ericherman/megaprocessor/README

http://www.megaprocessor.com/
(C) 2014-2016 James Newman.
