ericherman/megaprocessor/4x16mux/README

16x4MUX

This is the most tedious to solder.
