ericherman/megaprocessor/7seg_4digit/README

3x2, 4DIGITS

Same board, there's two ways of fitting the display.
