ericherman/megaprocessor/8bit_add_sub/README

8BIT ADD/SUB

This is my favourite board
