ericherman/megaprocessor/8x2and_or/README

8x2AND OR

Somehow when doing this board I messed up the power plane so it didn't
extend over the whole board. So there's a few wires underneath to sort
things out.
