ericherman/megaprocessor/module_artwork_rnx_ctrl/README

Rnx Control

This generates the signals that control what the Rn Registers and Rx Mux
modules do each cycle. This depends on the current state and instruction
and uses signals generated by the decoder modules.
