ericherman/megaprocessor/shift_left_right/README

Shifter

The shifting is just by wiring from one connector to the other with an
offset. Depending on which side you call the input and which the output
its a left or right shifter. It also generates some status data (is zero
etc).
