ericherman/megaprocessor/16reg/16reg_2a_ancillary/readme.txt

Readme File for Printed Circuit Board 16REG_2a

Board Specification
Size           266.7 x 76.2 mm
Material       FR4
No of Layers   4
Thickness      1.6
Finish         HASL (NOT Lead Free)
Copper Weight  1.0oz

Special Requirements : None.

The design does not contain Blind Vias	
The design does not contain Buried Vias
The design does not contain holes smaller than 0.25mm (0.010inches) 

The design conforms to the following design rules	
Minimum track thickness 8 mil (0.13mm)
Minimum track clearance 8 mil (0.13mm)

Layer Description:

Top Silk Screen Overlay       16REG_2a.GTO
Top Solder Mask               16REG_2a.GTS
Top Copper                    16REG_2a.GTL
Inner Copper 1                16REG_2a.G1
Inner Copper 2                16REG_2a.G2
Bottom Copper                 16REG_2a.GBL
Bottom Solder Mask            16REG_2a.GBS
Bottom Silk Screen            No
NC Drill File                 16REG_2a.drd
Outline			      16REG_2a.GM1

Contact Information

sales@tecbridgecircuits.co.uk
+44 (0) 207 993 6503
http://www.tecbridgecircuits.co.uk
