ericherman/megaprocessor/2_to_4_decoder/decoder4_2_ancillary/readme.txt

Readme File for Printed Circuit Board Decoder4_2

Board Specification
Size           52.07 x 44.45 mm
Material       FR4
No of Layers   4
Thickness      1.6
Finish         HASL (NOT Lead Free)
Copper Weight  1.0oz

Special Requirements : None.

The design does not contain Blind Vias	
The design does not contain Buried Vias
The design does not contain holes smaller than 0.25mm (0.010inches) 
The design conforms to the following design rules	
Minimum track thickness 8 mil (0.13mm)
Minimum track clearance 8 mil (0.13mm)

Layer Description:

Top Silk Screen Overlay       Decoder4_2.GTO
Top Solder Mask               Decoder4_2.GTS
Top Copper                    Decoder4_2.GTL
Inner Copper 1                Decoder4_2.G1
Inner Copper 2                Decoder4_2.G2
Bottom Copper                 Decoder4_2.GBL
Bottom Solder Mask            Decoder4_2.GBS
Bottom Silk Screen            No
NC Drill File                 Decoder4_2.drd
Outline			      Decoder4_2.GM1

Contact Information

sales@tecbridgecircuits.co.uk
+44 (0) 207 993 6503
http://www.tecbridgecircuits.co.uk
