ericherman/megaprocessor/2or/2or_2_ancillary/readme.txt

Readme File for Printed Circuit Board 2OR_2

Board Specification
Size           35.54mm x 24.13mm (1.4 x .95 inches)
Material       FR4
No of Layers   2
Thickness      1.6
Finish         HASL (NOT Lead Free)
Copper Weight  1.0oz

Layer Description:
Top Silk Screen Overlay       2OR_2.GTO
Top Solder Mask               2OR_2.GTS
Top Copper                    2OR_2.GTL
Bottom Copper                 2OR_2.GBL
Bottom Solder Mask            2OR_2.GBS
Bottom Silk Screen            No
NC Drill File                 2OR_2.drd
Outline			      2OR_2.GM1

Contact Information

sales@tecbridgecircuits.co.uk
+44 (0) 207 993 6503
http://www.tecbridgecircuits.co.uk
