ericherman/megaprocessor/2x2and_or/2x2and_or_1_ancillary/readme.txt

Readme File for Printed Circuit Board 2x2AND_OR_1

Board Specification
Size           53.98 x 44.77 mm
Material       FR4
No of Layers   2
Thickness      1.6
Finish         HASL (NOT Lead Free)
Copper Weight  1.0oz

Special Requirements : None.

The design does not contain holes smaller than 0.25mm (0.010inches) 
The design conforms to the following design rules	
Minimum track thickness 8 mil
Minimum track clearance 8 mil

Layer Description:
Top Silk Screen Overlay       2x2AND_OR_1.GTO
Top Solder Mask               2x2AND_OR_1.GTS
Top Copper                    2x2AND_OR_1.GTL
Bottom Copper                 2x2AND_OR_1.GBL
Bottom Solder Mask            2x2AND_OR_1.GBS
Bottom Silk Screen            No
NC Drill File                 2x2AND_OR_1.drl
NC Drill File (non-plated)    2x2AND_OR_1npth.drl
Outline			      2x2AND_OR_1.GM1

Contact Information

sales@tecbridgecircuits.co.uk
+44 (0) 207 993 6503
http://www.tecbridgecircuits.co.uk
