ericherman/megaprocessor/3and/3and_2_ancillary/readme.txt

Readme File for Printed Circuit Board 3AND_2

Board Specification
Size           35.54mm x 30.48mm (1.4 x 1.2 inches)
Material       FR4
No of Layers   2
Thickness      1.6
Finish         HASL (NOT Lead Free)
Copper Weight  1.0oz

Layer Description

Top Silk Screen Overlay       3AND_2.GTO
Top Solder Mask               3AND_2.GTS
Top Copper                    3AND_2.GTL
Bottom Copper                 3AND_2.GBL
Bottom Solder Mask            3AND_2.GBS
Bottom Silk Screen            No
NC Drill File                 3AND_2.drd
Outline			      3AND_2.GM1

Contact Information

sales@tecbridgecircuits.co.uk
+44 (0) 207 993 6503
http://www.tecbridgecircuits.co.uk
