ericherman/megaprocessor/3or/3or_1_ancillary/readme.txt

Readme File for Printed Circuit Board 3OR_1

Board Specification
Size           35.54mm x 27.94mm (1.4 x 1.1 inches)
Material       FR4
No of Layers   2
Thickness      1.6
Finish         HASL (NOT Lead Free)
Copper Weight  1.0oz

Layer Description

Top Silk Screen Overlay       3OR_1.GTO
Top Solder Mask               3OR_1.GTS
Top Copper                    3OR_1.GTL
Bottom Copper                 3OR_1.GBL
Bottom Solder Mask            3OR_1.GBS
Bottom Silk Screen            No
NC Drill File                 3OR_1.drd
Outline			      3OR_1.GM1

Contact Information
