ericherman/megaprocessor/4x16mux/4x16mux_3_ancillary/readme.txt

Readme File for Printed Circuit Board 4x16MUX_3

Board Specification
Size           218.42mm x 107mm (8.6 x 4.2 inches)
Material       FR4
No of Layers   4
Thickness      1.6
Finish         HASL (NOT Lead Free)
Copper Weight  1.0oz

Special Requirements : None.

The design does not contain Blind Vias	
The design does not contain Buried Vias
The design does not contain holes smaller than 0.25mm (0.010inches) 

The design conforms to the following design rules	
Minimum track thickness 5 mil (0.13mm)
Minimum track clearance 5 mil (0.13mm)

Layer Description:
(Note: Inner layers are counted from the top downwards)

Top Silk Screen Overlay       4x16MUX_3.GTO
Top Solder Mask               4x16MUX_3.GTS
Top Copper                    4x16MUX_3.GTL
Inner Copper 1                4x16MUX_3.G1
Inner Copper 2                4x16MUX_3.G2
Bottom Copper                 4x16MUX_3.GBL
Bottom Solder Mask            4x16MUX_3.GBS
Bottom Silk Screen            No
NC Drill File                 4x16MUX_3.drd
Outline			      4x16MUX_3.GM1

Contact Information

sales@tecbridgecircuits.co.uk
+44 (0) 207 993 6503
http://www.tecbridgecircuits.co.uk
