ericherman/megaprocessor/5or/5or_1_ancillary/readme.txt

Readme File for Printed Circuit Board 5OR_1

Board Specification
Size           35.54mm x 38.74mm (1.4 x 1.525 inches)
Material       FR4
No of Layers   2
Thickness      1.6
Finish         HASL (NOT Lead Free)
Copper Weight  1.0oz

Layer Description

Top Silk Screen Overlay       5OR_1.GTO
Top Solder Mask               5OR_1.GTS
Top Copper                    5OR_1.GTL
Bottom Copper                 5OR_1.GBL
Bottom Solder Mask            5OR_1.GBS
Bottom Silk Screen            No
NC Drill File                 5OR_1.drd
Outline			      5OR_1.GM1

Contact Information

sales@tecbridgecircuits.co.uk
+44 (0) 207 993 6503
http://www.tecbridgecircuits.co.uk
