ericherman/megaprocessor/7seg_4digit/7seg_4digit_1_ancillary/readme.txt

Readme File for Printed Circuit Board 7SEG_4DIGIT_1

Board Specification
Size           132mm x 67.31mm (5.2 x 2.65 inches)
Material       FR4
No of Layers   2
Thickness      1.6
Finish         HASL (NOT Lead Free)
Copper Weight  1.0oz

Special Requirements : None.

The design does not contain holes smaller than 0.25mm (0.010inches) 
The design conforms to the following design rules	
Minimum track thickness 8 mil (0.13mm)
Minimum track clearance 8 mil (0.13mm)

Layer Description:

Top Silk Screen Overlay       7SEC_4DIGIT_1.GTO
Top Solder Mask               7SEC_4DIGIT_1.GTS
Top Copper                    7SEC_4DIGIT_1.GTL
Bottom Copper                 7SEC_4DIGIT_1.GBL
Bottom Solder Mask            7SEC_4DIGIT_1.GBS
Bottom Silk Screen            7SEC_4DIGIT_1.GBO
NC Drill File                 7SEC_4DIGIT_1.drd
Outline			      7SEC_4DIGIT_1.GM1

Contact Information

sales@tecbridgecircuits.co.uk
+44 (0) 207 993 6503
http://www.tecbridgecircuits.co.uk
