ericherman/megaprocessor/8b_ram/8b_ram_3_ancillary/readme.txt

Readme File for Printed Circuit Board 8B_RAM_3

Board Specification
Size           202.57mm x 202.57mm (8 x 8 inches)
Material       FR4
No of Layers   4
Thickness      1.6
Finish         HASL (NOT Lead Free)
Copper Weight  1.0oz

Special Requirements : None.

The design does not contain Blind Vias	
The design does not contain Buried Vias
The design does not contain holes smaller than 0.25mm (0.010inches) 
The design conforms to the following design rules	
Minimum track thickness 5 mil (0.13mm)
Minimum track clearance 5 mil (0.13mm)

Layer Description
(Note: Inner layers are counted from the top downwards)

Top Silk Screen Overlay       MEM_MUX_2.GTO
Top Solder Mask               MEM_MUX_2.GTS
Top Copper                    MEM_MUX_2.GTL
Inner Copper 1                MEM_MUX_2.G1
Inner Copper 2                MEM_MUX_2.G2
Bottom Copper                 MEM_MUX_2.GBL
Bottom Solder Mask            MEM_MUX_2.GBS
Bottom Silk Screen            MEM_MUX_2.GBO
NC Drill File                 MEM_MUX_2.drd
Outline			      MEM_MUX_2.GM1

Contact Information

sales@tecbridgecircuits.co.uk
+44 (0) 207 993 6503
http://www.tecbridgecircuits.co.uk
