ericherman/megaprocessor/8bit_add_sub/8bit_add_sub_ancillary/readme.txt

Readme File for Printed Circuit Board 8BIT_ADD_SUB_1

Board Specification
Size           176.53 x 351.79 mm
Material       FR4
No of Layers   4
Thickness      1.6
Finish         HASL (NOT Lead Free)
Copper Weight  1.0oz

Special Requirements : None.

The design does not contain holes smaller than 0.25mm (0.010inches) 
The design conforms to the following design rules	
Minimum track thickness 8 mil (0.13mm)
Minimum track clearance 8 mil (0.13mm)

Layer Description:

Top Silk Screen Overlay       8BIT_ADD_SUB.GTO
Top Solder Mask               8BIT_ADD_SUB.GTS
Top Copper                    8BIT_ADD_SUB.GTL
Inner Copper 1                8BIT_ADD_SUB.G1
Inner Copper 2                8BIT_ADD_SUB.G2
Bottom Copper                 8BIT_ADD_SUB.GBL
Bottom Solder Mask            8BIT_ADD_SUB.GBS
Bottom Silk Screen            No
NC Drill File                 8BIT_ADD_SUB.drd
Outline			      8BIT_ADD_SUB.GM1

Contact Information

sales@tecbridgecircuits.co.uk
+44 (0) 207 993 6503
http://www.tecbridgecircuits.co.uk
