ericherman/megaprocessor/8or/8or_1_ancillary/readme.txt

Readme File for Printed Circuit Board 8OR_1

Board Specification
Size           38.08 x 52.07 mm
Material       FR4
No of Layers   4
Thickness      1.6
Finish         HASL (NOT Lead Free)
Copper Weight  1.0oz

Special Requirements : None.

The design does not contain holes smaller than 0.25mm (0.010inches) 
The design conforms to the following design rules	
Minimum track thickness 8 mil (0.13mm)
Minimum track clearance 8 mil (0.13mm)

Layer Description:

Top Silk Screen Overlay       8OR_1.GTO
Top Solder Mask               8OR_1.GTS
Top Copper                    8OR_1.GTL
Inner Copper 1                8OR_1.G1
Inner Copper 2                8OR_1.G2
Bottom Copper                 8OR_1.GBL
Bottom Solder Mask            8OR_1.GBS
Bottom Silk Screen            No
NC Drill File                 8OR_1.drd
Outline			      8OR_1.GM1

Contact Information

sales@tecbridgecircuits.co.uk
+44 (0) 207 993 6503
http://www.tecbridgecircuits.co.uk
