ericherman/megaprocessor/addr_addr/addr_addr_1_ancillary/readme.txt

Readme File for Printed Circuit Board ADDR_ADDR_1

Board Specification
Size           71.12 x 30.48mm (2.8 x 1.2 inches)
Material       FR4
No of Layers   2
Thickness      1.6
Finish         HASL (NOT Lead Free)
Copper Weight  1.0oz

Special Requirements : None.

The design does not contain holes smaller than 0.25mm (0.010inches) 
The design conforms to the following design rules	
Minimum track thickness 5 mil (0.13mm)
Minimum track clearance 5 mil (0.13mm)

Layer Description:

Top Silk Screen Overlay       ADDR_ADDR_1.GTO
Top Solder Mask               ADDR_ADDR_1.GTS
Top Copper                    ADDR_ADDR_1.GTL
Bottom Copper                 ADDR_ADDR_1.GBL
Bottom Solder Mask            ADDR_ADDR_1.GBS
Bottom Silk Screen            No
NC Drill File                 ADDR_ADDR_1.drd
Outline			      ADDR_ADDR_1.GM1

Contact Information

sales@tecbridgecircuits.co.uk
+44 (0) 207 993 6503
http://www.tecbridgecircuits.co.uk
