ericherman/megaprocessor/buf_bus_tee/buf_bus_tee_1_ancillary/readme.txt

Readme File for Printed Circuit Board 'BUF_BUS_TEE_1'

Board Specification
Size           114.3 x 55.88mm
Material       FR4
No of Layers   2
Thickness      1.6
Finish         HASL (NOT Lead free) (NOT RoHS)
Copper Weight  1.0oz

Special Requirements
None

The design does not contain holes smaller than 0.25mm (0.010inches)
The design conforms to the following design rules
Minimum track thickness 5 mil (0.13mm)
Minimum track clearance 5 mil (0.13mm)

Layer Description

Top Silk Screen Overlay       BUF_BUS_TEE_1.GTO
Top Solder Mask               BUF_BUS_TEE_1.GTS
Top Copper                    BUF_BUS_TEE_1.GTL
Bottom Copper                 BUF_BUS_TEE_1.GBL
Bottom Solder Mask            BUF_BUS_TEE_1.GBS
Bottom Silk Screen            No
NC Drill File                 BUF_BUS_TEE_1.GDD
Outline			      BUF_BUS_TEE_1.GM1

Contact Information

sales@tecbridgecircuits.co.uk
+44 (0) 207 993 6503
http://www.tecbridgecircuits.co.uk
