ericherman/megaprocessor/bus_4tee/bus_4tee_1_ancillary/readme.txt

Readme File for Printed Circuit Board BUS_4TEE_1

Board Specification
Size           58.42mm x 71.12mm
Material       FR4
No of Layers   2
Thickness      1.6
Finish         HASL (NOT Lead Free)
Copper Weight  1.0oz

Special Requirements : None.

The design does not contain holes smaller than 0.25mm (0.010inches) 
The design conforms to the following design rules	
Minimum track thickness 8 mil
Minimum track clearance 8 mil

Layer Description:
Top Silk Screen Overlay       BUS_4TEE_1.GTO
Top Solder Mask               BUS_4TEE_1.GTS
Top Copper                    BUS_4TEE_1.GTL
Bottom Copper                 BUS_4TEE_1.GBL
Bottom Solder Mask            BUS_4TEE_1.GBS
Bottom Silk Screen            No
NC Drill File                 BUS_4TEE_1.drd
Outline			      BUS_4TEE_1.GM1

Contact Information

sales@tecbridgecircuits.co.uk
+44 (0) 207 993 6503
http://www.tecbridgecircuits.co.uk
