ericherman/megaprocessor/bus_split_display/bus_split_display_1_ancillary/readme.txt

Readme File for Printed Circuit Board 'BUS_SPLIT_DISPLAY_1'

Board Specification
Size           71.12 x 31.75mm
Material       FR4
No of Layers   2
Thickness      1.6
Finish         HASL (NOT Lead free) (NOT RoHS)
Copper Weight  1.0oz

Special Requirements
None

The design does not contain holes smaller than 0.25mm (0.010inches)
The design conforms to the following design rules
Minimum track thickness 5 mil (0.13mm)
Minimum track clearance 5 mil (0.13mm)

Layer Description

Top Silk Screen Overlay       XOR_1.GTO
Top Solder Mask               XOR_1.GTS
Top Copper                    XOR_1.GTL
Bottom Copper                 XOR_1.GBL
Bottom Solder Mask            XOR_1.GBS
Bottom Silk Screen            No
NC Drill File                 XOR_1.GDD
Outline			      XOR_1.GM1

Contact Information

sales@tecbridgecircuits.co.uk
+44 (0) 207 993 6503
http://www.tecbridgecircuits.co.uk
