ericherman/megaprocessor/igor/igor_1_ancillary/readme.txt

Readme File for Printed Circuit Board IGOR_1

Board Specification
Size           160.02 x 132.72mm (6.3 x 5.2 inches)
Material       FR4
No of Layers   4
Thickness      1.6
Finish         HASL (NOT Lead Free)
Copper Weight  1.0oz

Special Requirements : None.

The design does not contain Blind Vias	
The design does not contain Buried Vias
The design does not contain holes smaller than 0.25mm (0.010inches) 
The design conforms to the following design rules	
Minimum track thickness 8 mil (0.13mm)
Minimum track clearance 8 mil (0.13mm)

Layer Description:
(Note: Inner layers are counted from the top downwards)

Top Silk Screen Overlay       IGOR_1.GTO
Top Solder Mask               IGOR_1.GTS
Top Copper                    IGOR_1.GTL
Inner Copper 1                IGOR_1.G1
Inner Copper 2                IGOR_1.G2
Bottom Copper                 IGOR_1.GBL
Bottom Solder Mask            IGOR_1.GBS
Bottom Silk Screen            No
NC Drill File                 IGOR_1.drd
Outline			      IGOR_1.GM1

Contact Information

sales@tecbridgecircuits.co.uk
+44 (0) 207 993 6503
http://www.tecbridgecircuits.co.uk
