ericherman/megaprocessor/mem_mux_2w/mem_mux_2w_1_ancillary/readme.txt

Readme File for Printed Circuit Board MEM_MUX_2W_1

Board Specification
Size           228.6mm x 76.2mm (9.0 x 3.0 inches)
Material       FR4
No of Layers   4
Thickness      1.6
Finish         HASL (NOT Lead Free)
Copper Weight  1.0oz

Special Requirements : None.

The design does not contain Blind Vias	
The design does not contain Buried Vias
The design does not contain holes smaller than 0.25mm (0.010inches) 

The design conforms to the following design rules	
Minimum track thickness 8 mil
Minimum track clearance 8 mil

Layer Description:
(Note: Inner layers are counted from the top downwards)

Top Silk Screen Overlay       MEM_MUX_2W_1.GTO
Top Solder Mask               MEM_MUX_2W_1.GTS
Top Copper                    MEM_MUX_2W_1.GTL
Inner Copper 1                MEM_MUX_2W_1.G1
Inner Copper 2                MEM_MUX_2W_1.G2
Bottom Copper                 MEM_MUX_2W_1.GBL
Bottom Solder Mask            MEM_MUX_2W_1.GBS
Bottom Silk Screen            No
NC Drill File                 MEM_MUX_2W_1.drd
Outline			      MEM_MUX_2W_1.GM1

Contact Information

sales@tecbridgecircuits.co.uk
+44 (0) 207 993 6503
http://www.tecbridgecircuits.co.uk
