ericherman/megaprocessor/mem_p2p/mem_p2p_1_ancillary/readme.txt

Readme File for Printed Circuit Board MEM_P2P_1

Board Specification
Size           97.16 x 106.05 (3.8 x 4.2 inches)
Material       FR4
No of Layers   2
Thickness      1.6
Finish         HASL (NOT Lead Free)
Copper Weight  1.0oz

Special Requirements : None.

The design does not contain holes smaller than 0.25mm (0.010inches) 
The design conforms to the following design rules	
Minimum track thickness 8 mil (0.13mm)
Minimum track clearance 8 mil (0.13mm)

Layer Description:
Top Silk Screen Overlay       MEM_P2P_1.GTO
Top Solder Mask               MEM_P2P_1.GTS
Top Copper                    MEM_P2P_1.GTL
Bottom Copper                 MEM_P2P_1.GBL
Bottom Solder Mask            MEM_P2P_1.GBS
Bottom Silk Screen            MEM_P2P_1.GBO
NC Drill File                 MEM_P2P_1.drd
Outline			      MEM_P2P_1.GM1

Contact Information

sales@tecbridgecircuits.co.uk
+44 (0) 207 993 6503
http://www.tecbridgecircuits.co.uk
