ericherman/megaprocessor/p2p/p2p_1_ancillary/readme.txt

Readme File for Printed Circuit Board P2P_1

Board Specification
Size           100.33mm x 125.73mm
Material       FR4
No of Layers   2
Thickness      1.6
Finish         HASL (NOT Lead Free)
Copper Weight  1.0oz

Special Requirements : None.

The design does not contain holes smaller than 0.25mm (0.010inches) 
The design conforms to the following design rules    
Minimum track thickness 8 mil
Minimum track clearance 8 mil

Layer Description:
Top Silk Screen Overlay       P2P_1.GTO
Top Solder Mask               P2P_1.GTS
Top Copper                    P2P_1.GTL
Bottom Copper                 P2P_1.GBL
Bottom Solder Mask            P2P_1.GBS
Bottom Silk Screen            P2P_1.GBO
NC Drill File                 P2P_1.drd
Outline                       P2P_1.GM1

Contact Information

sales@tecbridgecircuits.co.uk
+44 (0) 207 993 6503
http://www.tecbridgecircuits.co.uk
