ericherman/megaprocessor/services/services_1_ancillary/readme.txt

Readme File for Printed Circuit Board SERVICES_1

Board Specification
Size           166.35mm x 97.46mm
Material       FR4
No of Layers   2
Thickness      1.6
Finish         HASL (NOT Lead Free)
Copper Weight  1.0oz

Special Requirements : None.

The design does not contain holes smaller than 0.25mm (0.010inches) 
The design conforms to the following design rules	
Minimum track thickness 8 mil
Minimum track clearance 8 mil

Layer Description:
Top Silk Screen Overlay       SERVICES_1.GTO
Top Solder Mask               SERVICES_1.GTS
Top Copper                    SERVICES_1.GTL
Bottom Copper                 SERVICES_1.GBL
Bottom Solder Mask            SERVICES_1.GBS
Bottom Silk Screen            SERVICES_1.GTO
NC Drill File                 SERVICES_1.drd
Outline			      SERVICES_1.GM1

Contact Information

sales@tecbridgecircuits.co.uk
+44 (0) 207 993 6503
http://www.tecbridgecircuits.co.uk
