ericherman/megaprocessor/shift_left_right/shift_left_right_1_ancillary/readme.txt

Readme File for Printed Circuit Board SHIFT_LEFT_RIGHT_1

Board Specification
Size           105.41mm x 90.81mm (4.2 * 3.6 inches)
Material       FR4
No of Layers   2
Thickness      1.6
Finish         HASL (NOT Lead Free)
Copper Weight  1.0oz

Special Requirements : None.

The design does not contain holes smaller than 0.25mm (0.010inches) 
The design conforms to the following design rules	
Minimum track thickness 8 mil
Minimum track clearance 8 mil

Layer Description:
Top Silk Screen Overlay       SHIFT_LEFT_RIGHT_1.GTO
Top Solder Mask               SHIFT_LEFT_RIGHT_1.GTS
Top Copper                    SHIFT_LEFT_RIGHT_1.GTL
Bottom Copper                 SHIFT_LEFT_RIGHT_1.GBL
Bottom Solder Mask            SHIFT_LEFT_RIGHT_1.GBS
Bottom Silk Screen            No
NC Drill File                 SHIFT_LEFT_RIGHT_1.drd
Outline			      SHIFT_LEFT_RIGHT_1.GM1

Contact Information

sales@tecbridgecircuits.co.uk
+44 (0) 207 993 6503
http://www.tecbridgecircuits.co.uk
