ericherman/megaprocessor/word_byte/word_byte_1_ancillary/readme.txt

Readme File for Printed Circuit Board WORD_BYTE_1

Board Specification
Size           113.03mm x 41.91mm
Material       FR4
No of Layers   2
Thickness      1.6
Finish         HASL (NOT Lead Free)
Copper Weight  1.0oz

Special Requirements : None.

The design does not contain holes smaller than 0.25mm (0.010inches) 
The design conforms to the following design rules    
Minimum track thickness 8 mil
Minimum track clearance 8 mil

Layer Description:
Top Silk Screen Overlay       WORD_BYTE_1.GTO
Top Solder Mask               WORD_BYTE_1.GTS
Top Copper                    WORD_BYTE_1.GTL
Bottom Copper                 WORD_BYTE_1.GBL
Bottom Solder Mask            WORD_BYTE_1.GBS
Bottom Silk Screen            No
NC Drill File                 WORD_BYTE_1.drd
Outline                       WORD_BYTE_1.GM1

Contact Information

sales@tecbridgecircuits.co.uk
+44 (0) 207 993 6503
http://www.tecbridgecircuits.co.uk
