ericherman/megaprocessor/if_test/if_test_1_ancillary/readme.txt

Readme File for Printed Circuit Board IF_TEST_1

Board Specification
Size           246.38 x 91.44mm (9.7 x 3.6 inches)
Material       FR4
No of Layers   4
Thickness      1.6
Finish         HASL (NOT Lead Free)
Copper Weight  1.0oz

Special Requirements : None.

The design does not contain Blind Vias	
The design does not contain Buried Vias
The design does not contain holes smaller than 0.25mm (0.010inches) 

The design conforms to the following design rules	
Minimum track thickness 8 mil (0.13mm)
Minimum track clearance 8 mil (0.13mm)

Layer Description:

Top Silk Screen Overlay       IF_TEST_1.GTO
Top Solder Mask               IF_TEST_1.GTS
Top Copper                    IF_TEST_1.GTL
Inner Copper 1                IF_TEST_1.G1
Inner Copper 2                IF_TEST_1.G2
Bottom Copper                 IF_TEST_1.GBL
Bottom Solder Mask            IF_TEST_1.GBS
Bottom Silk Screen            No
NC Drill File                 IF_TEST_1.drd
Outline			      IF_TEST_1.GM1

Contact Information

sales@tecbridgecircuits.co.uk
+44 (0) 207 993 6503
http://www.tecbridgecircuits.co.uk
