ericherman/megaprocessor/module_artwork_special_reg/module_special_reg.pdf

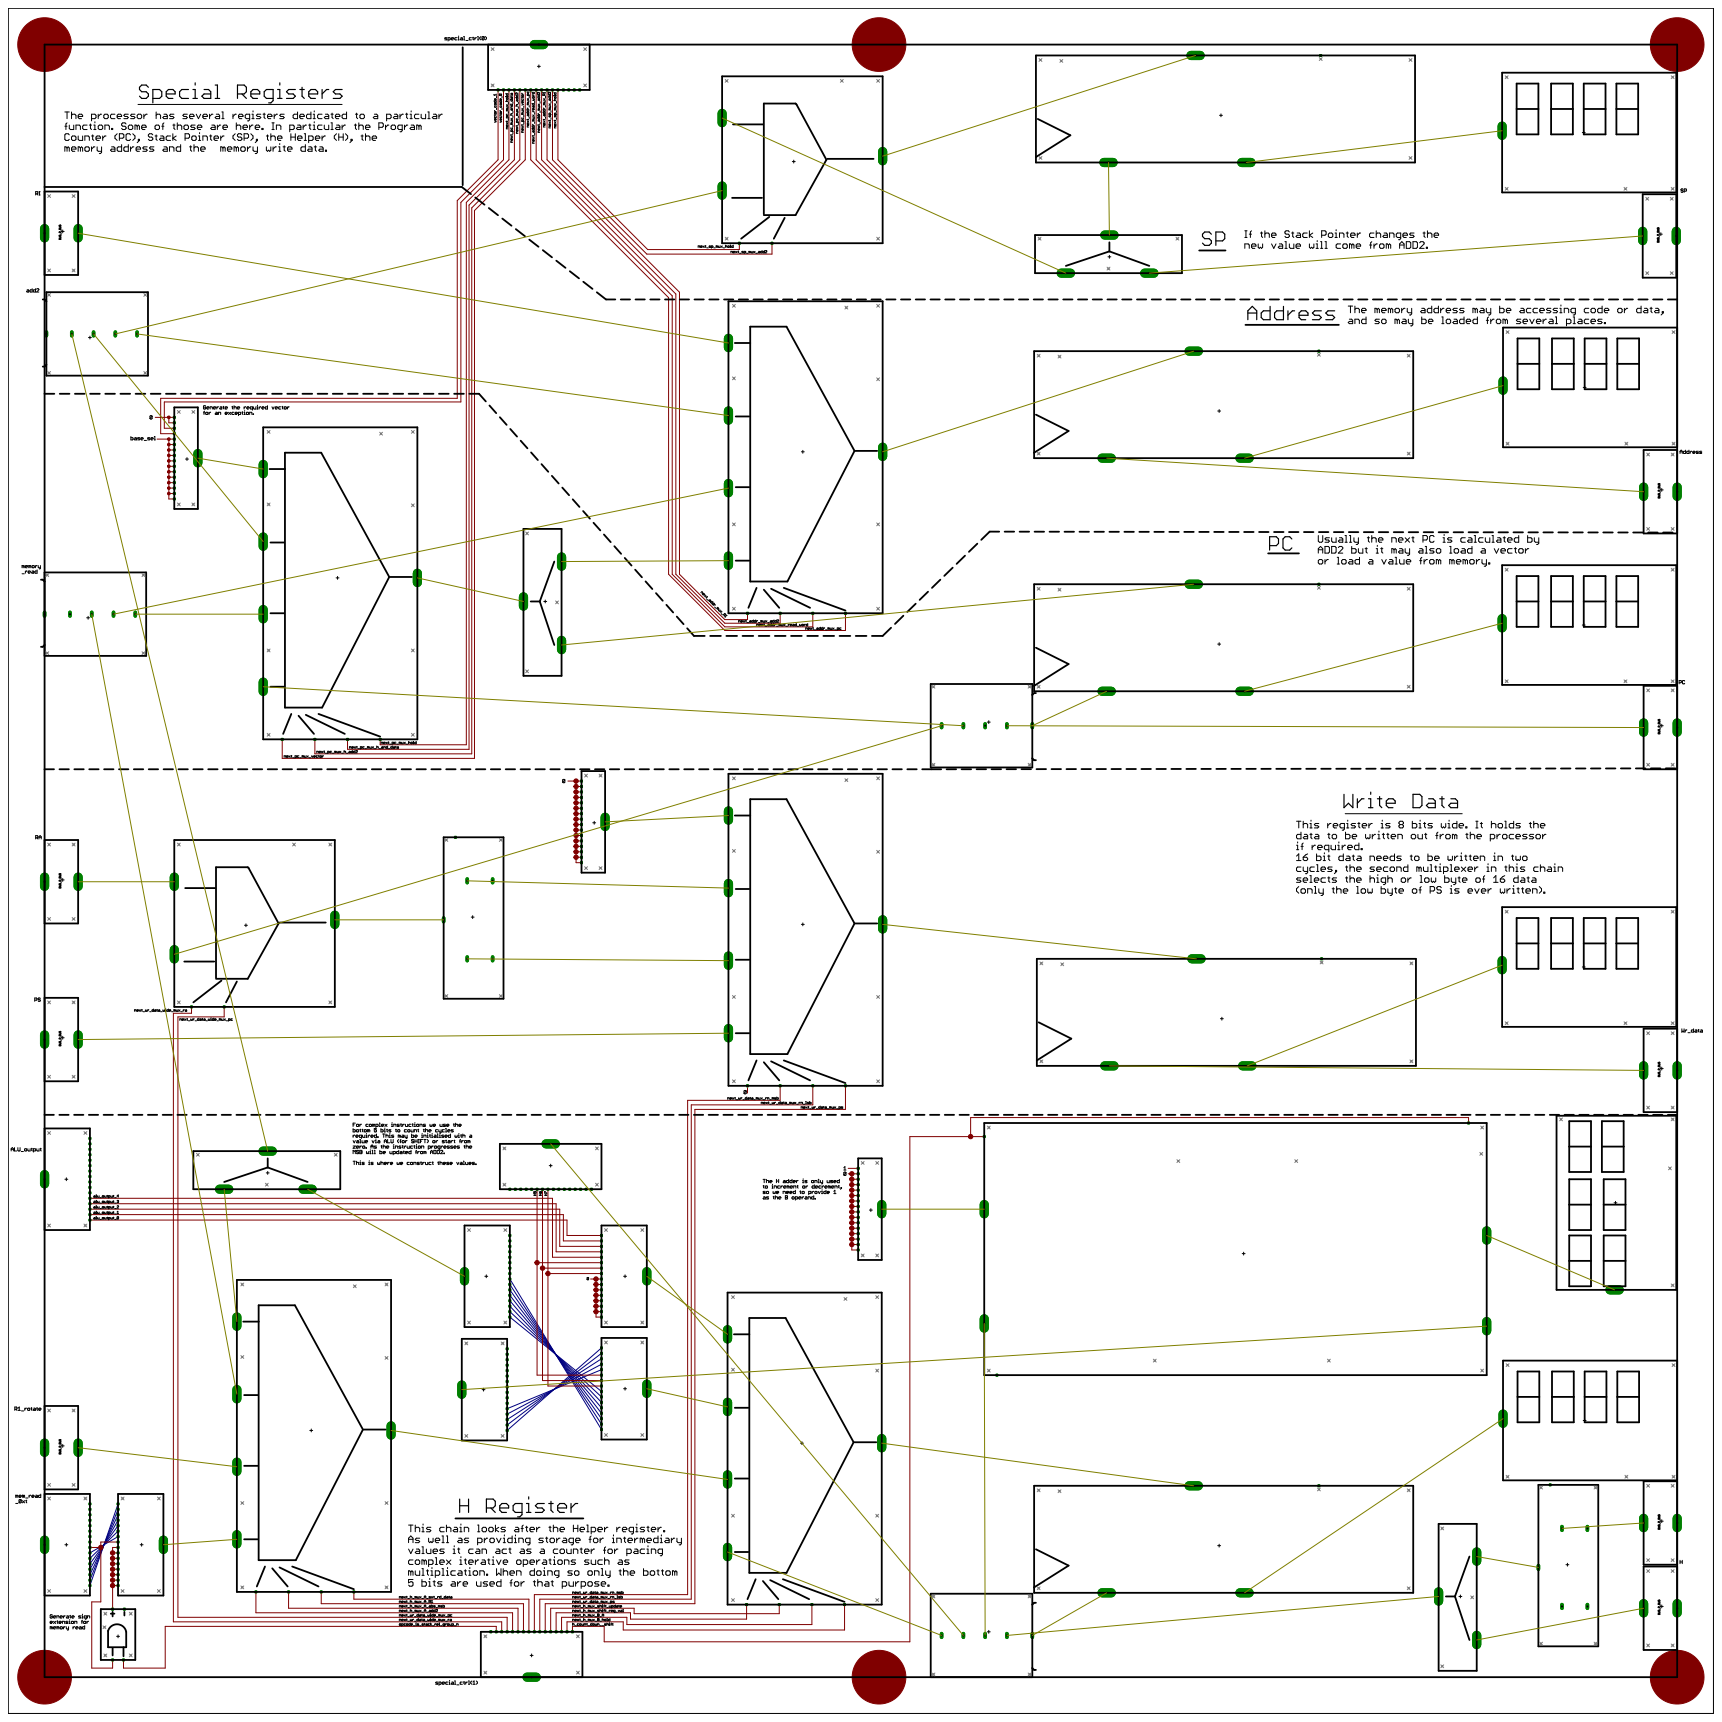
[picture p1: page 1]
