ericherman/megaprocessor/module_artwork_special_reg_ctrl/module_special_reg_ctrl.pdf

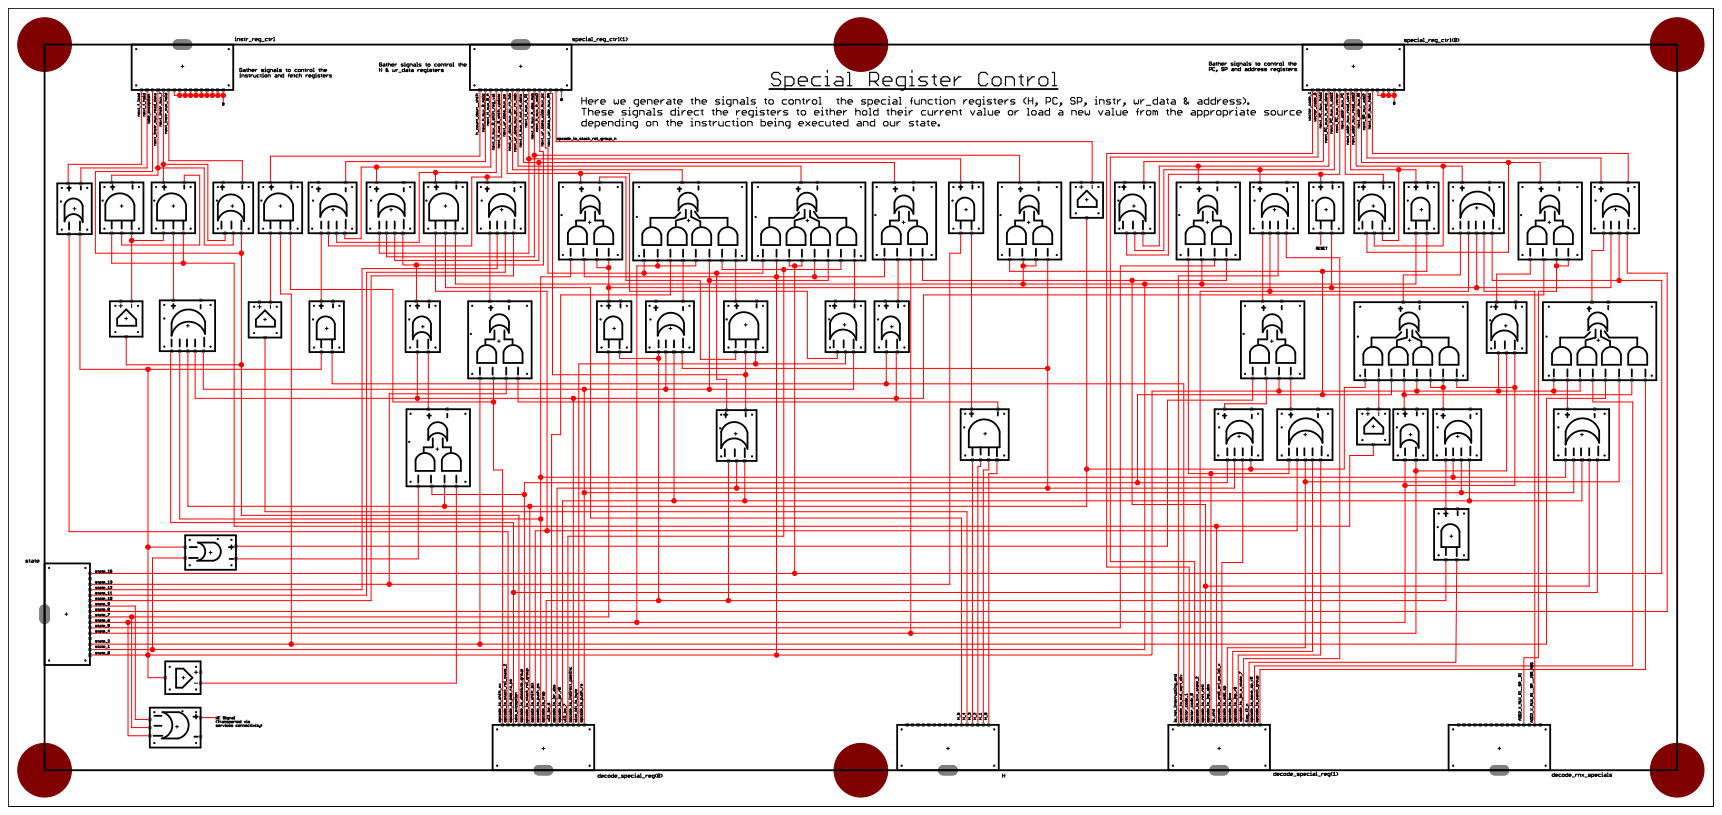
[picture p2: page 1]
