ericherman/megaprocessor/module_artwork_alu/module_alu.pdf

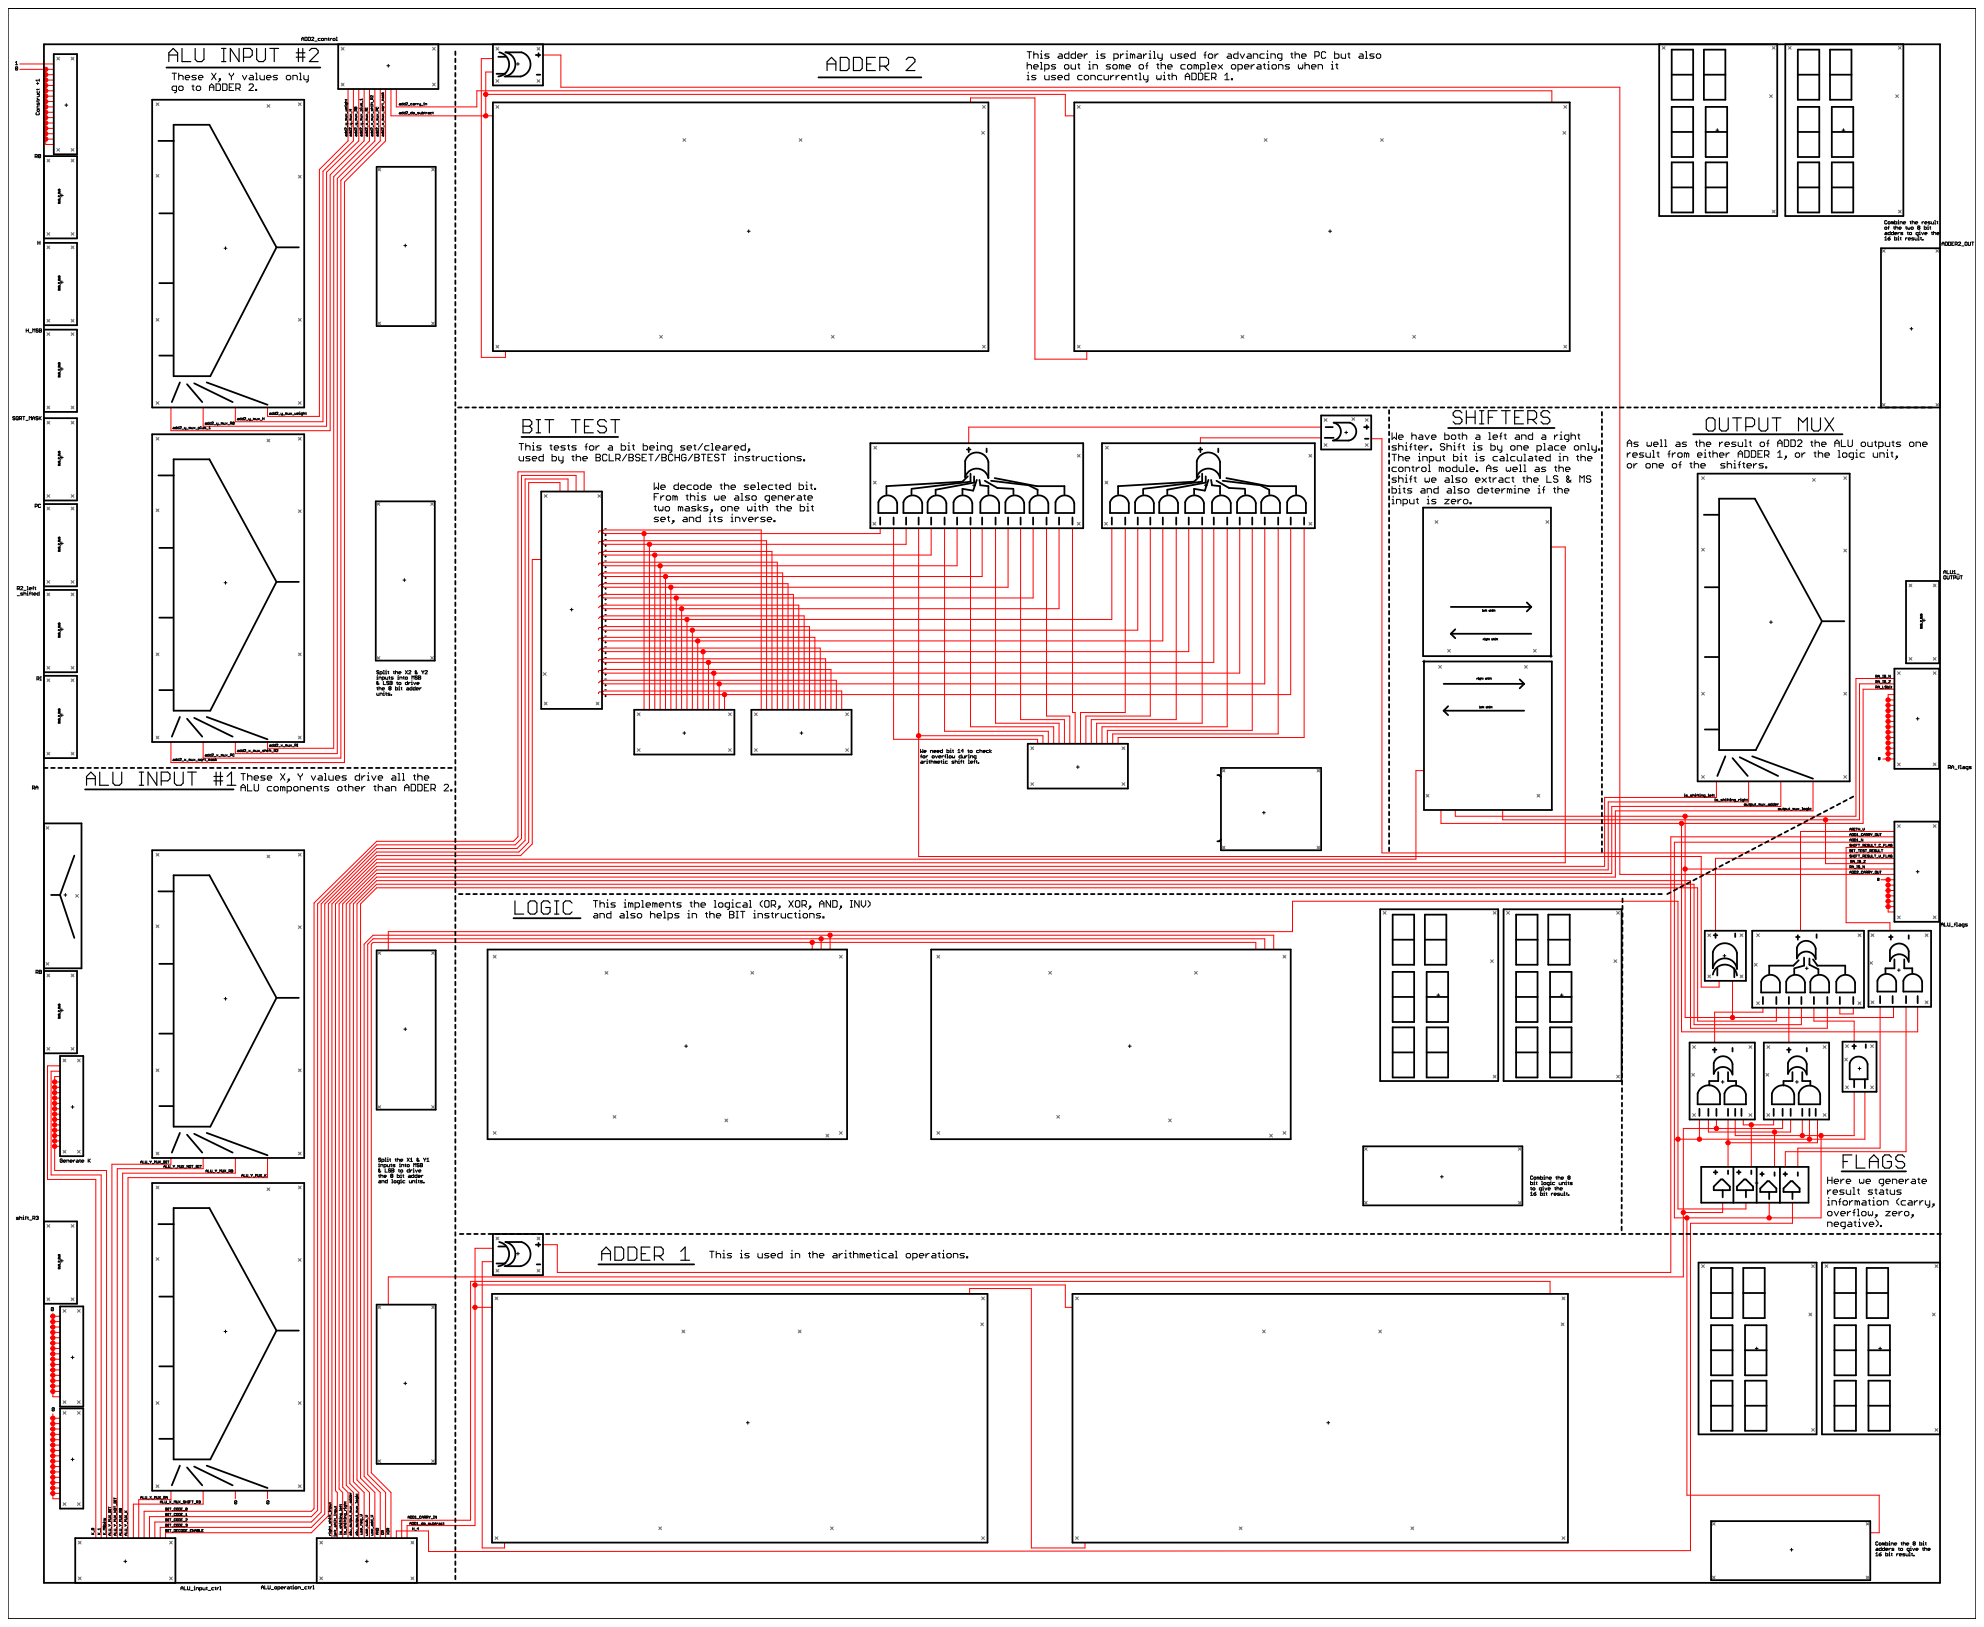
[picture p3: page 1]
