ericherman/megaprocessor/module_artwork_alu_ctrl/module_alu1_ctrl.pdf

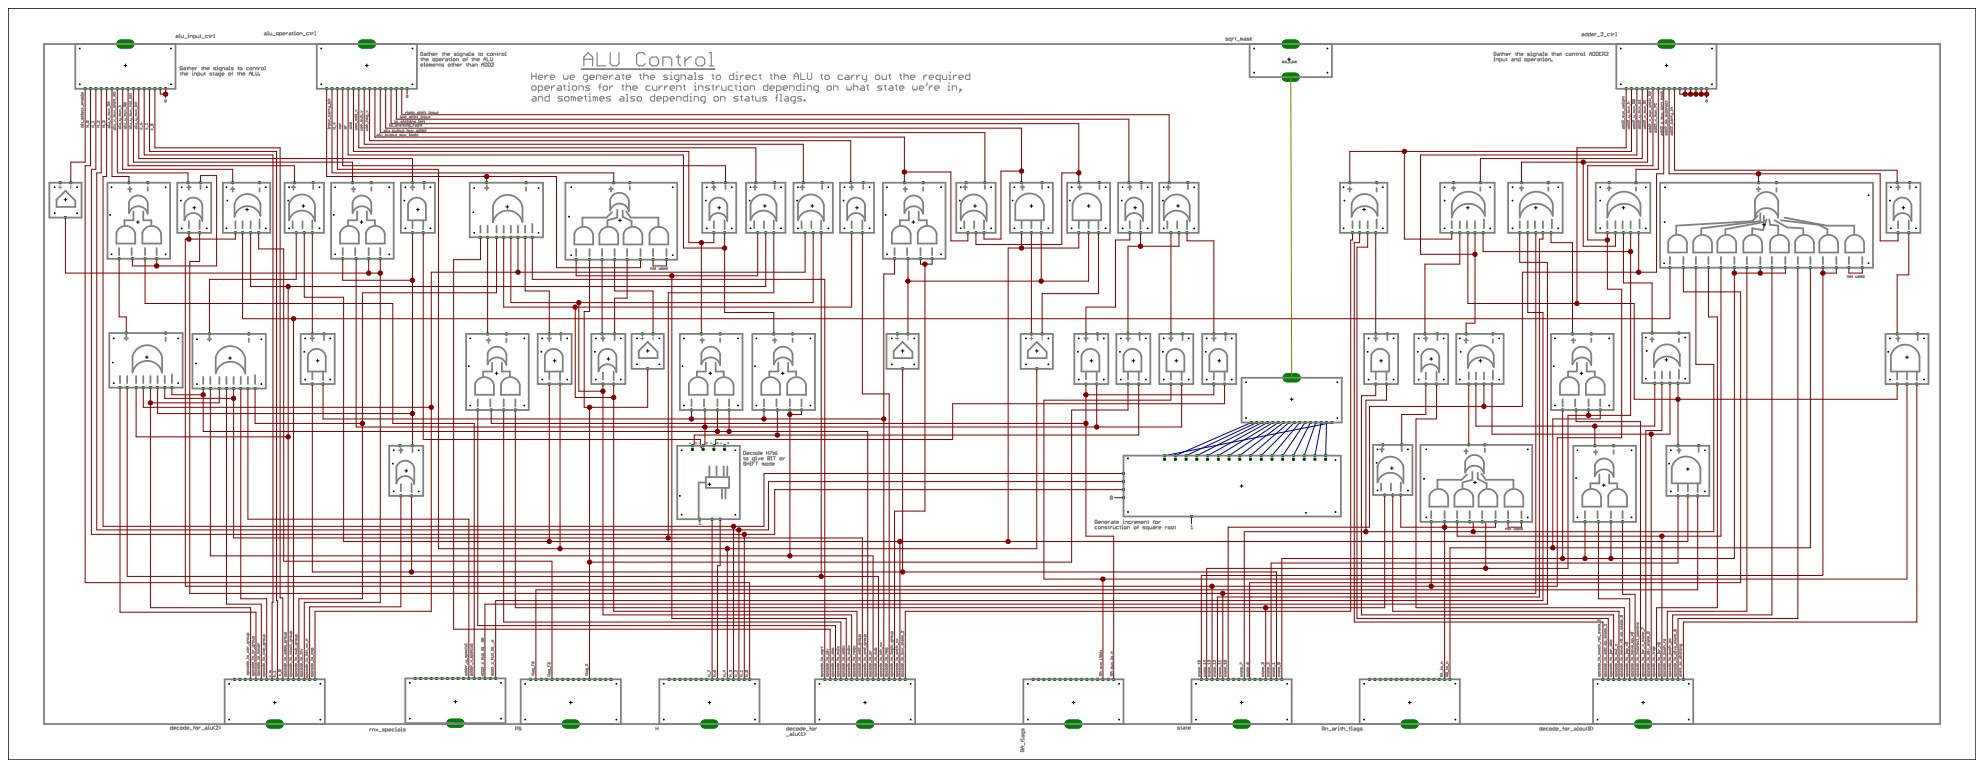
[picture p4: page 1]
