ericherman/megaprocessor/module_artwork_decode_opcodes/module_decode_opcodes.pdf

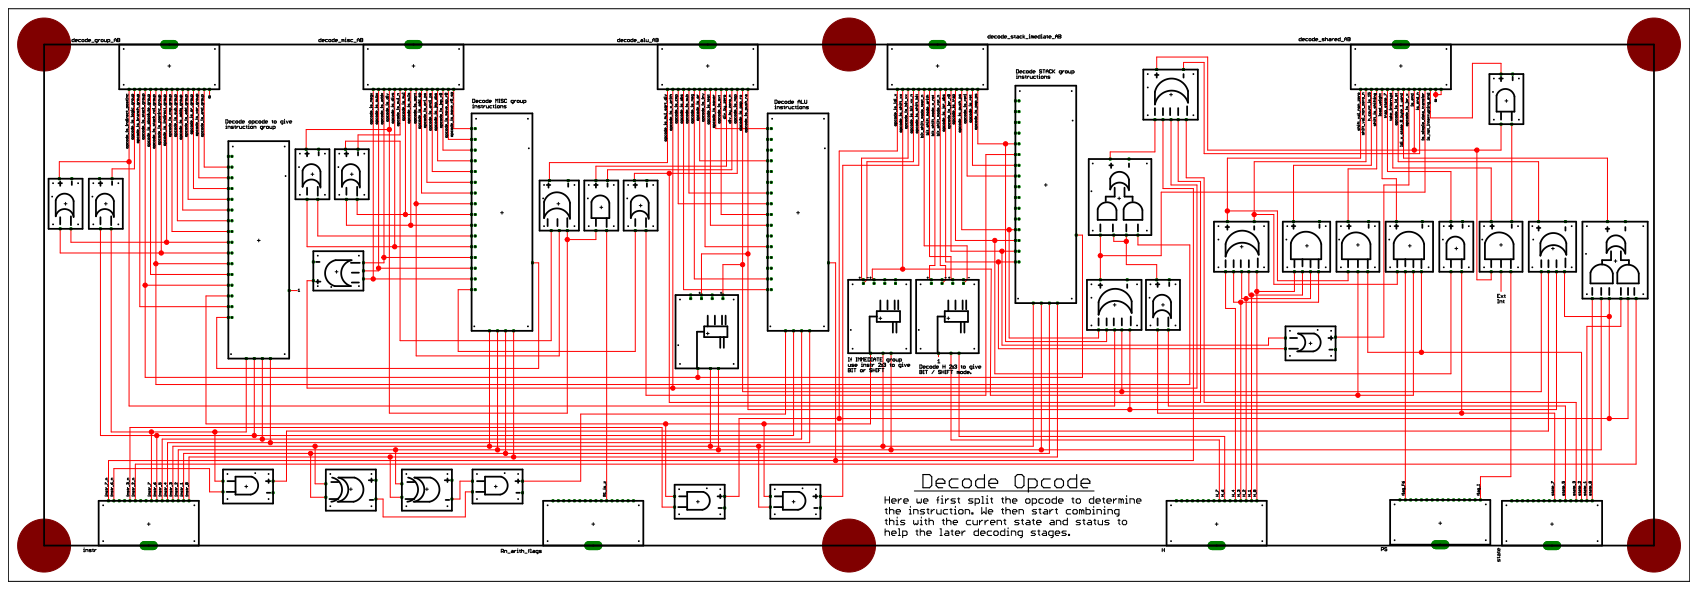
[picture p5: page 1]
