ericherman/megaprocessor/module_artwork_decoding_a/module_decoding_a.pdf

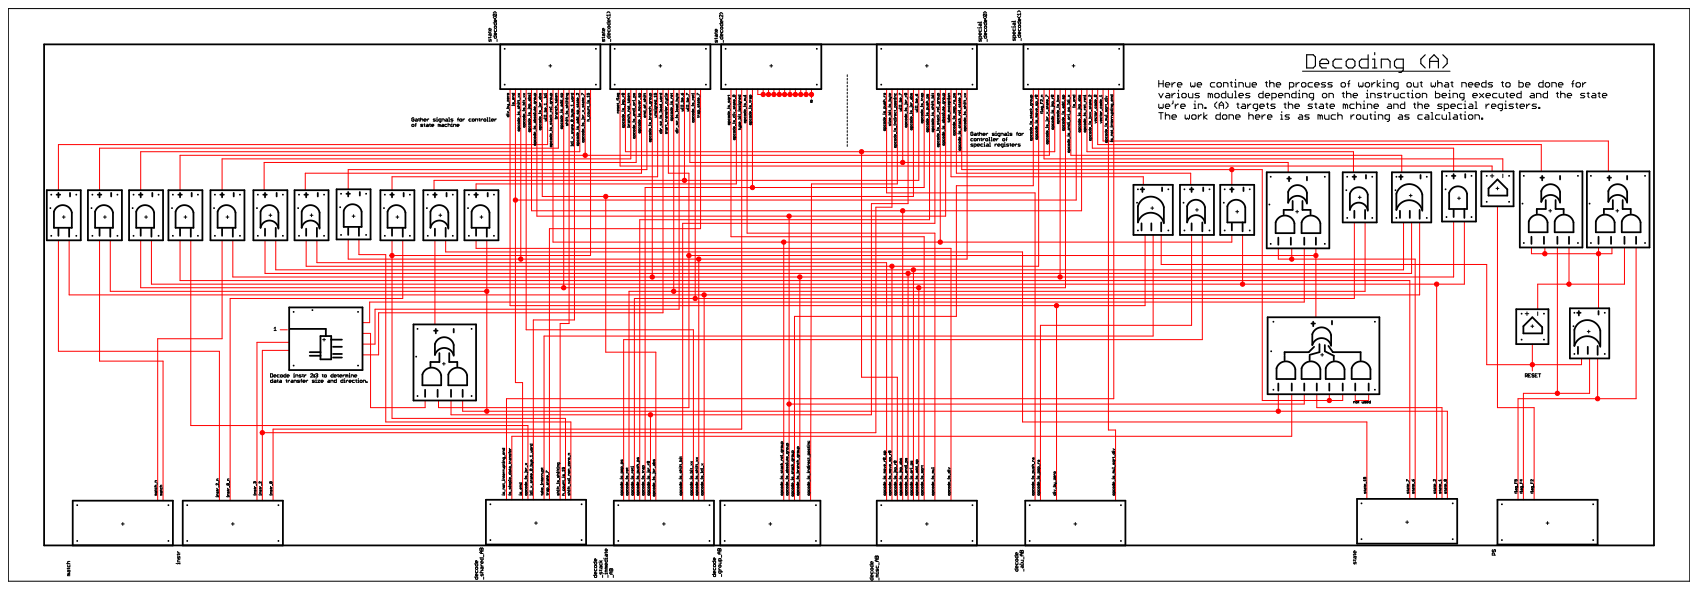
[picture p6: page 1]
