ericherman/megaprocessor/module_artwork_decoding_b/module_decoding_b.pdf

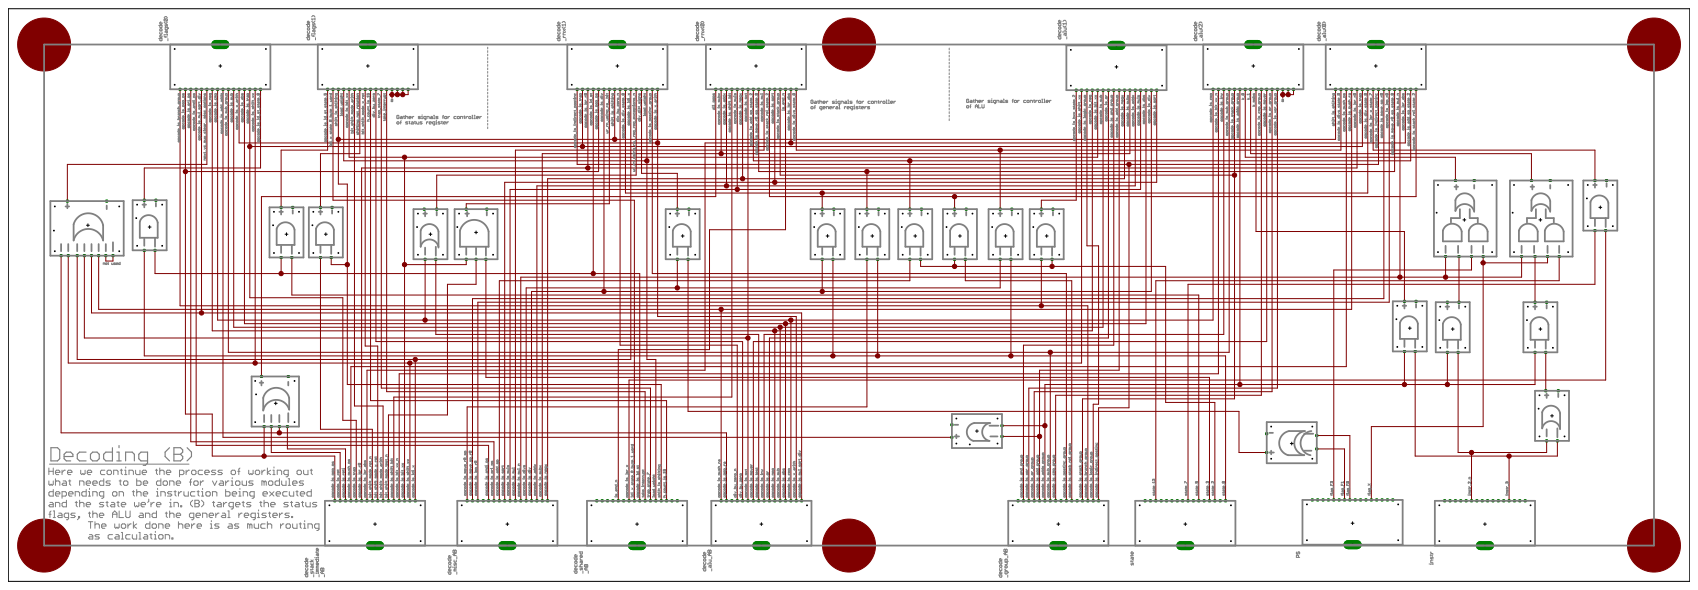
[picture p7: page 1]
