ericherman/megaprocessor/module_artwork_flags_calc/module_flags_calc.pdf

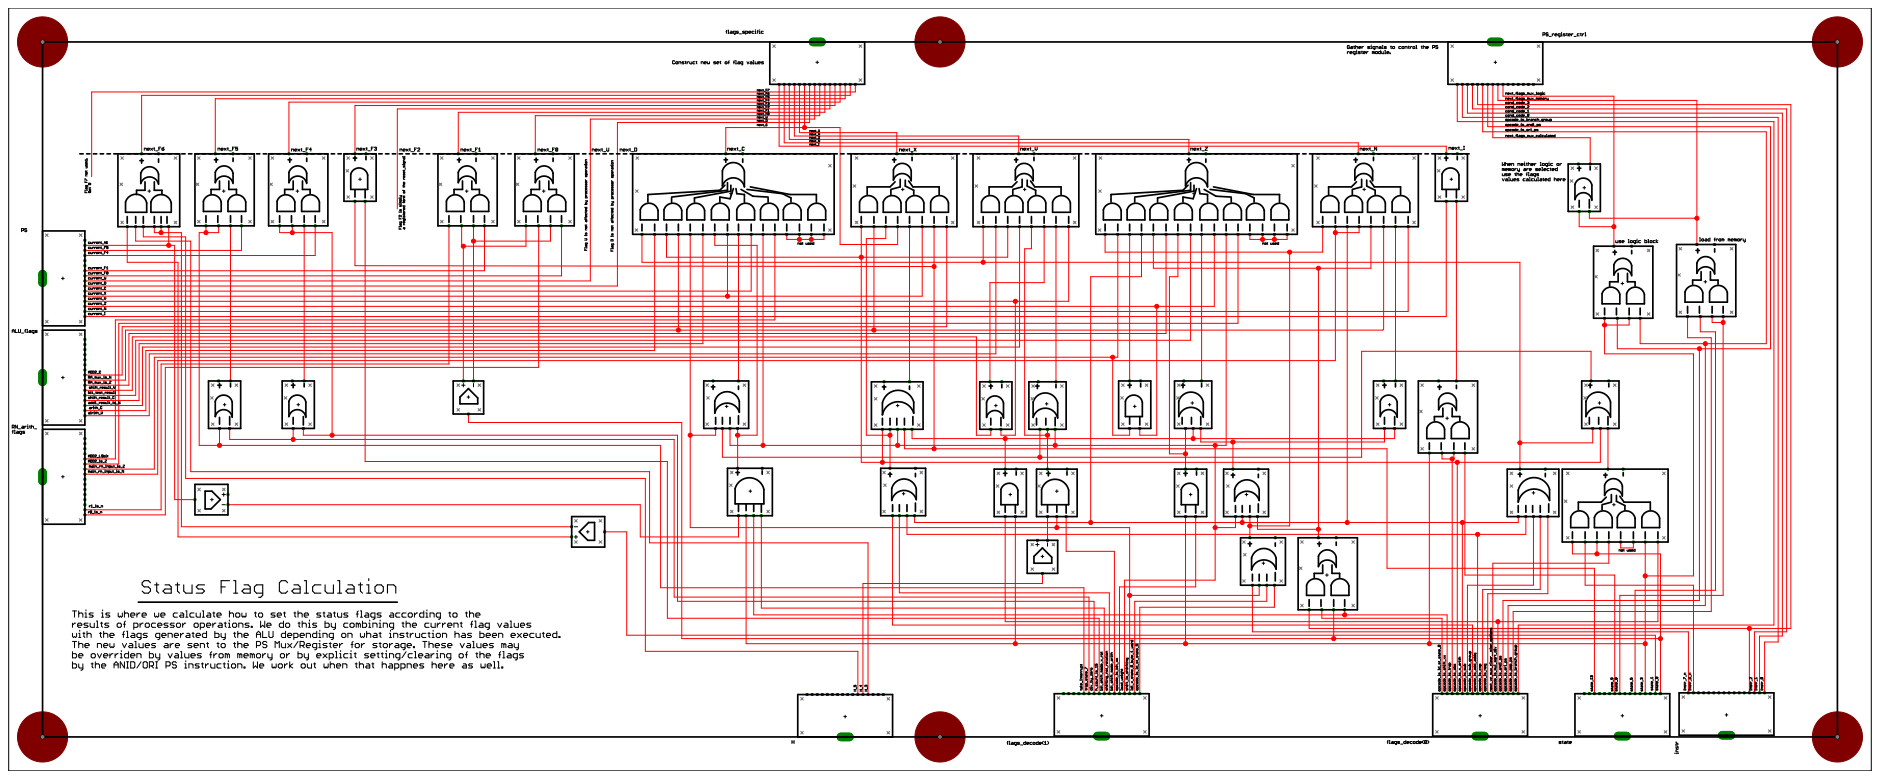
[picture p8: page 1]
