ericherman/megaprocessor/module_artwork_flags_reg/module_flags_reg.pdf

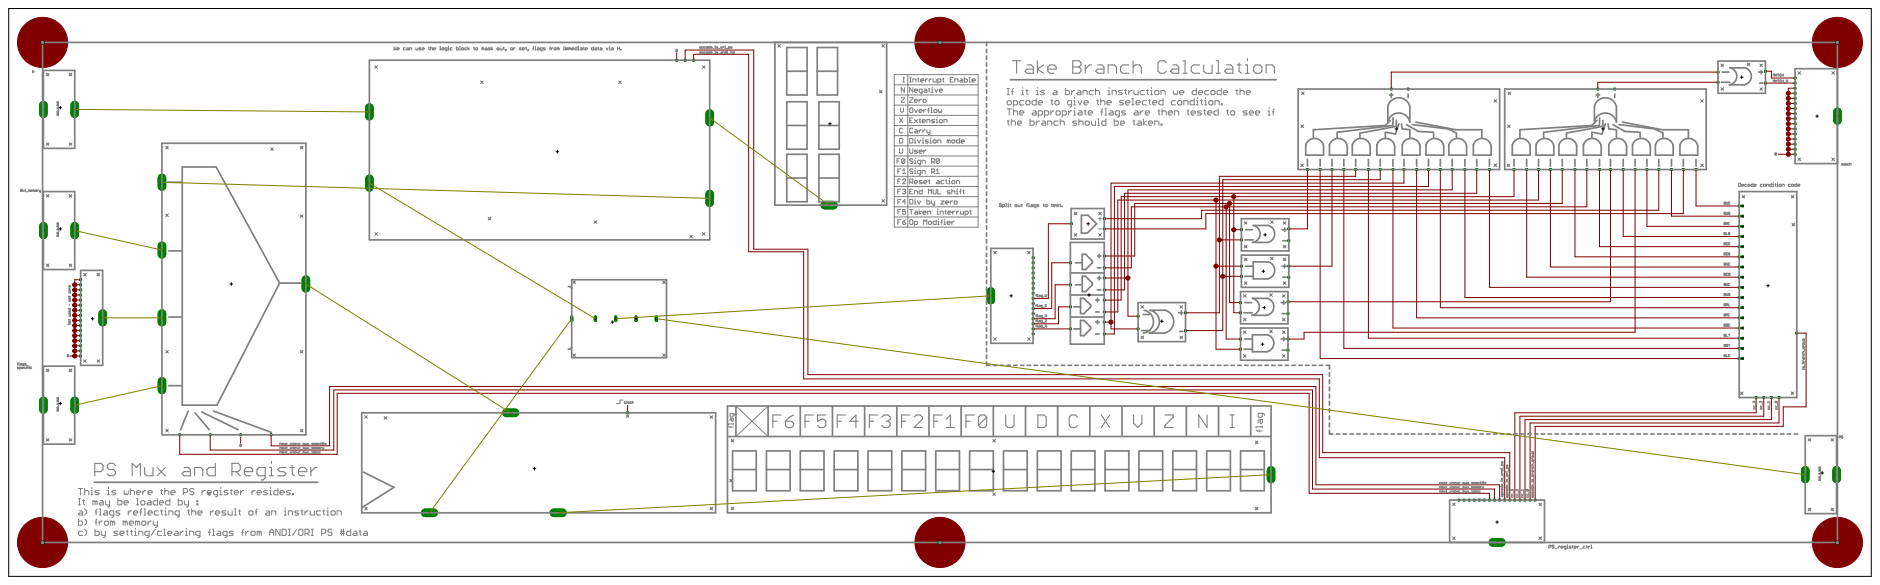
[picture p9: page 1]
