ericherman/megaprocessor/module_artwork_instr_reg/module_instr_reg.pdf

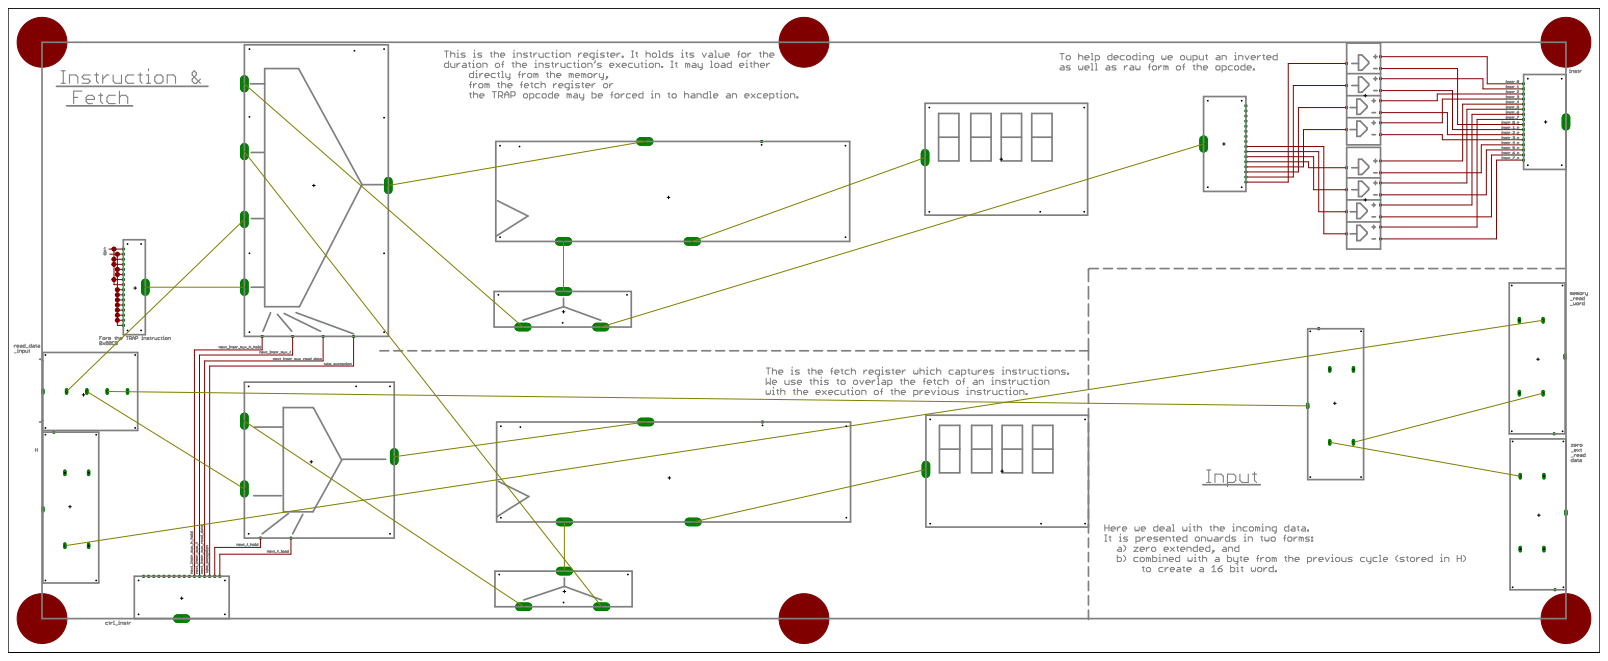
[picture p10: page 1]
