ericherman/megaprocessor/module_artwork_rn_reg/module_Rn_reg.pdf

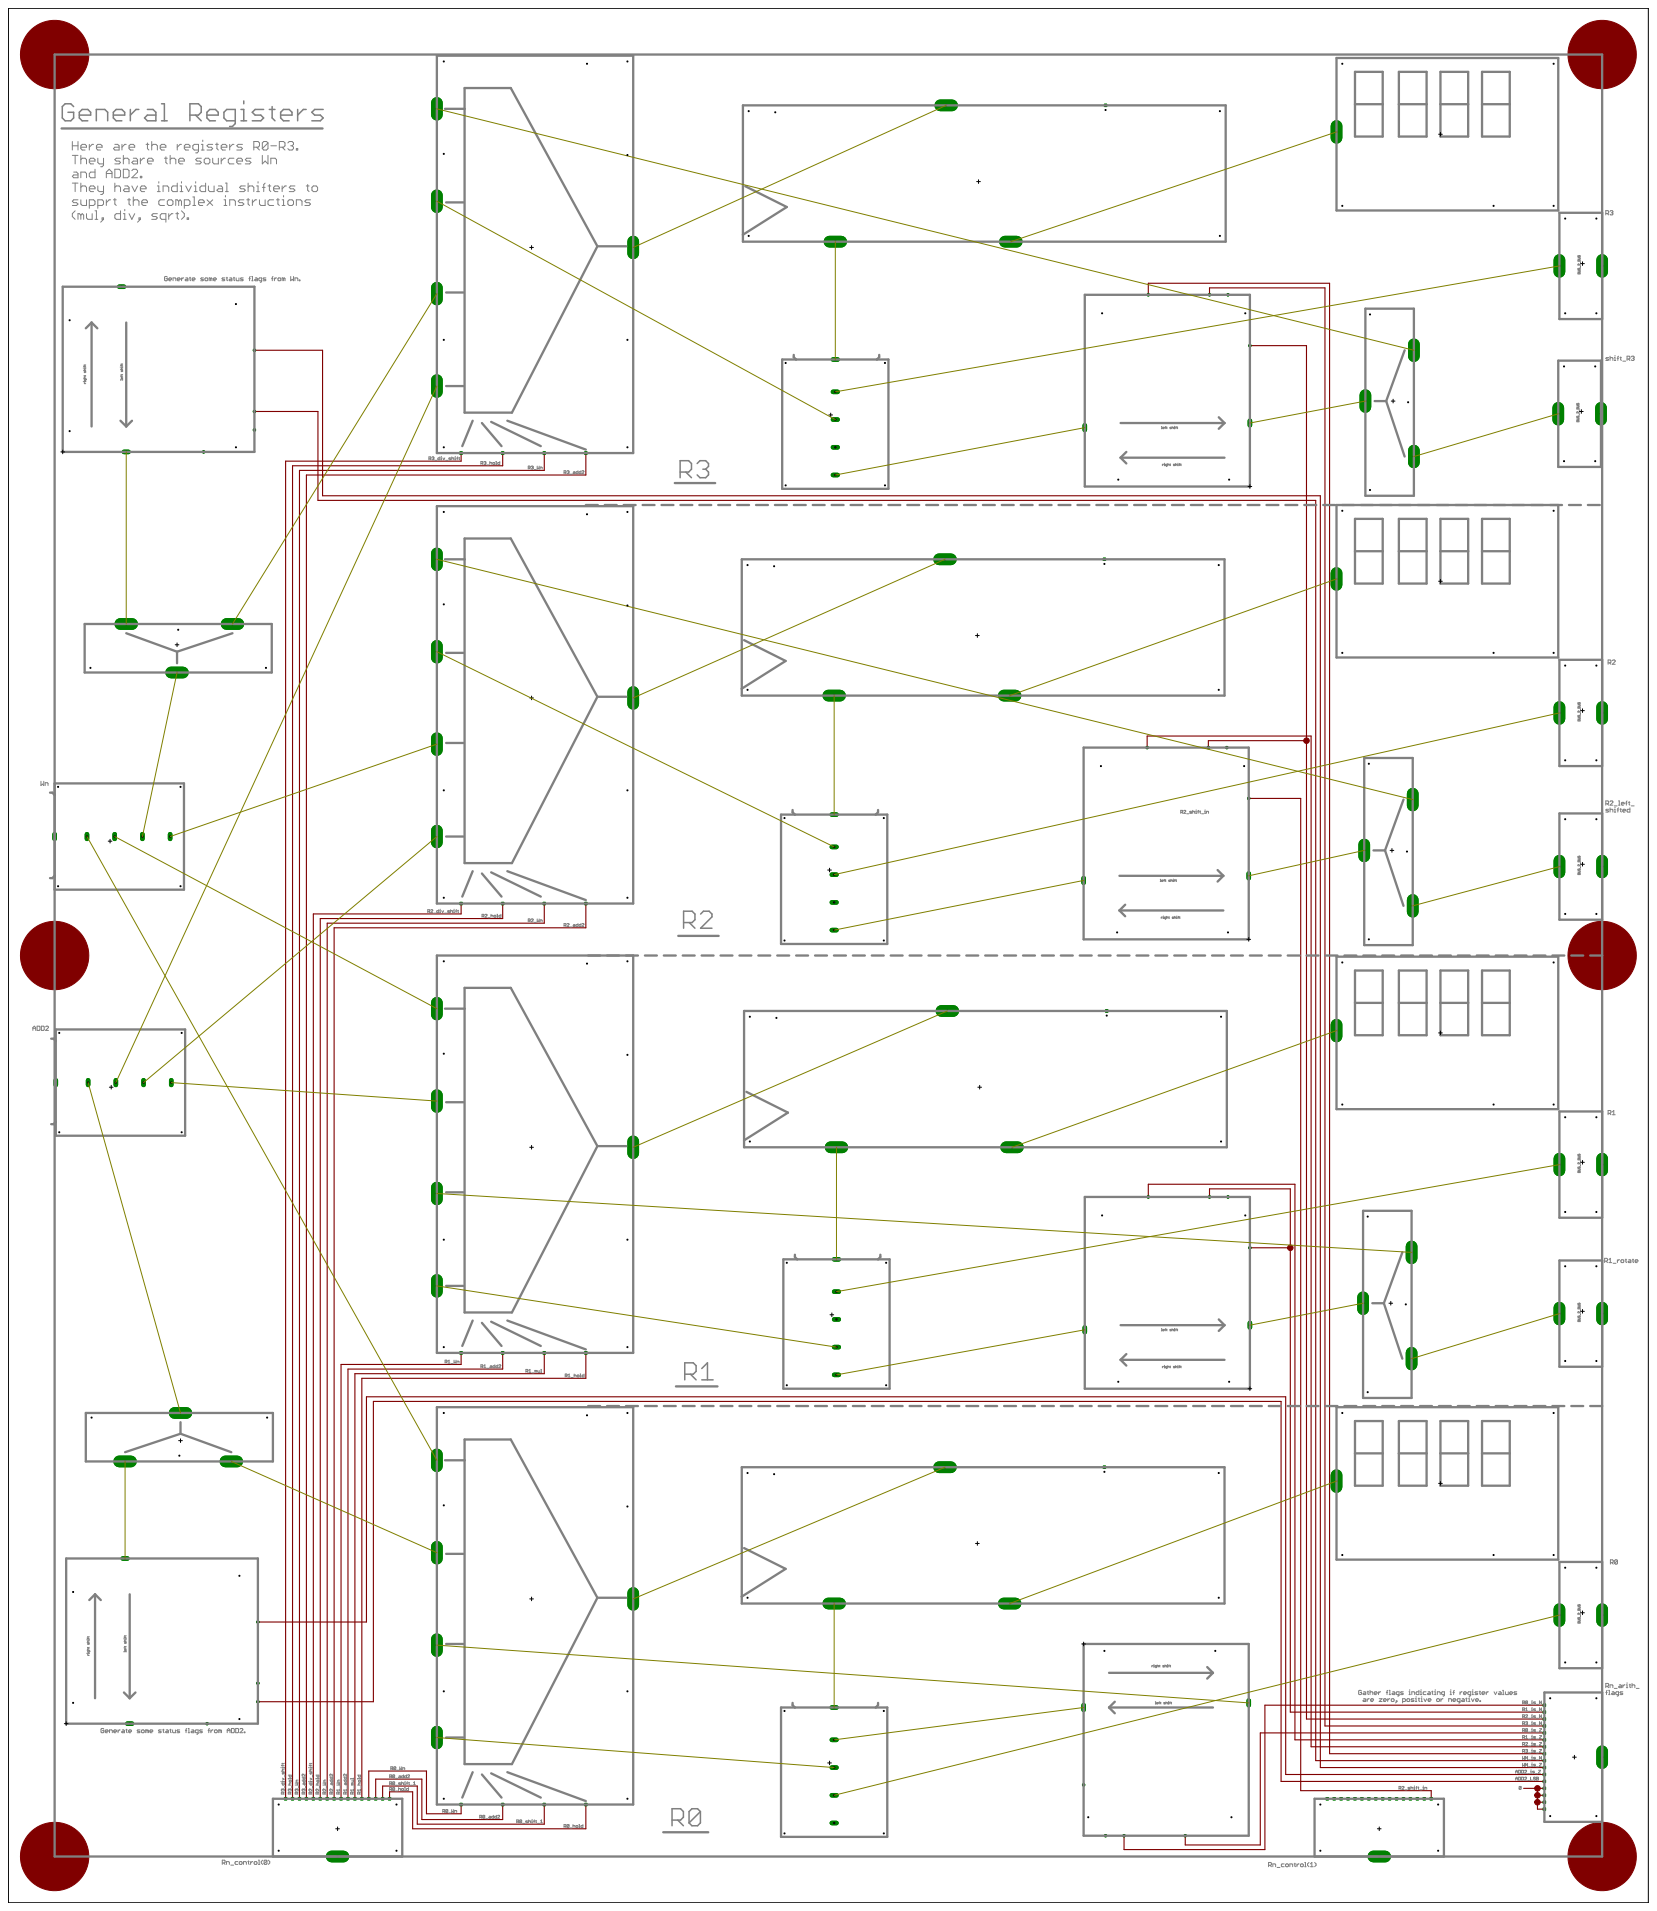
[picture p11: page 1]
