ericherman/megaprocessor/module_artwork_rnx_ctrl/module_Rnx_ctrl.pdf

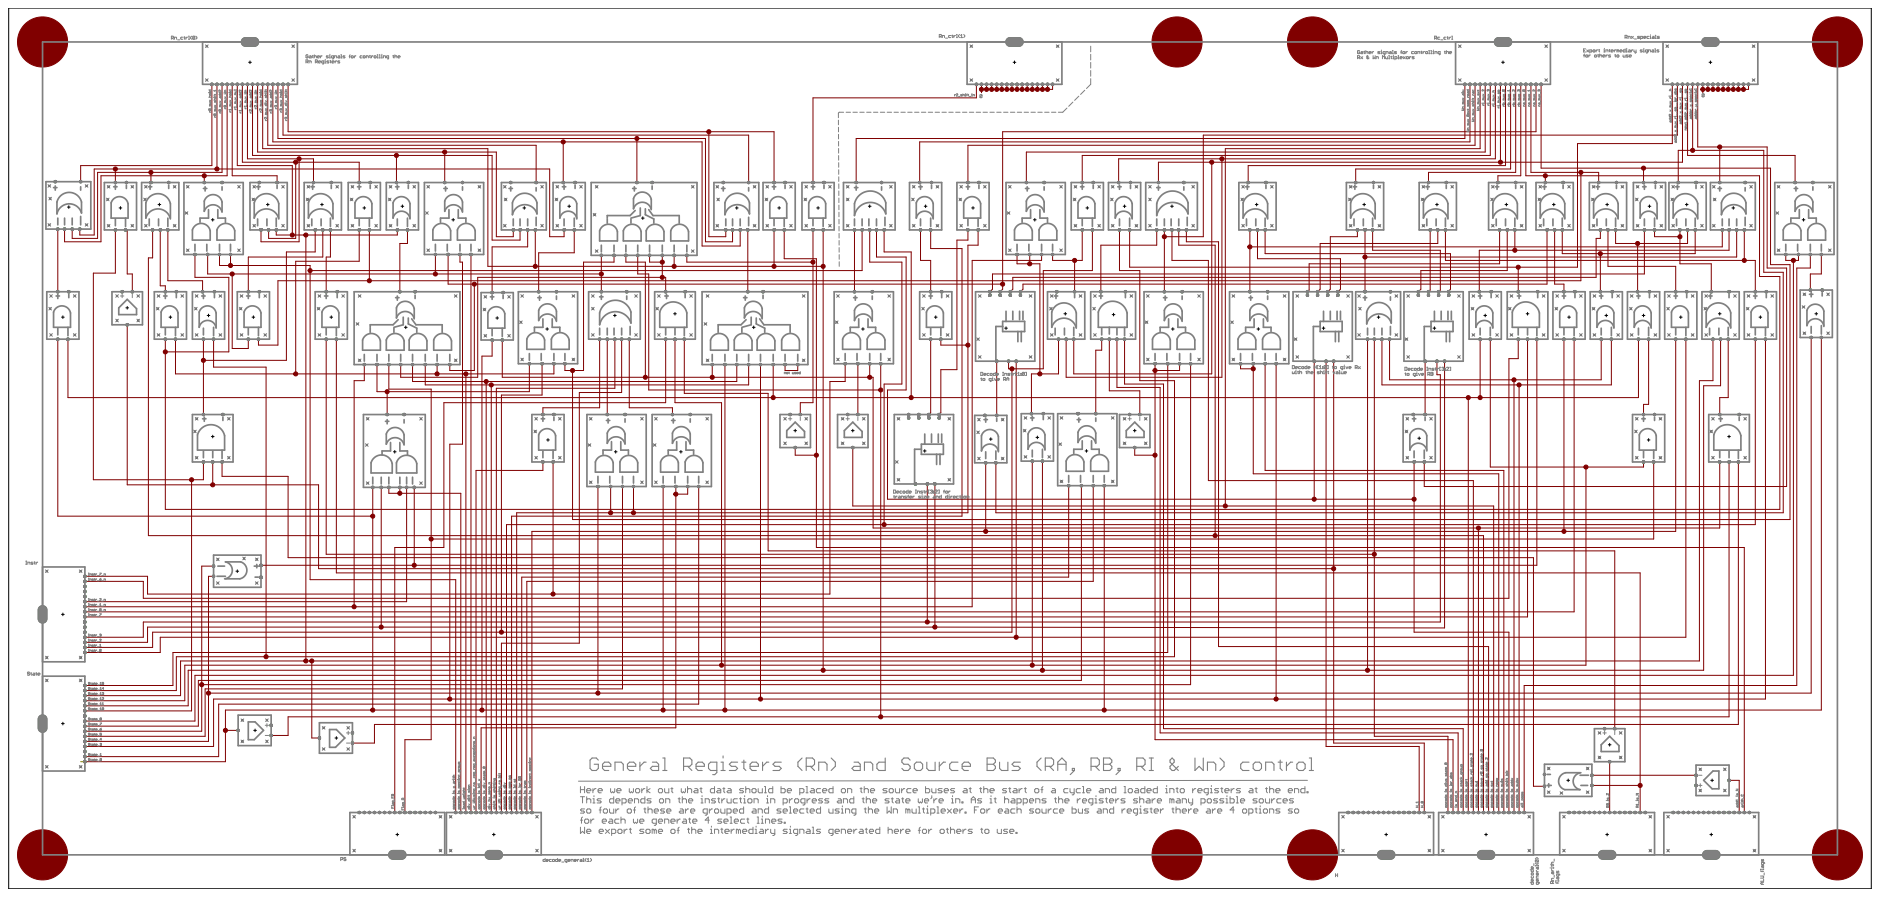
[picture p12: page 1]
