ericherman/megaprocessor/module_artwork_rx_mux/module_Rx_mux.pdf

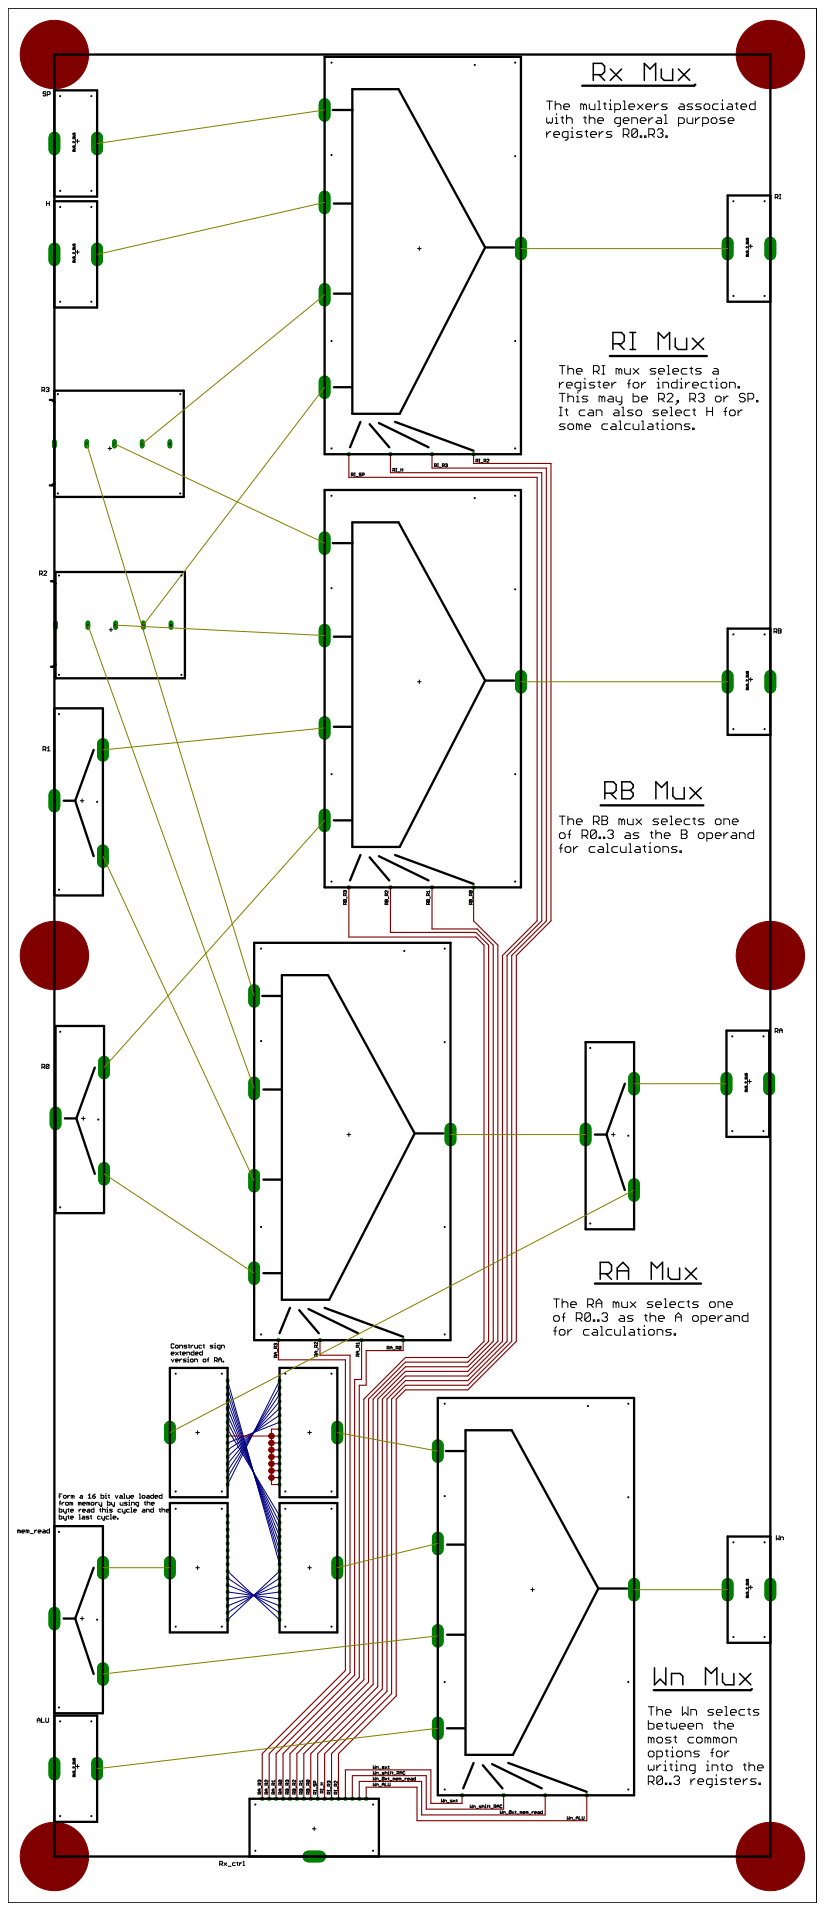
[picture p13: page 1]
