ericherman/megaprocessor/module_artwork_state/module_state.pdf

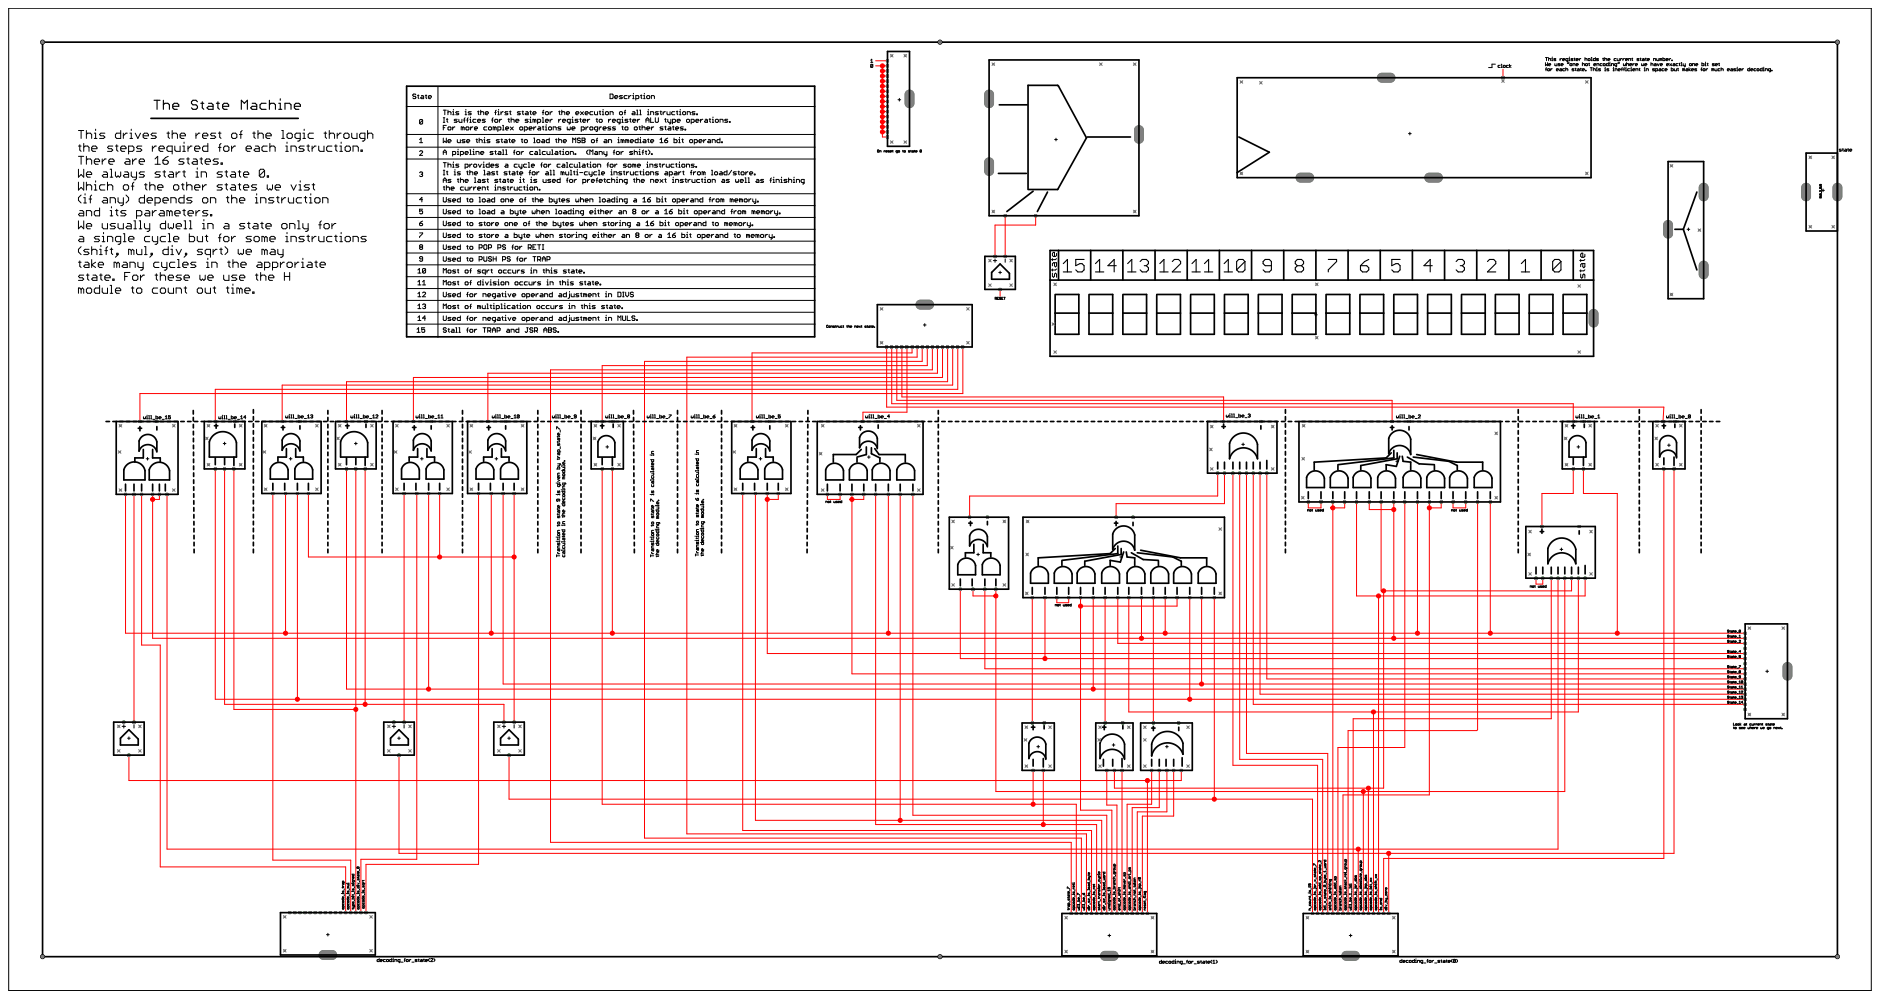
[picture p14: page 1]
