ericherman/megaprocessor/igor/IGOR_1.brd

## EAGLE design igor/IGOR_1.brd (2017-05-20)

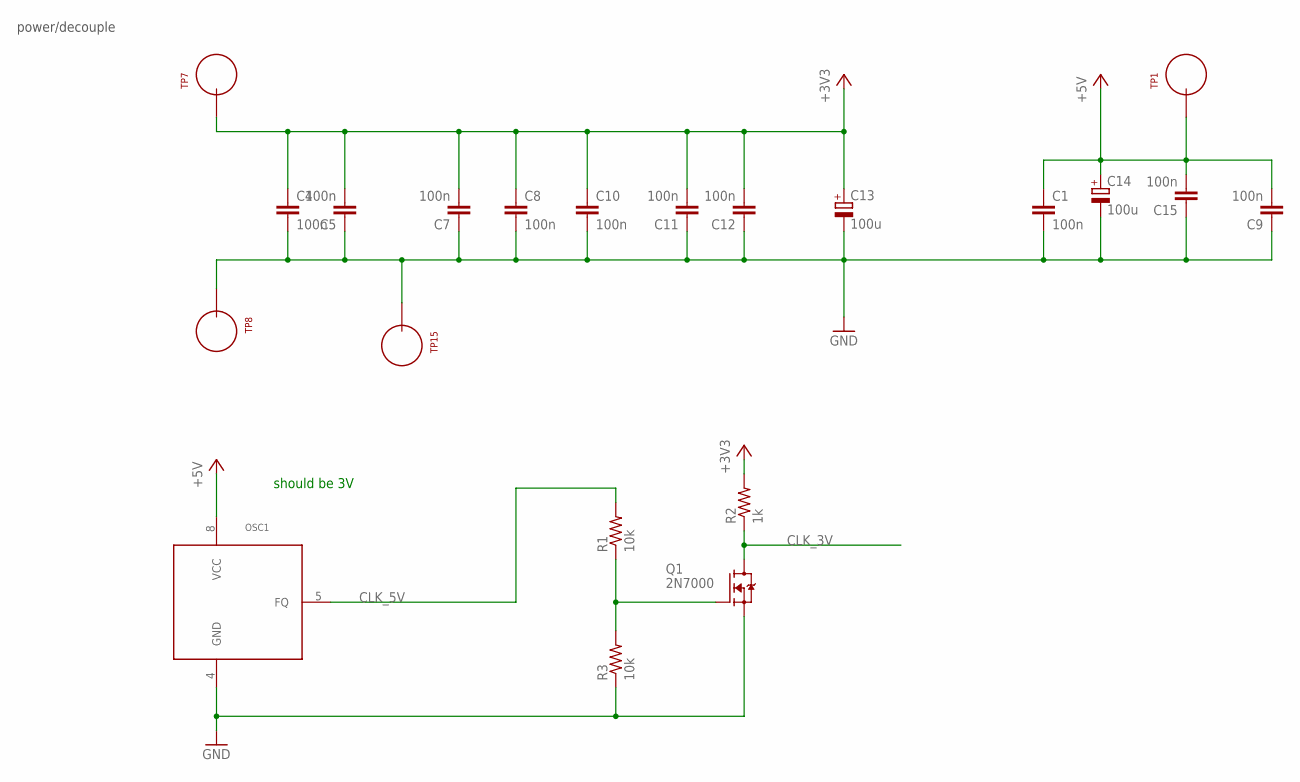
[picture p15: schematic IGOR_1.sch, sheet 1]

Parts:
C1, C4, C5, C7, C8, C9, C10, C11, C12, C15: 100n; CAP_P2INCH
C13, C14: 100u; POLARISED_CAP_2P5_6P3MM
OSC1: OSC_12P9_MM
Q1: 2N7000; TO92-DGS
R1, R3: 10k; R_P2INCH
R2: 1k; R_P2INCH
TP1, TP7, TP8, TP15: TEST_LOOP

Connections:
+3V3: C4.1, C5.2, C7.2, C8.1, C10.1, C11.2, C12.2, C13.A, R2.2, TP7.P$1; also elsewhere on the board
+5V: C1.1, C9.2, C14.A, C15.2, OSC1.8 (VCC), TP1.P$1; also elsewhere on the board
CLK_3V: Q1.D, R2.1; also elsewhere on the board
CLK_5V: Q1.G, R1.1, R3.2
GND: C1.2, C4.2, C5.1, C7.1, C8.2, C9.1, C10.2, C11.1, C12.1, C13.K, C14.K, C15.1, OSC1.4 (GND), Q1.S, R3.1, TP8.P$1, TP15.P$1; also elsewhere on the board
unnamed: OSC1.5 (FQ), R1.2

Notes on the sheet:
power/decouple
should be 3V

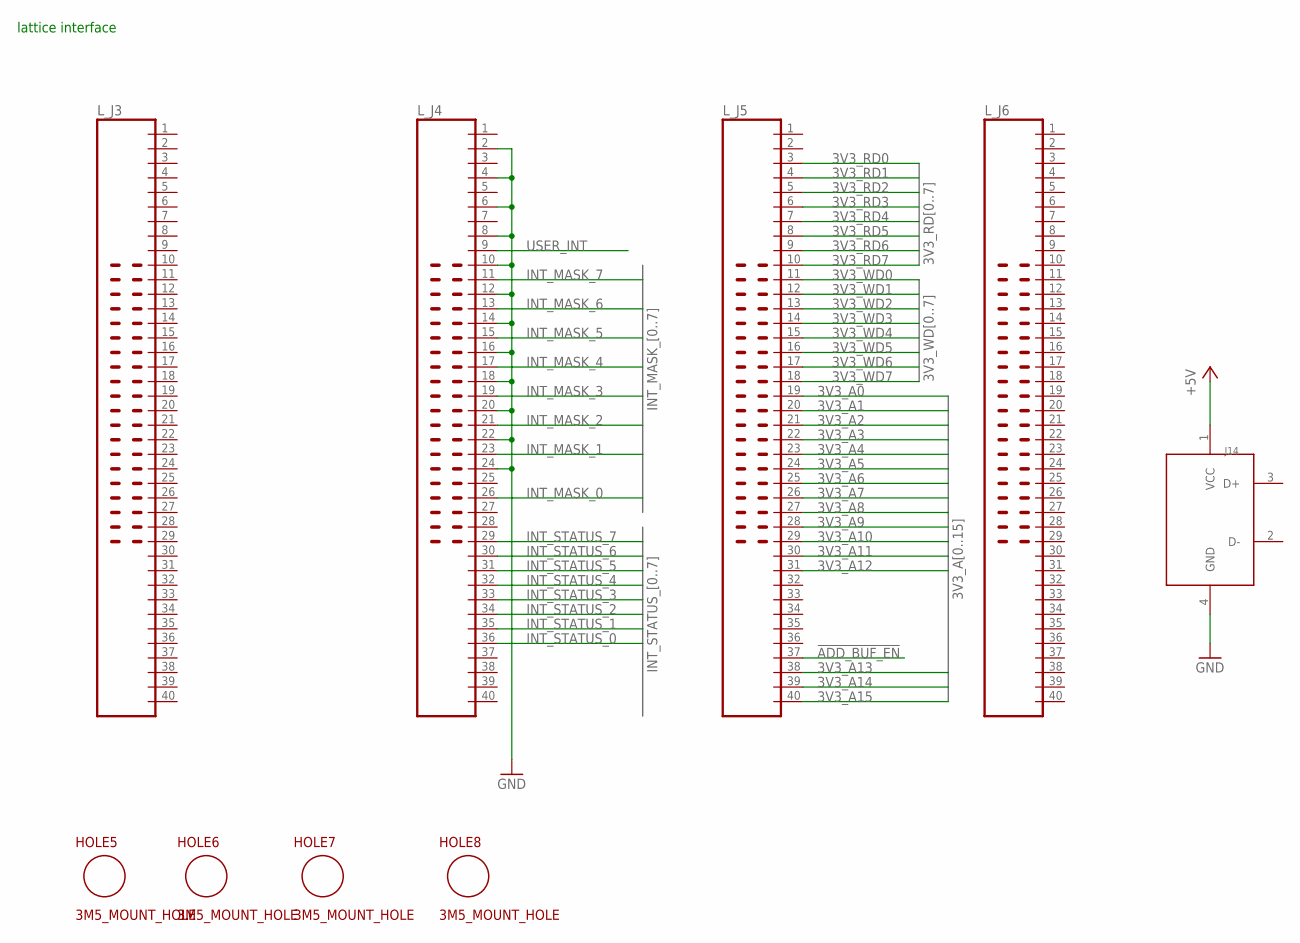
[picture p16: schematic IGOR_1.sch, sheet 2]

Parts:
HOLE5, HOLE6, HOLE7, HOLE8: 3M5_MOUNT_HOLE; 3P5M_HOLE
J14: USB_TYPE_A
L_J3, L_J4, L_J5, L_J6: JUMP_20X2

Connections:
3V3_A0: L_J5.19; also elsewhere on the board
3V3_A1: L_J5.20; also elsewhere on the board
3V3_A2: L_J5.21; also elsewhere on the board
3V3_A3: L_J5.22; also elsewhere on the board
3V3_A4: L_J5.23; also elsewhere on the board
3V3_A5: L_J5.24; also elsewhere on the board
3V3_A6: L_J5.25; also elsewhere on the board
3V3_A7: L_J5.26; also elsewhere on the board
3V3_A8: L_J5.27; also elsewhere on the board
3V3_A9: L_J5.28; also elsewhere on the board
3V3_A10: L_J5.29; also elsewhere on the board
3V3_A11: L_J5.30; also elsewhere on the board
3V3_A12: L_J5.31; also elsewhere on the board
3V3_A13: L_J5.38; also elsewhere on the board
3V3_A14: L_J5.39; also elsewhere on the board
3V3_A15: L_J5.40; also elsewhere on the board
3V3_RD0: L_J5.3; also elsewhere on the board
3V3_RD1: L_J5.4; also elsewhere on the board
3V3_RD2: L_J5.5; also elsewhere on the board
3V3_RD3: L_J5.6; also elsewhere on the board
3V3_RD4: L_J5.7; also elsewhere on the board
3V3_RD5: L_J5.8; also elsewhere on the board
3V3_RD6: L_J5.9; also elsewhere on the board
3V3_RD7: L_J5.10; also elsewhere on the board
3V3_WD0: L_J5.11; also elsewhere on the board
3V3_WD1: L_J5.12; also elsewhere on the board
3V3_WD2: L_J5.13; also elsewhere on the board
3V3_WD3: L_J5.14; also elsewhere on the board
3V3_WD4: L_J5.15; also elsewhere on the board
3V3_WD5: L_J5.16; also elsewhere on the board
3V3_WD6: L_J5.17; also elsewhere on the board
3V3_WD7: L_J5.18; also elsewhere on the board
!ADD_BUF_EN: L_J5.37; also elsewhere on the board
+5V: J14.1 (VCC); also elsewhere on the board
GND: J14.4 (GND), L_J4.2, L_J4.4, L_J4.6, L_J4.8, L_J4.10, L_J4.12, L_J4.14, L_J4.16, L_J4.18, L_J4.20, L_J4.22, L_J4.24; also elsewhere on the board
INT_MASK_0: L_J4.26; also elsewhere on the board
INT_MASK_1: L_J4.23; also elsewhere on the board
INT_MASK_2: L_J4.21; also elsewhere on the board
INT_MASK_3: L_J4.19; also elsewhere on the board
INT_MASK_4: L_J4.17; also elsewhere on the board
INT_MASK_5: L_J4.15; also elsewhere on the board
INT_MASK_6: L_J4.13; also elsewhere on the board
INT_MASK_7: L_J4.11; also elsewhere on the board
INT_STATUS_0: L_J4.36; also elsewhere on the board
INT_STATUS_1: L_J4.35; also elsewhere on the board
INT_STATUS_2: L_J4.34; also elsewhere on the board
INT_STATUS_3: L_J4.33; also elsewhere on the board
INT_STATUS_4: L_J4.32; also elsewhere on the board
INT_STATUS_5: L_J4.31; also elsewhere on the board
INT_STATUS_6: L_J4.30; also elsewhere on the board
INT_STATUS_7: L_J4.29; also elsewhere on the board
USER_INT: L_J4.9; also elsewhere on the board

Notes on the sheet:
lattice interface

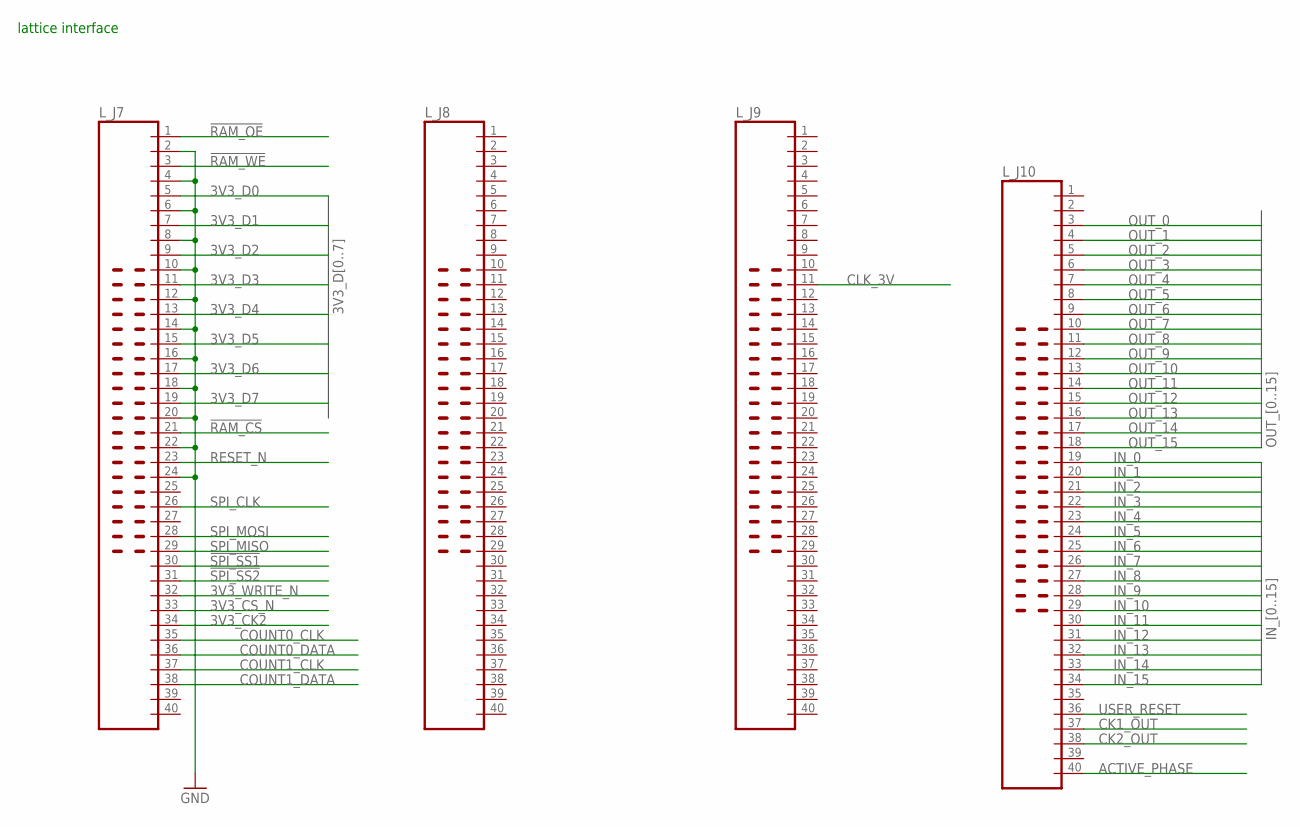
[picture p17: schematic IGOR_1.sch, sheet 3]

Parts:
L_J7, L_J8, L_J9, L_J10: JUMP_20X2

Connections:
3V3_CK2: L_J7.34; also elsewhere on the board
3V3_CS_N: L_J7.33; also elsewhere on the board
3V3_D0: L_J7.5; also elsewhere on the board
3V3_D1: L_J7.7; also elsewhere on the board
3V3_D2: L_J7.9; also elsewhere on the board
3V3_D3: L_J7.11; also elsewhere on the board
3V3_D4: L_J7.13; also elsewhere on the board
3V3_D5: L_J7.15; also elsewhere on the board
3V3_D6: L_J7.17; also elsewhere on the board
3V3_D7: L_J7.19; also elsewhere on the board
3V3_WRITE_N: L_J7.32; also elsewhere on the board
!RAM_CS: L_J7.21; also elsewhere on the board
!RAM_OE: L_J7.1; also elsewhere on the board
!RAM_WE: L_J7.3; also elsewhere on the board
!SPI_SS1: L_J7.30; also elsewhere on the board
!SPI_SS2: L_J7.31; also elsewhere on the board
ACTIVE_PHASE: L_J10.40; also elsewhere on the board
CK1_OUT: L_J10.37; also elsewhere on the board
CK2_OUT: L_J10.38; also elsewhere on the board
CLK_3V: L_J9.11; also elsewhere on the board
COUNT0_CLK: L_J7.35; also elsewhere on the board
COUNT0_DATA: L_J7.36; also elsewhere on the board
COUNT1_CLK: L_J7.37; also elsewhere on the board
COUNT1_DATA: L_J7.38; also elsewhere on the board
GND: L_J7.2, L_J7.4, L_J7.6, L_J7.8, L_J7.10, L_J7.12, L_J7.14, L_J7.16, L_J7.18, L_J7.20, L_J7.22, L_J7.24; also elsewhere on the board
IN_0: L_J10.19; also elsewhere on the board
IN_1: L_J10.20; also elsewhere on the board
IN_2: L_J10.21; also elsewhere on the board
IN_3: L_J10.22; also elsewhere on the board
IN_4: L_J10.23; also elsewhere on the board
IN_5: L_J10.24; also elsewhere on the board
IN_6: L_J10.25; also elsewhere on the board
IN_7: L_J10.26; also elsewhere on the board
IN_8: L_J10.27; also elsewhere on the board
IN_9: L_J10.28; also elsewhere on the board
IN_10: L_J10.29; also elsewhere on the board
IN_11: L_J10.30; also elsewhere on the board
IN_12: L_J10.31; also elsewhere on the board
IN_13: L_J10.32; also elsewhere on the board
IN_14: L_J10.33; also elsewhere on the board
IN_15: L_J10.34; also elsewhere on the board
OUT_0: L_J10.3; also elsewhere on the board
OUT_1: L_J10.4; also elsewhere on the board
OUT_2: L_J10.5; also elsewhere on the board
OUT_3: L_J10.6; also elsewhere on the board
OUT_4: L_J10.7; also elsewhere on the board
OUT_5: L_J10.8; also elsewhere on the board
OUT_6: L_J10.9; also elsewhere on the board
OUT_7: L_J10.10; also elsewhere on the board
OUT_8: L_J10.11; also elsewhere on the board
OUT_9: L_J10.12; also elsewhere on the board
OUT_10: L_J10.13; also elsewhere on the board
OUT_11: L_J10.14; also elsewhere on the board
OUT_12: L_J10.15; also elsewhere on the board
OUT_13: L_J10.16; also elsewhere on the board
OUT_14: L_J10.17; also elsewhere on the board
OUT_15: L_J10.18; also elsewhere on the board
RESET_N: L_J7.23; also elsewhere on the board
SPI_CLK: L_J7.26; also elsewhere on the board
SPI_MISO: L_J7.29; also elsewhere on the board
SPI_MOSI: L_J7.28; also elsewhere on the board
USER_RESET: L_J10.36; also elsewhere on the board

Notes on the sheet:
lattice interface

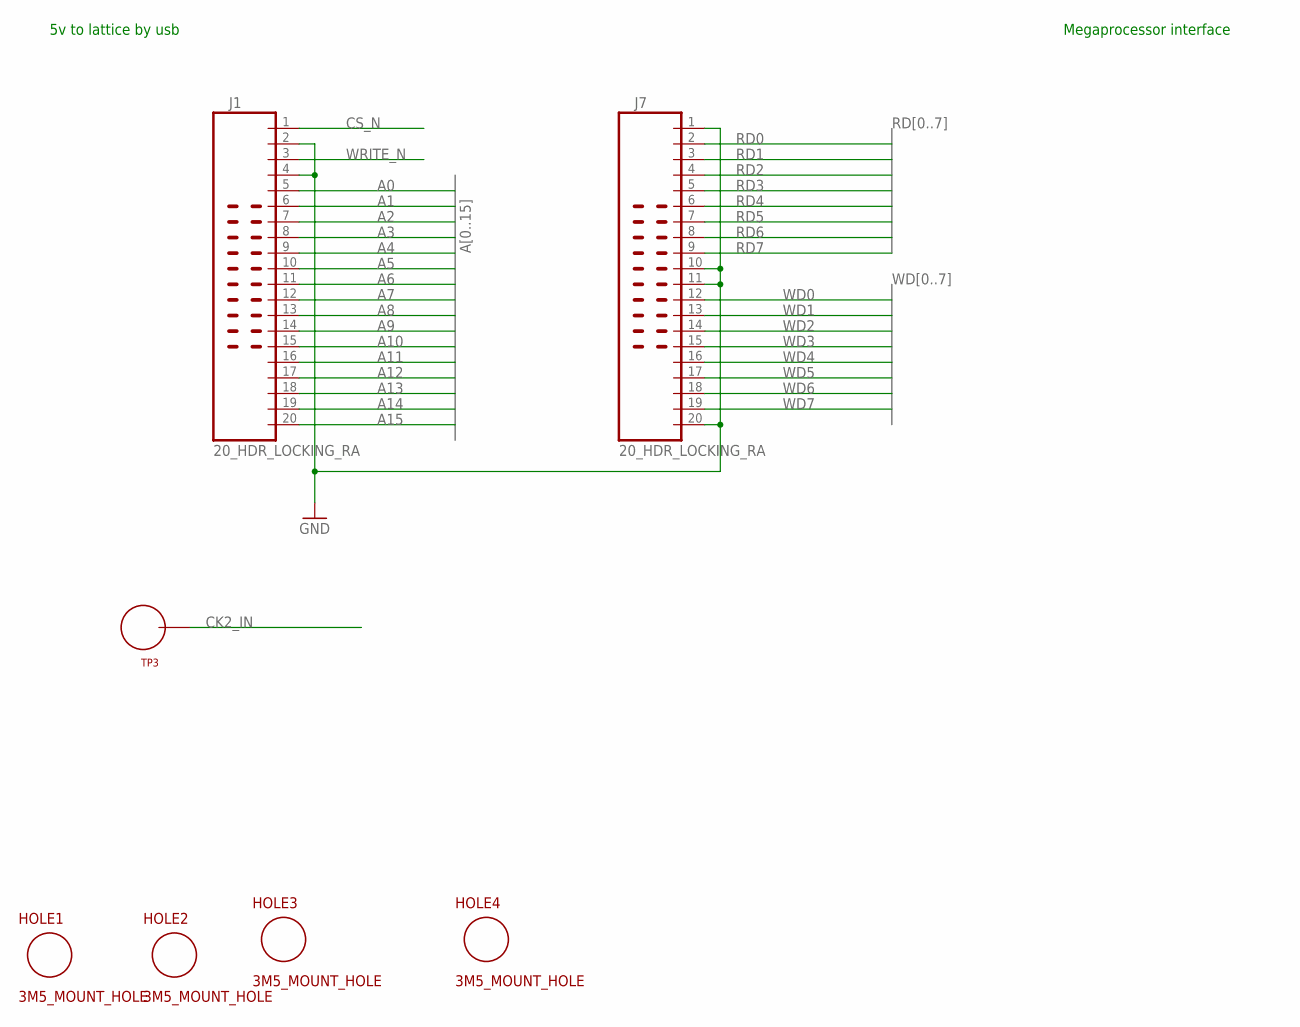
[picture p18: schematic IGOR_1.sch, sheet 4]

Parts:
HOLE1, HOLE2, HOLE3, HOLE4: 3M5_MOUNT_HOLE; 3P5M_HOLE
J1, J7: 20_HDR_LOCKING_RA
TP3: TEST_LOOP

Connections:
A0: J1.5; also elsewhere on the board
A1: J1.6; also elsewhere on the board
A2: J1.7; also elsewhere on the board
A3: J1.8; also elsewhere on the board
A4: J1.9; also elsewhere on the board
A5: J1.10; also elsewhere on the board
A6: J1.11; also elsewhere on the board
A7: J1.12; also elsewhere on the board
A8: J1.13; also elsewhere on the board
A9: J1.14; also elsewhere on the board
A10: J1.15; also elsewhere on the board
A11: J1.16; also elsewhere on the board
A12: J1.17; also elsewhere on the board
A13: J1.18; also elsewhere on the board
A14: J1.19; also elsewhere on the board
A15: J1.20; also elsewhere on the board
CK2_IN: TP3.P$1; also elsewhere on the board
CS_N: J1.1; also elsewhere on the board
GND: J1.2, J1.4, J7.1, J7.10, J7.11, J7.20; also elsewhere on the board
RD0: J7.2; also elsewhere on the board
RD1: J7.3; also elsewhere on the board
RD2: J7.4; also elsewhere on the board
RD3: J7.5; also elsewhere on the board
RD4: J7.6; also elsewhere on the board
RD5: J7.7; also elsewhere on the board
RD6: J7.8; also elsewhere on the board
RD7: J7.9; also elsewhere on the board
WD0: J7.12; also elsewhere on the board
WD1: J7.13; also elsewhere on the board
WD2: J7.14; also elsewhere on the board
WD3: J7.15; also elsewhere on the board
WD4: J7.16; also elsewhere on the board
WD5: J7.17; also elsewhere on the board
WD6: J7.18; also elsewhere on the board
WD7: J7.19; also elsewhere on the board
WRITE_N: J1.3; also elsewhere on the board

Notes on the sheet:
5v to lattice by usb
Megaprocessor interface

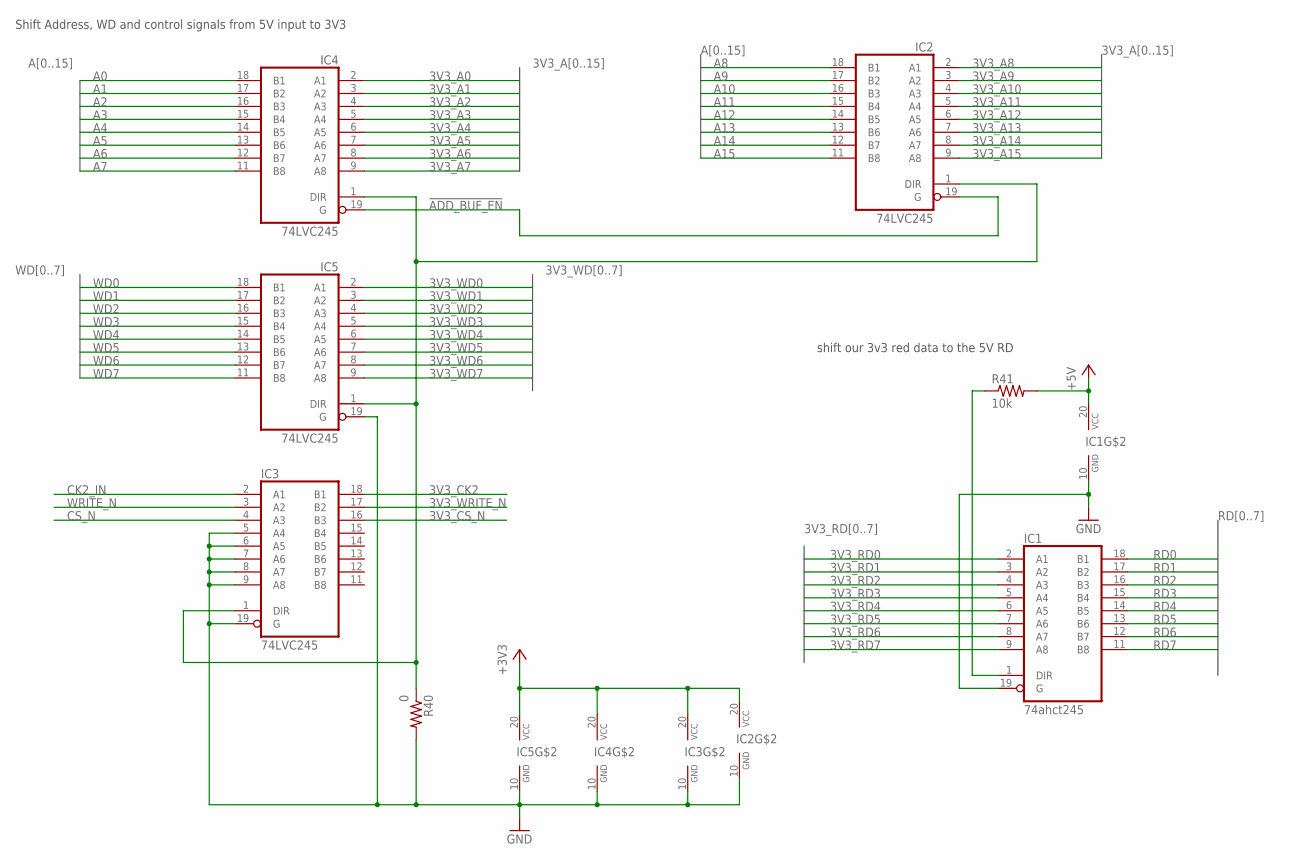
[picture p19: schematic IGOR_1.sch, sheet 5]

Parts:
IC1: 74ahct245; DIP20
IC2, IC3, IC4, IC5: 74LVC245; DIP20
R40: 0; R_P2INCH
R41: 10k; R_P2INCH

Connections:
3V3_A0: IC4.2 (A1); also elsewhere on the board
3V3_A1: IC4.3 (A2); also elsewhere on the board
3V3_A2: IC4.4 (A3); also elsewhere on the board
3V3_A3: IC4.5 (A4); also elsewhere on the board
3V3_A4: IC4.6 (A5); also elsewhere on the board
3V3_A5: IC4.7 (A6); also elsewhere on the board
3V3_A6: IC4.8 (A7); also elsewhere on the board
3V3_A7: IC4.9 (A8); also elsewhere on the board
3V3_A8: IC2.2 (A1); also elsewhere on the board
3V3_A9: IC2.3 (A2); also elsewhere on the board
3V3_A10: IC2.4 (A3); also elsewhere on the board
3V3_A11: IC2.5 (A4); also elsewhere on the board
3V3_A12: IC2.6 (A5); also elsewhere on the board
3V3_A13: IC2.7 (A6); also elsewhere on the board
3V3_A14: IC2.8 (A7); also elsewhere on the board
3V3_A15: IC2.9 (A8); also elsewhere on the board
3V3_CK2: IC3.18 (B1); also elsewhere on the board
3V3_CS_N: IC3.16 (B3); also elsewhere on the board
3V3_RD0: IC1.2 (A1); also elsewhere on the board
3V3_RD1: IC1.3 (A2); also elsewhere on the board
3V3_RD2: IC1.4 (A3); also elsewhere on the board
3V3_RD3: IC1.5 (A4); also elsewhere on the board
3V3_RD4: IC1.6 (A5); also elsewhere on the board
3V3_RD5: IC1.7 (A6); also elsewhere on the board
3V3_RD6: IC1.8 (A7); also elsewhere on the board
3V3_RD7: IC1.9 (A8); also elsewhere on the board
3V3_WD0: IC5.2 (A1); also elsewhere on the board
3V3_WD1: IC5.3 (A2); also elsewhere on the board
3V3_WD2: IC5.4 (A3); also elsewhere on the board
3V3_WD3: IC5.5 (A4); also elsewhere on the board
3V3_WD4: IC5.6 (A5); also elsewhere on the board
3V3_WD5: IC5.7 (A6); also elsewhere on the board
3V3_WD6: IC5.8 (A7); also elsewhere on the board
3V3_WD7: IC5.9 (A8); also elsewhere on the board
3V3_WRITE_N: IC3.17 (B2); also elsewhere on the board
!ADD_BUF_EN: IC2.19 (G), IC4.19 (G); also elsewhere on the board
+3V3: IC2.20 (VCC), IC3.20 (VCC), IC4.20 (VCC), IC5.20 (VCC); also elsewhere on the board
+5V: IC1.20 (VCC), R41.2; also elsewhere on the board
A0: IC4.18 (B1); also elsewhere on the board
A1: IC4.17 (B2); also elsewhere on the board
A2: IC4.16 (B3); also elsewhere on the board
A3: IC4.15 (B4); also elsewhere on the board
A4: IC4.14 (B5); also elsewhere on the board
A5: IC4.13 (B6); also elsewhere on the board
A6: IC4.12 (B7); also elsewhere on the board
A7: IC4.11 (B8); also elsewhere on the board
A8: IC2.18 (B1); also elsewhere on the board
A9: IC2.17 (B2); also elsewhere on the board
A10: IC2.16 (B3); also elsewhere on the board
A11: IC2.15 (B4); also elsewhere on the board
A12: IC2.14 (B5); also elsewhere on the board
A13: IC2.13 (B6); also elsewhere on the board
A14: IC2.12 (B7); also elsewhere on the board
A15: IC2.11 (B8); also elsewhere on the board
CK2_IN: IC3.2 (A1); also elsewhere on the board
CS_N: IC3.4 (A3); also elsewhere on the board
GND: IC1.10 (GND), IC1.19 (G), IC2.10 (GND), IC3.5 (A4), IC3.6 (A5), IC3.7 (A6), IC3.8 (A7), IC3.9 (A8), IC3.10 (GND), IC3.19 (G), IC4.10 (GND), IC5.10 (GND), IC5.19 (G), R40.2; also elsewhere on the board
unnamed: IC2.1 (DIR), IC3.1 (DIR), IC4.1 (DIR), IC5.1 (DIR), R40.1
unnamed: IC1.1 (DIR), R41.1
RD0: IC1.18 (B1); also elsewhere on the board
RD1: IC1.17 (B2); also elsewhere on the board
RD2: IC1.16 (B3); also elsewhere on the board
RD3: IC1.15 (B4); also elsewhere on the board
RD4: IC1.14 (B5); also elsewhere on the board
RD5: IC1.13 (B6); also elsewhere on the board
RD6: IC1.12 (B7); also elsewhere on the board
RD7: IC1.11 (B8); also elsewhere on the board
WD0: IC5.18 (B1); also elsewhere on the board
WD1: IC5.17 (B2); also elsewhere on the board
WD2: IC5.16 (B3); also elsewhere on the board
WD3: IC5.15 (B4); also elsewhere on the board
WD4: IC5.14 (B5); also elsewhere on the board
WD5: IC5.13 (B6); also elsewhere on the board
WD6: IC5.12 (B7); also elsewhere on the board
WD7: IC5.11 (B8); also elsewhere on the board
WRITE_N: IC3.3 (A2); also elsewhere on the board

Notes on the sheet:
Shift Address, WD and control signals from 5V input to 3V3
shift our 3v3 red data to the 5V RD

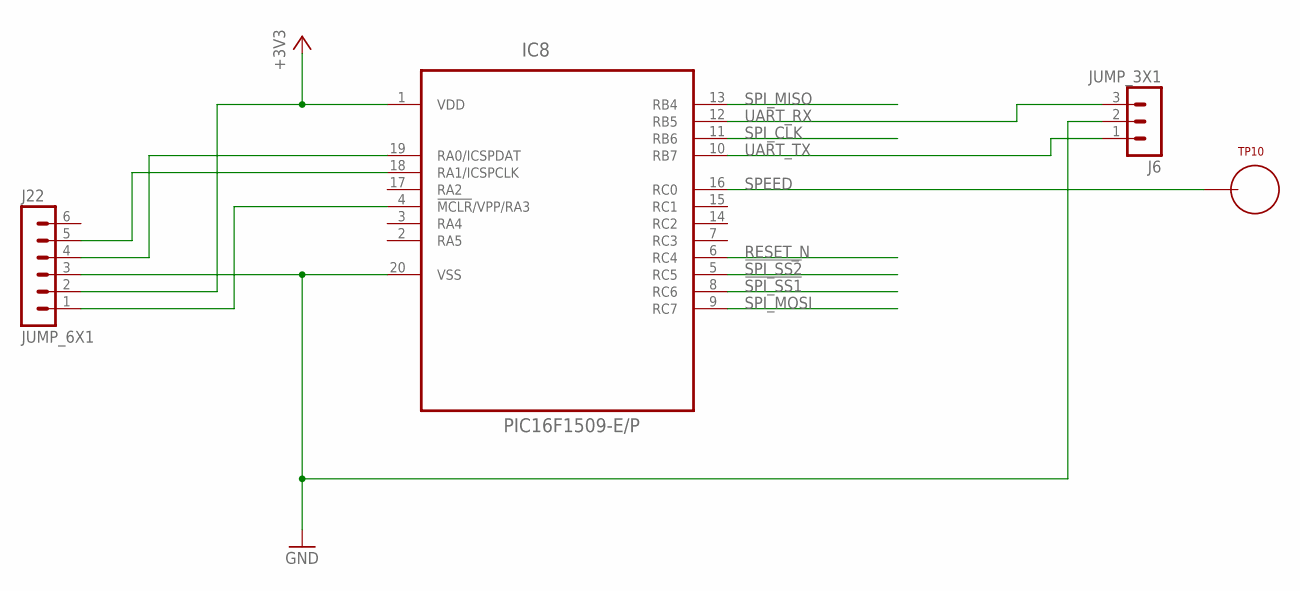
[picture p20: schematic IGOR_1.sch, sheet 6]

Parts:
IC8: PIC16F1509-E/P; DIP20
J6: JUMP_3X1
J22: JUMP_6X1
TP10: TEST_LOOP

Connections:
!SPI_SS1: IC8.8 (RC6); also elsewhere on the board
!SPI_SS2: IC8.5 (RC5); also elsewhere on the board
+3V3: IC8.1 (VDD), J22.2; also elsewhere on the board
GND: IC8.20 (VSS), J6.2, J22.3; also elsewhere on the board
unnamed: IC8.19 (RA0/ICSPDAT), J22.4
unnamed: IC8.18 (RA1/ICSPCLK), J22.5
unnamed: IC8.4 (!MCLR!/VPP/RA3), J22.1
RESET_N: IC8.6 (RC4); also elsewhere on the board
SPEED: IC8.16 (RC0), TP10.P$1
SPI_CLK: IC8.11 (RB6); also elsewhere on the board
SPI_MISO: IC8.13 (RB4); also elsewhere on the board
SPI_MOSI: IC8.9 (RC7); also elsewhere on the board
UART_RX: IC8.12 (RB5), J6.3
UART_TX: IC8.10 (RB7), J6.1

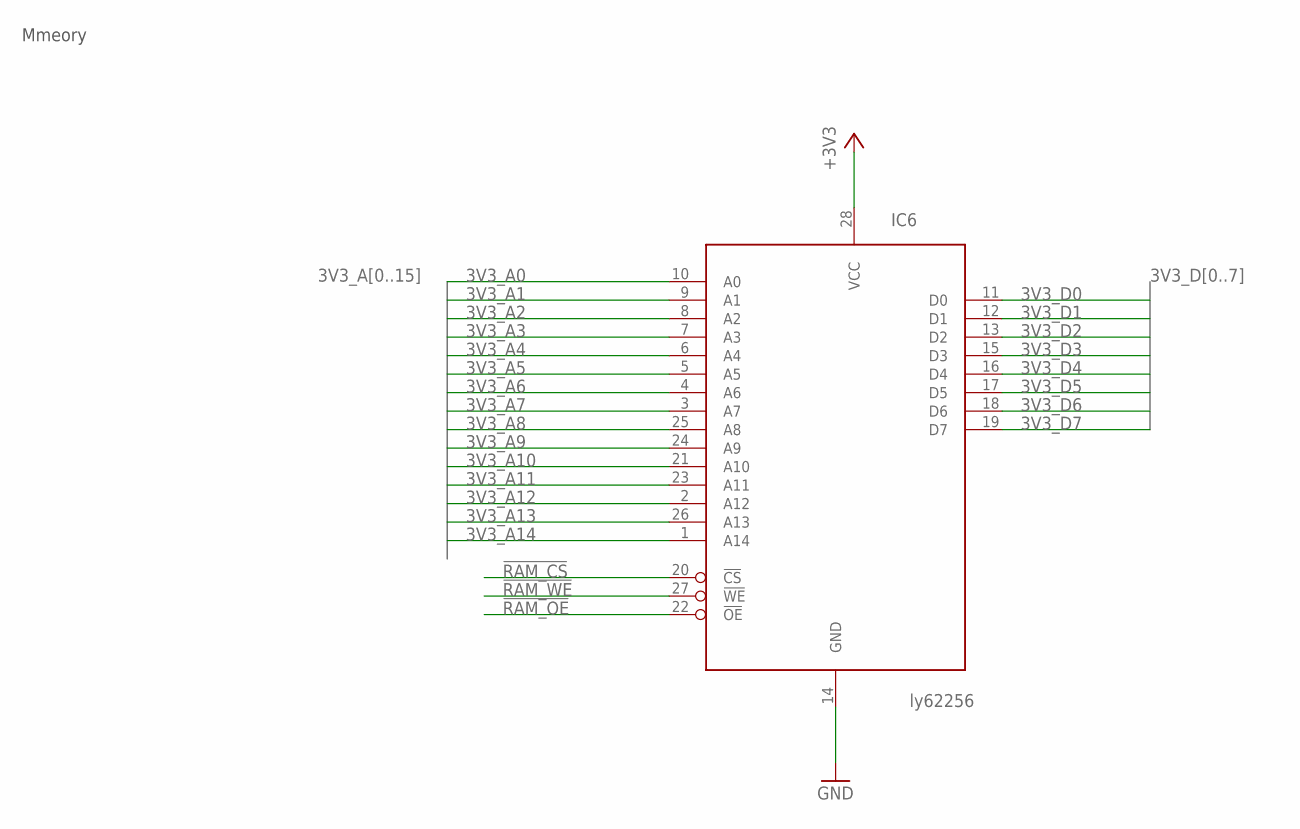
[picture p21: schematic IGOR_1.sch, sheet 7]

Parts:
IC6: ly62256; DIP28

Connections:
3V3_A0: IC6.10 (A0); also elsewhere on the board
3V3_A1: IC6.9 (A1); also elsewhere on the board
3V3_A2: IC6.8 (A2); also elsewhere on the board
3V3_A3: IC6.7 (A3); also elsewhere on the board
3V3_A4: IC6.6 (A4); also elsewhere on the board
3V3_A5: IC6.5 (A5); also elsewhere on the board
3V3_A6: IC6.4 (A6); also elsewhere on the board
3V3_A7: IC6.3 (A7); also elsewhere on the board
3V3_A8: IC6.25 (A8); also elsewhere on the board
3V3_A9: IC6.24 (A9); also elsewhere on the board
3V3_A10: IC6.21 (A10); also elsewhere on the board
3V3_A11: IC6.23 (A11); also elsewhere on the board
3V3_A12: IC6.2 (A12); also elsewhere on the board
3V3_A13: IC6.26 (A13); also elsewhere on the board
3V3_A14: IC6.1 (A14); also elsewhere on the board
3V3_D0: IC6.11 (D0); also elsewhere on the board
3V3_D1: IC6.12 (D1); also elsewhere on the board
3V3_D2: IC6.13 (D2); also elsewhere on the board
3V3_D3: IC6.15 (D3); also elsewhere on the board
3V3_D4: IC6.16 (D4); also elsewhere on the board
3V3_D5: IC6.17 (D5); also elsewhere on the board
3V3_D6: IC6.18 (D6); also elsewhere on the board
3V3_D7: IC6.19 (D7); also elsewhere on the board
!RAM_CS: IC6.20 (!CS); also elsewhere on the board
!RAM_OE: IC6.22 (!OE); also elsewhere on the board
!RAM_WE: IC6.27 (!WE); also elsewhere on the board
+3V3: IC6.28 (VCC); also elsewhere on the board
GND: IC6.14 (GND); also elsewhere on the board

Notes on the sheet:
Mmeory

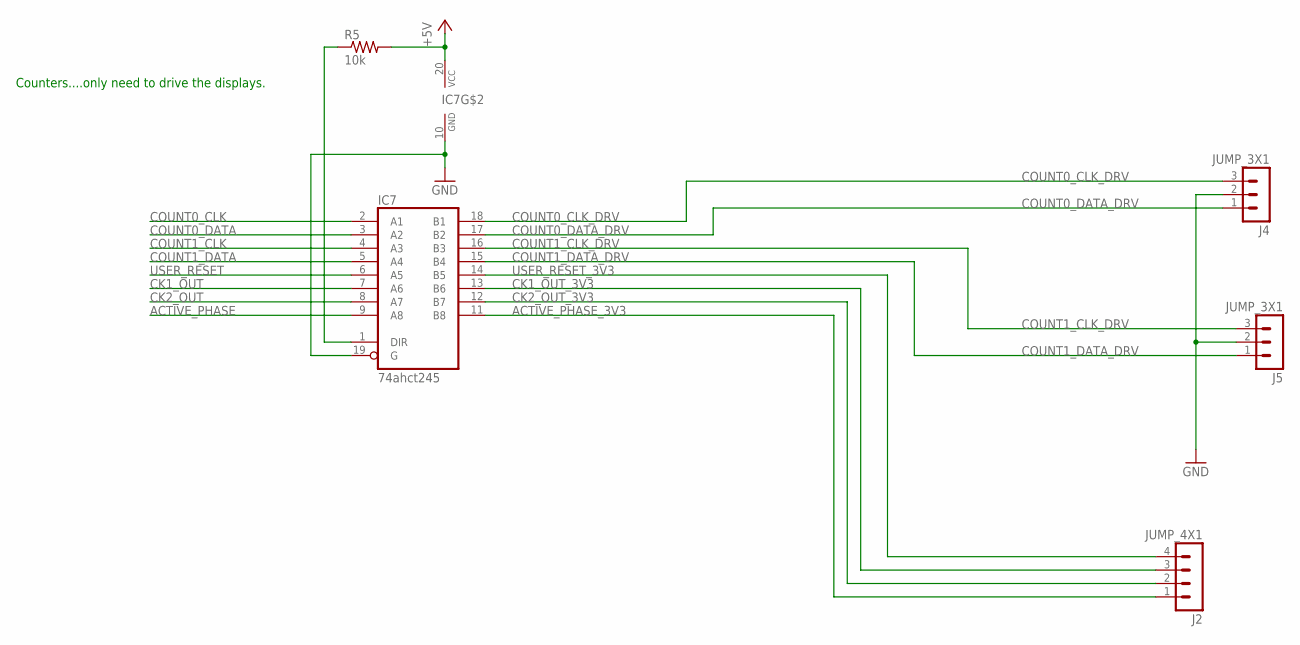
[picture p22: schematic IGOR_1.sch, sheet 8]

Parts:
IC7: 74ahct245; DIP20
J2: JUMP_4X1
J4, J5: JUMP_3X1
R5: 10k; R_P2INCH

Connections:
+5V: IC7.20 (VCC), R5.2; also elsewhere on the board
ACTIVE_PHASE: IC7.9 (A8); also elsewhere on the board
ACTIVE_PHASE_3V3: IC7.11 (B8), J2.1
CK1_OUT: IC7.7 (A6); also elsewhere on the board
CK1_OUT_3V3: IC7.13 (B6), J2.3
CK2_OUT: IC7.8 (A7); also elsewhere on the board
CK2_OUT_3V3: IC7.12 (B7), J2.2
COUNT0_CLK: IC7.2 (A1); also elsewhere on the board
COUNT0_CLK_DRV: IC7.18 (B1), J4.3
COUNT0_DATA: IC7.3 (A2); also elsewhere on the board
COUNT0_DATA_DRV: IC7.17 (B2), J4.1
COUNT1_CLK: IC7.4 (A3); also elsewhere on the board
COUNT1_CLK_DRV: IC7.16 (B3), J5.3
COUNT1_DATA: IC7.5 (A4); also elsewhere on the board
COUNT1_DATA_DRV: IC7.15 (B4), J5.1
GND: IC7.10 (GND), IC7.19 (G), J4.2, J5.2; also elsewhere on the board
unnamed: IC7.1 (DIR), R5.1
USER_RESET: IC7.6 (A5); also elsewhere on the board
USER_RESET_3V3: IC7.14 (B5), J2.4

Notes on the sheet:
Counters....only need to drive the displays.

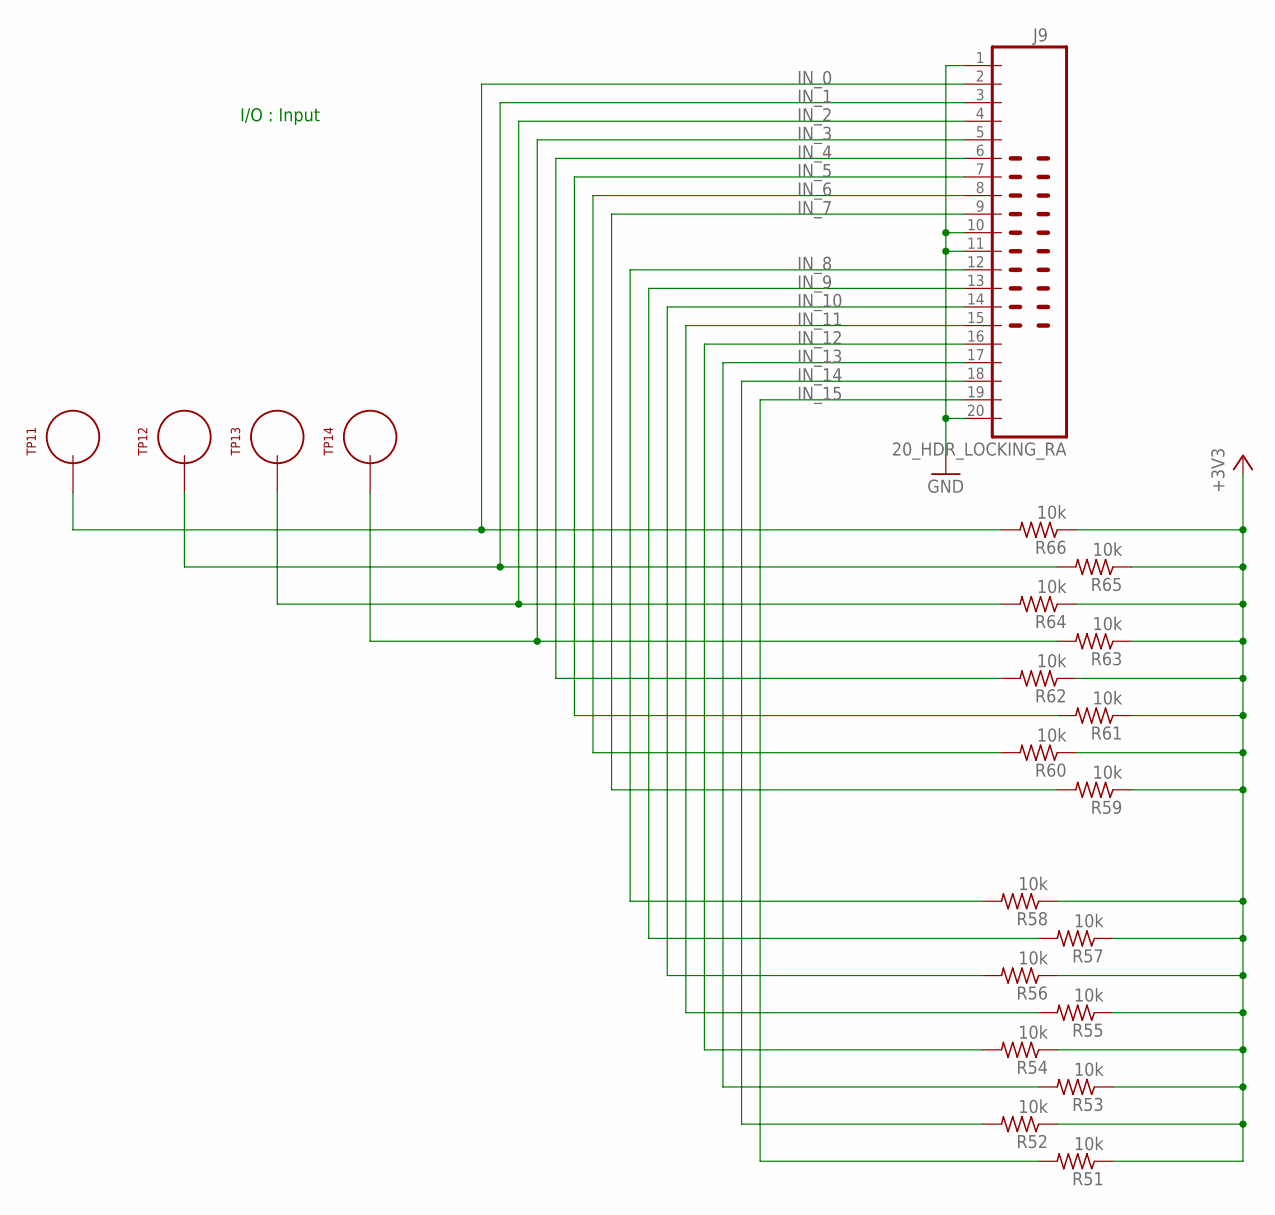
[picture p23: schematic IGOR_1.sch, sheet 9]

Parts:
J9: 20_HDR_LOCKING_RA
R51, R52, R53, R54, R55, R56, R57, R58, R59, R60, R61, R62, R63, R64, R65, R66: 10k; R_P2INCH
TP11, TP12, TP13, TP14: TEST_LOOP

Connections:
+3V3: R51.1, R52.1, R53.1, R54.1, R55.1, R56.1, R57.1, R58.1, R59.1, R60.1, R61.1, R62.1, R63.1, R64.1, R65.1, R66.1; also elsewhere on the board
GND: J9.1, J9.10, J9.11, J9.20; also elsewhere on the board
IN_0: J9.2, R66.2, TP11.P$1; also elsewhere on the board
IN_1: J9.3, R65.2, TP12.P$1; also elsewhere on the board
IN_2: J9.4, R64.2, TP13.P$1; also elsewhere on the board
IN_3: J9.5, R63.2, TP14.P$1; also elsewhere on the board
IN_4: J9.6, R62.2; also elsewhere on the board
IN_5: J9.7, R61.2; also elsewhere on the board
IN_6: J9.8, R60.2; also elsewhere on the board
IN_7: J9.9, R59.2; also elsewhere on the board
IN_8: J9.12, R58.2; also elsewhere on the board
IN_9: J9.13, R57.2; also elsewhere on the board
IN_10: J9.14, R56.2; also elsewhere on the board
IN_11: J9.15, R55.2; also elsewhere on the board
IN_12: J9.16, R54.2; also elsewhere on the board
IN_13: J9.17, R53.2; also elsewhere on the board
IN_14: J9.18, R52.2; also elsewhere on the board
IN_15: J9.19, R51.2; also elsewhere on the board

Notes on the sheet:
I/O : Input

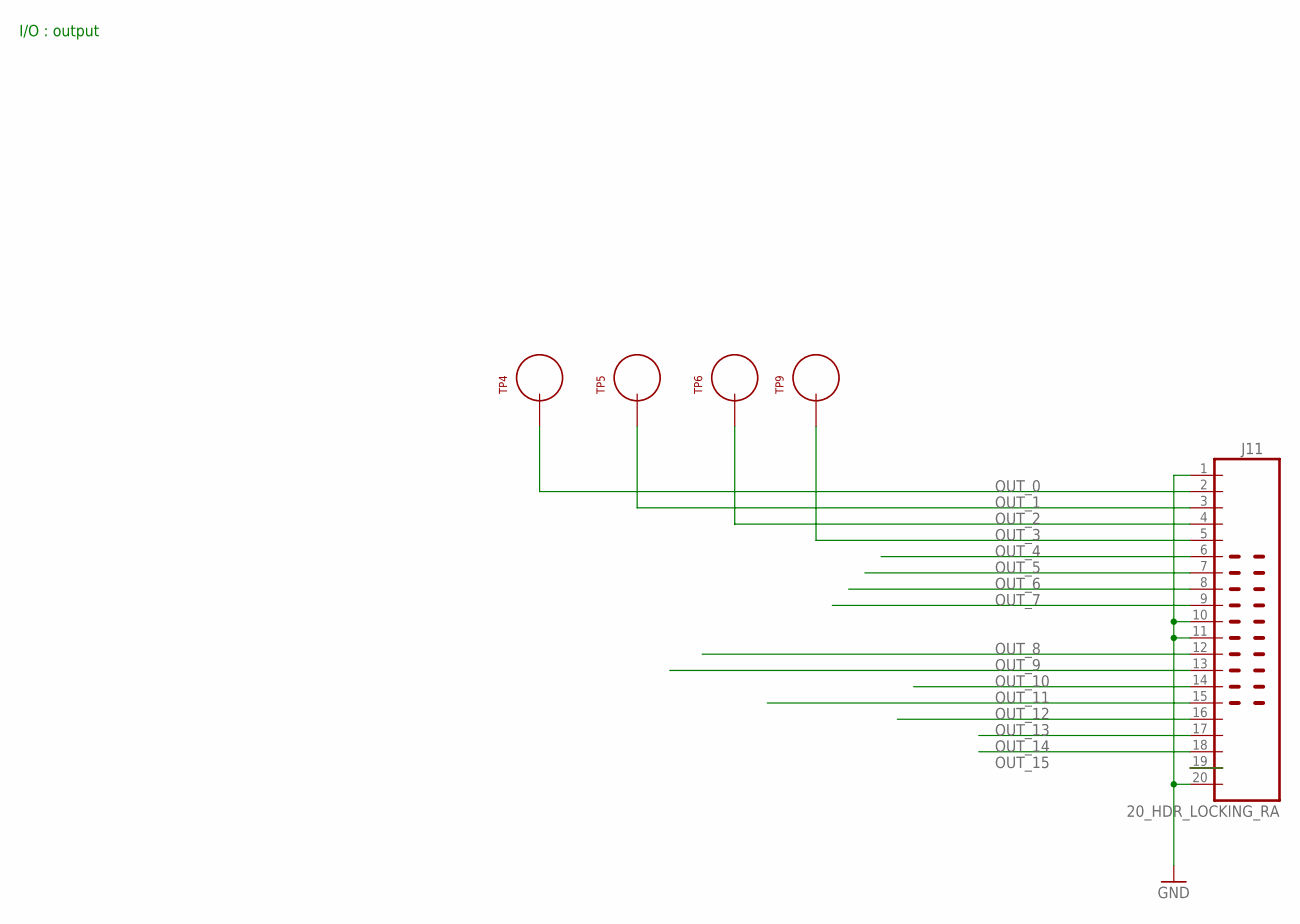
[picture p24: schematic IGOR_1.sch, sheet 10]

Parts:
J11: 20_HDR_LOCKING_RA
TP4, TP5, TP6, TP9: TEST_LOOP

Connections:
GND: J11.1, J11.10, J11.11, J11.20; also elsewhere on the board
OUT_0: J11.2, TP4.P$1; also elsewhere on the board
OUT_1: J11.3, TP5.P$1; also elsewhere on the board
OUT_2: J11.4, TP6.P$1; also elsewhere on the board
OUT_3: J11.5, TP9.P$1; also elsewhere on the board
OUT_4: J11.6; also elsewhere on the board
OUT_5: J11.7; also elsewhere on the board
OUT_6: J11.8; also elsewhere on the board
OUT_7: J11.9; also elsewhere on the board
OUT_8: J11.12; also elsewhere on the board
OUT_9: J11.13; also elsewhere on the board
OUT_10: J11.14; also elsewhere on the board
OUT_11: J11.15; also elsewhere on the board
OUT_12: J11.16; also elsewhere on the board
OUT_13: J11.17; also elsewhere on the board
OUT_14: J11.18; also elsewhere on the board
OUT_15: J11.19; also elsewhere on the board

Notes on the sheet:
I/O : output
