ericherman/megaprocessor/igor/IGOR_1.brd

## EAGLE design igor/IGOR_1.brd (continued)

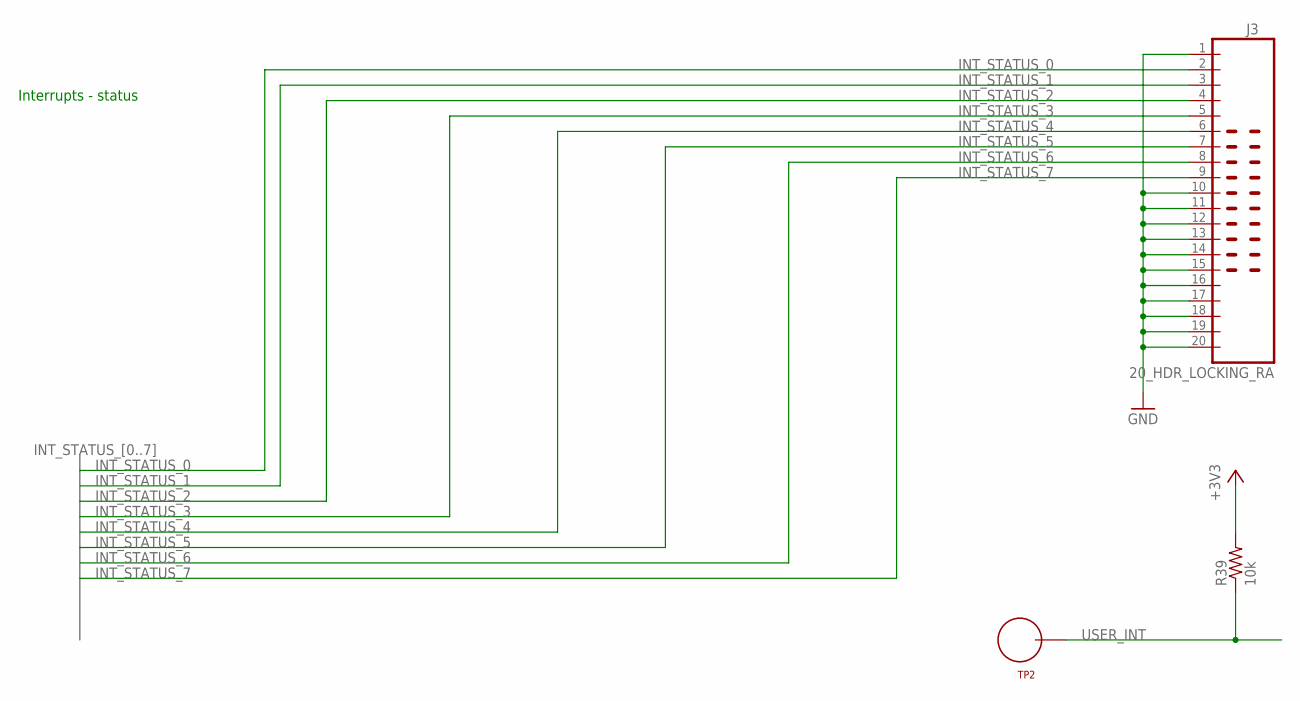
[picture p25: schematic IGOR_1.sch, sheet 11]

Parts:
J3: 20_HDR_LOCKING_RA
R39: 10k; R_P2INCH
TP2: TEST_LOOP

Connections:
+3V3: R39.2; also elsewhere on the board
GND: J3.1, J3.10, J3.11, J3.12, J3.13, J3.14, J3.15, J3.16, J3.17, J3.18, J3.19, J3.20; also elsewhere on the board
INT_STATUS_0: J3.2; also elsewhere on the board
INT_STATUS_1: J3.3; also elsewhere on the board
INT_STATUS_2: J3.4; also elsewhere on the board
INT_STATUS_3: J3.5; also elsewhere on the board
INT_STATUS_4: J3.6; also elsewhere on the board
INT_STATUS_5: J3.7; also elsewhere on the board
INT_STATUS_6: J3.8; also elsewhere on the board
INT_STATUS_7: J3.9; also elsewhere on the board
USER_INT: R39.1, TP2.P$1; also elsewhere on the board

Notes on the sheet:
Interrupts - status

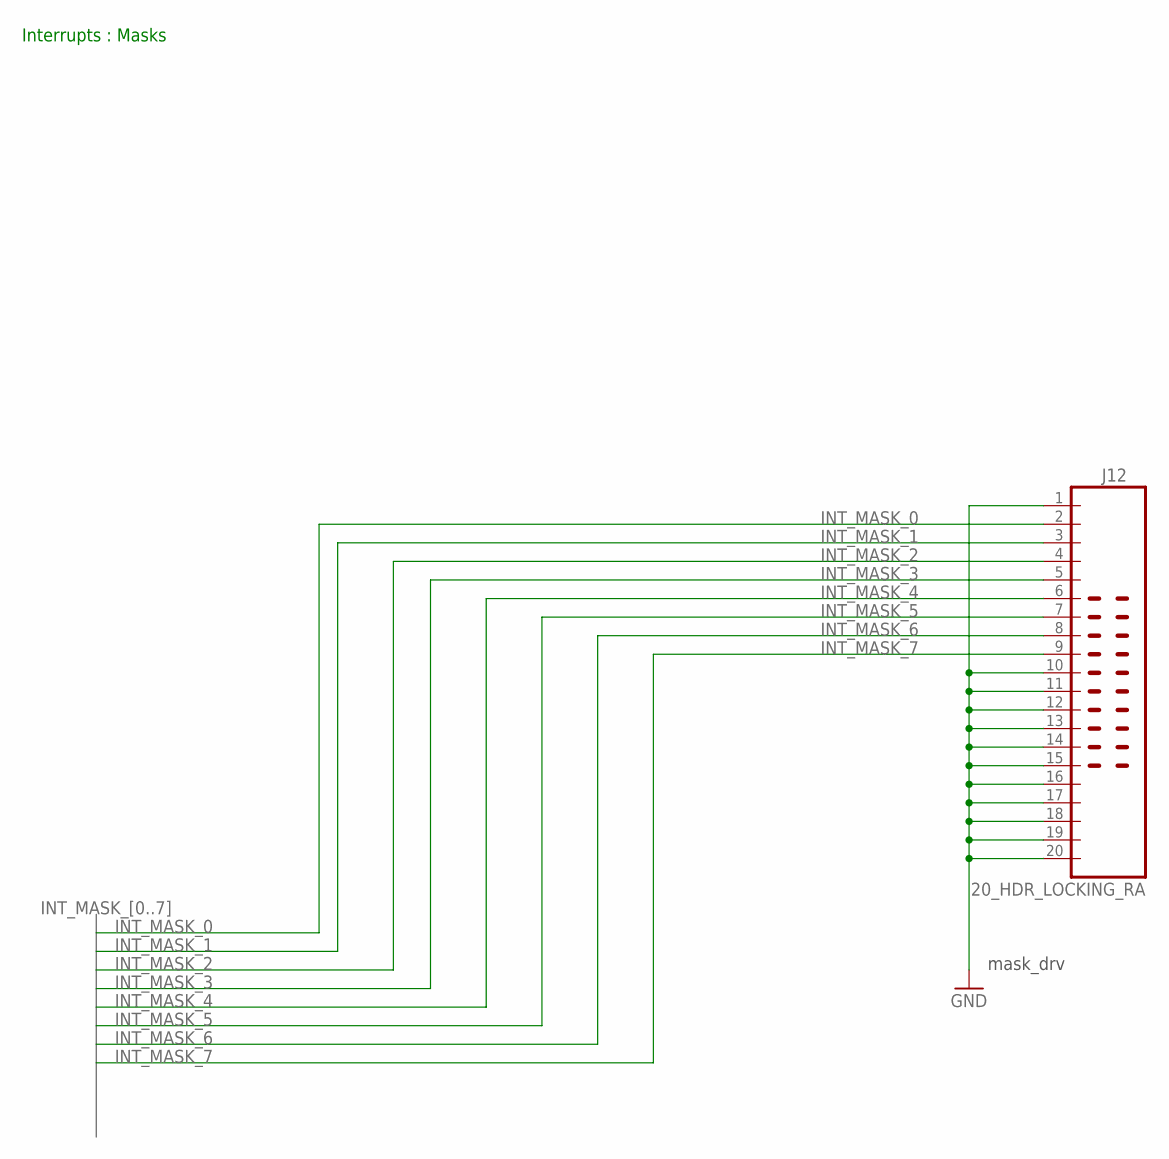
[picture p26: schematic IGOR_1.sch, sheet 12]

Parts:
J12: 20_HDR_LOCKING_RA

Connections:
GND: J12.1, J12.10, J12.11, J12.12, J12.13, J12.14, J12.15, J12.16, J12.17, J12.18, J12.19, J12.20; also elsewhere on the board
INT_MASK_0: J12.2; also elsewhere on the board
INT_MASK_1: J12.3; also elsewhere on the board
INT_MASK_2: J12.4; also elsewhere on the board
INT_MASK_3: J12.5; also elsewhere on the board
INT_MASK_4: J12.6; also elsewhere on the board
INT_MASK_5: J12.7; also elsewhere on the board
INT_MASK_6: J12.8; also elsewhere on the board
INT_MASK_7: J12.9; also elsewhere on the board

Notes on the sheet:
Interrupts : Masks
mask_drv

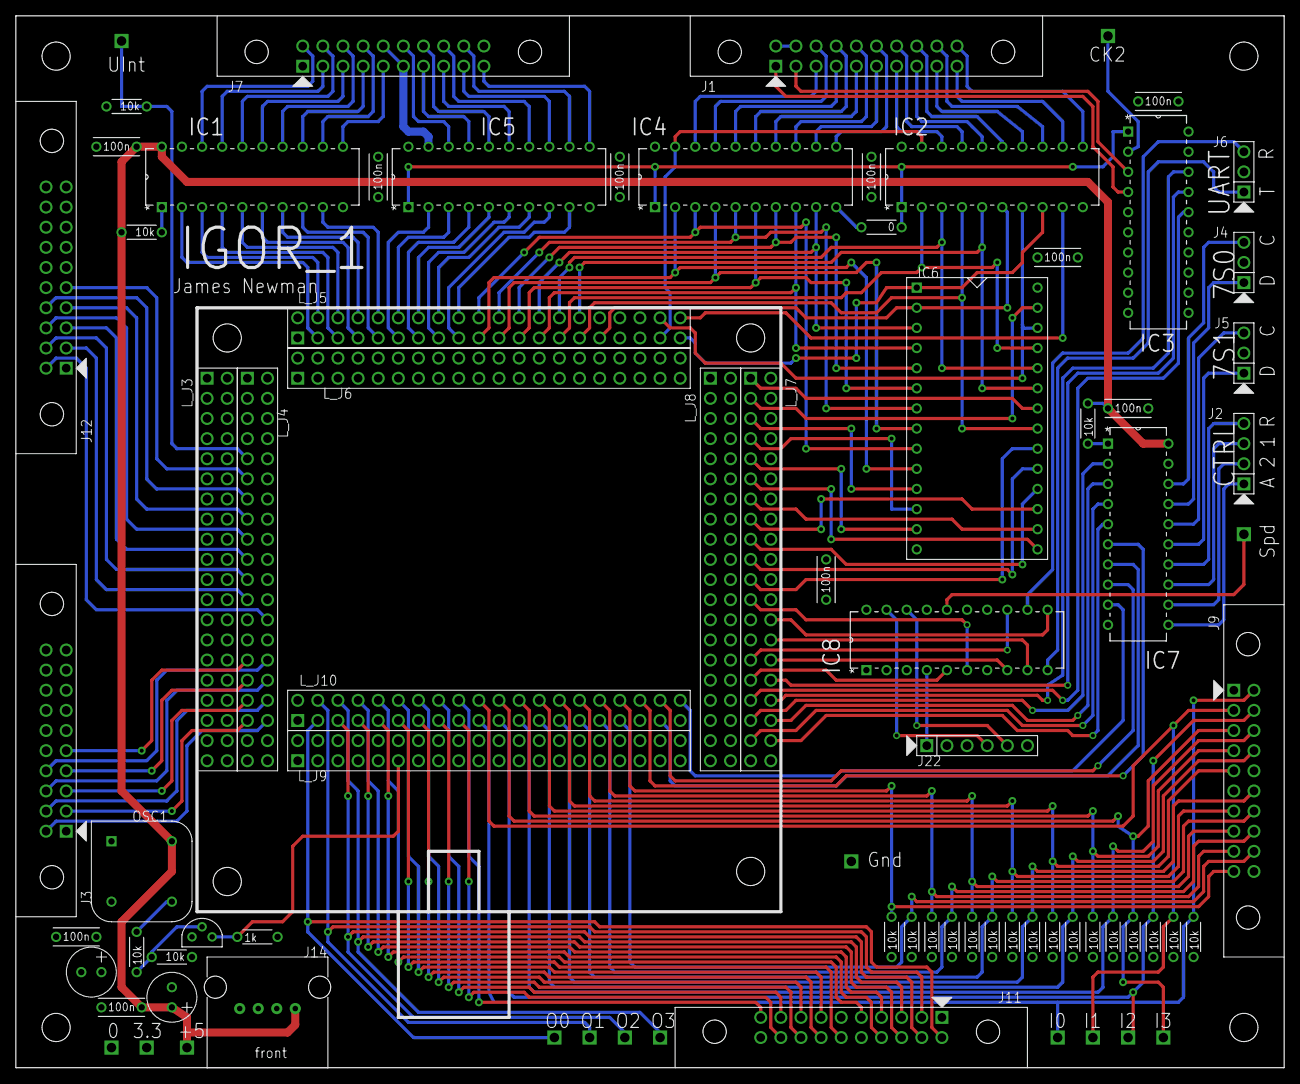
[picture p27: board IGOR_1.brd from above]

Board: 4 copper layers, 160.0 x 132.7 mm, 88 parts (0 on the bottom side), 168 nets.
