ericherman/megaprocessor/bus_tee/BUS_TEE_1.brd

## EAGLE design bus_tee/BUS_TEE_1.brd (2017-05-20)

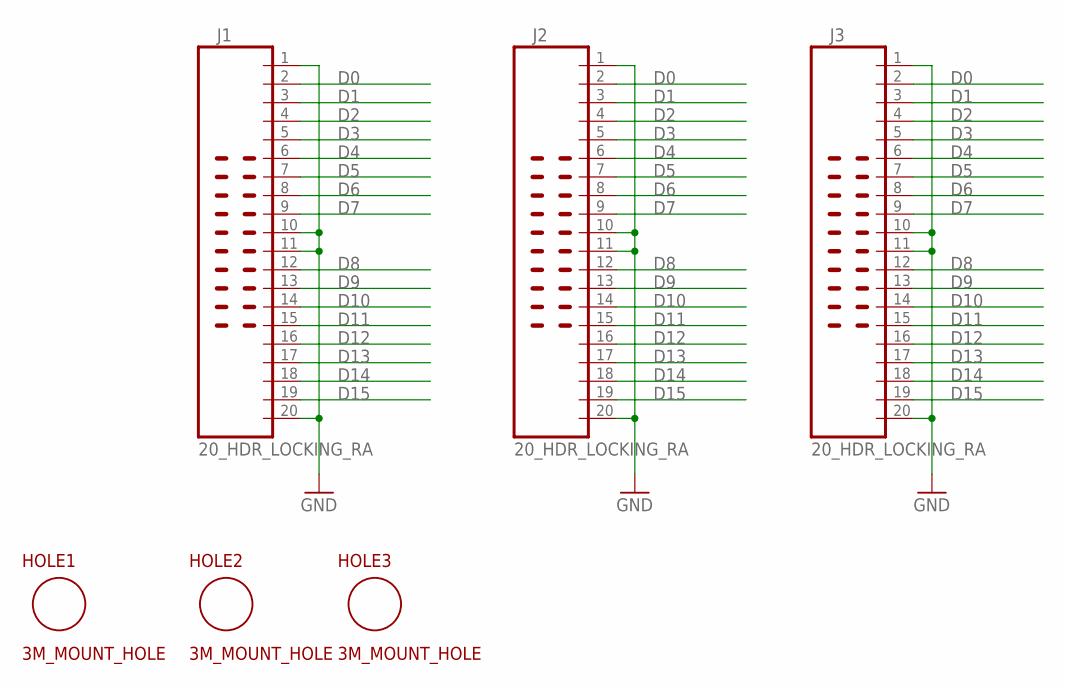
[picture p28: schematic BUS_TEE_1.sch]

Parts:
HOLE1, HOLE2, HOLE3: 3M_MOUNT_HOLE; 3M_HOLE
J1, J2, J3: 20_HDR_LOCKING_RA

Connections:
D0: J1.2, J2.2, J3.2
D1: J1.3, J2.3, J3.3
D2: J1.4, J2.4, J3.4
D3: J1.5, J2.5, J3.5
D4: J1.6, J2.6, J3.6
D5: J1.7, J2.7, J3.7
D6: J1.8, J2.8, J3.8
D7: J1.9, J2.9, J3.9
D8: J1.12, J2.12, J3.12
D9: J1.13, J2.13, J3.13
D10: J1.14, J2.14, J3.14
D11: J1.15, J2.15, J3.15
D12: J1.16, J2.16, J3.16
D13: J1.17, J2.17, J3.17
D14: J1.18, J2.18, J3.18
D15: J1.19, J2.19, J3.19
GND: J1.1, J1.10, J1.11, J1.20, J2.1, J2.10, J2.11, J2.20, J3.1, J3.10, J3.11, J3.20

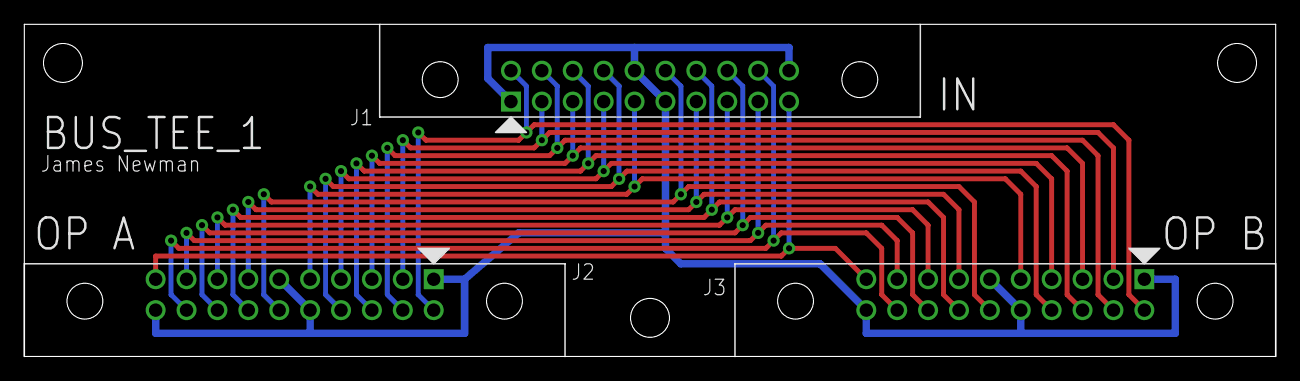
[picture p29: board BUS_TEE_1.brd from above]

Board: 2 copper layers, 102.9 x 27.3 mm, 6 parts (0 on the bottom side), 17 nets.
