ericherman/megaprocessor/2_to_4_decoder/Decoder4_2.brd

## EAGLE design 2_to_4_decoder/Decoder4_2.brd (2017-05-20)

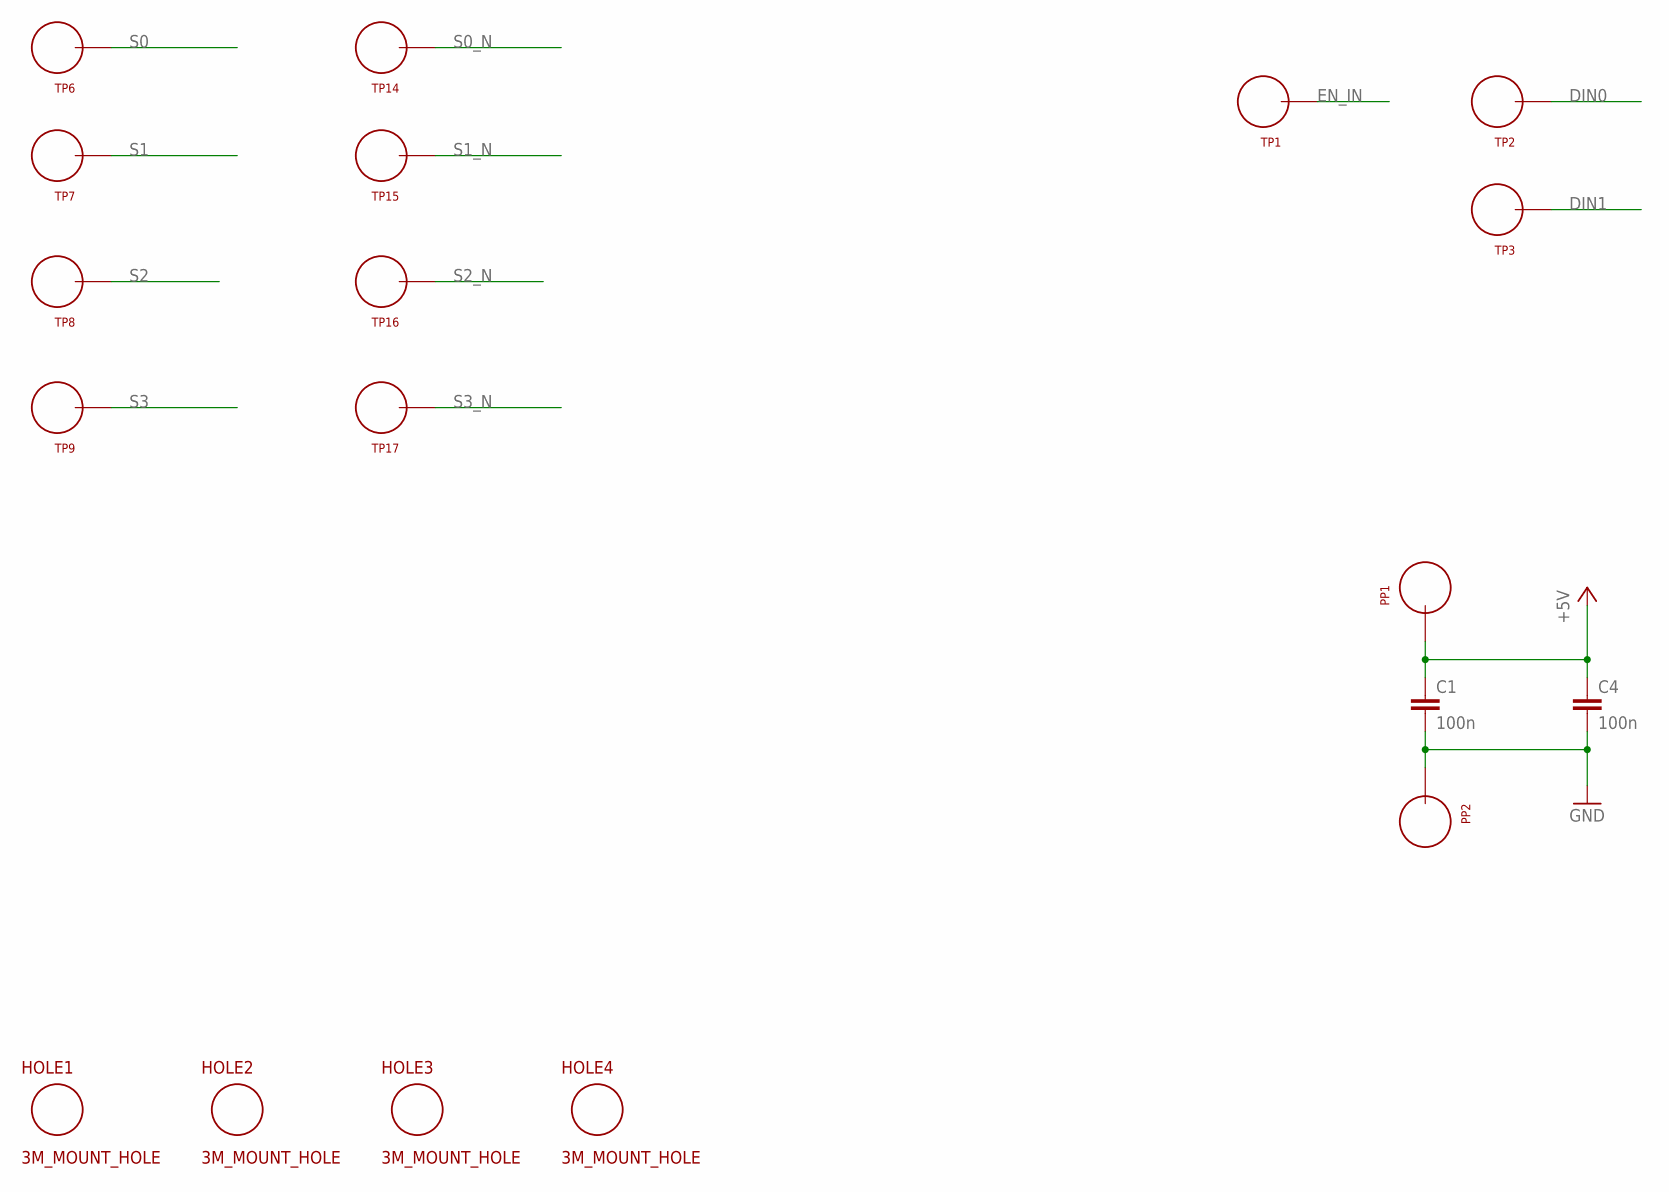
[picture p30: schematic Decoder4_2.sch, sheet 1]

Parts:
C1, C4: 100n; CAP_P2INCH
HOLE1, HOLE2, HOLE3, HOLE4: 3M_MOUNT_HOLE; 3M_HOLE
PP1, PP2: TEST_LOOP
TP1, TP2, TP3, TP6, TP7, TP8, TP9, TP14, TP15, TP16, TP17: TEST_LOOP

Connections:
+5V: C1.1, C4.1, PP1.P$1; also elsewhere on the board
DIN0: TP2.P$1; also elsewhere on the board
DIN1: TP3.P$1; also elsewhere on the board
EN_IN: TP1.P$1; also elsewhere on the board
GND: C1.2, C4.2, PP2.P$1; also elsewhere on the board
S0: TP6.P$1; also elsewhere on the board
S0_N: TP14.P$1; also elsewhere on the board
S1: TP7.P$1; also elsewhere on the board
S1_N: TP15.P$1; also elsewhere on the board
S2: TP8.P$1; also elsewhere on the board
S2_N: TP16.P$1; also elsewhere on the board
S3: TP9.P$1; also elsewhere on the board
S3_N: TP17.P$1; also elsewhere on the board

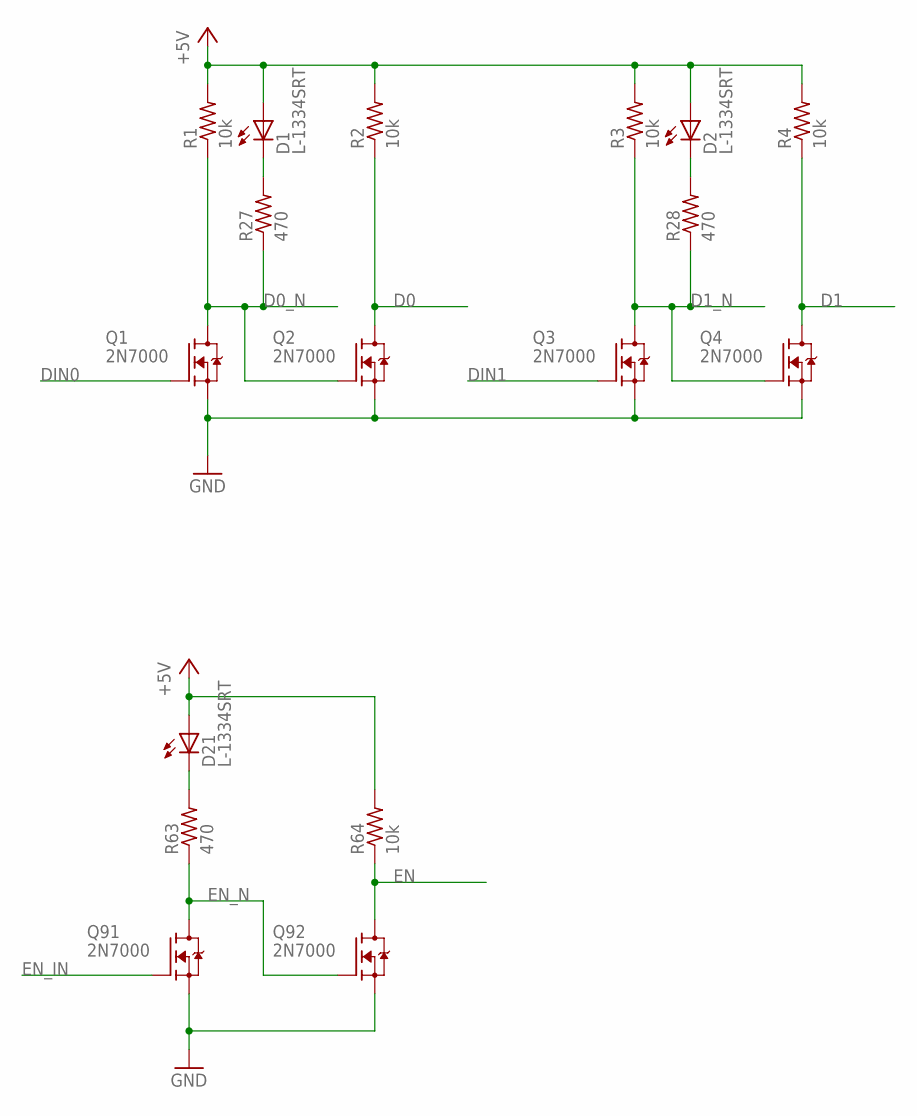
[picture p31: schematic Decoder4_2.sch, sheet 2]

Parts:
D1, D2, D21: L-1334SRT; LED3MM
Q1, Q2, Q3, Q4, Q91, Q92: 2N7000; TO92-DGS
R1, R2, R3, R4, R64: 10k; R_P2INCH
R27, R28, R63: 470; R_P2INCH

Connections:
+5V: D1.A, D2.A, D21.A, R1.2, R2.2, R3.2, R4.2, R64.2; also elsewhere on the board
D0: Q2.D, R2.1; also elsewhere on the board
D0_N: Q1.D, Q2.G, R1.1, R27.1; also elsewhere on the board
D1: Q4.D, R4.1; also elsewhere on the board
D1_N: Q3.D, Q4.G, R3.1, R28.1; also elsewhere on the board
DIN0: Q1.G; also elsewhere on the board
DIN1: Q3.G; also elsewhere on the board
EN: Q92.D, R64.1; also elsewhere on the board
EN_IN: Q91.G; also elsewhere on the board
EN_N: Q91.D, Q92.G, R63.1
GND: Q1.S, Q2.S, Q3.S, Q4.S, Q91.S, Q92.S; also elsewhere on the board
unnamed: D1.K (C), R27.2
unnamed: D2.K (C), R28.2
unnamed: D21.K (C), R63.2

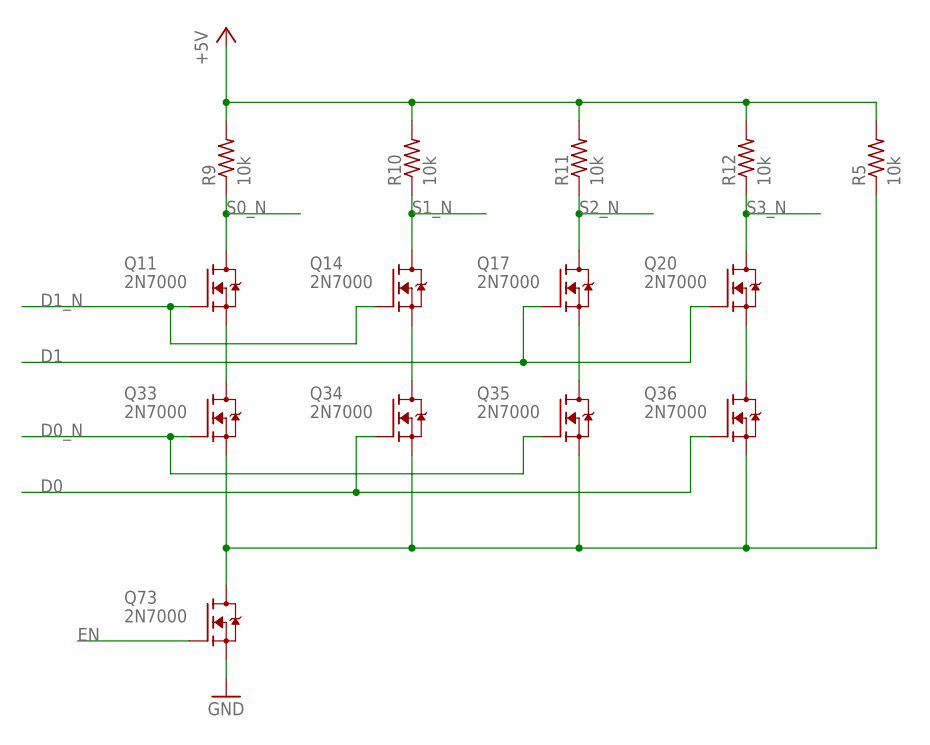
[picture p32: schematic Decoder4_2.sch, sheet 3]

Parts:
Q11, Q14, Q17, Q20, Q33, Q34, Q35, Q36, Q73: 2N7000; TO92-DGS
R5, R9, R10, R11, R12: 10k; R_P2INCH

Connections:
+5V: R5.2, R9.2, R10.2, R11.2, R12.2; also elsewhere on the board
D0: Q34.G, Q36.G; also elsewhere on the board
D0_N: Q33.G, Q35.G; also elsewhere on the board
D1: Q17.G, Q20.G; also elsewhere on the board
D1_N: Q11.G, Q14.G; also elsewhere on the board
EN: Q73.G; also elsewhere on the board
GND: Q73.S; also elsewhere on the board
unnamed: Q33.S, Q34.S, Q35.S, Q36.S, Q73.D, R5.1
unnamed: Q11.S, Q33.D
unnamed: Q14.S, Q34.D
unnamed: Q17.S, Q35.D
unnamed: Q20.S, Q36.D
S0_N: Q11.D, R9.1; also elsewhere on the board
S1_N: Q14.D, R10.1; also elsewhere on the board
S2_N: Q17.D, R11.1; also elsewhere on the board
S3_N: Q20.D, R12.1; also elsewhere on the board

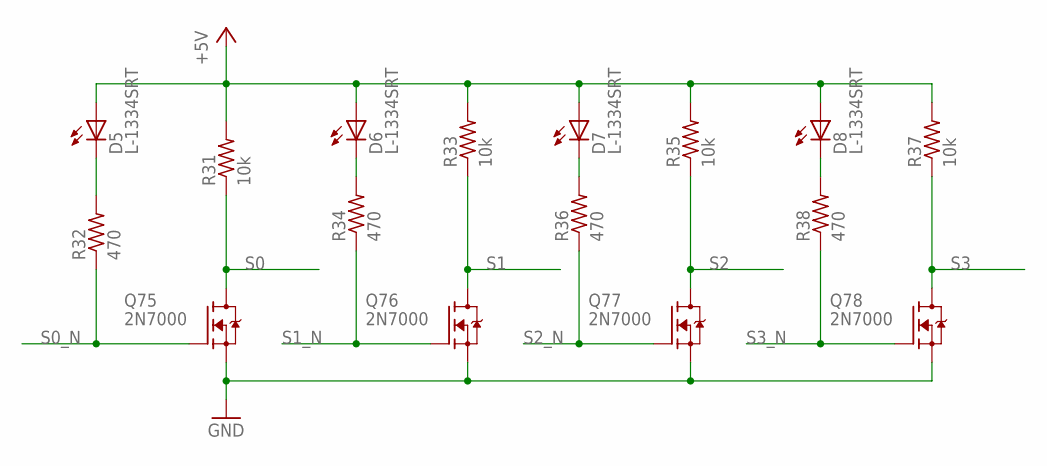
[picture p33: schematic Decoder4_2.sch, sheet 4]

Parts:
D5, D6, D7, D8: L-1334SRT; LED3MM
Q75, Q76, Q77, Q78: 2N7000; TO92-DGS
R31, R33, R35, R37: 10k; R_P2INCH
R32, R34, R36, R38: 470; R_P2INCH

Connections:
+5V: D5.A, D6.A, D7.A, D8.A, R31.2, R33.2, R35.2, R37.2; also elsewhere on the board
GND: Q75.S, Q76.S, Q77.S, Q78.S; also elsewhere on the board
unnamed: D5.K (C), R32.2
unnamed: D6.K (C), R34.2
unnamed: D7.K (C), R36.2
unnamed: D8.K (C), R38.2
S0: Q75.D, R31.1; also elsewhere on the board
S0_N: Q75.G, R32.1; also elsewhere on the board
S1: Q76.D, R33.1; also elsewhere on the board
S1_N: Q76.G, R34.1; also elsewhere on the board
S2: Q77.D, R35.1; also elsewhere on the board
S2_N: Q77.G, R36.1; also elsewhere on the board
S3: Q78.D, R37.1; also elsewhere on the board
S3_N: Q78.G, R38.1; also elsewhere on the board

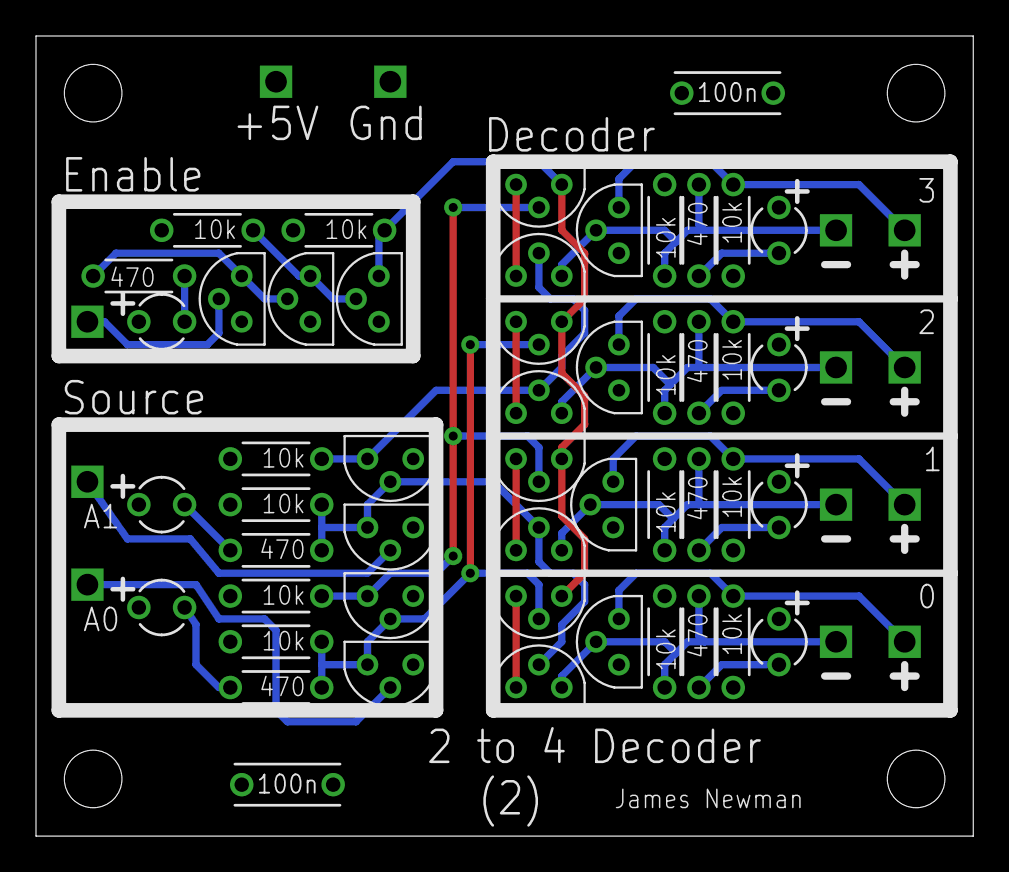
[picture p34: board Decoder4_2.brd from above]

Board: 4 copper layers, 52.1 x 44.5 mm, 66 parts (0 on the bottom side), 31 nets.
