ericherman/megaprocessor/2and/2AND_2.brd

## EAGLE design 2and/2AND_2.brd (2017-05-20)

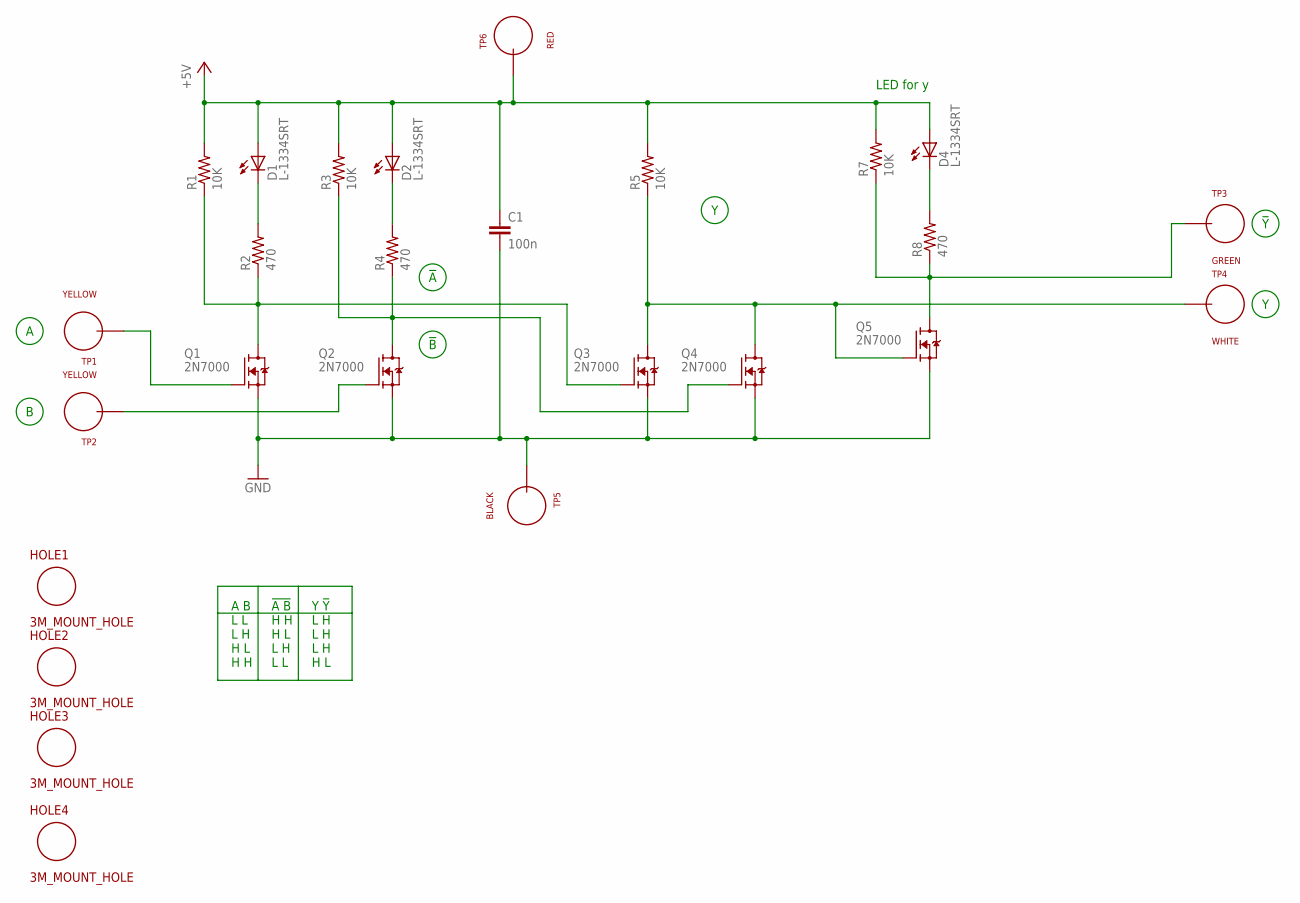
[picture p35: schematic 2AND_2.sch]

Parts:
C1: 100n; CAP_P2INCH
D1, D2, D4: L-1334SRT; LED3MM
HOLE1, HOLE2, HOLE3, HOLE4: 3M_MOUNT_HOLE; 3M_HOLE
Q1, Q2, Q3, Q4, Q5: 2N7000; TO92-DGS
R1, R3, R5, R7: 10K; R_P2INCH
R2, R4, R8: 470; R_P2INCH
TP1, TP2: YELLOW; TEST_LOOP
TP3: GREEN; TEST_LOOP
TP4: WHITE; TEST_LOOP
TP5: BLACK; TEST_LOOP
TP6: RED; TEST_LOOP

Connections:
+5V: C1.1, D1.A, D2.A, D4.A, R1.2, R3.2, R5.2, R7.2, TP6.P$1
GND: C1.2, Q1.S, Q2.S, Q3.S, Q4.S, Q5.S, TP5.P$1
unnamed: Q3.D, Q4.D, Q5.G, R5.1, TP4.P$1
unnamed: D4.K (C), R8.2
unnamed: Q5.D, R7.1, R8.1, TP3.P$1
unnamed: D2.K (C), R4.2
unnamed: Q2.D, Q4.G, R3.1, R4.1
unnamed: D1.K (C), R2.2
unnamed: Q1.D, Q3.G, R1.1, R2.1
unnamed: Q1.G, TP1.P$1
unnamed: Q2.G, TP2.P$1

Notes on the sheet:
A B L L L H H L H H
!A B H H H L L H L L
Y !Y L H L H L H H L
LED for y

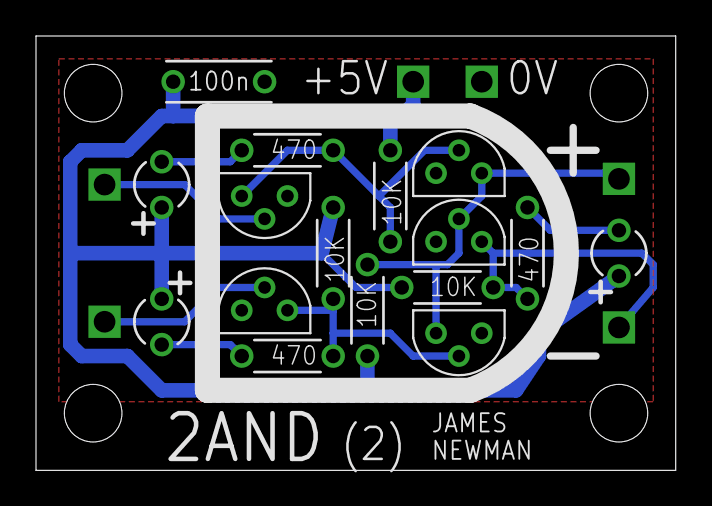
[picture p36: board 2AND_2.brd from above]

Board: 2 copper layers, 35.5 x 24.1 mm, 26 parts (0 on the bottom side), 11 nets.
