ericherman/megaprocessor/4x16mux/4x16MUX_3.brd

## EAGLE design 4x16mux/4x16MUX_3.brd (2017-05-20)

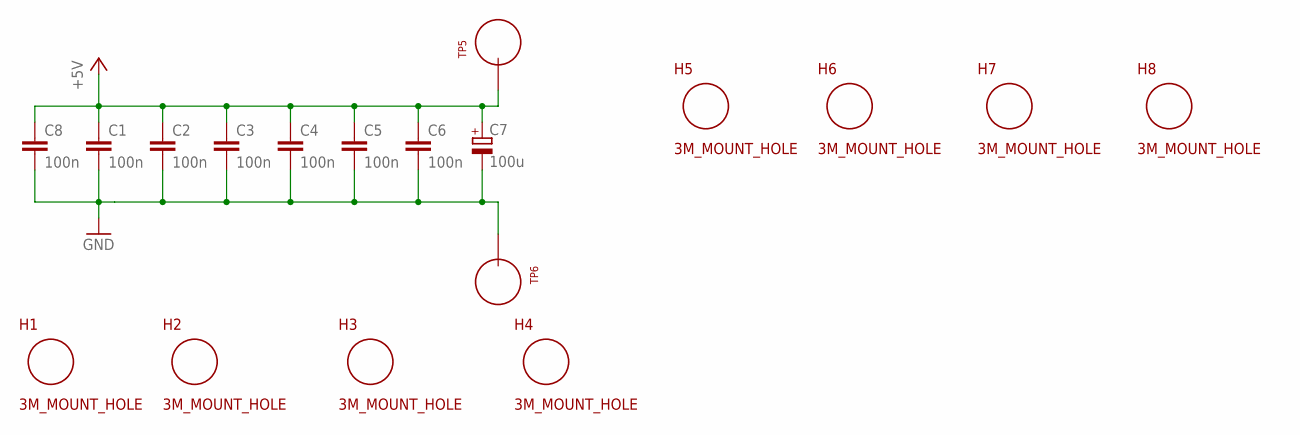
[picture p37: schematic 4x16MUX_3.sch, sheet 1]

Parts:
C1, C2, C3, C4, C5, C6, C8: 100n; CAP_P2INCH
C7: 100u; POLARISED_CAP_2P5_6P3MM
H1, H2, H3, H4, H5, H6, H7, H8: 3M_MOUNT_HOLE; 3M_HOLE
TP5, TP6: TEST_LOOP

Connections:
+5V: C1.1, C2.1, C3.1, C4.1, C5.1, C6.1, C7.A, C8.1, TP5.P$1; also elsewhere on the board
GND: C1.2, C2.2, C3.2, C4.2, C5.2, C6.2, C7.K, C8.2, TP6.P$1; also elsewhere on the board

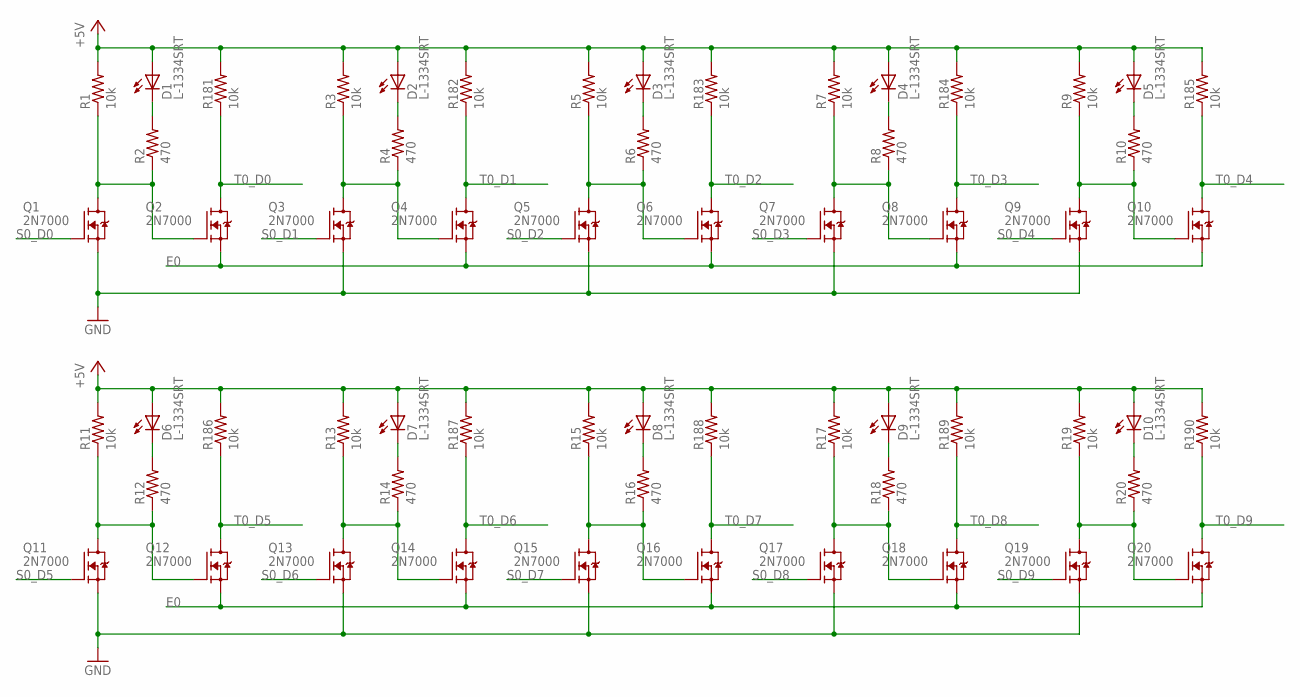
[picture p38: schematic 4x16MUX_3.sch, sheet 2]

Parts:
D1, D2, D3, D4, D5, D6, D7, D8, D9, D10: L-1334SRT; LED3MM
Q1, Q2, Q3, Q4, Q5, Q6, Q7, Q8, Q9, Q10, Q11, Q12, Q13, Q14, Q15, Q16, Q17, Q18, Q19, Q20: 2N7000; TO92-DGS
R1, R3, R5, R7, R9, R11, R13, R15, R17, R19, R181, R182, R183, R184, R185, R186, R187, R188, R189, R190: 10k; R_P2INCH
R2, R4, R6, R8, R10, R12, R14, R16, R18, R20: 470; R_P2INCH

Connections:
+5V: D1.A, D2.A, D3.A, D4.A, D5.A, D6.A, D7.A, D8.A, D9.A, D10.A, R1.2, R3.2, R5.2, R7.2, R9.2, R11.2, R13.2, R15.2, R17.2, R19.2, R181.2, R182.2, R183.2, R184.2, R185.2, R186.2, R187.2, R188.2, R189.2, R190.2; also elsewhere on the board
E0: Q2.S, Q4.S, Q6.S, Q8.S, Q10.S, Q12.S, Q14.S, Q16.S, Q18.S, Q20.S; also elsewhere on the board
GND: Q1.S, Q3.S, Q5.S, Q7.S, Q9.S, Q11.S, Q13.S, Q15.S, Q17.S, Q19.S; also elsewhere on the board
unnamed: Q3.D, Q4.G, R3.1, R4.1
unnamed: Q1.D, Q2.G, R1.1, R2.1
unnamed: D1.K (C), R2.2
unnamed: D2.K (C), R4.2
unnamed: Q5.D, Q6.G, R5.1, R6.1
unnamed: D3.K (C), R6.2
unnamed: Q7.D, Q8.G, R7.1, R8.1
unnamed: D4.K (C), R8.2
unnamed: Q9.D, Q10.G, R9.1, R10.1
unnamed: D5.K (C), R10.2
unnamed: Q11.D, Q12.G, R11.1, R12.1
unnamed: D6.K (C), R12.2
unnamed: Q13.D, Q14.G, R13.1, R14.1
unnamed: D7.K (C), R14.2
unnamed: Q15.D, Q16.G, R15.1, R16.1
unnamed: D8.K (C), R16.2
unnamed: Q17.D, Q18.G, R17.1, R18.1
unnamed: D9.K (C), R18.2
unnamed: Q19.D, Q20.G, R19.1, R20.1
unnamed: D10.K (C), R20.2
S0_D0: Q1.G; also elsewhere on the board
S0_D1: Q3.G; also elsewhere on the board
S0_D2: Q5.G; also elsewhere on the board
S0_D3: Q7.G; also elsewhere on the board
S0_D4: Q9.G; also elsewhere on the board
S0_D5: Q11.G; also elsewhere on the board
S0_D6: Q13.G; also elsewhere on the board
S0_D7: Q15.G; also elsewhere on the board
S0_D8: Q17.G; also elsewhere on the board
S0_D9: Q19.G; also elsewhere on the board
T0_D0: Q2.D, R181.1; also elsewhere on the board
T0_D1: Q4.D, R182.1; also elsewhere on the board
T0_D2: Q6.D, R183.1; also elsewhere on the board
T0_D3: Q8.D, R184.1; also elsewhere on the board
T0_D4: Q10.D, R185.1; also elsewhere on the board
T0_D5: Q12.D, R186.1; also elsewhere on the board
T0_D6: Q14.D, R187.1; also elsewhere on the board
T0_D7: Q16.D, R188.1; also elsewhere on the board
T0_D8: Q18.D, R189.1; also elsewhere on the board
T0_D9: Q20.D, R190.1; also elsewhere on the board

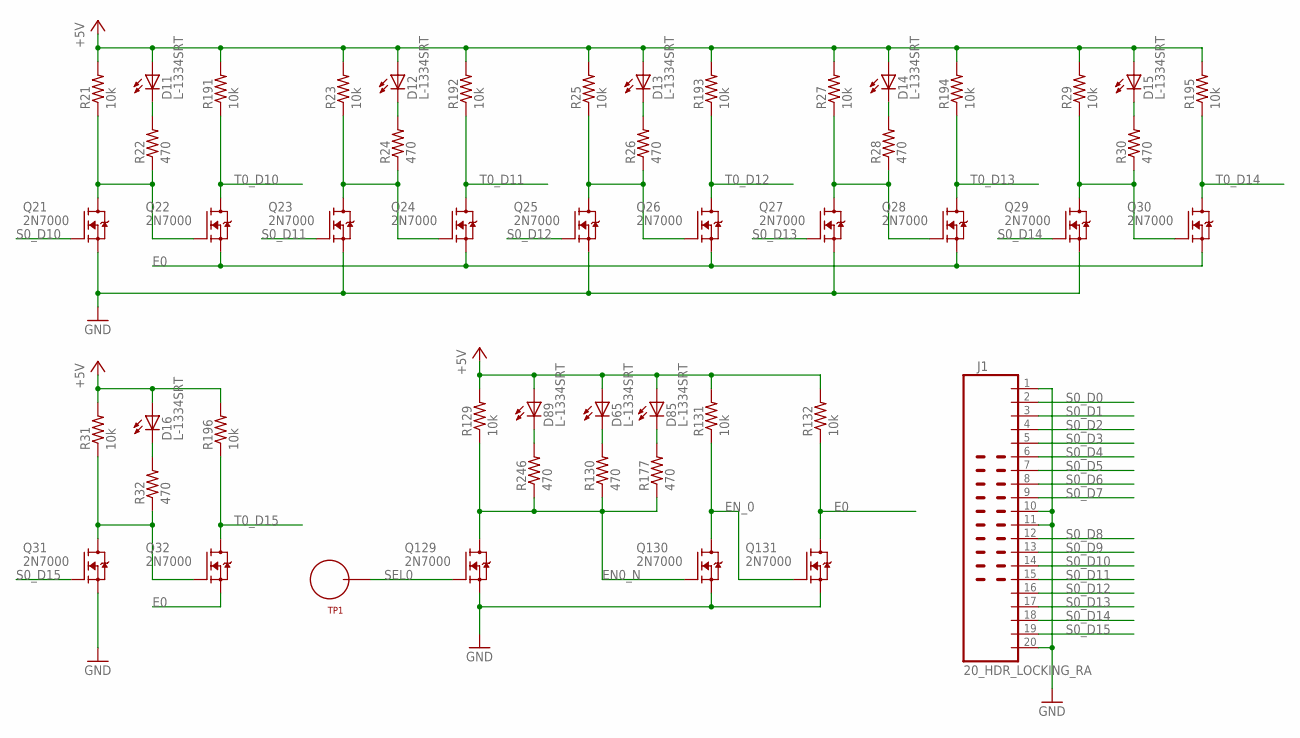
[picture p39: schematic 4x16MUX_3.sch, sheet 3]

Parts:
D11, D12, D13, D14, D15, D16, D65, D85, D89: L-1334SRT; LED3MM
J1: 20_HDR_LOCKING_RA
Q21, Q22, Q23, Q24, Q25, Q26, Q27, Q28, Q29, Q30, Q31, Q32, Q129, Q130, Q131: 2N7000; TO92-DGS
R21, R23, R25, R27, R29, R31, R129, R131, R132, R191, R192, R193, R194, R195, R196: 10k; R_P2INCH
R22, R24, R26, R28, R30, R32, R130, R177, R246: 470; R_P2INCH
TP1: TEST_LOOP

Connections:
+5V: D11.A, D12.A, D13.A, D14.A, D15.A, D16.A, D65.A, D85.A, D89.A, R21.2, R23.2, R25.2, R27.2, R29.2, R31.2, R129.2, R131.2, R132.2, R191.2, R192.2, R193.2, R194.2, R195.2, R196.2; also elsewhere on the board
E0: Q22.S, Q24.S, Q26.S, Q28.S, Q30.S, Q32.S, Q131.D, R132.1; also elsewhere on the board
EN0_N: Q129.D, Q130.G, R129.1, R130.1, R177.1, R246.1; also elsewhere on the board
EN_0: Q130.D, Q131.G, R131.1
GND: J1.1, J1.10, J1.11, J1.20, Q21.S, Q23.S, Q25.S, Q27.S, Q29.S, Q31.S, Q129.S, Q130.S, Q131.S; also elsewhere on the board
unnamed: Q21.D, Q22.G, R21.1, R22.1
unnamed: D11.K (C), R22.2
unnamed: Q23.D, Q24.G, R23.1, R24.1
unnamed: D12.K (C), R24.2
unnamed: Q25.D, Q26.G, R25.1, R26.1
unnamed: D13.K (C), R26.2
unnamed: Q27.D, Q28.G, R27.1, R28.1
unnamed: D14.K (C), R28.2
unnamed: Q29.D, Q30.G, R29.1, R30.1
unnamed: D15.K (C), R30.2
unnamed: Q31.D, Q32.G, R31.1, R32.1
unnamed: D16.K (C), R32.2
unnamed: D65.K (C), R130.2
unnamed: D85.K (C), R177.2
unnamed: D89.K (C), R246.2
S0_D0: J1.2; also elsewhere on the board
S0_D1: J1.3; also elsewhere on the board
S0_D2: J1.4; also elsewhere on the board
S0_D3: J1.5; also elsewhere on the board
S0_D4: J1.6; also elsewhere on the board
S0_D5: J1.7; also elsewhere on the board
S0_D6: J1.8; also elsewhere on the board
S0_D7: J1.9; also elsewhere on the board
S0_D8: J1.12; also elsewhere on the board
S0_D9: J1.13; also elsewhere on the board
S0_D10: J1.14, Q21.G
S0_D11: J1.15, Q23.G
S0_D12: J1.16, Q25.G
S0_D13: J1.17, Q27.G
S0_D14: J1.18, Q29.G
S0_D15: J1.19, Q31.G
SEL0: Q129.G, TP1.P$1
T0_D10: Q22.D, R191.1; also elsewhere on the board
T0_D11: Q24.D, R192.1; also elsewhere on the board
T0_D12: Q26.D, R193.1; also elsewhere on the board
T0_D13: Q28.D, R194.1; also elsewhere on the board
T0_D14: Q30.D, R195.1; also elsewhere on the board
T0_D15: Q32.D, R196.1; also elsewhere on the board
