ericherman/megaprocessor/4x16mux/4x16MUX_3.brd

## EAGLE design 4x16mux/4x16MUX_3.brd (continued)

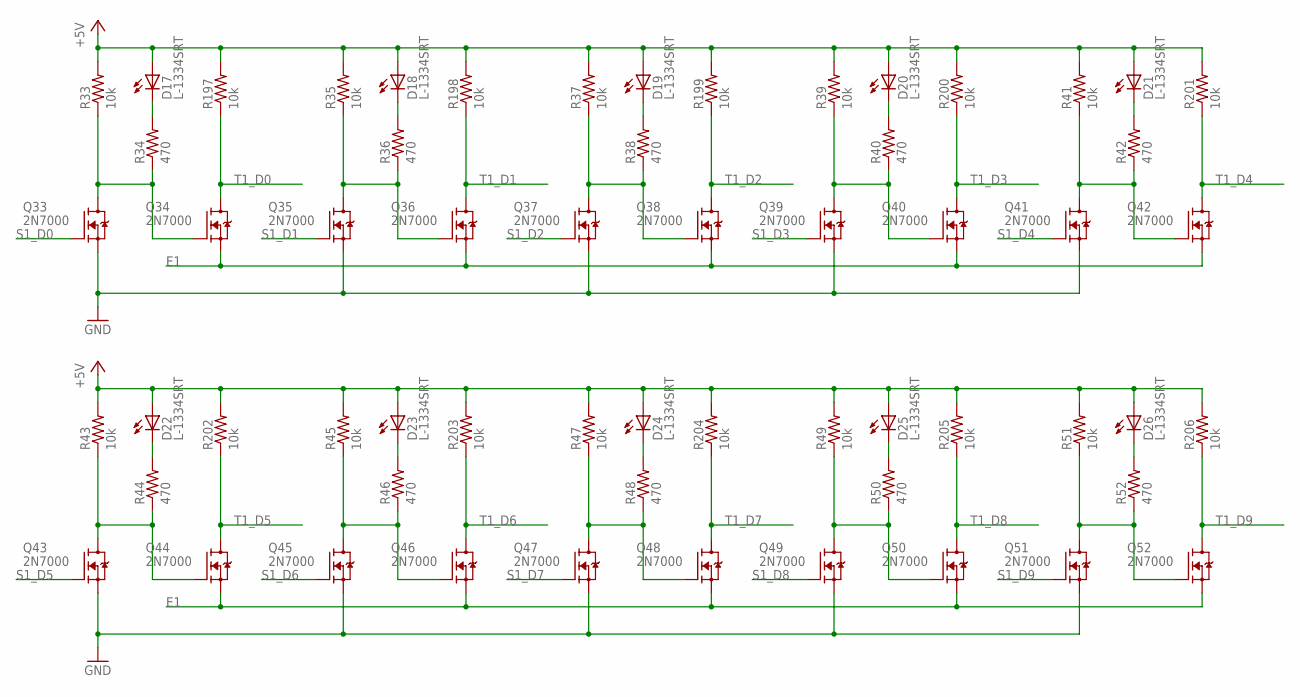
[picture p40: schematic 4x16MUX_3.sch, sheet 4]

Parts:
D17, D18, D19, D20, D21, D22, D23, D24, D25, D26: L-1334SRT; LED3MM
Q33, Q34, Q35, Q36, Q37, Q38, Q39, Q40, Q41, Q42, Q43, Q44, Q45, Q46, Q47, Q48, Q49, Q50, Q51, Q52: 2N7000; TO92-DGS
R33, R35, R37, R39, R41, R43, R45, R47, R49, R51, R197, R198, R199, R200, R201, R202, R203, R204, R205, R206: 10k; R_P2INCH
R34, R36, R38, R40, R42, R44, R46, R48, R50, R52: 470; R_P2INCH

Connections:
+5V: D17.A, D18.A, D19.A, D20.A, D21.A, D22.A, D23.A, D24.A, D25.A, D26.A, R33.2, R35.2, R37.2, R39.2, R41.2, R43.2, R45.2, R47.2, R49.2, R51.2, R197.2, R198.2, R199.2, R200.2, R201.2, R202.2, R203.2, R204.2, R205.2, R206.2; also elsewhere on the board
E1: Q34.S, Q36.S, Q38.S, Q40.S, Q42.S, Q44.S, Q46.S, Q48.S, Q50.S, Q52.S; also elsewhere on the board
GND: Q33.S, Q35.S, Q37.S, Q39.S, Q41.S, Q43.S, Q45.S, Q47.S, Q49.S, Q51.S; also elsewhere on the board
unnamed: Q33.D, Q34.G, R33.1, R34.1
unnamed: D17.K (C), R34.2
unnamed: Q35.D, Q36.G, R35.1, R36.1
unnamed: D18.K (C), R36.2
unnamed: Q37.D, Q38.G, R37.1, R38.1
unnamed: D19.K (C), R38.2
unnamed: Q39.D, Q40.G, R39.1, R40.1
unnamed: D20.K (C), R40.2
unnamed: Q41.D, Q42.G, R41.1, R42.1
unnamed: D21.K (C), R42.2
unnamed: Q43.D, Q44.G, R43.1, R44.1
unnamed: D22.K (C), R44.2
unnamed: Q45.D, Q46.G, R45.1, R46.1
unnamed: D23.K (C), R46.2
unnamed: Q47.D, Q48.G, R47.1, R48.1
unnamed: D24.K (C), R48.2
unnamed: Q49.D, Q50.G, R49.1, R50.1
unnamed: D25.K (C), R50.2
unnamed: Q51.D, Q52.G, R51.1, R52.1
unnamed: D26.K (C), R52.2
S1_D0: Q33.G; also elsewhere on the board
S1_D1: Q35.G; also elsewhere on the board
S1_D2: Q37.G; also elsewhere on the board
S1_D3: Q39.G; also elsewhere on the board
S1_D4: Q41.G; also elsewhere on the board
S1_D5: Q43.G; also elsewhere on the board
S1_D6: Q45.G; also elsewhere on the board
S1_D7: Q47.G; also elsewhere on the board
S1_D8: Q49.G; also elsewhere on the board
S1_D9: Q51.G; also elsewhere on the board
T1_D0: Q34.D, R197.1; also elsewhere on the board
T1_D1: Q36.D, R198.1; also elsewhere on the board
T1_D2: Q38.D, R199.1; also elsewhere on the board
T1_D3: Q40.D, R200.1; also elsewhere on the board
T1_D4: Q42.D, R201.1; also elsewhere on the board
T1_D5: Q44.D, R202.1; also elsewhere on the board
T1_D6: Q46.D, R203.1; also elsewhere on the board
T1_D7: Q48.D, R204.1; also elsewhere on the board
T1_D8: Q50.D, R205.1; also elsewhere on the board
T1_D9: Q52.D, R206.1; also elsewhere on the board

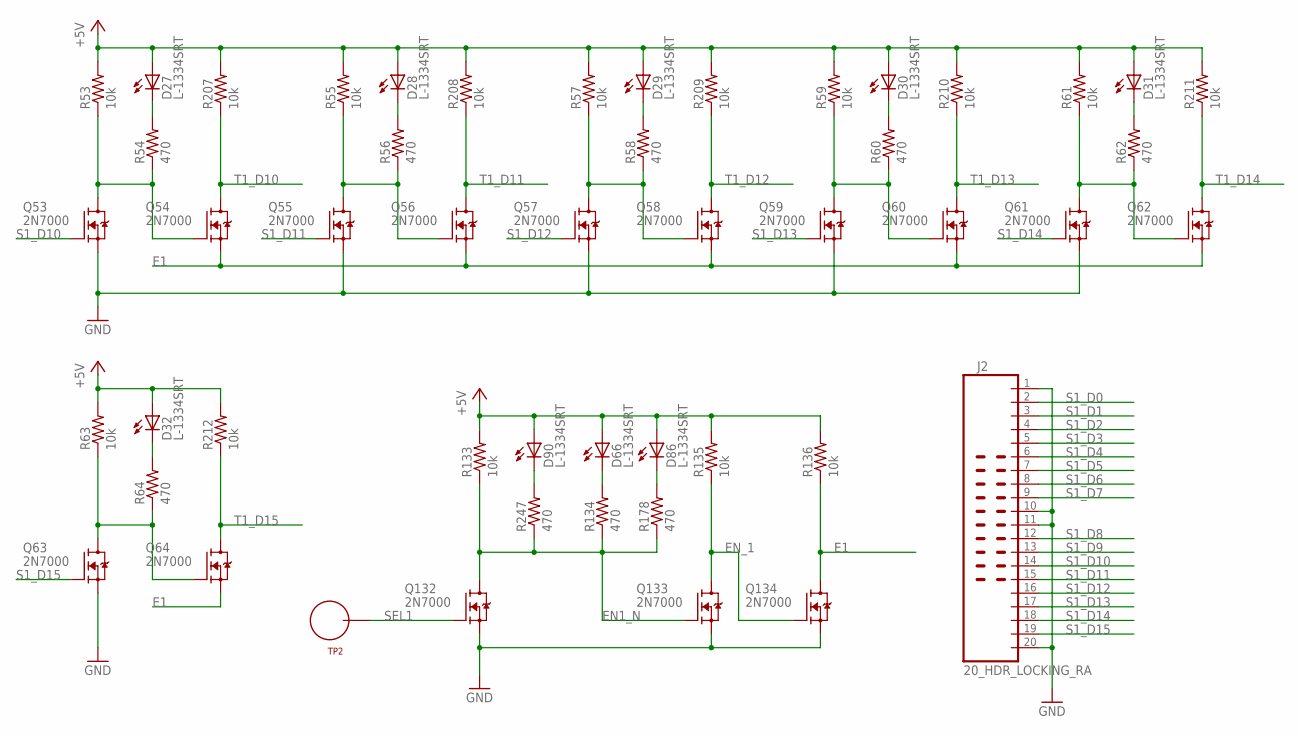
[picture p41: schematic 4x16MUX_3.sch, sheet 5]

Parts:
D27, D28, D29, D30, D31, D32, D66, D86, D90: L-1334SRT; LED3MM
J2: 20_HDR_LOCKING_RA
Q53, Q54, Q55, Q56, Q57, Q58, Q59, Q60, Q61, Q62, Q63, Q64, Q132, Q133, Q134: 2N7000; TO92-DGS
R53, R55, R57, R59, R61, R63, R133, R135, R136, R207, R208, R209, R210, R211, R212: 10k; R_P2INCH
R54, R56, R58, R60, R62, R64, R134, R178, R247: 470; R_P2INCH
TP2: TEST_LOOP

Connections:
+5V: D27.A, D28.A, D29.A, D30.A, D31.A, D32.A, D66.A, D86.A, D90.A, R53.2, R55.2, R57.2, R59.2, R61.2, R63.2, R133.2, R135.2, R136.2, R207.2, R208.2, R209.2, R210.2, R211.2, R212.2; also elsewhere on the board
E1: Q54.S, Q56.S, Q58.S, Q60.S, Q62.S, Q64.S, Q134.D, R136.1; also elsewhere on the board
EN1_N: Q132.D, Q133.G, R133.1, R134.1, R178.1, R247.1; also elsewhere on the board
EN_1: Q133.D, Q134.G, R135.1
GND: J2.1, J2.10, J2.11, J2.20, Q53.S, Q55.S, Q57.S, Q59.S, Q61.S, Q63.S, Q132.S, Q133.S, Q134.S; also elsewhere on the board
unnamed: Q53.D, Q54.G, R53.1, R54.1
unnamed: D27.K (C), R54.2
unnamed: Q55.D, Q56.G, R55.1, R56.1
unnamed: D28.K (C), R56.2
unnamed: Q57.D, Q58.G, R57.1, R58.1
unnamed: D29.K (C), R58.2
unnamed: Q59.D, Q60.G, R59.1, R60.1
unnamed: D30.K (C), R60.2
unnamed: Q61.D, Q62.G, R61.1, R62.1
unnamed: D31.K (C), R62.2
unnamed: Q63.D, Q64.G, R63.1, R64.1
unnamed: D32.K (C), R64.2
unnamed: D66.K (C), R134.2
unnamed: D86.K (C), R178.2
unnamed: D90.K (C), R247.2
S1_D0: J2.2; also elsewhere on the board
S1_D1: J2.3; also elsewhere on the board
S1_D2: J2.4; also elsewhere on the board
S1_D3: J2.5; also elsewhere on the board
S1_D4: J2.6; also elsewhere on the board
S1_D5: J2.7; also elsewhere on the board
S1_D6: J2.8; also elsewhere on the board
S1_D7: J2.9; also elsewhere on the board
S1_D8: J2.12; also elsewhere on the board
S1_D9: J2.13; also elsewhere on the board
S1_D10: J2.14, Q53.G
S1_D11: J2.15, Q55.G
S1_D12: J2.16, Q57.G
S1_D13: J2.17, Q59.G
S1_D14: J2.18, Q61.G
S1_D15: J2.19, Q63.G
SEL1: Q132.G, TP2.P$1
T1_D10: Q54.D, R207.1; also elsewhere on the board
T1_D11: Q56.D, R208.1; also elsewhere on the board
T1_D12: Q58.D, R209.1; also elsewhere on the board
T1_D13: Q60.D, R210.1; also elsewhere on the board
T1_D14: Q62.D, R211.1; also elsewhere on the board
T1_D15: Q64.D, R212.1; also elsewhere on the board

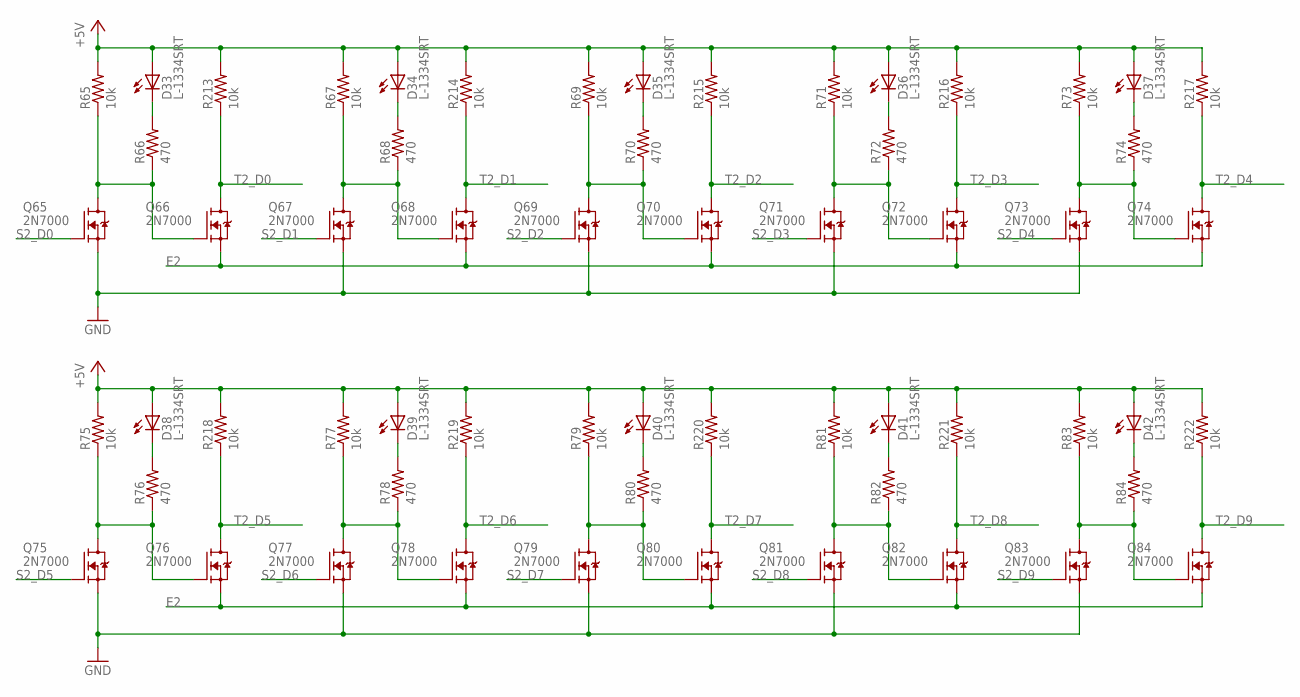
[picture p42: schematic 4x16MUX_3.sch, sheet 6]

Parts:
D33, D34, D35, D36, D37, D38, D39, D40, D41, D42: L-1334SRT; LED3MM
Q65, Q66, Q67, Q68, Q69, Q70, Q71, Q72, Q73, Q74, Q75, Q76, Q77, Q78, Q79, Q80, Q81, Q82, Q83, Q84: 2N7000; TO92-DGS
R65, R67, R69, R71, R73, R75, R77, R79, R81, R83, R213, R214, R215, R216, R217, R218, R219, R220, R221, R222: 10k; R_P2INCH
R66, R68, R70, R72, R74, R76, R78, R80, R82, R84: 470; R_P2INCH

Connections:
+5V: D33.A, D34.A, D35.A, D36.A, D37.A, D38.A, D39.A, D40.A, D41.A, D42.A, R65.2, R67.2, R69.2, R71.2, R73.2, R75.2, R77.2, R79.2, R81.2, R83.2, R213.2, R214.2, R215.2, R216.2, R217.2, R218.2, R219.2, R220.2, R221.2, R222.2; also elsewhere on the board
E2: Q66.S, Q68.S, Q70.S, Q72.S, Q74.S, Q76.S, Q78.S, Q80.S, Q82.S, Q84.S; also elsewhere on the board
GND: Q65.S, Q67.S, Q69.S, Q71.S, Q73.S, Q75.S, Q77.S, Q79.S, Q81.S, Q83.S; also elsewhere on the board
unnamed: Q65.D, Q66.G, R65.1, R66.1
unnamed: D33.K (C), R66.2
unnamed: Q67.D, Q68.G, R67.1, R68.1
unnamed: D34.K (C), R68.2
unnamed: Q69.D, Q70.G, R69.1, R70.1
unnamed: D35.K (C), R70.2
unnamed: Q71.D, Q72.G, R71.1, R72.1
unnamed: D36.K (C), R72.2
unnamed: Q73.D, Q74.G, R73.1, R74.1
unnamed: D37.K (C), R74.2
unnamed: Q75.D, Q76.G, R75.1, R76.1
unnamed: D38.K (C), R76.2
unnamed: Q77.D, Q78.G, R77.1, R78.1
unnamed: D39.K (C), R78.2
unnamed: Q79.D, Q80.G, R79.1, R80.1
unnamed: D40.K (C), R80.2
unnamed: Q81.D, Q82.G, R81.1, R82.1
unnamed: D41.K (C), R82.2
unnamed: Q83.D, Q84.G, R83.1, R84.1
unnamed: D42.K (C), R84.2
S2_D0: Q65.G; also elsewhere on the board
S2_D1: Q67.G; also elsewhere on the board
S2_D2: Q69.G; also elsewhere on the board
S2_D3: Q71.G; also elsewhere on the board
S2_D4: Q73.G; also elsewhere on the board
S2_D5: Q75.G; also elsewhere on the board
S2_D6: Q77.G; also elsewhere on the board
S2_D7: Q79.G; also elsewhere on the board
S2_D8: Q81.G; also elsewhere on the board
S2_D9: Q83.G; also elsewhere on the board
T2_D0: Q66.D, R213.1; also elsewhere on the board
T2_D1: Q68.D, R214.1; also elsewhere on the board
T2_D2: Q70.D, R215.1; also elsewhere on the board
T2_D3: Q72.D, R216.1; also elsewhere on the board
T2_D4: Q74.D, R217.1; also elsewhere on the board
T2_D5: Q76.D, R218.1; also elsewhere on the board
T2_D6: Q78.D, R219.1; also elsewhere on the board
T2_D7: Q80.D, R220.1; also elsewhere on the board
T2_D8: Q82.D, R221.1; also elsewhere on the board
T2_D9: Q84.D, R222.1; also elsewhere on the board

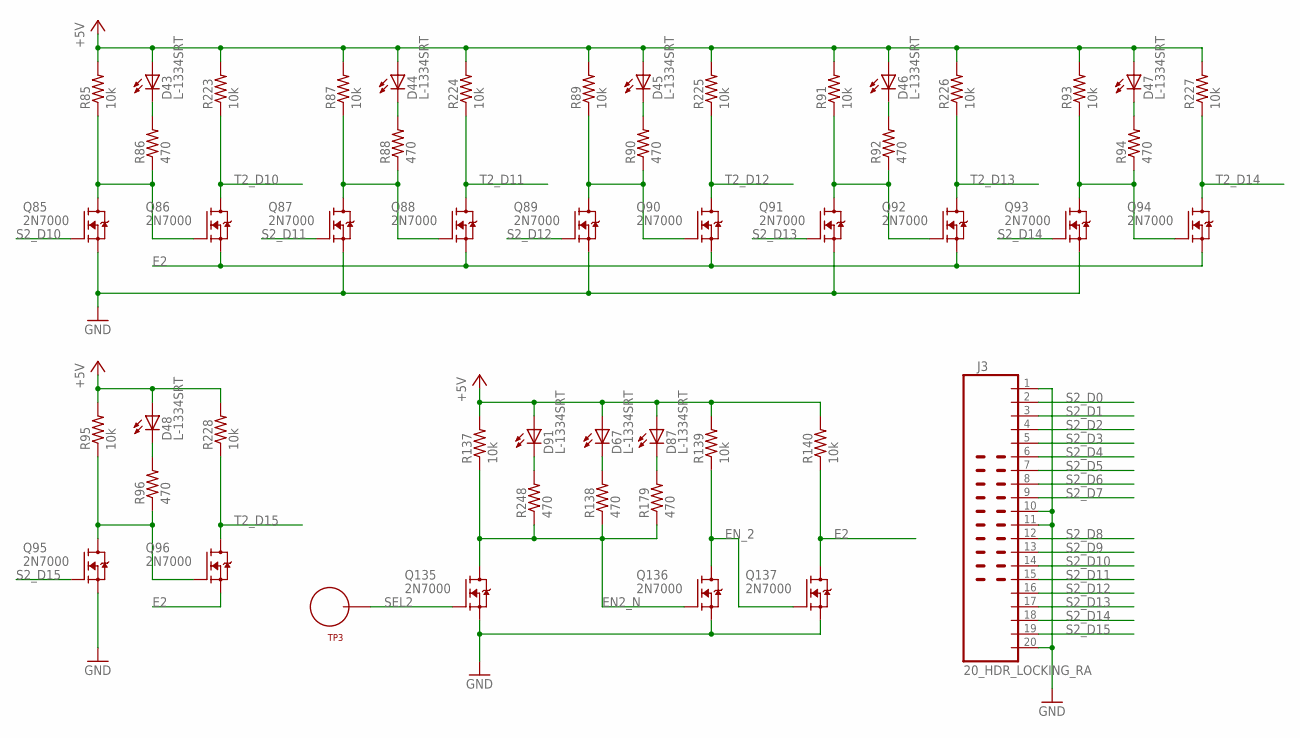
[picture p43: schematic 4x16MUX_3.sch, sheet 7]

Parts:
D43, D44, D45, D46, D47, D48, D67, D87, D91: L-1334SRT; LED3MM
J3: 20_HDR_LOCKING_RA
Q85, Q86, Q87, Q88, Q89, Q90, Q91, Q92, Q93, Q94, Q95, Q96, Q135, Q136, Q137: 2N7000; TO92-DGS
R85, R87, R89, R91, R93, R95, R137, R139, R140, R223, R224, R225, R226, R227, R228: 10k; R_P2INCH
R86, R88, R90, R92, R94, R96, R138, R179, R248: 470; R_P2INCH
TP3: TEST_LOOP

Connections:
+5V: D43.A, D44.A, D45.A, D46.A, D47.A, D48.A, D67.A, D87.A, D91.A, R85.2, R87.2, R89.2, R91.2, R93.2, R95.2, R137.2, R139.2, R140.2, R223.2, R224.2, R225.2, R226.2, R227.2, R228.2; also elsewhere on the board
E2: Q86.S, Q88.S, Q90.S, Q92.S, Q94.S, Q96.S, Q137.D, R140.1; also elsewhere on the board
EN2_N: Q135.D, Q136.G, R137.1, R138.1, R179.1, R248.1; also elsewhere on the board
EN_2: Q136.D, Q137.G, R139.1
GND: J3.1, J3.10, J3.11, J3.20, Q85.S, Q87.S, Q89.S, Q91.S, Q93.S, Q95.S, Q135.S, Q136.S, Q137.S; also elsewhere on the board
unnamed: Q85.D, Q86.G, R85.1, R86.1
unnamed: D43.K (C), R86.2
unnamed: Q87.D, Q88.G, R87.1, R88.1
unnamed: D44.K (C), R88.2
unnamed: Q89.D, Q90.G, R89.1, R90.1
unnamed: D45.K (C), R90.2
unnamed: Q91.D, Q92.G, R91.1, R92.1
unnamed: D46.K (C), R92.2
unnamed: Q93.D, Q94.G, R93.1, R94.1
unnamed: D47.K (C), R94.2
unnamed: Q95.D, Q96.G, R95.1, R96.1
unnamed: D48.K (C), R96.2
unnamed: D67.K (C), R138.2
unnamed: D87.K (C), R179.2
unnamed: D91.K (C), R248.2
S2_D0: J3.2; also elsewhere on the board
S2_D1: J3.3; also elsewhere on the board
S2_D2: J3.4; also elsewhere on the board
S2_D3: J3.5; also elsewhere on the board
S2_D4: J3.6; also elsewhere on the board
S2_D5: J3.7; also elsewhere on the board
S2_D6: J3.8; also elsewhere on the board
S2_D7: J3.9; also elsewhere on the board
S2_D8: J3.12; also elsewhere on the board
S2_D9: J3.13; also elsewhere on the board
S2_D10: J3.14, Q85.G
S2_D11: J3.15, Q87.G
S2_D12: J3.16, Q89.G
S2_D13: J3.17, Q91.G
S2_D14: J3.18, Q93.G
S2_D15: J3.19, Q95.G
SEL2: Q135.G, TP3.P$1
T2_D10: Q86.D, R223.1; also elsewhere on the board
T2_D11: Q88.D, R224.1; also elsewhere on the board
T2_D12: Q90.D, R225.1; also elsewhere on the board
T2_D13: Q92.D, R226.1; also elsewhere on the board
T2_D14: Q94.D, R227.1; also elsewhere on the board
T2_D15: Q96.D, R228.1; also elsewhere on the board

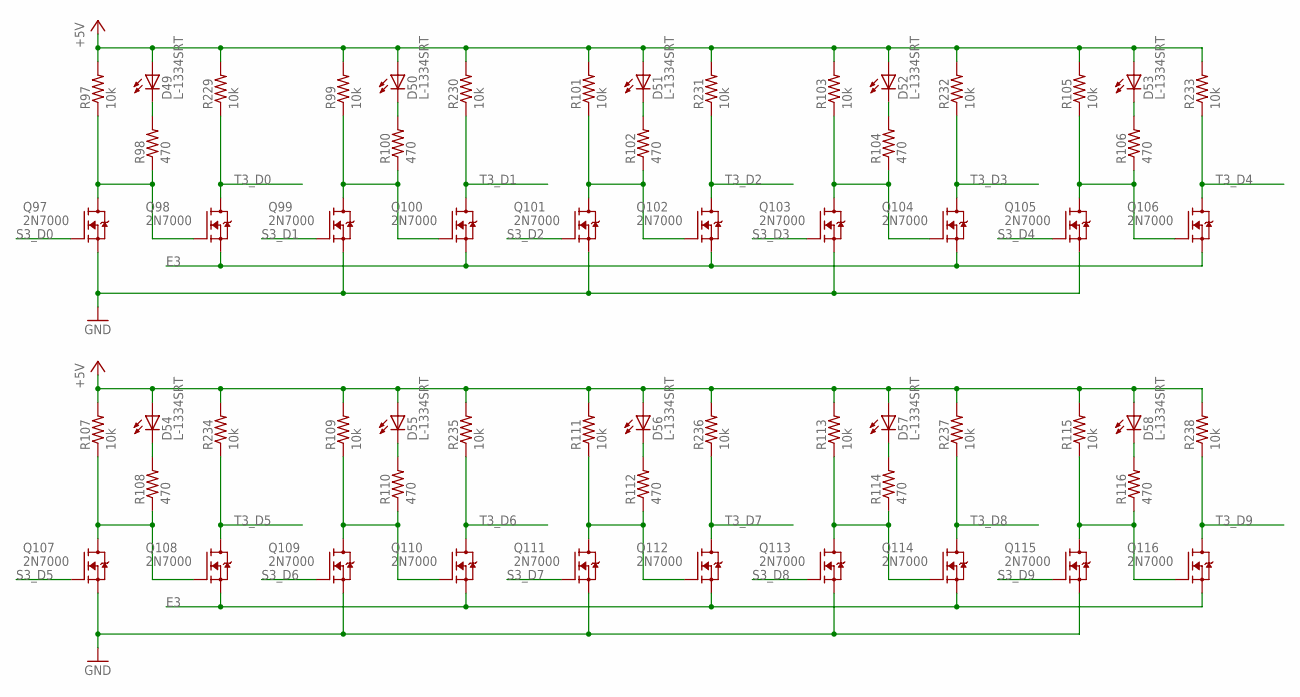
[picture p44: schematic 4x16MUX_3.sch, sheet 8]

Parts:
D49, D50, D51, D52, D53, D54, D55, D56, D57, D58: L-1334SRT; LED3MM
Q97, Q98, Q99, Q100, Q101, Q102, Q103, Q104, Q105, Q106, Q107, Q108, Q109, Q110, Q111, Q112, Q113, Q114, Q115, Q116: 2N7000; TO92-DGS
R97, R99, R101, R103, R105, R107, R109, R111, R113, R115, R229, R230, R231, R232, R233, R234, R235, R236, R237, R238: 10k; R_P2INCH
R98, R100, R102, R104, R106, R108, R110, R112, R114, R116: 470; R_P2INCH

Connections:
+5V: D49.A, D50.A, D51.A, D52.A, D53.A, D54.A, D55.A, D56.A, D57.A, D58.A, R97.2, R99.2, R101.2, R103.2, R105.2, R107.2, R109.2, R111.2, R113.2, R115.2, R229.2, R230.2, R231.2, R232.2, R233.2, R234.2, R235.2, R236.2, R237.2, R238.2; also elsewhere on the board
E3: Q98.S, Q100.S, Q102.S, Q104.S, Q106.S, Q108.S, Q110.S, Q112.S, Q114.S, Q116.S; also elsewhere on the board
GND: Q97.S, Q99.S, Q101.S, Q103.S, Q105.S, Q107.S, Q109.S, Q111.S, Q113.S, Q115.S; also elsewhere on the board
unnamed: Q97.D, Q98.G, R97.1, R98.1
unnamed: D49.K (C), R98.2
unnamed: Q99.D, Q100.G, R99.1, R100.1
unnamed: D50.K (C), R100.2
unnamed: Q101.D, Q102.G, R101.1, R102.1
unnamed: D51.K (C), R102.2
unnamed: Q103.D, Q104.G, R103.1, R104.1
unnamed: D52.K (C), R104.2
unnamed: Q105.D, Q106.G, R105.1, R106.1
unnamed: D53.K (C), R106.2
unnamed: Q107.D, Q108.G, R107.1, R108.1
unnamed: D54.K (C), R108.2
unnamed: Q109.D, Q110.G, R109.1, R110.1
unnamed: D55.K (C), R110.2
unnamed: Q111.D, Q112.G, R111.1, R112.1
unnamed: D56.K (C), R112.2
unnamed: Q113.D, Q114.G, R113.1, R114.1
unnamed: D57.K (C), R114.2
unnamed: Q115.D, Q116.G, R115.1, R116.1
unnamed: D58.K (C), R116.2
S3_D0: Q97.G; also elsewhere on the board
S3_D1: Q99.G; also elsewhere on the board
S3_D2: Q101.G; also elsewhere on the board
S3_D3: Q103.G; also elsewhere on the board
S3_D4: Q105.G; also elsewhere on the board
S3_D5: Q107.G; also elsewhere on the board
S3_D6: Q109.G; also elsewhere on the board
S3_D7: Q111.G; also elsewhere on the board
S3_D8: Q113.G; also elsewhere on the board
S3_D9: Q115.G; also elsewhere on the board
T3_D0: Q98.D, R229.1; also elsewhere on the board
T3_D1: Q100.D, R230.1; also elsewhere on the board
T3_D2: Q102.D, R231.1; also elsewhere on the board
T3_D3: Q104.D, R232.1; also elsewhere on the board
T3_D4: Q106.D, R233.1; also elsewhere on the board
T3_D5: Q108.D, R234.1; also elsewhere on the board
T3_D6: Q110.D, R235.1; also elsewhere on the board
T3_D7: Q112.D, R236.1; also elsewhere on the board
T3_D8: Q114.D, R237.1; also elsewhere on the board
T3_D9: Q116.D, R238.1; also elsewhere on the board

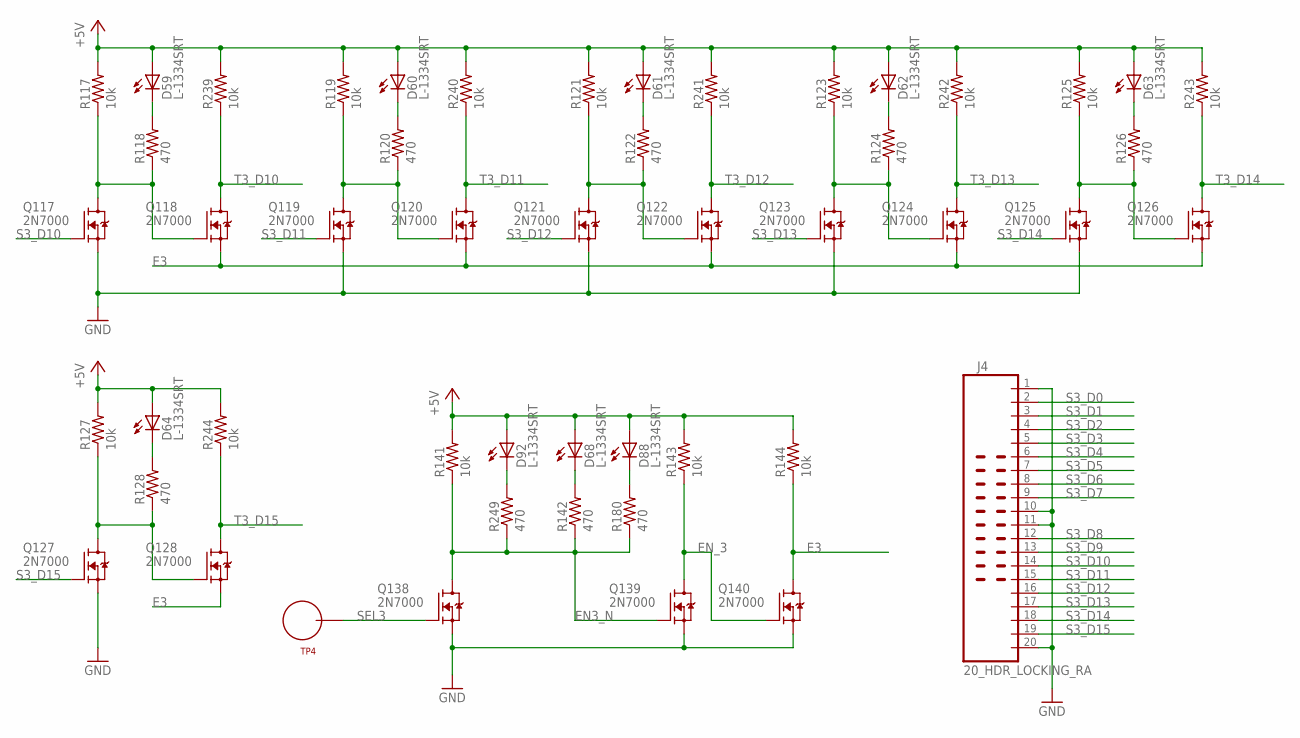
[picture p45: schematic 4x16MUX_3.sch, sheet 9]

Parts:
D59, D60, D61, D62, D63, D64, D68, D88, D92: L-1334SRT; LED3MM
J4: 20_HDR_LOCKING_RA
Q117, Q118, Q119, Q120, Q121, Q122, Q123, Q124, Q125, Q126, Q127, Q128, Q138, Q139, Q140: 2N7000; TO92-DGS
R117, R119, R121, R123, R125, R127, R141, R143, R144, R239, R240, R241, R242, R243, R244: 10k; R_P2INCH
R118, R120, R122, R124, R126, R128, R142, R180, R249: 470; R_P2INCH
TP4: TEST_LOOP

Connections:
+5V: D59.A, D60.A, D61.A, D62.A, D63.A, D64.A, D68.A, D88.A, D92.A, R117.2, R119.2, R121.2, R123.2, R125.2, R127.2, R141.2, R143.2, R144.2, R239.2, R240.2, R241.2, R242.2, R243.2, R244.2; also elsewhere on the board
E3: Q118.S, Q120.S, Q122.S, Q124.S, Q126.S, Q128.S, Q140.D, R144.1; also elsewhere on the board
EN3_N: Q138.D, Q139.G, R141.1, R142.1, R180.1, R249.1; also elsewhere on the board
EN_3: Q139.D, Q140.G, R143.1
GND: J4.1, J4.10, J4.11, J4.20, Q117.S, Q119.S, Q121.S, Q123.S, Q125.S, Q127.S, Q138.S, Q139.S, Q140.S; also elsewhere on the board
unnamed: Q117.D, Q118.G, R117.1, R118.1
unnamed: D59.K (C), R118.2
unnamed: Q119.D, Q120.G, R119.1, R120.1
unnamed: D60.K (C), R120.2
unnamed: Q121.D, Q122.G, R121.1, R122.1
unnamed: D61.K (C), R122.2
unnamed: Q123.D, Q124.G, R123.1, R124.1
unnamed: D62.K (C), R124.2
unnamed: Q125.D, Q126.G, R125.1, R126.1
unnamed: D63.K (C), R126.2
unnamed: Q127.D, Q128.G, R127.1, R128.1
unnamed: D64.K (C), R128.2
unnamed: D68.K (C), R142.2
unnamed: D88.K (C), R180.2
unnamed: D92.K (C), R249.2
S3_D0: J4.2; also elsewhere on the board
S3_D1: J4.3; also elsewhere on the board
S3_D2: J4.4; also elsewhere on the board
S3_D3: J4.5; also elsewhere on the board
S3_D4: J4.6; also elsewhere on the board
S3_D5: J4.7; also elsewhere on the board
S3_D6: J4.8; also elsewhere on the board
S3_D7: J4.9; also elsewhere on the board
S3_D8: J4.12; also elsewhere on the board
S3_D9: J4.13; also elsewhere on the board
S3_D10: J4.14, Q117.G
S3_D11: J4.15, Q119.G
S3_D12: J4.16, Q121.G
S3_D13: J4.17, Q123.G
S3_D14: J4.18, Q125.G
S3_D15: J4.19, Q127.G
SEL3: Q138.G, TP4.P$1
T3_D10: Q118.D, R239.1; also elsewhere on the board
T3_D11: Q120.D, R240.1; also elsewhere on the board
T3_D12: Q122.D, R241.1; also elsewhere on the board
T3_D13: Q124.D, R242.1; also elsewhere on the board
T3_D14: Q126.D, R243.1; also elsewhere on the board
T3_D15: Q128.D, R244.1; also elsewhere on the board

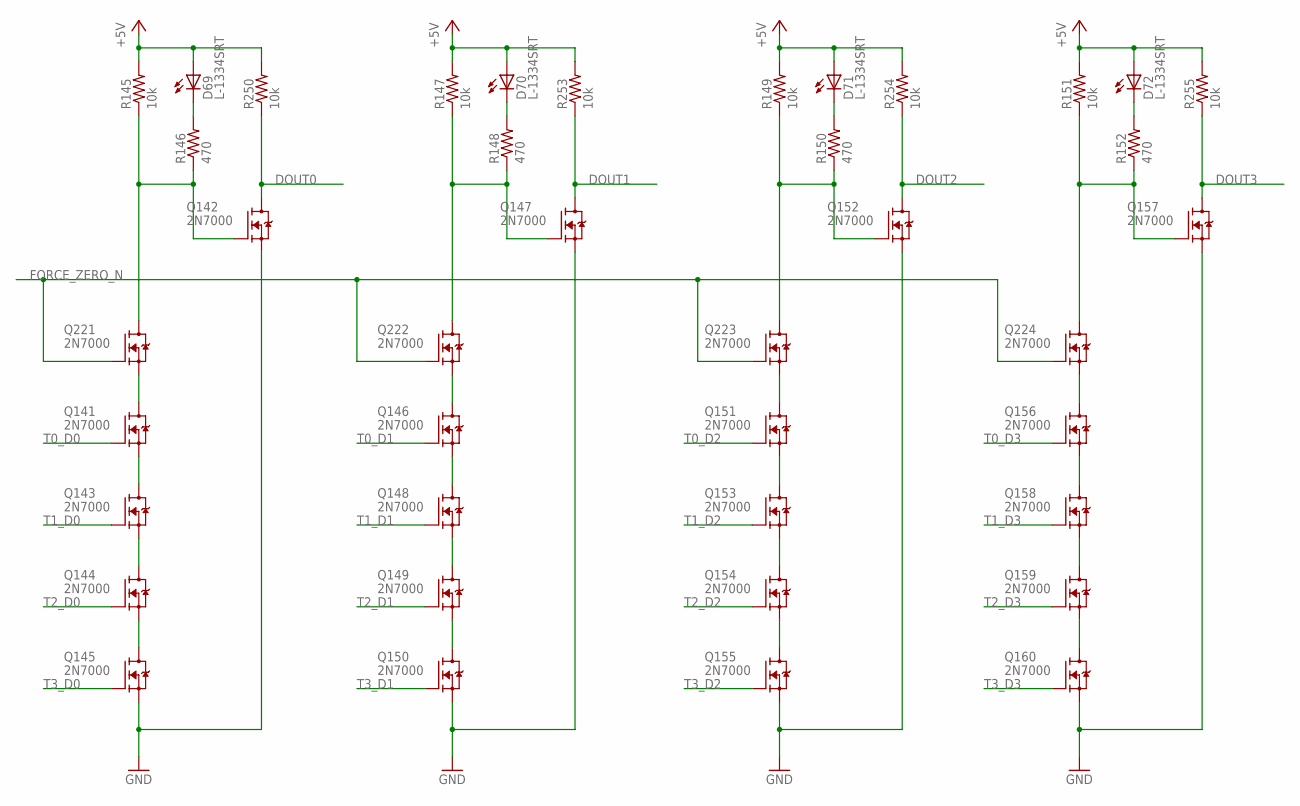
[picture p46: schematic 4x16MUX_3.sch, sheet 10]

Parts:
D69, D70, D71, D72: L-1334SRT; LED3MM
Q141, Q142, Q143, Q144, Q145, Q146, Q147, Q148, Q149, Q150, Q151, Q152, Q153, Q154, Q155, Q156, Q157, Q158, Q159, Q160, Q221, Q222, Q223, Q224: 2N7000; TO92-DGS
R145, R147, R149, R151, R250, R253, R254, R255: 10k; R_P2INCH
R146, R148, R150, R152: 470; R_P2INCH

Connections:
+5V: D69.A, D70.A, D71.A, D72.A, R145.2, R147.2, R149.2, R151.2, R250.2, R253.2, R254.2, R255.2; also elsewhere on the board
DOUT0: Q142.D, R250.1; also elsewhere on the board
DOUT1: Q147.D, R253.1; also elsewhere on the board
DOUT2: Q152.D, R254.1; also elsewhere on the board
DOUT3: Q157.D, R255.1; also elsewhere on the board
FORCE_ZERO_N: Q221.G, Q222.G, Q223.G, Q224.G; also elsewhere on the board
GND: Q142.S, Q145.S, Q147.S, Q150.S, Q152.S, Q155.S, Q157.S, Q160.S; also elsewhere on the board
unnamed: Q142.G, Q221.D, R145.1, R146.1
unnamed: D69.K (C), R146.2
unnamed: Q144.S, Q145.D
unnamed: Q143.S, Q144.D
unnamed: Q141.S, Q143.D
unnamed: Q147.G, Q222.D, R147.1, R148.1
unnamed: D70.K (C), R148.2
unnamed: Q149.S, Q150.D
unnamed: Q148.S, Q149.D
unnamed: Q146.S, Q148.D
unnamed: Q152.G, Q223.D, R149.1, R150.1
unnamed: D71.K (C), R150.2
unnamed: Q154.S, Q155.D
unnamed: Q153.S, Q154.D
unnamed: Q151.S, Q153.D
unnamed: Q157.G, Q224.D, R151.1, R152.1
unnamed: D72.K (C), R152.2
unnamed: Q159.S, Q160.D
unnamed: Q158.S, Q159.D
unnamed: Q156.S, Q158.D
unnamed: Q141.D, Q221.S
unnamed: Q146.D, Q222.S
unnamed: Q151.D, Q223.S
unnamed: Q156.D, Q224.S
T0_D0: Q141.G; also elsewhere on the board
T0_D1: Q146.G; also elsewhere on the board
T0_D2: Q151.G; also elsewhere on the board
T0_D3: Q156.G; also elsewhere on the board
T1_D0: Q143.G; also elsewhere on the board
T1_D1: Q148.G; also elsewhere on the board
T1_D2: Q153.G; also elsewhere on the board
T1_D3: Q158.G; also elsewhere on the board
T2_D0: Q144.G; also elsewhere on the board
T2_D1: Q149.G; also elsewhere on the board
T2_D2: Q154.G; also elsewhere on the board
T2_D3: Q159.G; also elsewhere on the board
T3_D0: Q145.G; also elsewhere on the board
T3_D1: Q150.G; also elsewhere on the board
T3_D2: Q155.G; also elsewhere on the board
T3_D3: Q160.G; also elsewhere on the board

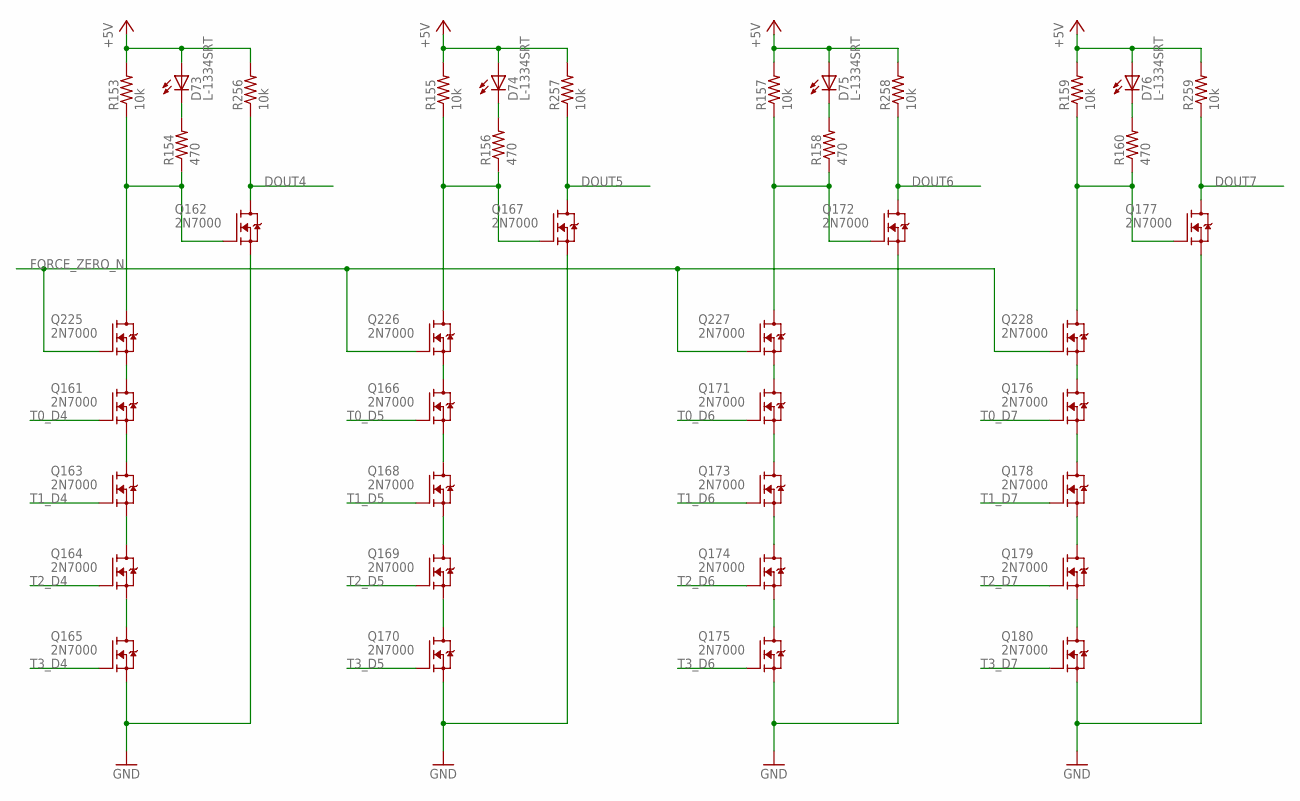
[picture p47: schematic 4x16MUX_3.sch, sheet 11]

Parts:
D73, D74, D75, D76: L-1334SRT; LED3MM
Q161, Q162, Q163, Q164, Q165, Q166, Q167, Q168, Q169, Q170, Q171, Q172, Q173, Q174, Q175, Q176, Q177, Q178, Q179, Q180, Q225, Q226, Q227, Q228: 2N7000; TO92-DGS
R153, R155, R157, R159, R256, R257, R258, R259: 10k; R_P2INCH
R154, R156, R158, R160: 470; R_P2INCH

Connections:
+5V: D73.A, D74.A, D75.A, D76.A, R153.2, R155.2, R157.2, R159.2, R256.2, R257.2, R258.2, R259.2; also elsewhere on the board
DOUT4: Q162.D, R256.1; also elsewhere on the board
DOUT5: Q167.D, R257.1; also elsewhere on the board
DOUT6: Q172.D, R258.1; also elsewhere on the board
DOUT7: Q177.D, R259.1; also elsewhere on the board
FORCE_ZERO_N: Q225.G, Q226.G, Q227.G, Q228.G; also elsewhere on the board
GND: Q162.S, Q165.S, Q167.S, Q170.S, Q172.S, Q175.S, Q177.S, Q180.S; also elsewhere on the board
unnamed: Q162.G, Q225.D, R153.1, R154.1
unnamed: D73.K (C), R154.2
unnamed: Q164.S, Q165.D
unnamed: Q163.S, Q164.D
unnamed: Q161.S, Q163.D
unnamed: Q167.G, Q226.D, R155.1, R156.1
unnamed: D74.K (C), R156.2
unnamed: Q169.S, Q170.D
unnamed: Q168.S, Q169.D
unnamed: Q166.S, Q168.D
unnamed: Q172.G, Q227.D, R157.1, R158.1
unnamed: D75.K (C), R158.2
unnamed: Q174.S, Q175.D
unnamed: Q173.S, Q174.D
unnamed: Q171.S, Q173.D
unnamed: Q177.G, Q228.D, R159.1, R160.1
unnamed: D76.K (C), R160.2
unnamed: Q179.S, Q180.D
unnamed: Q178.S, Q179.D
unnamed: Q176.S, Q178.D
unnamed: Q161.D, Q225.S
unnamed: Q166.D, Q226.S
unnamed: Q171.D, Q227.S
unnamed: Q176.D, Q228.S
T0_D4: Q161.G; also elsewhere on the board
T0_D5: Q166.G; also elsewhere on the board
T0_D6: Q171.G; also elsewhere on the board
T0_D7: Q176.G; also elsewhere on the board
T1_D4: Q163.G; also elsewhere on the board
T1_D5: Q168.G; also elsewhere on the board
T1_D6: Q173.G; also elsewhere on the board
T1_D7: Q178.G; also elsewhere on the board
T2_D4: Q164.G; also elsewhere on the board
T2_D5: Q169.G; also elsewhere on the board
T2_D6: Q174.G; also elsewhere on the board
T2_D7: Q179.G; also elsewhere on the board
T3_D4: Q165.G; also elsewhere on the board
T3_D5: Q170.G; also elsewhere on the board
T3_D6: Q175.G; also elsewhere on the board
T3_D7: Q180.G; also elsewhere on the board

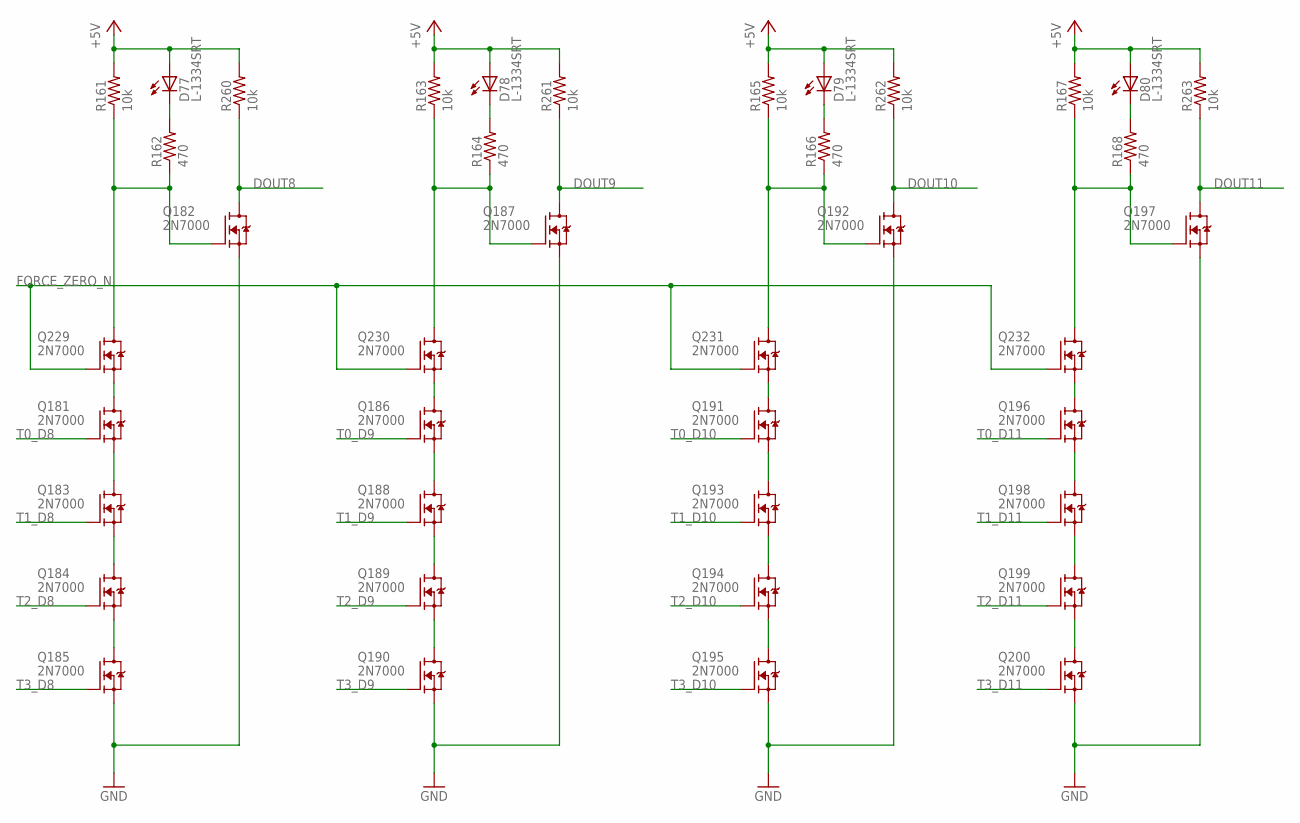
[picture p48: schematic 4x16MUX_3.sch, sheet 12]

Parts:
D77, D78, D79, D80: L-1334SRT; LED3MM
Q181, Q182, Q183, Q184, Q185, Q186, Q187, Q188, Q189, Q190, Q191, Q192, Q193, Q194, Q195, Q196, Q197, Q198, Q199, Q200, Q229, Q230, Q231, Q232: 2N7000; TO92-DGS
R161, R163, R165, R167, R260, R261, R262, R263: 10k; R_P2INCH
R162, R164, R166, R168: 470; R_P2INCH

Connections:
+5V: D77.A, D78.A, D79.A, D80.A, R161.2, R163.2, R165.2, R167.2, R260.2, R261.2, R262.2, R263.2; also elsewhere on the board
DOUT8: Q182.D, R260.1; also elsewhere on the board
DOUT9: Q187.D, R261.1; also elsewhere on the board
DOUT10: Q192.D, R262.1; also elsewhere on the board
DOUT11: Q197.D, R263.1; also elsewhere on the board
FORCE_ZERO_N: Q229.G, Q230.G, Q231.G, Q232.G; also elsewhere on the board
GND: Q182.S, Q185.S, Q187.S, Q190.S, Q192.S, Q195.S, Q197.S, Q200.S; also elsewhere on the board
unnamed: Q182.G, Q229.D, R161.1, R162.1
unnamed: D77.K (C), R162.2
unnamed: Q184.S, Q185.D
unnamed: Q183.S, Q184.D
unnamed: Q181.S, Q183.D
unnamed: Q187.G, Q230.D, R163.1, R164.1
unnamed: D78.K (C), R164.2
unnamed: Q189.S, Q190.D
unnamed: Q188.S, Q189.D
unnamed: Q186.S, Q188.D
unnamed: Q192.G, Q231.D, R165.1, R166.1
unnamed: D79.K (C), R166.2
unnamed: Q194.S, Q195.D
unnamed: Q193.S, Q194.D
unnamed: Q191.S, Q193.D
unnamed: Q197.G, Q232.D, R167.1, R168.1
unnamed: D80.K (C), R168.2
unnamed: Q199.S, Q200.D
unnamed: Q198.S, Q199.D
unnamed: Q196.S, Q198.D
unnamed: Q181.D, Q229.S
unnamed: Q186.D, Q230.S
unnamed: Q191.D, Q231.S
unnamed: Q196.D, Q232.S
T0_D8: Q181.G; also elsewhere on the board
T0_D9: Q186.G; also elsewhere on the board
T0_D10: Q191.G; also elsewhere on the board
T0_D11: Q196.G; also elsewhere on the board
T1_D8: Q183.G; also elsewhere on the board
T1_D9: Q188.G; also elsewhere on the board
T1_D10: Q193.G; also elsewhere on the board
T1_D11: Q198.G; also elsewhere on the board
T2_D8: Q184.G; also elsewhere on the board
T2_D9: Q189.G; also elsewhere on the board
T2_D10: Q194.G; also elsewhere on the board
T2_D11: Q199.G; also elsewhere on the board
T3_D8: Q185.G; also elsewhere on the board
T3_D9: Q190.G; also elsewhere on the board
T3_D10: Q195.G; also elsewhere on the board
T3_D11: Q200.G; also elsewhere on the board
