ericherman/megaprocessor/4x16mux/4x16MUX_3.brd

## EAGLE design 4x16mux/4x16MUX_3.brd (continued)

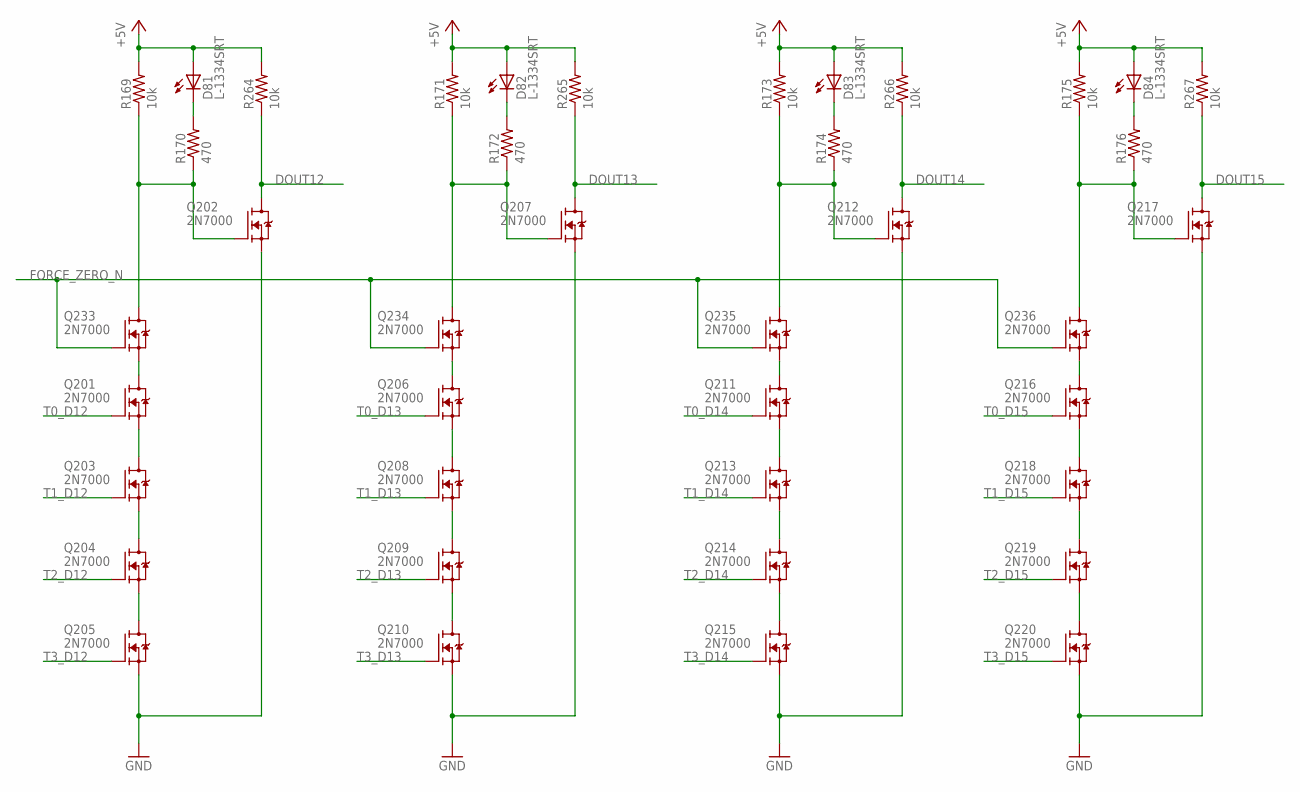
[picture p49: schematic 4x16MUX_3.sch, sheet 13]

Parts:
D81, D82, D83, D84: L-1334SRT; LED3MM
Q201, Q202, Q203, Q204, Q205, Q206, Q207, Q208, Q209, Q210, Q211, Q212, Q213, Q214, Q215, Q216, Q217, Q218, Q219, Q220, Q233, Q234, Q235, Q236: 2N7000; TO92-DGS
R169, R171, R173, R175, R264, R265, R266, R267: 10k; R_P2INCH
R170, R172, R174, R176: 470; R_P2INCH

Connections:
+5V: D81.A, D82.A, D83.A, D84.A, R169.2, R171.2, R173.2, R175.2, R264.2, R265.2, R266.2, R267.2; also elsewhere on the board
DOUT12: Q202.D, R264.1; also elsewhere on the board
DOUT13: Q207.D, R265.1; also elsewhere on the board
DOUT14: Q212.D, R266.1; also elsewhere on the board
DOUT15: Q217.D, R267.1; also elsewhere on the board
FORCE_ZERO_N: Q233.G, Q234.G, Q235.G, Q236.G; also elsewhere on the board
GND: Q202.S, Q205.S, Q207.S, Q210.S, Q212.S, Q215.S, Q217.S, Q220.S; also elsewhere on the board
unnamed: Q202.G, Q233.D, R169.1, R170.1
unnamed: D81.K (C), R170.2
unnamed: Q204.S, Q205.D
unnamed: Q203.S, Q204.D
unnamed: Q201.S, Q203.D
unnamed: Q207.G, Q234.D, R171.1, R172.1
unnamed: D82.K (C), R172.2
unnamed: Q209.S, Q210.D
unnamed: Q208.S, Q209.D
unnamed: Q206.S, Q208.D
unnamed: Q212.G, Q235.D, R173.1, R174.1
unnamed: D83.K (C), R174.2
unnamed: Q214.S, Q215.D
unnamed: Q213.S, Q214.D
unnamed: Q211.S, Q213.D
unnamed: Q217.G, Q236.D, R175.1, R176.1
unnamed: D84.K (C), R176.2
unnamed: Q219.S, Q220.D
unnamed: Q218.S, Q219.D
unnamed: Q216.S, Q218.D
unnamed: Q201.D, Q233.S
unnamed: Q206.D, Q234.S
unnamed: Q211.D, Q235.S
unnamed: Q216.D, Q236.S
T0_D12: Q201.G; also elsewhere on the board
T0_D13: Q206.G; also elsewhere on the board
T0_D14: Q211.G; also elsewhere on the board
T0_D15: Q216.G; also elsewhere on the board
T1_D12: Q203.G; also elsewhere on the board
T1_D13: Q208.G; also elsewhere on the board
T1_D14: Q213.G; also elsewhere on the board
T1_D15: Q218.G; also elsewhere on the board
T2_D12: Q204.G; also elsewhere on the board
T2_D13: Q209.G; also elsewhere on the board
T2_D14: Q214.G; also elsewhere on the board
T2_D15: Q219.G; also elsewhere on the board
T3_D12: Q205.G; also elsewhere on the board
T3_D13: Q210.G; also elsewhere on the board
T3_D14: Q215.G; also elsewhere on the board
T3_D15: Q220.G; also elsewhere on the board

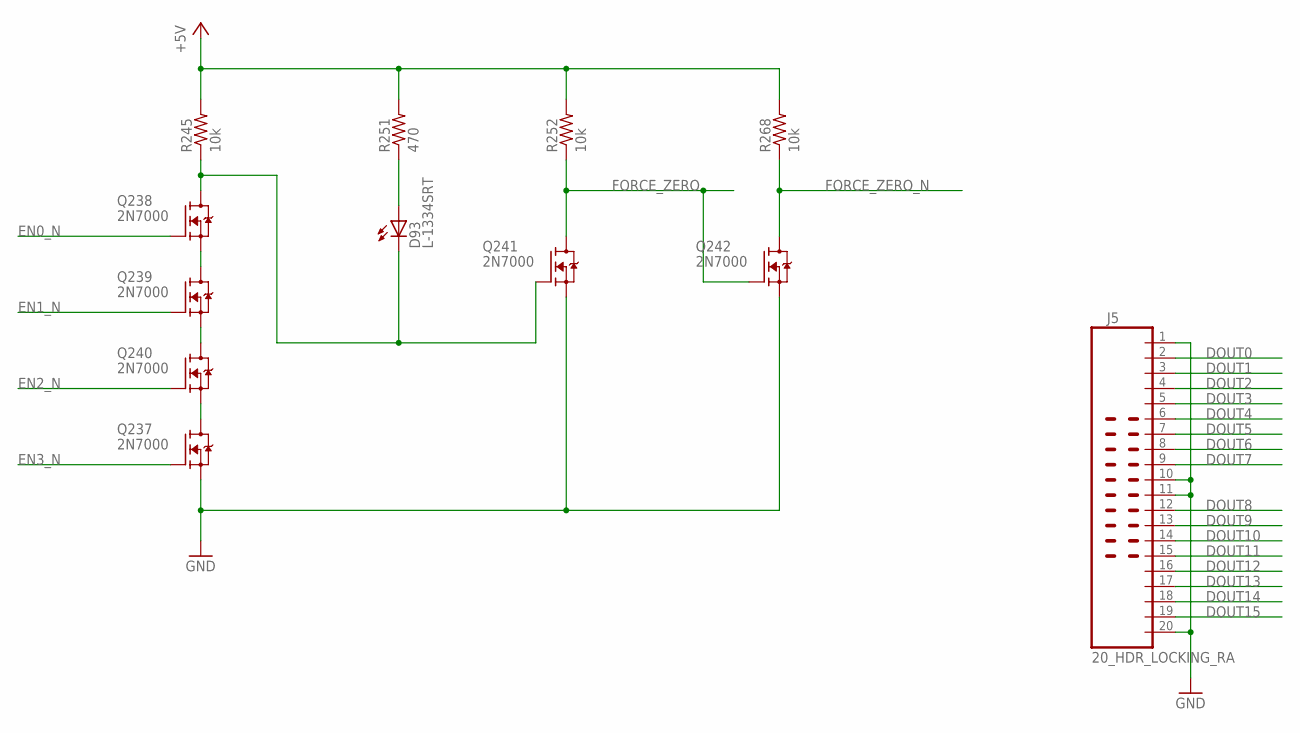
[picture p50: schematic 4x16MUX_3.sch, sheet 14]

Parts:
D93: L-1334SRT; LED3MM
J5: 20_HDR_LOCKING_RA
Q237, Q238, Q239, Q240, Q241, Q242: 2N7000; TO92-DGS
R245, R252, R268: 10k; R_P2INCH
R251: 470; R_P2INCH

Connections:
+5V: R245.2, R251.2, R252.2, R268.2; also elsewhere on the board
DOUT0: J5.2; also elsewhere on the board
DOUT1: J5.3; also elsewhere on the board
DOUT2: J5.4; also elsewhere on the board
DOUT3: J5.5; also elsewhere on the board
DOUT4: J5.6; also elsewhere on the board
DOUT5: J5.7; also elsewhere on the board
DOUT6: J5.8; also elsewhere on the board
DOUT7: J5.9; also elsewhere on the board
DOUT8: J5.12; also elsewhere on the board
DOUT9: J5.13; also elsewhere on the board
DOUT10: J5.14; also elsewhere on the board
DOUT11: J5.15; also elsewhere on the board
DOUT12: J5.16; also elsewhere on the board
DOUT13: J5.17; also elsewhere on the board
DOUT14: J5.18; also elsewhere on the board
DOUT15: J5.19; also elsewhere on the board
EN0_N: Q238.G; also elsewhere on the board
EN1_N: Q239.G; also elsewhere on the board
EN2_N: Q240.G; also elsewhere on the board
EN3_N: Q237.G; also elsewhere on the board
FORCE_ZERO: Q241.D, Q242.G, R252.1
FORCE_ZERO_N: Q242.D, R268.1; also elsewhere on the board
GND: J5.1, J5.10, J5.11, J5.20, Q237.S, Q241.S, Q242.S; also elsewhere on the board
unnamed: D93.K (C), Q238.D, Q241.G, R245.1
unnamed: Q238.S, Q239.D
unnamed: Q239.S, Q240.D
unnamed: Q237.D, Q240.S
unnamed: D93.A, R251.1

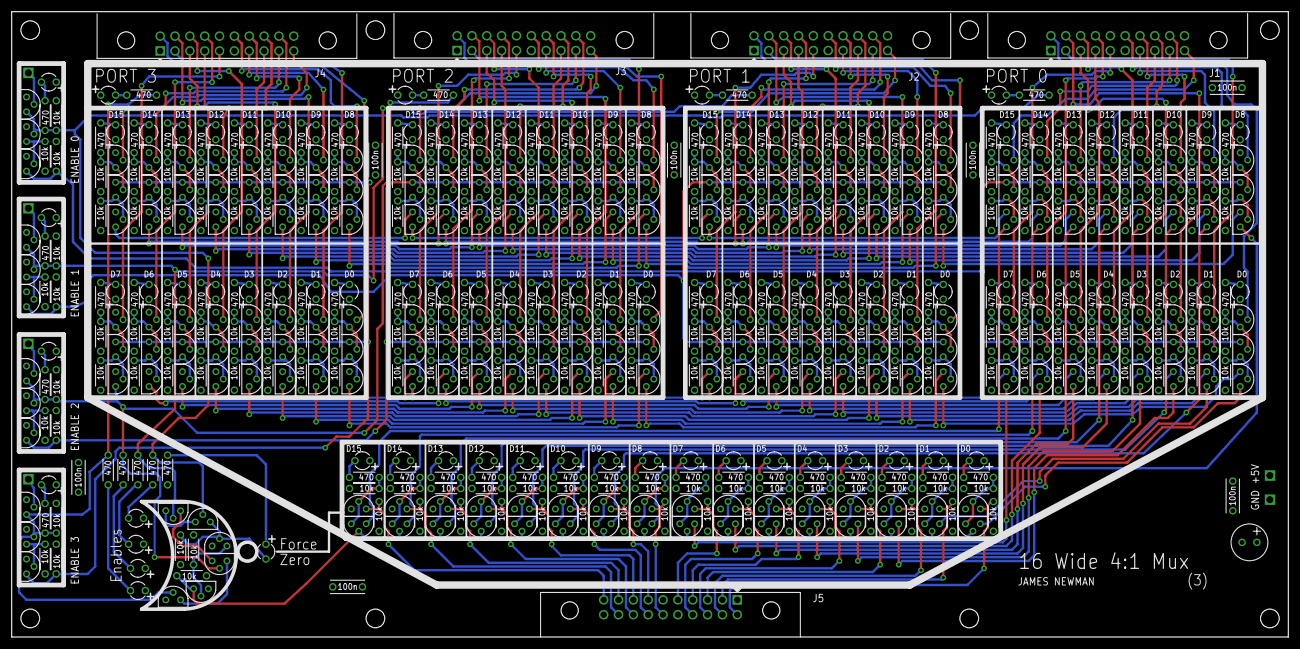
[picture p51: board 4x16MUX_3.brd from above]

Board: 4 copper layers, 218.4 x 107.0 mm, 630 parts (0 on the bottom side), 405 nets.
