ericherman/megaprocessor/4_to_16_decoder/Decoder16_1.brd

## EAGLE design 4_to_16_decoder/Decoder16_1.brd (2017-05-20)

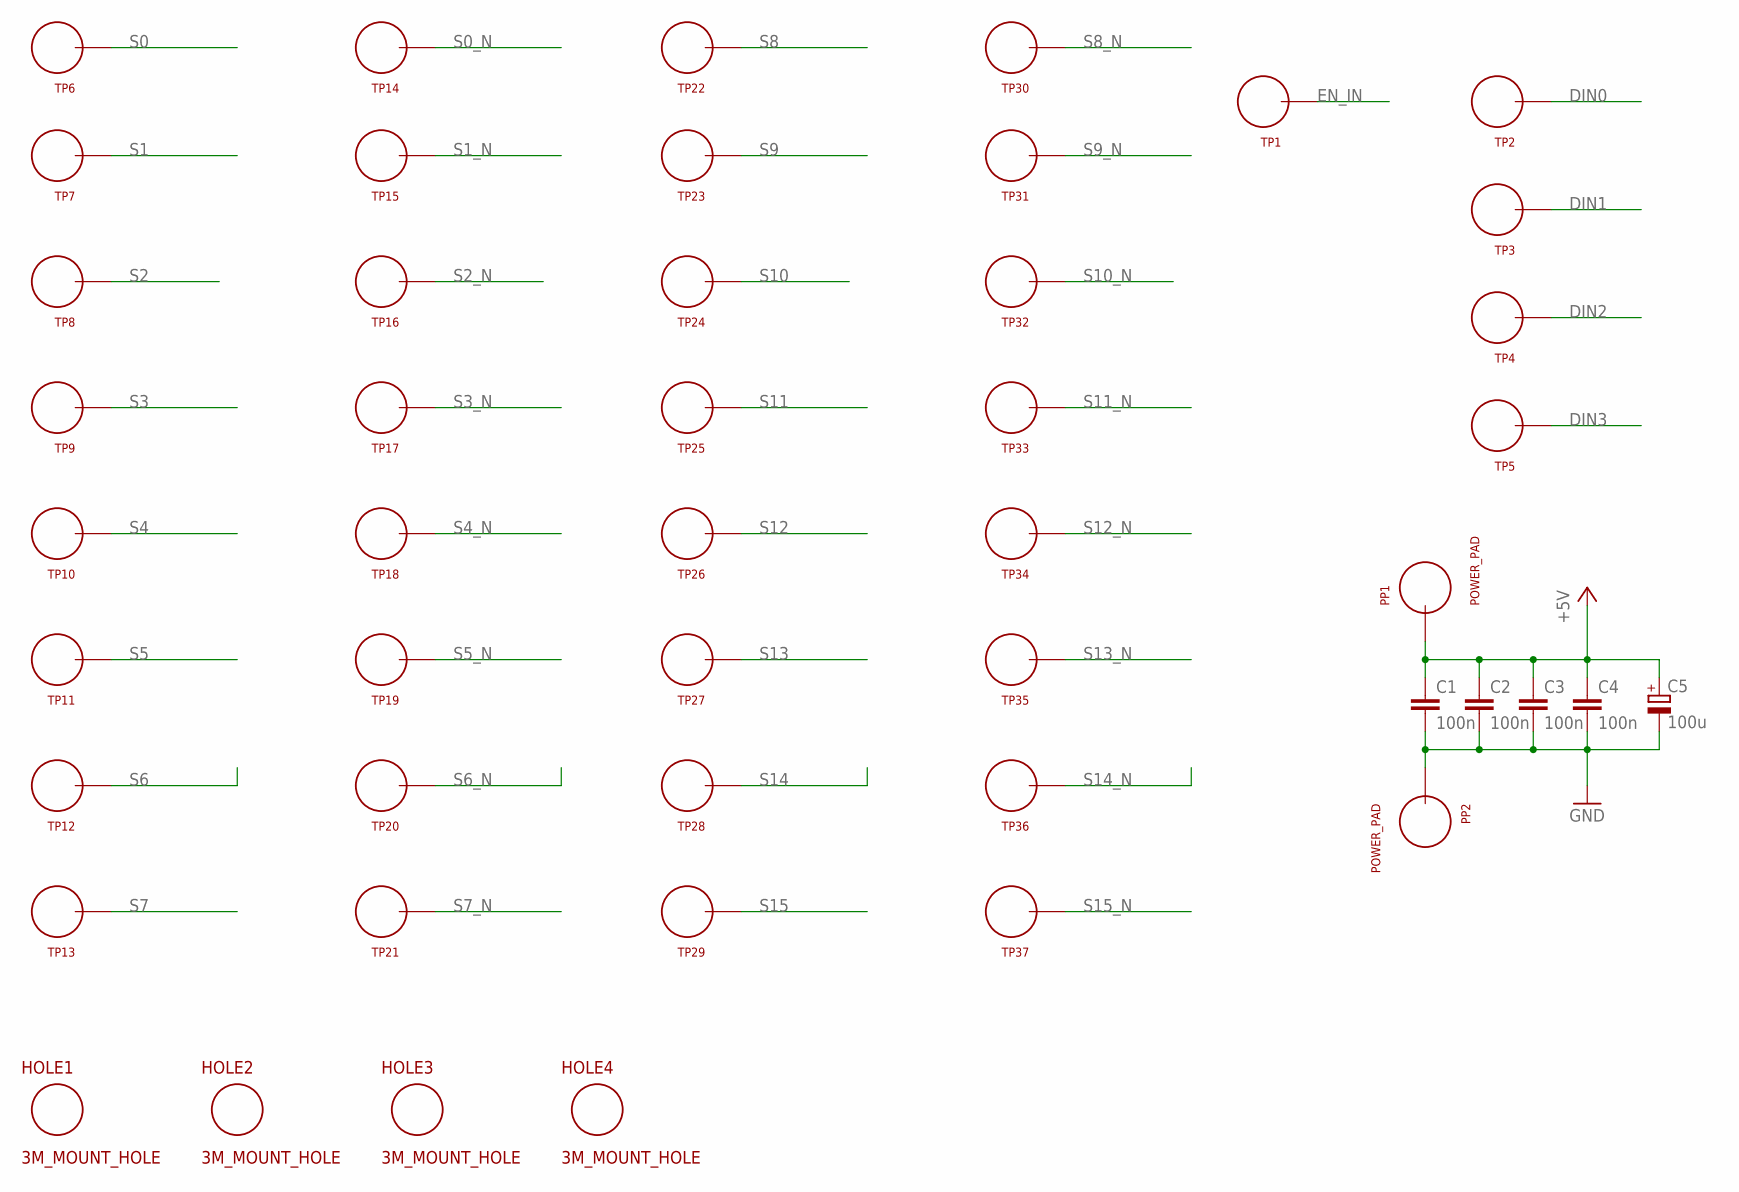
[picture p52: schematic Decoder16_1.sch, sheet 1]

Parts:
C1, C2, C3, C4: 100n; CAP_P2INCH
C5: 100u; POLARISED_CAP_2P5_6P3MM
HOLE1, HOLE2, HOLE3, HOLE4: 3M_MOUNT_HOLE; 3M_HOLE
PP1, PP2: POWER_PAD
TP1, TP2, TP3, TP4, TP5, TP6, TP7, TP8, TP9, TP10, TP11, TP12, TP13, TP14, TP15, TP16, TP17, TP18, TP19, TP20, TP21, TP22, TP23, TP24, TP25, TP26, TP27, TP28, TP29, TP30, TP31, TP32, TP33, TP34, TP35, TP36, TP37: TEST_LOOP

Connections:
+5V: C1.1, C2.1, C3.1, C4.1, C5.A, PP1.1; also elsewhere on the board
DIN0: TP2.P$1; also elsewhere on the board
DIN1: TP3.P$1; also elsewhere on the board
DIN2: TP4.P$1; also elsewhere on the board
DIN3: TP5.P$1; also elsewhere on the board
EN_IN: TP1.P$1; also elsewhere on the board
GND: C1.2, C2.2, C3.2, C4.2, C5.K, PP2.1; also elsewhere on the board
S0: TP6.P$1; also elsewhere on the board
S0_N: TP14.P$1; also elsewhere on the board
S1: TP7.P$1; also elsewhere on the board
S1_N: TP15.P$1; also elsewhere on the board
S2: TP8.P$1; also elsewhere on the board
S2_N: TP16.P$1; also elsewhere on the board
S3: TP9.P$1; also elsewhere on the board
S3_N: TP17.P$1; also elsewhere on the board
S4: TP10.P$1; also elsewhere on the board
S4_N: TP18.P$1; also elsewhere on the board
S5: TP11.P$1; also elsewhere on the board
S5_N: TP19.P$1; also elsewhere on the board
S6: TP12.P$1; also elsewhere on the board
S6_N: TP20.P$1; also elsewhere on the board
S7: TP13.P$1; also elsewhere on the board
S7_N: TP21.P$1; also elsewhere on the board
S8: TP22.P$1; also elsewhere on the board
S8_N: TP30.P$1; also elsewhere on the board
S9: TP23.P$1; also elsewhere on the board
S9_N: TP31.P$1; also elsewhere on the board
S10: TP24.P$1; also elsewhere on the board
S10_N: TP32.P$1; also elsewhere on the board
S11: TP25.P$1; also elsewhere on the board
S11_N: TP33.P$1; also elsewhere on the board
S12: TP26.P$1; also elsewhere on the board
S12_N: TP34.P$1; also elsewhere on the board
S13: TP27.P$1; also elsewhere on the board
S13_N: TP35.P$1; also elsewhere on the board
S14: TP28.P$1; also elsewhere on the board
S14_N: TP36.P$1; also elsewhere on the board
S15: TP29.P$1; also elsewhere on the board
S15_N: TP37.P$1; also elsewhere on the board

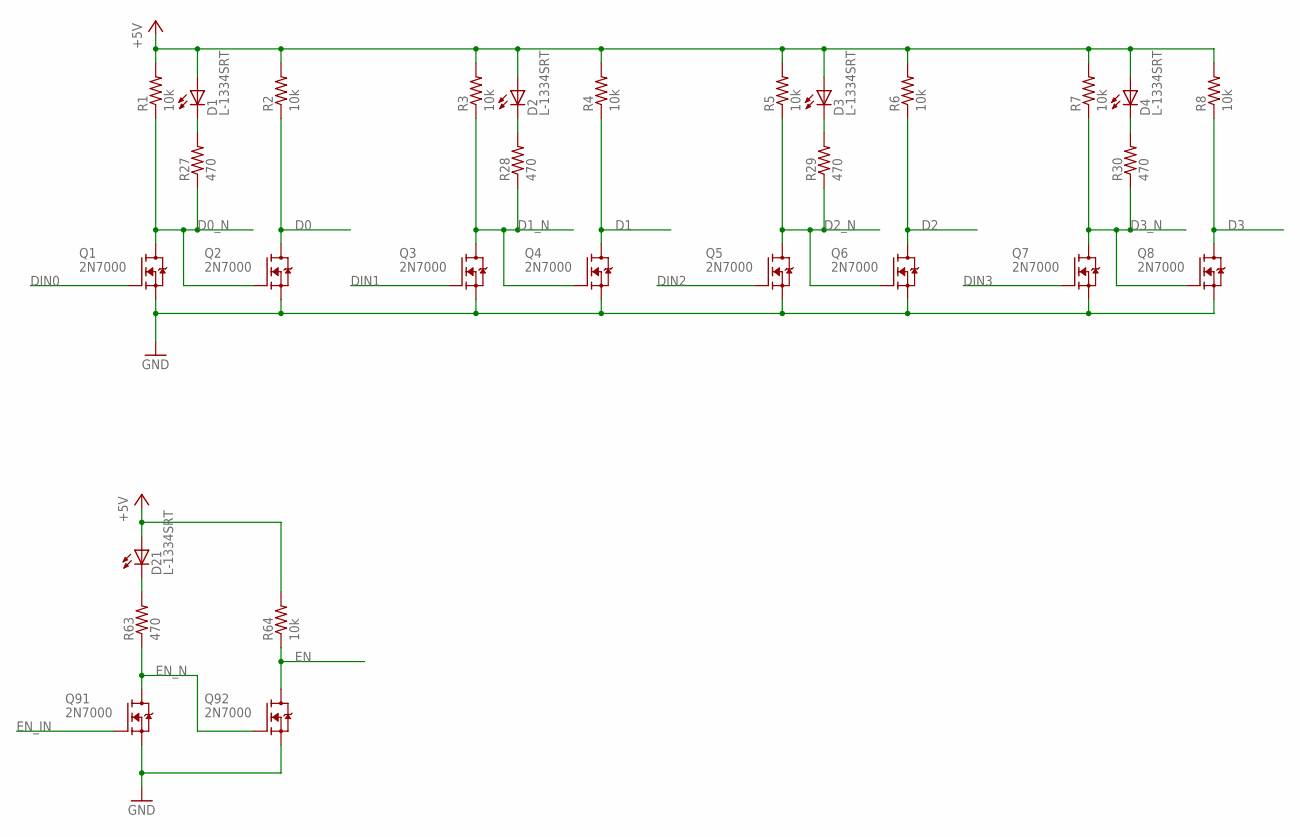
[picture p53: schematic Decoder16_1.sch, sheet 2]

Parts:
D1, D2, D3, D4, D21: L-1334SRT; LED3MM
Q1, Q2, Q3, Q4, Q5, Q6, Q7, Q8, Q91, Q92: 2N7000; TO92-DGS
R1, R2, R3, R4, R5, R6, R7, R8, R64: 10k; R_P2INCH
R27, R28, R29, R30, R63: 470; R_P2INCH

Connections:
+5V: D1.A, D2.A, D3.A, D4.A, D21.A, R1.2, R2.2, R3.2, R4.2, R5.2, R6.2, R7.2, R8.2, R64.2; also elsewhere on the board
D0: Q2.D, R2.1; also elsewhere on the board
D0_N: Q1.D, Q2.G, R1.1, R27.1; also elsewhere on the board
D1: Q4.D, R4.1; also elsewhere on the board
D1_N: Q3.D, Q4.G, R3.1, R28.1; also elsewhere on the board
D2: Q6.D, R6.1; also elsewhere on the board
D2_N: Q5.D, Q6.G, R5.1, R29.1; also elsewhere on the board
D3: Q8.D, R8.1; also elsewhere on the board
D3_N: Q7.D, Q8.G, R7.1, R30.1; also elsewhere on the board
DIN0: Q1.G; also elsewhere on the board
DIN1: Q3.G; also elsewhere on the board
DIN2: Q5.G; also elsewhere on the board
DIN3: Q7.G; also elsewhere on the board
EN: Q92.D, R64.1; also elsewhere on the board
EN_IN: Q91.G; also elsewhere on the board
EN_N: Q91.D, Q92.G, R63.1
GND: Q1.S, Q2.S, Q3.S, Q4.S, Q5.S, Q6.S, Q7.S, Q8.S, Q91.S, Q92.S; also elsewhere on the board
unnamed: D1.K (C), R27.2
unnamed: D2.K (C), R28.2
unnamed: D3.K (C), R29.2
unnamed: D4.K (C), R30.2
unnamed: D21.K (C), R63.2

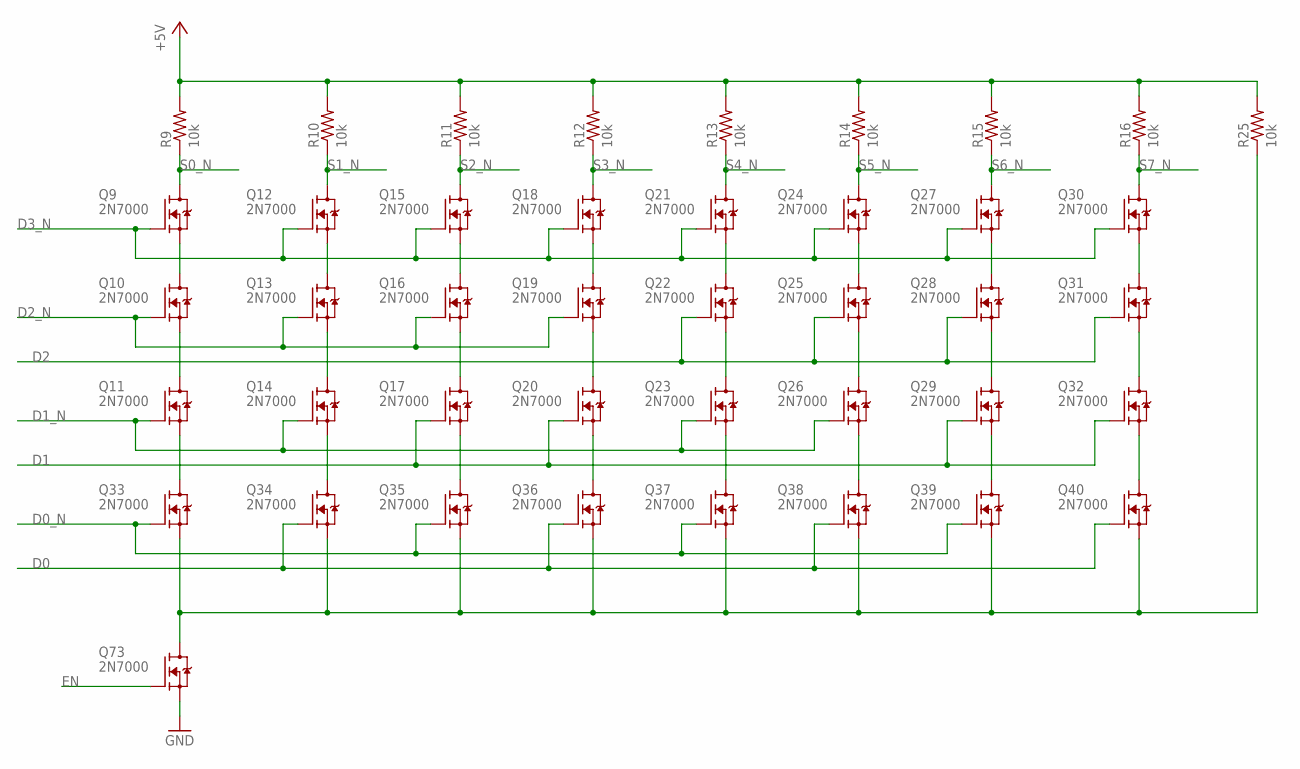
[picture p54: schematic Decoder16_1.sch, sheet 3]

Parts:
Q9, Q10, Q11, Q12, Q13, Q14, Q15, Q16, Q17, Q18, Q19, Q20, Q21, Q22, Q23, Q24, Q25, Q26, Q27, Q28, Q29, Q30, Q31, Q32, Q33, Q34, Q35, Q36, Q37, Q38, Q39, Q40, Q73: 2N7000; TO92-DGS
R9, R10, R11, R12, R13, R14, R15, R16, R25: 10k; R_P2INCH

Connections:
+5V: R9.2, R10.2, R11.2, R12.2, R13.2, R14.2, R15.2, R16.2, R25.2; also elsewhere on the board
D0: Q34.G, Q36.G, Q38.G, Q40.G; also elsewhere on the board
D0_N: Q33.G, Q35.G, Q37.G, Q39.G; also elsewhere on the board
D1: Q17.G, Q20.G, Q29.G, Q32.G; also elsewhere on the board
D1_N: Q11.G, Q14.G, Q23.G, Q26.G; also elsewhere on the board
D2: Q22.G, Q25.G, Q28.G, Q31.G; also elsewhere on the board
D2_N: Q10.G, Q13.G, Q16.G, Q19.G; also elsewhere on the board
D3_N: Q9.G, Q12.G, Q15.G, Q18.G, Q21.G, Q24.G, Q27.G, Q30.G; also elsewhere on the board
EN: Q73.G; also elsewhere on the board
GND: Q73.S; also elsewhere on the board
unnamed: Q9.S, Q10.D
unnamed: Q10.S, Q11.D
unnamed: Q12.S, Q13.D
unnamed: Q13.S, Q14.D
unnamed: Q15.S, Q16.D
unnamed: Q16.S, Q17.D
unnamed: Q18.S, Q19.D
unnamed: Q19.S, Q20.D
unnamed: Q21.S, Q22.D
unnamed: Q22.S, Q23.D
unnamed: Q24.S, Q25.D
unnamed: Q25.S, Q26.D
unnamed: Q27.S, Q28.D
unnamed: Q28.S, Q29.D
unnamed: Q30.S, Q31.D
unnamed: Q31.S, Q32.D
unnamed: Q11.S, Q33.D
unnamed: Q14.S, Q34.D
unnamed: Q17.S, Q35.D
unnamed: Q20.S, Q36.D
unnamed: Q23.S, Q37.D
unnamed: Q26.S, Q38.D
unnamed: Q29.S, Q39.D
unnamed: Q32.S, Q40.D
unnamed: Q33.S, Q34.S, Q35.S, Q36.S, Q37.S, Q38.S, Q39.S, Q40.S, Q73.D, R25.1
S0_N: Q9.D, R9.1; also elsewhere on the board
S1_N: Q12.D, R10.1; also elsewhere on the board
S2_N: Q15.D, R11.1; also elsewhere on the board
S3_N: Q18.D, R12.1; also elsewhere on the board
S4_N: Q21.D, R13.1; also elsewhere on the board
S5_N: Q24.D, R14.1; also elsewhere on the board
S6_N: Q27.D, R15.1; also elsewhere on the board
S7_N: Q30.D, R16.1; also elsewhere on the board

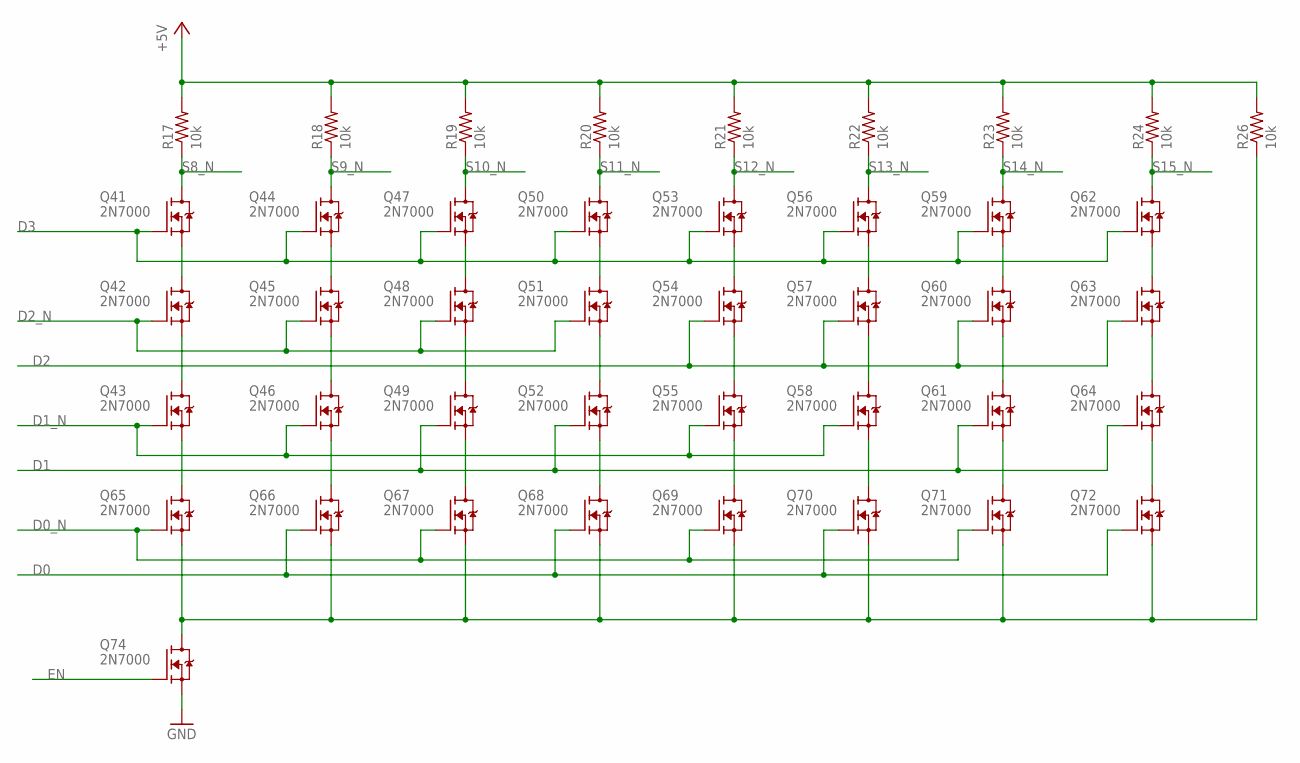
[picture p55: schematic Decoder16_1.sch, sheet 4]

Parts:
Q41, Q42, Q43, Q44, Q45, Q46, Q47, Q48, Q49, Q50, Q51, Q52, Q53, Q54, Q55, Q56, Q57, Q58, Q59, Q60, Q61, Q62, Q63, Q64, Q65, Q66, Q67, Q68, Q69, Q70, Q71, Q72, Q74: 2N7000; TO92-DGS
R17, R18, R19, R20, R21, R22, R23, R24, R26: 10k; R_P2INCH

Connections:
+5V: R17.2, R18.2, R19.2, R20.2, R21.2, R22.2, R23.2, R24.2, R26.2; also elsewhere on the board
D0: Q66.G, Q68.G, Q70.G, Q72.G; also elsewhere on the board
D0_N: Q65.G, Q67.G, Q69.G, Q71.G; also elsewhere on the board
D1: Q49.G, Q52.G, Q61.G, Q64.G; also elsewhere on the board
D1_N: Q43.G, Q46.G, Q55.G, Q58.G; also elsewhere on the board
D2: Q54.G, Q57.G, Q60.G, Q63.G; also elsewhere on the board
D2_N: Q42.G, Q45.G, Q48.G, Q51.G; also elsewhere on the board
D3: Q41.G, Q44.G, Q47.G, Q50.G, Q53.G, Q56.G, Q59.G, Q62.G; also elsewhere on the board
EN: Q74.G; also elsewhere on the board
GND: Q74.S; also elsewhere on the board
unnamed: Q41.S, Q42.D
unnamed: Q42.S, Q43.D
unnamed: Q44.S, Q45.D
unnamed: Q45.S, Q46.D
unnamed: Q47.S, Q48.D
unnamed: Q48.S, Q49.D
unnamed: Q50.S, Q51.D
unnamed: Q51.S, Q52.D
unnamed: Q53.S, Q54.D
unnamed: Q54.S, Q55.D
unnamed: Q56.S, Q57.D
unnamed: Q57.S, Q58.D
unnamed: Q59.S, Q60.D
unnamed: Q60.S, Q61.D
unnamed: Q62.S, Q63.D
unnamed: Q63.S, Q64.D
unnamed: Q43.S, Q65.D
unnamed: Q46.S, Q66.D
unnamed: Q49.S, Q67.D
unnamed: Q52.S, Q68.D
unnamed: Q55.S, Q69.D
unnamed: Q58.S, Q70.D
unnamed: Q61.S, Q71.D
unnamed: Q64.S, Q72.D
unnamed: Q65.S, Q66.S, Q67.S, Q68.S, Q69.S, Q70.S, Q71.S, Q72.S, Q74.D, R26.1
S8_N: Q41.D, R17.1; also elsewhere on the board
S9_N: Q44.D, R18.1; also elsewhere on the board
S10_N: Q47.D, R19.1; also elsewhere on the board
S11_N: Q50.D, R20.1; also elsewhere on the board
S12_N: Q53.D, R21.1; also elsewhere on the board
S13_N: Q56.D, R22.1; also elsewhere on the board
S14_N: Q59.D, R23.1; also elsewhere on the board
S15_N: Q62.D, R24.1; also elsewhere on the board

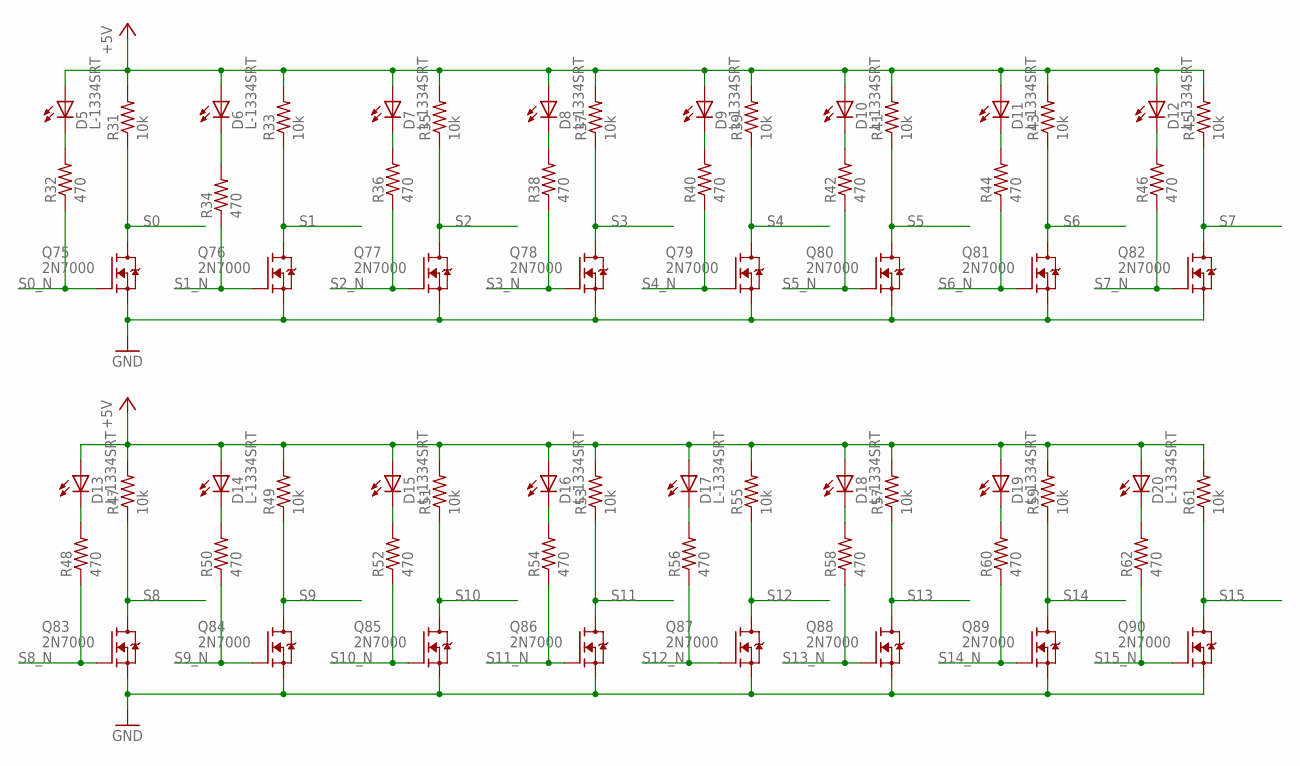
[picture p56: schematic Decoder16_1.sch, sheet 5]

Parts:
D5, D6, D7, D8, D9, D10, D11, D12, D13, D14, D15, D16, D17, D18, D19, D20: L-1334SRT; LED3MM
Q75, Q76, Q77, Q78, Q79, Q80, Q81, Q82, Q83, Q84, Q85, Q86, Q87, Q88, Q89, Q90: 2N7000; TO92-DGS
R31, R33, R35, R37, R39, R41, R43, R45, R47, R49, R51, R53, R55, R57, R59, R61: 10k; R_P2INCH
R32, R34, R36, R38, R40, R42, R44, R46, R48, R50, R52, R54, R56, R58, R60, R62: 470; R_P2INCH

Connections:
+5V: D5.A, D6.A, D7.A, D8.A, D9.A, D10.A, D11.A, D12.A, D13.A, D14.A, D15.A, D16.A, D17.A, D18.A, D19.A, D20.A, R31.2, R33.2, R35.2, R37.2, R39.2, R41.2, R43.2, R45.2, R47.2, R49.2, R51.2, R53.2, R55.2, R57.2, R59.2, R61.2; also elsewhere on the board
GND: Q75.S, Q76.S, Q77.S, Q78.S, Q79.S, Q80.S, Q81.S, Q82.S, Q83.S, Q84.S, Q85.S, Q86.S, Q87.S, Q88.S, Q89.S, Q90.S; also elsewhere on the board
unnamed: D5.K (C), R32.2
unnamed: D13.K (C), R48.2
unnamed: D6.K (C), R34.2
unnamed: D14.K (C), R50.2
unnamed: D7.K (C), R36.2
unnamed: D15.K (C), R52.2
unnamed: D8.K (C), R38.2
unnamed: D16.K (C), R54.2
unnamed: D9.K (C), R40.2
unnamed: D17.K (C), R56.2
unnamed: D10.K (C), R42.2
unnamed: D18.K (C), R58.2
unnamed: D11.K (C), R44.2
unnamed: D19.K (C), R60.2
unnamed: D12.K (C), R46.2
unnamed: D20.K (C), R62.2
S0: Q75.D, R31.1; also elsewhere on the board
S0_N: Q75.G, R32.1; also elsewhere on the board
S1: Q76.D, R33.1; also elsewhere on the board
S1_N: Q76.G, R34.1; also elsewhere on the board
S2: Q77.D, R35.1; also elsewhere on the board
S2_N: Q77.G, R36.1; also elsewhere on the board
S3: Q78.D, R37.1; also elsewhere on the board
S3_N: Q78.G, R38.1; also elsewhere on the board
S4: Q79.D, R39.1; also elsewhere on the board
S4_N: Q79.G, R40.1; also elsewhere on the board
S5: Q80.D, R41.1; also elsewhere on the board
S5_N: Q80.G, R42.1; also elsewhere on the board
S6: Q81.D, R43.1; also elsewhere on the board
S6_N: Q81.G, R44.1; also elsewhere on the board
S7: Q82.D, R45.1; also elsewhere on the board
S7_N: Q82.G, R46.1; also elsewhere on the board
S8: Q83.D, R47.1; also elsewhere on the board
S8_N: Q83.G, R48.1; also elsewhere on the board
S9: Q84.D, R49.1; also elsewhere on the board
S9_N: Q84.G, R50.1; also elsewhere on the board
S10: Q85.D, R51.1; also elsewhere on the board
S10_N: Q85.G, R52.1; also elsewhere on the board
S11: Q86.D, R53.1; also elsewhere on the board
S11_N: Q86.G, R54.1; also elsewhere on the board
S12: Q87.D, R55.1; also elsewhere on the board
S12_N: Q87.G, R56.1; also elsewhere on the board
S13: Q88.D, R57.1; also elsewhere on the board
S13_N: Q88.G, R58.1; also elsewhere on the board
S14: Q89.D, R59.1; also elsewhere on the board
S14_N: Q89.G, R60.1; also elsewhere on the board
S15: Q90.D, R61.1; also elsewhere on the board
S15_N: Q90.G, R62.1; also elsewhere on the board

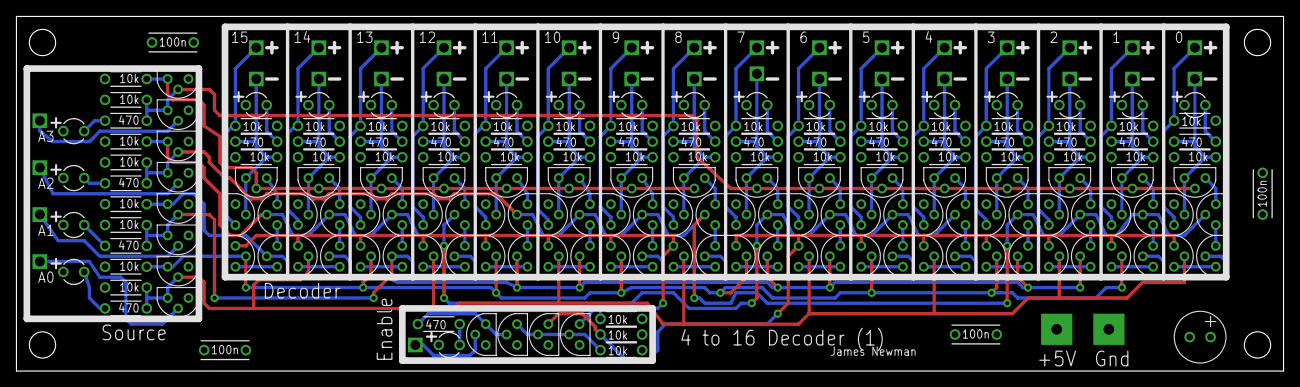
[picture p57: board Decoder16_1.brd from above]

Board: 4 copper layers, 154.3 x 43.2 mm, 225 parts (0 on the bottom side), 120 nets.
