ericherman/megaprocessor/mem_mux_4w/MEM_MUX_3.brd

## EAGLE design mem_mux_4w/MEM_MUX_3.brd (2017-05-20)

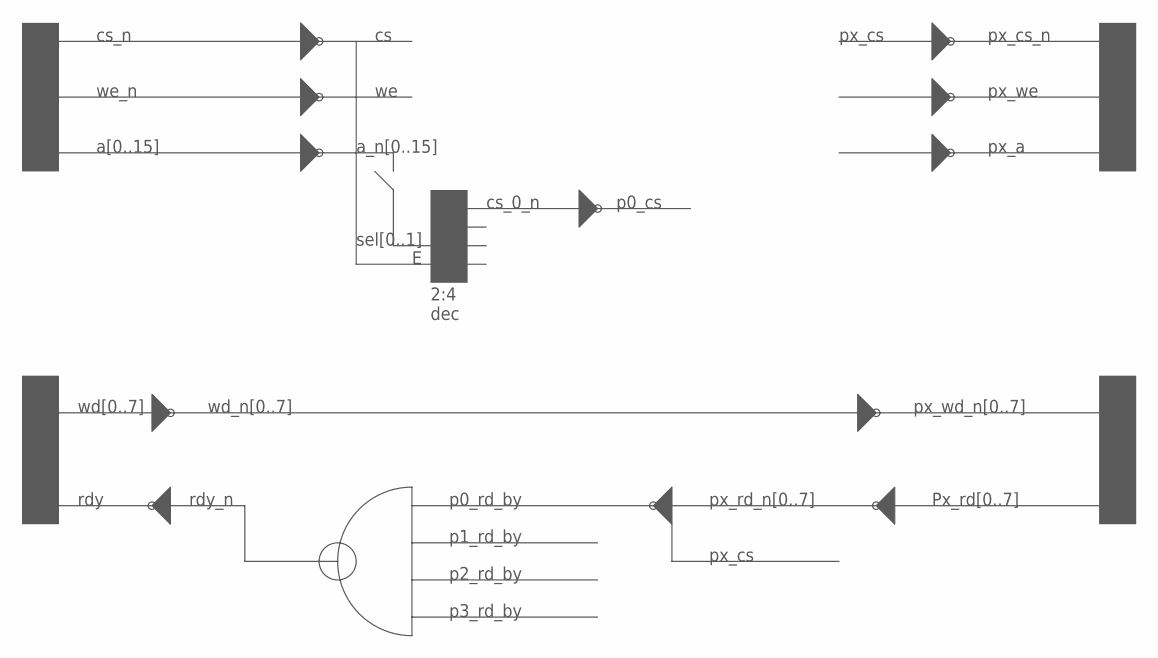
[picture p58: schematic MEM_MUX_3.sch, sheet 1]

Notes on the sheet:
cs_n
we_n
a[0..15]
a_n[0..15]
2:4 dec
cs_0_n
p0_cs
sel[0..1]
px_a
px_we
px_cs
px_cs_n
wd[0..7]
wd_n[0..7]
px_wd_n[0..7]
Px_rd[0..7]
px_rd_n[0..7]
p0_rd_by
p1_rd_by
p2_rd_by
p3_rd_by
rdy_n
rdy

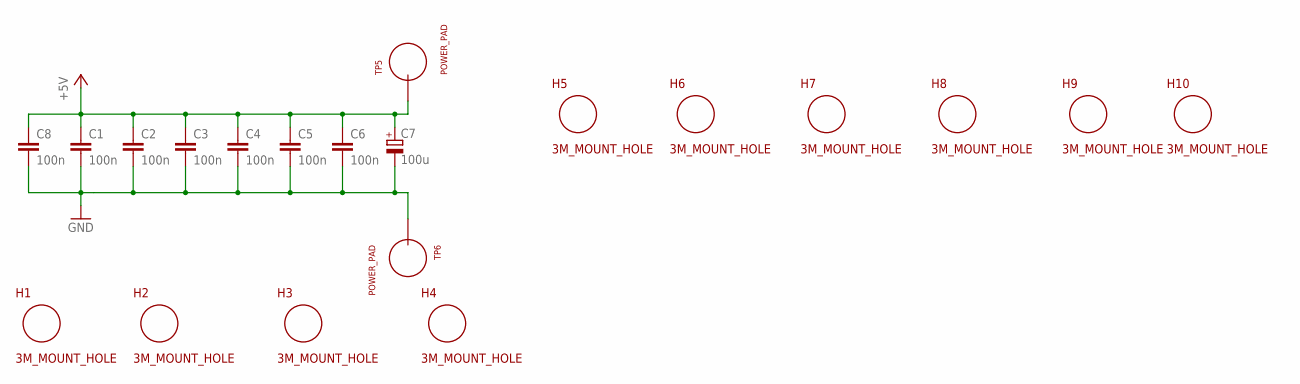
[picture p59: schematic MEM_MUX_3.sch, sheet 2]

Parts:
C1, C2, C3, C4, C5, C6, C8: 100n; CAP_P2INCH
C7: 100u; POLARISED_CAP_2P5_6P3MM
H1, H2, H3, H4, H5, H6, H7, H8, H9, H10: 3M_MOUNT_HOLE; 3M_HOLE
TP5, TP6: POWER_PAD

Connections:
+5V: C1.1, C2.1, C3.1, C4.1, C5.1, C6.1, C7.A, C8.1, TP5.1; also elsewhere on the board
GND: C1.2, C2.2, C3.2, C4.2, C5.2, C6.2, C7.K, C8.2, TP6.1; also elsewhere on the board

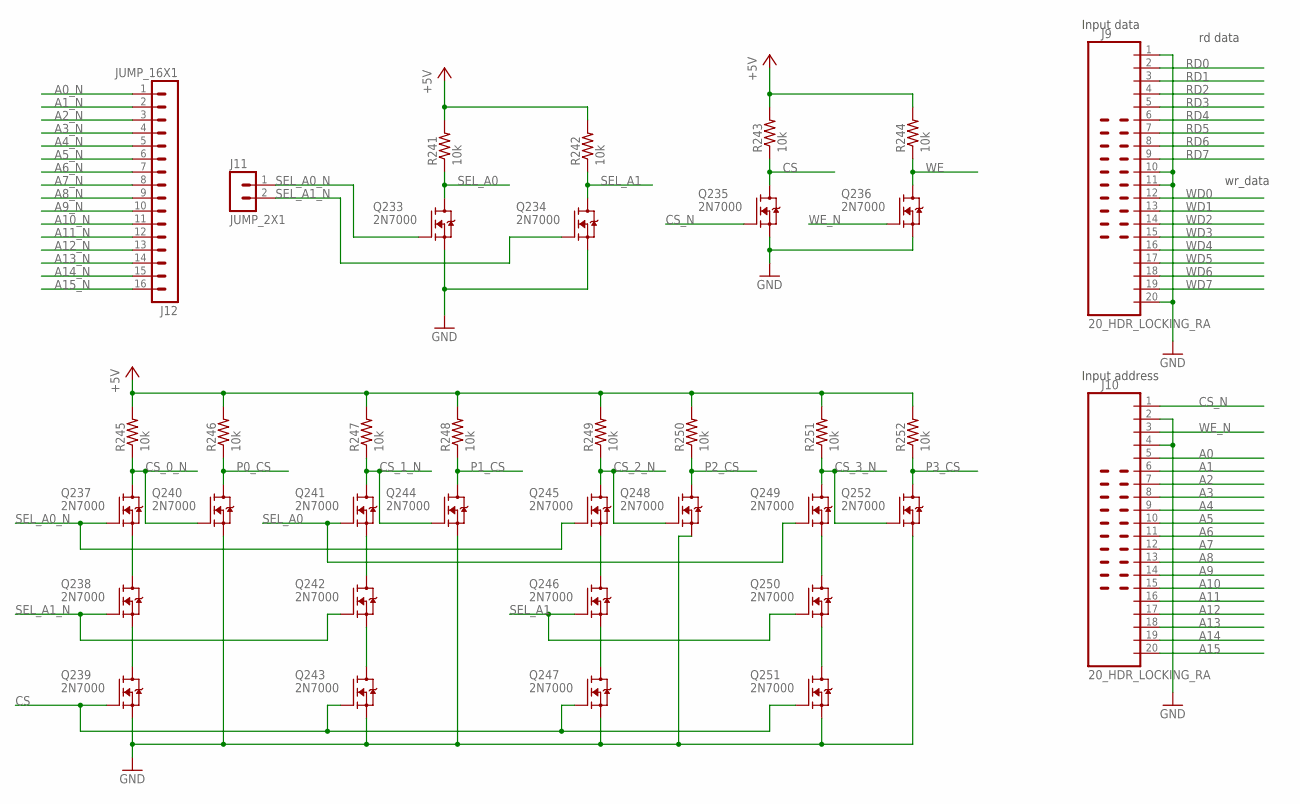
[picture p60: schematic MEM_MUX_3.sch, sheet 3]

Parts:
J9, J10: 20_HDR_LOCKING_RA
J11: JUMP_2X1
J12: JUMP_16X1
Q233, Q234, Q235, Q236, Q237, Q238, Q239, Q240, Q241, Q242, Q243, Q244, Q245, Q246, Q247, Q248, Q249, Q250, Q251, Q252: 2N7000; TO92-DGS
R241, R242, R243, R244, R245, R246, R247, R248, R249, R250, R251, R252: 10k; R_P2INCH

Connections:
+5V: R241.2, R242.2, R243.2, R244.2, R245.2, R246.2, R247.2, R248.2, R249.2, R250.2, R251.2, R252.2; also elsewhere on the board
A0: J10.5; also elsewhere on the board
A0_N: J12.1; also elsewhere on the board
A1: J10.6; also elsewhere on the board
A1_N: J12.2; also elsewhere on the board
A2: J10.7; also elsewhere on the board
A2_N: J12.3; also elsewhere on the board
A3: J10.8; also elsewhere on the board
A3_N: J12.4; also elsewhere on the board
A4: J10.9; also elsewhere on the board
A4_N: J12.5; also elsewhere on the board
A5: J10.10; also elsewhere on the board
A5_N: J12.6; also elsewhere on the board
A6: J10.11; also elsewhere on the board
A6_N: J12.7; also elsewhere on the board
A7: J10.12; also elsewhere on the board
A7_N: J12.8; also elsewhere on the board
A8: J10.13; also elsewhere on the board
A8_N: J12.9; also elsewhere on the board
A9: J10.14; also elsewhere on the board
A9_N: J12.10; also elsewhere on the board
A10: J10.15; also elsewhere on the board
A10_N: J12.11; also elsewhere on the board
A11: J10.16; also elsewhere on the board
A11_N: J12.12; also elsewhere on the board
A12: J10.17; also elsewhere on the board
A12_N: J12.13; also elsewhere on the board
A13: J10.18; also elsewhere on the board
A13_N: J12.14; also elsewhere on the board
A14: J10.19; also elsewhere on the board
A14_N: J12.15; also elsewhere on the board
A15: J10.20; also elsewhere on the board
A15_N: J12.16; also elsewhere on the board
CS: Q235.D, Q239.G, Q243.G, Q247.G, Q251.G, R243.1
CS_0_N: Q237.D, Q240.G, R245.1; also elsewhere on the board
CS_1_N: Q241.D, Q244.G, R247.1; also elsewhere on the board
CS_2_N: Q245.D, Q248.G, R249.1; also elsewhere on the board
CS_3_N: Q249.D, Q252.G, R251.1; also elsewhere on the board
CS_N: J10.1, Q235.G
GND: J9.1, J9.10, J9.11, J9.20, J10.2, J10.4, Q233.S, Q234.S, Q235.S, Q236.S, Q239.S, Q240.S, Q243.S, Q244.S, Q247.S, Q248.S, Q251.S, Q252.S; also elsewhere on the board
unnamed: Q241.S, Q242.D
unnamed: Q237.S, Q238.D
unnamed: Q238.S, Q239.D
unnamed: Q242.S, Q243.D
unnamed: Q245.S, Q246.D
unnamed: Q246.S, Q247.D
unnamed: Q249.S, Q250.D
unnamed: Q250.S, Q251.D
P0_CS: Q240.D, R246.1; also elsewhere on the board
P1_CS: Q244.D, R248.1; also elsewhere on the board
P2_CS: Q248.D, R250.1; also elsewhere on the board
P3_CS: Q252.D, R252.1; also elsewhere on the board
RD0: J9.2; also elsewhere on the board
RD1: J9.3; also elsewhere on the board
RD2: J9.4; also elsewhere on the board
RD3: J9.5; also elsewhere on the board
RD4: J9.6; also elsewhere on the board
RD5: J9.7; also elsewhere on the board
RD6: J9.8; also elsewhere on the board
RD7: J9.9; also elsewhere on the board
SEL_A0: Q233.D, Q241.G, Q249.G, R241.1
SEL_A0_N: J11.1, Q233.G, Q237.G, Q245.G
SEL_A1: Q234.D, Q246.G, Q250.G, R242.1
SEL_A1_N: J11.2, Q234.G, Q238.G, Q242.G
WD0: J9.12; also elsewhere on the board
WD1: J9.13; also elsewhere on the board
WD2: J9.14; also elsewhere on the board
WD3: J9.15; also elsewhere on the board
WD4: J9.16; also elsewhere on the board
WD5: J9.17; also elsewhere on the board
WD6: J9.18; also elsewhere on the board
WD7: J9.19; also elsewhere on the board
WE: Q236.D, R244.1; also elsewhere on the board
WE_N: J10.3, Q236.G

Notes on the sheet:
Input data
Input address
rd data
wr_data
