ericherman/megaprocessor/mem_mux_4w/MEM_MUX_3.brd

## EAGLE design mem_mux_4w/MEM_MUX_3.brd (continued)

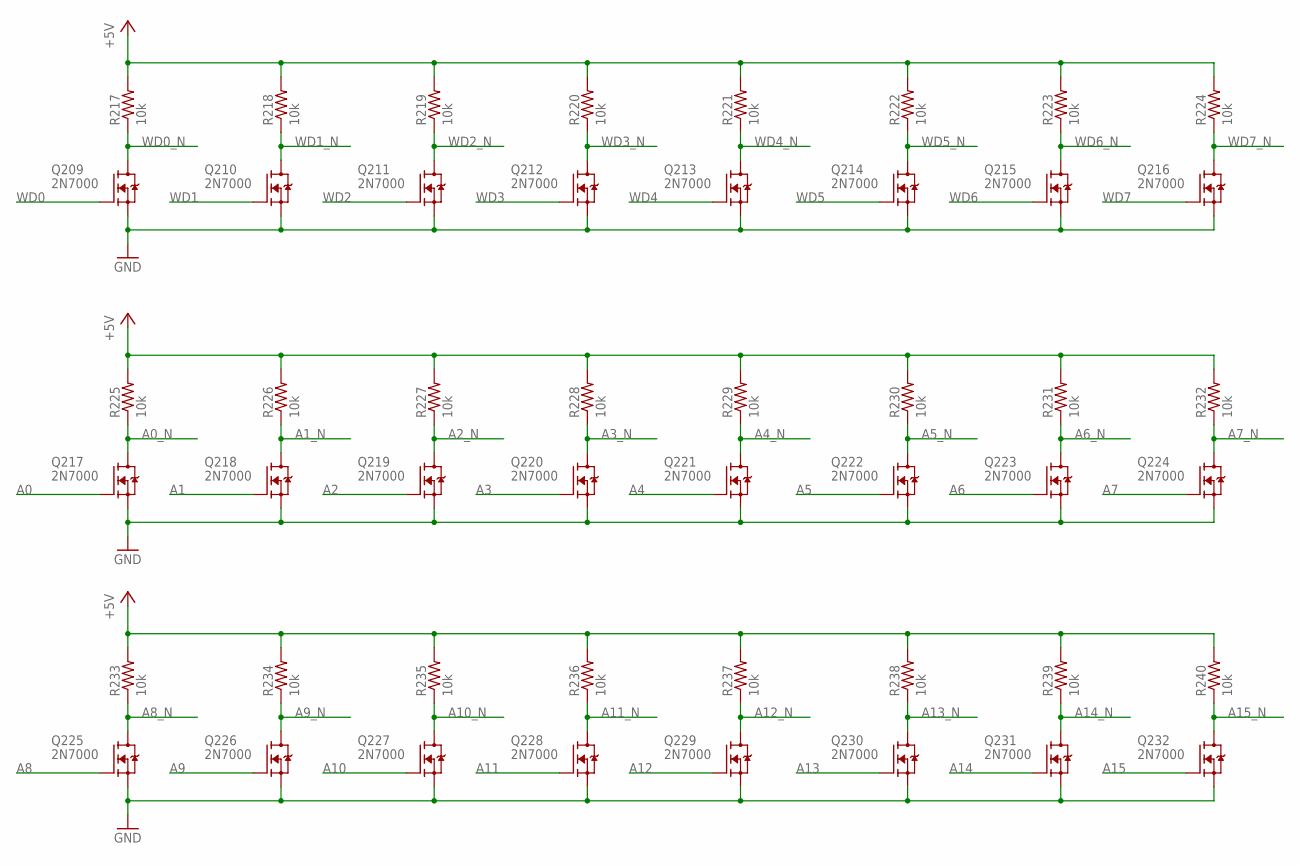
[picture p61: schematic MEM_MUX_3.sch, sheet 4]

Parts:
Q209, Q210, Q211, Q212, Q213, Q214, Q215, Q216, Q217, Q218, Q219, Q220, Q221, Q222, Q223, Q224, Q225, Q226, Q227, Q228, Q229, Q230, Q231, Q232: 2N7000; TO92-DGS
R217, R218, R219, R220, R221, R222, R223, R224, R225, R226, R227, R228, R229, R230, R231, R232, R233, R234, R235, R236, R237, R238, R239, R240: 10k; R_P2INCH

Connections:
+5V: R217.2, R218.2, R219.2, R220.2, R221.2, R222.2, R223.2, R224.2, R225.2, R226.2, R227.2, R228.2, R229.2, R230.2, R231.2, R232.2, R233.2, R234.2, R235.2, R236.2, R237.2, R238.2, R239.2, R240.2; also elsewhere on the board
A0: Q217.G; also elsewhere on the board
A0_N: Q217.D, R225.1; also elsewhere on the board
A1: Q218.G; also elsewhere on the board
A1_N: Q218.D, R226.1; also elsewhere on the board
A2: Q219.G; also elsewhere on the board
A2_N: Q219.D, R227.1; also elsewhere on the board
A3: Q220.G; also elsewhere on the board
A3_N: Q220.D, R228.1; also elsewhere on the board
A4: Q221.G; also elsewhere on the board
A4_N: Q221.D, R229.1; also elsewhere on the board
A5: Q222.G; also elsewhere on the board
A5_N: Q222.D, R230.1; also elsewhere on the board
A6: Q223.G; also elsewhere on the board
A6_N: Q223.D, R231.1; also elsewhere on the board
A7: Q224.G; also elsewhere on the board
A7_N: Q224.D, R232.1; also elsewhere on the board
A8: Q225.G; also elsewhere on the board
A8_N: Q225.D, R233.1; also elsewhere on the board
A9: Q226.G; also elsewhere on the board
A9_N: Q226.D, R234.1; also elsewhere on the board
A10: Q227.G; also elsewhere on the board
A10_N: Q227.D, R235.1; also elsewhere on the board
A11: Q228.G; also elsewhere on the board
A11_N: Q228.D, R236.1; also elsewhere on the board
A12: Q229.G; also elsewhere on the board
A12_N: Q229.D, R237.1; also elsewhere on the board
A13: Q230.G; also elsewhere on the board
A13_N: Q230.D, R238.1; also elsewhere on the board
A14: Q231.G; also elsewhere on the board
A14_N: Q231.D, R239.1; also elsewhere on the board
A15: Q232.G; also elsewhere on the board
A15_N: Q232.D, R240.1; also elsewhere on the board
GND: Q209.S, Q210.S, Q211.S, Q212.S, Q213.S, Q214.S, Q215.S, Q216.S, Q217.S, Q218.S, Q219.S, Q220.S, Q221.S, Q222.S, Q223.S, Q224.S, Q225.S, Q226.S, Q227.S, Q228.S, Q229.S, Q230.S, Q231.S, Q232.S; also elsewhere on the board
WD0: Q209.G; also elsewhere on the board
WD0_N: Q209.D, R217.1; also elsewhere on the board
WD1: Q210.G; also elsewhere on the board
WD1_N: Q210.D, R218.1; also elsewhere on the board
WD2: Q211.G; also elsewhere on the board
WD2_N: Q211.D, R219.1; also elsewhere on the board
WD3: Q212.G; also elsewhere on the board
WD3_N: Q212.D, R220.1; also elsewhere on the board
WD4: Q213.G; also elsewhere on the board
WD4_N: Q213.D, R221.1; also elsewhere on the board
WD5: Q214.G; also elsewhere on the board
WD5_N: Q214.D, R222.1; also elsewhere on the board
WD6: Q215.G; also elsewhere on the board
WD6_N: Q215.D, R223.1; also elsewhere on the board
WD7: Q216.G; also elsewhere on the board
WD7_N: Q216.D, R224.1; also elsewhere on the board

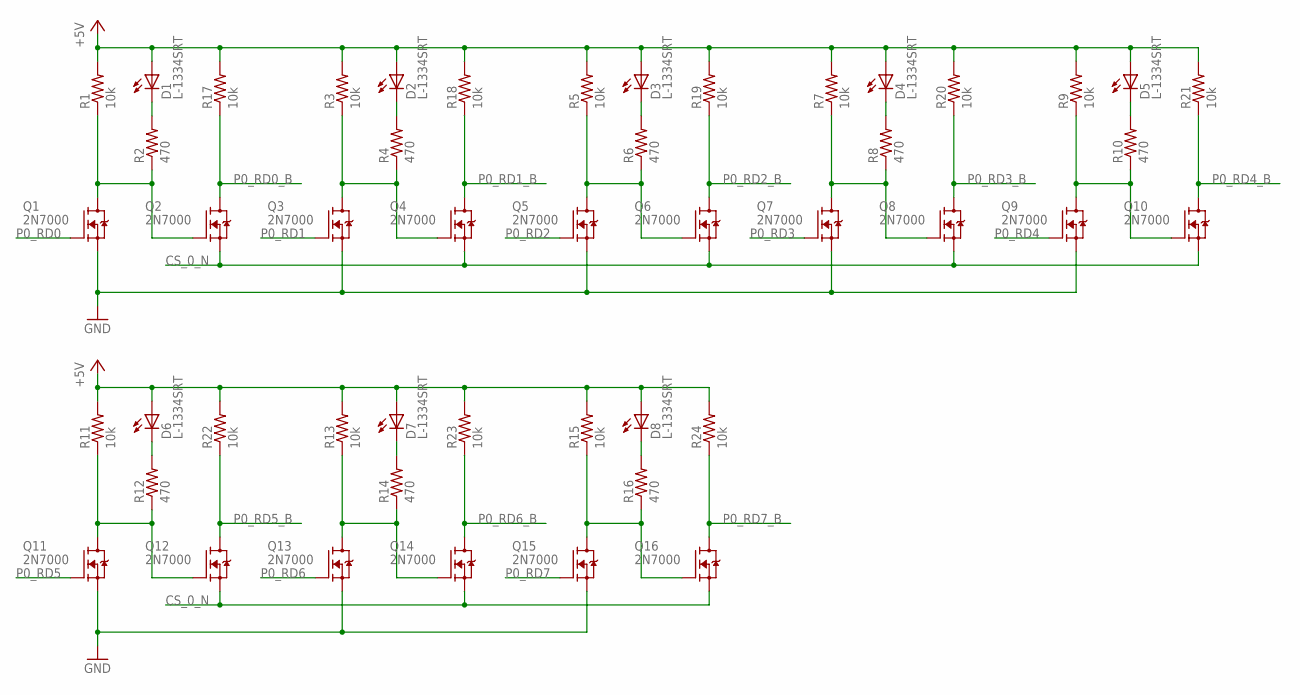
[picture p62: schematic MEM_MUX_3.sch, sheet 5]

Parts:
D1, D2, D3, D4, D5, D6, D7, D8: L-1334SRT; LED3MM
Q1, Q2, Q3, Q4, Q5, Q6, Q7, Q8, Q9, Q10, Q11, Q12, Q13, Q14, Q15, Q16: 2N7000; TO92-DGS
R1, R3, R5, R7, R9, R11, R13, R15, R17, R18, R19, R20, R21, R22, R23, R24: 10k; R_P2INCH
R2, R4, R6, R8, R10, R12, R14, R16: 470; R_P2INCH

Connections:
+5V: D1.A, D2.A, D3.A, D4.A, D5.A, D6.A, D7.A, D8.A, R1.2, R3.2, R5.2, R7.2, R9.2, R11.2, R13.2, R15.2, R17.2, R18.2, R19.2, R20.2, R21.2, R22.2, R23.2, R24.2; also elsewhere on the board
CS_0_N: Q2.S, Q4.S, Q6.S, Q8.S, Q10.S, Q12.S, Q14.S, Q16.S; also elsewhere on the board
GND: Q1.S, Q3.S, Q5.S, Q7.S, Q9.S, Q11.S, Q13.S, Q15.S; also elsewhere on the board
unnamed: Q3.D, Q4.G, R3.1, R4.1
unnamed: Q1.D, Q2.G, R1.1, R2.1
unnamed: D1.K (C), R2.2
unnamed: D2.K (C), R4.2
unnamed: Q5.D, Q6.G, R5.1, R6.1
unnamed: D3.K (C), R6.2
unnamed: Q7.D, Q8.G, R7.1, R8.1
unnamed: D4.K (C), R8.2
unnamed: Q9.D, Q10.G, R9.1, R10.1
unnamed: D5.K (C), R10.2
unnamed: Q11.D, Q12.G, R11.1, R12.1
unnamed: D6.K (C), R12.2
unnamed: Q13.D, Q14.G, R13.1, R14.1
unnamed: D7.K (C), R14.2
unnamed: Q15.D, Q16.G, R15.1, R16.1
unnamed: D8.K (C), R16.2
P0_RD0: Q1.G; also elsewhere on the board
P0_RD0_B: Q2.D, R17.1; also elsewhere on the board
P0_RD1: Q3.G; also elsewhere on the board
P0_RD1_B: Q4.D, R18.1; also elsewhere on the board
P0_RD2: Q5.G; also elsewhere on the board
P0_RD2_B: Q6.D, R19.1; also elsewhere on the board
P0_RD3: Q7.G; also elsewhere on the board
P0_RD3_B: Q8.D, R20.1; also elsewhere on the board
P0_RD4: Q9.G; also elsewhere on the board
P0_RD4_B: Q10.D, R21.1; also elsewhere on the board
P0_RD5: Q11.G; also elsewhere on the board
P0_RD5_B: Q12.D, R22.1; also elsewhere on the board
P0_RD6: Q13.G; also elsewhere on the board
P0_RD6_B: Q14.D, R23.1; also elsewhere on the board
P0_RD7: Q15.G; also elsewhere on the board
P0_RD7_B: Q16.D, R24.1; also elsewhere on the board

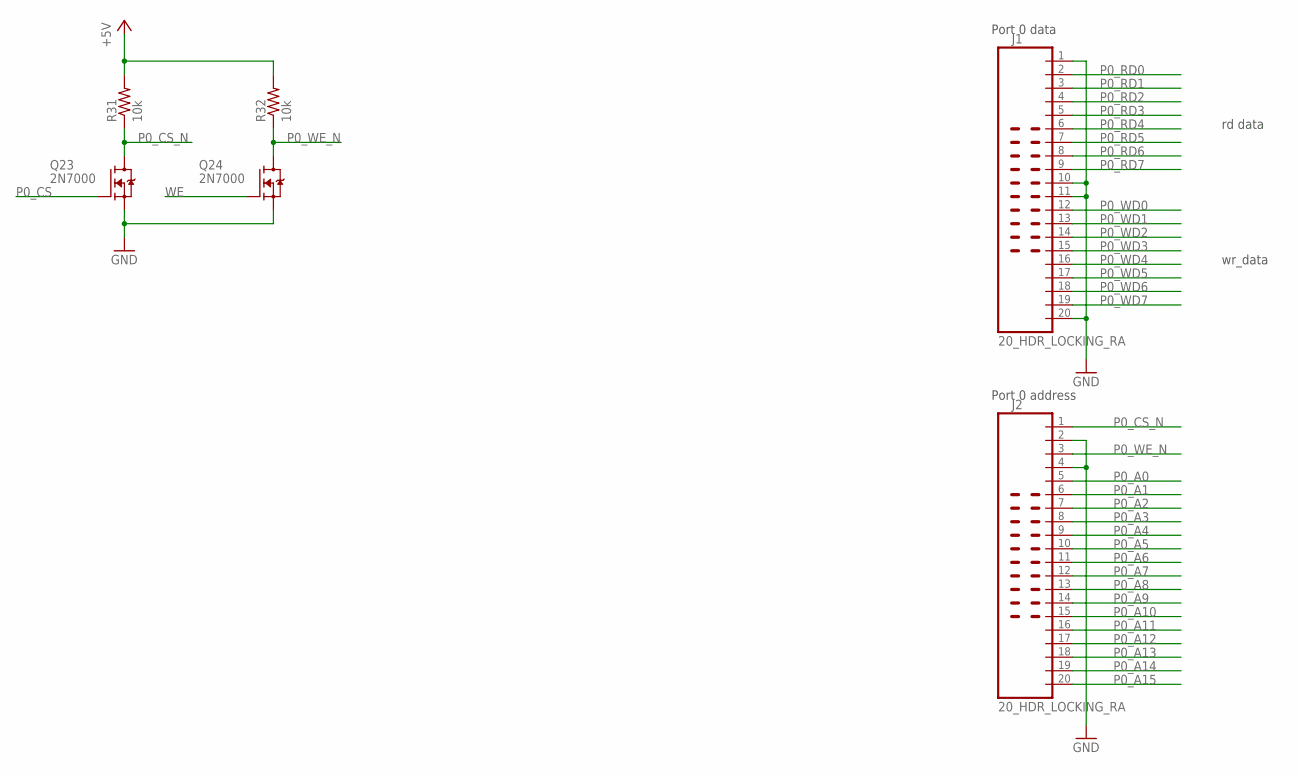
[picture p63: schematic MEM_MUX_3.sch, sheet 6]

Parts:
J1, J2: 20_HDR_LOCKING_RA
Q23, Q24: 2N7000; TO92-DGS
R31, R32: 10k; R_P2INCH

Connections:
+5V: R31.2, R32.2; also elsewhere on the board
GND: J1.1, J1.10, J1.11, J1.20, J2.2, J2.4, Q23.S, Q24.S; also elsewhere on the board
P0_A0: J2.5; also elsewhere on the board
P0_A1: J2.6; also elsewhere on the board
P0_A2: J2.7; also elsewhere on the board
P0_A3: J2.8; also elsewhere on the board
P0_A4: J2.9; also elsewhere on the board
P0_A5: J2.10; also elsewhere on the board
P0_A6: J2.11; also elsewhere on the board
P0_A7: J2.12; also elsewhere on the board
P0_A8: J2.13; also elsewhere on the board
P0_A9: J2.14; also elsewhere on the board
P0_A10: J2.15; also elsewhere on the board
P0_A11: J2.16; also elsewhere on the board
P0_A12: J2.17; also elsewhere on the board
P0_A13: J2.18; also elsewhere on the board
P0_A14: J2.19; also elsewhere on the board
P0_A15: J2.20; also elsewhere on the board
P0_CS: Q23.G; also elsewhere on the board
P0_CS_N: J2.1, Q23.D, R31.1
P0_RD0: J1.2; also elsewhere on the board
P0_RD1: J1.3; also elsewhere on the board
P0_RD2: J1.4; also elsewhere on the board
P0_RD3: J1.5; also elsewhere on the board
P0_RD4: J1.6; also elsewhere on the board
P0_RD5: J1.7; also elsewhere on the board
P0_RD6: J1.8; also elsewhere on the board
P0_RD7: J1.9; also elsewhere on the board
P0_WD0: J1.12; also elsewhere on the board
P0_WD1: J1.13; also elsewhere on the board
P0_WD2: J1.14; also elsewhere on the board
P0_WD3: J1.15; also elsewhere on the board
P0_WD4: J1.16; also elsewhere on the board
P0_WD5: J1.17; also elsewhere on the board
P0_WD6: J1.18; also elsewhere on the board
P0_WD7: J1.19; also elsewhere on the board
P0_WE_N: J2.3, Q24.D, R32.1
WE: Q24.G; also elsewhere on the board

Notes on the sheet:
Port 0 data
Port 0 address
rd data
wr_data

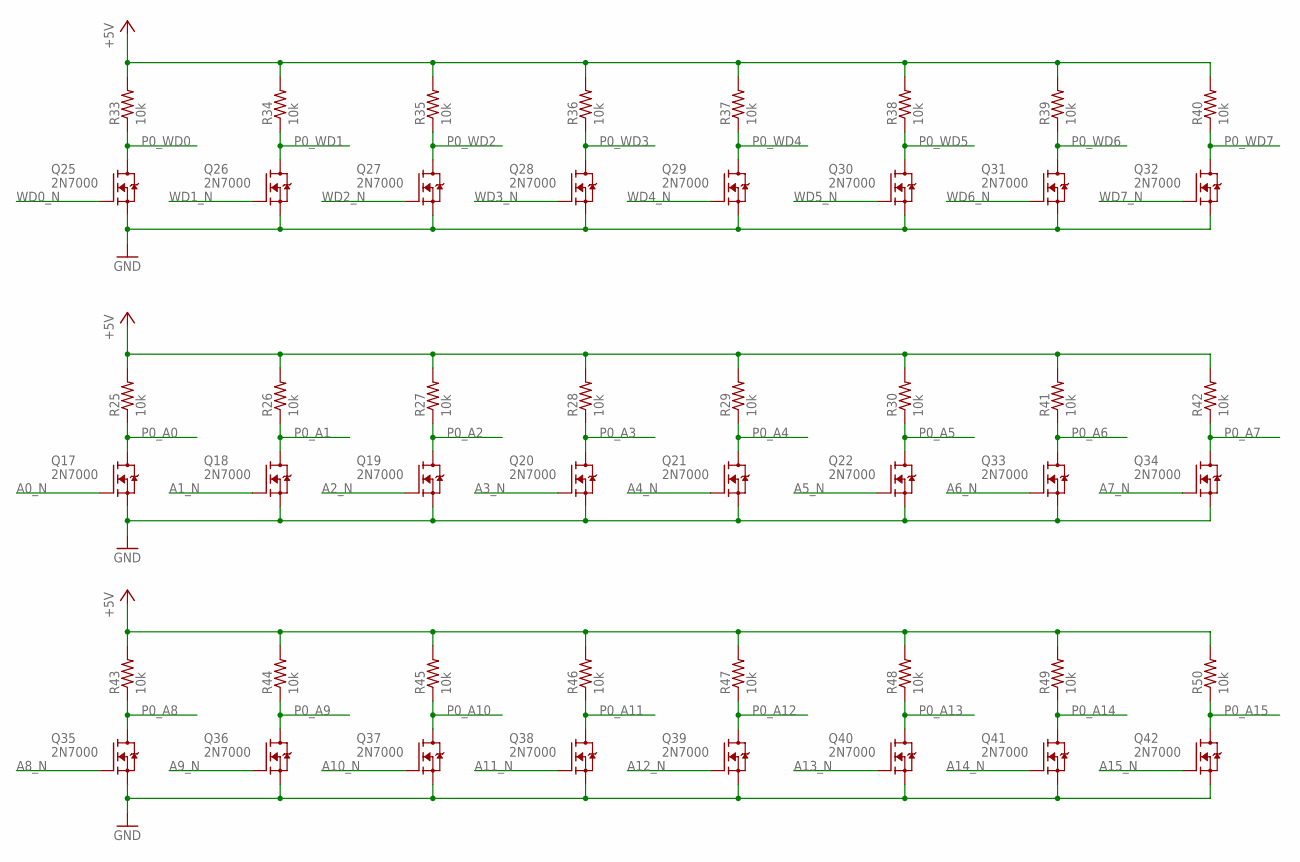
[picture p64: schematic MEM_MUX_3.sch, sheet 7]

Parts:
Q17, Q18, Q19, Q20, Q21, Q22, Q25, Q26, Q27, Q28, Q29, Q30, Q31, Q32, Q33, Q34, Q35, Q36, Q37, Q38, Q39, Q40, Q41, Q42: 2N7000; TO92-DGS
R25, R26, R27, R28, R29, R30, R33, R34, R35, R36, R37, R38, R39, R40, R41, R42, R43, R44, R45, R46, R47, R48, R49, R50: 10k; R_P2INCH

Connections:
+5V: R25.2, R26.2, R27.2, R28.2, R29.2, R30.2, R33.2, R34.2, R35.2, R36.2, R37.2, R38.2, R39.2, R40.2, R41.2, R42.2, R43.2, R44.2, R45.2, R46.2, R47.2, R48.2, R49.2, R50.2; also elsewhere on the board
A0_N: Q17.G; also elsewhere on the board
A1_N: Q18.G; also elsewhere on the board
A2_N: Q19.G; also elsewhere on the board
A3_N: Q20.G; also elsewhere on the board
A4_N: Q21.G; also elsewhere on the board
A5_N: Q22.G; also elsewhere on the board
A6_N: Q33.G; also elsewhere on the board
A7_N: Q34.G; also elsewhere on the board
A8_N: Q35.G; also elsewhere on the board
A9_N: Q36.G; also elsewhere on the board
A10_N: Q37.G; also elsewhere on the board
A11_N: Q38.G; also elsewhere on the board
A12_N: Q39.G; also elsewhere on the board
A13_N: Q40.G; also elsewhere on the board
A14_N: Q41.G; also elsewhere on the board
A15_N: Q42.G; also elsewhere on the board
GND: Q17.S, Q18.S, Q19.S, Q20.S, Q21.S, Q22.S, Q25.S, Q26.S, Q27.S, Q28.S, Q29.S, Q30.S, Q31.S, Q32.S, Q33.S, Q34.S, Q35.S, Q36.S, Q37.S, Q38.S, Q39.S, Q40.S, Q41.S, Q42.S; also elsewhere on the board
P0_A0: Q17.D, R25.1; also elsewhere on the board
P0_A1: Q18.D, R26.1; also elsewhere on the board
P0_A2: Q19.D, R27.1; also elsewhere on the board
P0_A3: Q20.D, R28.1; also elsewhere on the board
P0_A4: Q21.D, R29.1; also elsewhere on the board
P0_A5: Q22.D, R30.1; also elsewhere on the board
P0_A6: Q33.D, R41.1; also elsewhere on the board
P0_A7: Q34.D, R42.1; also elsewhere on the board
P0_A8: Q35.D, R43.1; also elsewhere on the board
P0_A9: Q36.D, R44.1; also elsewhere on the board
P0_A10: Q37.D, R45.1; also elsewhere on the board
P0_A11: Q38.D, R46.1; also elsewhere on the board
P0_A12: Q39.D, R47.1; also elsewhere on the board
P0_A13: Q40.D, R48.1; also elsewhere on the board
P0_A14: Q41.D, R49.1; also elsewhere on the board
P0_A15: Q42.D, R50.1; also elsewhere on the board
P0_WD0: Q25.D, R33.1; also elsewhere on the board
P0_WD1: Q26.D, R34.1; also elsewhere on the board
P0_WD2: Q27.D, R35.1; also elsewhere on the board
P0_WD3: Q28.D, R36.1; also elsewhere on the board
P0_WD4: Q29.D, R37.1; also elsewhere on the board
P0_WD5: Q30.D, R38.1; also elsewhere on the board
P0_WD6: Q31.D, R39.1; also elsewhere on the board
P0_WD7: Q32.D, R40.1; also elsewhere on the board
WD0_N: Q25.G; also elsewhere on the board
WD1_N: Q26.G; also elsewhere on the board
WD2_N: Q27.G; also elsewhere on the board
WD3_N: Q28.G; also elsewhere on the board
WD4_N: Q29.G; also elsewhere on the board
WD5_N: Q30.G; also elsewhere on the board
WD6_N: Q31.G; also elsewhere on the board
WD7_N: Q32.G; also elsewhere on the board

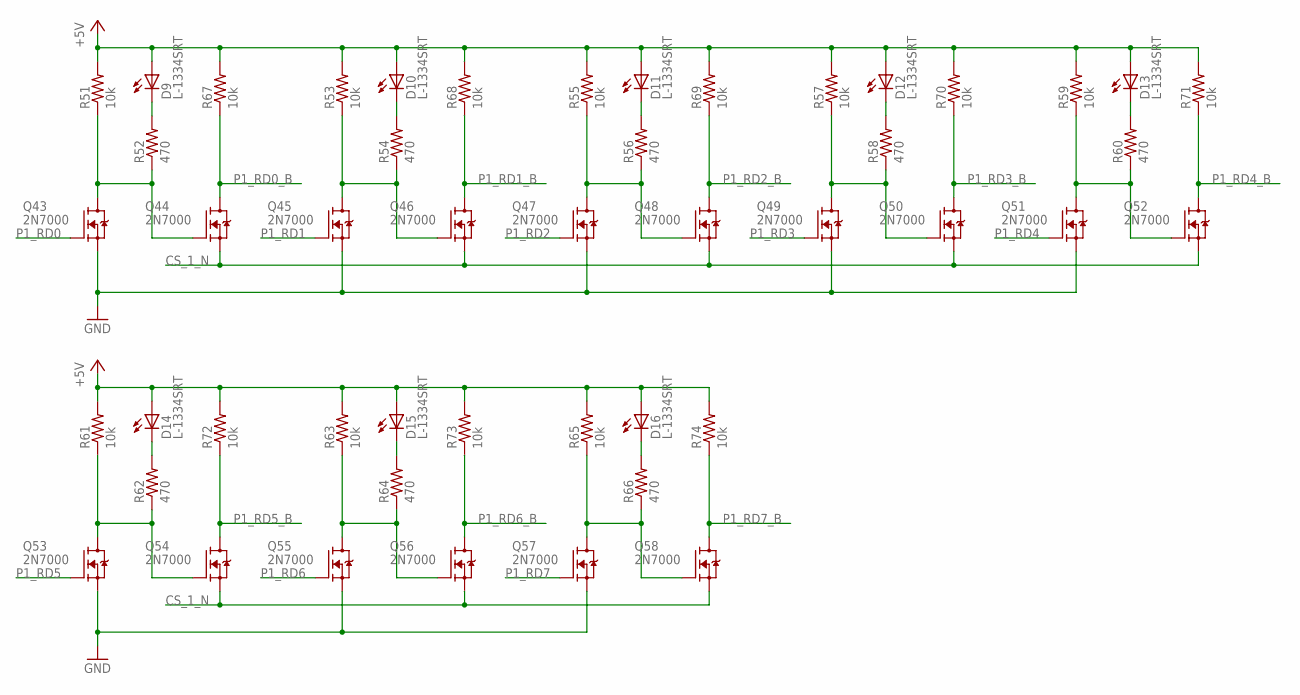
[picture p65: schematic MEM_MUX_3.sch, sheet 8]

Parts:
D9, D10, D11, D12, D13, D14, D15, D16: L-1334SRT; LED3MM
Q43, Q44, Q45, Q46, Q47, Q48, Q49, Q50, Q51, Q52, Q53, Q54, Q55, Q56, Q57, Q58: 2N7000; TO92-DGS
R51, R53, R55, R57, R59, R61, R63, R65, R67, R68, R69, R70, R71, R72, R73, R74: 10k; R_P2INCH
R52, R54, R56, R58, R60, R62, R64, R66: 470; R_P2INCH

Connections:
+5V: D9.A, D10.A, D11.A, D12.A, D13.A, D14.A, D15.A, D16.A, R51.2, R53.2, R55.2, R57.2, R59.2, R61.2, R63.2, R65.2, R67.2, R68.2, R69.2, R70.2, R71.2, R72.2, R73.2, R74.2; also elsewhere on the board
CS_1_N: Q44.S, Q46.S, Q48.S, Q50.S, Q52.S, Q54.S, Q56.S, Q58.S; also elsewhere on the board
GND: Q43.S, Q45.S, Q47.S, Q49.S, Q51.S, Q53.S, Q55.S, Q57.S; also elsewhere on the board
unnamed: Q43.D, Q44.G, R51.1, R52.1
unnamed: D9.K (C), R52.2
unnamed: Q45.D, Q46.G, R53.1, R54.1
unnamed: D10.K (C), R54.2
unnamed: Q47.D, Q48.G, R55.1, R56.1
unnamed: D11.K (C), R56.2
unnamed: Q49.D, Q50.G, R57.1, R58.1
unnamed: D12.K (C), R58.2
unnamed: Q51.D, Q52.G, R59.1, R60.1
unnamed: D13.K (C), R60.2
unnamed: Q53.D, Q54.G, R61.1, R62.1
unnamed: D14.K (C), R62.2
unnamed: Q55.D, Q56.G, R63.1, R64.1
unnamed: D15.K (C), R64.2
unnamed: Q57.D, Q58.G, R65.1, R66.1
unnamed: D16.K (C), R66.2
P1_RD0: Q43.G; also elsewhere on the board
P1_RD0_B: Q44.D, R67.1; also elsewhere on the board
P1_RD1: Q45.G; also elsewhere on the board
P1_RD1_B: Q46.D, R68.1; also elsewhere on the board
P1_RD2: Q47.G; also elsewhere on the board
P1_RD2_B: Q48.D, R69.1; also elsewhere on the board
P1_RD3: Q49.G; also elsewhere on the board
P1_RD3_B: Q50.D, R70.1; also elsewhere on the board
P1_RD4: Q51.G; also elsewhere on the board
P1_RD4_B: Q52.D, R71.1; also elsewhere on the board
P1_RD5: Q53.G; also elsewhere on the board
P1_RD5_B: Q54.D, R72.1; also elsewhere on the board
P1_RD6: Q55.G; also elsewhere on the board
P1_RD6_B: Q56.D, R73.1; also elsewhere on the board
P1_RD7: Q57.G; also elsewhere on the board
P1_RD7_B: Q58.D, R74.1; also elsewhere on the board

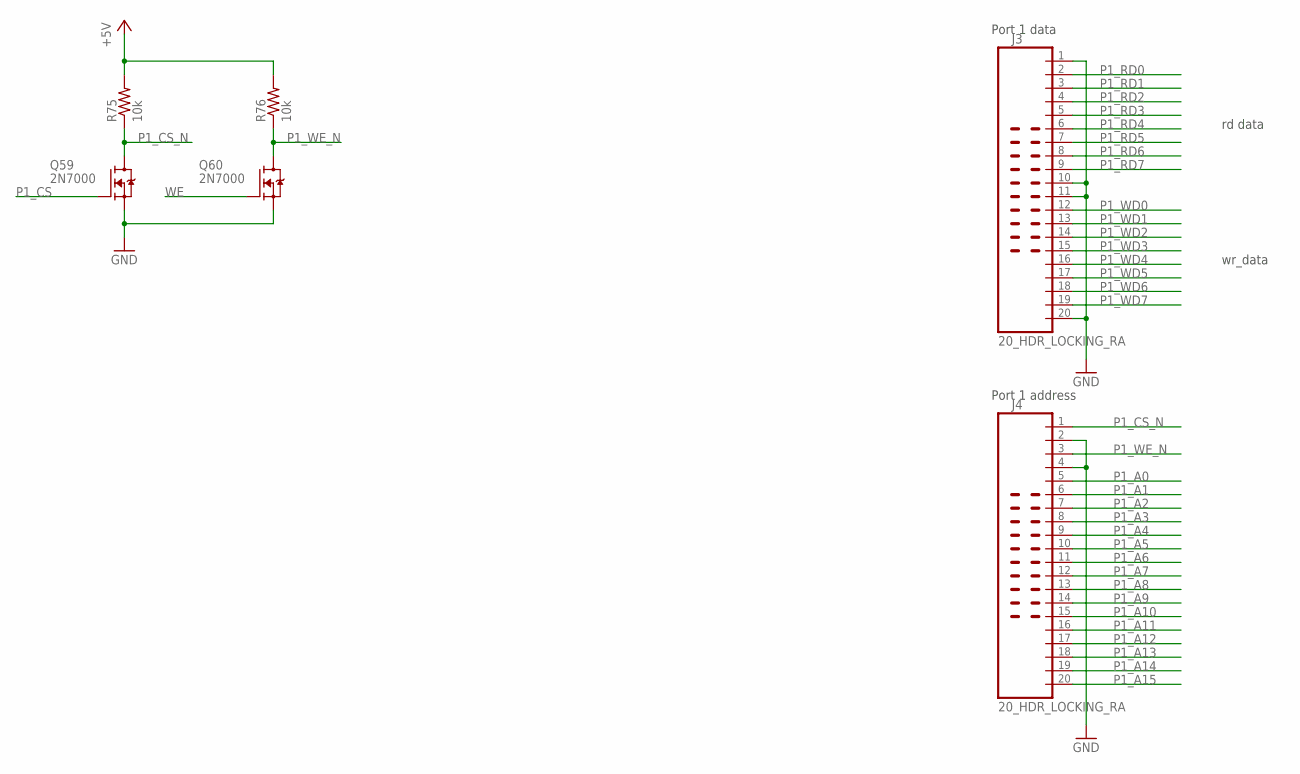
[picture p66: schematic MEM_MUX_3.sch, sheet 9]

Parts:
J3, J4: 20_HDR_LOCKING_RA
Q59, Q60: 2N7000; TO92-DGS
R75, R76: 10k; R_P2INCH

Connections:
+5V: R75.2, R76.2; also elsewhere on the board
GND: J3.1, J3.10, J3.11, J3.20, J4.2, J4.4, Q59.S, Q60.S; also elsewhere on the board
P1_A0: J4.5; also elsewhere on the board
P1_A1: J4.6; also elsewhere on the board
P1_A2: J4.7; also elsewhere on the board
P1_A3: J4.8; also elsewhere on the board
P1_A4: J4.9; also elsewhere on the board
P1_A5: J4.10; also elsewhere on the board
P1_A6: J4.11; also elsewhere on the board
P1_A7: J4.12; also elsewhere on the board
P1_A8: J4.13; also elsewhere on the board
P1_A9: J4.14; also elsewhere on the board
P1_A10: J4.15; also elsewhere on the board
P1_A11: J4.16; also elsewhere on the board
P1_A12: J4.17; also elsewhere on the board
P1_A13: J4.18; also elsewhere on the board
P1_A14: J4.19; also elsewhere on the board
P1_A15: J4.20; also elsewhere on the board
P1_CS: Q59.G; also elsewhere on the board
P1_CS_N: J4.1, Q59.D, R75.1
P1_RD0: J3.2; also elsewhere on the board
P1_RD1: J3.3; also elsewhere on the board
P1_RD2: J3.4; also elsewhere on the board
P1_RD3: J3.5; also elsewhere on the board
P1_RD4: J3.6; also elsewhere on the board
P1_RD5: J3.7; also elsewhere on the board
P1_RD6: J3.8; also elsewhere on the board
P1_RD7: J3.9; also elsewhere on the board
P1_WD0: J3.12; also elsewhere on the board
P1_WD1: J3.13; also elsewhere on the board
P1_WD2: J3.14; also elsewhere on the board
P1_WD3: J3.15; also elsewhere on the board
P1_WD4: J3.16; also elsewhere on the board
P1_WD5: J3.17; also elsewhere on the board
P1_WD6: J3.18; also elsewhere on the board
P1_WD7: J3.19; also elsewhere on the board
P1_WE_N: J4.3, Q60.D, R76.1
WE: Q60.G; also elsewhere on the board

Notes on the sheet:
Port 1 data
Port 1 address
rd data
wr_data

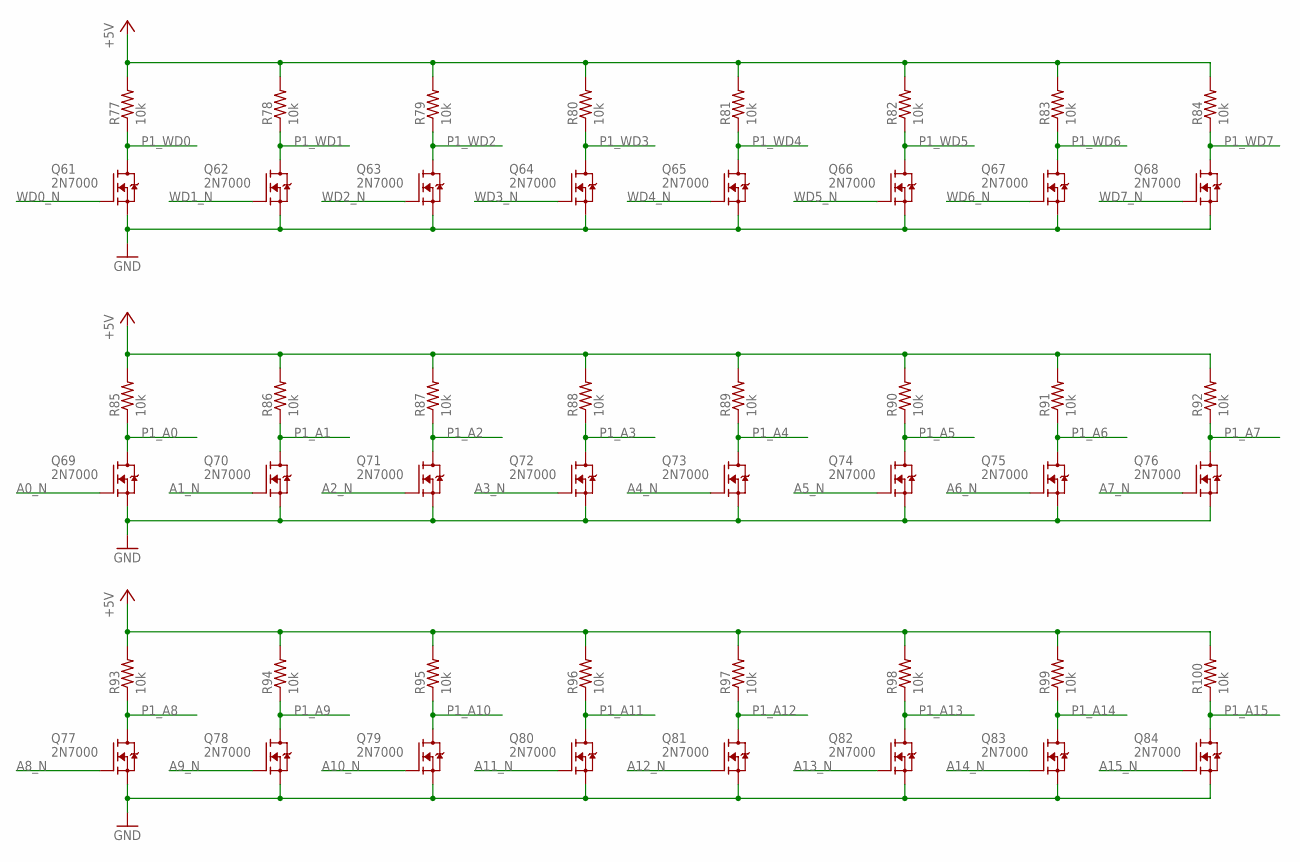
[picture p67: schematic MEM_MUX_3.sch, sheet 10]

Parts:
Q61, Q62, Q63, Q64, Q65, Q66, Q67, Q68, Q69, Q70, Q71, Q72, Q73, Q74, Q75, Q76, Q77, Q78, Q79, Q80, Q81, Q82, Q83, Q84: 2N7000; TO92-DGS
R77, R78, R79, R80, R81, R82, R83, R84, R85, R86, R87, R88, R89, R90, R91, R92, R93, R94, R95, R96, R97, R98, R99, R100: 10k; R_P2INCH

Connections:
+5V: R77.2, R78.2, R79.2, R80.2, R81.2, R82.2, R83.2, R84.2, R85.2, R86.2, R87.2, R88.2, R89.2, R90.2, R91.2, R92.2, R93.2, R94.2, R95.2, R96.2, R97.2, R98.2, R99.2, R100.2; also elsewhere on the board
A0_N: Q69.G; also elsewhere on the board
A1_N: Q70.G; also elsewhere on the board
A2_N: Q71.G; also elsewhere on the board
A3_N: Q72.G; also elsewhere on the board
A4_N: Q73.G; also elsewhere on the board
A5_N: Q74.G; also elsewhere on the board
A6_N: Q75.G; also elsewhere on the board
A7_N: Q76.G; also elsewhere on the board
A8_N: Q77.G; also elsewhere on the board
A9_N: Q78.G; also elsewhere on the board
A10_N: Q79.G; also elsewhere on the board
A11_N: Q80.G; also elsewhere on the board
A12_N: Q81.G; also elsewhere on the board
A13_N: Q82.G; also elsewhere on the board
A14_N: Q83.G; also elsewhere on the board
A15_N: Q84.G; also elsewhere on the board
GND: Q61.S, Q62.S, Q63.S, Q64.S, Q65.S, Q66.S, Q67.S, Q68.S, Q69.S, Q70.S, Q71.S, Q72.S, Q73.S, Q74.S, Q75.S, Q76.S, Q77.S, Q78.S, Q79.S, Q80.S, Q81.S, Q82.S, Q83.S, Q84.S; also elsewhere on the board
P1_A0: Q69.D, R85.1; also elsewhere on the board
P1_A1: Q70.D, R86.1; also elsewhere on the board
P1_A2: Q71.D, R87.1; also elsewhere on the board
P1_A3: Q72.D, R88.1; also elsewhere on the board
P1_A4: Q73.D, R89.1; also elsewhere on the board
P1_A5: Q74.D, R90.1; also elsewhere on the board
P1_A6: Q75.D, R91.1; also elsewhere on the board
P1_A7: Q76.D, R92.1; also elsewhere on the board
P1_A8: Q77.D, R93.1; also elsewhere on the board
P1_A9: Q78.D, R94.1; also elsewhere on the board
P1_A10: Q79.D, R95.1; also elsewhere on the board
P1_A11: Q80.D, R96.1; also elsewhere on the board
P1_A12: Q81.D, R97.1; also elsewhere on the board
P1_A13: Q82.D, R98.1; also elsewhere on the board
P1_A14: Q83.D, R99.1; also elsewhere on the board
P1_A15: Q84.D, R100.1; also elsewhere on the board
P1_WD0: Q61.D, R77.1; also elsewhere on the board
P1_WD1: Q62.D, R78.1; also elsewhere on the board
P1_WD2: Q63.D, R79.1; also elsewhere on the board
P1_WD3: Q64.D, R80.1; also elsewhere on the board
P1_WD4: Q65.D, R81.1; also elsewhere on the board
P1_WD5: Q66.D, R82.1; also elsewhere on the board
P1_WD6: Q67.D, R83.1; also elsewhere on the board
P1_WD7: Q68.D, R84.1; also elsewhere on the board
WD0_N: Q61.G; also elsewhere on the board
WD1_N: Q62.G; also elsewhere on the board
WD2_N: Q63.G; also elsewhere on the board
WD3_N: Q64.G; also elsewhere on the board
WD4_N: Q65.G; also elsewhere on the board
WD5_N: Q66.G; also elsewhere on the board
WD6_N: Q67.G; also elsewhere on the board
WD7_N: Q68.G; also elsewhere on the board

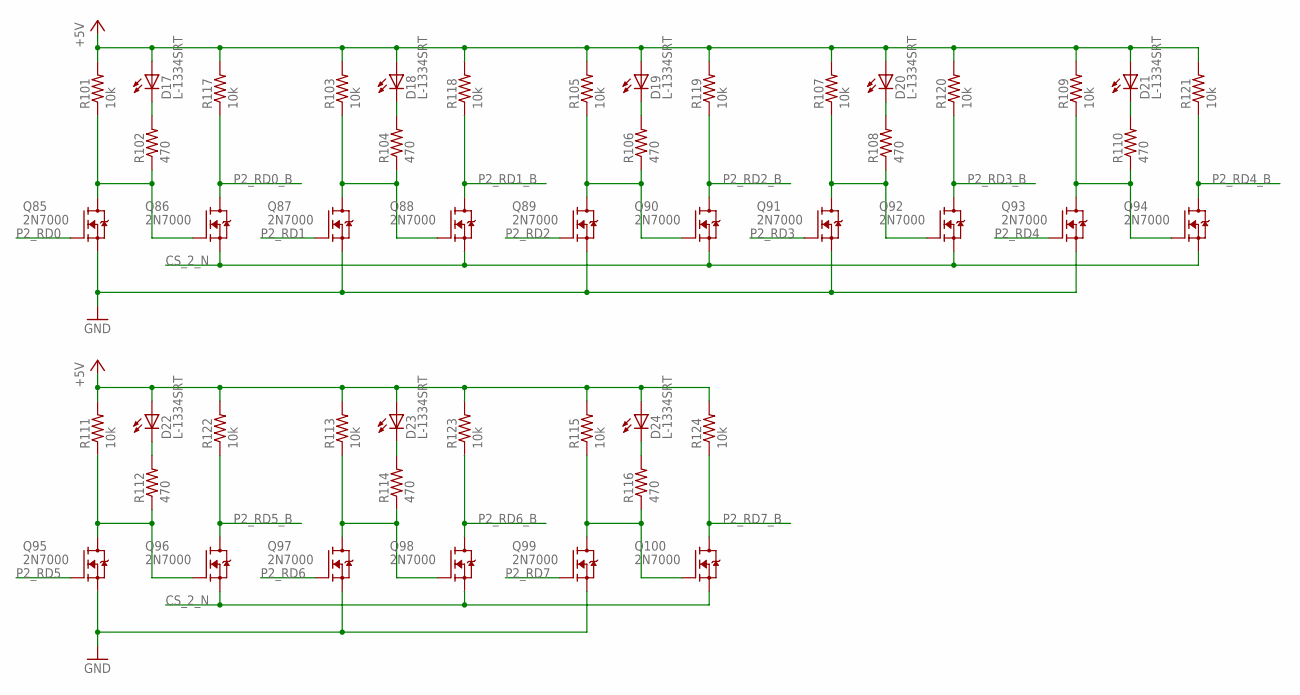
[picture p68: schematic MEM_MUX_3.sch, sheet 11]

Parts:
D17, D18, D19, D20, D21, D22, D23, D24: L-1334SRT; LED3MM
Q85, Q86, Q87, Q88, Q89, Q90, Q91, Q92, Q93, Q94, Q95, Q96, Q97, Q98, Q99, Q100: 2N7000; TO92-DGS
R101, R103, R105, R107, R109, R111, R113, R115, R117, R118, R119, R120, R121, R122, R123, R124: 10k; R_P2INCH
R102, R104, R106, R108, R110, R112, R114, R116: 470; R_P2INCH

Connections:
+5V: D17.A, D18.A, D19.A, D20.A, D21.A, D22.A, D23.A, D24.A, R101.2, R103.2, R105.2, R107.2, R109.2, R111.2, R113.2, R115.2, R117.2, R118.2, R119.2, R120.2, R121.2, R122.2, R123.2, R124.2; also elsewhere on the board
CS_2_N: Q86.S, Q88.S, Q90.S, Q92.S, Q94.S, Q96.S, Q98.S, Q100.S; also elsewhere on the board
GND: Q85.S, Q87.S, Q89.S, Q91.S, Q93.S, Q95.S, Q97.S, Q99.S; also elsewhere on the board
unnamed: Q85.D, Q86.G, R101.1, R102.1
unnamed: D17.K (C), R102.2
unnamed: Q87.D, Q88.G, R103.1, R104.1
unnamed: D18.K (C), R104.2
unnamed: Q89.D, Q90.G, R105.1, R106.1
unnamed: D19.K (C), R106.2
unnamed: Q91.D, Q92.G, R107.1, R108.1
unnamed: D20.K (C), R108.2
unnamed: Q93.D, Q94.G, R109.1, R110.1
unnamed: D21.K (C), R110.2
unnamed: Q95.D, Q96.G, R111.1, R112.1
unnamed: D22.K (C), R112.2
unnamed: Q97.D, Q98.G, R113.1, R114.1
unnamed: D23.K (C), R114.2
unnamed: Q99.D, Q100.G, R115.1, R116.1
unnamed: D24.K (C), R116.2
P2_RD0: Q85.G; also elsewhere on the board
P2_RD0_B: Q86.D, R117.1; also elsewhere on the board
P2_RD1: Q87.G; also elsewhere on the board
P2_RD1_B: Q88.D, R118.1; also elsewhere on the board
P2_RD2: Q89.G; also elsewhere on the board
P2_RD2_B: Q90.D, R119.1; also elsewhere on the board
P2_RD3: Q91.G; also elsewhere on the board
P2_RD3_B: Q92.D, R120.1; also elsewhere on the board
P2_RD4: Q93.G; also elsewhere on the board
P2_RD4_B: Q94.D, R121.1; also elsewhere on the board
P2_RD5: Q95.G; also elsewhere on the board
P2_RD5_B: Q96.D, R122.1; also elsewhere on the board
P2_RD6: Q97.G; also elsewhere on the board
P2_RD6_B: Q98.D, R123.1; also elsewhere on the board
P2_RD7: Q99.G; also elsewhere on the board
P2_RD7_B: Q100.D, R124.1; also elsewhere on the board

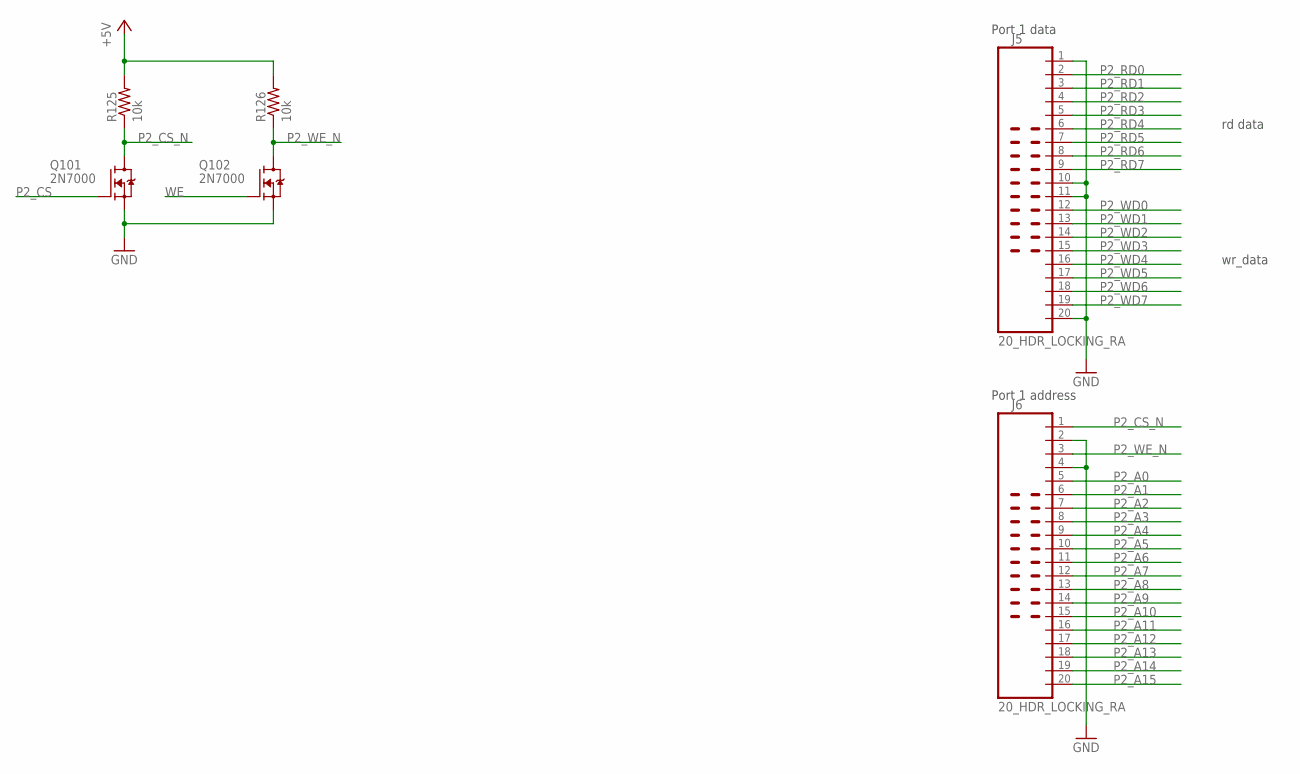
[picture p69: schematic MEM_MUX_3.sch, sheet 12]

Parts:
J5, J6: 20_HDR_LOCKING_RA
Q101, Q102: 2N7000; TO92-DGS
R125, R126: 10k; R_P2INCH

Connections:
+5V: R125.2, R126.2; also elsewhere on the board
GND: J5.1, J5.10, J5.11, J5.20, J6.2, J6.4, Q101.S, Q102.S; also elsewhere on the board
P2_A0: J6.5; also elsewhere on the board
P2_A1: J6.6; also elsewhere on the board
P2_A2: J6.7; also elsewhere on the board
P2_A3: J6.8; also elsewhere on the board
P2_A4: J6.9; also elsewhere on the board
P2_A5: J6.10; also elsewhere on the board
P2_A6: J6.11; also elsewhere on the board
P2_A7: J6.12; also elsewhere on the board
P2_A8: J6.13; also elsewhere on the board
P2_A9: J6.14; also elsewhere on the board
P2_A10: J6.15; also elsewhere on the board
P2_A11: J6.16; also elsewhere on the board
P2_A12: J6.17; also elsewhere on the board
P2_A13: J6.18; also elsewhere on the board
P2_A14: J6.19; also elsewhere on the board
P2_A15: J6.20; also elsewhere on the board
P2_CS: Q101.G; also elsewhere on the board
P2_CS_N: J6.1, Q101.D, R125.1
P2_RD0: J5.2; also elsewhere on the board
P2_RD1: J5.3; also elsewhere on the board
P2_RD2: J5.4; also elsewhere on the board
P2_RD3: J5.5; also elsewhere on the board
P2_RD4: J5.6; also elsewhere on the board
P2_RD5: J5.7; also elsewhere on the board
P2_RD6: J5.8; also elsewhere on the board
P2_RD7: J5.9; also elsewhere on the board
P2_WD0: J5.12; also elsewhere on the board
P2_WD1: J5.13; also elsewhere on the board
P2_WD2: J5.14; also elsewhere on the board
P2_WD3: J5.15; also elsewhere on the board
P2_WD4: J5.16; also elsewhere on the board
P2_WD5: J5.17; also elsewhere on the board
P2_WD6: J5.18; also elsewhere on the board
P2_WD7: J5.19; also elsewhere on the board
P2_WE_N: J6.3, Q102.D, R126.1
WE: Q102.G; also elsewhere on the board

Notes on the sheet:
Port 1 data
Port 1 address
rd data
wr_data
