ericherman/megaprocessor/mem_mux_4w/MEM_MUX_3.brd

## EAGLE design mem_mux_4w/MEM_MUX_3.brd (continued)

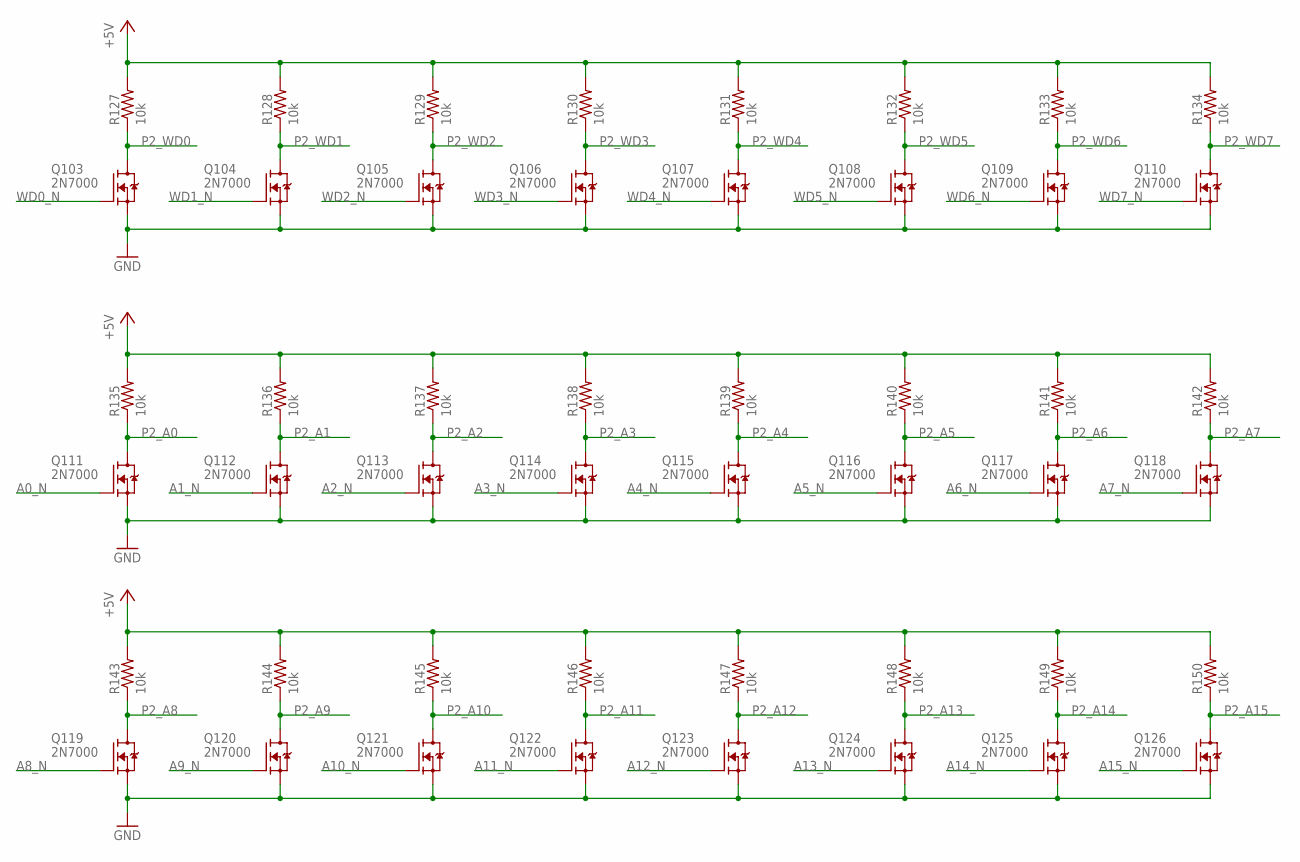
[picture p70: schematic MEM_MUX_3.sch, sheet 13]

Parts:
Q103, Q104, Q105, Q106, Q107, Q108, Q109, Q110, Q111, Q112, Q113, Q114, Q115, Q116, Q117, Q118, Q119, Q120, Q121, Q122, Q123, Q124, Q125, Q126: 2N7000; TO92-DGS
R127, R128, R129, R130, R131, R132, R133, R134, R135, R136, R137, R138, R139, R140, R141, R142, R143, R144, R145, R146, R147, R148, R149, R150: 10k; R_P2INCH

Connections:
+5V: R127.2, R128.2, R129.2, R130.2, R131.2, R132.2, R133.2, R134.2, R135.2, R136.2, R137.2, R138.2, R139.2, R140.2, R141.2, R142.2, R143.2, R144.2, R145.2, R146.2, R147.2, R148.2, R149.2, R150.2; also elsewhere on the board
A0_N: Q111.G; also elsewhere on the board
A1_N: Q112.G; also elsewhere on the board
A2_N: Q113.G; also elsewhere on the board
A3_N: Q114.G; also elsewhere on the board
A4_N: Q115.G; also elsewhere on the board
A5_N: Q116.G; also elsewhere on the board
A6_N: Q117.G; also elsewhere on the board
A7_N: Q118.G; also elsewhere on the board
A8_N: Q119.G; also elsewhere on the board
A9_N: Q120.G; also elsewhere on the board
A10_N: Q121.G; also elsewhere on the board
A11_N: Q122.G; also elsewhere on the board
A12_N: Q123.G; also elsewhere on the board
A13_N: Q124.G; also elsewhere on the board
A14_N: Q125.G; also elsewhere on the board
A15_N: Q126.G; also elsewhere on the board
GND: Q103.S, Q104.S, Q105.S, Q106.S, Q107.S, Q108.S, Q109.S, Q110.S, Q111.S, Q112.S, Q113.S, Q114.S, Q115.S, Q116.S, Q117.S, Q118.S, Q119.S, Q120.S, Q121.S, Q122.S, Q123.S, Q124.S, Q125.S, Q126.S; also elsewhere on the board
P2_A0: Q111.D, R135.1; also elsewhere on the board
P2_A1: Q112.D, R136.1; also elsewhere on the board
P2_A2: Q113.D, R137.1; also elsewhere on the board
P2_A3: Q114.D, R138.1; also elsewhere on the board
P2_A4: Q115.D, R139.1; also elsewhere on the board
P2_A5: Q116.D, R140.1; also elsewhere on the board
P2_A6: Q117.D, R141.1; also elsewhere on the board
P2_A7: Q118.D, R142.1; also elsewhere on the board
P2_A8: Q119.D, R143.1; also elsewhere on the board
P2_A9: Q120.D, R144.1; also elsewhere on the board
P2_A10: Q121.D, R145.1; also elsewhere on the board
P2_A11: Q122.D, R146.1; also elsewhere on the board
P2_A12: Q123.D, R147.1; also elsewhere on the board
P2_A13: Q124.D, R148.1; also elsewhere on the board
P2_A14: Q125.D, R149.1; also elsewhere on the board
P2_A15: Q126.D, R150.1; also elsewhere on the board
P2_WD0: Q103.D, R127.1; also elsewhere on the board
P2_WD1: Q104.D, R128.1; also elsewhere on the board
P2_WD2: Q105.D, R129.1; also elsewhere on the board
P2_WD3: Q106.D, R130.1; also elsewhere on the board
P2_WD4: Q107.D, R131.1; also elsewhere on the board
P2_WD5: Q108.D, R132.1; also elsewhere on the board
P2_WD6: Q109.D, R133.1; also elsewhere on the board
P2_WD7: Q110.D, R134.1; also elsewhere on the board
WD0_N: Q103.G; also elsewhere on the board
WD1_N: Q104.G; also elsewhere on the board
WD2_N: Q105.G; also elsewhere on the board
WD3_N: Q106.G; also elsewhere on the board
WD4_N: Q107.G; also elsewhere on the board
WD5_N: Q108.G; also elsewhere on the board
WD6_N: Q109.G; also elsewhere on the board
WD7_N: Q110.G; also elsewhere on the board

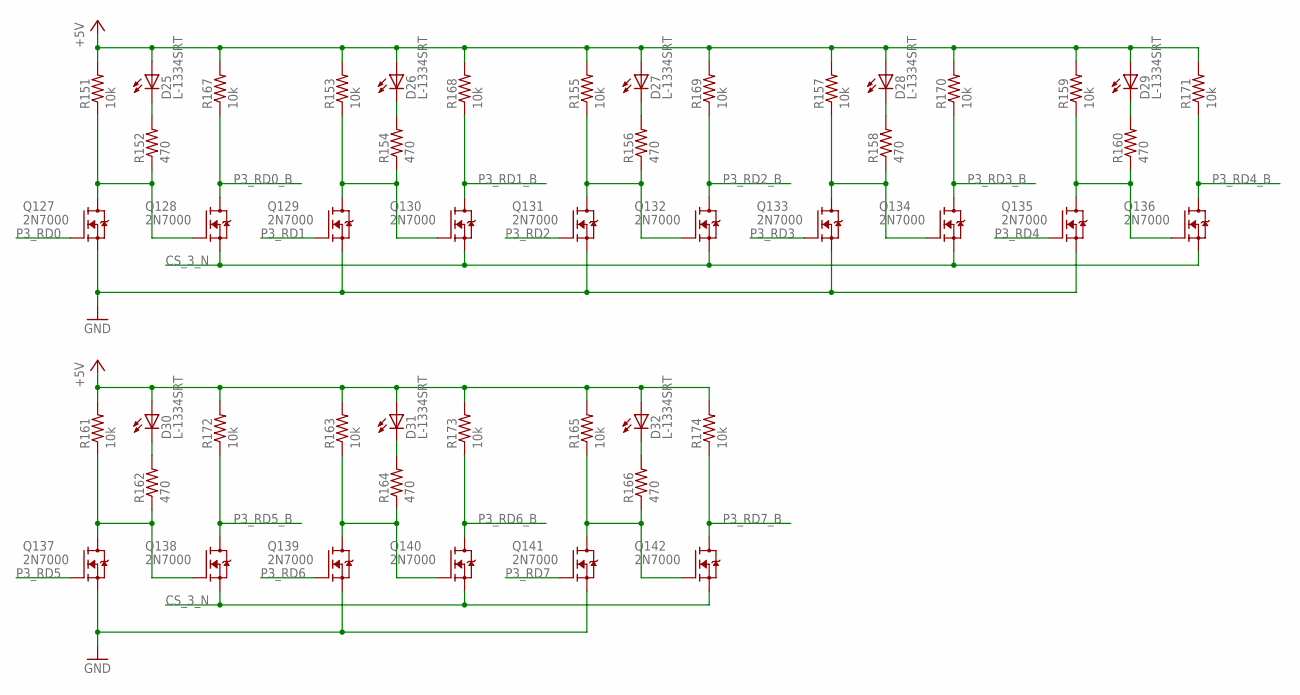
[picture p71: schematic MEM_MUX_3.sch, sheet 14]

Parts:
D25, D26, D27, D28, D29, D30, D31, D32: L-1334SRT; LED3MM
Q127, Q128, Q129, Q130, Q131, Q132, Q133, Q134, Q135, Q136, Q137, Q138, Q139, Q140, Q141, Q142: 2N7000; TO92-DGS
R151, R153, R155, R157, R159, R161, R163, R165, R167, R168, R169, R170, R171, R172, R173, R174: 10k; R_P2INCH
R152, R154, R156, R158, R160, R162, R164, R166: 470; R_P2INCH

Connections:
+5V: D25.A, D26.A, D27.A, D28.A, D29.A, D30.A, D31.A, D32.A, R151.2, R153.2, R155.2, R157.2, R159.2, R161.2, R163.2, R165.2, R167.2, R168.2, R169.2, R170.2, R171.2, R172.2, R173.2, R174.2; also elsewhere on the board
CS_3_N: Q128.S, Q130.S, Q132.S, Q134.S, Q136.S, Q138.S, Q140.S, Q142.S; also elsewhere on the board
GND: Q127.S, Q129.S, Q131.S, Q133.S, Q135.S, Q137.S, Q139.S, Q141.S; also elsewhere on the board
unnamed: Q127.D, Q128.G, R151.1, R152.1
unnamed: D25.K (C), R152.2
unnamed: Q129.D, Q130.G, R153.1, R154.1
unnamed: D26.K (C), R154.2
unnamed: Q131.D, Q132.G, R155.1, R156.1
unnamed: D27.K (C), R156.2
unnamed: Q133.D, Q134.G, R157.1, R158.1
unnamed: D28.K (C), R158.2
unnamed: Q135.D, Q136.G, R159.1, R160.1
unnamed: D29.K (C), R160.2
unnamed: Q137.D, Q138.G, R161.1, R162.1
unnamed: D30.K (C), R162.2
unnamed: Q139.D, Q140.G, R163.1, R164.1
unnamed: D31.K (C), R164.2
unnamed: Q141.D, Q142.G, R165.1, R166.1
unnamed: D32.K (C), R166.2
P3_RD0: Q127.G; also elsewhere on the board
P3_RD0_B: Q128.D, R167.1; also elsewhere on the board
P3_RD1: Q129.G; also elsewhere on the board
P3_RD1_B: Q130.D, R168.1; also elsewhere on the board
P3_RD2: Q131.G; also elsewhere on the board
P3_RD2_B: Q132.D, R169.1; also elsewhere on the board
P3_RD3: Q133.G; also elsewhere on the board
P3_RD3_B: Q134.D, R170.1; also elsewhere on the board
P3_RD4: Q135.G; also elsewhere on the board
P3_RD4_B: Q136.D, R171.1; also elsewhere on the board
P3_RD5: Q137.G; also elsewhere on the board
P3_RD5_B: Q138.D, R172.1; also elsewhere on the board
P3_RD6: Q139.G; also elsewhere on the board
P3_RD6_B: Q140.D, R173.1; also elsewhere on the board
P3_RD7: Q141.G; also elsewhere on the board
P3_RD7_B: Q142.D, R174.1; also elsewhere on the board

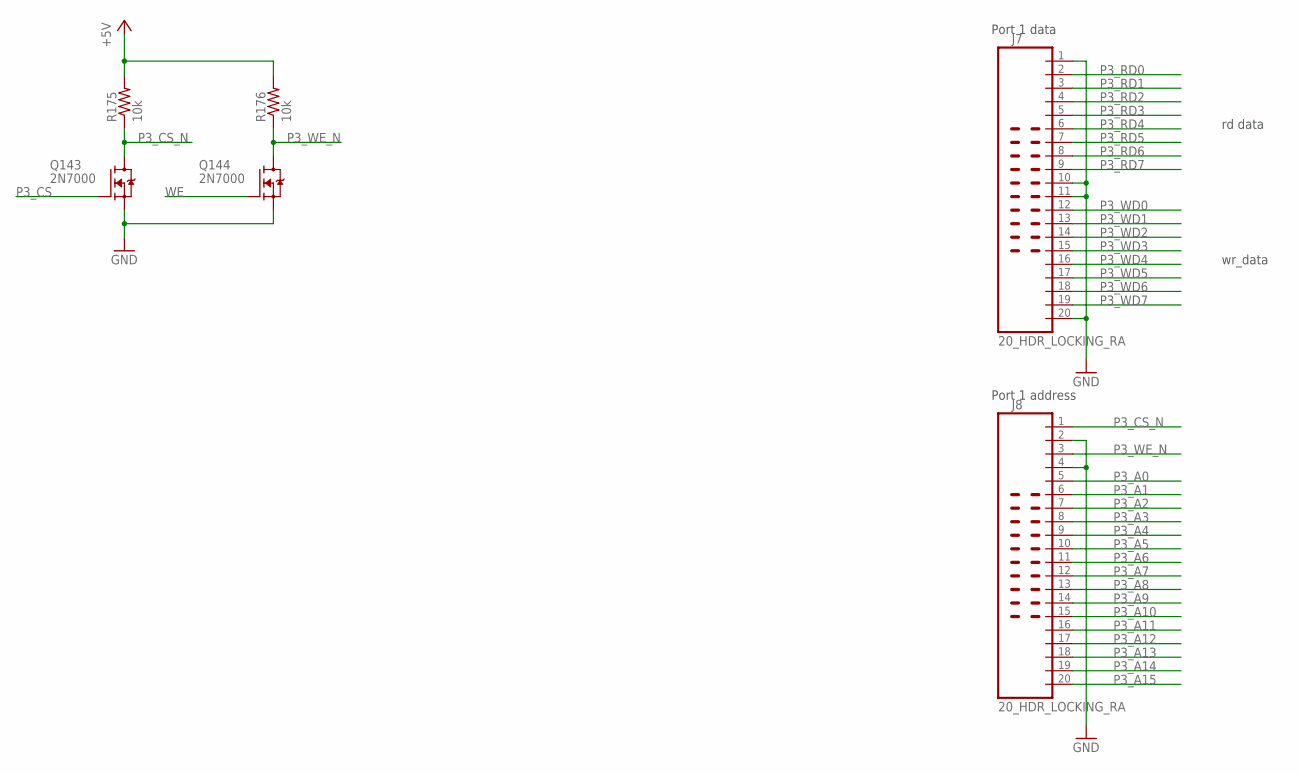
[picture p72: schematic MEM_MUX_3.sch, sheet 15]

Parts:
J7, J8: 20_HDR_LOCKING_RA
Q143, Q144: 2N7000; TO92-DGS
R175, R176: 10k; R_P2INCH

Connections:
+5V: R175.2, R176.2; also elsewhere on the board
GND: J7.1, J7.10, J7.11, J7.20, J8.2, J8.4, Q143.S, Q144.S; also elsewhere on the board
P3_A0: J8.5; also elsewhere on the board
P3_A1: J8.6; also elsewhere on the board
P3_A2: J8.7; also elsewhere on the board
P3_A3: J8.8; also elsewhere on the board
P3_A4: J8.9; also elsewhere on the board
P3_A5: J8.10; also elsewhere on the board
P3_A6: J8.11; also elsewhere on the board
P3_A7: J8.12; also elsewhere on the board
P3_A8: J8.13; also elsewhere on the board
P3_A9: J8.14; also elsewhere on the board
P3_A10: J8.15; also elsewhere on the board
P3_A11: J8.16; also elsewhere on the board
P3_A12: J8.17; also elsewhere on the board
P3_A13: J8.18; also elsewhere on the board
P3_A14: J8.19; also elsewhere on the board
P3_A15: J8.20; also elsewhere on the board
P3_CS: Q143.G; also elsewhere on the board
P3_CS_N: J8.1, Q143.D, R175.1
P3_RD0: J7.2; also elsewhere on the board
P3_RD1: J7.3; also elsewhere on the board
P3_RD2: J7.4; also elsewhere on the board
P3_RD3: J7.5; also elsewhere on the board
P3_RD4: J7.6; also elsewhere on the board
P3_RD5: J7.7; also elsewhere on the board
P3_RD6: J7.8; also elsewhere on the board
P3_RD7: J7.9; also elsewhere on the board
P3_WD0: J7.12; also elsewhere on the board
P3_WD1: J7.13; also elsewhere on the board
P3_WD2: J7.14; also elsewhere on the board
P3_WD3: J7.15; also elsewhere on the board
P3_WD4: J7.16; also elsewhere on the board
P3_WD5: J7.17; also elsewhere on the board
P3_WD6: J7.18; also elsewhere on the board
P3_WD7: J7.19; also elsewhere on the board
P3_WE_N: J8.3, Q144.D, R176.1
WE: Q144.G; also elsewhere on the board

Notes on the sheet:
Port 1 data
Port 1 address
rd data
wr_data

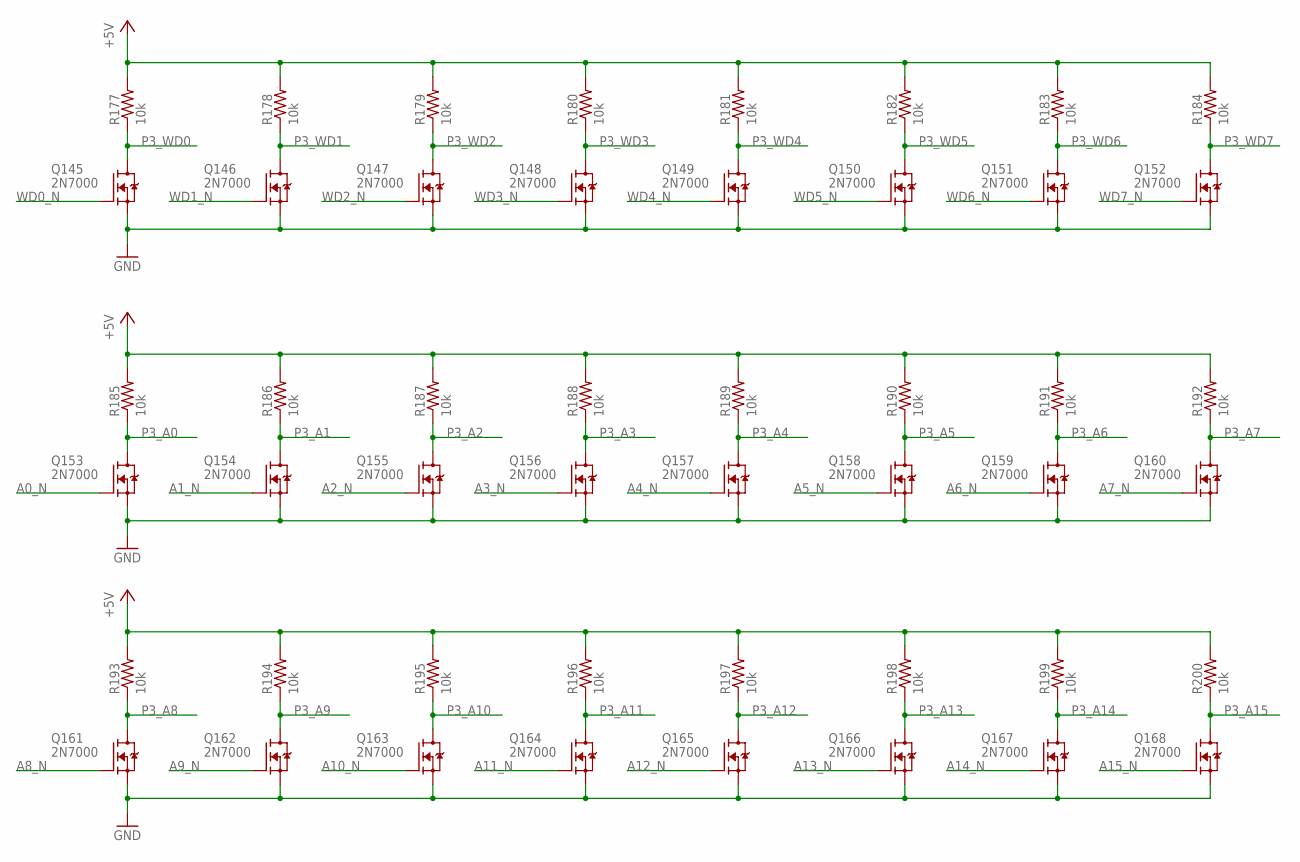
[picture p73: schematic MEM_MUX_3.sch, sheet 16]

Parts:
Q145, Q146, Q147, Q148, Q149, Q150, Q151, Q152, Q153, Q154, Q155, Q156, Q157, Q158, Q159, Q160, Q161, Q162, Q163, Q164, Q165, Q166, Q167, Q168: 2N7000; TO92-DGS
R177, R178, R179, R180, R181, R182, R183, R184, R185, R186, R187, R188, R189, R190, R191, R192, R193, R194, R195, R196, R197, R198, R199, R200: 10k; R_P2INCH

Connections:
+5V: R177.2, R178.2, R179.2, R180.2, R181.2, R182.2, R183.2, R184.2, R185.2, R186.2, R187.2, R188.2, R189.2, R190.2, R191.2, R192.2, R193.2, R194.2, R195.2, R196.2, R197.2, R198.2, R199.2, R200.2; also elsewhere on the board
A0_N: Q153.G; also elsewhere on the board
A1_N: Q154.G; also elsewhere on the board
A2_N: Q155.G; also elsewhere on the board
A3_N: Q156.G; also elsewhere on the board
A4_N: Q157.G; also elsewhere on the board
A5_N: Q158.G; also elsewhere on the board
A6_N: Q159.G; also elsewhere on the board
A7_N: Q160.G; also elsewhere on the board
A8_N: Q161.G; also elsewhere on the board
A9_N: Q162.G; also elsewhere on the board
A10_N: Q163.G; also elsewhere on the board
A11_N: Q164.G; also elsewhere on the board
A12_N: Q165.G; also elsewhere on the board
A13_N: Q166.G; also elsewhere on the board
A14_N: Q167.G; also elsewhere on the board
A15_N: Q168.G; also elsewhere on the board
GND: Q145.S, Q146.S, Q147.S, Q148.S, Q149.S, Q150.S, Q151.S, Q152.S, Q153.S, Q154.S, Q155.S, Q156.S, Q157.S, Q158.S, Q159.S, Q160.S, Q161.S, Q162.S, Q163.S, Q164.S, Q165.S, Q166.S, Q167.S, Q168.S; also elsewhere on the board
P3_A0: Q153.D, R185.1; also elsewhere on the board
P3_A1: Q154.D, R186.1; also elsewhere on the board
P3_A2: Q155.D, R187.1; also elsewhere on the board
P3_A3: Q156.D, R188.1; also elsewhere on the board
P3_A4: Q157.D, R189.1; also elsewhere on the board
P3_A5: Q158.D, R190.1; also elsewhere on the board
P3_A6: Q159.D, R191.1; also elsewhere on the board
P3_A7: Q160.D, R192.1; also elsewhere on the board
P3_A8: Q161.D, R193.1; also elsewhere on the board
P3_A9: Q162.D, R194.1; also elsewhere on the board
P3_A10: Q163.D, R195.1; also elsewhere on the board
P3_A11: Q164.D, R196.1; also elsewhere on the board
P3_A12: Q165.D, R197.1; also elsewhere on the board
P3_A13: Q166.D, R198.1; also elsewhere on the board
P3_A14: Q167.D, R199.1; also elsewhere on the board
P3_A15: Q168.D, R200.1; also elsewhere on the board
P3_WD0: Q145.D, R177.1; also elsewhere on the board
P3_WD1: Q146.D, R178.1; also elsewhere on the board
P3_WD2: Q147.D, R179.1; also elsewhere on the board
P3_WD3: Q148.D, R180.1; also elsewhere on the board
P3_WD4: Q149.D, R181.1; also elsewhere on the board
P3_WD5: Q150.D, R182.1; also elsewhere on the board
P3_WD6: Q151.D, R183.1; also elsewhere on the board
P3_WD7: Q152.D, R184.1; also elsewhere on the board
WD0_N: Q145.G; also elsewhere on the board
WD1_N: Q146.G; also elsewhere on the board
WD2_N: Q147.G; also elsewhere on the board
WD3_N: Q148.G; also elsewhere on the board
WD4_N: Q149.G; also elsewhere on the board
WD5_N: Q150.G; also elsewhere on the board
WD6_N: Q151.G; also elsewhere on the board
WD7_N: Q152.G; also elsewhere on the board

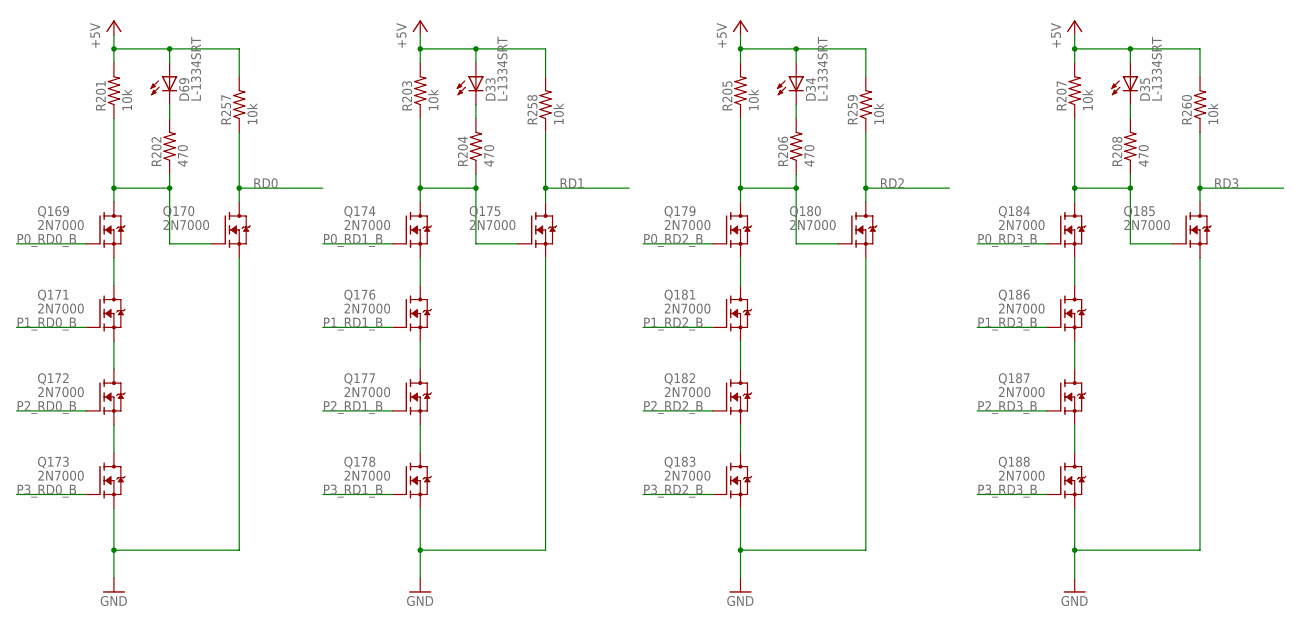
[picture p74: schematic MEM_MUX_3.sch, sheet 17]

Parts:
D33, D34, D35, D69: L-1334SRT; LED3MM
Q169, Q170, Q171, Q172, Q173, Q174, Q175, Q176, Q177, Q178, Q179, Q180, Q181, Q182, Q183, Q184, Q185, Q186, Q187, Q188: 2N7000; TO92-DGS
R201, R203, R205, R207, R257, R258, R259, R260: 10k; R_P2INCH
R202, R204, R206, R208: 470; R_P2INCH

Connections:
+5V: D33.A, D34.A, D35.A, D69.A, R201.2, R203.2, R205.2, R207.2, R257.2, R258.2, R259.2, R260.2; also elsewhere on the board
GND: Q170.S, Q173.S, Q175.S, Q178.S, Q180.S, Q183.S, Q185.S, Q188.S; also elsewhere on the board
unnamed: Q174.D, Q175.G, R203.1, R204.1
unnamed: D33.K (C), R204.2
unnamed: Q177.S, Q178.D
unnamed: Q176.S, Q177.D
unnamed: Q174.S, Q176.D
unnamed: Q179.D, Q180.G, R205.1, R206.1
unnamed: D34.K (C), R206.2
unnamed: Q182.S, Q183.D
unnamed: Q181.S, Q182.D
unnamed: Q179.S, Q181.D
unnamed: Q184.D, Q185.G, R207.1, R208.1
unnamed: D35.K (C), R208.2
unnamed: Q187.S, Q188.D
unnamed: Q186.S, Q187.D
unnamed: Q184.S, Q186.D
unnamed: Q169.D, Q170.G, R201.1, R202.1
unnamed: D69.K (C), R202.2
unnamed: Q172.S, Q173.D
unnamed: Q171.S, Q172.D
unnamed: Q169.S, Q171.D
P0_RD0_B: Q169.G; also elsewhere on the board
P0_RD1_B: Q174.G; also elsewhere on the board
P0_RD2_B: Q179.G; also elsewhere on the board
P0_RD3_B: Q184.G; also elsewhere on the board
P1_RD0_B: Q171.G; also elsewhere on the board
P1_RD1_B: Q176.G; also elsewhere on the board
P1_RD2_B: Q181.G; also elsewhere on the board
P1_RD3_B: Q186.G; also elsewhere on the board
P2_RD0_B: Q172.G; also elsewhere on the board
P2_RD1_B: Q177.G; also elsewhere on the board
P2_RD2_B: Q182.G; also elsewhere on the board
P2_RD3_B: Q187.G; also elsewhere on the board
P3_RD0_B: Q173.G; also elsewhere on the board
P3_RD1_B: Q178.G; also elsewhere on the board
P3_RD2_B: Q183.G; also elsewhere on the board
P3_RD3_B: Q188.G; also elsewhere on the board
RD0: Q170.D, R257.1; also elsewhere on the board
RD1: Q175.D, R258.1; also elsewhere on the board
RD2: Q180.D, R259.1; also elsewhere on the board
RD3: Q185.D, R260.1; also elsewhere on the board

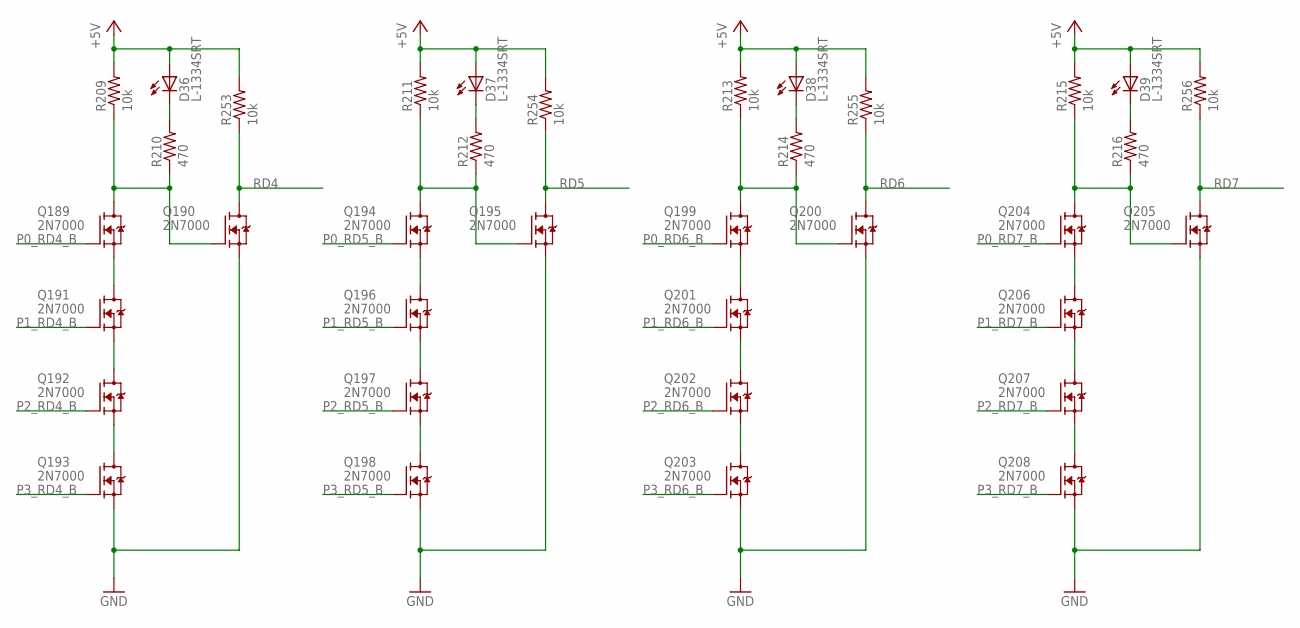
[picture p75: schematic MEM_MUX_3.sch, sheet 18]

Parts:
D36, D37, D38, D39: L-1334SRT; LED3MM
Q189, Q190, Q191, Q192, Q193, Q194, Q195, Q196, Q197, Q198, Q199, Q200, Q201, Q202, Q203, Q204, Q205, Q206, Q207, Q208: 2N7000; TO92-DGS
R209, R211, R213, R215, R253, R254, R255, R256: 10k; R_P2INCH
R210, R212, R214, R216: 470; R_P2INCH

Connections:
+5V: D36.A, D37.A, D38.A, D39.A, R209.2, R211.2, R213.2, R215.2, R253.2, R254.2, R255.2, R256.2; also elsewhere on the board
GND: Q190.S, Q193.S, Q195.S, Q198.S, Q200.S, Q203.S, Q205.S, Q208.S; also elsewhere on the board
unnamed: Q189.D, Q190.G, R209.1, R210.1
unnamed: D36.K (C), R210.2
unnamed: Q192.S, Q193.D
unnamed: Q191.S, Q192.D
unnamed: Q189.S, Q191.D
unnamed: Q194.D, Q195.G, R211.1, R212.1
unnamed: D37.K (C), R212.2
unnamed: Q197.S, Q198.D
unnamed: Q196.S, Q197.D
unnamed: Q194.S, Q196.D
unnamed: Q199.D, Q200.G, R213.1, R214.1
unnamed: D38.K (C), R214.2
unnamed: Q202.S, Q203.D
unnamed: Q201.S, Q202.D
unnamed: Q199.S, Q201.D
unnamed: Q204.D, Q205.G, R215.1, R216.1
unnamed: D39.K (C), R216.2
unnamed: Q207.S, Q208.D
unnamed: Q206.S, Q207.D
unnamed: Q204.S, Q206.D
P0_RD4_B: Q189.G; also elsewhere on the board
P0_RD5_B: Q194.G; also elsewhere on the board
P0_RD6_B: Q199.G; also elsewhere on the board
P0_RD7_B: Q204.G; also elsewhere on the board
P1_RD4_B: Q191.G; also elsewhere on the board
P1_RD5_B: Q196.G; also elsewhere on the board
P1_RD6_B: Q201.G; also elsewhere on the board
P1_RD7_B: Q206.G; also elsewhere on the board
P2_RD4_B: Q192.G; also elsewhere on the board
P2_RD5_B: Q197.G; also elsewhere on the board
P2_RD6_B: Q202.G; also elsewhere on the board
P2_RD7_B: Q207.G; also elsewhere on the board
P3_RD4_B: Q193.G; also elsewhere on the board
P3_RD5_B: Q198.G; also elsewhere on the board
P3_RD6_B: Q203.G; also elsewhere on the board
P3_RD7_B: Q208.G; also elsewhere on the board
RD4: Q190.D, R253.1; also elsewhere on the board
RD5: Q195.D, R254.1; also elsewhere on the board
RD6: Q200.D, R255.1; also elsewhere on the board
RD7: Q205.D, R256.1; also elsewhere on the board

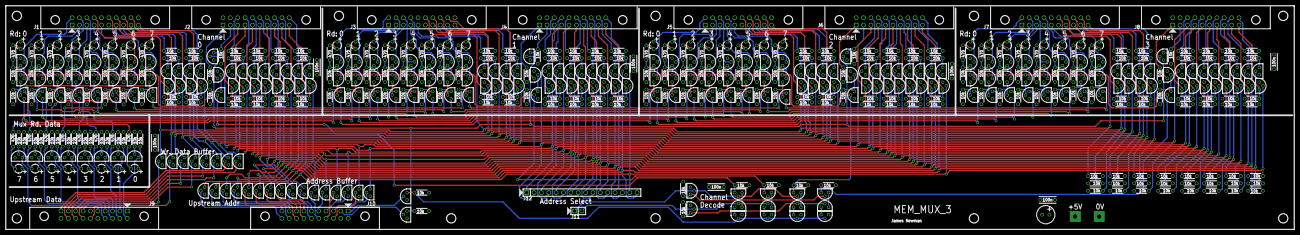
[picture p76: board MEM_MUX_3.brd from above]

Board: 4 copper layers, 444.5 x 77.1 mm, 584 parts (0 on the bottom side), 354 nets.
