ericherman/megaprocessor/module_artwork_decode_opcodes/module_decode_opcodes.brd

## EAGLE design module_artwork_decode_opcodes/module_decode_opcodes.brd (2017-05-20)

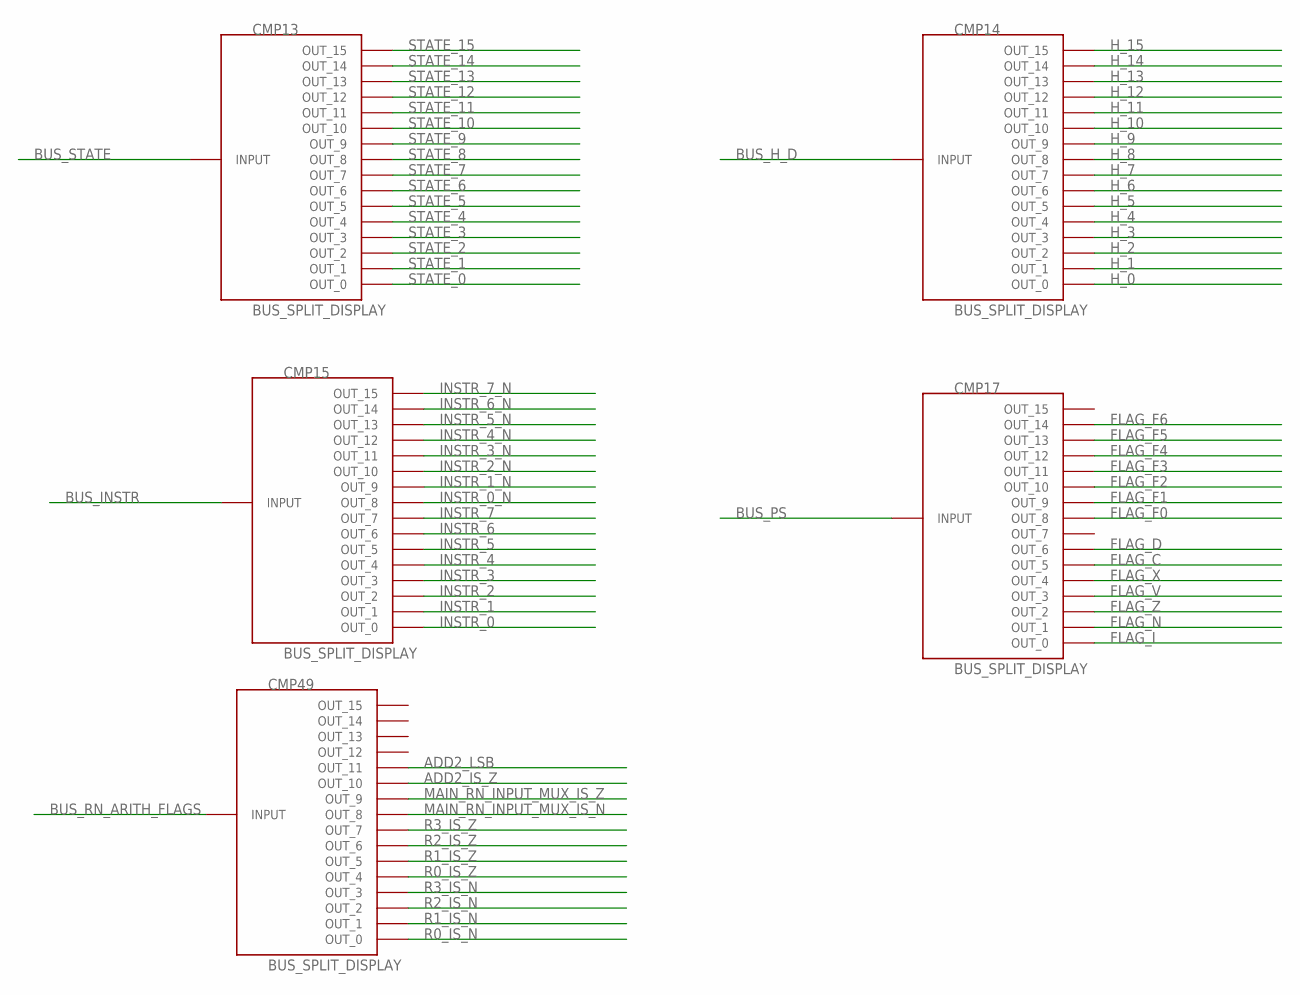
[picture p77: schematic module_decode_opcodes.sch, sheet 1]

Parts:
CMP13, CMP14, CMP15, CMP17, CMP49: BUS_SPLIT_DISPLAY

Connections:
ADD2_IS_Z: CMP49.P$11 (OUT_10)
ADD2_LSB: CMP49.P$12 (OUT_11)
BUS_H_D: CMP14.INPUT
BUS_INSTR: CMP15.INPUT
BUS_PS: CMP17.INPUT
BUS_RN_ARITH_FLAGS: CMP49.INPUT
BUS_STATE: CMP13.INPUT
FLAG_C: CMP17.P$6 (OUT_5)
FLAG_D: CMP17.P$7 (OUT_6)
FLAG_F0: CMP17.P$9 (OUT_8)
FLAG_F1: CMP17.P$10 (OUT_9)
FLAG_F2: CMP17.P$11 (OUT_10)
FLAG_F3: CMP17.P$12 (OUT_11)
FLAG_F4: CMP17.P$13 (OUT_12)
FLAG_F5: CMP17.P$14 (OUT_13)
FLAG_F6: CMP17.P$15 (OUT_14); also elsewhere on the board
FLAG_I: CMP17.P$1 (OUT_0); also elsewhere on the board
FLAG_N: CMP17.P$2 (OUT_1)
FLAG_V: CMP17.P$4 (OUT_3)
FLAG_X: CMP17.P$5 (OUT_4)
FLAG_Z: CMP17.P$3 (OUT_2)
H_0: CMP14.P$1 (OUT_0); also elsewhere on the board
H_1: CMP14.P$2 (OUT_1); also elsewhere on the board
H_2: CMP14.P$3 (OUT_2); also elsewhere on the board
H_3: CMP14.P$4 (OUT_3); also elsewhere on the board
H_4: CMP14.P$5 (OUT_4); also elsewhere on the board
H_5: CMP14.P$6 (OUT_5)
H_6: CMP14.P$7 (OUT_6); also elsewhere on the board
H_7: CMP14.P$8 (OUT_7); also elsewhere on the board
H_8: CMP14.P$9 (OUT_8)
H_9: CMP14.P$10 (OUT_9)
H_10: CMP14.P$11 (OUT_10)
H_11: CMP14.P$12 (OUT_11)
H_12: CMP14.P$13 (OUT_12)
H_13: CMP14.P$14 (OUT_13)
H_14: CMP14.P$15 (OUT_14)
H_15: CMP14.P$16 (OUT_15)
INSTR_0: CMP15.P$1 (OUT_0); also elsewhere on the board
INSTR_0_N: CMP15.P$9 (OUT_8)
INSTR_1: CMP15.P$2 (OUT_1); also elsewhere on the board
INSTR_1_N: CMP15.P$10 (OUT_9)
INSTR_2: CMP15.P$3 (OUT_2); also elsewhere on the board
INSTR_2_N: CMP15.P$11 (OUT_10); also elsewhere on the board
INSTR_3: CMP15.P$4 (OUT_3); also elsewhere on the board
INSTR_3_N: CMP15.P$12 (OUT_11); also elsewhere on the board
INSTR_4: CMP15.P$5 (OUT_4); also elsewhere on the board
INSTR_4_N: CMP15.P$13 (OUT_12)
INSTR_5: CMP15.P$6 (OUT_5); also elsewhere on the board
INSTR_5_N: CMP15.P$14 (OUT_13)
INSTR_6: CMP15.P$7 (OUT_6); also elsewhere on the board
INSTR_6_N: CMP15.P$15 (OUT_14); also elsewhere on the board
INSTR_7: CMP15.P$8 (OUT_7); also elsewhere on the board
INSTR_7_N: CMP15.P$16 (OUT_15); also elsewhere on the board
MAIN_RN_INPUT_MUX_IS_N: CMP49.P$9 (OUT_8)
MAIN_RN_INPUT_MUX_IS_Z: CMP49.P$10 (OUT_9)
R0_IS_N: CMP49.P$1 (OUT_0)
R0_IS_Z: CMP49.P$5 (OUT_4)
R1_IS_N: CMP49.P$2 (OUT_1)
R1_IS_Z: CMP49.P$6 (OUT_5); also elsewhere on the board
R2_IS_N: CMP49.P$3 (OUT_2)
R2_IS_Z: CMP49.P$7 (OUT_6)
R3_IS_N: CMP49.P$4 (OUT_3)
R3_IS_Z: CMP49.P$8 (OUT_7)
STATE_0: CMP13.P$1 (OUT_0); also elsewhere on the board
STATE_1: CMP13.P$2 (OUT_1); also elsewhere on the board
STATE_2: CMP13.P$3 (OUT_2); also elsewhere on the board
STATE_3: CMP13.P$4 (OUT_3); also elsewhere on the board
STATE_4: CMP13.P$5 (OUT_4)
STATE_5: CMP13.P$6 (OUT_5); also elsewhere on the board
STATE_6: CMP13.P$7 (OUT_6)
STATE_7: CMP13.P$8 (OUT_7); also elsewhere on the board
STATE_8: CMP13.P$9 (OUT_8)
STATE_9: CMP13.P$10 (OUT_9)
STATE_10: CMP13.P$11 (OUT_10)
STATE_11: CMP13.P$12 (OUT_11)
STATE_12: CMP13.P$13 (OUT_12)
STATE_13: CMP13.P$14 (OUT_13)
STATE_14: CMP13.P$15 (OUT_14)
STATE_15: CMP13.P$16 (OUT_15)

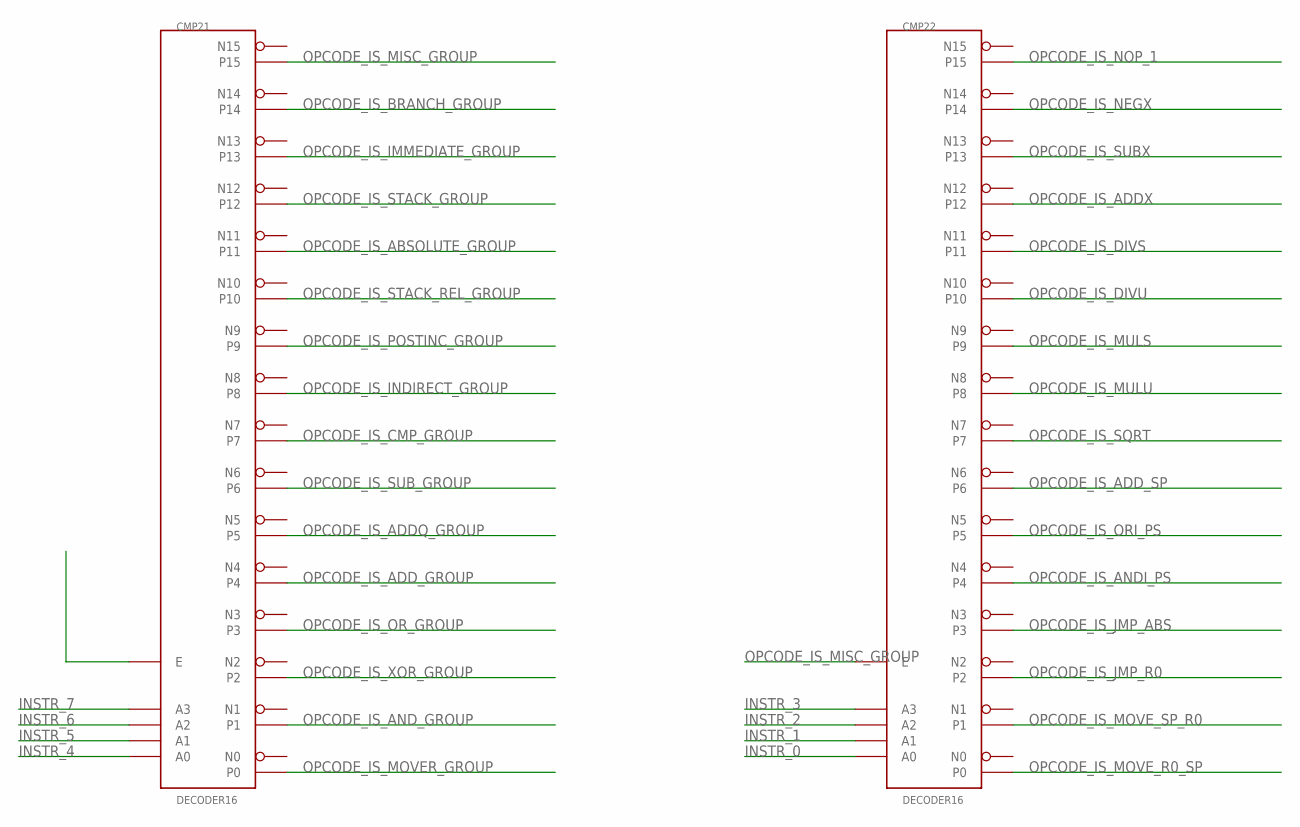
[picture p78: schematic module_decode_opcodes.sch, sheet 2]

Parts:
CMP21, CMP22: DECODER16

Connections:
INSTR_0: CMP22.A0; also elsewhere on the board
INSTR_1: CMP22.A1; also elsewhere on the board
INSTR_2: CMP22.A2; also elsewhere on the board
INSTR_3: CMP22.A3; also elsewhere on the board
INSTR_4: CMP21.A0; also elsewhere on the board
INSTR_5: CMP21.A1; also elsewhere on the board
INSTR_6: CMP21.A2; also elsewhere on the board
INSTR_7: CMP21.A3; also elsewhere on the board
OPCODE_IS_ABSOLUTE_GROUP: CMP21.P11; also elsewhere on the board
OPCODE_IS_ADDQ_GROUP: CMP21.P5; also elsewhere on the board
OPCODE_IS_ADDX: CMP22.P12; also elsewhere on the board
OPCODE_IS_ADD_GROUP: CMP21.P4; also elsewhere on the board
OPCODE_IS_ADD_SP: CMP22.P6; also elsewhere on the board
OPCODE_IS_ANDI_PS: CMP22.P4; also elsewhere on the board
OPCODE_IS_AND_GROUP: CMP21.P1; also elsewhere on the board
OPCODE_IS_BRANCH_GROUP: CMP21.P14; also elsewhere on the board
OPCODE_IS_CMP_GROUP: CMP21.P7; also elsewhere on the board
OPCODE_IS_DIVS: CMP22.P11; also elsewhere on the board
OPCODE_IS_DIVU: CMP22.P10; also elsewhere on the board
OPCODE_IS_IMMEDIATE_GROUP: CMP21.P13; also elsewhere on the board
OPCODE_IS_INDIRECT_GROUP: CMP21.P8; also elsewhere on the board
OPCODE_IS_JMP_ABS: CMP22.P3; also elsewhere on the board
OPCODE_IS_JMP_R0: CMP22.P2; also elsewhere on the board
OPCODE_IS_MISC_GROUP: CMP21.P15, CMP22.E
OPCODE_IS_MOVER_GROUP: CMP21.P0
OPCODE_IS_MOVE_R0_SP: CMP22.P0; also elsewhere on the board
OPCODE_IS_MOVE_SP_R0: CMP22.P1; also elsewhere on the board
OPCODE_IS_MULS: CMP22.P9; also elsewhere on the board
OPCODE_IS_MULU: CMP22.P8; also elsewhere on the board
OPCODE_IS_NEGX: CMP22.P14; also elsewhere on the board
OPCODE_IS_NOP_1: CMP22.P15; also elsewhere on the board
OPCODE_IS_ORI_PS: CMP22.P5; also elsewhere on the board
OPCODE_IS_OR_GROUP: CMP21.P3; also elsewhere on the board
OPCODE_IS_POSTINC_GROUP: CMP21.P9; also elsewhere on the board
OPCODE_IS_SQRT: CMP22.P7; also elsewhere on the board
OPCODE_IS_STACK_GROUP: CMP21.P12; also elsewhere on the board
OPCODE_IS_STACK_REL_GROUP: CMP21.P10; also elsewhere on the board
OPCODE_IS_SUBX: CMP22.P13; also elsewhere on the board
OPCODE_IS_SUB_GROUP: CMP21.P6; also elsewhere on the board
OPCODE_IS_XOR_GROUP: CMP21.P2; also elsewhere on the board

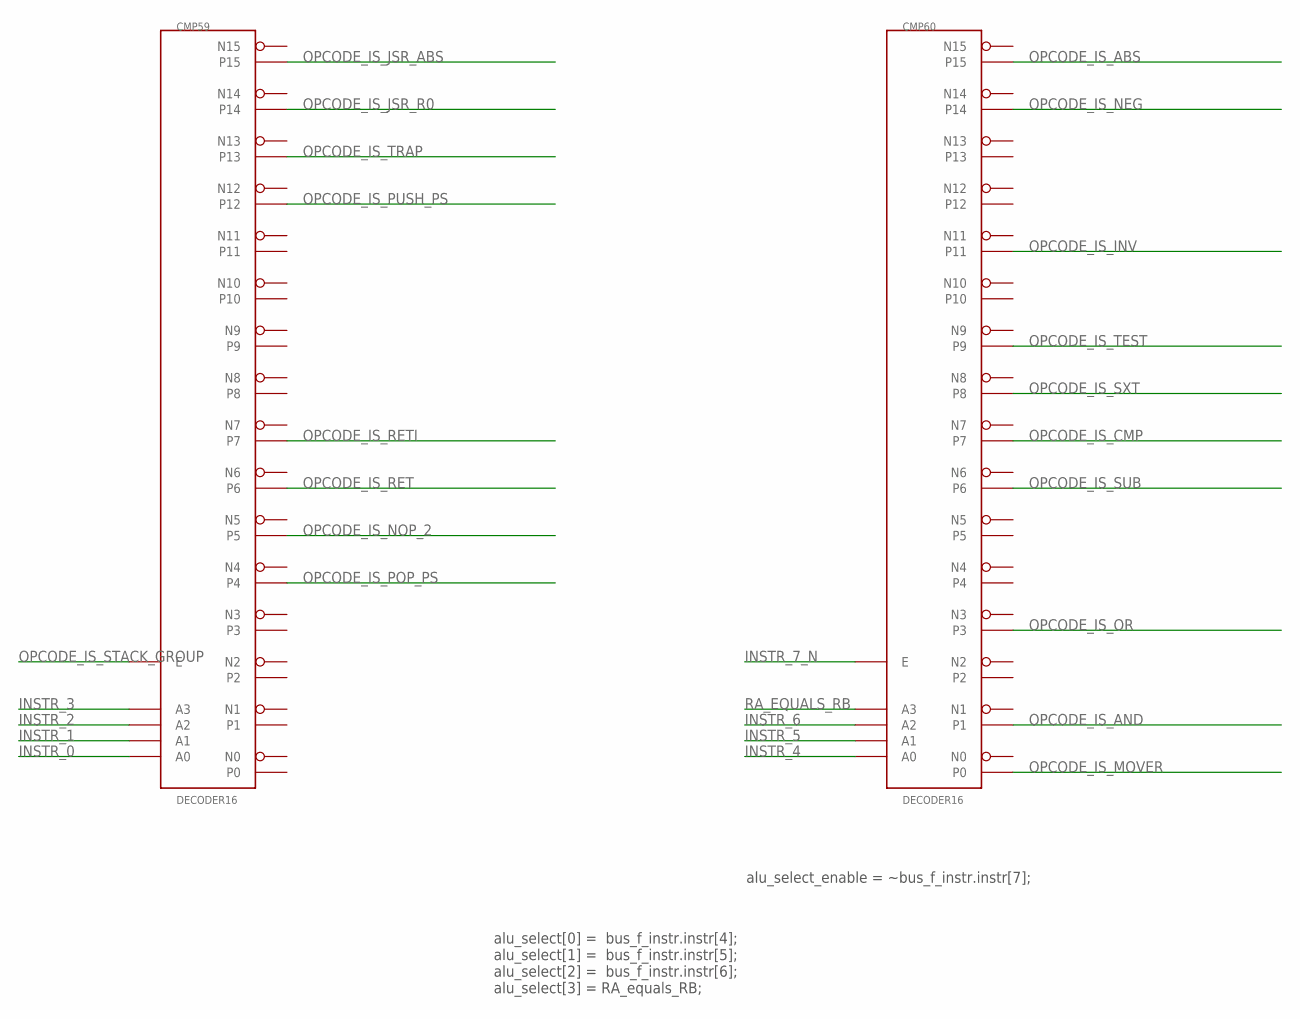
[picture p79: schematic module_decode_opcodes.sch, sheet 3]

Parts:
CMP59, CMP60: DECODER16

Connections:
INSTR_0: CMP59.A0; also elsewhere on the board
INSTR_1: CMP59.A1; also elsewhere on the board
INSTR_2: CMP59.A2; also elsewhere on the board
INSTR_3: CMP59.A3; also elsewhere on the board
INSTR_4: CMP60.A0; also elsewhere on the board
INSTR_5: CMP60.A1; also elsewhere on the board
INSTR_6: CMP60.A2; also elsewhere on the board
INSTR_7_N: CMP60.E; also elsewhere on the board
OPCODE_IS_ABS: CMP60.P15; also elsewhere on the board
OPCODE_IS_AND: CMP60.P1
OPCODE_IS_CMP: CMP60.P7; also elsewhere on the board
OPCODE_IS_INV: CMP60.P11; also elsewhere on the board
OPCODE_IS_JSR_ABS: CMP59.P15; also elsewhere on the board
OPCODE_IS_JSR_R0: CMP59.P14; also elsewhere on the board
OPCODE_IS_MOVER: CMP60.P0; also elsewhere on the board
OPCODE_IS_NEG: CMP60.P14; also elsewhere on the board
OPCODE_IS_NOP_2: CMP59.P5; also elsewhere on the board
OPCODE_IS_OR: CMP60.P3; also elsewhere on the board
OPCODE_IS_POP_PS: CMP59.P4; also elsewhere on the board
OPCODE_IS_PUSH_PS: CMP59.P12; also elsewhere on the board
OPCODE_IS_RET: CMP59.P6; also elsewhere on the board
OPCODE_IS_RETI: CMP59.P7; also elsewhere on the board
OPCODE_IS_STACK_GROUP: CMP59.E; also elsewhere on the board
OPCODE_IS_SUB: CMP60.P6; also elsewhere on the board
OPCODE_IS_SXT: CMP60.P8; also elsewhere on the board
OPCODE_IS_TEST: CMP60.P9; also elsewhere on the board
OPCODE_IS_TRAP: CMP59.P13; also elsewhere on the board
RA_EQUALS_RB: CMP60.A3; also elsewhere on the board

Notes on the sheet:
alu_select_enable = ~bus_f_instr.instr[7];
alu_select[0] = bus_f_instr.instr[4]; alu_select[1] = bus_f_instr.instr[5]; alu_select[2] = bus_f_instr.instr[6]; alu_select[3] = RA_equals_RB;
