ericherman/megaprocessor/module_artwork_decode_opcodes/module_decode_opcodes.brd

## EAGLE design module_artwork_decode_opcodes/module_decode_opcodes.brd (continued)

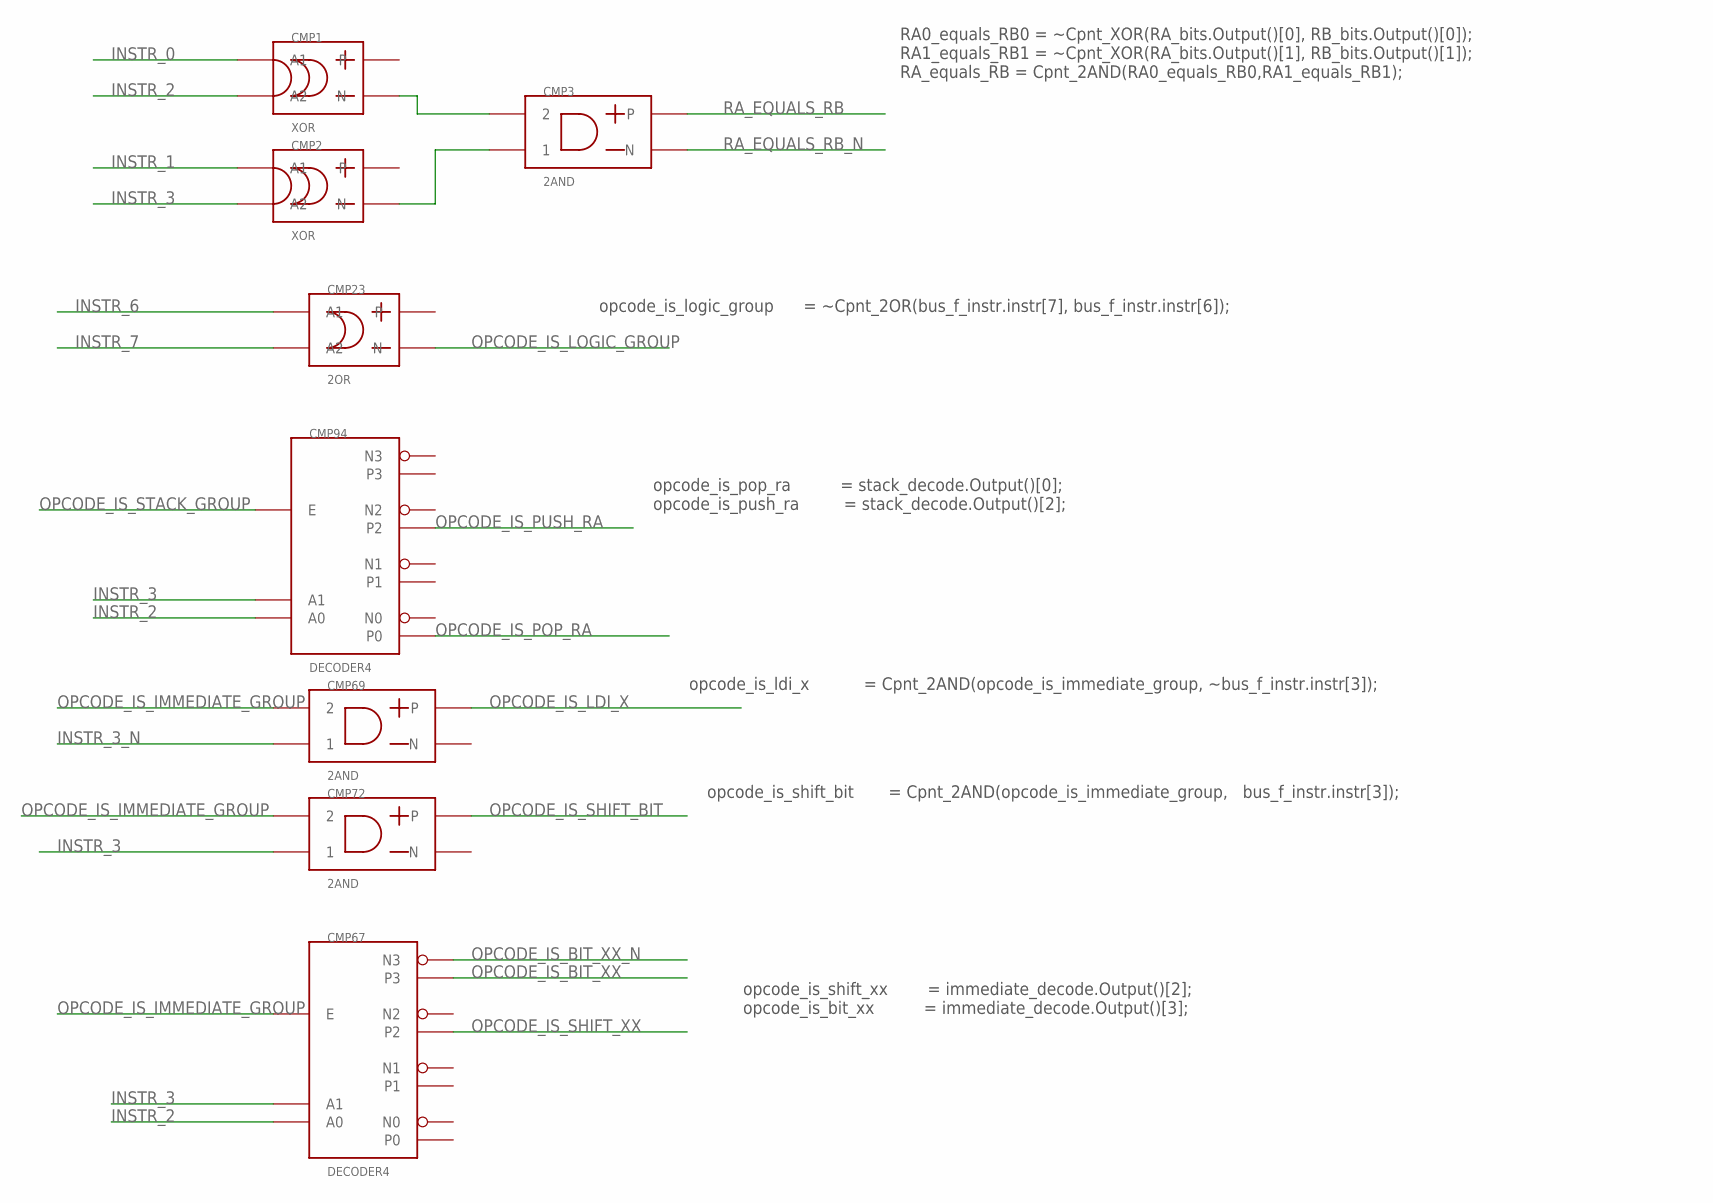
[picture p80: schematic module_decode_opcodes.sch, sheet 4]

Parts:
CMP1, CMP2: XOR
CMP3, CMP69, CMP72: 2AND
CMP23: 2OR
CMP67, CMP94: DECODER4

Connections:
INSTR_0: CMP1.P$1 (A1); also elsewhere on the board
INSTR_1: CMP2.P$1 (A1); also elsewhere on the board
INSTR_2: CMP1.P$2 (A2), CMP67.A0, CMP94.A0; also elsewhere on the board
INSTR_3: CMP2.P$2 (A2), CMP67.A1, CMP72.P$1 (1), CMP94.A1; also elsewhere on the board
INSTR_3_N: CMP69.P$1 (1); also elsewhere on the board
INSTR_6: CMP23.P$2 (A1); also elsewhere on the board
INSTR_7: CMP23.P$1 (A2); also elsewhere on the board
unnamed: CMP1.OUT_N (N), CMP3.P$2 (2)
unnamed: CMP2.OUT_N (N), CMP3.P$1 (1)
OPCODE_IS_BIT_XX: CMP67.P3; also elsewhere on the board
OPCODE_IS_BIT_XX_N: CMP67.N3; also elsewhere on the board
OPCODE_IS_IMMEDIATE_GROUP: CMP67.E, CMP69.P$2 (2), CMP72.P$2 (2); also elsewhere on the board
OPCODE_IS_LDI_X: CMP69.OUT_P; also elsewhere on the board
OPCODE_IS_LOGIC_GROUP: CMP23.OUT_M (N); also elsewhere on the board
OPCODE_IS_POP_RA: CMP94.P0; also elsewhere on the board
OPCODE_IS_PUSH_RA: CMP94.P2; also elsewhere on the board
OPCODE_IS_SHIFT_BIT: CMP72.OUT_P; also elsewhere on the board
OPCODE_IS_SHIFT_XX: CMP67.P2; also elsewhere on the board
OPCODE_IS_STACK_GROUP: CMP94.E; also elsewhere on the board
RA_EQUALS_RB: CMP3.OUT_P; also elsewhere on the board
RA_EQUALS_RB_N: CMP3.OUT_M (N)

Notes on the sheet:
RA0_equals_RB0 = ~Cpnt_XOR(RA_bits.Output()[0], RB_bits.Output()[0]); RA1_equals_RB1 = ~Cpnt_XOR(RA_bits.Output()[1], RB_bits.Output()[1]); RA_equals_RB = Cpnt_2AND(RA0_equals_RB0,RA1_equals_RB1);
opcode_is_logic_group = ~Cpnt_2OR(bus_f_instr.instr[7], bus_f_instr.instr[6]);
opcode_is_pop_ra = stack_decode.Output()[0]; opcode_is_push_ra = stack_decode.Output()[2];
opcode_is_ldi_x = Cpnt_2AND(opcode_is_immediate_group, ~bus_f_instr.instr[3]);
opcode_is_shift_bit = Cpnt_2AND(opcode_is_immediate_group, bus_f_instr.instr[3]);
opcode_is_shift_xx = immediate_decode.Output()[2]; opcode_is_bit_xx = immediate_decode.Output()[3];

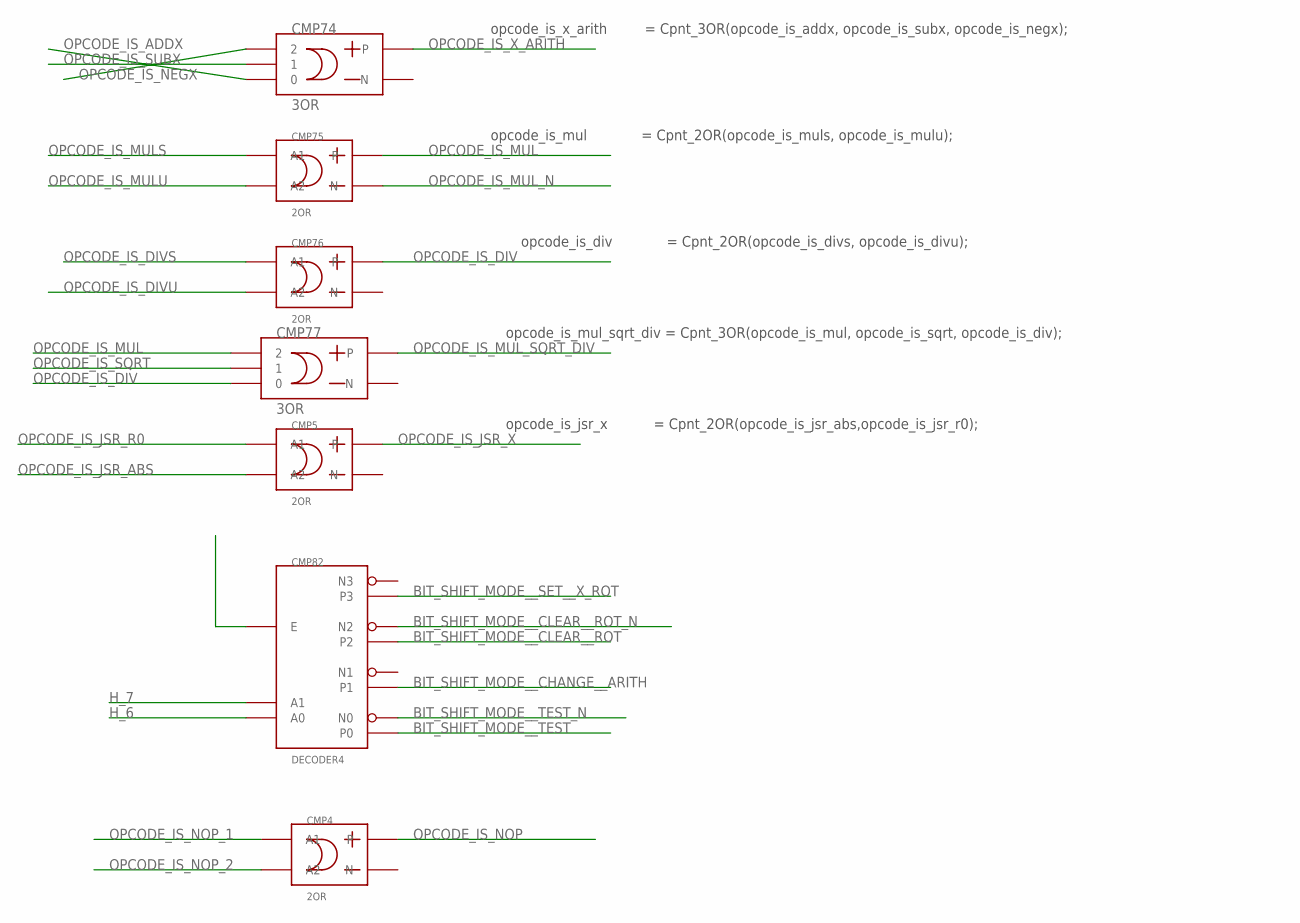
[picture p81: schematic module_decode_opcodes.sch, sheet 5]

Parts:
CMP4, CMP5, CMP75, CMP76: 2OR
CMP74, CMP77: 3OR
CMP82: DECODER4

Connections:
BIT_SHIFT_MODE__CHANGE__ARITH: CMP82.P1; also elsewhere on the board
BIT_SHIFT_MODE__CLEAR__ROT: CMP82.P2
BIT_SHIFT_MODE__CLEAR__ROT_N: CMP82.N2; also elsewhere on the board
BIT_SHIFT_MODE__SET__X_ROT: CMP82.P3; also elsewhere on the board
BIT_SHIFT_MODE__TEST: CMP82.P0
BIT_SHIFT_MODE__TEST_N: CMP82.N0; also elsewhere on the board
H_6: CMP82.A0; also elsewhere on the board
H_7: CMP82.A1; also elsewhere on the board
OPCODE_IS_ADDX: CMP74.P$1 (0); also elsewhere on the board
OPCODE_IS_DIV: CMP76.OUT_P, CMP77.P$1 (0); also elsewhere on the board
OPCODE_IS_DIVS: CMP76.P$2 (A1); also elsewhere on the board
OPCODE_IS_DIVU: CMP76.P$1 (A2); also elsewhere on the board
OPCODE_IS_JSR_ABS: CMP5.P$1 (A2); also elsewhere on the board
OPCODE_IS_JSR_R0: CMP5.P$2 (A1); also elsewhere on the board
OPCODE_IS_JSR_X: CMP5.OUT_P; also elsewhere on the board
OPCODE_IS_MUL: CMP75.OUT_P, CMP77.P$3 (2)
OPCODE_IS_MULS: CMP75.P$2 (A1); also elsewhere on the board
OPCODE_IS_MULU: CMP75.P$1 (A2); also elsewhere on the board
OPCODE_IS_MUL_N: CMP75.OUT_M (N); also elsewhere on the board
OPCODE_IS_MUL_SQRT_DIV: CMP77.OUT_P; also elsewhere on the board
OPCODE_IS_NEGX: CMP74.P$3 (2); also elsewhere on the board
OPCODE_IS_NOP: CMP4.OUT_P; also elsewhere on the board
OPCODE_IS_NOP_1: CMP4.P$2 (A1); also elsewhere on the board
OPCODE_IS_NOP_2: CMP4.P$1 (A2); also elsewhere on the board
OPCODE_IS_SQRT: CMP77.P$2 (1); also elsewhere on the board
OPCODE_IS_SUBX: CMP74.P$2 (1); also elsewhere on the board
OPCODE_IS_X_ARITH: CMP74.OUT_P; also elsewhere on the board

Notes on the sheet:
opcode_is_x_arith = Cpnt_3OR(opcode_is_addx, opcode_is_subx, opcode_is_negx);
opcode_is_mul = Cpnt_2OR(opcode_is_muls, opcode_is_mulu);
opcode_is_div = Cpnt_2OR(opcode_is_divs, opcode_is_divu);
opcode_is_mul_sqrt_div = Cpnt_3OR(opcode_is_mul, opcode_is_sqrt, opcode_is_div);
opcode_is_jsr_x = Cpnt_2OR(opcode_is_jsr_abs,opcode_is_jsr_r0);

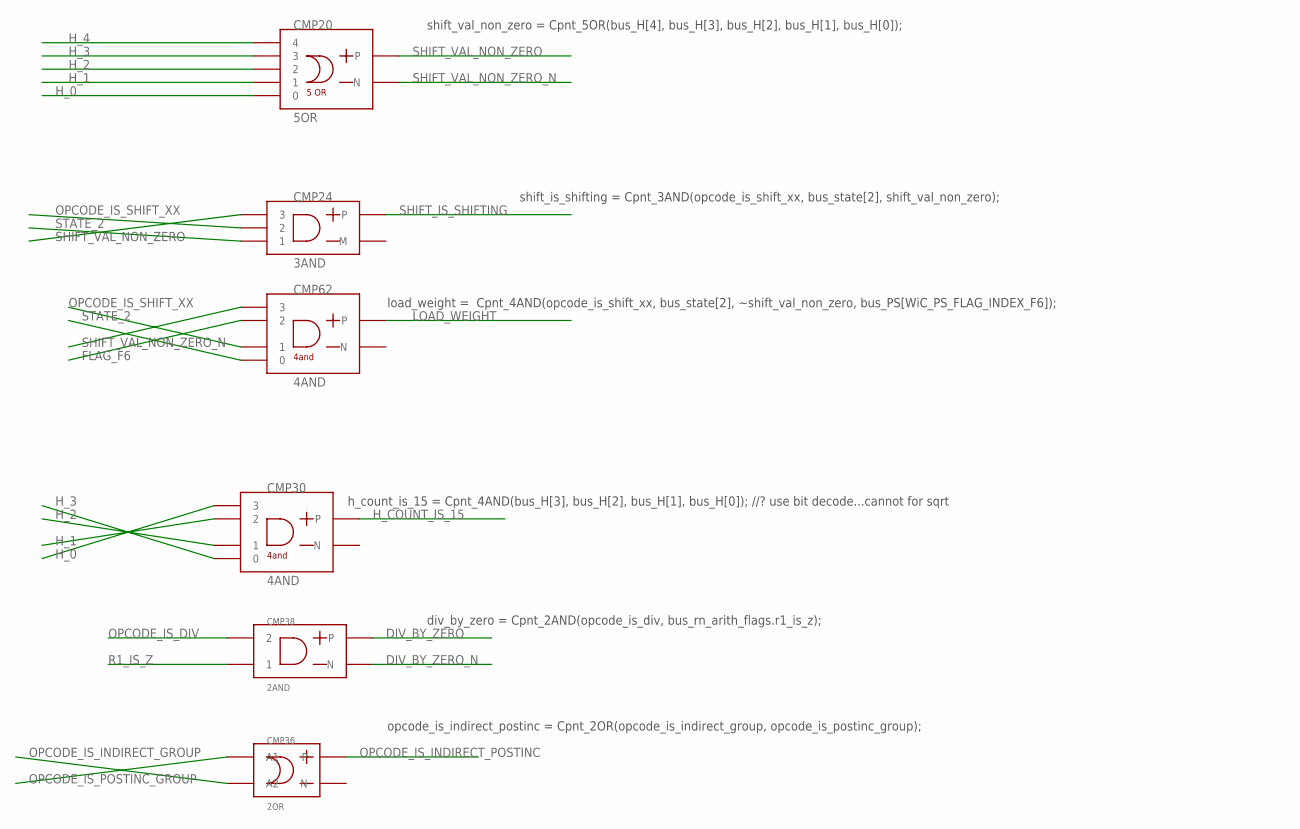
[picture p82: schematic module_decode_opcodes.sch, sheet 6]

Parts:
CMP20: 5OR
CMP24: 3AND
CMP30, CMP62: 4AND
CMP36: 2OR
CMP38: 2AND

Connections:
DIV_BY_ZERO: CMP38.OUT_P; also elsewhere on the board
DIV_BY_ZERO_N: CMP38.OUT_M (N); also elsewhere on the board
FLAG_F6: CMP62.P$3 (2); also elsewhere on the board
H_0: CMP20.1 (0), CMP30.P$4 (3); also elsewhere on the board
H_1: CMP20.2 (1), CMP30.P$3 (2); also elsewhere on the board
H_2: CMP20.3 (2), CMP30.P$2 (1); also elsewhere on the board
H_3: CMP20.4 (3), CMP30.P$1 (0); also elsewhere on the board
H_4: CMP20.5 (4); also elsewhere on the board
H_COUNT_IS_15: CMP30.OUT_P; also elsewhere on the board
LOAD_WEIGHT: CMP62.OUT_P; also elsewhere on the board
OPCODE_IS_DIV: CMP38.P$2 (2); also elsewhere on the board
OPCODE_IS_INDIRECT_GROUP: CMP36.P$1 (A2); also elsewhere on the board
OPCODE_IS_INDIRECT_POSTINC: CMP36.OUT_P; also elsewhere on the board
OPCODE_IS_POSTINC_GROUP: CMP36.P$2 (A1); also elsewhere on the board
OPCODE_IS_SHIFT_XX: CMP24.P$2 (2), CMP62.P$2 (1); also elsewhere on the board
R1_IS_Z: CMP38.P$1 (1); also elsewhere on the board
SHIFT_IS_SHIFTING: CMP24.OUT_P; also elsewhere on the board
SHIFT_VAL_NON_ZERO: CMP20.OUT_P, CMP24.P$3 (3); also elsewhere on the board
SHIFT_VAL_NON_ZERO_N: CMP20.OUT_M (N), CMP62.P$4 (3); also elsewhere on the board
STATE_2: CMP24.P$1 (1), CMP62.P$1 (0); also elsewhere on the board

Notes on the sheet:
h_count_is_15 = Cpnt_4AND(bus_H[3], bus_H[2], bus_H[1], bus_H[0]); //? use bit decode...cannot for sqrt
div_by_zero = Cpnt_2AND(opcode_is_div, bus_rn_arith_flags.r1_is_z);
shift_is_shifting = Cpnt_3AND(opcode_is_shift_xx, bus_state[2], shift_val_non_zero);
load_weight = Cpnt_4AND(opcode_is_shift_xx, bus_state[2], ~shift_val_non_zero, bus_PS[WiC_PS_FLAG_INDEX_F6]);
shift_val_non_zero = Cpnt_5OR(bus_H[4], bus_H[3], bus_H[2], bus_H[1], bus_H[0]);
opcode_is_indirect_postinc = Cpnt_2OR(opcode_is_indirect_group, opcode_is_postinc_group);

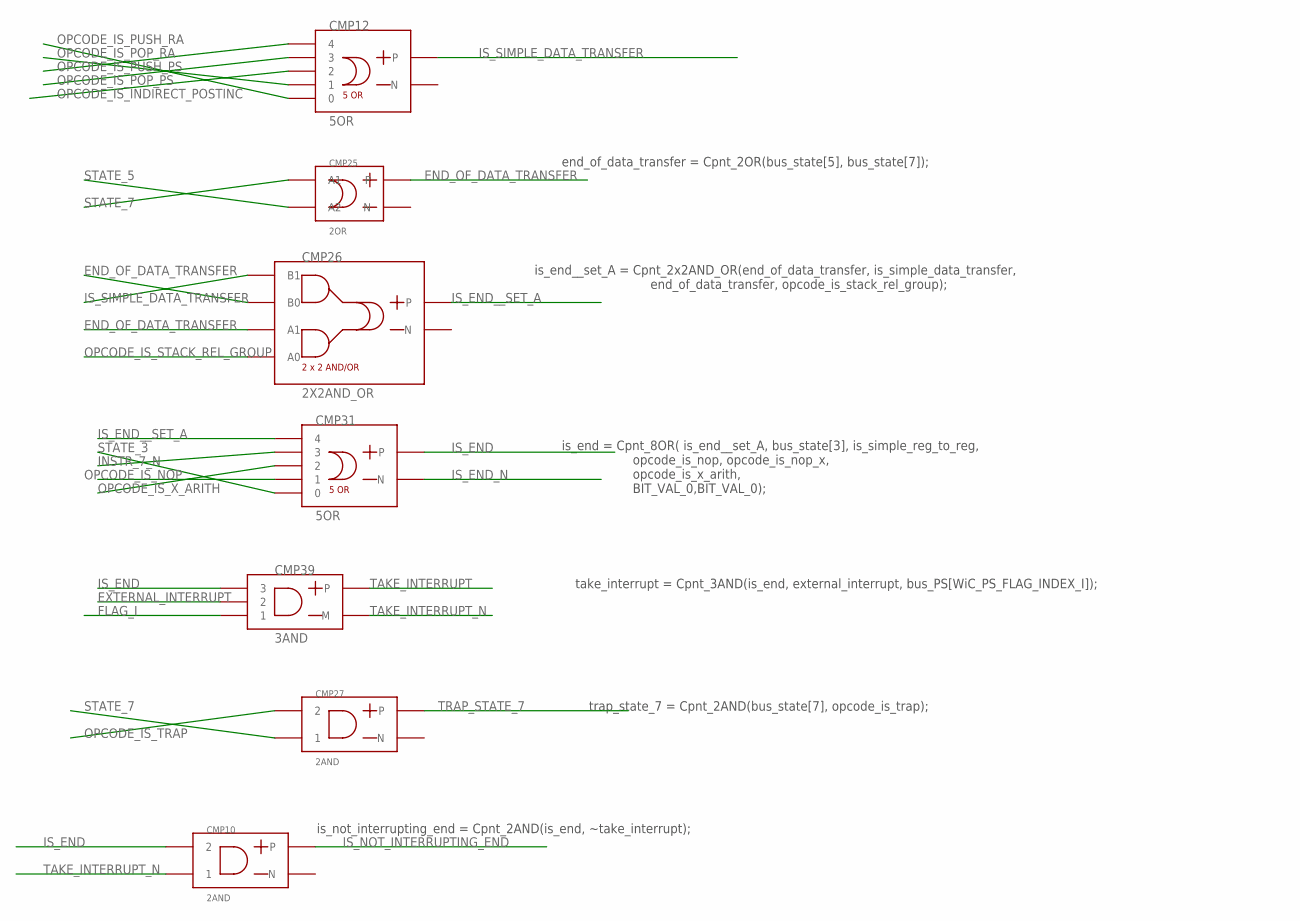
[picture p83: schematic module_decode_opcodes.sch, sheet 7]

Parts:
CMP10, CMP27: 2AND
CMP12, CMP31: 5OR
CMP25: 2OR
CMP26: 2X2AND_OR
CMP39: 3AND

Connections:
END_OF_DATA_TRANSFER: CMP25.OUT_P, CMP26.P$2 (A1), CMP26.P$3 (B0)
EXTERNAL_INTERRUPT: CMP39.P$2 (2)
FLAG_I: CMP39.P$1 (1); also elsewhere on the board
INSTR_7_N: CMP31.4 (3); also elsewhere on the board
IS_END: CMP10.P$2 (2), CMP31.OUT_P, CMP39.P$3 (3); also elsewhere on the board
IS_END_N: CMP31.OUT_M (N); also elsewhere on the board
IS_END__SET_A: CMP26.OUT_P, CMP31.5 (4)
IS_NOT_INTERRUPTING_END: CMP10.OUT_P; also elsewhere on the board
IS_SIMPLE_DATA_TRANSFER: CMP12.OUT_P, CMP26.P$4 (B1); also elsewhere on the board
OPCODE_IS_INDIRECT_POSTINC: CMP12.3 (2); also elsewhere on the board
OPCODE_IS_NOP: CMP31.2 (1); also elsewhere on the board
OPCODE_IS_POP_PS: CMP12.4 (3); also elsewhere on the board
OPCODE_IS_POP_RA: CMP12.2 (1); also elsewhere on the board
OPCODE_IS_PUSH_PS: CMP12.5 (4); also elsewhere on the board
OPCODE_IS_PUSH_RA: CMP12.1 (0); also elsewhere on the board
OPCODE_IS_STACK_REL_GROUP: CMP26.P$1 (A0); also elsewhere on the board
OPCODE_IS_TRAP: CMP27.P$2 (2); also elsewhere on the board
OPCODE_IS_X_ARITH: CMP31.3 (2); also elsewhere on the board
STATE_3: CMP31.1 (0); also elsewhere on the board
STATE_5: CMP25.P$1 (A2); also elsewhere on the board
STATE_7: CMP25.P$2 (A1), CMP27.P$1 (1); also elsewhere on the board
TAKE_INTERRUPT: CMP39.OUT_P; also elsewhere on the board
TAKE_INTERRUPT_N: CMP10.P$1 (1), CMP39.OUT_M (M)
TRAP_STATE_7: CMP27.OUT_P; also elsewhere on the board

Notes on the sheet:
end_of_data_transfer = Cpnt_2OR(bus_state[5], bus_state[7]);
is_end__set_A = Cpnt_2x2AND_OR(end_of_data_transfer, is_simple_data_transfer, end_of_data_transfer, opcode_is_stack_rel_group);
is_end = Cpnt_8OR( is_end__set_A, bus_state[3], is_simple_reg_to_reg, opcode_is_nop, opcode_is_nop_x, opcode_is_x_arith, BIT_VAL_0,BIT_VAL_0);
trap_state_7 = Cpnt_2AND(bus_state[7], opcode_is_trap);
take_interrupt = Cpnt_3AND(is_end, external_interrupt, bus_PS[WiC_PS_FLAG_INDEX_I]);
is_not_interrupting_end = Cpnt_2AND(is_end, ~take_interrupt);

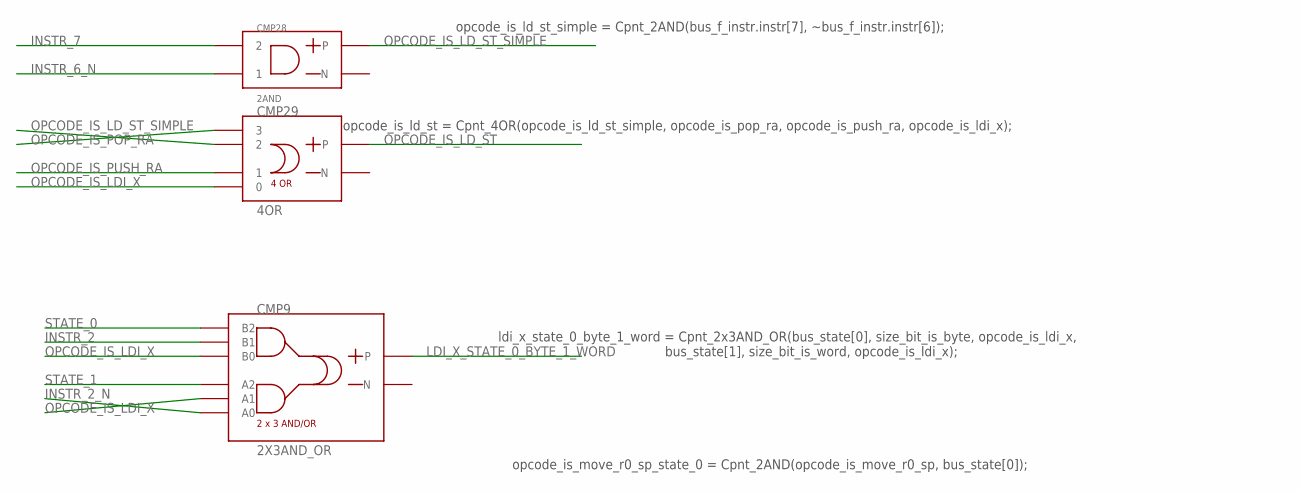
[picture p84: schematic module_decode_opcodes.sch, sheet 8]

Parts:
CMP9: 2X3AND_OR
CMP28: 2AND
CMP29: 4OR

Connections:
INSTR_2: CMP9.P$5 (B1); also elsewhere on the board
INSTR_2_N: CMP9.P$1 (A0); also elsewhere on the board
INSTR_6_N: CMP28.P$1 (1); also elsewhere on the board
INSTR_7: CMP28.P$2 (2); also elsewhere on the board
LDI_X_STATE_0_BYTE_1_WORD: CMP9.OUT_P; also elsewhere on the board
OPCODE_IS_LDI_X: CMP9.P$2 (A1), CMP9.P$4 (B0), CMP29.1 (0); also elsewhere on the board
OPCODE_IS_LD_ST: CMP29.OUT_P; also elsewhere on the board
OPCODE_IS_LD_ST_SIMPLE: CMP28.OUT_P, CMP29.3 (2)
OPCODE_IS_POP_RA: CMP29.4 (3); also elsewhere on the board
OPCODE_IS_PUSH_RA: CMP29.2 (1); also elsewhere on the board
STATE_0: CMP9.P$6 (B2); also elsewhere on the board
STATE_1: CMP9.P$3 (A2); also elsewhere on the board

Notes on the sheet:
ldi_x_state_0_byte_1_word = Cpnt_2x3AND_OR(bus_state[0], size_bit_is_byte, opcode_is_ldi_x, bus_state[1], size_bit_is_word, opcode_is_ldi_x);
opcode_is_move_r0_sp_state_0 = Cpnt_2AND(opcode_is_move_r0_sp, bus_state[0]);
opcode_is_ld_st_simple = Cpnt_2AND(bus_f_instr.instr[7], ~bus_f_instr.instr[6]);
opcode_is_ld_st = Cpnt_4OR(opcode_is_ld_st_simple, opcode_is_pop_ra, opcode_is_push_ra, opcode_is_ldi_x);

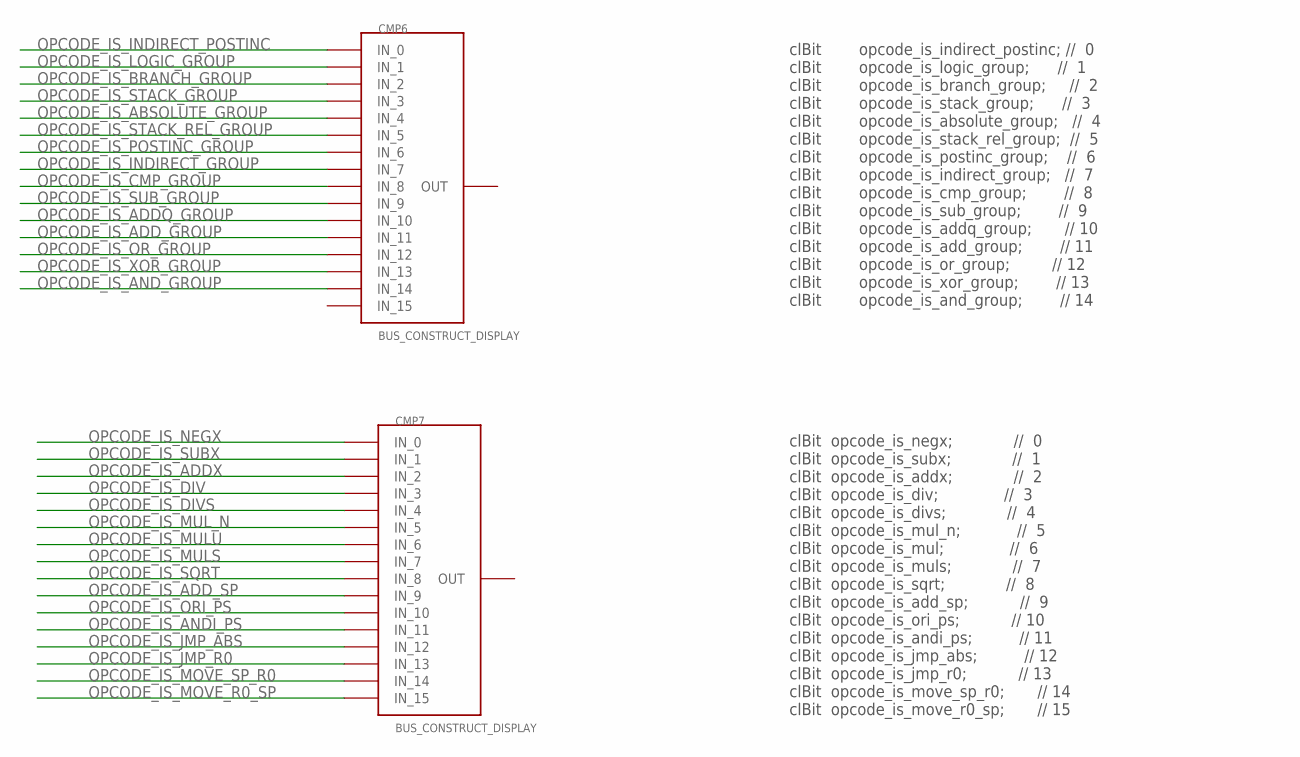
[picture p85: schematic module_decode_opcodes.sch, sheet 9]

Parts:
CMP6, CMP7: BUS_CONSTRUCT_DISPLAY; BUS_SPLIT_DISPLAY

Connections:
OPCODE_IS_ABSOLUTE_GROUP: CMP6.P$5 (IN_4); also elsewhere on the board
OPCODE_IS_ADDQ_GROUP: CMP6.P$11 (IN_10); also elsewhere on the board
OPCODE_IS_ADDX: CMP7.P$3 (IN_2); also elsewhere on the board
OPCODE_IS_ADD_GROUP: CMP6.P$12 (IN_11); also elsewhere on the board
OPCODE_IS_ADD_SP: CMP7.P$10 (IN_9); also elsewhere on the board
OPCODE_IS_ANDI_PS: CMP7.P$12 (IN_11); also elsewhere on the board
OPCODE_IS_AND_GROUP: CMP6.P$15 (IN_14); also elsewhere on the board
OPCODE_IS_BRANCH_GROUP: CMP6.P$3 (IN_2); also elsewhere on the board
OPCODE_IS_CMP_GROUP: CMP6.P$9 (IN_8); also elsewhere on the board
OPCODE_IS_DIV: CMP7.P$4 (IN_3); also elsewhere on the board
OPCODE_IS_DIVS: CMP7.P$5 (IN_4); also elsewhere on the board
OPCODE_IS_INDIRECT_GROUP: CMP6.P$8 (IN_7); also elsewhere on the board
OPCODE_IS_INDIRECT_POSTINC: CMP6.P$1 (IN_0); also elsewhere on the board
OPCODE_IS_JMP_ABS: CMP7.P$13 (IN_12); also elsewhere on the board
OPCODE_IS_JMP_R0: CMP7.P$14 (IN_13); also elsewhere on the board
OPCODE_IS_LOGIC_GROUP: CMP6.P$2 (IN_1); also elsewhere on the board
OPCODE_IS_MOVE_R0_SP: CMP7.P$16 (IN_15); also elsewhere on the board
OPCODE_IS_MOVE_SP_R0: CMP7.P$15 (IN_14); also elsewhere on the board
OPCODE_IS_MULS: CMP7.P$8 (IN_7); also elsewhere on the board
OPCODE_IS_MULU: CMP7.P$7 (IN_6); also elsewhere on the board
OPCODE_IS_MUL_N: CMP7.P$6 (IN_5); also elsewhere on the board
OPCODE_IS_NEGX: CMP7.P$1 (IN_0); also elsewhere on the board
OPCODE_IS_ORI_PS: CMP7.P$11 (IN_10); also elsewhere on the board
OPCODE_IS_OR_GROUP: CMP6.P$13 (IN_12); also elsewhere on the board
OPCODE_IS_POSTINC_GROUP: CMP6.P$7 (IN_6); also elsewhere on the board
OPCODE_IS_SQRT: CMP7.P$9 (IN_8); also elsewhere on the board
OPCODE_IS_STACK_GROUP: CMP6.P$4 (IN_3); also elsewhere on the board
OPCODE_IS_STACK_REL_GROUP: CMP6.P$6 (IN_5); also elsewhere on the board
OPCODE_IS_SUBX: CMP7.P$2 (IN_1); also elsewhere on the board
OPCODE_IS_SUB_GROUP: CMP6.P$10 (IN_9); also elsewhere on the board
OPCODE_IS_XOR_GROUP: CMP6.P$14 (IN_13); also elsewhere on the board

Notes on the sheet:
clBit opcode_is_indirect_postinc; // 0 clBit opcode_is_logic_group; // 1 clBit opcode_is_branch_group; // 2 clBit opcode_is_stack_group; // 3 clBit opcode_is_absolute_group; // 4 clBit opcode_is_stack_rel_group; // 5 clBit opcode_is_postinc_group; // 6 clBit opcode_is_indirect_group; // 7 clBit opc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
clBit opcode_is_negx; // 0 clBit opcode_is_subx; // 1 clBit opcode_is_addx; // 2 clBit opcode_is_div; // 3 clBit opcode_is_divs; // 4 clBit opcode_is_mul_n; // 5 clBit opcode_is_mul; // 6 clBit opcode_is_muls; // 7 clBit opcode_is_sqrt; // 8 clBit opcode_is_add_sp; // 9 clBit opcode_is_ori_ps; // 1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

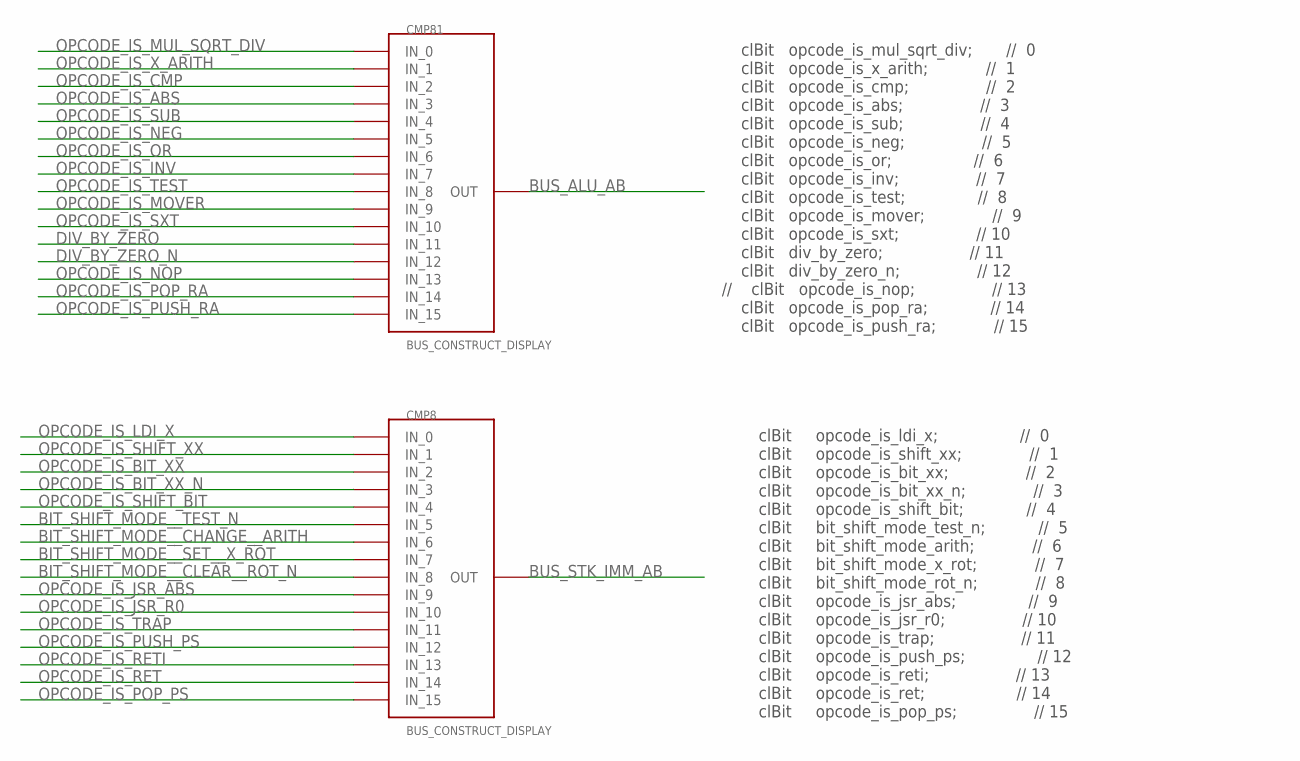
[picture p86: schematic module_decode_opcodes.sch, sheet 10]

Parts:
CMP8, CMP81: BUS_CONSTRUCT_DISPLAY; BUS_SPLIT_DISPLAY

Connections:
BIT_SHIFT_MODE__CHANGE__ARITH: CMP8.P$7 (IN_6); also elsewhere on the board
BIT_SHIFT_MODE__CLEAR__ROT_N: CMP8.P$9 (IN_8); also elsewhere on the board
BIT_SHIFT_MODE__SET__X_ROT: CMP8.P$8 (IN_7); also elsewhere on the board
BIT_SHIFT_MODE__TEST_N: CMP8.P$6 (IN_5); also elsewhere on the board
BUS_ALU_AB: CMP81.INPUT (OUT)
BUS_STK_IMM_AB: CMP8.INPUT (OUT)
DIV_BY_ZERO: CMP81.P$12 (IN_11); also elsewhere on the board
DIV_BY_ZERO_N: CMP81.P$13 (IN_12); also elsewhere on the board
OPCODE_IS_ABS: CMP81.P$4 (IN_3); also elsewhere on the board
OPCODE_IS_BIT_XX: CMP8.P$3 (IN_2); also elsewhere on the board
OPCODE_IS_BIT_XX_N: CMP8.P$4 (IN_3); also elsewhere on the board
OPCODE_IS_CMP: CMP81.P$3 (IN_2); also elsewhere on the board
OPCODE_IS_INV: CMP81.P$8 (IN_7); also elsewhere on the board
OPCODE_IS_JSR_ABS: CMP8.P$10 (IN_9); also elsewhere on the board
OPCODE_IS_JSR_R0: CMP8.P$11 (IN_10); also elsewhere on the board
OPCODE_IS_LDI_X: CMP8.P$1 (IN_0); also elsewhere on the board
OPCODE_IS_MOVER: CMP81.P$10 (IN_9); also elsewhere on the board
OPCODE_IS_MUL_SQRT_DIV: CMP81.P$1 (IN_0); also elsewhere on the board
OPCODE_IS_NEG: CMP81.P$6 (IN_5); also elsewhere on the board
OPCODE_IS_NOP: CMP81.P$14 (IN_13); also elsewhere on the board
OPCODE_IS_OR: CMP81.P$7 (IN_6); also elsewhere on the board
OPCODE_IS_POP_PS: CMP8.P$16 (IN_15); also elsewhere on the board
OPCODE_IS_POP_RA: CMP81.P$15 (IN_14); also elsewhere on the board
OPCODE_IS_PUSH_PS: CMP8.P$13 (IN_12); also elsewhere on the board
OPCODE_IS_PUSH_RA: CMP81.P$16 (IN_15); also elsewhere on the board
OPCODE_IS_RET: CMP8.P$15 (IN_14); also elsewhere on the board
OPCODE_IS_RETI: CMP8.P$14 (IN_13); also elsewhere on the board
OPCODE_IS_SHIFT_BIT: CMP8.P$5 (IN_4); also elsewhere on the board
OPCODE_IS_SHIFT_XX: CMP8.P$2 (IN_1); also elsewhere on the board
OPCODE_IS_SUB: CMP81.P$5 (IN_4); also elsewhere on the board
OPCODE_IS_SXT: CMP81.P$11 (IN_10); also elsewhere on the board
OPCODE_IS_TEST: CMP81.P$9 (IN_8); also elsewhere on the board
OPCODE_IS_TRAP: CMP8.P$12 (IN_11); also elsewhere on the board
OPCODE_IS_X_ARITH: CMP81.P$2 (IN_1); also elsewhere on the board

Notes on the sheet:
clBit opcode_is_ldi_x; // 0 clBit opcode_is_shift_xx; // 1 clBit opcode_is_bit_xx; // 2 clBit opcode_is_bit_xx_n; // 3 clBit opcode_is_shift_bit; // 4 clBit bit_shift_mode_test_n; // 5 clBit bit_shift_mode_arith; // 6 clBit bit_shift_mode_x_rot; // 7 clBit bit_shift_mode_rot_n; // 8 clBit opcode_is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
clBit opcode_is_mul_sqrt_div; // 0 clBit opcode_is_x_arith; // 1 clBit opcode_is_cmp; // 2 clBit opcode_is_abs; // 3 clBit opcode_is_sub; // 4 clBit opcode_is_neg; // 5 clBit opcode_is_or; // 6 clBit opcode_is_inv; // 7 clBit opcode_is_test; // 8 clBit opcode_is_mover; // 9 clBit opcode_is_sxt; // 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

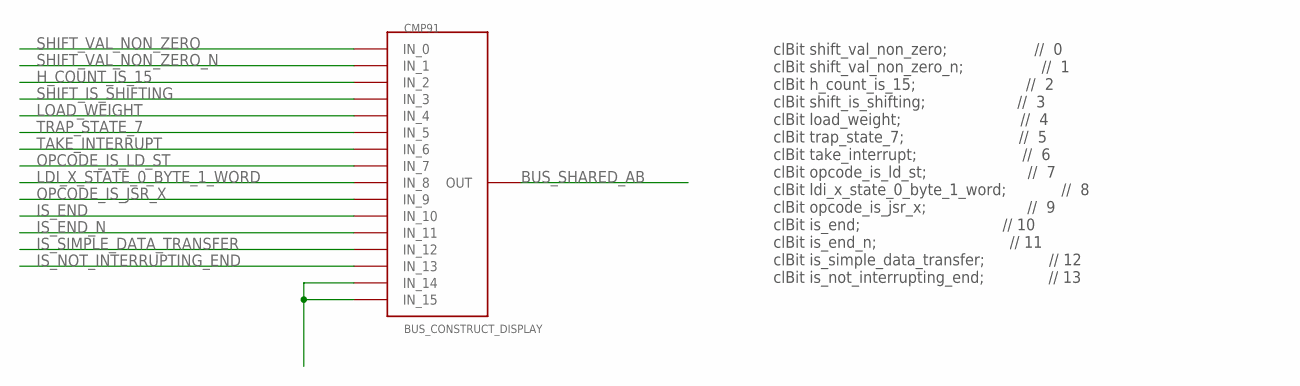
[picture p87: schematic module_decode_opcodes.sch, sheet 11]

Parts:
CMP91: BUS_CONSTRUCT_DISPLAY; BUS_SPLIT_DISPLAY

Connections:
BUS_SHARED_AB: CMP91.INPUT (OUT)
H_COUNT_IS_15: CMP91.P$3 (IN_2); also elsewhere on the board
IS_END: CMP91.P$11 (IN_10); also elsewhere on the board
IS_END_N: CMP91.P$12 (IN_11); also elsewhere on the board
IS_NOT_INTERRUPTING_END: CMP91.P$14 (IN_13); also elsewhere on the board
IS_SIMPLE_DATA_TRANSFER: CMP91.P$13 (IN_12); also elsewhere on the board
LDI_X_STATE_0_BYTE_1_WORD: CMP91.P$9 (IN_8); also elsewhere on the board
LOAD_WEIGHT: CMP91.P$5 (IN_4); also elsewhere on the board
unnamed: CMP91.P$15 (IN_14), CMP91.P$16 (IN_15)
OPCODE_IS_JSR_X: CMP91.P$10 (IN_9); also elsewhere on the board
OPCODE_IS_LD_ST: CMP91.P$8 (IN_7); also elsewhere on the board
SHIFT_IS_SHIFTING: CMP91.P$4 (IN_3); also elsewhere on the board
SHIFT_VAL_NON_ZERO: CMP91.P$1 (IN_0); also elsewhere on the board
SHIFT_VAL_NON_ZERO_N: CMP91.P$2 (IN_1); also elsewhere on the board
TAKE_INTERRUPT: CMP91.P$7 (IN_6); also elsewhere on the board
TRAP_STATE_7: CMP91.P$6 (IN_5); also elsewhere on the board

Notes on the sheet:
clBit shift_val_non_zero; // 0 clBit shift_val_non_zero_n; // 1 clBit h_count_is_15; // 2 clBit shift_is_shifting; // 3 clBit load_weight; // 4 clBit trap_state_7; // 5 clBit take_interrupt; // 6 clBit opcode_is_ld_st; // 7 clBit ldi_x_state_0_byte_1_word; // 8 clBit opcode_is_jsr_x; // 9 clBit is_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

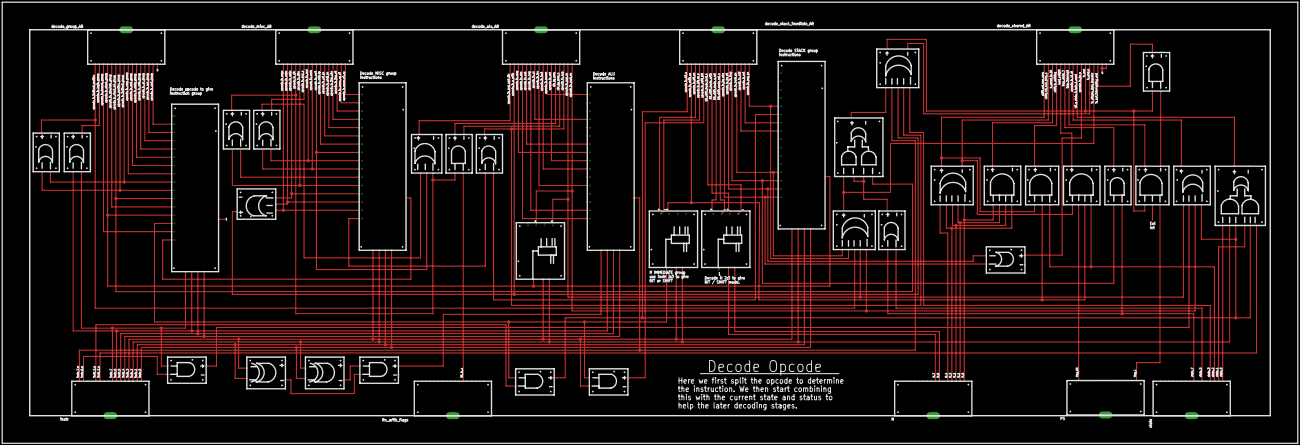
[picture p88: board module_decode_opcodes.brd from above]

Board: 2 copper layers, 1193.8 x 406.4 mm, 45 parts (0 on the bottom side), 119 nets.
