ericherman/megaprocessor/2x2and_or/2x2AND_OR_1.brd

## EAGLE design 2x2and_or/2x2AND_OR_1.brd (2017-05-20)

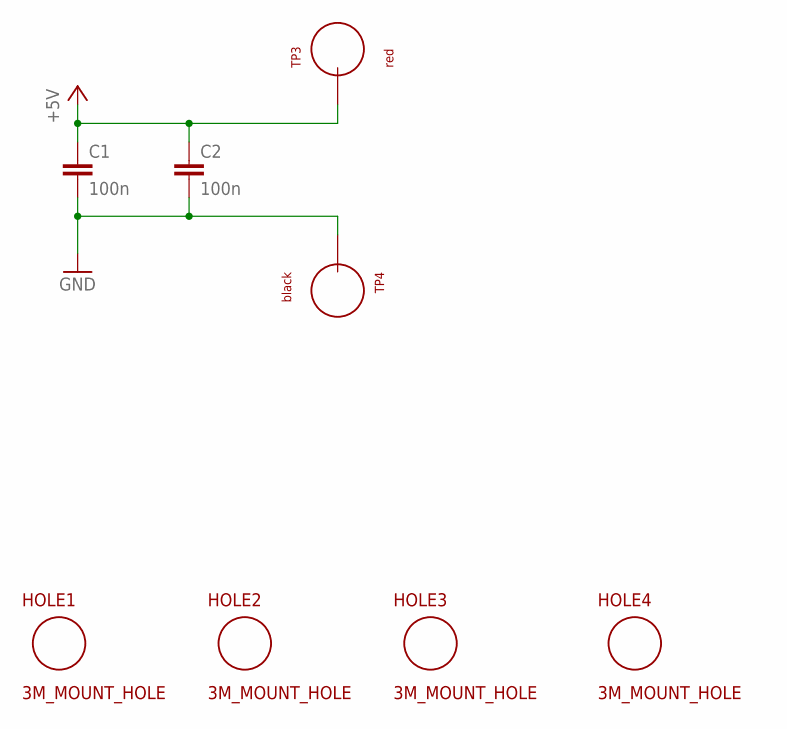
[picture p89: schematic 2x2AND_OR_1.sch, sheet 1]

Parts:
C1, C2: 100n; CAP_P2INCH
HOLE1, HOLE2, HOLE3, HOLE4: 3M_MOUNT_HOLE; 3M_HOLE
TP3: red; TEST_LOOP
TP4: black; TEST_LOOP

Connections:
+5V: C1.1, C2.1, TP3.P$1; also elsewhere on the board
GND: C1.2, C2.2, TP4.P$1; also elsewhere on the board

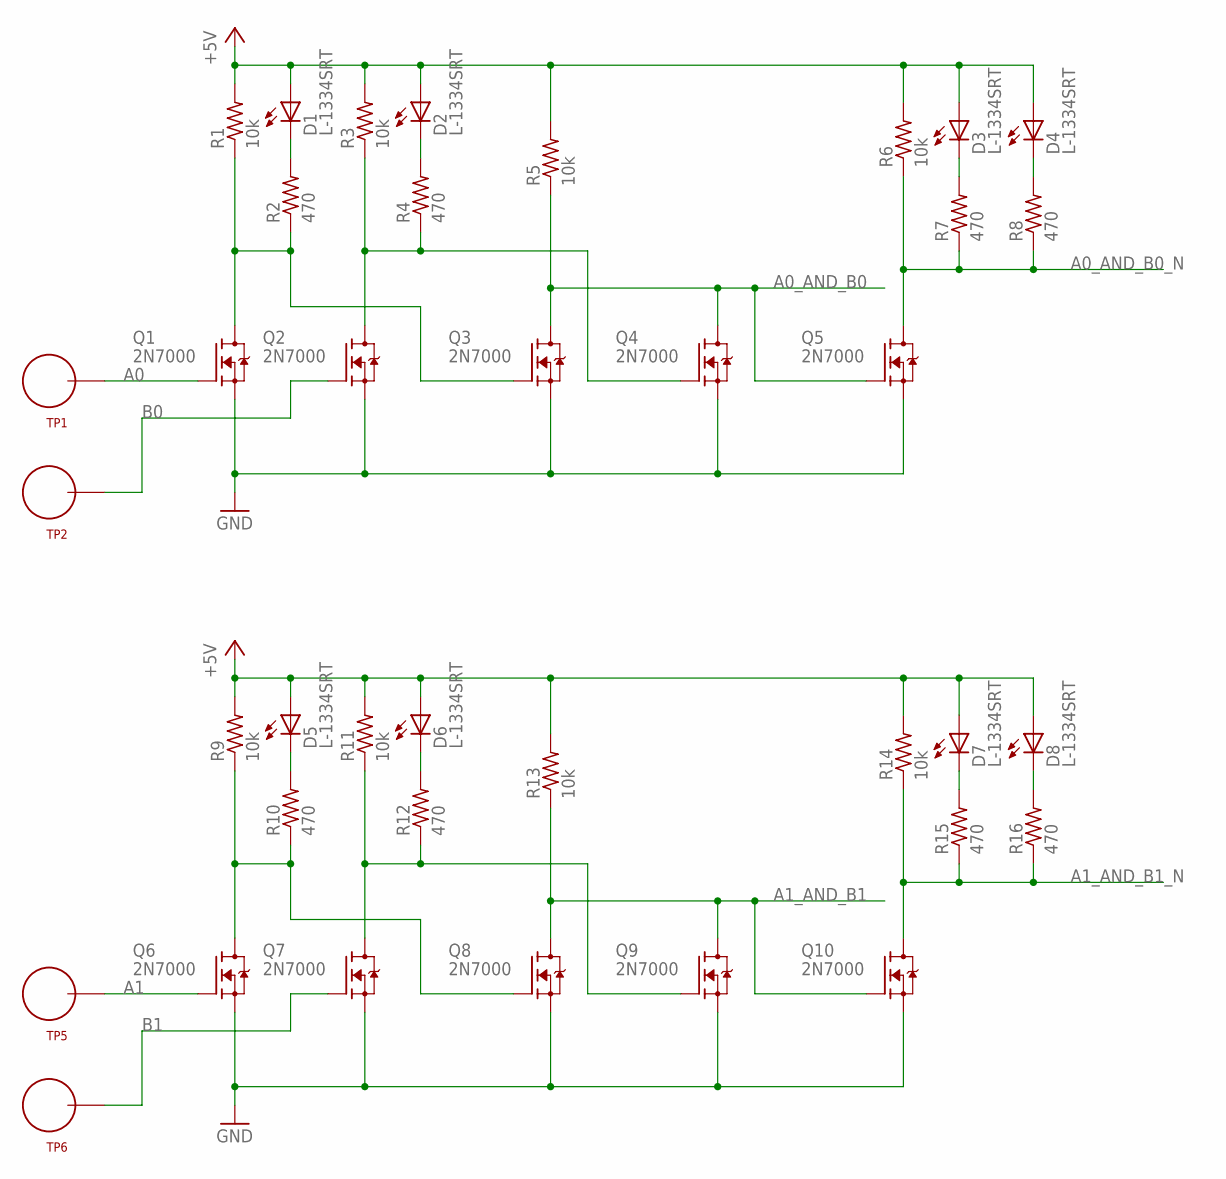
[picture p90: schematic 2x2AND_OR_1.sch, sheet 2]

Parts:
D1, D2, D3, D4, D5, D6, D7, D8: L-1334SRT; LED3MM
Q1, Q2, Q3, Q4, Q5, Q6, Q7, Q8, Q9, Q10: 2N7000; TO92-DGS
R1, R3, R5, R6, R9, R11, R13, R14: 10k; R_P2INCH
R2, R4, R7, R8, R10, R12, R15, R16: 470; R_P2INCH
TP1, TP2, TP5, TP6: TEST_LOOP

Connections:
+5V: D1.A, D2.A, D3.A, D4.A, D5.A, D6.A, D7.A, D8.A, R1.2, R3.2, R5.2, R6.2, R9.2, R11.2, R13.2, R14.2; also elsewhere on the board
A0: Q1.G, TP1.P$1
A0_AND_B0: Q3.D, Q4.D, Q5.G, R5.1; also elsewhere on the board
A0_AND_B0_N: Q5.D, R6.1, R7.1, R8.1
A1: Q6.G, TP5.P$1
A1_AND_B1: Q8.D, Q9.D, Q10.G, R13.1; also elsewhere on the board
A1_AND_B1_N: Q10.D, R14.1, R15.1, R16.1
B0: Q2.G, TP2.P$1
B1: Q7.G, TP6.P$1
GND: Q1.S, Q2.S, Q3.S, Q4.S, Q5.S, Q6.S, Q7.S, Q8.S, Q9.S, Q10.S; also elsewhere on the board
unnamed: D1.K (C), R2.2
unnamed: Q1.D, Q3.G, R1.1, R2.1
unnamed: D4.K (C), R8.2
unnamed: D2.K (C), R4.2
unnamed: Q2.D, Q4.G, R3.1, R4.1
unnamed: D5.K (C), R10.2
unnamed: Q6.D, Q8.G, R9.1, R10.1
unnamed: D6.K (C), R12.2
unnamed: D3.K (C), R7.2
unnamed: Q7.D, Q9.G, R11.1, R12.1
unnamed: D7.K (C), R15.2
unnamed: D8.K (C), R16.2

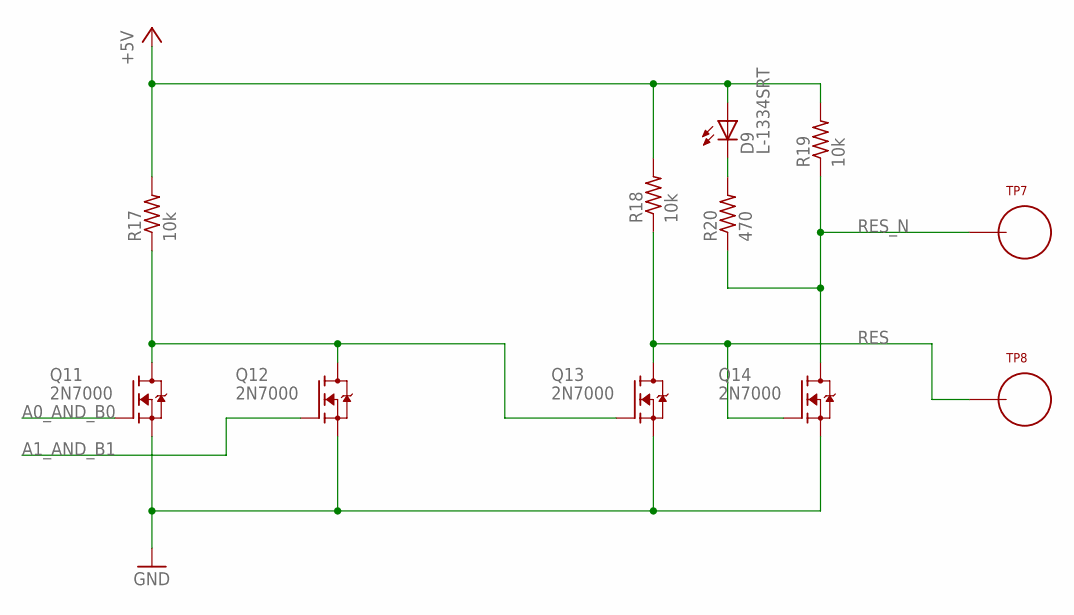
[picture p91: schematic 2x2AND_OR_1.sch, sheet 3]

Parts:
D9: L-1334SRT; LED3MM
Q11, Q12, Q13, Q14: 2N7000; TO92-DGS
R17, R18, R19: 10k; R_P2INCH
R20: 470; R_P2INCH
TP7, TP8: TEST_LOOP

Connections:
+5V: D9.A, R17.2, R18.2, R19.2; also elsewhere on the board
A0_AND_B0: Q11.G; also elsewhere on the board
A1_AND_B1: Q12.G; also elsewhere on the board
GND: Q11.S, Q12.S, Q13.S, Q14.S; also elsewhere on the board
unnamed: Q11.D, Q12.D, Q13.G, R17.1
unnamed: D9.K (C), R20.2
RES: Q13.D, Q14.G, R18.1, TP8.P$1
RES_N: Q14.D, R19.1, R20.1, TP7.P$1
