ericherman/megaprocessor/2x2and_or/2x2AND_OR_1.brd

## EAGLE design 2x2and_or/2x2AND_OR_1.brd (continued)

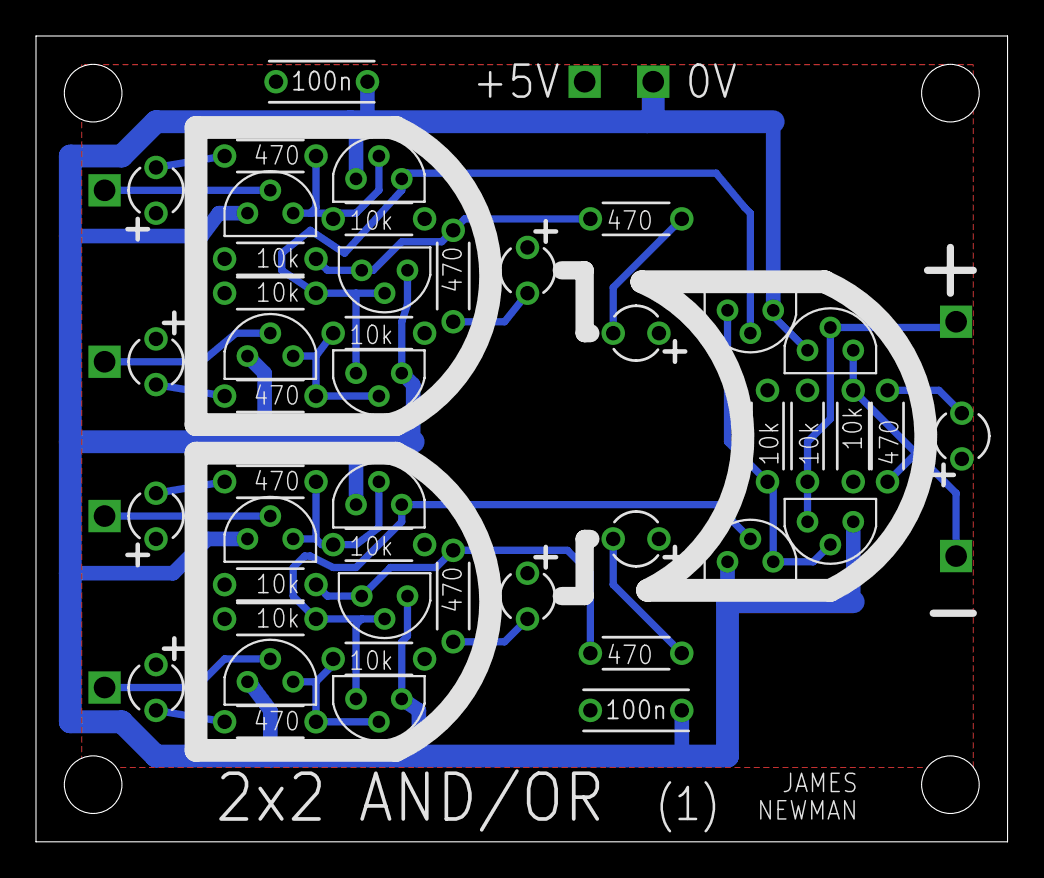
[picture p92: board 2x2AND_OR_1.brd from above]

Board: 2 copper layers, 54.0 x 44.8 mm, 57 parts (0 on the bottom side), 26 nets.
