ericherman/megaprocessor/8bit_add_sub/8BIT_ADD_SUB.brd

## EAGLE design 8bit_add_sub/8BIT_ADD_SUB.brd (2017-05-20)

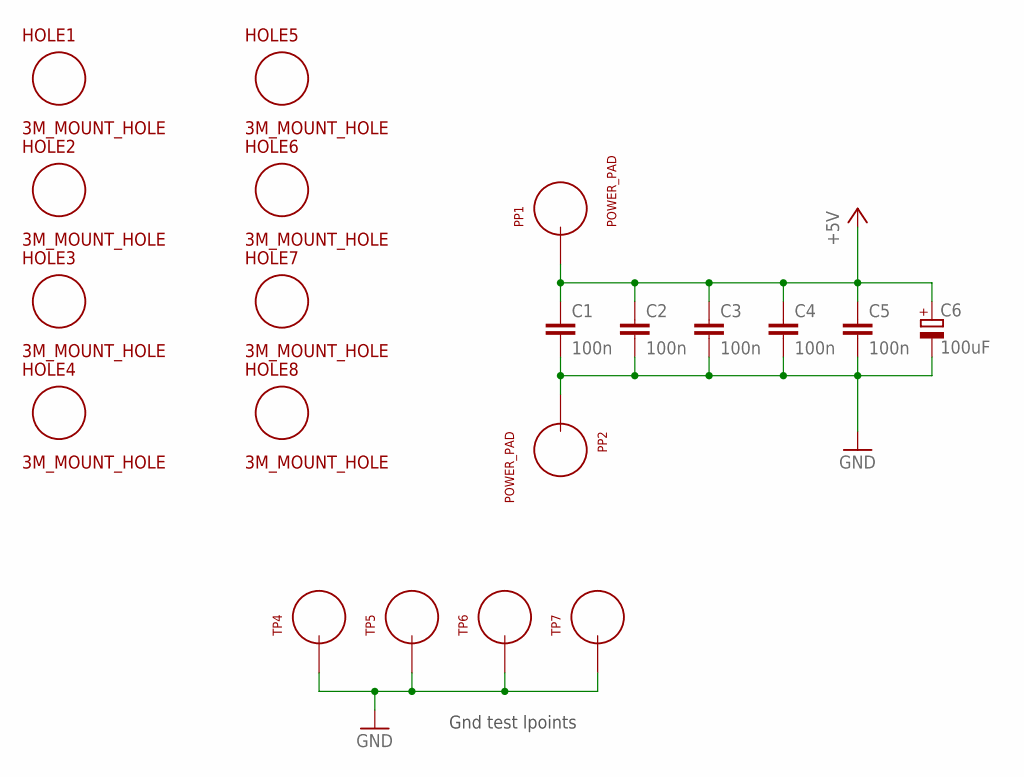
[picture p93: schematic 8BIT_ADD_SUB.sch, sheet 1]

Parts:
C1, C2, C3, C4, C5: 100n; CAP_P2INCH
C6: 100uF; POLARISED_CAP_2P5
HOLE1, HOLE2, HOLE3, HOLE4, HOLE5, HOLE6, HOLE7, HOLE8: 3M_MOUNT_HOLE; 3M_HOLE
PP1, PP2: POWER_PAD
TP4, TP5, TP6, TP7: TEST_LOOP

Connections:
+5V: C1.1, C2.1, C3.1, C4.1, C5.1, C6.A, PP1.1; also elsewhere on the board
GND: C1.2, C2.2, C3.2, C4.2, C5.2, C6.K, PP2.1, TP4.P$1, TP5.P$1, TP6.P$1, TP7.P$1; also elsewhere on the board

Notes on the sheet:
Gnd test lpoints

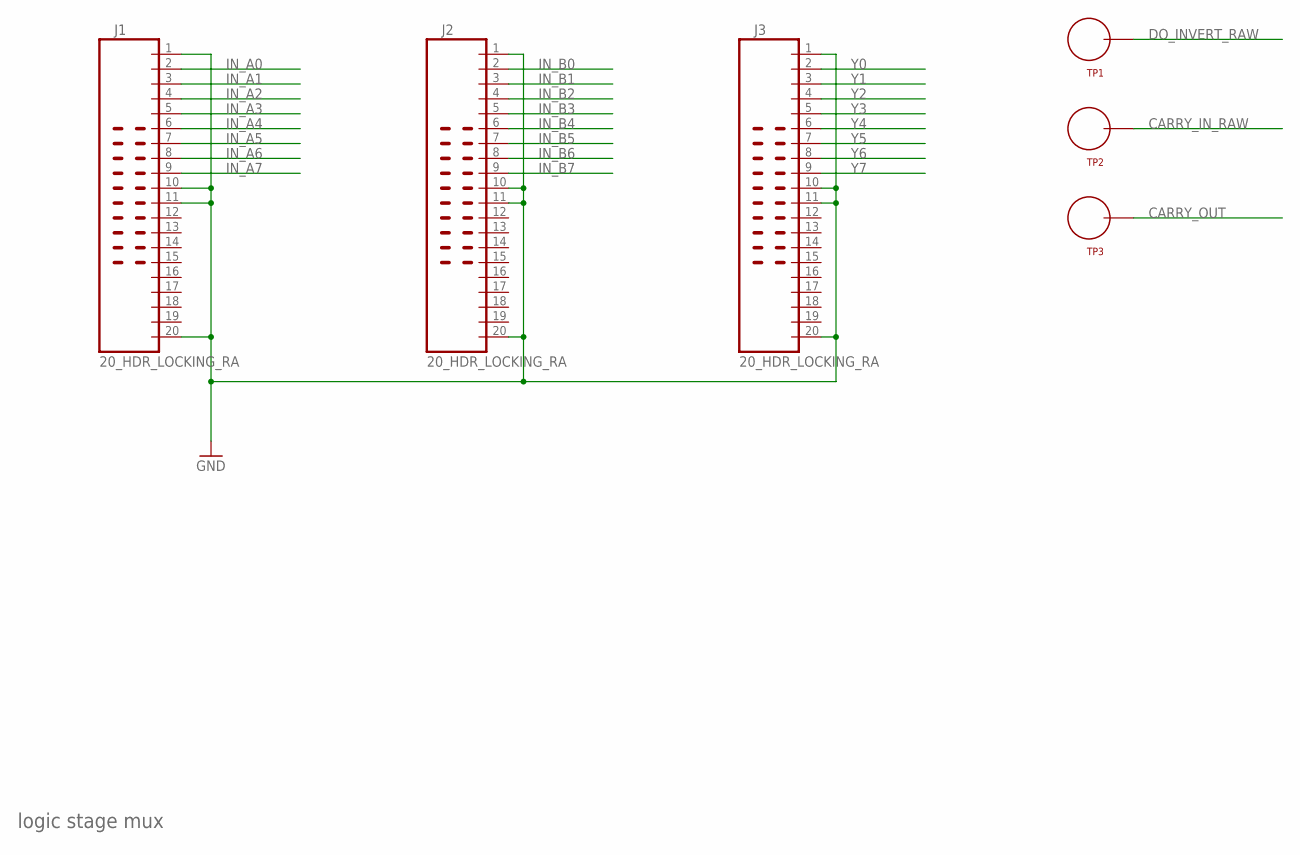
[picture p94: schematic 8BIT_ADD_SUB.sch, sheet 2]

Parts:
J1, J2, J3: 20_HDR_LOCKING_RA
TP1, TP2, TP3: TEST_LOOP

Connections:
CARRY_IN_RAW: TP2.P$1; also elsewhere on the board
CARRY_OUT: TP3.P$1; also elsewhere on the board
DO_INVERT_RAW: TP1.P$1; also elsewhere on the board
GND: J1.1, J1.10, J1.11, J1.20, J2.1, J2.10, J2.11, J2.20, J3.1, J3.10, J3.11, J3.20; also elsewhere on the board
IN_A0: J1.2; also elsewhere on the board
IN_A1: J1.3; also elsewhere on the board
IN_A2: J1.4; also elsewhere on the board
IN_A3: J1.5; also elsewhere on the board
IN_A4: J1.6; also elsewhere on the board
IN_A5: J1.7; also elsewhere on the board
IN_A6: J1.8; also elsewhere on the board
IN_A7: J1.9; also elsewhere on the board
IN_B0: J2.2; also elsewhere on the board
IN_B1: J2.3; also elsewhere on the board
IN_B2: J2.4; also elsewhere on the board
IN_B3: J2.5; also elsewhere on the board
IN_B4: J2.6; also elsewhere on the board
IN_B5: J2.7; also elsewhere on the board
IN_B6: J2.8; also elsewhere on the board
IN_B7: J2.9; also elsewhere on the board
Y0: J3.2; also elsewhere on the board
Y1: J3.3; also elsewhere on the board
Y2: J3.4; also elsewhere on the board
Y3: J3.5; also elsewhere on the board
Y4: J3.6; also elsewhere on the board
Y5: J3.7; also elsewhere on the board
Y6: J3.8; also elsewhere on the board
Y7: J3.9; also elsewhere on the board

Notes on the sheet:
logic stage mux

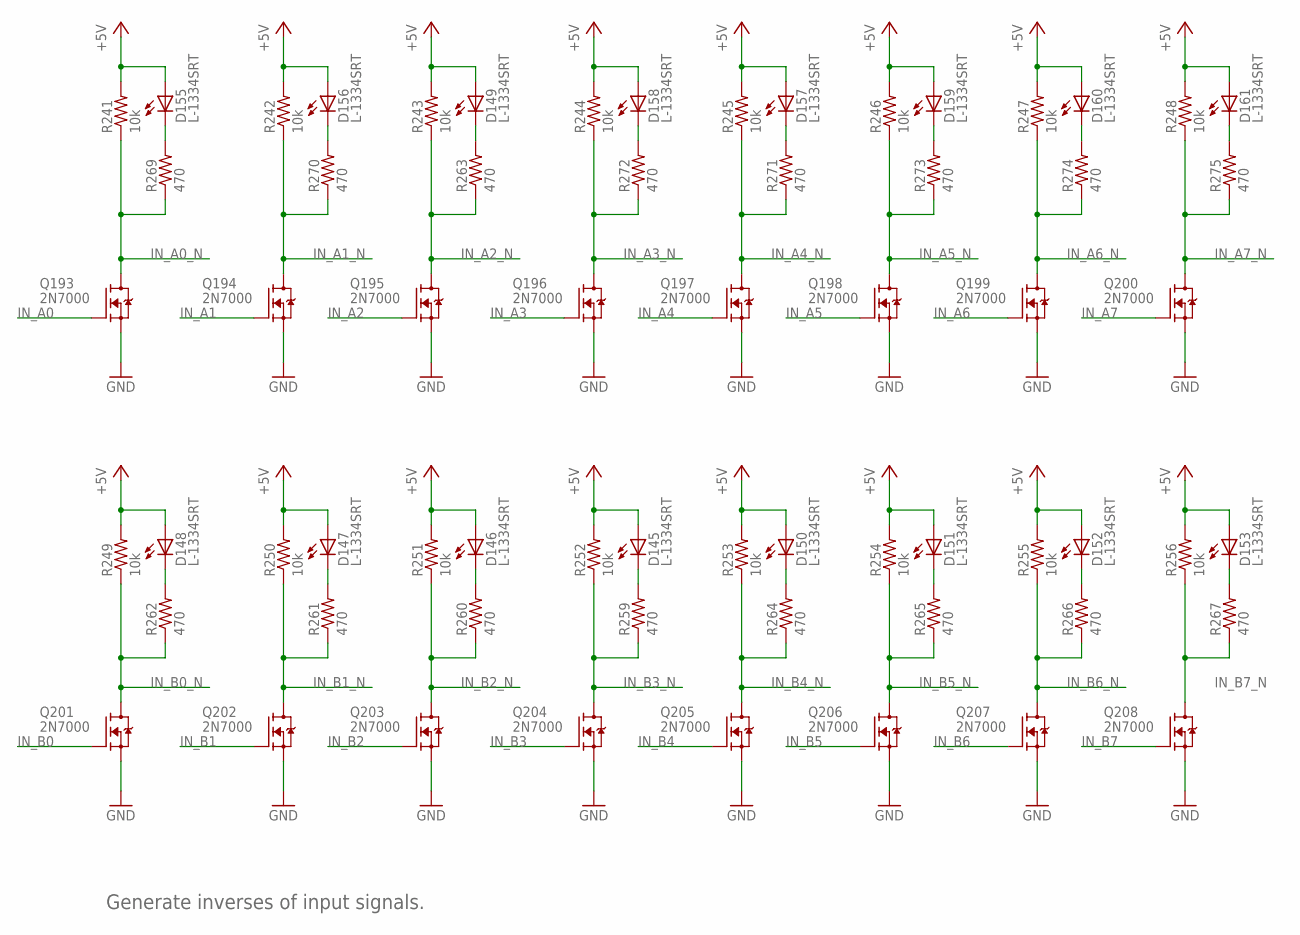
[picture p95: schematic 8BIT_ADD_SUB.sch, sheet 3]

Parts:
D145, D146, D147, D148, D149, D150, D151, D152, D153, D155, D156, D157, D158, D159, D160, D161: L-1334SRT; LED3MM
Q193, Q194, Q195, Q196, Q197, Q198, Q199, Q200, Q201, Q202, Q203, Q204, Q205, Q206, Q207, Q208: 2N7000; TO92-DGS
R241, R242, R243, R244, R245, R246, R247, R248, R249, R250, R251, R252, R253, R254, R255, R256: 10k; R_P2INCH
R259, R260, R261, R262, R263, R264, R265, R266, R267, R269, R270, R271, R272, R273, R274, R275: 470; R_P2INCH

Connections:
+5V: D145.A, D146.A, D147.A, D148.A, D149.A, D150.A, D151.A, D152.A, D153.A, D155.A, D156.A, D157.A, D158.A, D159.A, D160.A, D161.A, R241.2, R242.2, R243.2, R244.2, R245.2, R246.2, R247.2, R248.2, R249.2, R250.2, R251.2, R252.2, R253.2, R254.2, R255.2, R256.2; also elsewhere on the board
GND: Q193.S, Q194.S, Q195.S, Q196.S, Q197.S, Q198.S, Q199.S, Q200.S, Q201.S, Q202.S, Q203.S, Q204.S, Q205.S, Q206.S, Q207.S, Q208.S; also elsewhere on the board
IN_A0: Q193.G; also elsewhere on the board
IN_A0_N: Q193.D, R241.1, R269.1; also elsewhere on the board
IN_A1: Q194.G; also elsewhere on the board
IN_A1_N: Q194.D, R242.1, R270.1; also elsewhere on the board
IN_A2: Q195.G; also elsewhere on the board
IN_A2_N: Q195.D, R243.1, R263.1; also elsewhere on the board
IN_A3: Q196.G; also elsewhere on the board
IN_A3_N: Q196.D, R244.1, R272.1; also elsewhere on the board
IN_A4: Q197.G; also elsewhere on the board
IN_A4_N: Q197.D, R245.1, R271.1; also elsewhere on the board
IN_A5: Q198.G; also elsewhere on the board
IN_A5_N: Q198.D, R246.1, R273.1; also elsewhere on the board
IN_A6: Q199.G; also elsewhere on the board
IN_A6_N: Q199.D, R247.1, R274.1; also elsewhere on the board
IN_A7: Q200.G; also elsewhere on the board
IN_A7_N: Q200.D, R248.1, R275.1; also elsewhere on the board
IN_B0: Q201.G; also elsewhere on the board
IN_B0_N: Q201.D, R249.1, R262.1; also elsewhere on the board
IN_B1: Q202.G; also elsewhere on the board
IN_B1_N: Q202.D, R250.1, R261.1; also elsewhere on the board
IN_B2: Q203.G; also elsewhere on the board
IN_B2_N: Q203.D, R251.1, R260.1; also elsewhere on the board
IN_B3: Q204.G; also elsewhere on the board
IN_B3_N: Q204.D, R252.1, R259.1; also elsewhere on the board
IN_B4: Q205.G; also elsewhere on the board
IN_B4_N: Q205.D, R253.1, R264.1; also elsewhere on the board
IN_B5: Q206.G; also elsewhere on the board
IN_B5_N: Q206.D, R254.1, R265.1; also elsewhere on the board
IN_B6: Q207.G; also elsewhere on the board
IN_B6_N: Q207.D, R255.1, R266.1; also elsewhere on the board
IN_B7: Q208.G; also elsewhere on the board
IN_B7_N: Q208.D, R256.1, R267.1; also elsewhere on the board
unnamed: D145.K (C), R259.2
unnamed: D146.K (C), R260.2
unnamed: D147.K (C), R261.2
unnamed: D148.K (C), R262.2
unnamed: D149.K (C), R263.2
unnamed: D150.K (C), R264.2
unnamed: D151.K (C), R265.2
unnamed: D152.K (C), R266.2
unnamed: D153.K (C), R267.2
unnamed: D155.K (C), R269.2
unnamed: D156.K (C), R270.2
unnamed: D157.K (C), R271.2
unnamed: D158.K (C), R272.2
unnamed: D159.K (C), R273.2
unnamed: D160.K (C), R274.2
unnamed: D161.K (C), R275.2

Notes on the sheet:
Generate inverses of input signals.

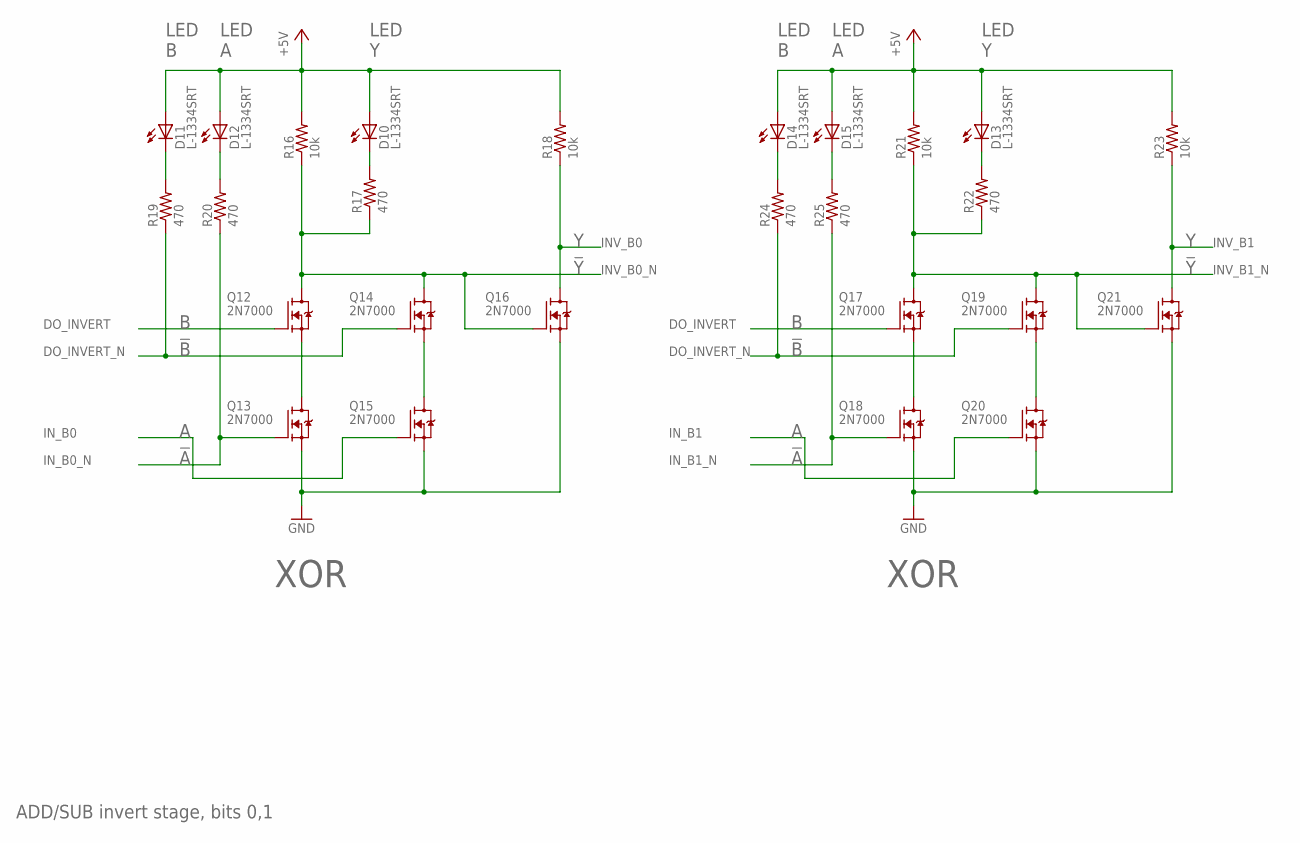
[picture p96: schematic 8BIT_ADD_SUB.sch, sheet 4]

Parts:
D10, D11, D12, D13, D14, D15: L-1334SRT; LED3MM
Q12, Q13, Q14, Q15, Q16, Q17, Q18, Q19, Q20, Q21: 2N7000; TO92-DGS
R16, R18, R21, R23: 10k; R_P2INCH
R17, R19, R20, R22, R24, R25: 470; R_P2INCH

Connections:
+5V: D10.A, D11.A, D12.A, D13.A, D14.A, D15.A, R16.2, R18.2, R21.2, R23.2; also elsewhere on the board
DO_INVERT: Q12.G, Q17.G; also elsewhere on the board
DO_INVERT_N: Q14.G, Q19.G, R19.1, R24.1; also elsewhere on the board
GND: Q13.S, Q15.S, Q16.S, Q18.S, Q20.S, Q21.S; also elsewhere on the board
INV_B0: Q16.D, R18.1; also elsewhere on the board
INV_B0_N: Q12.D, Q14.D, Q16.G, R16.1, R17.1; also elsewhere on the board
INV_B1: Q21.D, R23.1; also elsewhere on the board
INV_B1_N: Q17.D, Q19.D, Q21.G, R21.1, R22.1; also elsewhere on the board
IN_B0: Q15.G; also elsewhere on the board
IN_B0_N: Q13.G, R20.1; also elsewhere on the board
IN_B1: Q20.G; also elsewhere on the board
IN_B1_N: Q18.G, R25.1; also elsewhere on the board
unnamed: Q12.S, Q13.D
unnamed: Q14.S, Q15.D
unnamed: D10.K (C), R17.2
unnamed: D12.K (C), R20.2
unnamed: D11.K (C), R19.2
unnamed: Q17.S, Q18.D
unnamed: Q19.S, Q20.D
unnamed: D13.K (C), R22.2
unnamed: D15.K (C), R25.2
unnamed: D14.K (C), R24.2

Notes on the sheet:
ADD/SUB invert stage, bits 0,1
XOR
LED A
LED B
LED Y

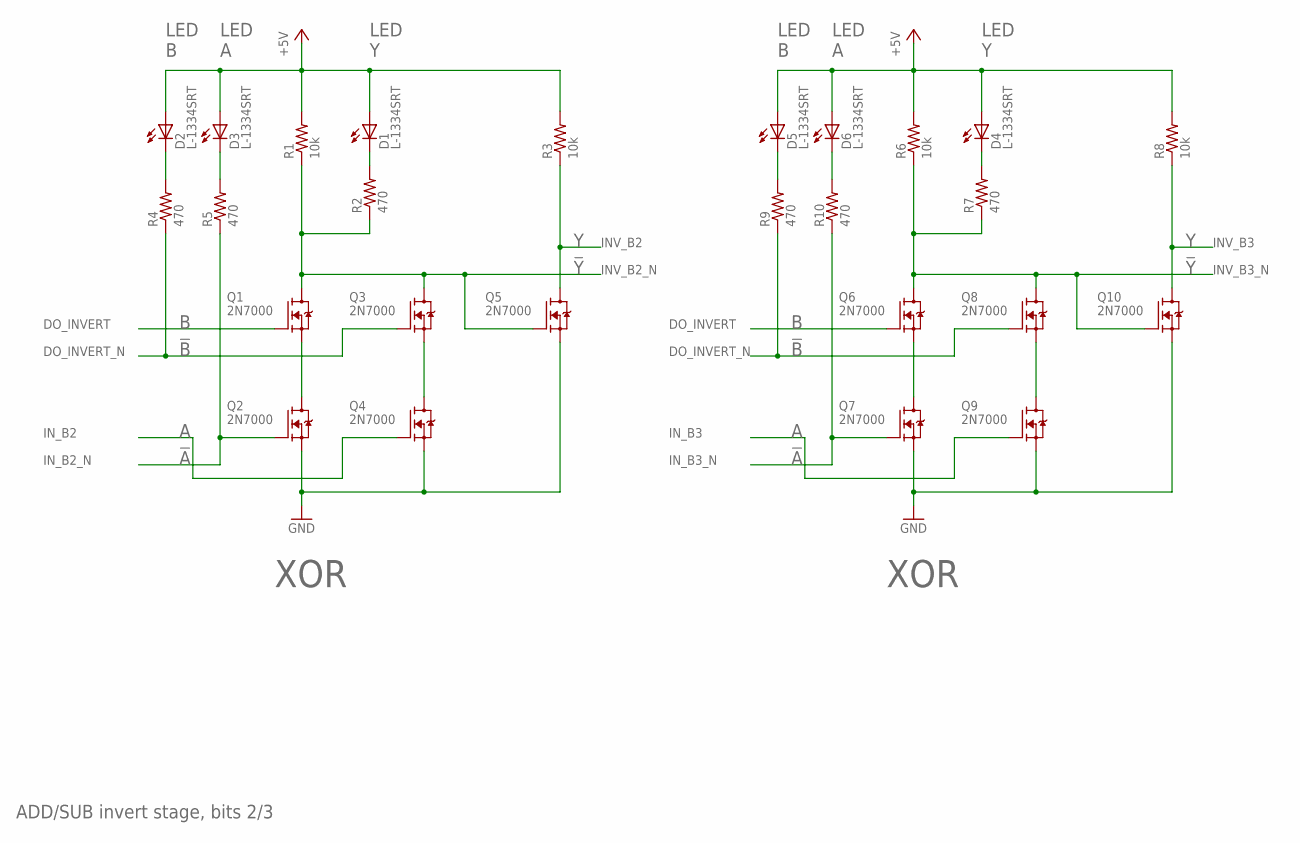
[picture p97: schematic 8BIT_ADD_SUB.sch, sheet 5]

Parts:
D1, D2, D3, D4, D5, D6: L-1334SRT; LED3MM
Q1, Q2, Q3, Q4, Q5, Q6, Q7, Q8, Q9, Q10: 2N7000; TO92-DGS
R1, R3, R6, R8: 10k; R_P2INCH
R2, R4, R5, R7, R9, R10: 470; R_P2INCH

Connections:
+5V: D1.A, D2.A, D3.A, D4.A, D5.A, D6.A, R1.2, R3.2, R6.2, R8.2; also elsewhere on the board
DO_INVERT: Q1.G, Q6.G; also elsewhere on the board
DO_INVERT_N: Q3.G, Q8.G, R4.1, R9.1; also elsewhere on the board
GND: Q2.S, Q4.S, Q5.S, Q7.S, Q9.S, Q10.S; also elsewhere on the board
INV_B2: Q5.D, R3.1; also elsewhere on the board
INV_B2_N: Q1.D, Q3.D, Q5.G, R1.1, R2.1; also elsewhere on the board
INV_B3: Q10.D, R8.1; also elsewhere on the board
INV_B3_N: Q6.D, Q8.D, Q10.G, R6.1, R7.1; also elsewhere on the board
IN_B2: Q4.G; also elsewhere on the board
IN_B2_N: Q2.G, R5.1; also elsewhere on the board
IN_B3: Q9.G; also elsewhere on the board
IN_B3_N: Q7.G, R10.1; also elsewhere on the board
unnamed: Q1.S, Q2.D
unnamed: Q3.S, Q4.D
unnamed: D1.K (C), R2.2
unnamed: D3.K (C), R5.2
unnamed: D2.K (C), R4.2
unnamed: Q6.S, Q7.D
unnamed: Q8.S, Q9.D
unnamed: D4.K (C), R7.2
unnamed: D6.K (C), R10.2
unnamed: D5.K (C), R9.2

Notes on the sheet:
ADD/SUB invert stage, bits 2/3
XOR
LED A
LED B
LED Y

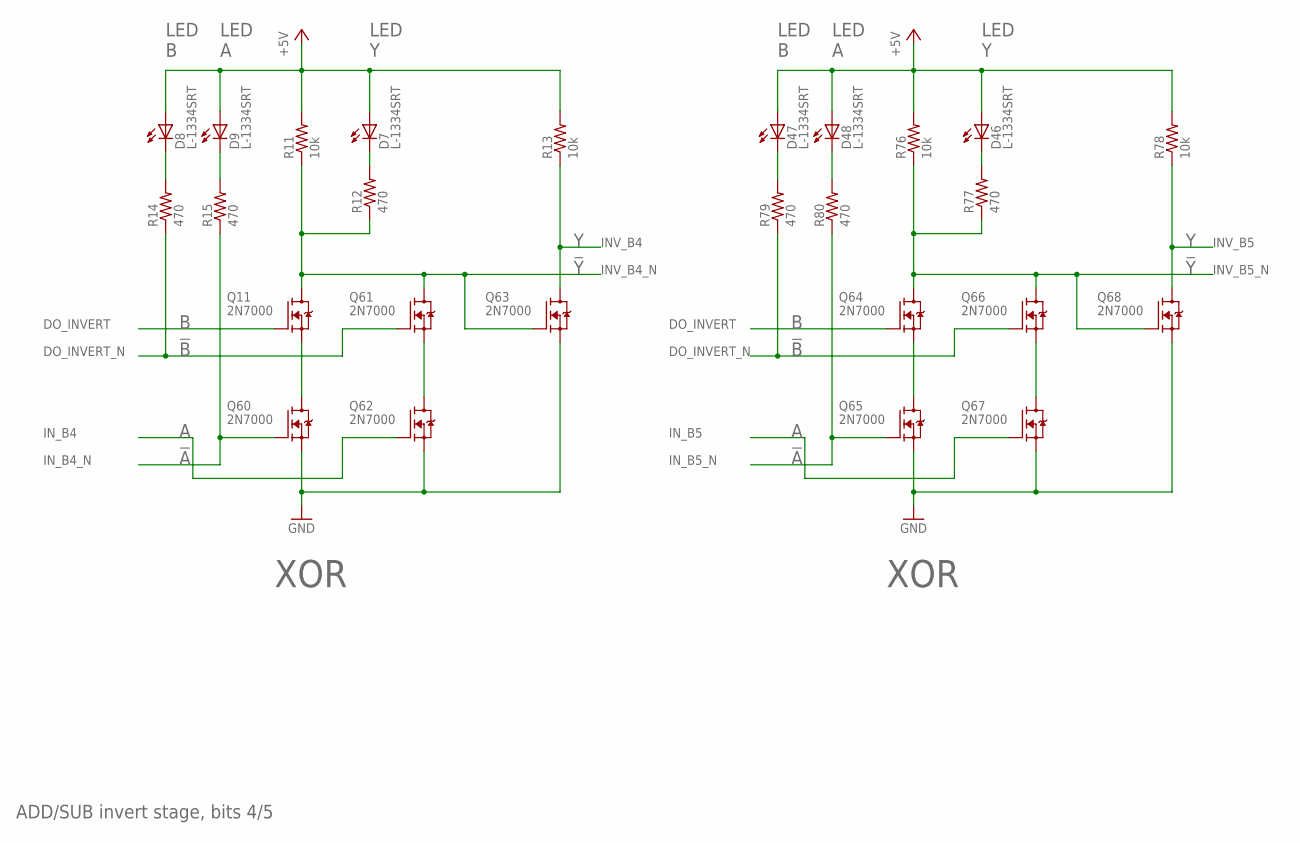
[picture p98: schematic 8BIT_ADD_SUB.sch, sheet 6]

Parts:
D7, D8, D9, D46, D47, D48: L-1334SRT; LED3MM
Q11, Q60, Q61, Q62, Q63, Q64, Q65, Q66, Q67, Q68: 2N7000; TO92-DGS
R11, R13, R76, R78: 10k; R_P2INCH
R12, R14, R15, R77, R79, R80: 470; R_P2INCH

Connections:
+5V: D7.A, D8.A, D9.A, D46.A, D47.A, D48.A, R11.2, R13.2, R76.2, R78.2; also elsewhere on the board
DO_INVERT: Q11.G, Q64.G; also elsewhere on the board
DO_INVERT_N: Q61.G, Q66.G, R14.1, R79.1; also elsewhere on the board
GND: Q60.S, Q62.S, Q63.S, Q65.S, Q67.S, Q68.S; also elsewhere on the board
INV_B4: Q63.D, R13.1; also elsewhere on the board
INV_B4_N: Q11.D, Q61.D, Q63.G, R11.1, R12.1; also elsewhere on the board
INV_B5: Q68.D, R78.1; also elsewhere on the board
INV_B5_N: Q64.D, Q66.D, Q68.G, R76.1, R77.1; also elsewhere on the board
IN_B4: Q62.G; also elsewhere on the board
IN_B4_N: Q60.G, R15.1; also elsewhere on the board
IN_B5: Q67.G; also elsewhere on the board
IN_B5_N: Q65.G, R80.1; also elsewhere on the board
unnamed: Q11.S, Q60.D
unnamed: Q61.S, Q62.D
unnamed: D7.K (C), R12.2
unnamed: D9.K (C), R15.2
unnamed: D8.K (C), R14.2
unnamed: Q64.S, Q65.D
unnamed: Q66.S, Q67.D
unnamed: D46.K (C), R77.2
unnamed: D48.K (C), R80.2
unnamed: D47.K (C), R79.2

Notes on the sheet:
ADD/SUB invert stage, bits 4/5
XOR
LED A
LED B
LED Y

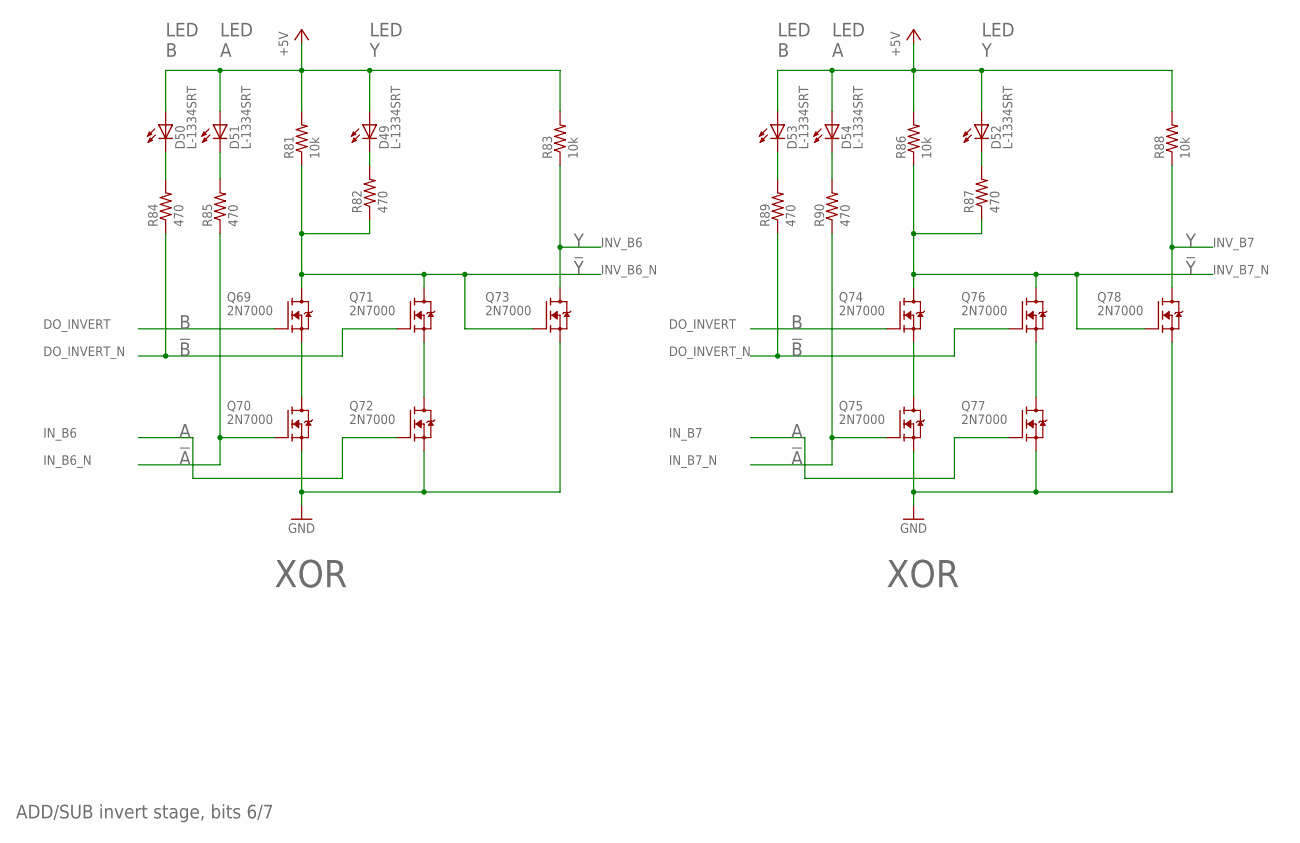
[picture p99: schematic 8BIT_ADD_SUB.sch, sheet 7]

Parts:
D49, D50, D51, D52, D53, D54: L-1334SRT; LED3MM
Q69, Q70, Q71, Q72, Q73, Q74, Q75, Q76, Q77, Q78: 2N7000; TO92-DGS
R81, R83, R86, R88: 10k; R_P2INCH
R82, R84, R85, R87, R89, R90: 470; R_P2INCH

Connections:
+5V: D49.A, D50.A, D51.A, D52.A, D53.A, D54.A, R81.2, R83.2, R86.2, R88.2; also elsewhere on the board
DO_INVERT: Q69.G, Q74.G; also elsewhere on the board
DO_INVERT_N: Q71.G, Q76.G, R84.1, R89.1; also elsewhere on the board
GND: Q70.S, Q72.S, Q73.S, Q75.S, Q77.S, Q78.S; also elsewhere on the board
INV_B6: Q73.D, R83.1; also elsewhere on the board
INV_B6_N: Q69.D, Q71.D, Q73.G, R81.1, R82.1; also elsewhere on the board
INV_B7: Q78.D, R88.1; also elsewhere on the board
INV_B7_N: Q74.D, Q76.D, Q78.G, R86.1, R87.1; also elsewhere on the board
IN_B6: Q72.G; also elsewhere on the board
IN_B6_N: Q70.G, R85.1; also elsewhere on the board
IN_B7: Q77.G; also elsewhere on the board
IN_B7_N: Q75.G, R90.1; also elsewhere on the board
unnamed: Q69.S, Q70.D
unnamed: Q71.S, Q72.D
unnamed: D49.K (C), R82.2
unnamed: D51.K (C), R85.2
unnamed: D50.K (C), R84.2
unnamed: Q74.S, Q75.D
unnamed: Q76.S, Q77.D
unnamed: D52.K (C), R87.2
unnamed: D54.K (C), R90.2
unnamed: D53.K (C), R89.2

Notes on the sheet:
ADD/SUB invert stage, bits 6/7
XOR
LED A
LED B
LED Y

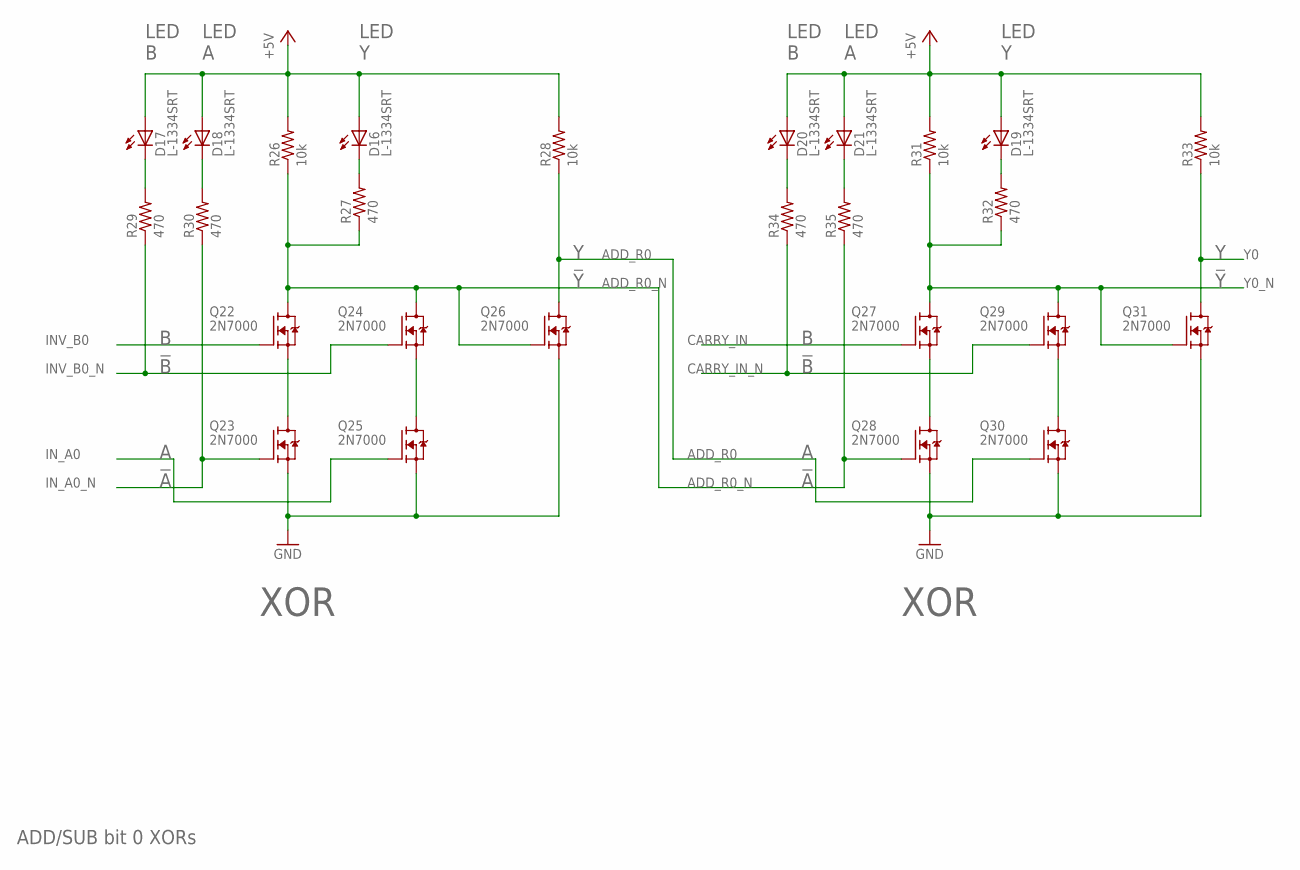
[picture p100: schematic 8BIT_ADD_SUB.sch, sheet 8]

Parts:
D16, D17, D18, D19, D20, D21: L-1334SRT; LED3MM
Q22, Q23, Q24, Q25, Q26, Q27, Q28, Q29, Q30, Q31: 2N7000; TO92-DGS
R26, R28, R31, R33: 10k; R_P2INCH
R27, R29, R30, R32, R34, R35: 470; R_P2INCH

Connections:
+5V: D16.A, D17.A, D18.A, D19.A, D20.A, D21.A, R26.2, R28.2, R31.2, R33.2; also elsewhere on the board
ADD_R0: Q26.D, Q30.G, R28.1; also elsewhere on the board
ADD_R0_N: Q22.D, Q24.D, Q26.G, Q28.G, R26.1, R27.1, R35.1; also elsewhere on the board
CARRY_IN: Q27.G; also elsewhere on the board
CARRY_IN_N: Q29.G, R34.1; also elsewhere on the board
GND: Q23.S, Q25.S, Q26.S, Q28.S, Q30.S, Q31.S; also elsewhere on the board
INV_B0: Q22.G; also elsewhere on the board
INV_B0_N: Q24.G, R29.1; also elsewhere on the board
IN_A0: Q25.G; also elsewhere on the board
IN_A0_N: Q23.G, R30.1; also elsewhere on the board
unnamed: Q22.S, Q23.D
unnamed: Q24.S, Q25.D
unnamed: D16.K (C), R27.2
unnamed: D18.K (C), R30.2
unnamed: D17.K (C), R29.2
unnamed: Q27.S, Q28.D
unnamed: Q29.S, Q30.D
unnamed: D19.K (C), R32.2
unnamed: D21.K (C), R35.2
unnamed: D20.K (C), R34.2
Y0: Q31.D, R33.1; also elsewhere on the board
Y0_N: Q27.D, Q29.D, Q31.G, R31.1, R32.1; also elsewhere on the board

Notes on the sheet:
ADD/SUB bit 0 XORs
XOR
LED A
LED B
LED Y

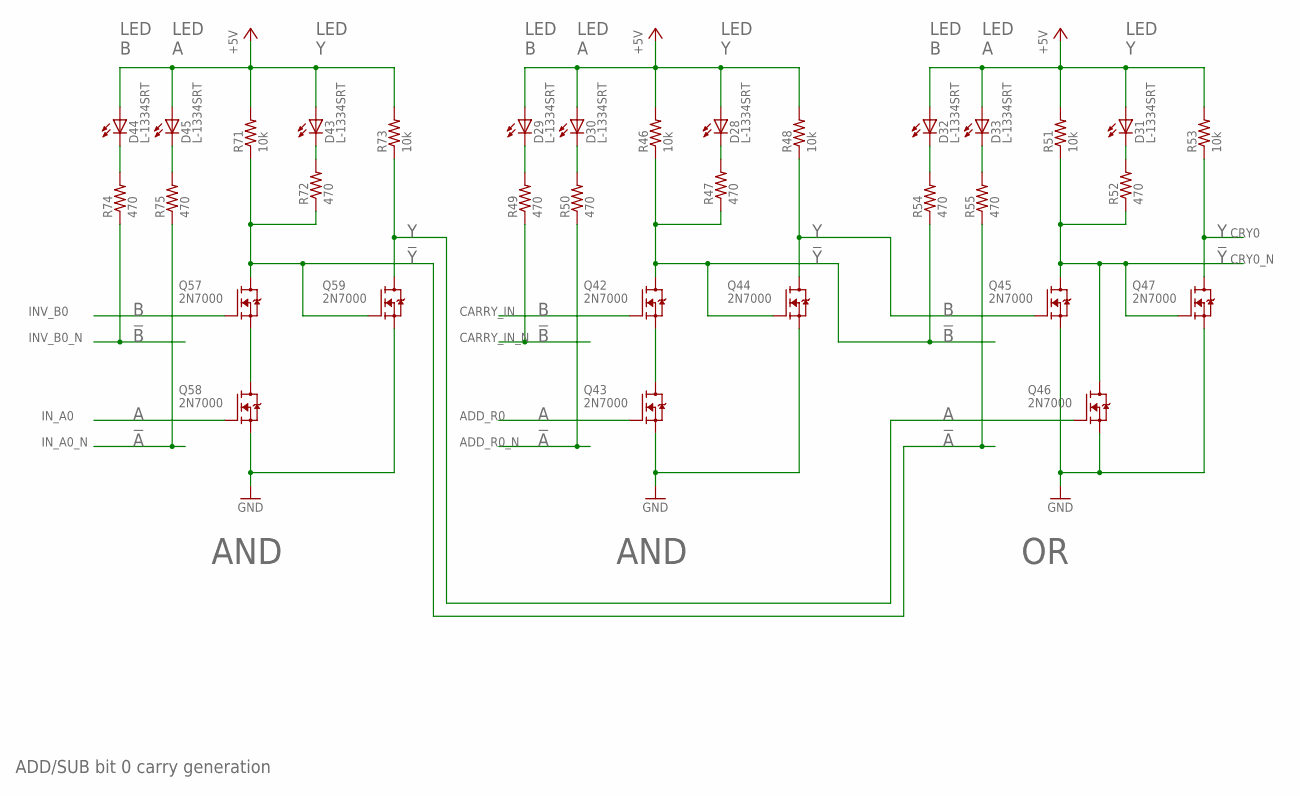
[picture p101: schematic 8BIT_ADD_SUB.sch, sheet 9]

Parts:
D28, D29, D30, D31, D32, D33, D43, D44, D45: L-1334SRT; LED3MM
Q42, Q43, Q44, Q45, Q46, Q47, Q57, Q58, Q59: 2N7000; TO92-DGS
R46, R48, R51, R53, R71, R73: 10k; R_P2INCH
R47, R49, R50, R52, R54, R55, R72, R74, R75: 470; R_P2INCH

Connections:
+5V: D28.A, D29.A, D30.A, D31.A, D32.A, D33.A, D43.A, D44.A, D45.A, R46.2, R48.2, R51.2, R53.2, R71.2, R73.2; also elsewhere on the board
ADD_R0: Q43.G; also elsewhere on the board
ADD_R0_N: R50.1; also elsewhere on the board
CARRY_IN: Q42.G; also elsewhere on the board
CARRY_IN_N: R49.1; also elsewhere on the board
CGEN_S0: Q44.D, Q45.G, R48.1
CRY0: Q47.D, R53.1; also elsewhere on the board
CRY0_N: Q45.D, Q46.D, Q47.G, R51.1, R52.1; also elsewhere on the board
GND: Q43.S, Q44.S, Q45.S, Q46.S, Q47.S, Q58.S, Q59.S; also elsewhere on the board
INV_B0: Q57.G; also elsewhere on the board
INV_B0_N: R74.1; also elsewhere on the board
IN_A0: Q58.G; also elsewhere on the board
IN_A0_N: R75.1; also elsewhere on the board
unnamed: Q42.S, Q43.D
unnamed: D28.K (C), R47.2
unnamed: Q42.D, Q44.G, R46.1, R47.1, R54.1
unnamed: D30.K (C), R50.2
unnamed: D29.K (C), R49.2
unnamed: D31.K (C), R52.2
unnamed: D33.K (C), R55.2
unnamed: D32.K (C), R54.2
unnamed: Q57.S, Q58.D
unnamed: D43.K (C), R72.2
unnamed: Q46.G, Q59.D, R73.1
unnamed: Q57.D, Q59.G, R55.1, R71.1, R72.1
unnamed: D45.K (C), R75.2
unnamed: D44.K (C), R74.2

Notes on the sheet:
ADD/SUB bit 0 carry generation
AND
LED Y
LED A
LED B

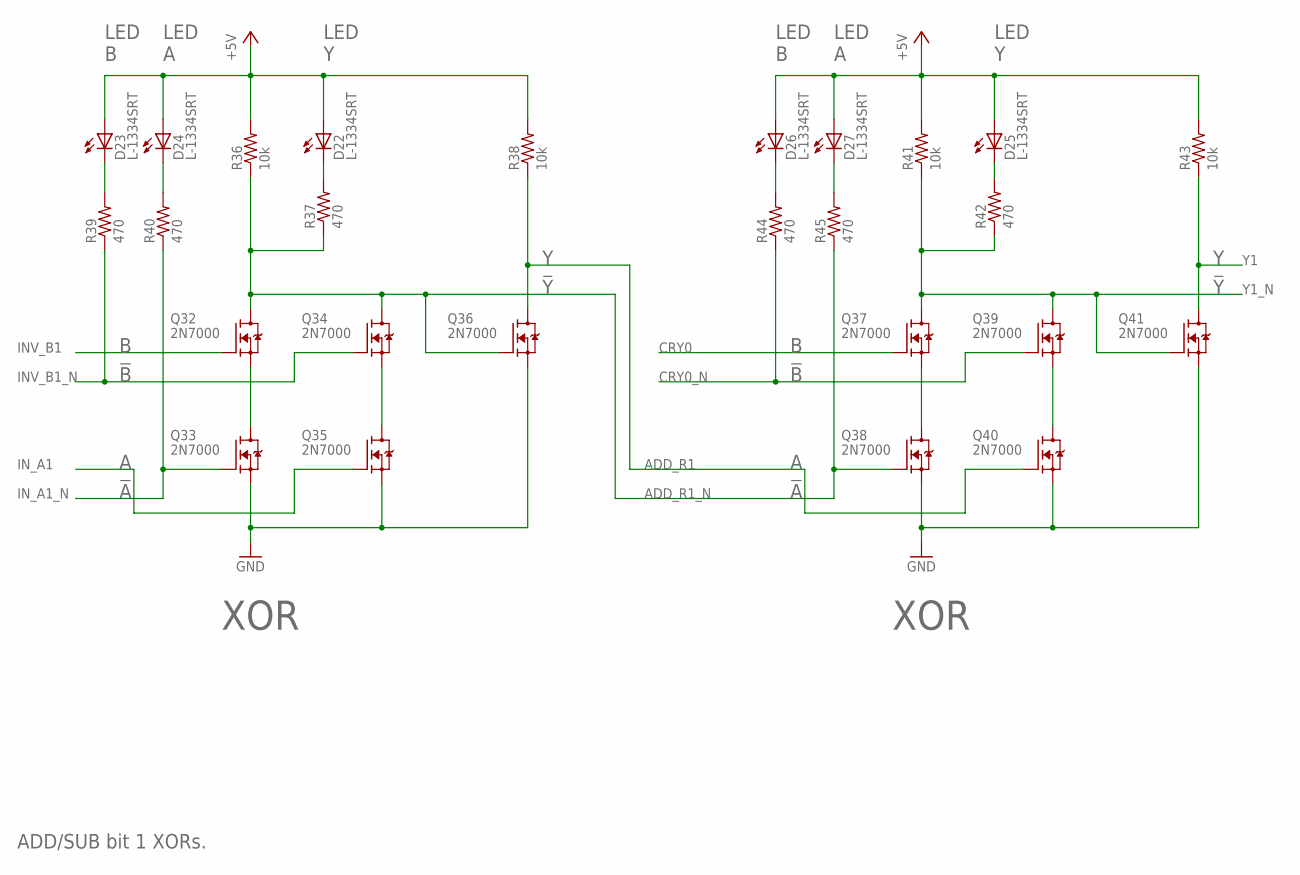
[picture p102: schematic 8BIT_ADD_SUB.sch, sheet 10]

Parts:
D22, D23, D24, D25, D26, D27: L-1334SRT; LED3MM
Q32, Q33, Q34, Q35, Q36, Q37, Q38, Q39, Q40, Q41: 2N7000; TO92-DGS
R36, R38, R41, R43: 10k; R_P2INCH
R37, R39, R40, R42, R44, R45: 470; R_P2INCH

Connections:
+5V: D22.A, D23.A, D24.A, D25.A, D26.A, D27.A, R36.2, R38.2, R41.2, R43.2; also elsewhere on the board
ADD_R1: Q36.D, Q40.G, R38.1; also elsewhere on the board
ADD_R1_N: Q32.D, Q34.D, Q36.G, Q38.G, R36.1, R37.1, R45.1; also elsewhere on the board
CRY0: Q37.G; also elsewhere on the board
CRY0_N: Q39.G, R44.1; also elsewhere on the board
GND: Q33.S, Q35.S, Q36.S, Q38.S, Q40.S, Q41.S; also elsewhere on the board
INV_B1: Q32.G; also elsewhere on the board
INV_B1_N: Q34.G, R39.1; also elsewhere on the board
IN_A1: Q35.G; also elsewhere on the board
IN_A1_N: Q33.G, R40.1; also elsewhere on the board
unnamed: Q32.S, Q33.D
unnamed: Q34.S, Q35.D
unnamed: D22.K (C), R37.2
unnamed: D24.K (C), R40.2
unnamed: D23.K (C), R39.2
unnamed: Q37.S, Q38.D
unnamed: Q39.S, Q40.D
unnamed: D25.K (C), R42.2
unnamed: D27.K (C), R45.2
unnamed: D26.K (C), R44.2
Y1: Q41.D, R43.1; also elsewhere on the board
Y1_N: Q37.D, Q39.D, Q41.G, R41.1, R42.1; also elsewhere on the board

Notes on the sheet:
ADD/SUB bit 1 XORs.
XOR
LED A
LED B
LED Y

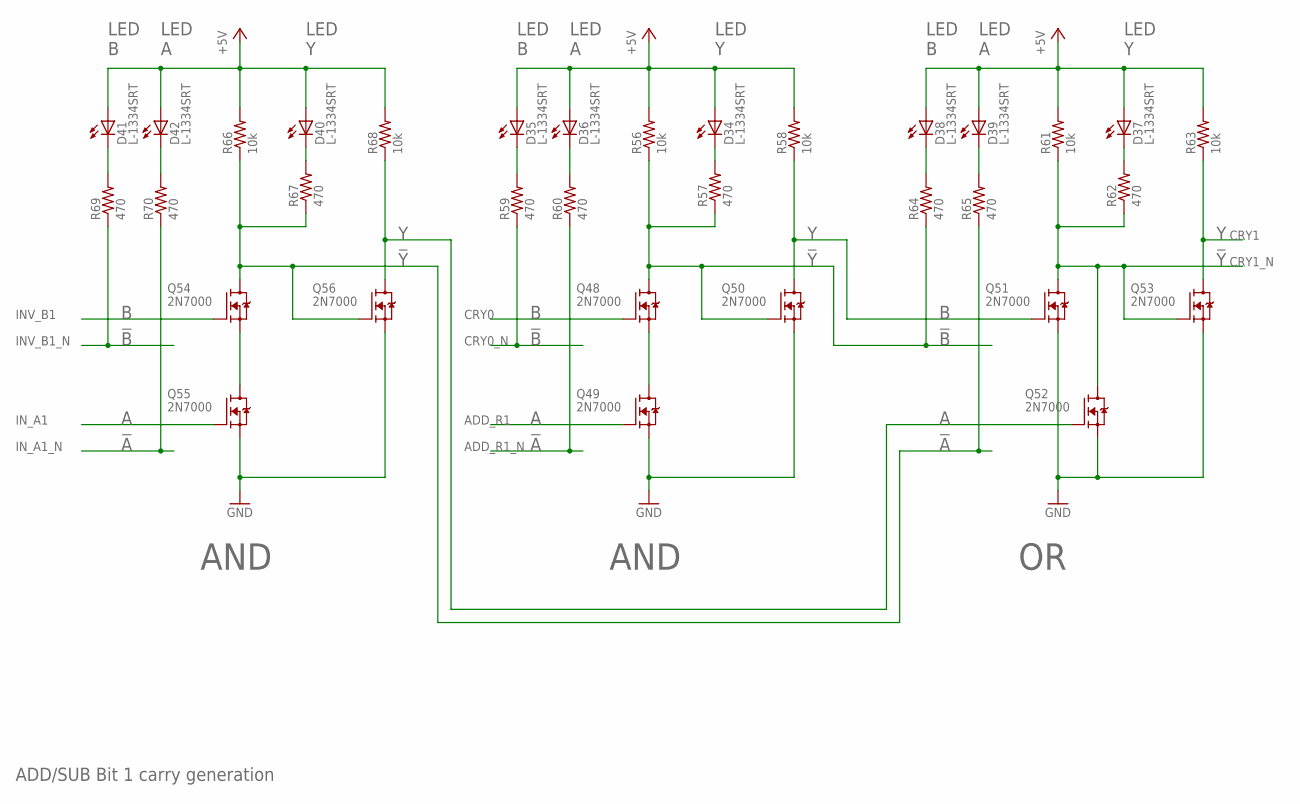
[picture p103: schematic 8BIT_ADD_SUB.sch, sheet 11]

Parts:
D34, D35, D36, D37, D38, D39, D40, D41, D42: L-1334SRT; LED3MM
Q48, Q49, Q50, Q51, Q52, Q53, Q54, Q55, Q56: 2N7000; TO92-DGS
R56, R58, R61, R63, R66, R68: 10k; R_P2INCH
R57, R59, R60, R62, R64, R65, R67, R69, R70: 470; R_P2INCH

Connections:
+5V: D34.A, D35.A, D36.A, D37.A, D38.A, D39.A, D40.A, D41.A, D42.A, R56.2, R58.2, R61.2, R63.2, R66.2, R68.2; also elsewhere on the board
ADD_R1: Q49.G; also elsewhere on the board
ADD_R1_N: R60.1; also elsewhere on the board
CRY0: Q48.G; also elsewhere on the board
CRY0_N: R59.1; also elsewhere on the board
CRY1: Q53.D, R63.1; also elsewhere on the board
CRY1_N: Q51.D, Q52.D, Q53.G, R61.1, R62.1; also elsewhere on the board
GND: Q49.S, Q50.S, Q51.S, Q52.S, Q53.S, Q55.S, Q56.S; also elsewhere on the board
INV_B1: Q54.G; also elsewhere on the board
INV_B1_N: R69.1; also elsewhere on the board
IN_A1: Q55.G; also elsewhere on the board
IN_A1_N: R70.1; also elsewhere on the board
unnamed: Q48.S, Q49.D
unnamed: D34.K (C), R57.2
unnamed: Q50.D, Q51.G, R58.1
unnamed: Q48.D, Q50.G, R56.1, R57.1, R64.1
unnamed: D36.K (C), R60.2
unnamed: D35.K (C), R59.2
unnamed: D37.K (C), R62.2
unnamed: D39.K (C), R65.2
unnamed: D38.K (C), R64.2
unnamed: Q54.S, Q55.D
unnamed: D40.K (C), R67.2
unnamed: Q52.G, Q56.D, R68.1
unnamed: Q54.D, Q56.G, R65.1, R66.1, R67.1
unnamed: D42.K (C), R70.2
unnamed: D41.K (C), R69.2

Notes on the sheet:
ADD/SUB Bit 1 carry generation
AND
LED Y
LED A
LED B
