ericherman/megaprocessor/8bit_add_sub/8BIT_ADD_SUB.brd

## EAGLE design 8bit_add_sub/8BIT_ADD_SUB.brd (continued)

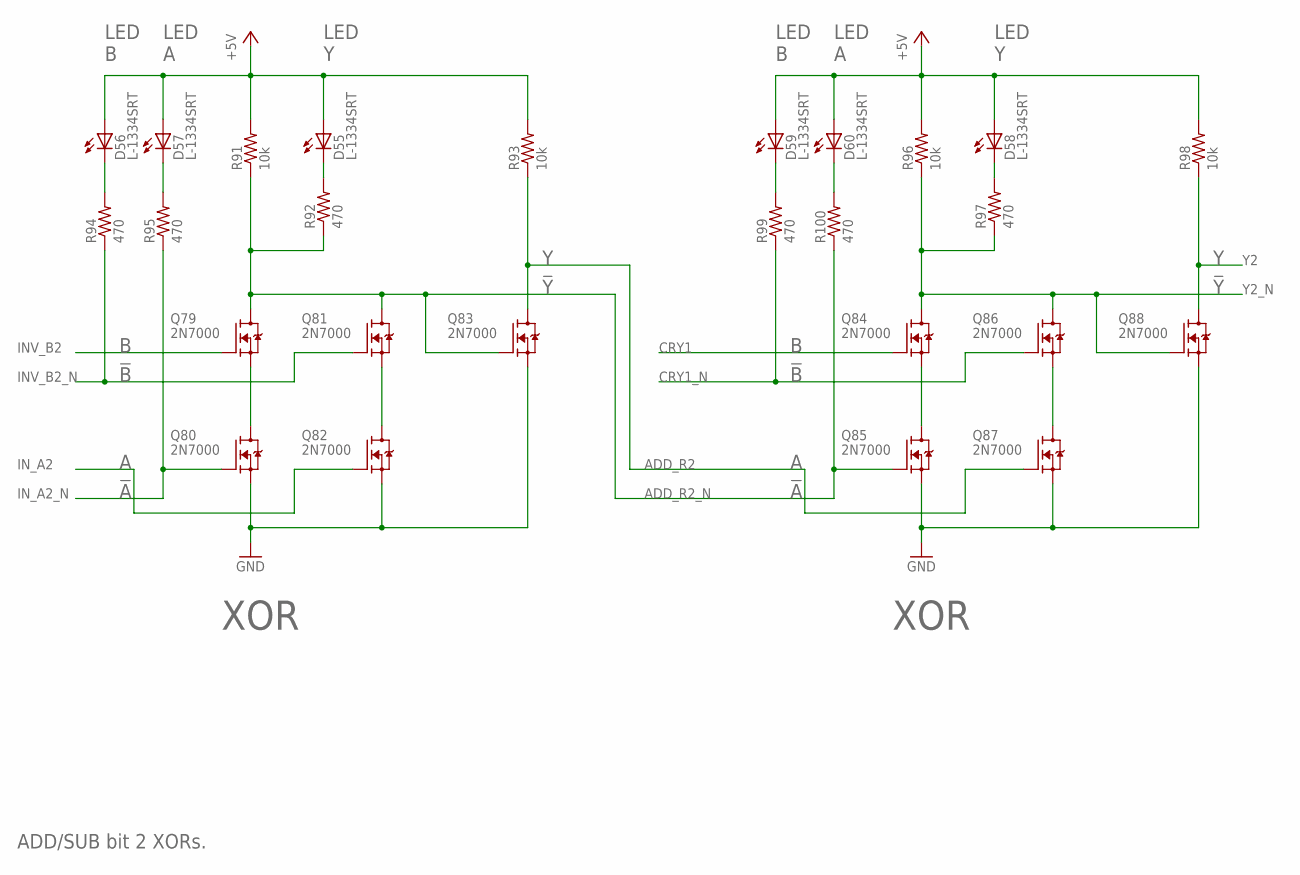
[picture p104: schematic 8BIT_ADD_SUB.sch, sheet 12]

Parts:
D55, D56, D57, D58, D59, D60: L-1334SRT; LED3MM
Q79, Q80, Q81, Q82, Q83, Q84, Q85, Q86, Q87, Q88: 2N7000; TO92-DGS
R91, R93, R96, R98: 10k; R_P2INCH
R92, R94, R95, R97, R99, R100: 470; R_P2INCH

Connections:
+5V: D55.A, D56.A, D57.A, D58.A, D59.A, D60.A, R91.2, R93.2, R96.2, R98.2; also elsewhere on the board
ADD_R2: Q83.D, Q87.G, R93.1; also elsewhere on the board
ADD_R2_N: Q79.D, Q81.D, Q83.G, Q85.G, R91.1, R92.1, R100.1; also elsewhere on the board
CRY1: Q84.G; also elsewhere on the board
CRY1_N: Q86.G, R99.1; also elsewhere on the board
GND: Q80.S, Q82.S, Q83.S, Q85.S, Q87.S, Q88.S; also elsewhere on the board
INV_B2: Q79.G; also elsewhere on the board
INV_B2_N: Q81.G, R94.1; also elsewhere on the board
IN_A2: Q82.G; also elsewhere on the board
IN_A2_N: Q80.G, R95.1; also elsewhere on the board
unnamed: Q79.S, Q80.D
unnamed: Q81.S, Q82.D
unnamed: D55.K (C), R92.2
unnamed: D57.K (C), R95.2
unnamed: D56.K (C), R94.2
unnamed: Q84.S, Q85.D
unnamed: Q86.S, Q87.D
unnamed: D58.K (C), R97.2
unnamed: D60.K (C), R100.2
unnamed: D59.K (C), R99.2
Y2: Q88.D, R98.1; also elsewhere on the board
Y2_N: Q84.D, Q86.D, Q88.G, R96.1, R97.1; also elsewhere on the board

Notes on the sheet:
ADD/SUB bit 2 XORs.
XOR
LED A
LED B
LED Y

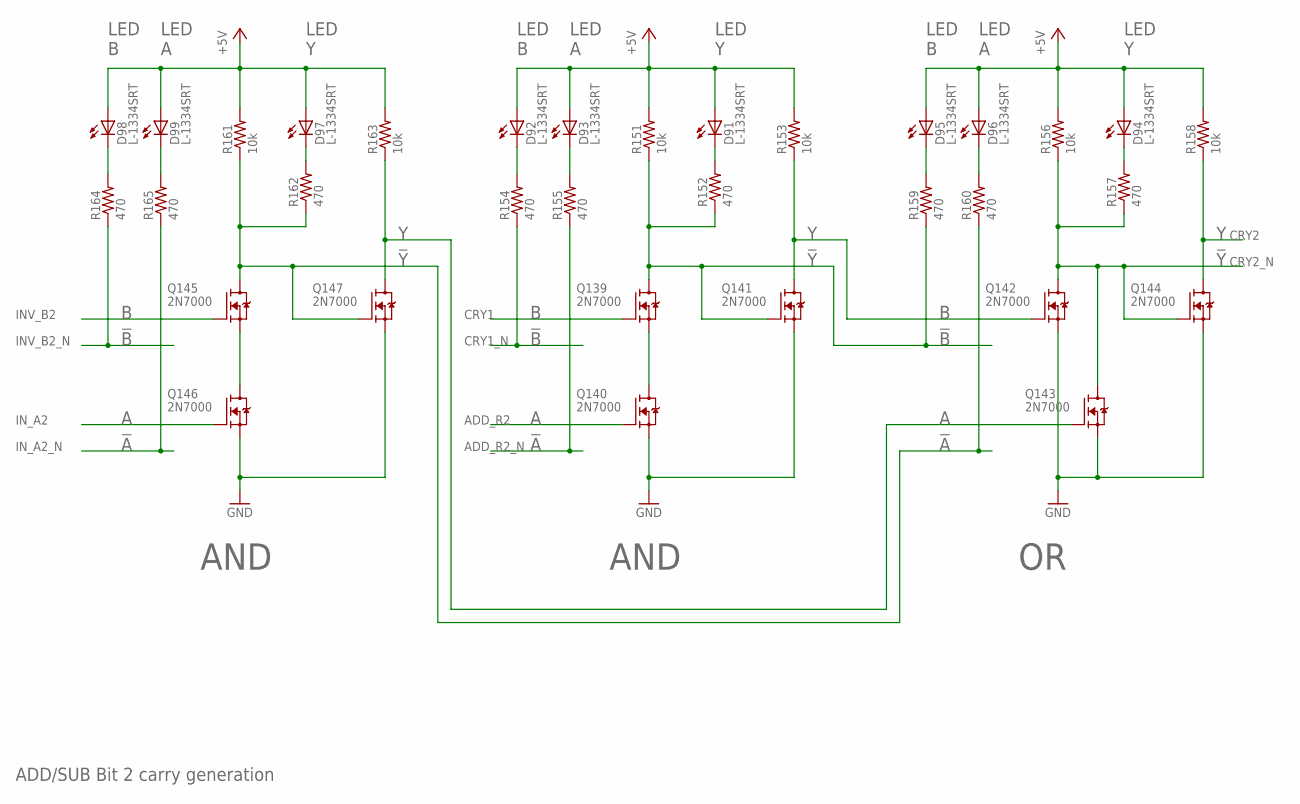
[picture p105: schematic 8BIT_ADD_SUB.sch, sheet 13]

Parts:
D91, D92, D93, D94, D95, D96, D97, D98, D99: L-1334SRT; LED3MM
Q139, Q140, Q141, Q142, Q143, Q144, Q145, Q146, Q147: 2N7000; TO92-DGS
R151, R153, R156, R158, R161, R163: 10k; R_P2INCH
R152, R154, R155, R157, R159, R160, R162, R164, R165: 470; R_P2INCH

Connections:
+5V: D91.A, D92.A, D93.A, D94.A, D95.A, D96.A, D97.A, D98.A, D99.A, R151.2, R153.2, R156.2, R158.2, R161.2, R163.2; also elsewhere on the board
ADD_R2: Q140.G; also elsewhere on the board
ADD_R2_N: R155.1; also elsewhere on the board
CRY1: Q139.G; also elsewhere on the board
CRY1_N: R154.1; also elsewhere on the board
CRY2: Q144.D, R158.1; also elsewhere on the board
CRY2_N: Q142.D, Q143.D, Q144.G, R156.1, R157.1; also elsewhere on the board
GND: Q140.S, Q141.S, Q142.S, Q143.S, Q144.S, Q146.S, Q147.S; also elsewhere on the board
INV_B2: Q145.G; also elsewhere on the board
INV_B2_N: R164.1; also elsewhere on the board
IN_A2: Q146.G; also elsewhere on the board
IN_A2_N: R165.1; also elsewhere on the board
unnamed: Q139.S, Q140.D
unnamed: D91.K (C), R152.2
unnamed: Q141.D, Q142.G, R153.1
unnamed: Q139.D, Q141.G, R151.1, R152.1, R159.1
unnamed: D93.K (C), R155.2
unnamed: D92.K (C), R154.2
unnamed: D94.K (C), R157.2
unnamed: D96.K (C), R160.2
unnamed: D95.K (C), R159.2
unnamed: Q145.S, Q146.D
unnamed: D97.K (C), R162.2
unnamed: Q143.G, Q147.D, R163.1
unnamed: Q145.D, Q147.G, R160.1, R161.1, R162.1
unnamed: D99.K (C), R165.2
unnamed: D98.K (C), R164.2

Notes on the sheet:
ADD/SUB Bit 2 carry generation
AND
LED Y
LED A
LED B

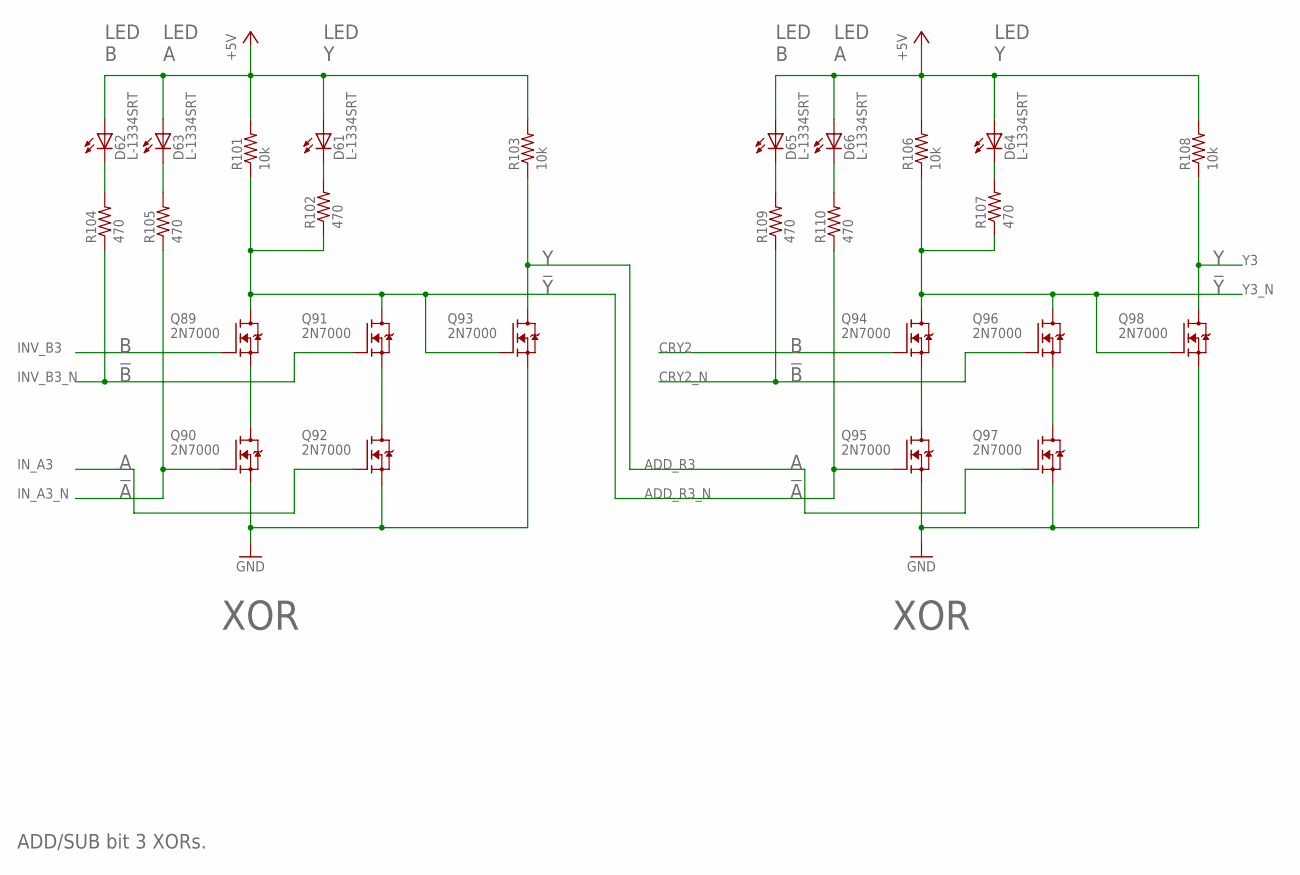
[picture p106: schematic 8BIT_ADD_SUB.sch, sheet 14]

Parts:
D61, D62, D63, D64, D65, D66: L-1334SRT; LED3MM
Q89, Q90, Q91, Q92, Q93, Q94, Q95, Q96, Q97, Q98: 2N7000; TO92-DGS
R101, R103, R106, R108: 10k; R_P2INCH
R102, R104, R105, R107, R109, R110: 470; R_P2INCH

Connections:
+5V: D61.A, D62.A, D63.A, D64.A, D65.A, D66.A, R101.2, R103.2, R106.2, R108.2; also elsewhere on the board
ADD_R3: Q93.D, Q97.G, R103.1; also elsewhere on the board
ADD_R3_N: Q89.D, Q91.D, Q93.G, Q95.G, R101.1, R102.1, R110.1; also elsewhere on the board
CRY2: Q94.G; also elsewhere on the board
CRY2_N: Q96.G, R109.1; also elsewhere on the board
GND: Q90.S, Q92.S, Q93.S, Q95.S, Q97.S, Q98.S; also elsewhere on the board
INV_B3: Q89.G; also elsewhere on the board
INV_B3_N: Q91.G, R104.1; also elsewhere on the board
IN_A3: Q92.G; also elsewhere on the board
IN_A3_N: Q90.G, R105.1; also elsewhere on the board
unnamed: Q89.S, Q90.D
unnamed: Q91.S, Q92.D
unnamed: D61.K (C), R102.2
unnamed: D63.K (C), R105.2
unnamed: D62.K (C), R104.2
unnamed: Q94.S, Q95.D
unnamed: Q96.S, Q97.D
unnamed: D64.K (C), R107.2
unnamed: D66.K (C), R110.2
unnamed: D65.K (C), R109.2
Y3: Q98.D, R108.1; also elsewhere on the board
Y3_N: Q94.D, Q96.D, Q98.G, R106.1, R107.1; also elsewhere on the board

Notes on the sheet:
ADD/SUB bit 3 XORs.
XOR
LED A
LED B
LED Y

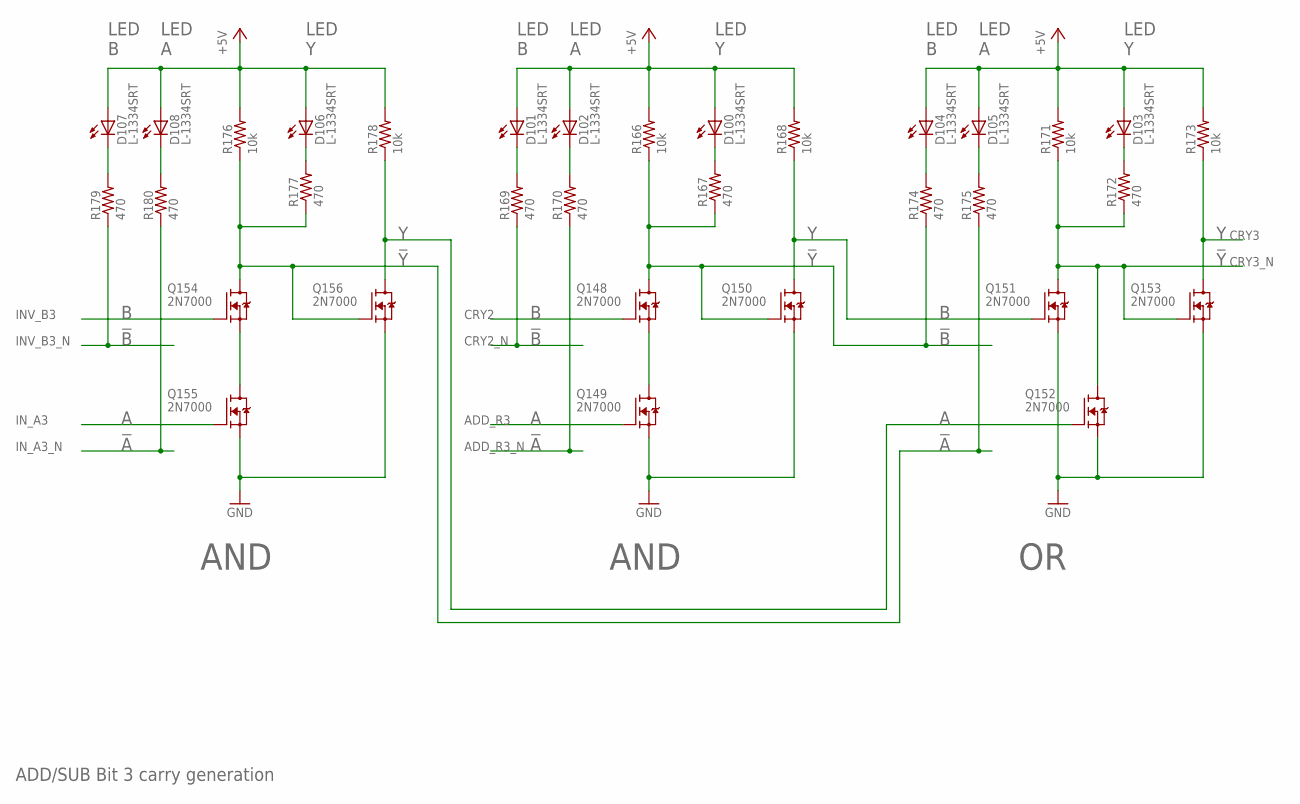
[picture p107: schematic 8BIT_ADD_SUB.sch, sheet 15]

Parts:
D100, D101, D102, D103, D104, D105, D106, D107, D108: L-1334SRT; LED3MM
Q148, Q149, Q150, Q151, Q152, Q153, Q154, Q155, Q156: 2N7000; TO92-DGS
R166, R168, R171, R173, R176, R178: 10k; R_P2INCH
R167, R169, R170, R172, R174, R175, R177, R179, R180: 470; R_P2INCH

Connections:
+5V: D100.A, D101.A, D102.A, D103.A, D104.A, D105.A, D106.A, D107.A, D108.A, R166.2, R168.2, R171.2, R173.2, R176.2, R178.2; also elsewhere on the board
ADD_R3: Q149.G; also elsewhere on the board
ADD_R3_N: R170.1; also elsewhere on the board
CRY2: Q148.G; also elsewhere on the board
CRY2_N: R169.1; also elsewhere on the board
CRY3: Q153.D, R173.1; also elsewhere on the board
CRY3_N: Q151.D, Q152.D, Q153.G, R171.1, R172.1; also elsewhere on the board
GND: Q149.S, Q150.S, Q151.S, Q152.S, Q153.S, Q155.S, Q156.S; also elsewhere on the board
INV_B3: Q154.G; also elsewhere on the board
INV_B3_N: R179.1; also elsewhere on the board
IN_A3: Q155.G; also elsewhere on the board
IN_A3_N: R180.1; also elsewhere on the board
unnamed: Q148.S, Q149.D
unnamed: D100.K (C), R167.2
unnamed: Q150.D, Q151.G, R168.1
unnamed: Q148.D, Q150.G, R166.1, R167.1, R174.1
unnamed: D102.K (C), R170.2
unnamed: D101.K (C), R169.2
unnamed: D103.K (C), R172.2
unnamed: D105.K (C), R175.2
unnamed: D104.K (C), R174.2
unnamed: Q154.S, Q155.D
unnamed: D106.K (C), R177.2
unnamed: Q152.G, Q156.D, R178.1
unnamed: Q154.D, Q156.G, R175.1, R176.1, R177.1
unnamed: D108.K (C), R180.2
unnamed: D107.K (C), R179.2

Notes on the sheet:
ADD/SUB Bit 3 carry generation
AND
LED Y
LED A
LED B

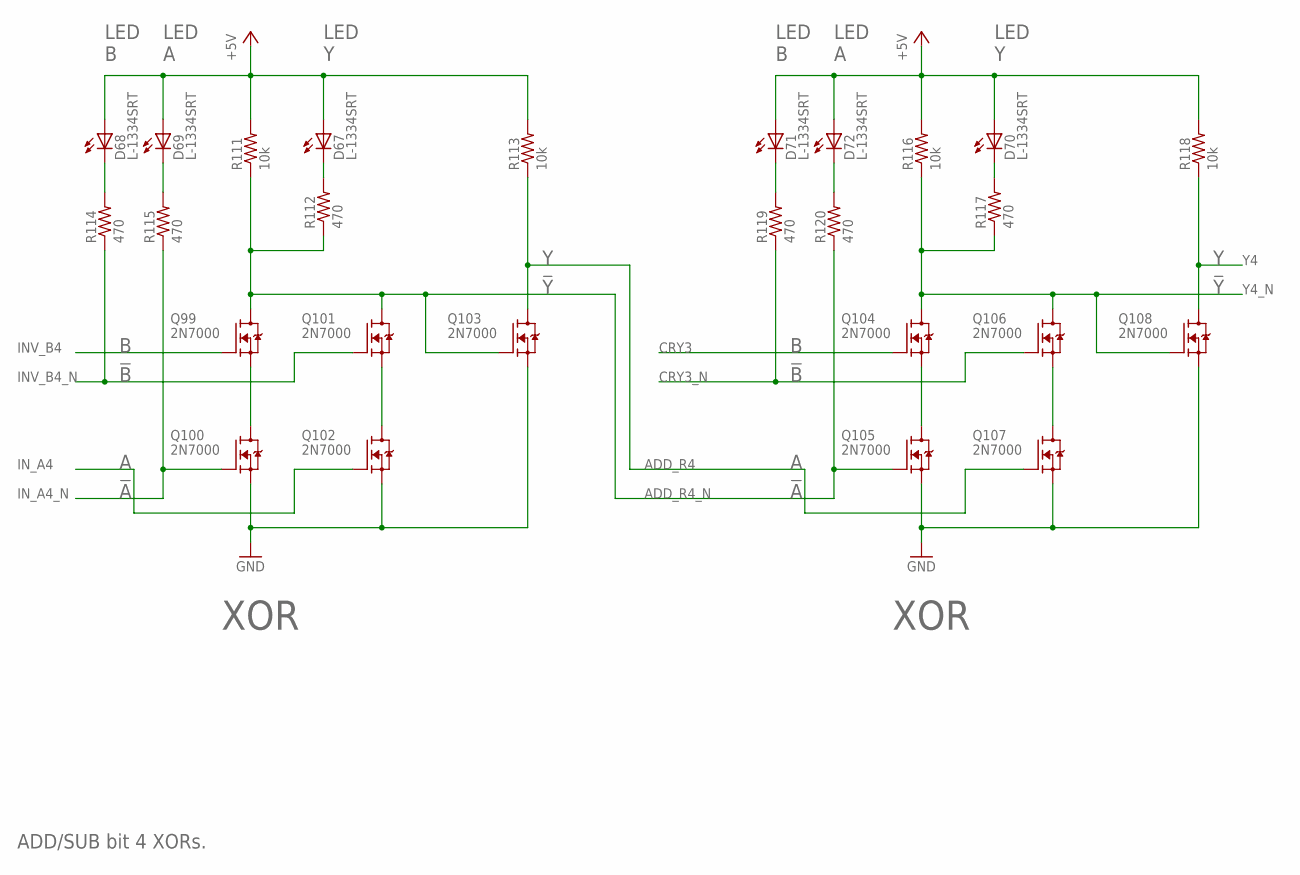
[picture p108: schematic 8BIT_ADD_SUB.sch, sheet 16]

Parts:
D67, D68, D69, D70, D71, D72: L-1334SRT; LED3MM
Q99, Q100, Q101, Q102, Q103, Q104, Q105, Q106, Q107, Q108: 2N7000; TO92-DGS
R111, R113, R116, R118: 10k; R_P2INCH
R112, R114, R115, R117, R119, R120: 470; R_P2INCH

Connections:
+5V: D67.A, D68.A, D69.A, D70.A, D71.A, D72.A, R111.2, R113.2, R116.2, R118.2; also elsewhere on the board
ADD_R4: Q103.D, Q107.G, R113.1; also elsewhere on the board
ADD_R4_N: Q99.D, Q101.D, Q103.G, Q105.G, R111.1, R112.1, R120.1; also elsewhere on the board
CRY3: Q104.G; also elsewhere on the board
CRY3_N: Q106.G, R119.1; also elsewhere on the board
GND: Q100.S, Q102.S, Q103.S, Q105.S, Q107.S, Q108.S; also elsewhere on the board
INV_B4: Q99.G; also elsewhere on the board
INV_B4_N: Q101.G, R114.1; also elsewhere on the board
IN_A4: Q102.G; also elsewhere on the board
IN_A4_N: Q100.G, R115.1; also elsewhere on the board
unnamed: Q99.S, Q100.D
unnamed: Q101.S, Q102.D
unnamed: D67.K (C), R112.2
unnamed: D69.K (C), R115.2
unnamed: D68.K (C), R114.2
unnamed: Q104.S, Q105.D
unnamed: Q106.S, Q107.D
unnamed: D70.K (C), R117.2
unnamed: D72.K (C), R120.2
unnamed: D71.K (C), R119.2
Y4: Q108.D, R118.1; also elsewhere on the board
Y4_N: Q104.D, Q106.D, Q108.G, R116.1, R117.1; also elsewhere on the board

Notes on the sheet:
ADD/SUB bit 4 XORs.
XOR
LED A
LED B
LED Y

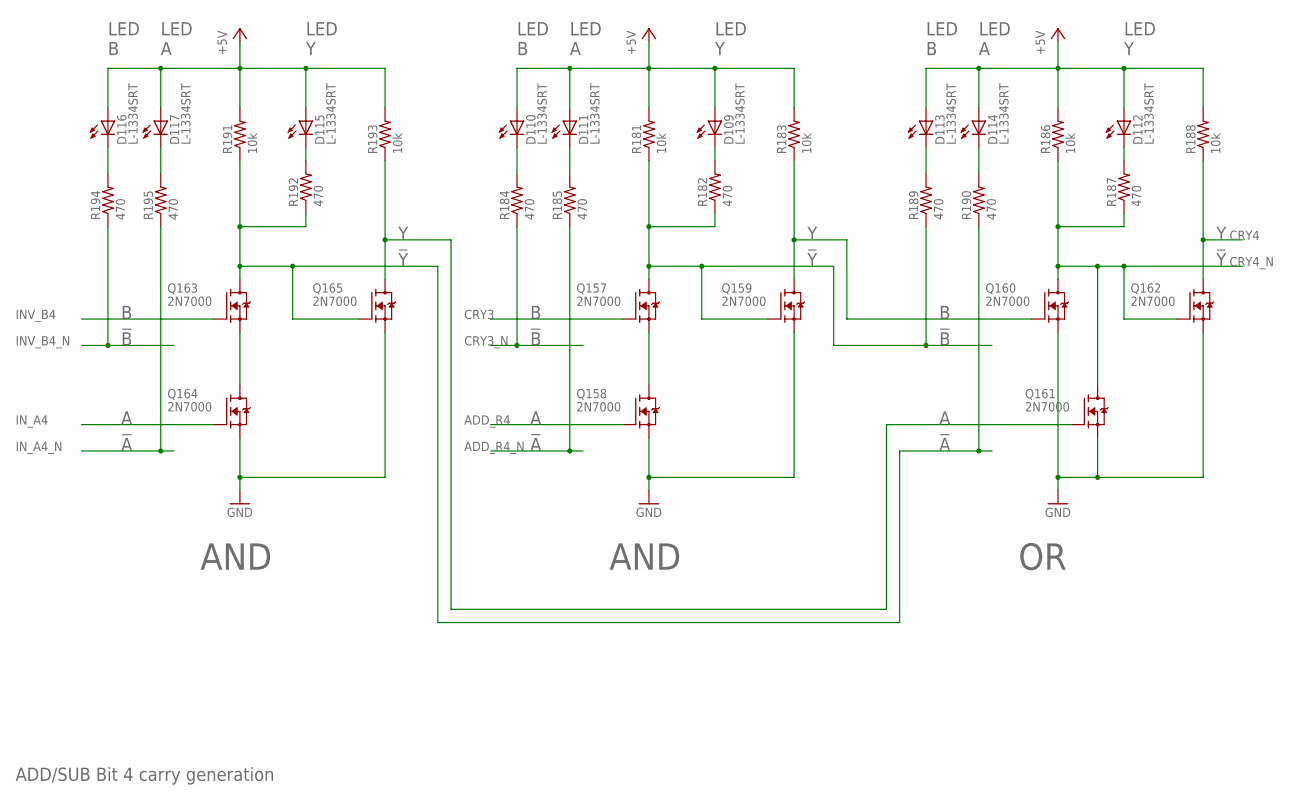
[picture p109: schematic 8BIT_ADD_SUB.sch, sheet 17]

Parts:
D109, D110, D111, D112, D113, D114, D115, D116, D117: L-1334SRT; LED3MM
Q157, Q158, Q159, Q160, Q161, Q162, Q163, Q164, Q165: 2N7000; TO92-DGS
R181, R183, R186, R188, R191, R193: 10k; R_P2INCH
R182, R184, R185, R187, R189, R190, R192, R194, R195: 470; R_P2INCH

Connections:
+5V: D109.A, D110.A, D111.A, D112.A, D113.A, D114.A, D115.A, D116.A, D117.A, R181.2, R183.2, R186.2, R188.2, R191.2, R193.2; also elsewhere on the board
ADD_R4: Q158.G; also elsewhere on the board
ADD_R4_N: R185.1; also elsewhere on the board
CRY3: Q157.G; also elsewhere on the board
CRY3_N: R184.1; also elsewhere on the board
CRY4: Q162.D, R188.1; also elsewhere on the board
CRY4_N: Q160.D, Q161.D, Q162.G, R186.1, R187.1; also elsewhere on the board
GND: Q158.S, Q159.S, Q160.S, Q161.S, Q162.S, Q164.S, Q165.S; also elsewhere on the board
INV_B4: Q163.G; also elsewhere on the board
INV_B4_N: R194.1; also elsewhere on the board
IN_A4: Q164.G; also elsewhere on the board
IN_A4_N: R195.1; also elsewhere on the board
unnamed: Q157.S, Q158.D
unnamed: D109.K (C), R182.2
unnamed: Q159.D, Q160.G, R183.1
unnamed: Q157.D, Q159.G, R181.1, R182.1, R189.1
unnamed: D111.K (C), R185.2
unnamed: D110.K (C), R184.2
unnamed: D112.K (C), R187.2
unnamed: D114.K (C), R190.2
unnamed: D113.K (C), R189.2
unnamed: Q163.S, Q164.D
unnamed: D115.K (C), R192.2
unnamed: Q161.G, Q165.D, R193.1
unnamed: Q163.D, Q165.G, R190.1, R191.1, R192.1
unnamed: D117.K (C), R195.2
unnamed: D116.K (C), R194.2

Notes on the sheet:
ADD/SUB Bit 4 carry generation
AND
LED Y
LED A
LED B

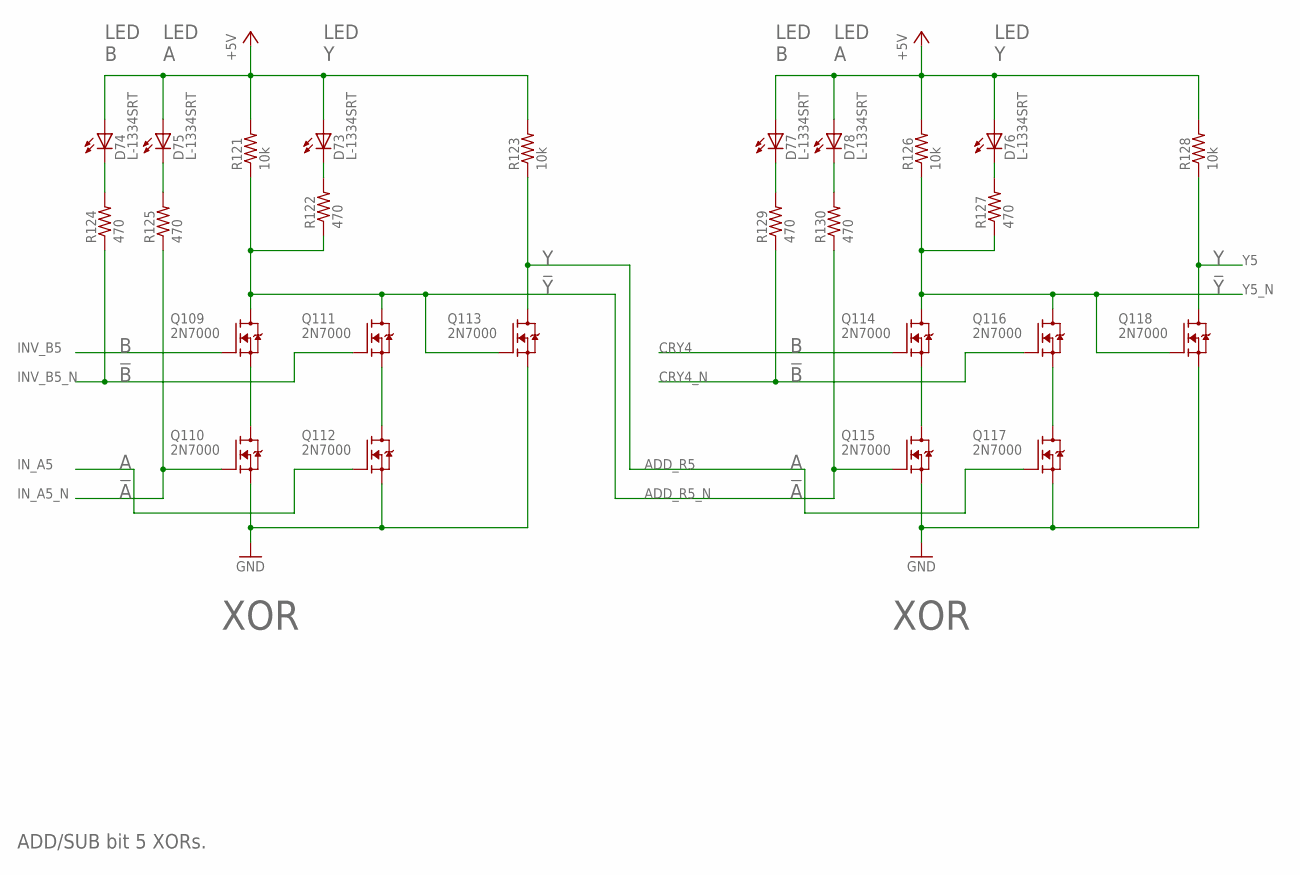
[picture p110: schematic 8BIT_ADD_SUB.sch, sheet 18]

Parts:
D73, D74, D75, D76, D77, D78: L-1334SRT; LED3MM
Q109, Q110, Q111, Q112, Q113, Q114, Q115, Q116, Q117, Q118: 2N7000; TO92-DGS
R121, R123, R126, R128: 10k; R_P2INCH
R122, R124, R125, R127, R129, R130: 470; R_P2INCH

Connections:
+5V: D73.A, D74.A, D75.A, D76.A, D77.A, D78.A, R121.2, R123.2, R126.2, R128.2; also elsewhere on the board
ADD_R5: Q113.D, Q117.G, R123.1; also elsewhere on the board
ADD_R5_N: Q109.D, Q111.D, Q113.G, Q115.G, R121.1, R122.1, R130.1; also elsewhere on the board
CRY4: Q114.G; also elsewhere on the board
CRY4_N: Q116.G, R129.1; also elsewhere on the board
GND: Q110.S, Q112.S, Q113.S, Q115.S, Q117.S, Q118.S; also elsewhere on the board
INV_B5: Q109.G; also elsewhere on the board
INV_B5_N: Q111.G, R124.1; also elsewhere on the board
IN_A5: Q112.G; also elsewhere on the board
IN_A5_N: Q110.G, R125.1; also elsewhere on the board
unnamed: Q109.S, Q110.D
unnamed: Q111.S, Q112.D
unnamed: D73.K (C), R122.2
unnamed: D75.K (C), R125.2
unnamed: D74.K (C), R124.2
unnamed: Q114.S, Q115.D
unnamed: Q116.S, Q117.D
unnamed: D76.K (C), R127.2
unnamed: D78.K (C), R130.2
unnamed: D77.K (C), R129.2
Y5: Q118.D, R128.1; also elsewhere on the board
Y5_N: Q114.D, Q116.D, Q118.G, R126.1, R127.1; also elsewhere on the board

Notes on the sheet:
ADD/SUB bit 5 XORs.
XOR
LED A
LED B
LED Y

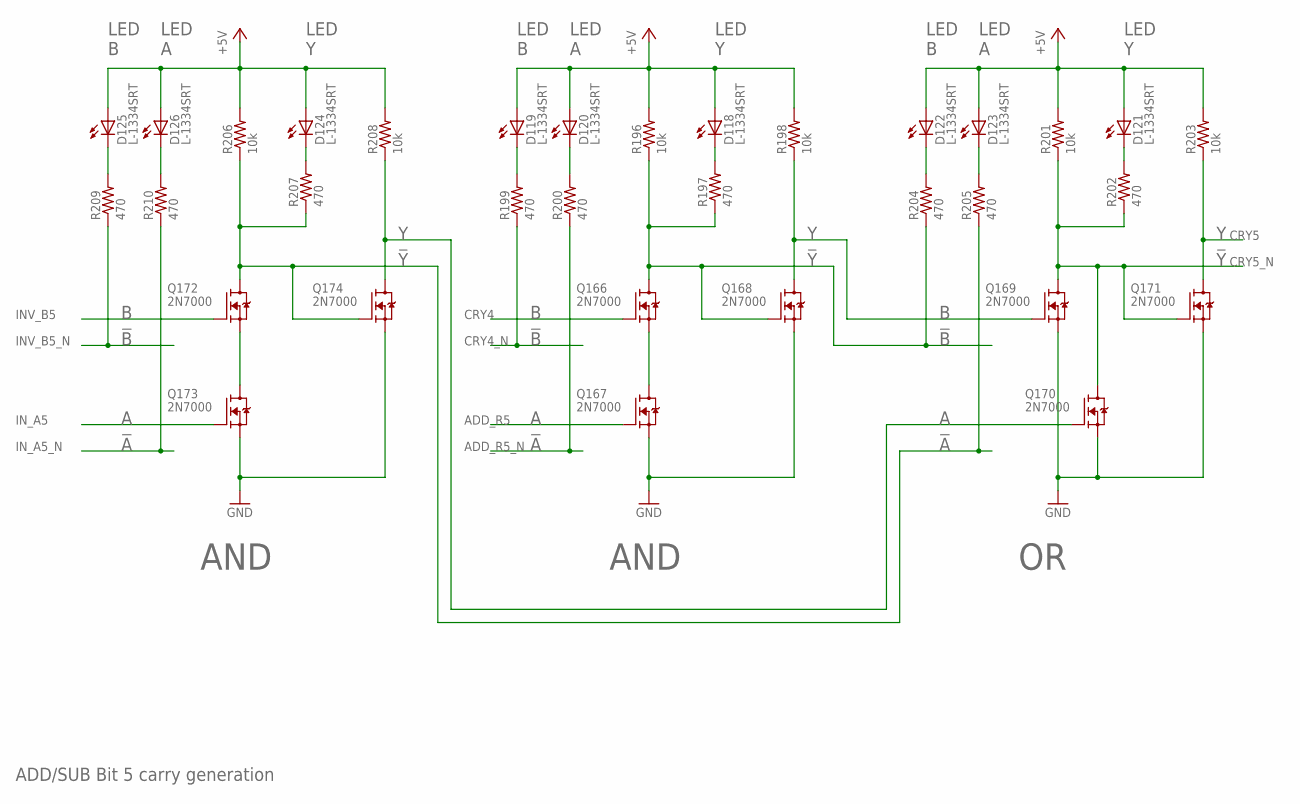
[picture p111: schematic 8BIT_ADD_SUB.sch, sheet 19]

Parts:
D118, D119, D120, D121, D122, D123, D124, D125, D126: L-1334SRT; LED3MM
Q166, Q167, Q168, Q169, Q170, Q171, Q172, Q173, Q174: 2N7000; TO92-DGS
R196, R198, R201, R203, R206, R208: 10k; R_P2INCH
R197, R199, R200, R202, R204, R205, R207, R209, R210: 470; R_P2INCH

Connections:
+5V: D118.A, D119.A, D120.A, D121.A, D122.A, D123.A, D124.A, D125.A, D126.A, R196.2, R198.2, R201.2, R203.2, R206.2, R208.2; also elsewhere on the board
ADD_R5: Q167.G; also elsewhere on the board
ADD_R5_N: R200.1; also elsewhere on the board
CRY4: Q166.G; also elsewhere on the board
CRY4_N: R199.1; also elsewhere on the board
CRY5: Q171.D, R203.1; also elsewhere on the board
CRY5_N: Q169.D, Q170.D, Q171.G, R201.1, R202.1; also elsewhere on the board
GND: Q167.S, Q168.S, Q169.S, Q170.S, Q171.S, Q173.S, Q174.S; also elsewhere on the board
INV_B5: Q172.G; also elsewhere on the board
INV_B5_N: R209.1; also elsewhere on the board
IN_A5: Q173.G; also elsewhere on the board
IN_A5_N: R210.1; also elsewhere on the board
unnamed: Q166.S, Q167.D
unnamed: D118.K (C), R197.2
unnamed: Q168.D, Q169.G, R198.1
unnamed: Q166.D, Q168.G, R196.1, R197.1, R204.1
unnamed: D120.K (C), R200.2
unnamed: D119.K (C), R199.2
unnamed: D121.K (C), R202.2
unnamed: D123.K (C), R205.2
unnamed: D122.K (C), R204.2
unnamed: Q172.S, Q173.D
unnamed: D124.K (C), R207.2
unnamed: Q170.G, Q174.D, R208.1
unnamed: Q172.D, Q174.G, R205.1, R206.1, R207.1
unnamed: D126.K (C), R210.2
unnamed: D125.K (C), R209.2

Notes on the sheet:
ADD/SUB Bit 5 carry generation
AND
LED Y
LED A
LED B

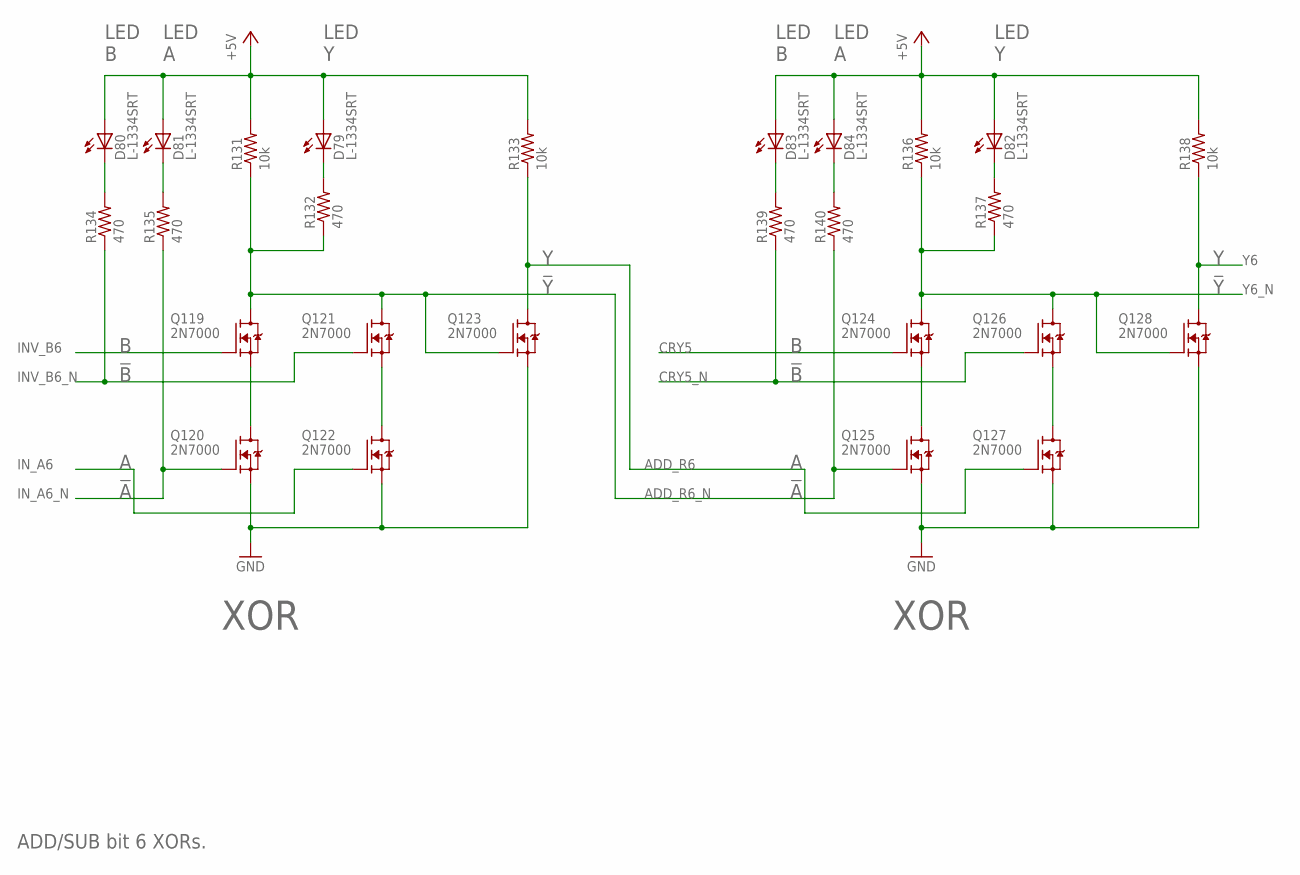
[picture p112: schematic 8BIT_ADD_SUB.sch, sheet 20]

Parts:
D79, D80, D81, D82, D83, D84: L-1334SRT; LED3MM
Q119, Q120, Q121, Q122, Q123, Q124, Q125, Q126, Q127, Q128: 2N7000; TO92-DGS
R131, R133, R136, R138: 10k; R_P2INCH
R132, R134, R135, R137, R139, R140: 470; R_P2INCH

Connections:
+5V: D79.A, D80.A, D81.A, D82.A, D83.A, D84.A, R131.2, R133.2, R136.2, R138.2; also elsewhere on the board
ADD_R6: Q123.D, Q127.G, R133.1; also elsewhere on the board
ADD_R6_N: Q119.D, Q121.D, Q123.G, Q125.G, R131.1, R132.1, R140.1; also elsewhere on the board
CRY5: Q124.G; also elsewhere on the board
CRY5_N: Q126.G, R139.1; also elsewhere on the board
GND: Q120.S, Q122.S, Q123.S, Q125.S, Q127.S, Q128.S; also elsewhere on the board
INV_B6: Q119.G; also elsewhere on the board
INV_B6_N: Q121.G, R134.1; also elsewhere on the board
IN_A6: Q122.G; also elsewhere on the board
IN_A6_N: Q120.G, R135.1; also elsewhere on the board
unnamed: Q119.S, Q120.D
unnamed: Q121.S, Q122.D
unnamed: D79.K (C), R132.2
unnamed: D81.K (C), R135.2
unnamed: D80.K (C), R134.2
unnamed: Q124.S, Q125.D
unnamed: Q126.S, Q127.D
unnamed: D82.K (C), R137.2
unnamed: D84.K (C), R140.2
unnamed: D83.K (C), R139.2
Y6: Q128.D, R138.1; also elsewhere on the board
Y6_N: Q124.D, Q126.D, Q128.G, R136.1, R137.1; also elsewhere on the board

Notes on the sheet:
ADD/SUB bit 6 XORs.
XOR
LED A
LED B
LED Y

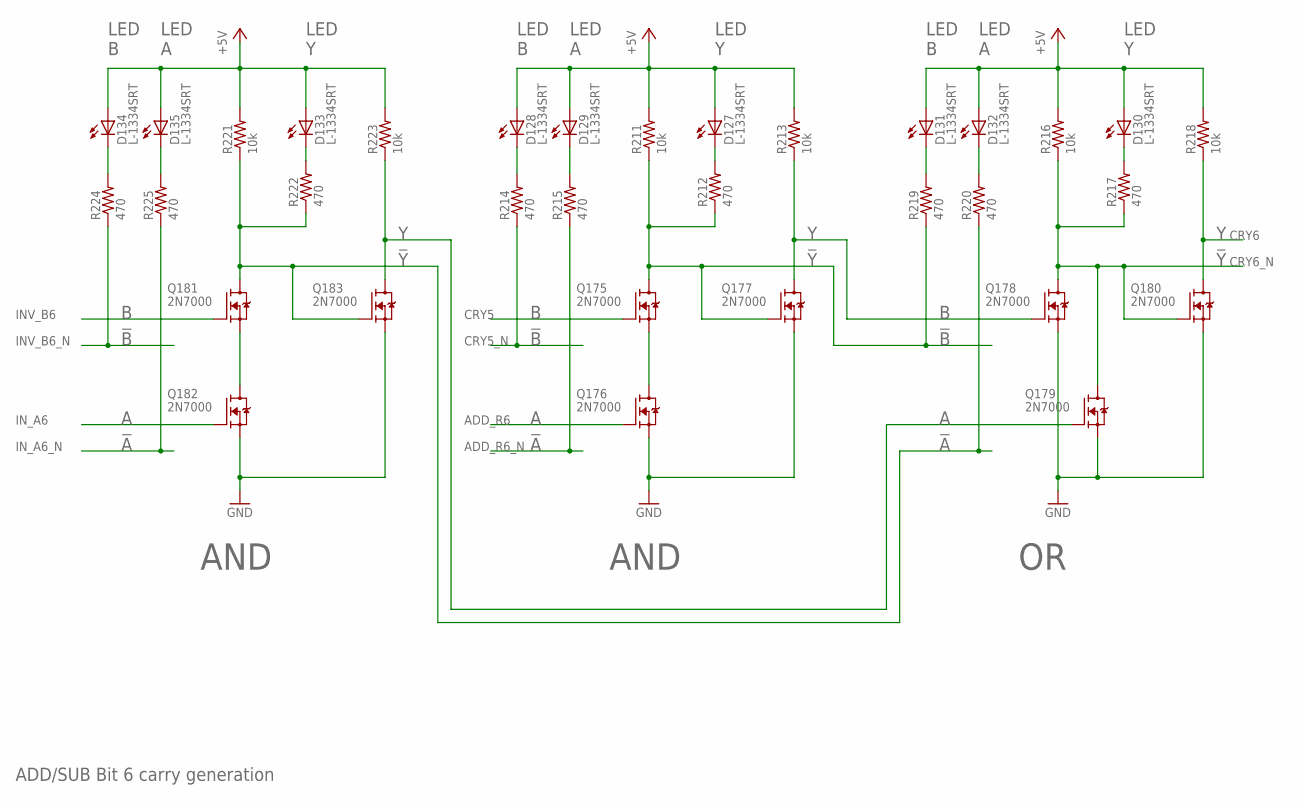
[picture p113: schematic 8BIT_ADD_SUB.sch, sheet 21]

Parts:
D127, D128, D129, D130, D131, D132, D133, D134, D135: L-1334SRT; LED3MM
Q175, Q176, Q177, Q178, Q179, Q180, Q181, Q182, Q183: 2N7000; TO92-DGS
R211, R213, R216, R218, R221, R223: 10k; R_P2INCH
R212, R214, R215, R217, R219, R220, R222, R224, R225: 470; R_P2INCH

Connections:
+5V: D127.A, D128.A, D129.A, D130.A, D131.A, D132.A, D133.A, D134.A, D135.A, R211.2, R213.2, R216.2, R218.2, R221.2, R223.2; also elsewhere on the board
ADD_R6: Q176.G; also elsewhere on the board
ADD_R6_N: R215.1; also elsewhere on the board
CRY5: Q175.G; also elsewhere on the board
CRY5_N: R214.1; also elsewhere on the board
CRY6: Q180.D, R218.1; also elsewhere on the board
CRY6_N: Q178.D, Q179.D, Q180.G, R216.1, R217.1; also elsewhere on the board
GND: Q176.S, Q177.S, Q178.S, Q179.S, Q180.S, Q182.S, Q183.S; also elsewhere on the board
INV_B6: Q181.G; also elsewhere on the board
INV_B6_N: R224.1; also elsewhere on the board
IN_A6: Q182.G; also elsewhere on the board
IN_A6_N: R225.1; also elsewhere on the board
unnamed: Q175.S, Q176.D
unnamed: D127.K (C), R212.2
unnamed: Q177.D, Q178.G, R213.1
unnamed: Q175.D, Q177.G, R211.1, R212.1, R219.1
unnamed: D129.K (C), R215.2
unnamed: D128.K (C), R214.2
unnamed: D130.K (C), R217.2
unnamed: D132.K (C), R220.2
unnamed: D131.K (C), R219.2
unnamed: Q181.S, Q182.D
unnamed: D133.K (C), R222.2
unnamed: Q179.G, Q183.D, R223.1
unnamed: Q181.D, Q183.G, R220.1, R221.1, R222.1
unnamed: D135.K (C), R225.2
unnamed: D134.K (C), R224.2

Notes on the sheet:
ADD/SUB Bit 6 carry generation
AND
LED Y
LED A
LED B

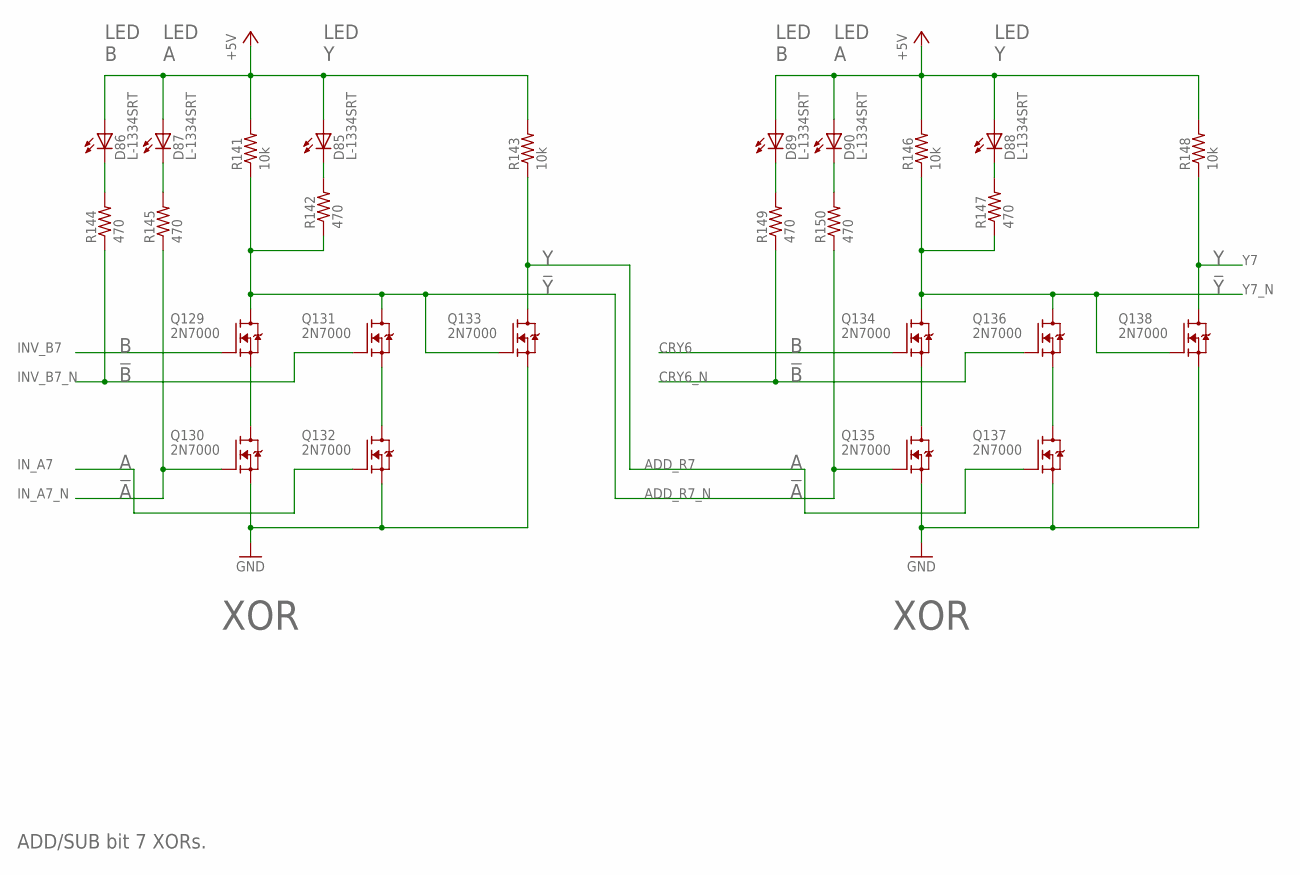
[picture p114: schematic 8BIT_ADD_SUB.sch, sheet 22]

Parts:
D85, D86, D87, D88, D89, D90: L-1334SRT; LED3MM
Q129, Q130, Q131, Q132, Q133, Q134, Q135, Q136, Q137, Q138: 2N7000; TO92-DGS
R141, R143, R146, R148: 10k; R_P2INCH
R142, R144, R145, R147, R149, R150: 470; R_P2INCH

Connections:
+5V: D85.A, D86.A, D87.A, D88.A, D89.A, D90.A, R141.2, R143.2, R146.2, R148.2; also elsewhere on the board
ADD_R7: Q133.D, Q137.G, R143.1; also elsewhere on the board
ADD_R7_N: Q129.D, Q131.D, Q133.G, Q135.G, R141.1, R142.1, R150.1; also elsewhere on the board
CRY6: Q134.G; also elsewhere on the board
CRY6_N: Q136.G, R149.1; also elsewhere on the board
GND: Q130.S, Q132.S, Q133.S, Q135.S, Q137.S, Q138.S; also elsewhere on the board
INV_B7: Q129.G; also elsewhere on the board
INV_B7_N: Q131.G, R144.1; also elsewhere on the board
IN_A7: Q132.G; also elsewhere on the board
IN_A7_N: Q130.G, R145.1; also elsewhere on the board
unnamed: Q129.S, Q130.D
unnamed: Q131.S, Q132.D
unnamed: D85.K (C), R142.2
unnamed: D87.K (C), R145.2
unnamed: D86.K (C), R144.2
unnamed: Q134.S, Q135.D
unnamed: Q136.S, Q137.D
unnamed: D88.K (C), R147.2
unnamed: D90.K (C), R150.2
unnamed: D89.K (C), R149.2
Y7: Q138.D, R148.1; also elsewhere on the board
Y7_N: Q134.D, Q136.D, Q138.G, R146.1, R147.1; also elsewhere on the board

Notes on the sheet:
ADD/SUB bit 7 XORs.
XOR
LED A
LED B
LED Y
