ericherman/megaprocessor/8bit_add_sub/8BIT_ADD_SUB.brd

## EAGLE design 8bit_add_sub/8BIT_ADD_SUB.brd (continued)

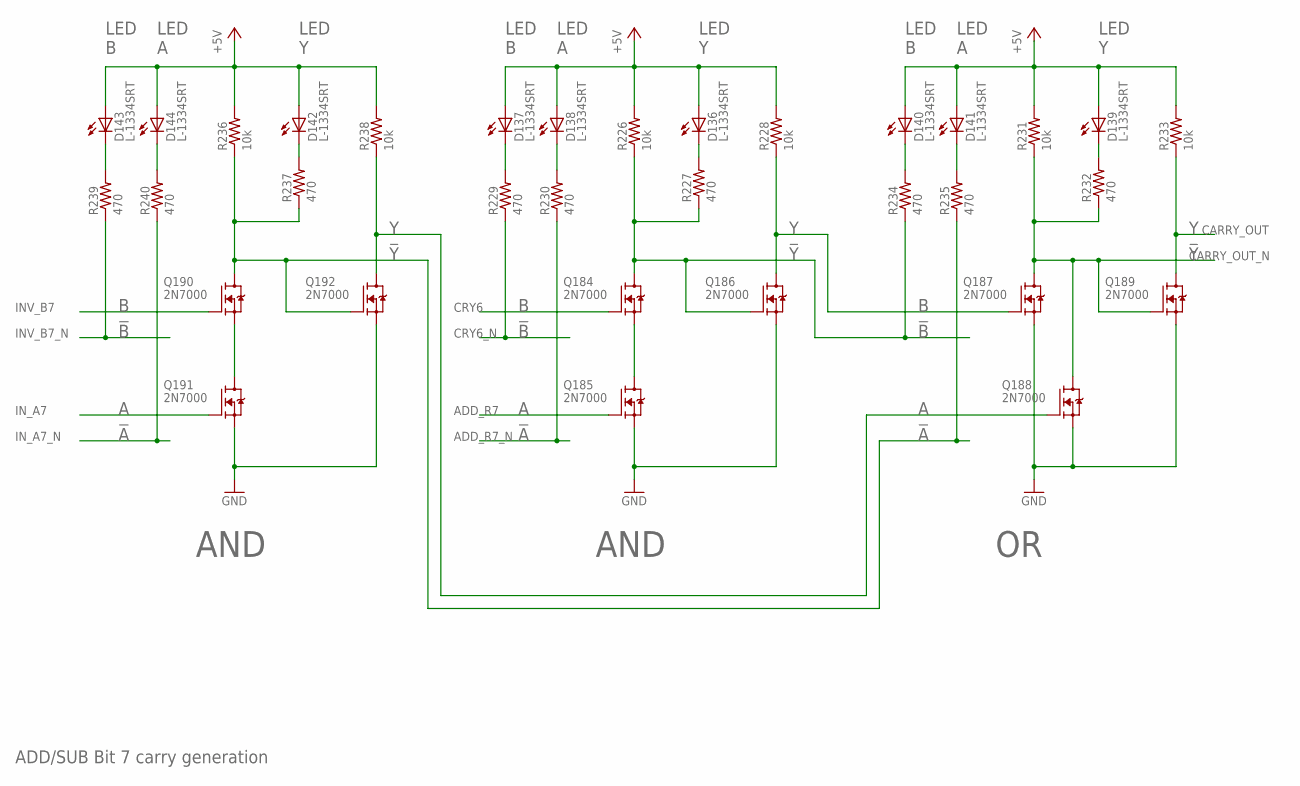
[picture p115: schematic 8BIT_ADD_SUB.sch, sheet 23]

Parts:
D136, D137, D138, D139, D140, D141, D142, D143, D144: L-1334SRT; LED3MM
Q184, Q185, Q186, Q187, Q188, Q189, Q190, Q191, Q192: 2N7000; TO92-DGS
R226, R228, R231, R233, R236, R238: 10k; R_P2INCH
R227, R229, R230, R232, R234, R235, R237, R239, R240: 470; R_P2INCH

Connections:
+5V: D136.A, D137.A, D138.A, D139.A, D140.A, D141.A, D142.A, D143.A, D144.A, R226.2, R228.2, R231.2, R233.2, R236.2, R238.2; also elsewhere on the board
ADD_R7: Q185.G; also elsewhere on the board
ADD_R7_N: R230.1; also elsewhere on the board
CARRY_OUT: Q189.D, R233.1; also elsewhere on the board
CARRY_OUT_N: Q187.D, Q188.D, Q189.G, R231.1, R232.1
CRY6: Q184.G; also elsewhere on the board
CRY6_N: R229.1; also elsewhere on the board
GND: Q185.S, Q186.S, Q187.S, Q188.S, Q189.S, Q191.S, Q192.S; also elsewhere on the board
INV_B7: Q190.G; also elsewhere on the board
INV_B7_N: R239.1; also elsewhere on the board
IN_A7: Q191.G; also elsewhere on the board
IN_A7_N: R240.1; also elsewhere on the board
unnamed: Q184.S, Q185.D
unnamed: D136.K (C), R227.2
unnamed: Q186.D, Q187.G, R228.1
unnamed: Q184.D, Q186.G, R226.1, R227.1, R234.1
unnamed: D138.K (C), R230.2
unnamed: D137.K (C), R229.2
unnamed: D139.K (C), R232.2
unnamed: D141.K (C), R235.2
unnamed: D140.K (C), R234.2
unnamed: Q190.S, Q191.D
unnamed: D142.K (C), R237.2
unnamed: Q188.G, Q192.D, R238.1
unnamed: Q190.D, Q192.G, R235.1, R236.1, R237.1
unnamed: D144.K (C), R240.2
unnamed: D143.K (C), R239.2

Notes on the sheet:
ADD/SUB Bit 7 carry generation
AND
LED Y
LED A
LED B

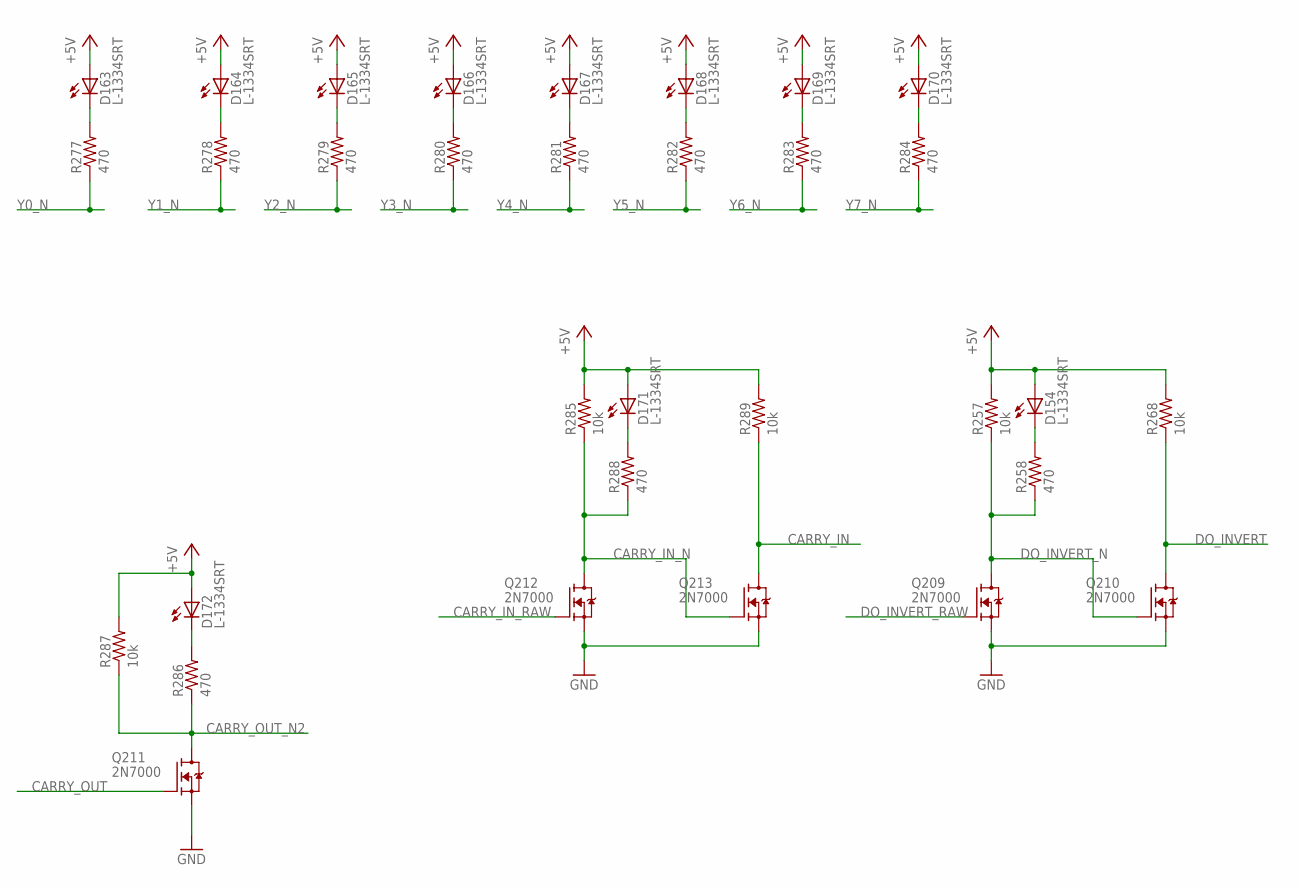
[picture p116: schematic 8BIT_ADD_SUB.sch, sheet 24]

Parts:
D154, D163, D164, D165, D166, D167, D168, D169, D170, D171, D172: L-1334SRT; LED3MM
Q209, Q210, Q211, Q212, Q213: 2N7000; TO92-DGS
R257, R268, R285, R287, R289: 10k; R_P2INCH
R258, R277, R278, R279, R280, R281, R282, R283, R284, R286, R288: 470; R_P2INCH

Connections:
+5V: D154.A, D163.A, D164.A, D165.A, D166.A, D167.A, D168.A, D169.A, D170.A, D171.A, D172.A, R257.2, R268.2, R285.2, R287.2, R289.2; also elsewhere on the board
CARRY_IN: Q213.D, R289.1; also elsewhere on the board
CARRY_IN_N: Q212.D, Q213.G, R285.1, R288.1; also elsewhere on the board
CARRY_IN_RAW: Q212.G; also elsewhere on the board
CARRY_OUT: Q211.G; also elsewhere on the board
CARRY_OUT_N2: Q211.D, R286.1, R287.1
DO_INVERT: Q210.D, R268.1; also elsewhere on the board
DO_INVERT_N: Q209.D, Q210.G, R257.1, R258.1; also elsewhere on the board
DO_INVERT_RAW: Q209.G; also elsewhere on the board
GND: Q209.S, Q210.S, Q211.S, Q212.S, Q213.S; also elsewhere on the board
unnamed: D154.K (C), R258.2
unnamed: D163.K (C), R277.2
unnamed: D171.K (C), R288.2
unnamed: D164.K (C), R278.2
unnamed: D165.K (C), R279.2
unnamed: D166.K (C), R280.2
unnamed: D167.K (C), R281.2
unnamed: D168.K (C), R282.2
unnamed: D169.K (C), R283.2
unnamed: D170.K (C), R284.2
unnamed: D172.K (C), R286.2
Y0_N: R277.1; also elsewhere on the board
Y1_N: R278.1; also elsewhere on the board
Y2_N: R279.1; also elsewhere on the board
Y3_N: R280.1; also elsewhere on the board
Y4_N: R281.1; also elsewhere on the board
Y5_N: R282.1; also elsewhere on the board
Y6_N: R283.1; also elsewhere on the board
Y7_N: R284.1; also elsewhere on the board

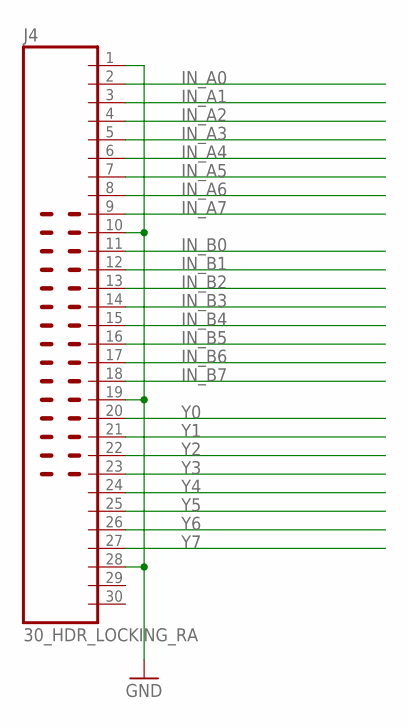
[picture p117: schematic 8BIT_ADD_SUB.sch, sheet 25]

Parts:
J4: 30_HDR_LOCKING_RA

Connections:
GND: J4.1, J4.10, J4.19, J4.28; also elsewhere on the board
IN_A0: J4.2; also elsewhere on the board
IN_A1: J4.3; also elsewhere on the board
IN_A2: J4.4; also elsewhere on the board
IN_A3: J4.5; also elsewhere on the board
IN_A4: J4.6; also elsewhere on the board
IN_A5: J4.7; also elsewhere on the board
IN_A6: J4.8; also elsewhere on the board
IN_A7: J4.9; also elsewhere on the board
IN_B0: J4.11; also elsewhere on the board
IN_B1: J4.12; also elsewhere on the board
IN_B2: J4.13; also elsewhere on the board
IN_B3: J4.14; also elsewhere on the board
IN_B4: J4.15; also elsewhere on the board
IN_B5: J4.16; also elsewhere on the board
IN_B6: J4.17; also elsewhere on the board
IN_B7: J4.18; also elsewhere on the board
Y0: J4.20; also elsewhere on the board
Y1: J4.21; also elsewhere on the board
Y2: J4.22; also elsewhere on the board
Y3: J4.23; also elsewhere on the board
Y4: J4.24; also elsewhere on the board
Y5: J4.25; also elsewhere on the board
Y6: J4.26; also elsewhere on the board
Y7: J4.27; also elsewhere on the board

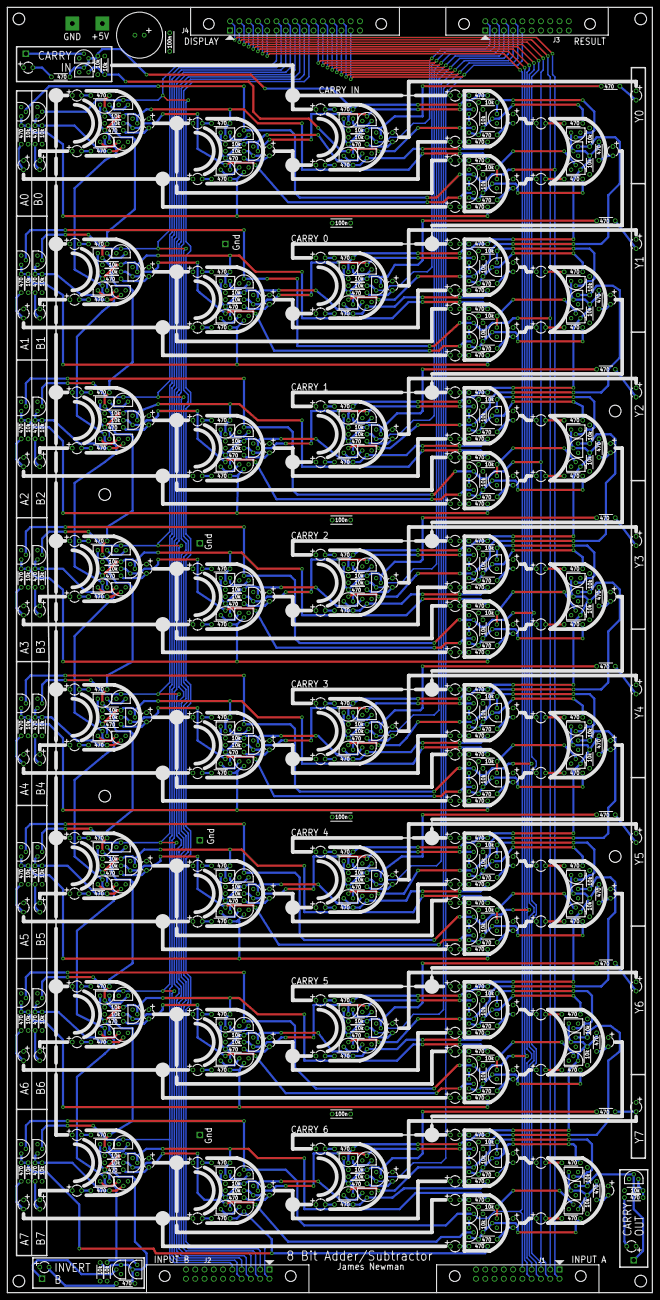
[picture p118: board 8BIT_ADD_SUB.brd from above]

Board: 4 copper layers, 176.5 x 351.8 mm, 699 parts (0 on the bottom side), 372 nets.
