ericherman/megaprocessor/module_artwork_state/module_state.brd

## EAGLE design module_artwork_state/module_state.brd (2017-05-20)

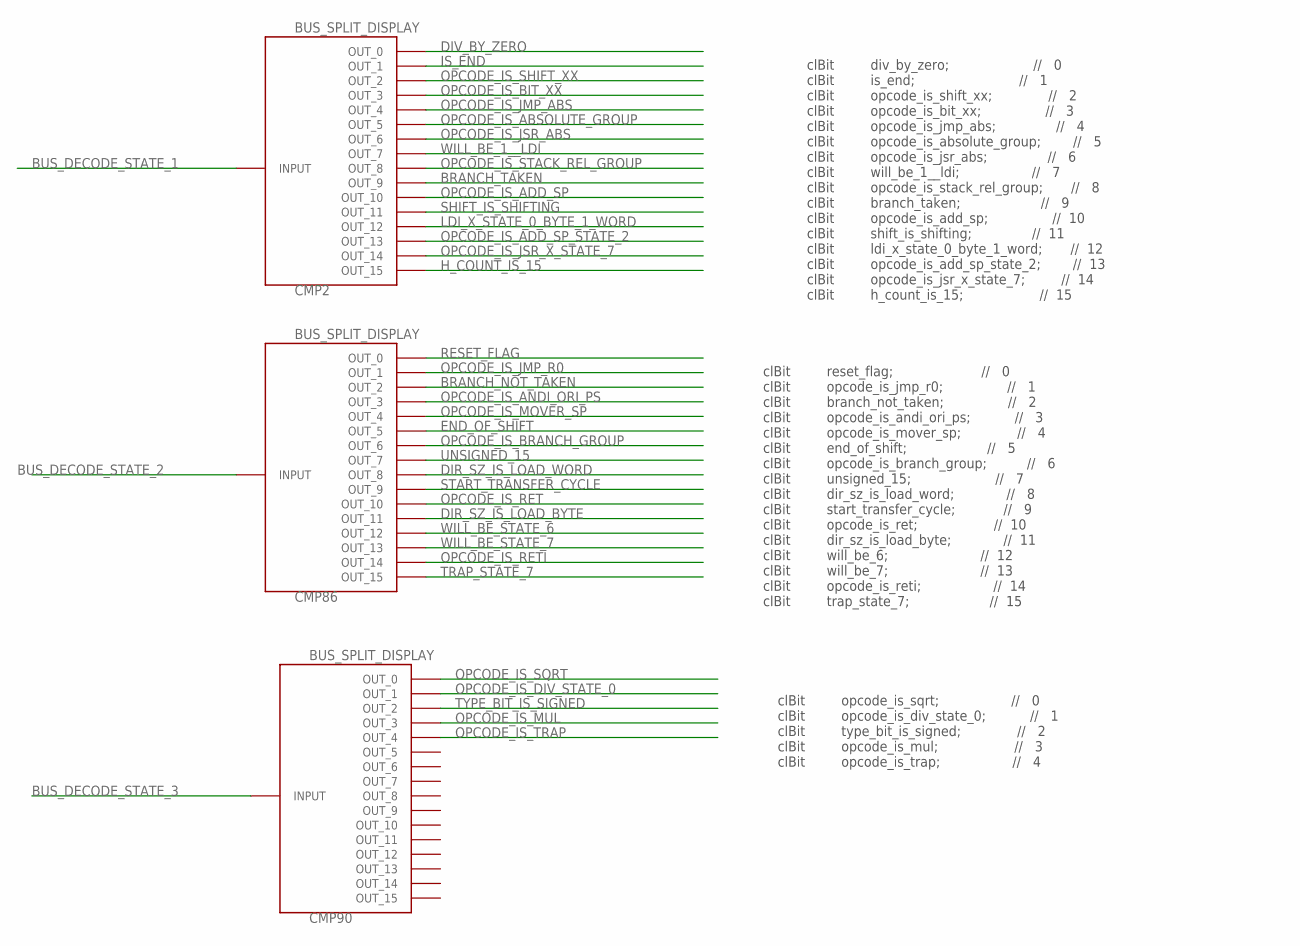
[picture p119: schematic module_state.sch, sheet 1]

Parts:
CMP2, CMP86, CMP90: BUS_SPLIT_DISPLAY

Connections:
BRANCH_NOT_TAKEN: CMP86.P$3 (OUT_2); also elsewhere on the board
BRANCH_TAKEN: CMP2.P$10 (OUT_9); also elsewhere on the board
BUS_DECODE_STATE_1: CMP2.INPUT
BUS_DECODE_STATE_2: CMP86.INPUT
BUS_DECODE_STATE_3: CMP90.INPUT
DIR_SZ_IS_LOAD_BYTE: CMP86.P$12 (OUT_11); also elsewhere on the board
DIR_SZ_IS_LOAD_WORD: CMP86.P$9 (OUT_8); also elsewhere on the board
DIV_BY_ZERO: CMP2.P$1 (OUT_0); also elsewhere on the board
END_OF_SHIFT: CMP86.P$6 (OUT_5); also elsewhere on the board
H_COUNT_IS_15: CMP2.P$16 (OUT_15); also elsewhere on the board
IS_END: CMP2.P$2 (OUT_1); also elsewhere on the board
LDI_X_STATE_0_BYTE_1_WORD: CMP2.P$13 (OUT_12); also elsewhere on the board
OPCODE_IS_ABSOLUTE_GROUP: CMP2.P$6 (OUT_5); also elsewhere on the board
OPCODE_IS_ADD_SP: CMP2.P$11 (OUT_10); also elsewhere on the board
OPCODE_IS_ADD_SP_STATE_2: CMP2.P$14 (OUT_13); also elsewhere on the board
OPCODE_IS_ANDI_ORI_PS: CMP86.P$4 (OUT_3); also elsewhere on the board
OPCODE_IS_BIT_XX: CMP2.P$4 (OUT_3); also elsewhere on the board
OPCODE_IS_BRANCH_GROUP: CMP86.P$7 (OUT_6); also elsewhere on the board
OPCODE_IS_DIV_STATE_0: CMP90.P$2 (OUT_1); also elsewhere on the board
OPCODE_IS_JMP_ABS: CMP2.P$5 (OUT_4); also elsewhere on the board
OPCODE_IS_JMP_R0: CMP86.P$2 (OUT_1); also elsewhere on the board
OPCODE_IS_JSR_ABS: CMP2.P$7 (OUT_6); also elsewhere on the board
OPCODE_IS_JSR_X_STATE_7: CMP2.P$15 (OUT_14); also elsewhere on the board
OPCODE_IS_MOVER_SP: CMP86.P$5 (OUT_4); also elsewhere on the board
OPCODE_IS_MUL: CMP90.P$4 (OUT_3); also elsewhere on the board
OPCODE_IS_RET: CMP86.P$11 (OUT_10); also elsewhere on the board
OPCODE_IS_RETI: CMP86.P$15 (OUT_14); also elsewhere on the board
OPCODE_IS_SHIFT_XX: CMP2.P$3 (OUT_2); also elsewhere on the board
OPCODE_IS_SQRT: CMP90.P$1 (OUT_0); also elsewhere on the board
OPCODE_IS_STACK_REL_GROUP: CMP2.P$9 (OUT_8); also elsewhere on the board
OPCODE_IS_TRAP: CMP90.P$5 (OUT_4); also elsewhere on the board
RESET_FLAG: CMP86.P$1 (OUT_0); also elsewhere on the board
SHIFT_IS_SHIFTING: CMP2.P$12 (OUT_11); also elsewhere on the board
START_TRANSFER_CYCLE: CMP86.P$10 (OUT_9); also elsewhere on the board
TRAP_STATE_7: CMP86.P$16 (OUT_15); also elsewhere on the board
TYPE_BIT_IS_SIGNED: CMP90.P$3 (OUT_2); also elsewhere on the board
UNSIGNED_15: CMP86.P$8 (OUT_7); also elsewhere on the board
WILL_BE_1__LDI: CMP2.P$8 (OUT_7); also elsewhere on the board
WILL_BE_STATE_6: CMP86.P$13 (OUT_12); also elsewhere on the board
WILL_BE_STATE_7: CMP86.P$14 (OUT_13); also elsewhere on the board

Notes on the sheet:
clBit div_by_zero; // 0 clBit is_end; // 1 clBit opcode_is_shift_xx; // 2 clBit opcode_is_bit_xx; // 3 clBit opcode_is_jmp_abs; // 4 clBit opcode_is_absolute_group; // 5 clBit opcode_is_jsr_abs; // 6 clBit will_be_1__ldi; // 7 clBit opcode_is_stack_rel_group; // 8 clBit branch_taken; // 9 clBit opc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
clBit reset_flag; // 0 clBit opcode_is_jmp_r0; // 1 clBit branch_not_taken; // 2 clBit opcode_is_andi_ori_ps; // 3 clBit opcode_is_mover_sp; // 4 clBit end_of_shift; // 5 clBit opcode_is_branch_group; // 6 clBit unsigned_15; // 7 clBit dir_sz_is_load_word; // 8 clBit start_transfer_cycle; // 9 clBi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
clBit opcode_is_sqrt; // 0 clBit opcode_is_div_state_0; // 1 clBit type_bit_is_signed; // 2 clBit opcode_is_mul; // 3 clBit opcode_is_trap; // 4

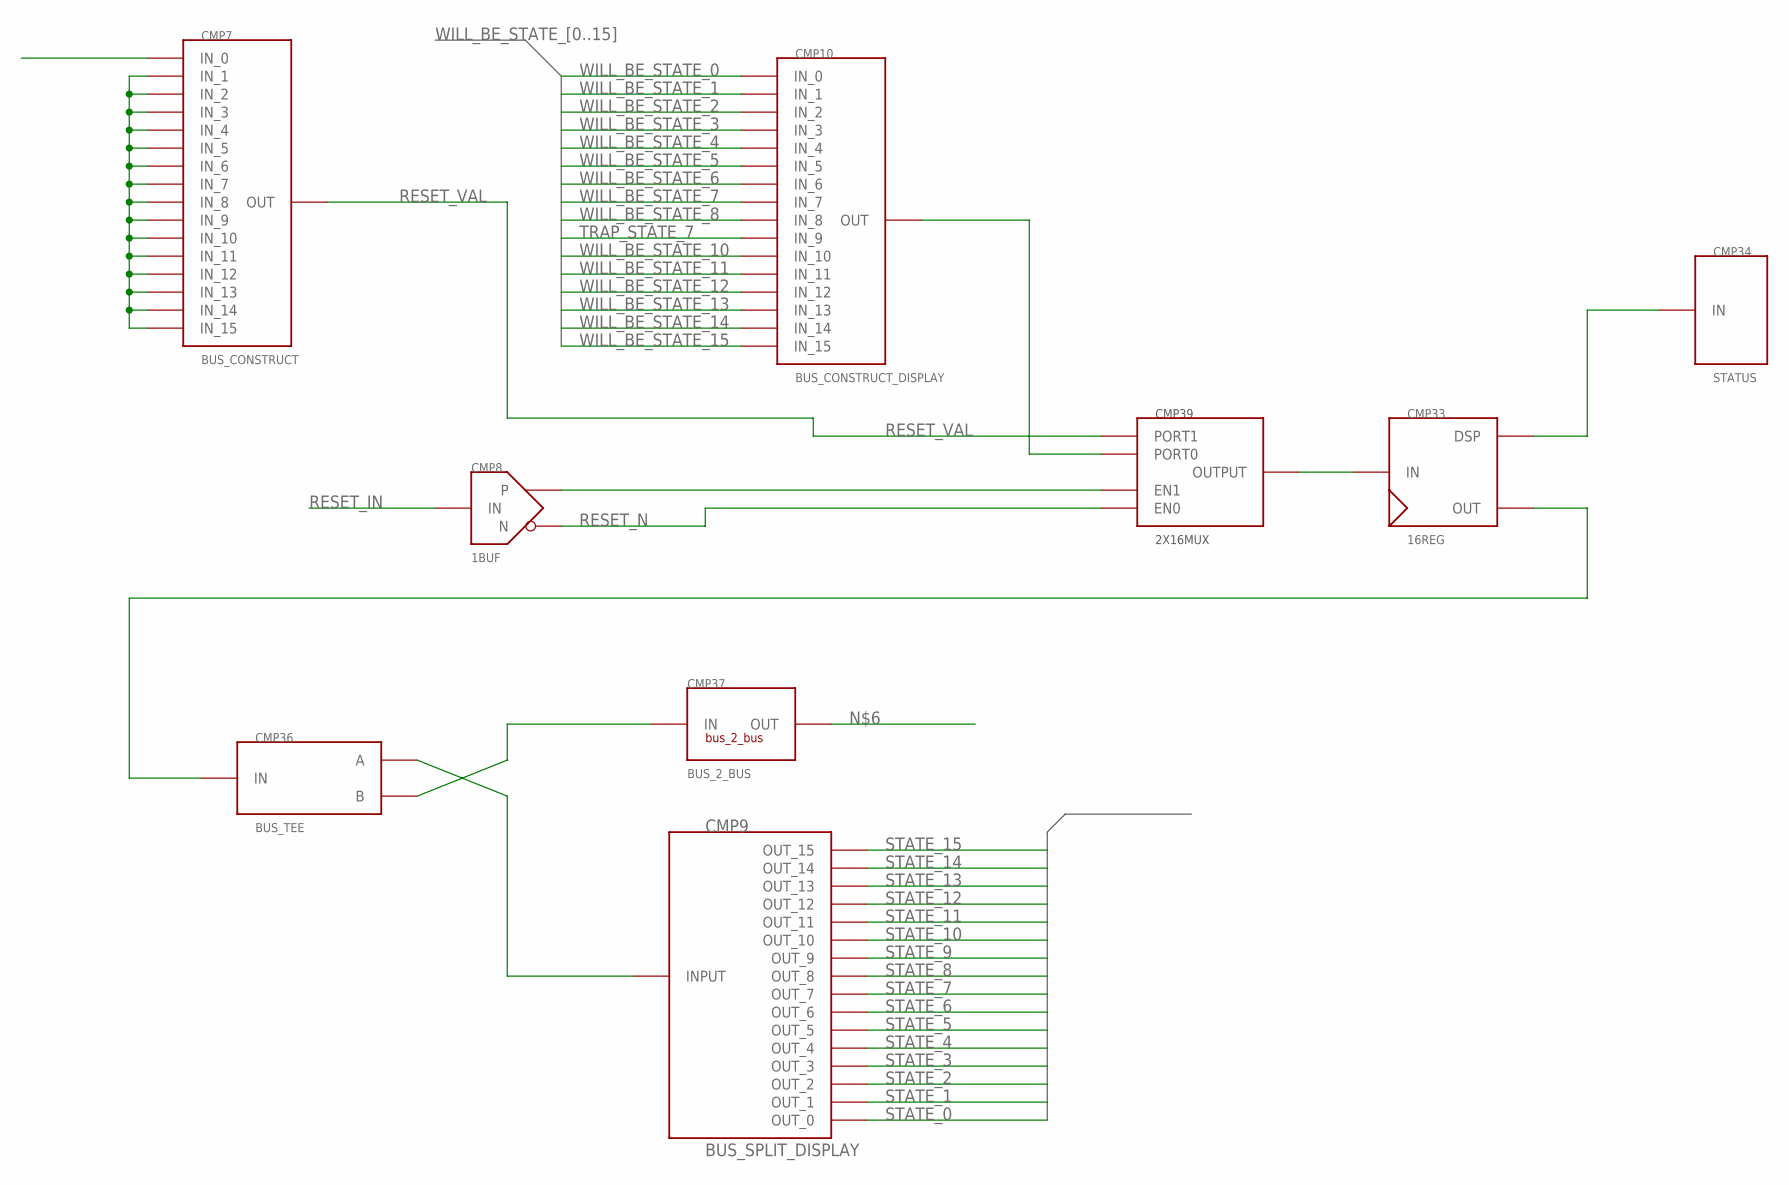
[picture p120: schematic module_state.sch, sheet 2]

Parts:
CMP7: BUS_CONSTRUCT; BUS_SPLIT
CMP8: 1BUF
CMP9: BUS_SPLIT_DISPLAY
CMP10: BUS_CONSTRUCT_DISPLAY; BUS_SPLIT_DISPLAY
CMP33: 16REG
CMP34: STATUS
CMP36: BUS_TEE
CMP37: BUS_2_BUS; BUS2BUS
CMP39: 2X16MUX

Connections:
unnamed: CMP33.DISPLAY (DSP), CMP34.P$1
unnamed: CMP33.OUT, CMP36.INPUT (IN)
unnamed: CMP36.OUTB (B), CMP37.P$1 (IN)
unnamed: CMP7.P$2 (IN_1), CMP7.P$3 (IN_2), CMP7.P$4 (IN_3), CMP7.P$5 (IN_4), CMP7.P$6 (IN_5), CMP7.P$7 (IN_6), CMP7.P$8 (IN_7), CMP7.P$9 (IN_8), CMP7.P$10 (IN_9), CMP7.P$11 (IN_10), CMP7.P$12 (IN_11), CMP7.P$13 (IN_12), CMP7.P$14 (IN_13), CMP7.P$15 (IN_14), CMP7.P$16 (IN_15)
unnamed: CMP9.INPUT, CMP36.OUT_A (A)
unnamed: CMP10.INPUT (OUT), CMP39.PORT0
unnamed: CMP33.INPUT (IN), CMP39.OUT (OUTPUT)
unnamed: CMP8.P, CMP39.EN1
RESET_IN: CMP8.IN
RESET_N: CMP8.N, CMP39.EN0
RESET_VAL: CMP7.INPUT (OUT), CMP39.PORT1
STATE_0: CMP9.P$1 (OUT_0); also elsewhere on the board
STATE_1: CMP9.P$2 (OUT_1); also elsewhere on the board
STATE_2: CMP9.P$3 (OUT_2); also elsewhere on the board
STATE_3: CMP9.P$4 (OUT_3)
STATE_4: CMP9.P$5 (OUT_4); also elsewhere on the board
STATE_5: CMP9.P$6 (OUT_5); also elsewhere on the board
STATE_6: CMP9.P$7 (OUT_6)
STATE_7: CMP9.P$8 (OUT_7); also elsewhere on the board
STATE_8: CMP9.P$9 (OUT_8); also elsewhere on the board
STATE_9: CMP9.P$10 (OUT_9); also elsewhere on the board
STATE_10: CMP9.P$11 (OUT_10); also elsewhere on the board
STATE_11: CMP9.P$12 (OUT_11); also elsewhere on the board
STATE_12: CMP9.P$13 (OUT_12); also elsewhere on the board
STATE_13: CMP9.P$14 (OUT_13); also elsewhere on the board
STATE_14: CMP9.P$15 (OUT_14); also elsewhere on the board
STATE_15: CMP9.P$16 (OUT_15)
TRAP_STATE_7: CMP10.P$10 (IN_9); also elsewhere on the board
WILL_BE_STATE_0: CMP10.P$1 (IN_0); also elsewhere on the board
WILL_BE_STATE_1: CMP10.P$2 (IN_1); also elsewhere on the board
WILL_BE_STATE_2: CMP10.P$3 (IN_2); also elsewhere on the board
WILL_BE_STATE_3: CMP10.P$4 (IN_3); also elsewhere on the board
WILL_BE_STATE_4: CMP10.P$5 (IN_4); also elsewhere on the board
WILL_BE_STATE_5: CMP10.P$6 (IN_5); also elsewhere on the board
WILL_BE_STATE_6: CMP10.P$7 (IN_6); also elsewhere on the board
WILL_BE_STATE_7: CMP10.P$8 (IN_7); also elsewhere on the board
WILL_BE_STATE_8: CMP10.P$9 (IN_8); also elsewhere on the board
WILL_BE_STATE_10: CMP10.P$11 (IN_10); also elsewhere on the board
WILL_BE_STATE_11: CMP10.P$12 (IN_11); also elsewhere on the board
WILL_BE_STATE_12: CMP10.P$13 (IN_12); also elsewhere on the board
WILL_BE_STATE_13: CMP10.P$14 (IN_13); also elsewhere on the board
WILL_BE_STATE_14: CMP10.P$15 (IN_14); also elsewhere on the board
WILL_BE_STATE_15: CMP10.P$16 (IN_15); also elsewhere on the board

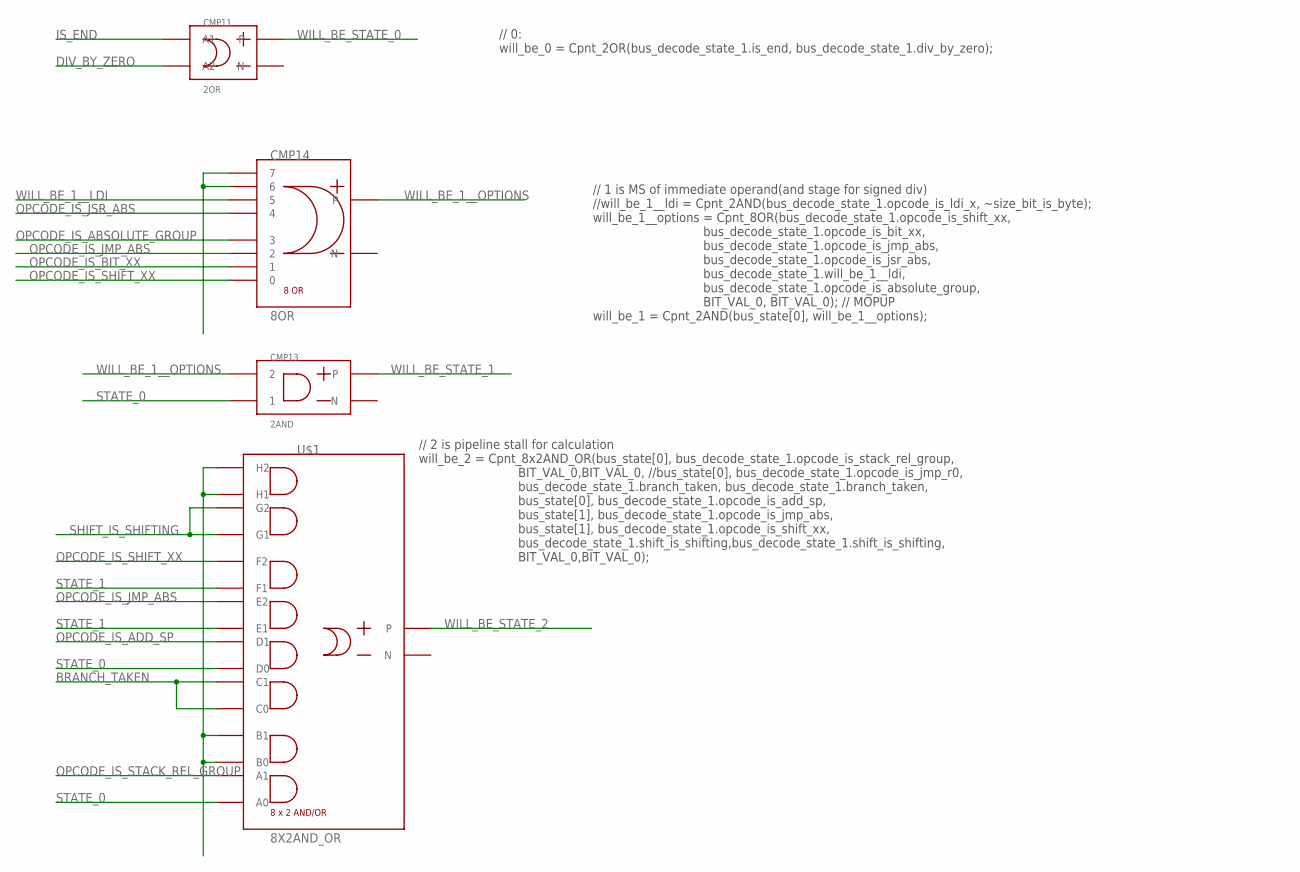
[picture p121: schematic module_state.sch, sheet 3]

Parts:
CMP11: 2OR
CMP13: 2AND
CMP14: 8OR
U$1: 8X2AND_OR

Connections:
BRANCH_TAKEN: U$1.P$5 (C0), U$1.P$6 (C1); also elsewhere on the board
DIV_BY_ZERO: CMP11.P$1 (A2); also elsewhere on the board
IS_END: CMP11.P$2 (A1); also elsewhere on the board
unnamed: U$1.P$3 (B0), U$1.P$4 (B1), U$1.P$15 (H1), U$1.P$16 (H2)
unnamed: CMP14.7 (6), CMP14.8 (7)
OPCODE_IS_ABSOLUTE_GROUP: CMP14.4 (3); also elsewhere on the board
OPCODE_IS_ADD_SP: U$1.P$8 (D1); also elsewhere on the board
OPCODE_IS_BIT_XX: CMP14.2 (1); also elsewhere on the board
OPCODE_IS_JMP_ABS: CMP14.3 (2), U$1.P$10 (E2); also elsewhere on the board
OPCODE_IS_JSR_ABS: CMP14.5 (4); also elsewhere on the board
OPCODE_IS_SHIFT_XX: CMP14.1 (0), U$1.P$12 (F2); also elsewhere on the board
OPCODE_IS_STACK_REL_GROUP: U$1.P$2 (A1); also elsewhere on the board
SHIFT_IS_SHIFTING: U$1.P$13 (G1), U$1.P$14 (G2); also elsewhere on the board
STATE_0: CMP13.P$1 (1), U$1.P$1 (A0), U$1.P$7 (D0); also elsewhere on the board
STATE_1: U$1.P$9 (E1), U$1.P$11 (F1); also elsewhere on the board
WILL_BE_1__LDI: CMP14.6 (5); also elsewhere on the board
WILL_BE_1__OPTIONS: CMP13.P$2 (2), CMP14.OUT_P
WILL_BE_STATE_0: CMP11.OUT_P; also elsewhere on the board
WILL_BE_STATE_1: CMP13.OUT_P; also elsewhere on the board
WILL_BE_STATE_2: U$1.OUT_P; also elsewhere on the board

Notes on the sheet:
// 0: will_be_0 = Cpnt_2OR(bus_decode_state_1.is_end, bus_decode_state_1.div_by_zero);
// 1 is MS of immediate operand(and stage for signed div) //will_be_1__ldi = Cpnt_2AND(bus_decode_state_1.opcode_is_ldi_x, ~size_bit_is_byte); will_be_1__options = Cpnt_8OR(bus_decode_state_1.opcode_is_shift_xx, bus_decode_state_1.opcode_is_bit_xx, bus_decode_state_1.opcode_is_jmp_abs, bus_decode_s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
// 2 is pipeline stall for calculation will_be_2 = Cpnt_8x2AND_OR(bus_state[0], bus_decode_state_1.opcode_is_stack_rel_group, BIT_VAL_0,BIT_VAL_0, //bus_state[0], bus_decode_state_1.opcode_is_jmp_r0, bus_decode_state_1.branch_taken, bus_decode_state_1.branch_taken, bus_state[0], bus_decode_state_1.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

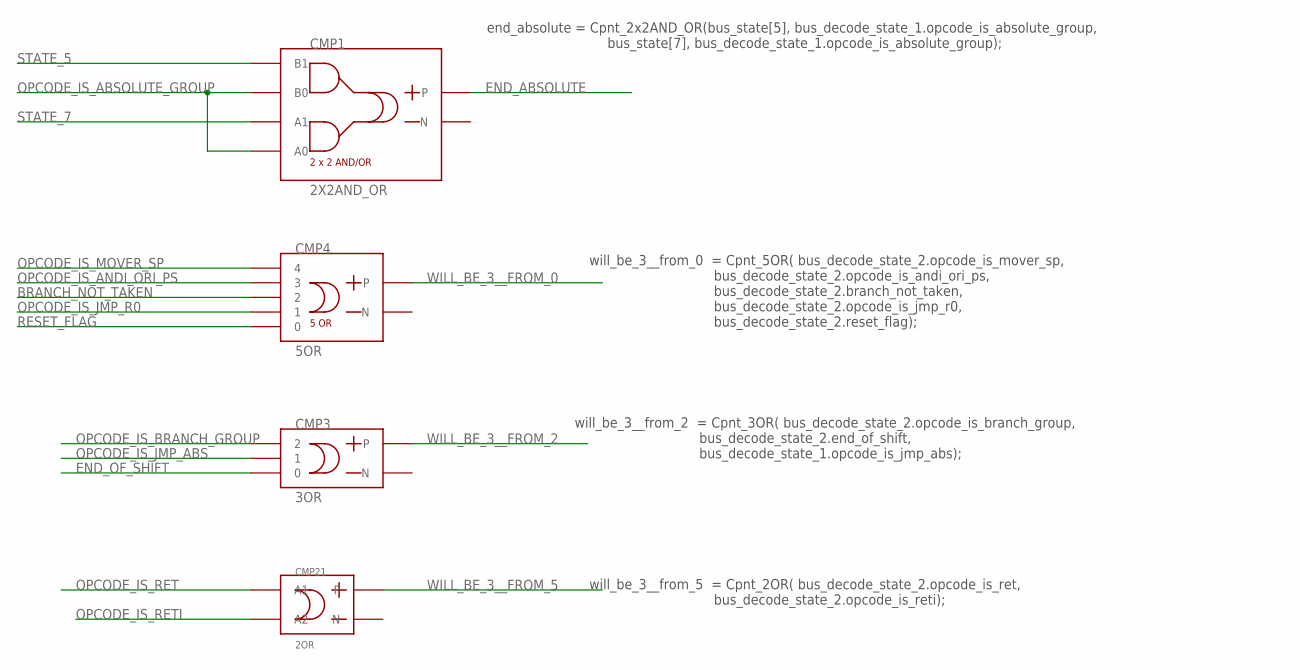
[picture p122: schematic module_state.sch, sheet 4]

Parts:
CMP1: 2X2AND_OR
CMP3: 3OR
CMP4: 5OR
CMP21: 2OR

Connections:
BRANCH_NOT_TAKEN: CMP4.3 (2); also elsewhere on the board
END_ABSOLUTE: CMP1.OUT_P; also elsewhere on the board
END_OF_SHIFT: CMP3.P$1 (0); also elsewhere on the board
OPCODE_IS_ABSOLUTE_GROUP: CMP1.P$1 (A0), CMP1.P$3 (B0); also elsewhere on the board
OPCODE_IS_ANDI_ORI_PS: CMP4.4 (3); also elsewhere on the board
OPCODE_IS_BRANCH_GROUP: CMP3.P$3 (2); also elsewhere on the board
OPCODE_IS_JMP_ABS: CMP3.P$2 (1); also elsewhere on the board
OPCODE_IS_JMP_R0: CMP4.2 (1); also elsewhere on the board
OPCODE_IS_MOVER_SP: CMP4.5 (4); also elsewhere on the board
OPCODE_IS_RET: CMP21.P$1 (A2); also elsewhere on the board
OPCODE_IS_RETI: CMP21.P$2 (A1); also elsewhere on the board
RESET_FLAG: CMP4.1 (0); also elsewhere on the board
STATE_5: CMP1.P$4 (B1); also elsewhere on the board
STATE_7: CMP1.P$2 (A1); also elsewhere on the board
WILL_BE_3__FROM_0: CMP4.OUT_P; also elsewhere on the board
WILL_BE_3__FROM_2: CMP3.OUT_P; also elsewhere on the board
WILL_BE_3__FROM_5: CMP21.OUT_P; also elsewhere on the board

Notes on the sheet:
end_absolute = Cpnt_2x2AND_OR(bus_state[5], bus_decode_state_1.opcode_is_absolute_group, bus_state[7], bus_decode_state_1.opcode_is_absolute_group);
will_be_3__from_0 = Cpnt_5OR( bus_decode_state_2.opcode_is_mover_sp, bus_decode_state_2.opcode_is_andi_ori_ps, bus_decode_state_2.branch_not_taken, bus_decode_state_2.opcode_is_jmp_r0, bus_decode_state_2.reset_flag);
will_be_3__from_2 = Cpnt_3OR( bus_decode_state_2.opcode_is_branch_group, bus_decode_state_2.end_of_shift, bus_decode_state_1.opcode_is_jmp_abs);
will_be_3__from_5 = Cpnt_2OR( bus_decode_state_2.opcode_is_ret, bus_decode_state_2.opcode_is_reti);

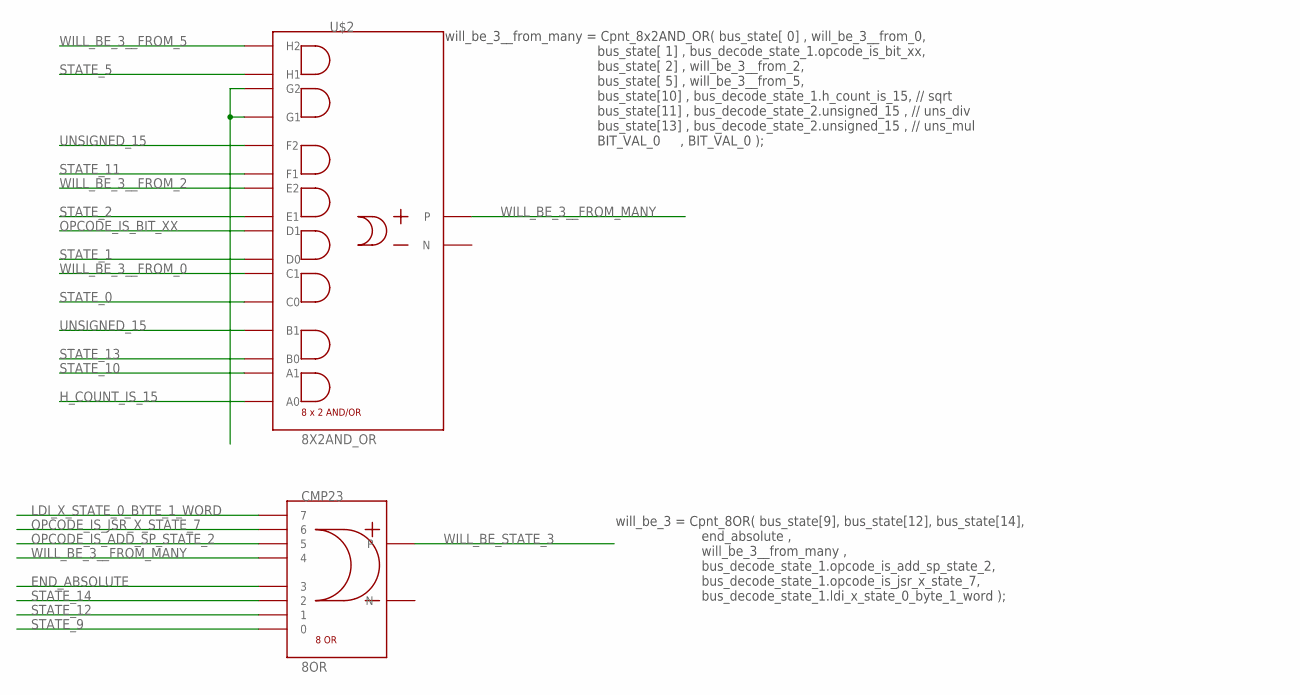
[picture p123: schematic module_state.sch, sheet 5]

Parts:
CMP23: 8OR
U$2: 8X2AND_OR

Connections:
END_ABSOLUTE: CMP23.8 (7); also elsewhere on the board
H_COUNT_IS_15: U$2.P$1 (A0); also elsewhere on the board
LDI_X_STATE_0_BYTE_1_WORD: CMP23.4 (3); also elsewhere on the board
unnamed: U$2.P$13 (G1), U$2.P$14 (G2)
OPCODE_IS_ADD_SP_STATE_2: CMP23.5 (4); also elsewhere on the board
OPCODE_IS_BIT_XX: U$2.P$8 (D1); also elsewhere on the board
OPCODE_IS_JSR_X_STATE_7: CMP23.6 (5); also elsewhere on the board
STATE_0: U$2.P$5 (C0); also elsewhere on the board
STATE_1: U$2.P$7 (D0); also elsewhere on the board
STATE_2: U$2.P$9 (E1); also elsewhere on the board
STATE_5: U$2.P$15 (H1); also elsewhere on the board
STATE_9: CMP23.1 (0); also elsewhere on the board
STATE_10: U$2.P$2 (A1); also elsewhere on the board
STATE_11: U$2.P$11 (F1); also elsewhere on the board
STATE_12: CMP23.2 (1); also elsewhere on the board
STATE_13: U$2.P$3 (B0); also elsewhere on the board
STATE_14: CMP23.3 (2); also elsewhere on the board
UNSIGNED_15: U$2.P$4 (B1), U$2.P$12 (F2); also elsewhere on the board
WILL_BE_3__FROM_0: U$2.P$6 (C1); also elsewhere on the board
WILL_BE_3__FROM_2: U$2.P$10 (E2); also elsewhere on the board
WILL_BE_3__FROM_5: U$2.P$16 (H2); also elsewhere on the board
WILL_BE_3__FROM_MANY: CMP23.7 (6), U$2.OUT_P
WILL_BE_STATE_3: CMP23.OUT_P; also elsewhere on the board

Notes on the sheet:
will_be_3__from_many = Cpnt_8x2AND_OR( bus_state[ 0] , will_be_3__from_0, bus_state[ 1] , bus_decode_state_1.opcode_is_bit_xx, bus_state[ 2] , will_be_3__from_2, bus_state[ 5] , will_be_3__from_5, bus_state[10] , bus_decode_state_1.h_count_is_15, // sqrt bus_state[11] , bus_decode_state_2.unsigned_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
will_be_3 = Cpnt_8OR( bus_state[9], bus_state[12], bus_state[14], end_absolute , will_be_3__from_many , bus_decode_state_1.opcode_is_add_sp_state_2, bus_decode_state_1.opcode_is_jsr_x_state_7, bus_decode_state_1.ldi_x_state_0_byte_1_word );

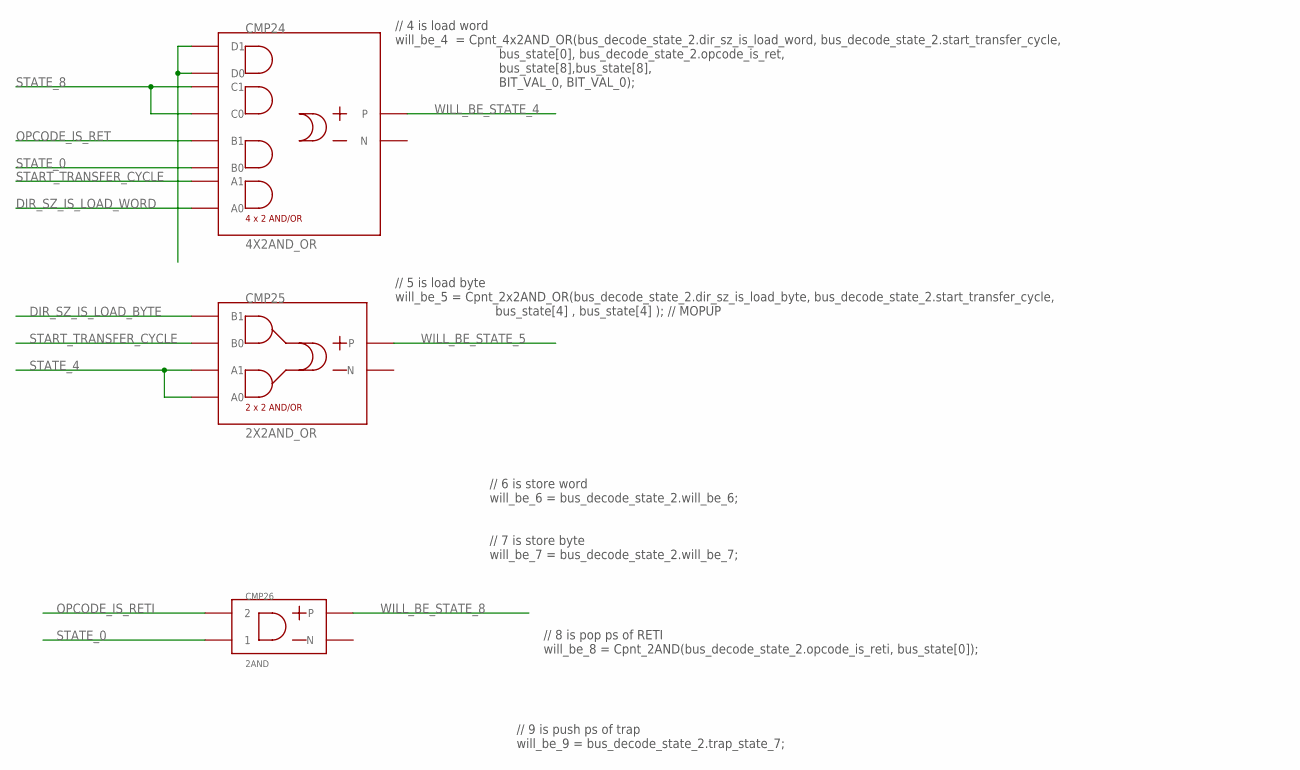
[picture p124: schematic module_state.sch, sheet 6]

Parts:
CMP24: 4X2AND_OR
CMP25: 2X2AND_OR
CMP26: 2AND

Connections:
DIR_SZ_IS_LOAD_BYTE: CMP25.P$4 (B1); also elsewhere on the board
DIR_SZ_IS_LOAD_WORD: CMP24.P$1 (A0); also elsewhere on the board
unnamed: CMP24.P$7 (D0), CMP24.P$8 (D1)
OPCODE_IS_RET: CMP24.P$4 (B1); also elsewhere on the board
OPCODE_IS_RETI: CMP26.P$2 (2); also elsewhere on the board
START_TRANSFER_CYCLE: CMP24.P$2 (A1), CMP25.P$3 (B0); also elsewhere on the board
STATE_0: CMP24.P$3 (B0), CMP26.P$1 (1); also elsewhere on the board
STATE_4: CMP25.P$1 (A0), CMP25.P$2 (A1); also elsewhere on the board
STATE_8: CMP24.P$5 (C0), CMP24.P$6 (C1); also elsewhere on the board
WILL_BE_STATE_4: CMP24.OUT_P; also elsewhere on the board
WILL_BE_STATE_5: CMP25.OUT_P; also elsewhere on the board
WILL_BE_STATE_8: CMP26.OUT_P; also elsewhere on the board

Notes on the sheet:
// 4 is load word will_be_4 = Cpnt_4x2AND_OR(bus_decode_state_2.dir_sz_is_load_word, bus_decode_state_2.start_transfer_cycle, bus_state[0], bus_decode_state_2.opcode_is_ret, bus_state[8],bus_state[8], BIT_VAL_0, BIT_VAL_0);
// 5 is load byte will_be_5 = Cpnt_2x2AND_OR(bus_decode_state_2.dir_sz_is_load_byte, bus_decode_state_2.start_transfer_cycle, bus_state[4] , bus_state[4] ); // MOPUP
// 6 is store word will_be_6 = bus_decode_state_2.will_be_6; // 7 is store byte will_be_7 = bus_decode_state_2.will_be_7;
// 8 is pop ps of RETI will_be_8 = Cpnt_2AND(bus_decode_state_2.opcode_is_reti, bus_state[0]);
// 9 is push ps of trap will_be_9 = bus_decode_state_2.trap_state_7;

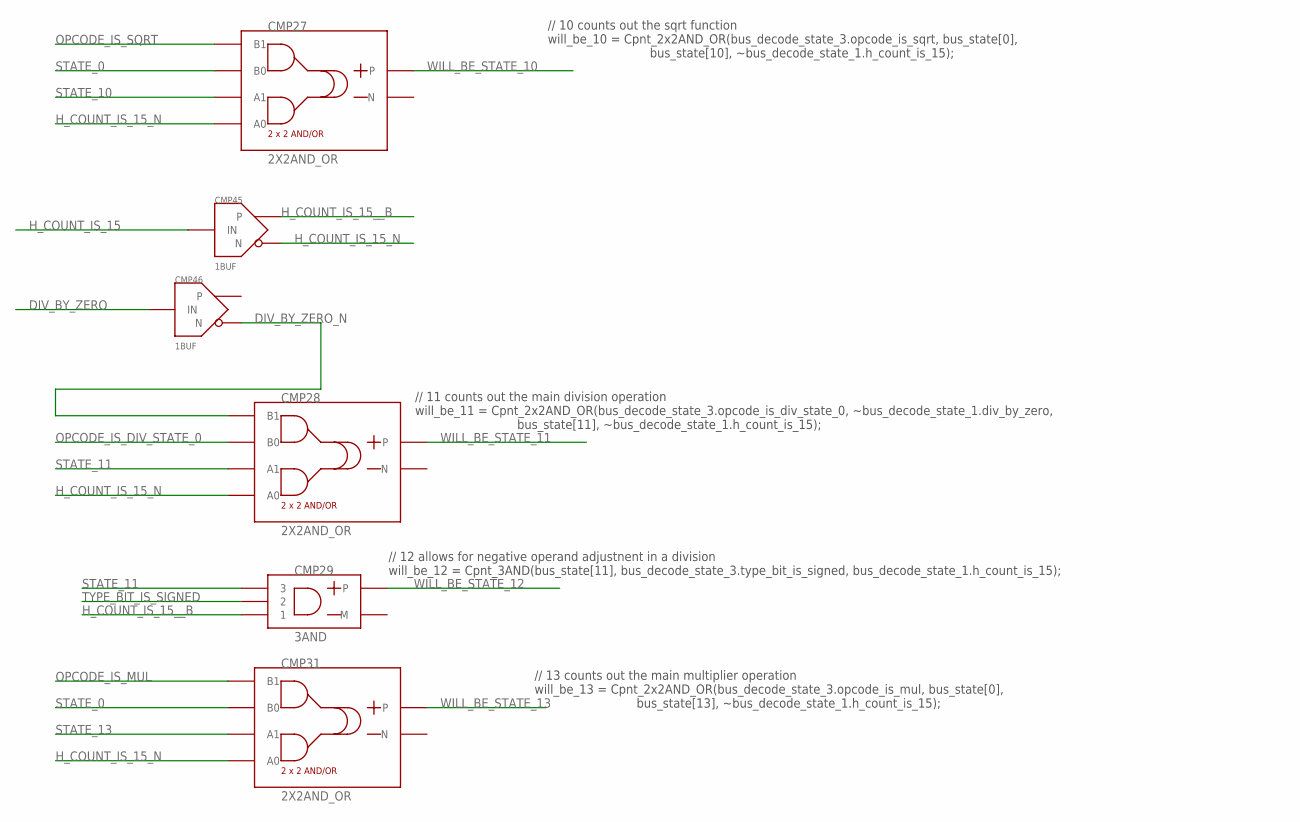
[picture p125: schematic module_state.sch, sheet 7]

Parts:
CMP27, CMP28, CMP31: 2X2AND_OR
CMP29: 3AND
CMP45, CMP46: 1BUF

Connections:
DIV_BY_ZERO: CMP46.IN; also elsewhere on the board
DIV_BY_ZERO_N: CMP28.P$4 (B1), CMP46.N
H_COUNT_IS_15: CMP45.IN; also elsewhere on the board
H_COUNT_IS_15_N: CMP27.P$1 (A0), CMP28.P$1 (A0), CMP31.P$1 (A0), CMP45.N
H_COUNT_IS_15__B: CMP29.P$1 (1), CMP45.P; also elsewhere on the board
OPCODE_IS_DIV_STATE_0: CMP28.P$3 (B0); also elsewhere on the board
OPCODE_IS_MUL: CMP31.P$4 (B1); also elsewhere on the board
OPCODE_IS_SQRT: CMP27.P$4 (B1); also elsewhere on the board
STATE_0: CMP27.P$3 (B0), CMP31.P$3 (B0); also elsewhere on the board
STATE_10: CMP27.P$2 (A1); also elsewhere on the board
STATE_11: CMP28.P$2 (A1), CMP29.P$3 (3); also elsewhere on the board
STATE_13: CMP31.P$2 (A1); also elsewhere on the board
TYPE_BIT_IS_SIGNED: CMP29.P$2 (2); also elsewhere on the board
WILL_BE_STATE_10: CMP27.OUT_P; also elsewhere on the board
WILL_BE_STATE_11: CMP28.OUT_P; also elsewhere on the board
WILL_BE_STATE_12: CMP29.OUT_P; also elsewhere on the board
WILL_BE_STATE_13: CMP31.OUT_P; also elsewhere on the board

Notes on the sheet:
// 10 counts out the sqrt function will_be_10 = Cpnt_2x2AND_OR(bus_decode_state_3.opcode_is_sqrt, bus_state[0], bus_state[10], ~bus_decode_state_1.h_count_is_15);
// 11 counts out the main division operation will_be_11 = Cpnt_2x2AND_OR(bus_decode_state_3.opcode_is_div_state_0, ~bus_decode_state_1.div_by_zero, bus_state[11], ~bus_decode_state_1.h_count_is_15);
// 12 allows for negative operand adjustnent in a division will_be_12 = Cpnt_3AND(bus_state[11], bus_decode_state_3.type_bit_is_signed, bus_decode_state_1.h_count_is_15);
// 13 counts out the main multiplier operation will_be_13 = Cpnt_2x2AND_OR(bus_decode_state_3.opcode_is_mul, bus_state[0], bus_state[13], ~bus_decode_state_1.h_count_is_15);
