ericherman/megaprocessor/module_artwork_state/module_state.brd

## EAGLE design module_artwork_state/module_state.brd (continued)

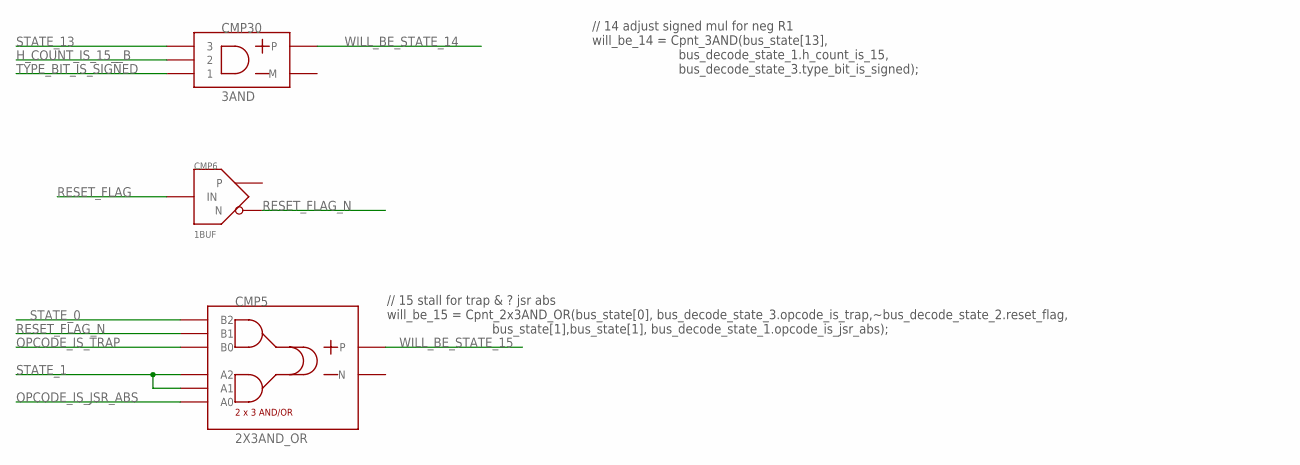
[picture p126: schematic module_state.sch, sheet 8]

Parts:
CMP5: 2X3AND_OR
CMP6: 1BUF
CMP30: 3AND

Connections:
H_COUNT_IS_15__B: CMP30.P$2 (2); also elsewhere on the board
OPCODE_IS_JSR_ABS: CMP5.P$1 (A0); also elsewhere on the board
OPCODE_IS_TRAP: CMP5.P$4 (B0); also elsewhere on the board
RESET_FLAG: CMP6.IN; also elsewhere on the board
RESET_FLAG_N: CMP5.P$5 (B1), CMP6.N
STATE_0: CMP5.P$6 (B2); also elsewhere on the board
STATE_1: CMP5.P$2 (A1), CMP5.P$3 (A2); also elsewhere on the board
STATE_13: CMP30.P$3 (3); also elsewhere on the board
TYPE_BIT_IS_SIGNED: CMP30.P$1 (1); also elsewhere on the board
WILL_BE_STATE_14: CMP30.OUT_P; also elsewhere on the board
WILL_BE_STATE_15: CMP5.OUT_P; also elsewhere on the board

Notes on the sheet:
// 14 adjust signed mul for neg R1 will_be_14 = Cpnt_3AND(bus_state[13], bus_decode_state_1.h_count_is_15, bus_decode_state_3.type_bit_is_signed);
// 15 stall for trap & ? jsr abs will_be_15 = Cpnt_2x3AND_OR(bus_state[0], bus_decode_state_3.opcode_is_trap,~bus_decode_state_2.reset_flag, bus_state[1],bus_state[1], bus_decode_state_1.opcode_is_jsr_abs);

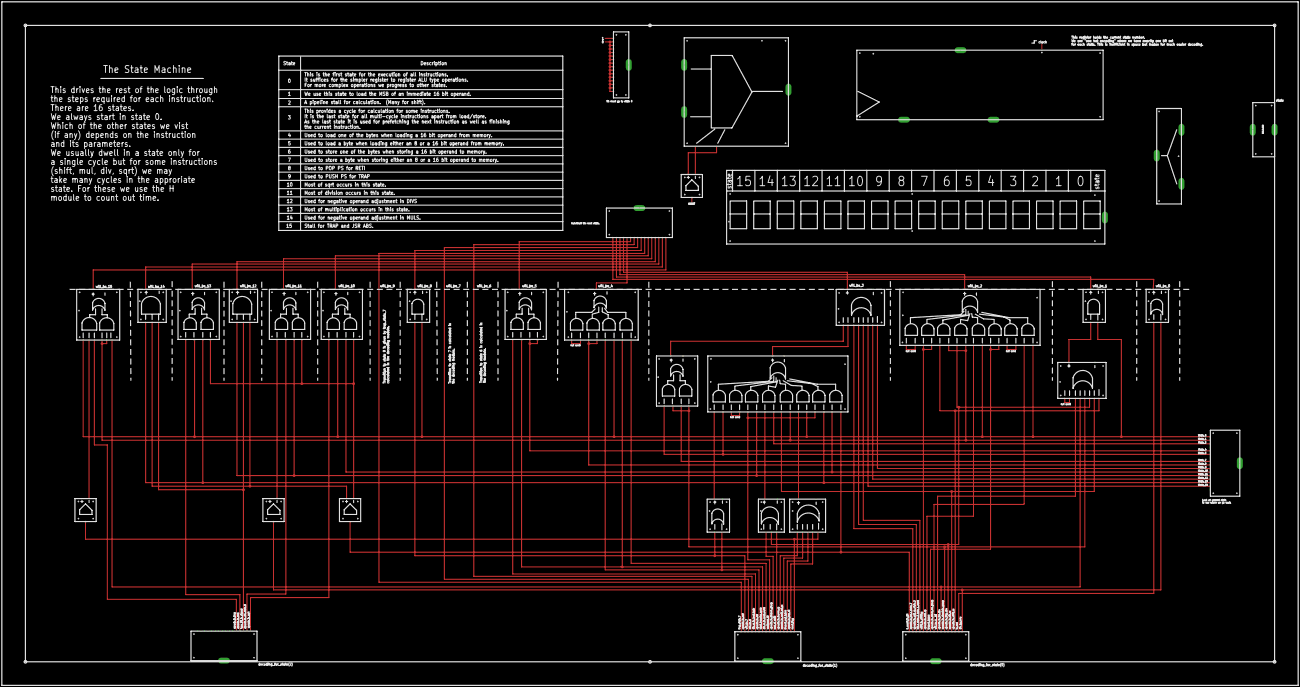
[picture p127: board module_state.brd from above]

Board: 2 copper layers, 1397.0 x 736.6 mm, 34 parts (0 on the bottom side), 87 nets.
