ericherman/megaprocessor/mem_p2p/MEM_P2P_1.brd

## EAGLE design mem_p2p/MEM_P2P_1.brd (2017-05-20)

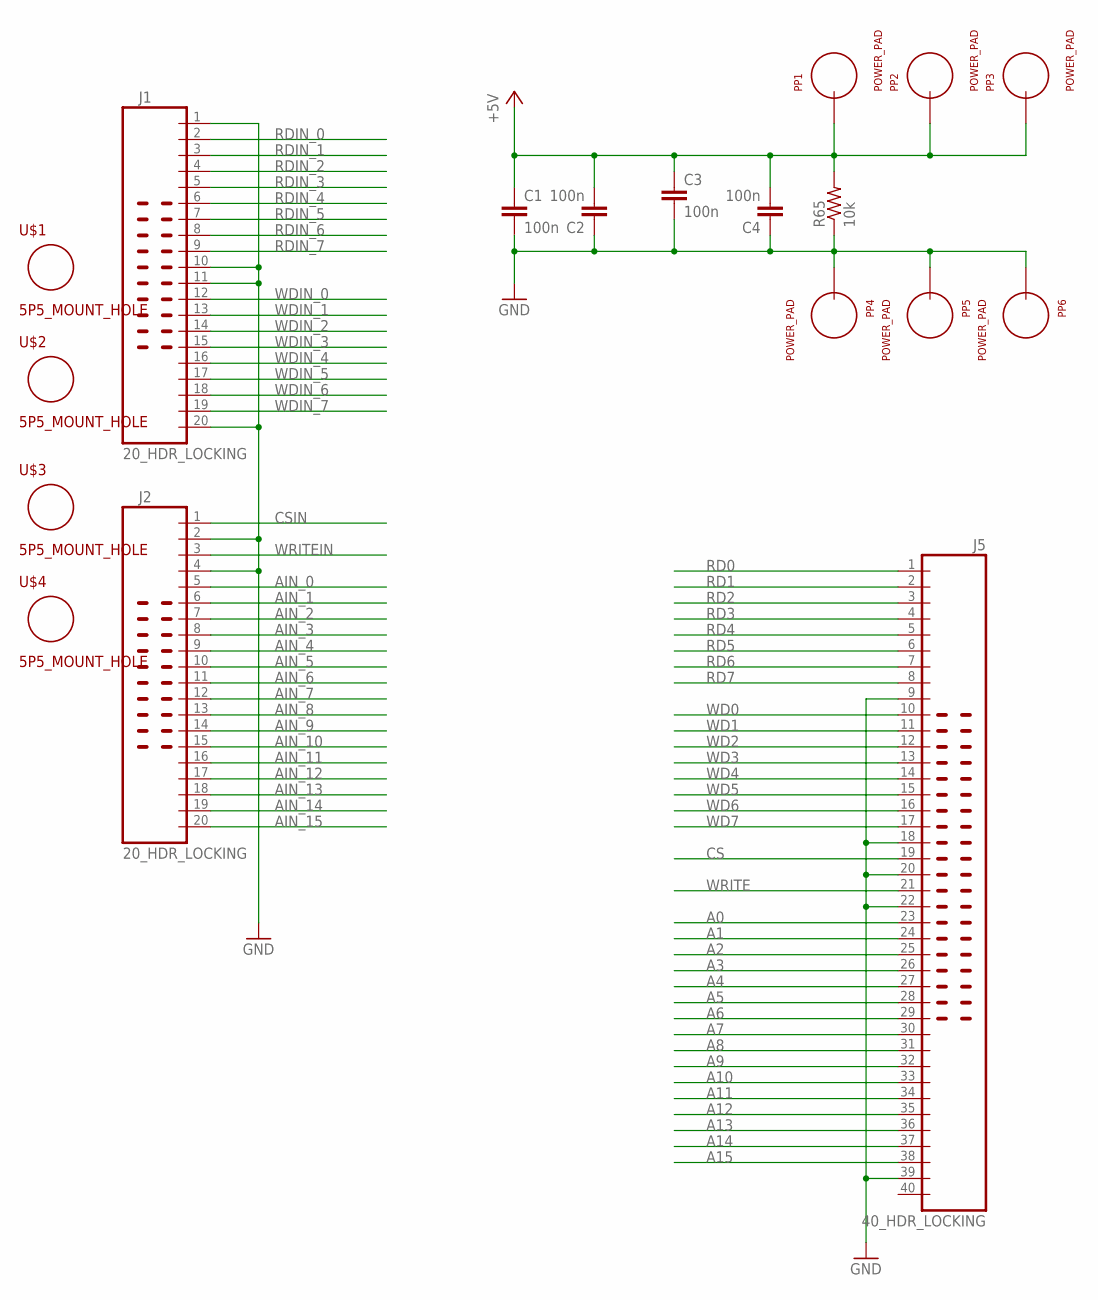
[picture p128: schematic MEM_P2P_1.sch, sheet 1]

Parts:
C1, C2, C3, C4: 100n; CAP_P2INCH
J1, J2: 20_HDR_LOCKING
J5: 40_HDR_LOCKING
PP1, PP2, PP3, PP4, PP5, PP6: POWER_PAD
R65: 10k; R_P2INCH
U$1, U$2, U$3, U$4: 5P5_MOUNT_HOLE; 5P5M_HOLE

Connections:
+5V: C1.1, C2.2, C3.1, C4.2, PP1.1, PP2.1, PP3.1, R65.2; also elsewhere on the board
A0: J5.23; also elsewhere on the board
A1: J5.24; also elsewhere on the board
A2: J5.25; also elsewhere on the board
A3: J5.26; also elsewhere on the board
A4: J5.27; also elsewhere on the board
A5: J5.28; also elsewhere on the board
A6: J5.29; also elsewhere on the board
A7: J5.30; also elsewhere on the board
A8: J5.31; also elsewhere on the board
A9: J5.32; also elsewhere on the board
A10: J5.33; also elsewhere on the board
A11: J5.34; also elsewhere on the board
A12: J5.35; also elsewhere on the board
A13: J5.36; also elsewhere on the board
A14: J5.37; also elsewhere on the board
A15: J5.38; also elsewhere on the board
AIN_0: J2.5; also elsewhere on the board
AIN_1: J2.6; also elsewhere on the board
AIN_2: J2.7; also elsewhere on the board
AIN_3: J2.8; also elsewhere on the board
AIN_4: J2.9; also elsewhere on the board
AIN_5: J2.10; also elsewhere on the board
AIN_6: J2.11; also elsewhere on the board
AIN_7: J2.12; also elsewhere on the board
AIN_8: J2.13; also elsewhere on the board
AIN_9: J2.14; also elsewhere on the board
AIN_10: J2.15; also elsewhere on the board
AIN_11: J2.16; also elsewhere on the board
AIN_12: J2.17; also elsewhere on the board
AIN_13: J2.18; also elsewhere on the board
AIN_14: J2.19; also elsewhere on the board
AIN_15: J2.20; also elsewhere on the board
CS: J5.19; also elsewhere on the board
CSIN: J2.1; also elsewhere on the board
GND: C1.2, C2.1, C3.2, C4.1, J1.1, J1.10, J1.11, J1.20, J2.2, J2.4, J5.9, J5.18, J5.20, J5.22, J5.39, PP4.1, PP5.1, PP6.1, R65.1; also elsewhere on the board
RD0: J5.1; also elsewhere on the board
RD1: J5.2; also elsewhere on the board
RD2: J5.3; also elsewhere on the board
RD3: J5.4; also elsewhere on the board
RD4: J5.5; also elsewhere on the board
RD5: J5.6; also elsewhere on the board
RD6: J5.7; also elsewhere on the board
RD7: J5.8; also elsewhere on the board
RDIN_0: J1.2; also elsewhere on the board
RDIN_1: J1.3; also elsewhere on the board
RDIN_2: J1.4; also elsewhere on the board
RDIN_3: J1.5; also elsewhere on the board
RDIN_4: J1.6; also elsewhere on the board
RDIN_5: J1.7; also elsewhere on the board
RDIN_6: J1.8; also elsewhere on the board
RDIN_7: J1.9; also elsewhere on the board
WD0: J5.10; also elsewhere on the board
WD1: J5.11; also elsewhere on the board
WD2: J5.12; also elsewhere on the board
WD3: J5.13; also elsewhere on the board
WD4: J5.14; also elsewhere on the board
WD5: J5.15; also elsewhere on the board
WD6: J5.16; also elsewhere on the board
WD7: J5.17; also elsewhere on the board
WDIN_0: J1.12; also elsewhere on the board
WDIN_1: J1.13; also elsewhere on the board
WDIN_2: J1.14; also elsewhere on the board
WDIN_3: J1.15; also elsewhere on the board
WDIN_4: J1.16; also elsewhere on the board
WDIN_5: J1.17; also elsewhere on the board
WDIN_6: J1.18; also elsewhere on the board
WDIN_7: J1.19; also elsewhere on the board
WRITE: J5.21; also elsewhere on the board
WRITEIN: J2.3; also elsewhere on the board

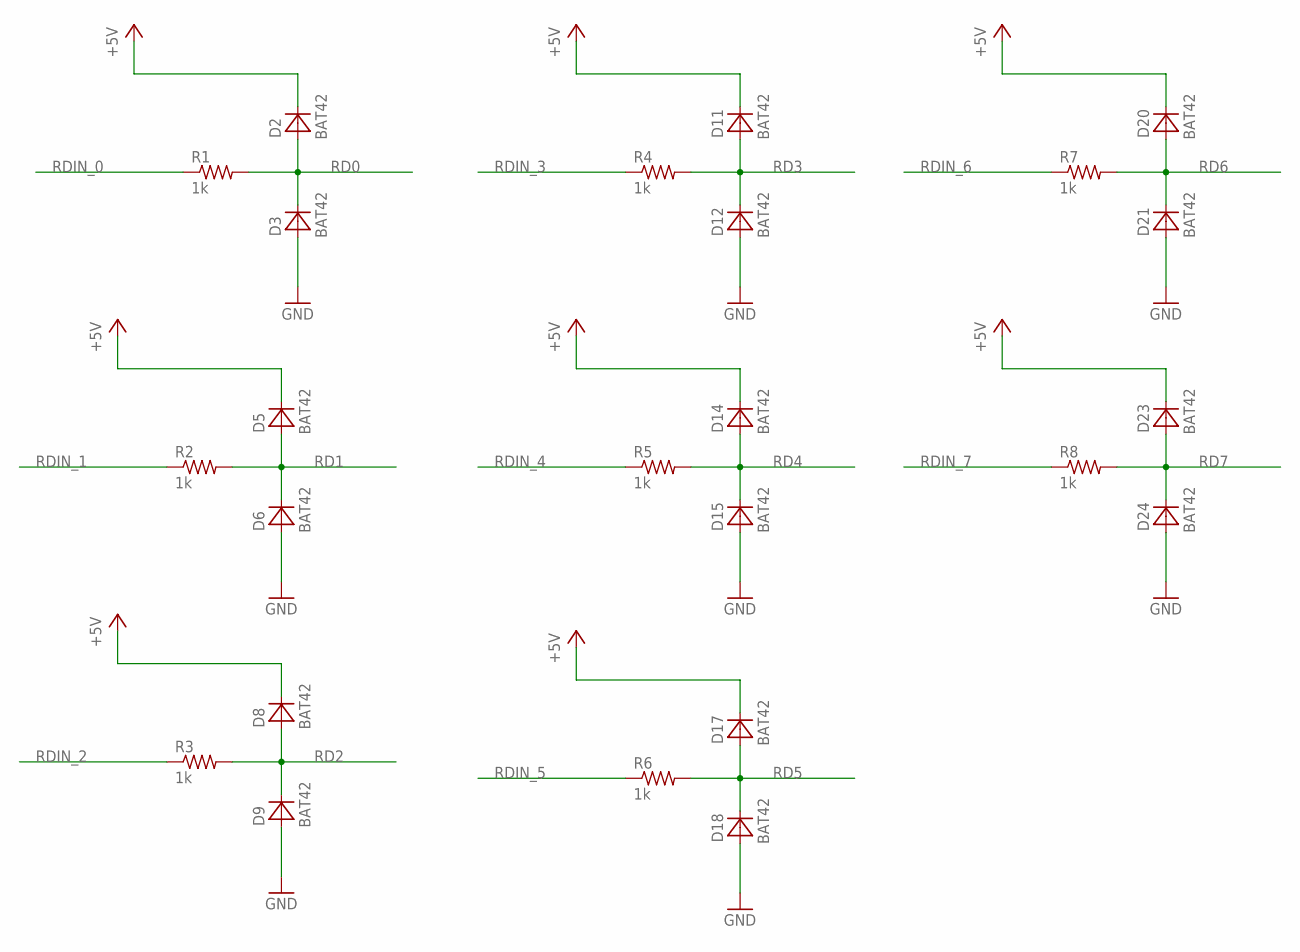
[picture p129: schematic MEM_P2P_1.sch, sheet 2]

Parts:
D2, D3, D5, D6, D8, D9, D11, D12, D14, D15, D17, D18, D20, D21, D23, D24: BAT42; DO34-5
R1, R2, R3, R4, R5, R6, R7, R8: 1k; R_P2INCH

Connections:
+5V: D2.C, D5.C, D8.C, D11.C, D14.C, D17.C, D20.C, D23.C; also elsewhere on the board
GND: D3.A, D6.A, D9.A, D12.A, D15.A, D18.A, D21.A, D24.A; also elsewhere on the board
RD0: D2.A, D3.C, R1.2; also elsewhere on the board
RD1: D5.A, D6.C, R2.2; also elsewhere on the board
RD2: D8.A, D9.C, R3.2; also elsewhere on the board
RD3: D11.A, D12.C, R4.2; also elsewhere on the board
RD4: D14.A, D15.C, R5.2; also elsewhere on the board
RD5: D17.A, D18.C, R6.2; also elsewhere on the board
RD6: D20.A, D21.C, R7.2; also elsewhere on the board
RD7: D23.A, D24.C, R8.2; also elsewhere on the board
RDIN_0: R1.1; also elsewhere on the board
RDIN_1: R2.1; also elsewhere on the board
RDIN_2: R3.1; also elsewhere on the board
RDIN_3: R4.1; also elsewhere on the board
RDIN_4: R5.1; also elsewhere on the board
RDIN_5: R6.1; also elsewhere on the board
RDIN_6: R7.1; also elsewhere on the board
RDIN_7: R8.1; also elsewhere on the board

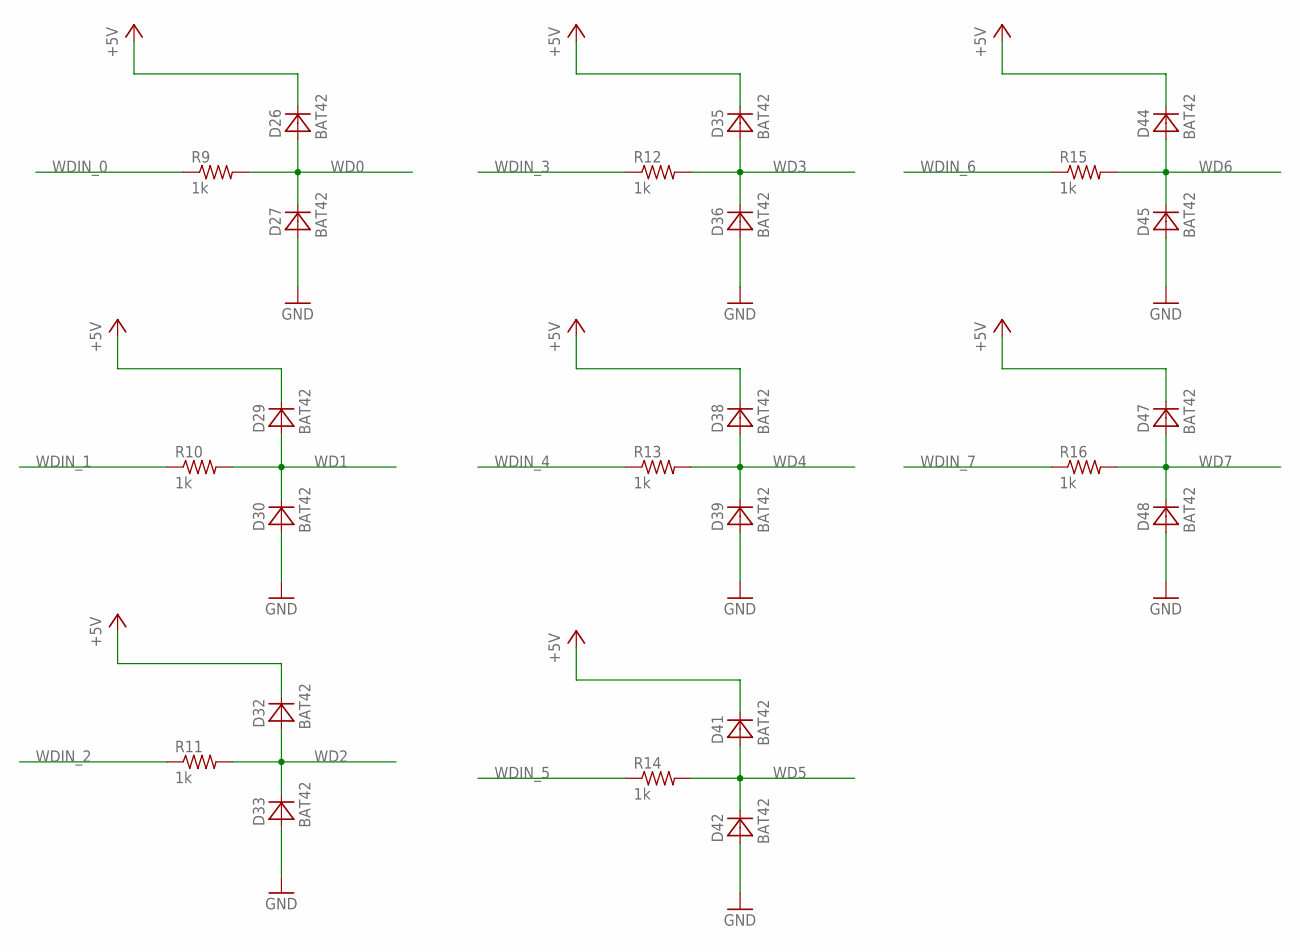
[picture p130: schematic MEM_P2P_1.sch, sheet 3]

Parts:
D26, D27, D29, D30, D32, D33, D35, D36, D38, D39, D41, D42, D44, D45, D47, D48: BAT42; DO34-5
R9, R10, R11, R12, R13, R14, R15, R16: 1k; R_P2INCH

Connections:
+5V: D26.C, D29.C, D32.C, D35.C, D38.C, D41.C, D44.C, D47.C; also elsewhere on the board
GND: D27.A, D30.A, D33.A, D36.A, D39.A, D42.A, D45.A, D48.A; also elsewhere on the board
WD0: D26.A, D27.C, R9.2; also elsewhere on the board
WD1: D29.A, D30.C, R10.2; also elsewhere on the board
WD2: D32.A, D33.C, R11.2; also elsewhere on the board
WD3: D35.A, D36.C, R12.2; also elsewhere on the board
WD4: D38.A, D39.C, R13.2; also elsewhere on the board
WD5: D41.A, D42.C, R14.2; also elsewhere on the board
WD6: D44.A, D45.C, R15.2; also elsewhere on the board
WD7: D47.A, D48.C, R16.2; also elsewhere on the board
WDIN_0: R9.1; also elsewhere on the board
WDIN_1: R10.1; also elsewhere on the board
WDIN_2: R11.1; also elsewhere on the board
WDIN_3: R12.1; also elsewhere on the board
WDIN_4: R13.1; also elsewhere on the board
WDIN_5: R14.1; also elsewhere on the board
WDIN_6: R15.1; also elsewhere on the board
WDIN_7: R16.1; also elsewhere on the board

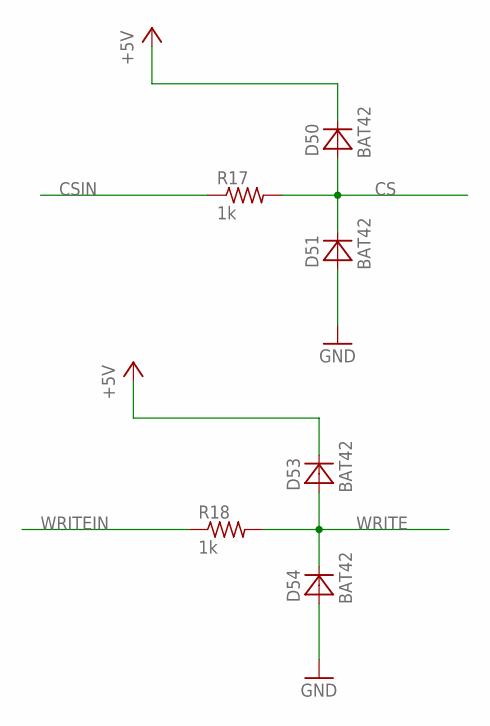
[picture p131: schematic MEM_P2P_1.sch, sheet 4]

Parts:
D50, D51, D53, D54: BAT42; DO34-5
R17, R18: 1k; R_P2INCH

Connections:
+5V: D50.C, D53.C; also elsewhere on the board
CS: D50.A, D51.C, R17.2; also elsewhere on the board
CSIN: R17.1; also elsewhere on the board
GND: D51.A, D54.A; also elsewhere on the board
WRITE: D53.A, D54.C, R18.2; also elsewhere on the board
WRITEIN: R18.1; also elsewhere on the board

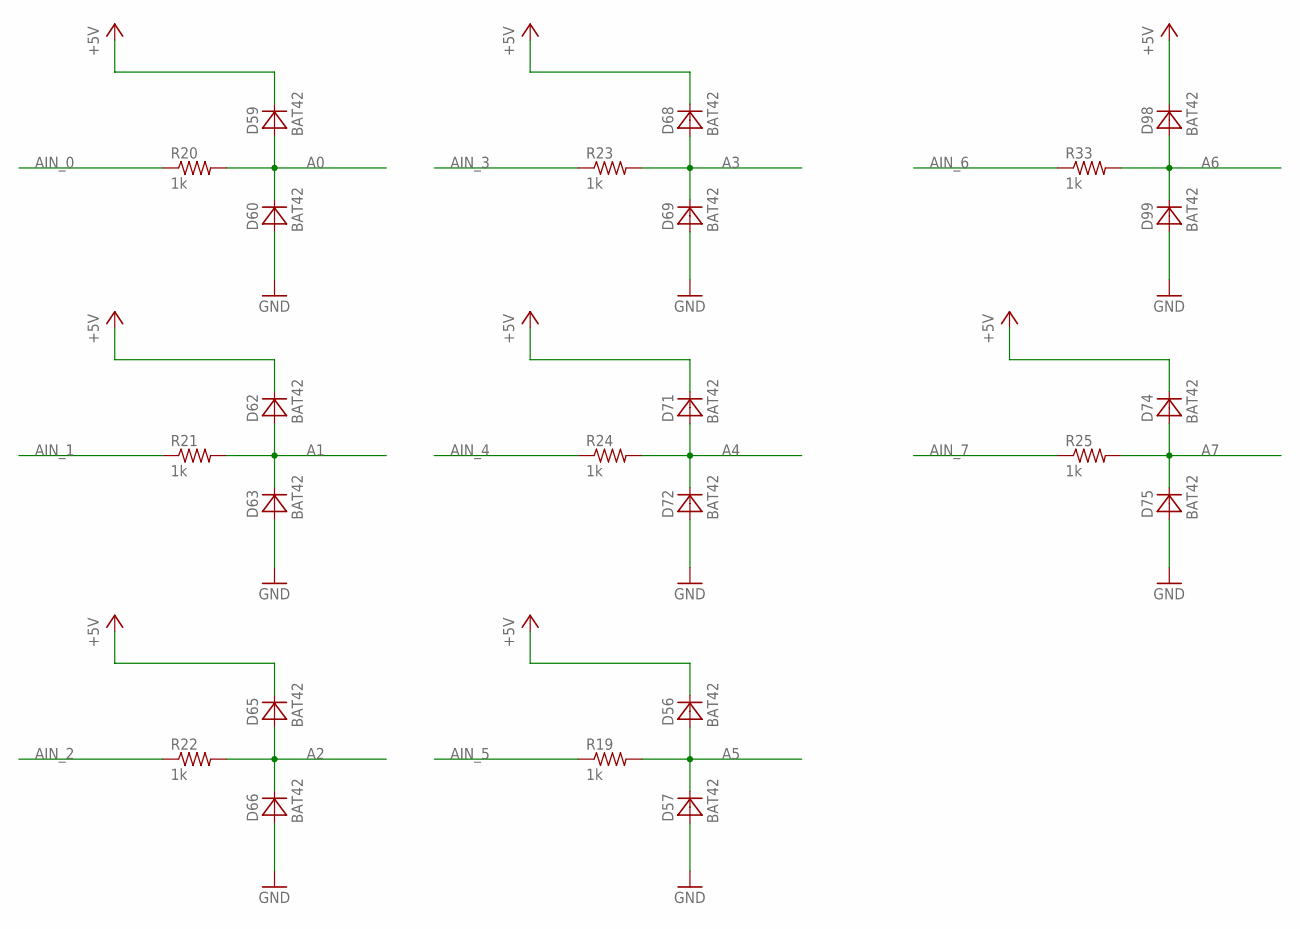
[picture p132: schematic MEM_P2P_1.sch, sheet 5]

Parts:
D56, D57, D59, D60, D62, D63, D65, D66, D68, D69, D71, D72, D74, D75, D98, D99: BAT42; DO34-5
R19, R20, R21, R22, R23, R24, R25, R33: 1k; R_P2INCH

Connections:
+5V: D56.C, D59.C, D62.C, D65.C, D68.C, D71.C, D74.C, D98.C; also elsewhere on the board
A0: D59.A, D60.C, R20.2; also elsewhere on the board
A1: D62.A, D63.C, R21.2; also elsewhere on the board
A2: D65.A, D66.C, R22.2; also elsewhere on the board
A3: D68.A, D69.C, R23.2; also elsewhere on the board
A4: D71.A, D72.C, R24.2; also elsewhere on the board
A5: D56.A, D57.C, R19.2; also elsewhere on the board
A6: D98.A, D99.C, R33.2; also elsewhere on the board
A7: D74.A, D75.C, R25.2; also elsewhere on the board
AIN_0: R20.1; also elsewhere on the board
AIN_1: R21.1; also elsewhere on the board
AIN_2: R22.1; also elsewhere on the board
AIN_3: R23.1; also elsewhere on the board
AIN_4: R24.1; also elsewhere on the board
AIN_5: R19.1; also elsewhere on the board
AIN_6: R33.1; also elsewhere on the board
AIN_7: R25.1; also elsewhere on the board
GND: D57.A, D60.A, D63.A, D66.A, D69.A, D72.A, D75.A, D99.A; also elsewhere on the board

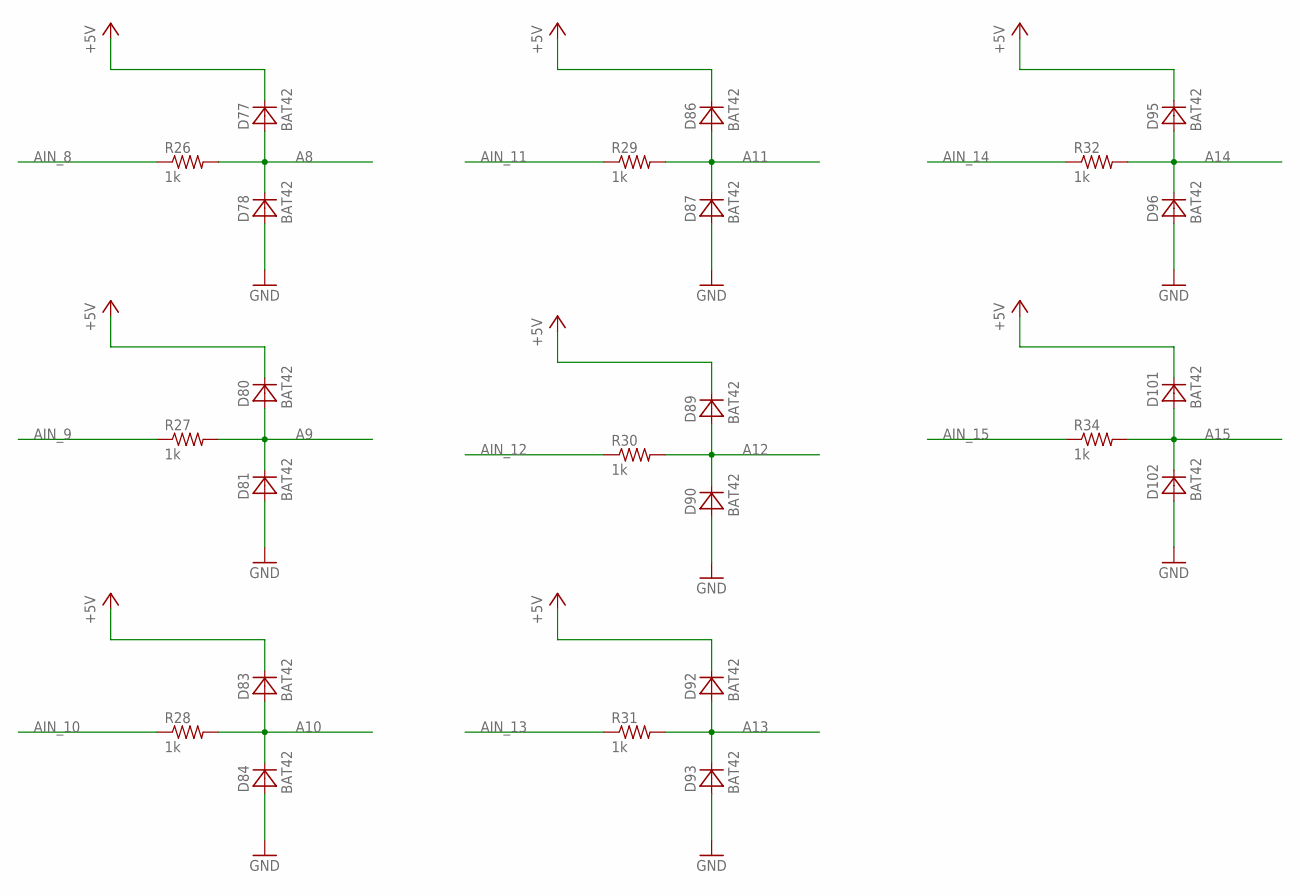
[picture p133: schematic MEM_P2P_1.sch, sheet 6]

Parts:
D77, D78, D80, D81, D83, D84, D86, D87, D89, D90, D92, D93, D95, D96, D101, D102: BAT42; DO34-5
R26, R27, R28, R29, R30, R31, R32, R34: 1k; R_P2INCH

Connections:
+5V: D77.C, D80.C, D83.C, D86.C, D89.C, D92.C, D95.C, D101.C; also elsewhere on the board
A8: D77.A, D78.C, R26.2; also elsewhere on the board
A9: D80.A, D81.C, R27.2; also elsewhere on the board
A10: D83.A, D84.C, R28.2; also elsewhere on the board
A11: D86.A, D87.C, R29.2; also elsewhere on the board
A12: D89.A, D90.C, R30.2; also elsewhere on the board
A13: D92.A, D93.C, R31.2; also elsewhere on the board
A14: D95.A, D96.C, R32.2; also elsewhere on the board
A15: D101.A, D102.C, R34.2; also elsewhere on the board
AIN_8: R26.1; also elsewhere on the board
AIN_9: R27.1; also elsewhere on the board
AIN_10: R28.1; also elsewhere on the board
AIN_11: R29.1; also elsewhere on the board
AIN_12: R30.1; also elsewhere on the board
AIN_13: R31.1; also elsewhere on the board
AIN_14: R32.1; also elsewhere on the board
AIN_15: R34.1; also elsewhere on the board
GND: D78.A, D81.A, D84.A, D87.A, D90.A, D93.A, D96.A, D102.A; also elsewhere on the board

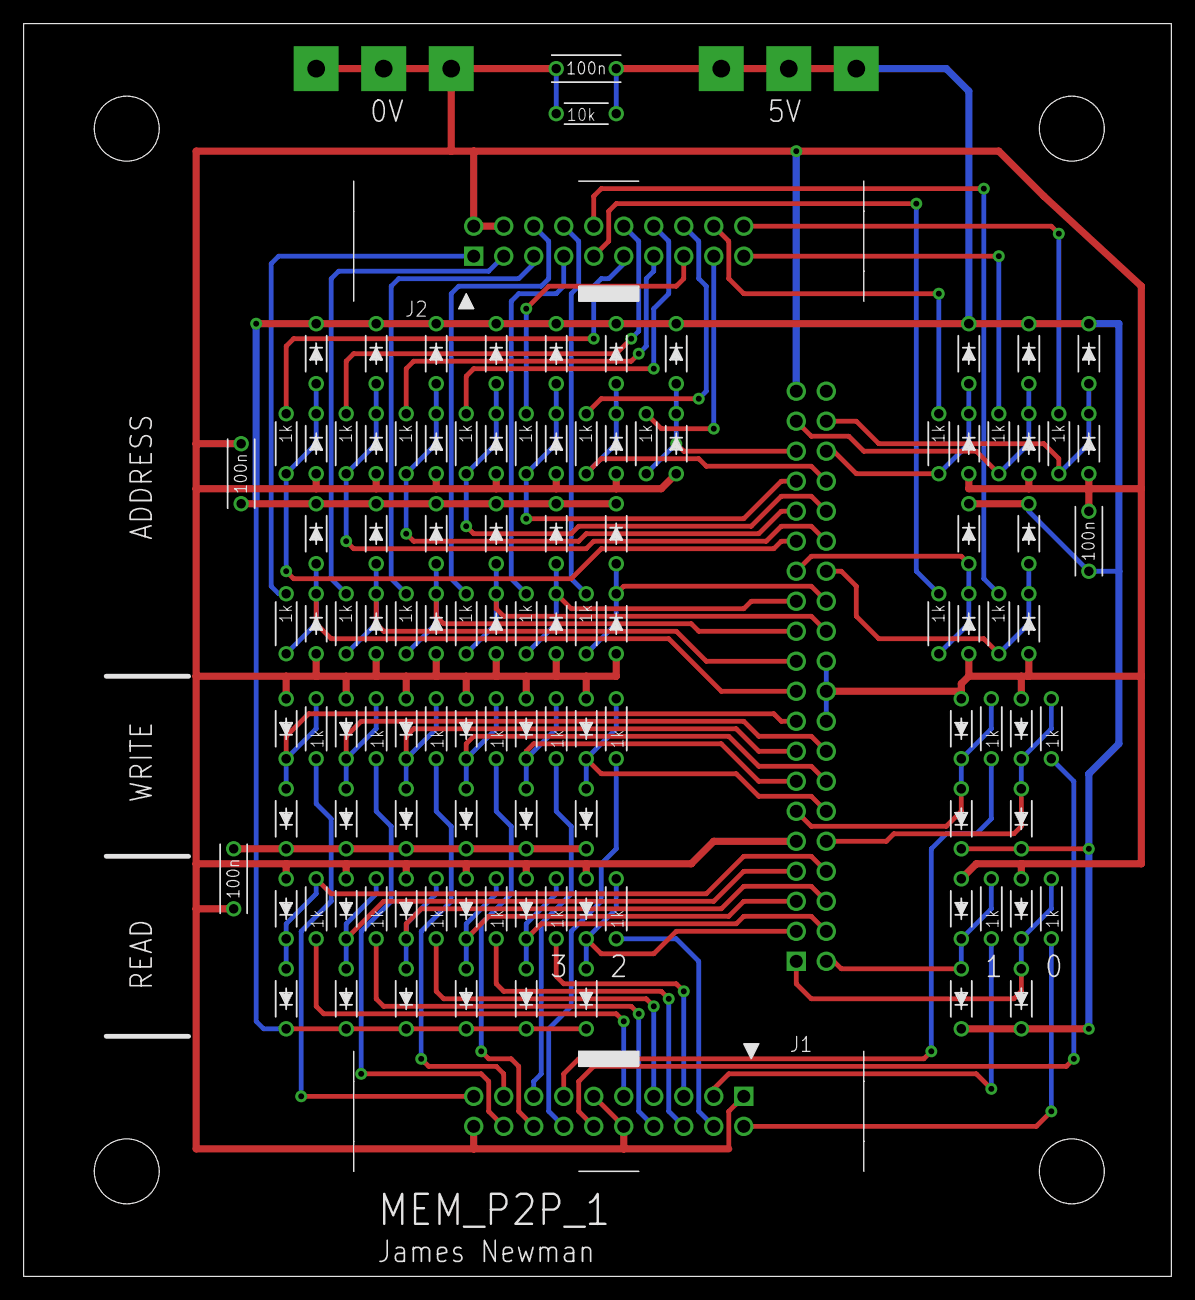
[picture p134: board MEM_P2P_1.brd from above]

Board: 2 copper layers, 97.2 x 106.0 mm, 120 parts (1 on the bottom side), 70 nets.
