ericherman/megaprocessor/16reg/16REG_2a.brd

## EAGLE design 16reg/16REG_2a.brd (2017-05-20)

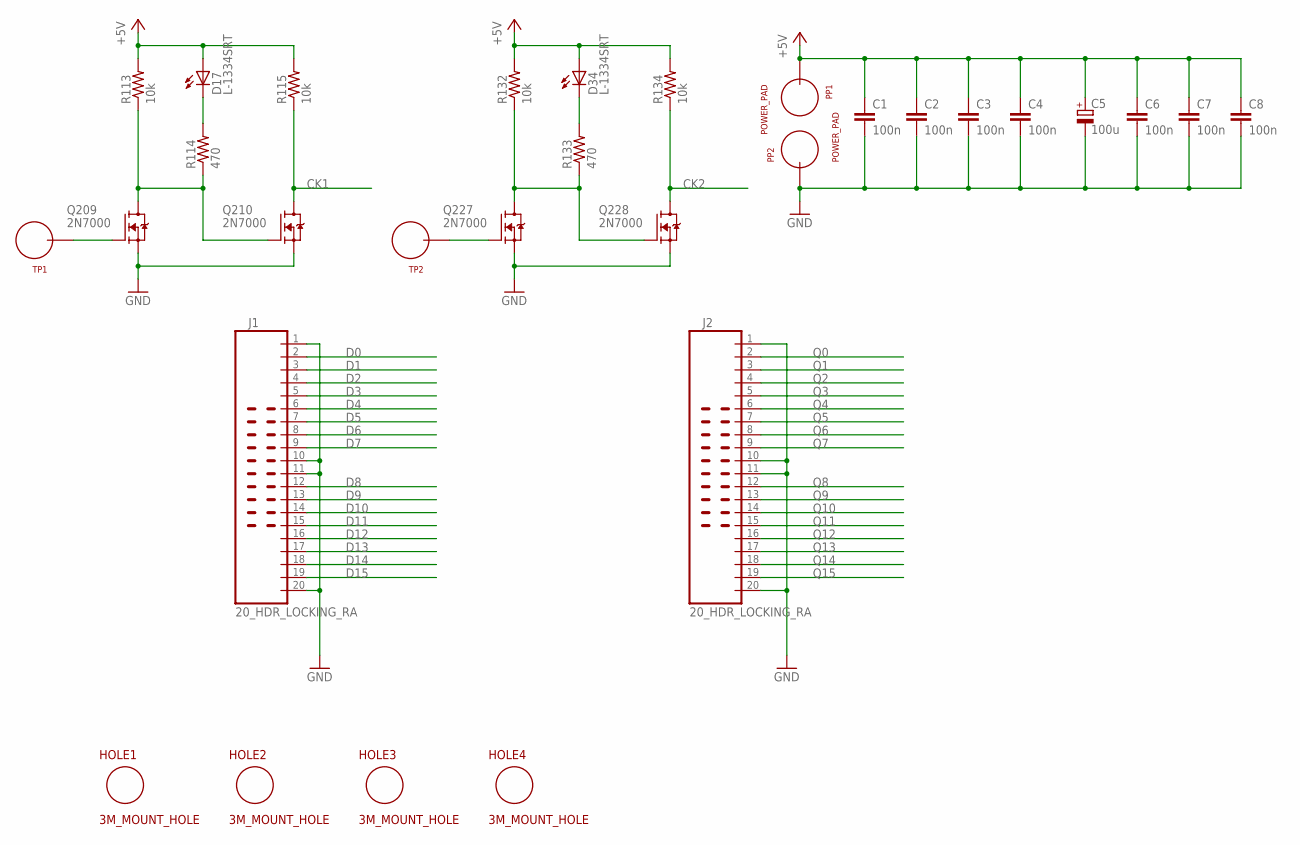
[picture p135: schematic 16REG_2a.sch, sheet 1]

Parts:
C1, C2, C3, C4, C6, C7, C8: 100n; CAP_P2INCH
C5: 100u; POLARISED_CAP_2P5
D17, D34: L-1334SRT; LED3MM
HOLE1, HOLE2, HOLE3, HOLE4: 3M_MOUNT_HOLE; 3M_HOLE
J1, J2: 20_HDR_LOCKING_RA
PP1, PP2: POWER_PAD
Q209, Q210, Q227, Q228: 2N7000; TO92-DGS
R113, R115, R132, R134: 10k; R_P2INCH
R114, R133: 470; R_P2INCH
TP1, TP2: TEST_LOOP

Connections:
+5V: C1.1, C2.1, C3.1, C4.1, C5.A, C6.1, C7.1, C8.1, D17.A, D34.A, PP1.1, R113.2, R115.2, R132.2, R134.2; also elsewhere on the board
CK1: Q210.D, R115.1; also elsewhere on the board
CK2: Q228.D, R134.1; also elsewhere on the board
D0: J1.2; also elsewhere on the board
D1: J1.3; also elsewhere on the board
D2: J1.4; also elsewhere on the board
D3: J1.5; also elsewhere on the board
D4: J1.6; also elsewhere on the board
D5: J1.7; also elsewhere on the board
D6: J1.8; also elsewhere on the board
D7: J1.9; also elsewhere on the board
D8: J1.12; also elsewhere on the board
D9: J1.13; also elsewhere on the board
D10: J1.14; also elsewhere on the board
D11: J1.15; also elsewhere on the board
D12: J1.16; also elsewhere on the board
D13: J1.17; also elsewhere on the board
D14: J1.18; also elsewhere on the board
D15: J1.19; also elsewhere on the board
GND: C1.2, C2.2, C3.2, C4.2, C5.K, C6.2, C7.2, C8.2, J1.1, J1.10, J1.11, J1.20, J2.1, J2.10, J2.11, J2.20, PP2.1, Q209.S, Q210.S, Q227.S, Q228.S; also elsewhere on the board
unnamed: Q227.G, TP2.P$1
unnamed: Q227.D, Q228.G, R132.1, R133.1
unnamed: D34.K (C), R133.2
unnamed: D17.K (C), R114.2
unnamed: Q209.G, TP1.P$1
unnamed: Q209.D, Q210.G, R113.1, R114.1
Q0: J2.2; also elsewhere on the board
Q1: J2.3; also elsewhere on the board
Q2: J2.4; also elsewhere on the board
Q3: J2.5; also elsewhere on the board
Q4: J2.6; also elsewhere on the board
Q5: J2.7; also elsewhere on the board
Q6: J2.8; also elsewhere on the board
Q7: J2.9; also elsewhere on the board
Q8: J2.12; also elsewhere on the board
Q9: J2.13; also elsewhere on the board
Q10: J2.14; also elsewhere on the board
Q11: J2.15; also elsewhere on the board
Q12: J2.16; also elsewhere on the board
Q13: J2.17; also elsewhere on the board
Q14: J2.18; also elsewhere on the board
Q15: J2.19; also elsewhere on the board

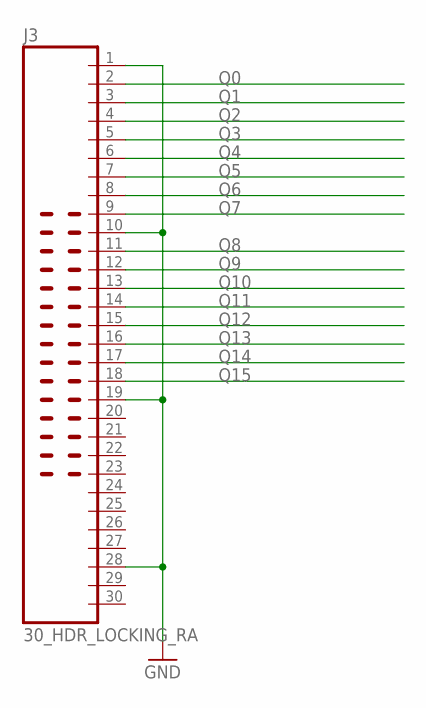
[picture p136: schematic 16REG_2a.sch, sheet 2]

Parts:
J3: 30_HDR_LOCKING_RA

Connections:
GND: J3.1, J3.10, J3.19, J3.28; also elsewhere on the board
Q0: J3.2; also elsewhere on the board
Q1: J3.3; also elsewhere on the board
Q2: J3.4; also elsewhere on the board
Q3: J3.5; also elsewhere on the board
Q4: J3.6; also elsewhere on the board
Q5: J3.7; also elsewhere on the board
Q6: J3.8; also elsewhere on the board
Q7: J3.9; also elsewhere on the board
Q8: J3.11; also elsewhere on the board
Q9: J3.12; also elsewhere on the board
Q10: J3.13; also elsewhere on the board
Q11: J3.14; also elsewhere on the board
Q12: J3.15; also elsewhere on the board
Q13: J3.16; also elsewhere on the board
Q14: J3.17; also elsewhere on the board
Q15: J3.18; also elsewhere on the board

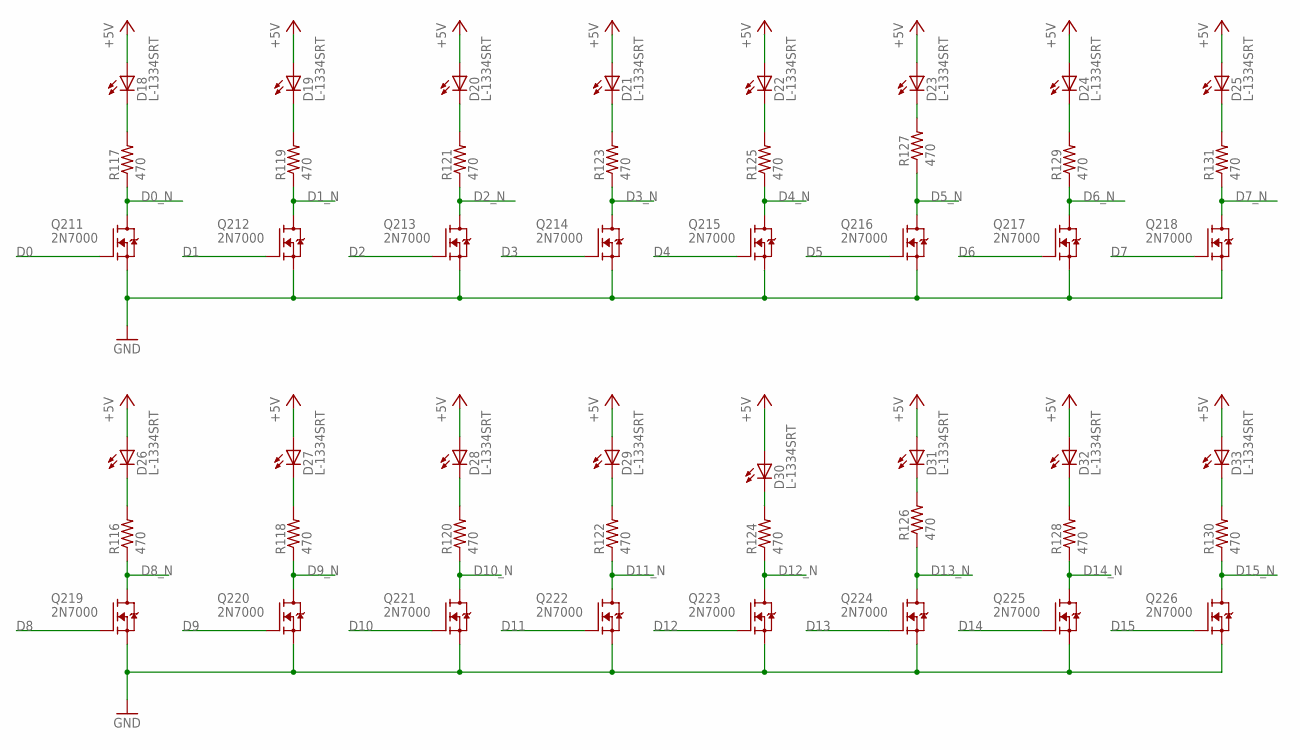
[picture p137: schematic 16REG_2a.sch, sheet 3]

Parts:
D18, D19, D20, D21, D22, D23, D24, D25, D26, D27, D28, D29, D30, D31, D32, D33: L-1334SRT; LED3MM
Q211, Q212, Q213, Q214, Q215, Q216, Q217, Q218, Q219, Q220, Q221, Q222, Q223, Q224, Q225, Q226: 2N7000; TO92-DGS
R116, R117, R118, R119, R120, R121, R122, R123, R124, R125, R126, R127, R128, R129, R130, R131: 470; R_P2INCH

Connections:
+5V: D18.A, D19.A, D20.A, D21.A, D22.A, D23.A, D24.A, D25.A, D26.A, D27.A, D28.A, D29.A, D30.A, D31.A, D32.A, D33.A; also elsewhere on the board
D0: Q211.G; also elsewhere on the board
D0_N: Q211.D, R117.1
D1: Q212.G; also elsewhere on the board
D1_N: Q212.D, R119.1
D2: Q213.G; also elsewhere on the board
D2_N: Q213.D, R121.1
D3: Q214.G; also elsewhere on the board
D3_N: Q214.D, R123.1
D4: Q215.G; also elsewhere on the board
D4_N: Q215.D, R125.1
D5: Q216.G; also elsewhere on the board
D5_N: Q216.D, R127.1
D6: Q217.G; also elsewhere on the board
D6_N: Q217.D, R129.1
D7: Q218.G; also elsewhere on the board
D7_N: Q218.D, R131.1
D8: Q219.G; also elsewhere on the board
D8_N: Q219.D, R116.1
D9: Q220.G; also elsewhere on the board
D9_N: Q220.D, R118.1
D10: Q221.G; also elsewhere on the board
D10_N: Q221.D, R120.1
D11: Q222.G; also elsewhere on the board
D11_N: Q222.D, R122.1
D12: Q223.G; also elsewhere on the board
D12_N: Q223.D, R124.1
D13: Q224.G; also elsewhere on the board
D13_N: Q224.D, R126.1
D14: Q225.G; also elsewhere on the board
D14_N: Q225.D, R128.1
D15: Q226.G; also elsewhere on the board
D15_N: Q226.D, R130.1
GND: Q211.S, Q212.S, Q213.S, Q214.S, Q215.S, Q216.S, Q217.S, Q218.S, Q219.S, Q220.S, Q221.S, Q222.S, Q223.S, Q224.S, Q225.S, Q226.S; also elsewhere on the board
unnamed: D18.K (C), R117.2
unnamed: D19.K (C), R119.2
unnamed: D20.K (C), R121.2
unnamed: D21.K (C), R123.2
unnamed: D22.K (C), R125.2
unnamed: D23.K (C), R127.2
unnamed: D24.K (C), R129.2
unnamed: D25.K (C), R131.2
unnamed: D33.K (C), R130.2
unnamed: D32.K (C), R128.2
unnamed: D31.K (C), R126.2
unnamed: D30.K (C), R124.2
unnamed: D29.K (C), R122.2
unnamed: D28.K (C), R120.2
unnamed: D27.K (C), R118.2
unnamed: D26.K (C), R116.2

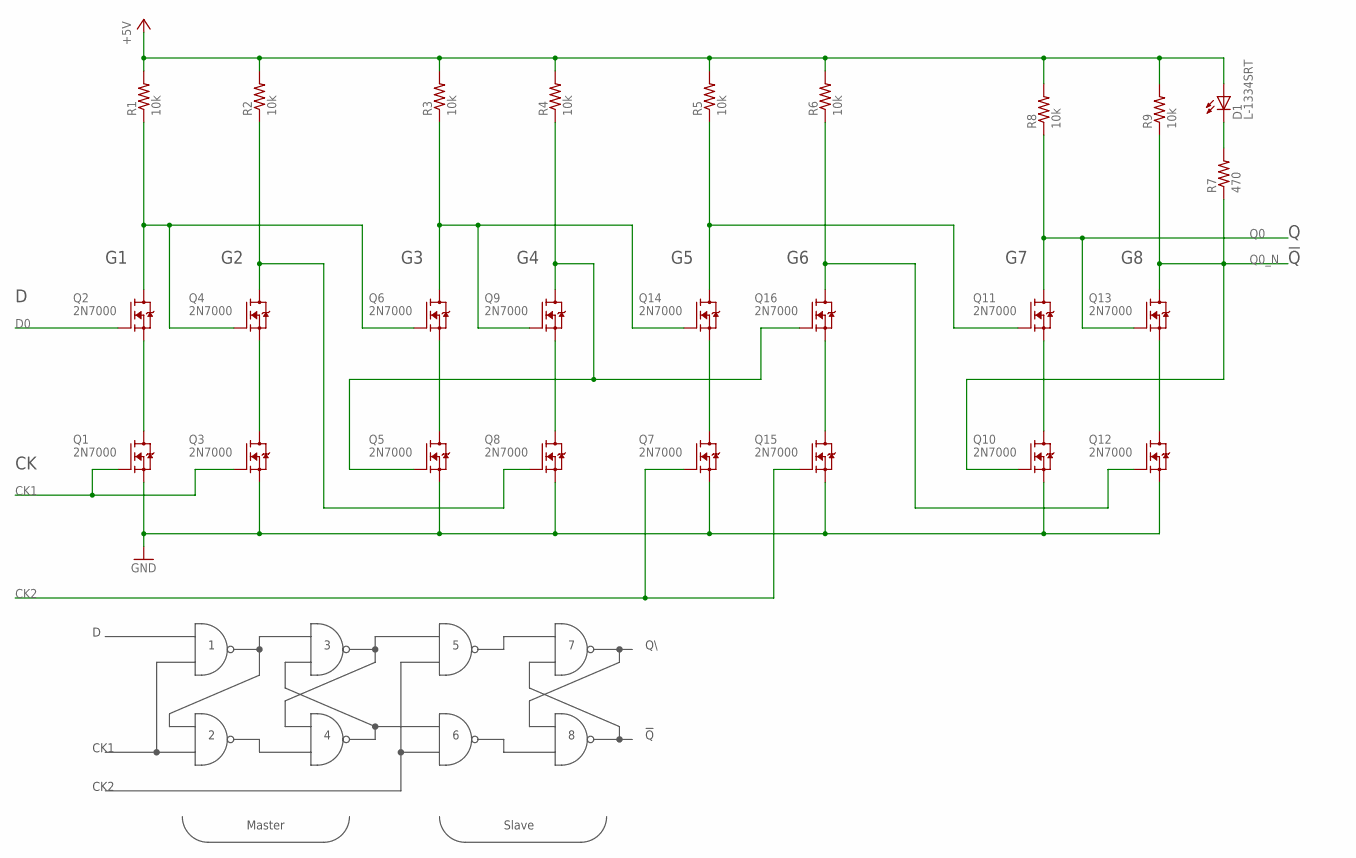
[picture p138: schematic 16REG_2a.sch, sheet 4]

Parts:
D1: L-1334SRT; LED3MM
Q1, Q2, Q3, Q4, Q5, Q6, Q7, Q8, Q9, Q10, Q11, Q12, Q13, Q14, Q15, Q16: 2N7000; TO92-DGS
R1, R2, R3, R4, R5, R6, R8, R9: 10k; R_P2INCH
R7: 470; R_P2INCH

Connections:
+5V: D1.A, R1.2, R2.2, R3.2, R4.2, R5.2, R6.2, R8.2, R9.2; also elsewhere on the board
CK1: Q1.G, Q3.G; also elsewhere on the board
CK2: Q7.G, Q15.G; also elsewhere on the board
D0: Q2.G; also elsewhere on the board
GND: Q1.S, Q3.S, Q5.S, Q7.S, Q8.S, Q10.S, Q12.S, Q15.S; also elsewhere on the board
unnamed: Q7.D, Q14.S
unnamed: Q6.D, Q9.G, Q14.G, R3.1
unnamed: Q15.D, Q16.S
unnamed: Q4.D, Q8.G, R2.1
unnamed: Q1.D, Q2.S
unnamed: Q3.D, Q4.S
unnamed: Q11.G, Q14.D, R5.1
unnamed: Q5.D, Q6.S
unnamed: Q8.D, Q9.S
unnamed: Q10.D, Q11.S
unnamed: Q12.D, Q13.S
unnamed: Q2.D, Q4.G, Q6.G, R1.1
unnamed: Q5.G, Q9.D, Q16.G, R4.1
unnamed: Q12.G, Q16.D, R6.1
unnamed: D1.K (C), R7.2
Q0: Q11.D, Q13.G, R8.1; also elsewhere on the board
Q0_N: Q10.G, Q13.D, R7.1, R9.1

Notes on the sheet:
CK1
CK2
Master
Slave
