ericherman/megaprocessor/16reg/16REG_2a.brd

## EAGLE design 16reg/16REG_2a.brd (continued)

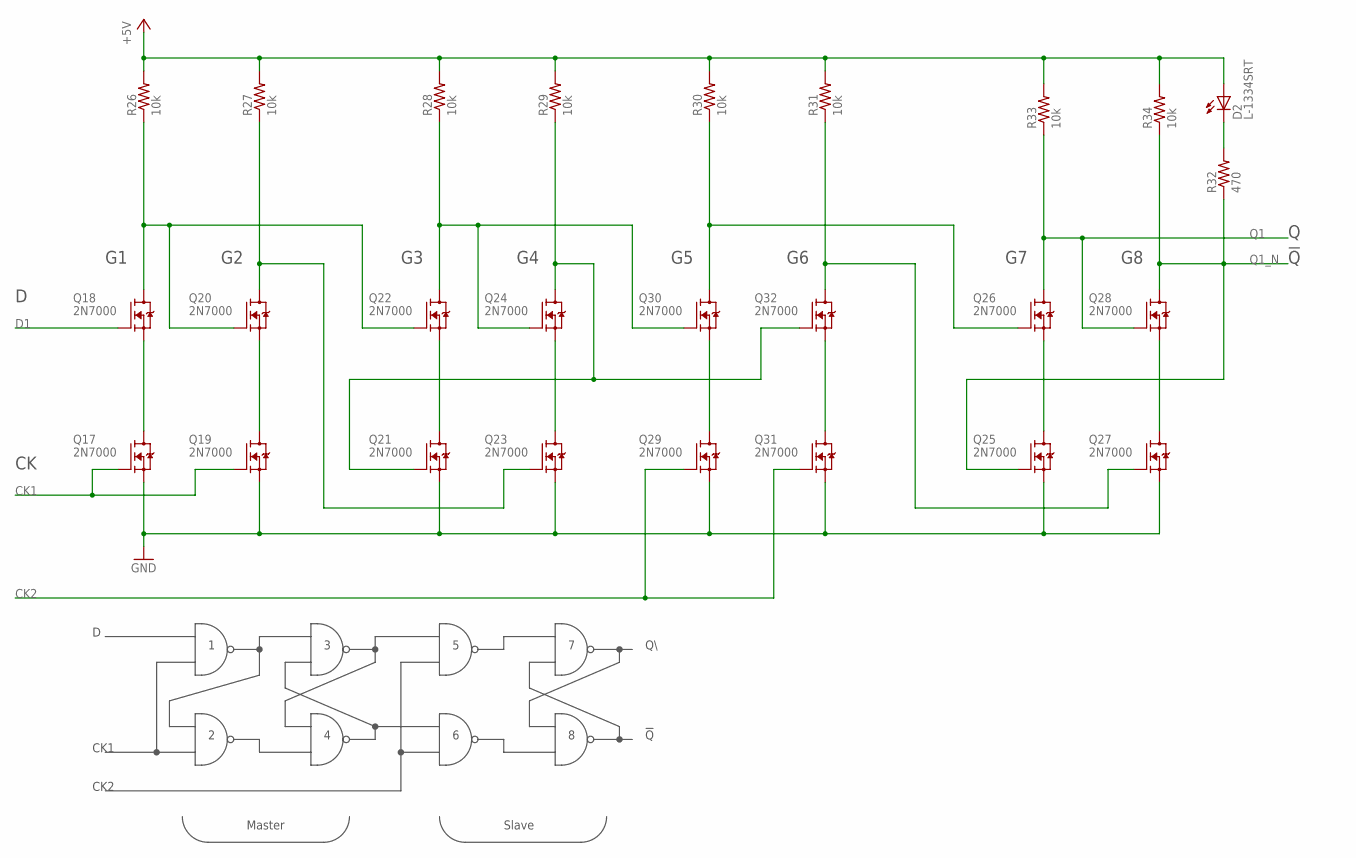
[picture p139: schematic 16REG_2a.sch, sheet 5]

Parts:
D2: L-1334SRT; LED3MM
Q17, Q18, Q19, Q20, Q21, Q22, Q23, Q24, Q25, Q26, Q27, Q28, Q29, Q30, Q31, Q32: 2N7000; TO92-DGS
R26, R27, R28, R29, R30, R31, R33, R34: 10k; R_P2INCH
R32: 470; R_P2INCH

Connections:
+5V: D2.A, R26.2, R27.2, R28.2, R29.2, R30.2, R31.2, R33.2, R34.2; also elsewhere on the board
CK1: Q17.G, Q19.G; also elsewhere on the board
CK2: Q29.G, Q31.G; also elsewhere on the board
D1: Q18.G; also elsewhere on the board
GND: Q17.S, Q19.S, Q21.S, Q23.S, Q25.S, Q27.S, Q29.S, Q31.S; also elsewhere on the board
unnamed: Q17.D, Q18.S
unnamed: Q19.D, Q20.S
unnamed: Q21.D, Q22.S
unnamed: Q23.D, Q24.S
unnamed: Q25.D, Q26.S
unnamed: Q27.D, Q28.S
unnamed: Q18.D, Q20.G, Q22.G, R26.1
unnamed: Q21.G, Q24.D, Q32.G, R29.1
unnamed: D2.K (C), R32.2
unnamed: Q22.D, Q24.G, Q30.G, R28.1
unnamed: Q20.D, Q23.G, R27.1
unnamed: Q29.D, Q30.S
unnamed: Q31.D, Q32.S
unnamed: Q26.G, Q30.D, R30.1
unnamed: Q27.G, Q32.D, R31.1
Q1: Q26.D, Q28.G, R33.1; also elsewhere on the board
Q1_N: Q25.G, Q28.D, R32.1, R34.1

Notes on the sheet:
CK1
CK2
Master
Slave

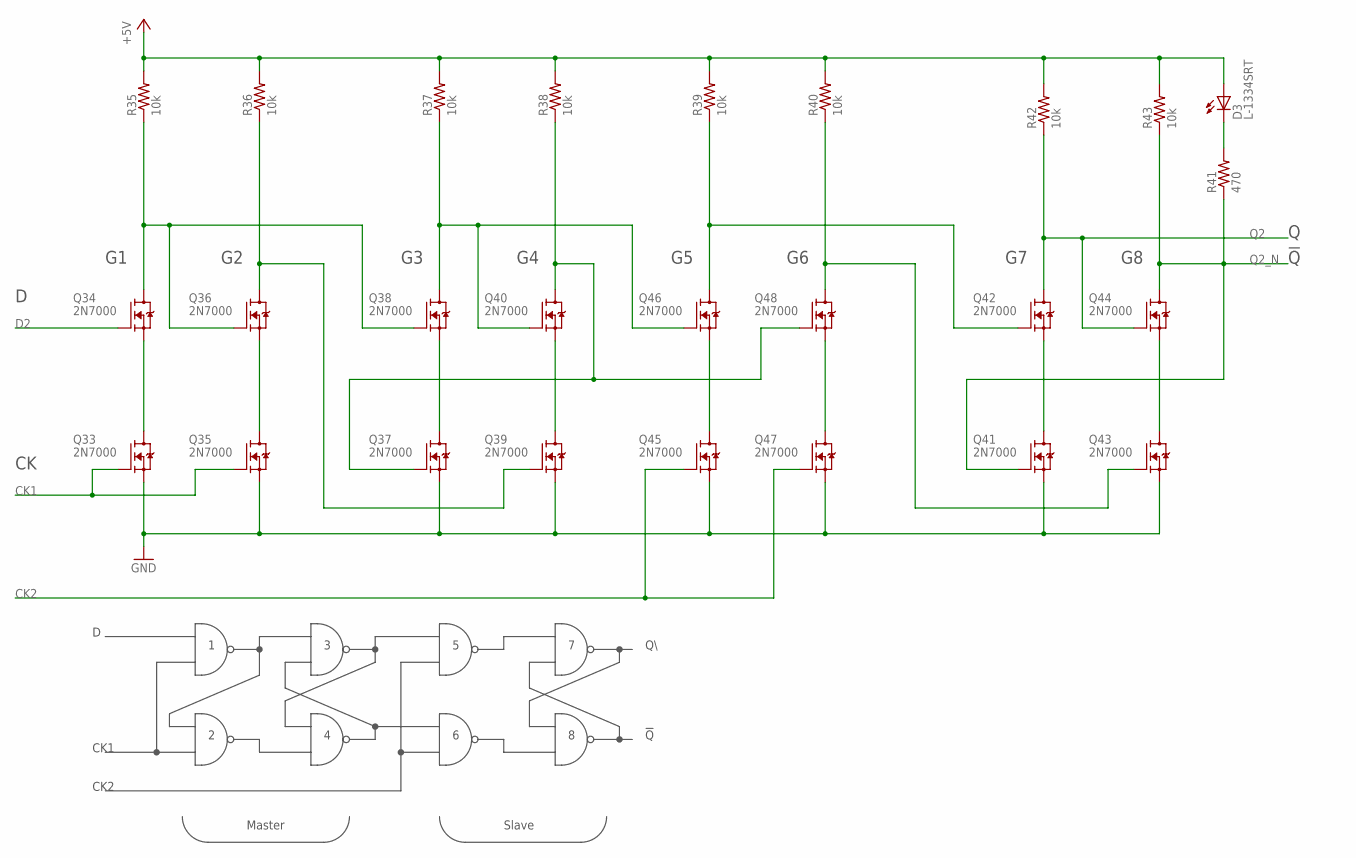
[picture p140: schematic 16REG_2a.sch, sheet 6]

Parts:
D3: L-1334SRT; LED3MM
Q33, Q34, Q35, Q36, Q37, Q38, Q39, Q40, Q41, Q42, Q43, Q44, Q45, Q46, Q47, Q48: 2N7000; TO92-DGS
R35, R36, R37, R38, R39, R40, R42, R43: 10k; R_P2INCH
R41: 470; R_P2INCH

Connections:
+5V: D3.A, R35.2, R36.2, R37.2, R38.2, R39.2, R40.2, R42.2, R43.2; also elsewhere on the board
CK1: Q33.G, Q35.G; also elsewhere on the board
CK2: Q45.G, Q47.G; also elsewhere on the board
D2: Q34.G; also elsewhere on the board
GND: Q33.S, Q35.S, Q37.S, Q39.S, Q41.S, Q43.S, Q45.S, Q47.S; also elsewhere on the board
unnamed: Q33.D, Q34.S
unnamed: Q35.D, Q36.S
unnamed: Q37.D, Q38.S
unnamed: Q39.D, Q40.S
unnamed: Q41.D, Q42.S
unnamed: Q43.D, Q44.S
unnamed: Q34.D, Q36.G, Q38.G, R35.1
unnamed: Q37.G, Q40.D, Q48.G, R38.1
unnamed: D3.K (C), R41.2
unnamed: Q38.D, Q40.G, Q46.G, R37.1
unnamed: Q36.D, Q39.G, R36.1
unnamed: Q45.D, Q46.S
unnamed: Q47.D, Q48.S
unnamed: Q42.G, Q46.D, R39.1
unnamed: Q43.G, Q48.D, R40.1
Q2: Q42.D, Q44.G, R42.1; also elsewhere on the board
Q2_N: Q41.G, Q44.D, R41.1, R43.1

Notes on the sheet:
CK1
CK2
Master
Slave

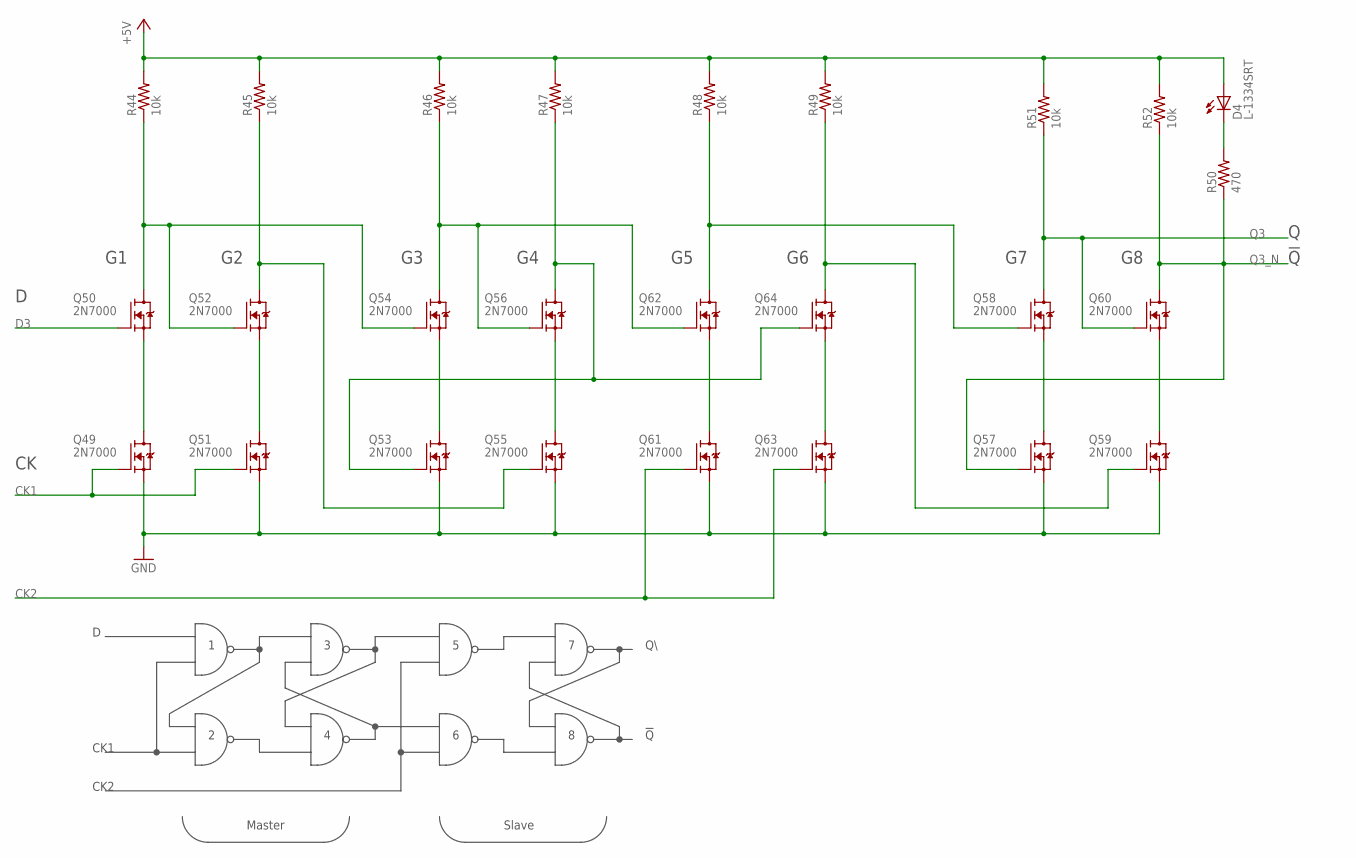
[picture p141: schematic 16REG_2a.sch, sheet 7]

Parts:
D4: L-1334SRT; LED3MM
Q49, Q50, Q51, Q52, Q53, Q54, Q55, Q56, Q57, Q58, Q59, Q60, Q61, Q62, Q63, Q64: 2N7000; TO92-DGS
R44, R45, R46, R47, R48, R49, R51, R52: 10k; R_P2INCH
R50: 470; R_P2INCH

Connections:
+5V: D4.A, R44.2, R45.2, R46.2, R47.2, R48.2, R49.2, R51.2, R52.2; also elsewhere on the board
CK1: Q49.G, Q51.G; also elsewhere on the board
CK2: Q61.G, Q63.G; also elsewhere on the board
D3: Q50.G; also elsewhere on the board
GND: Q49.S, Q51.S, Q53.S, Q55.S, Q57.S, Q59.S, Q61.S, Q63.S; also elsewhere on the board
unnamed: Q49.D, Q50.S
unnamed: Q51.D, Q52.S
unnamed: Q53.D, Q54.S
unnamed: Q55.D, Q56.S
unnamed: Q57.D, Q58.S
unnamed: Q59.D, Q60.S
unnamed: Q50.D, Q52.G, Q54.G, R44.1
unnamed: Q53.G, Q56.D, Q64.G, R47.1
unnamed: D4.K (C), R50.2
unnamed: Q54.D, Q56.G, Q62.G, R46.1
unnamed: Q52.D, Q55.G, R45.1
unnamed: Q61.D, Q62.S
unnamed: Q63.D, Q64.S
unnamed: Q58.G, Q62.D, R48.1
unnamed: Q59.G, Q64.D, R49.1
Q3: Q58.D, Q60.G, R51.1; also elsewhere on the board
Q3_N: Q57.G, Q60.D, R50.1, R52.1

Notes on the sheet:
CK1
CK2
Master
Slave

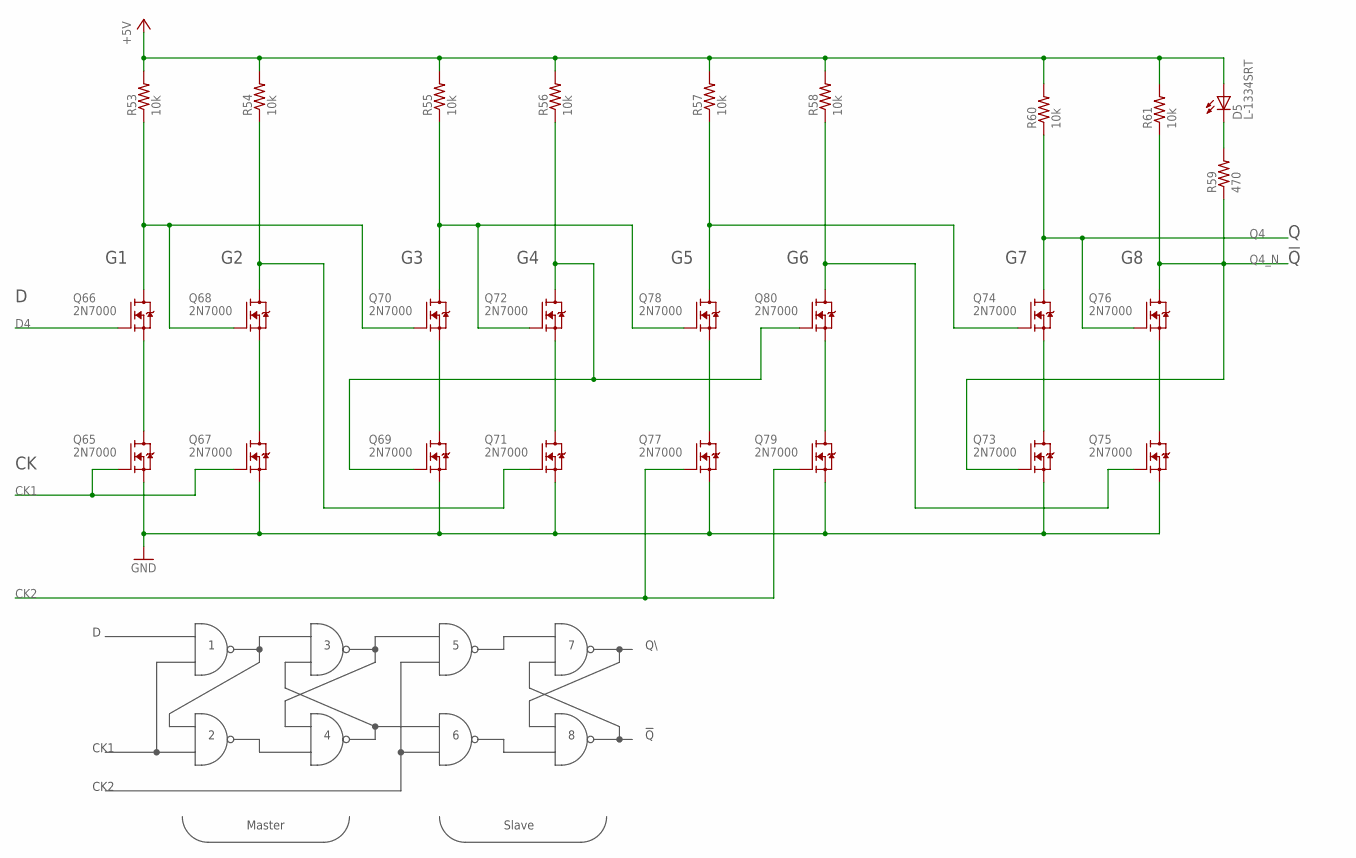
[picture p142: schematic 16REG_2a.sch, sheet 8]

Parts:
D5: L-1334SRT; LED3MM
Q65, Q66, Q67, Q68, Q69, Q70, Q71, Q72, Q73, Q74, Q75, Q76, Q77, Q78, Q79, Q80: 2N7000; TO92-DGS
R53, R54, R55, R56, R57, R58, R60, R61: 10k; R_P2INCH
R59: 470; R_P2INCH

Connections:
+5V: D5.A, R53.2, R54.2, R55.2, R56.2, R57.2, R58.2, R60.2, R61.2; also elsewhere on the board
CK1: Q65.G, Q67.G; also elsewhere on the board
CK2: Q77.G, Q79.G; also elsewhere on the board
D4: Q66.G; also elsewhere on the board
GND: Q65.S, Q67.S, Q69.S, Q71.S, Q73.S, Q75.S, Q77.S, Q79.S; also elsewhere on the board
unnamed: Q65.D, Q66.S
unnamed: Q67.D, Q68.S
unnamed: Q69.D, Q70.S
unnamed: Q71.D, Q72.S
unnamed: Q73.D, Q74.S
unnamed: Q75.D, Q76.S
unnamed: Q66.D, Q68.G, Q70.G, R53.1
unnamed: Q69.G, Q72.D, Q80.G, R56.1
unnamed: D5.K (C), R59.2
unnamed: Q70.D, Q72.G, Q78.G, R55.1
unnamed: Q68.D, Q71.G, R54.1
unnamed: Q77.D, Q78.S
unnamed: Q79.D, Q80.S
unnamed: Q74.G, Q78.D, R57.1
unnamed: Q75.G, Q80.D, R58.1
Q4: Q74.D, Q76.G, R60.1; also elsewhere on the board
Q4_N: Q73.G, Q76.D, R59.1, R61.1

Notes on the sheet:
CK1
CK2
Master
Slave

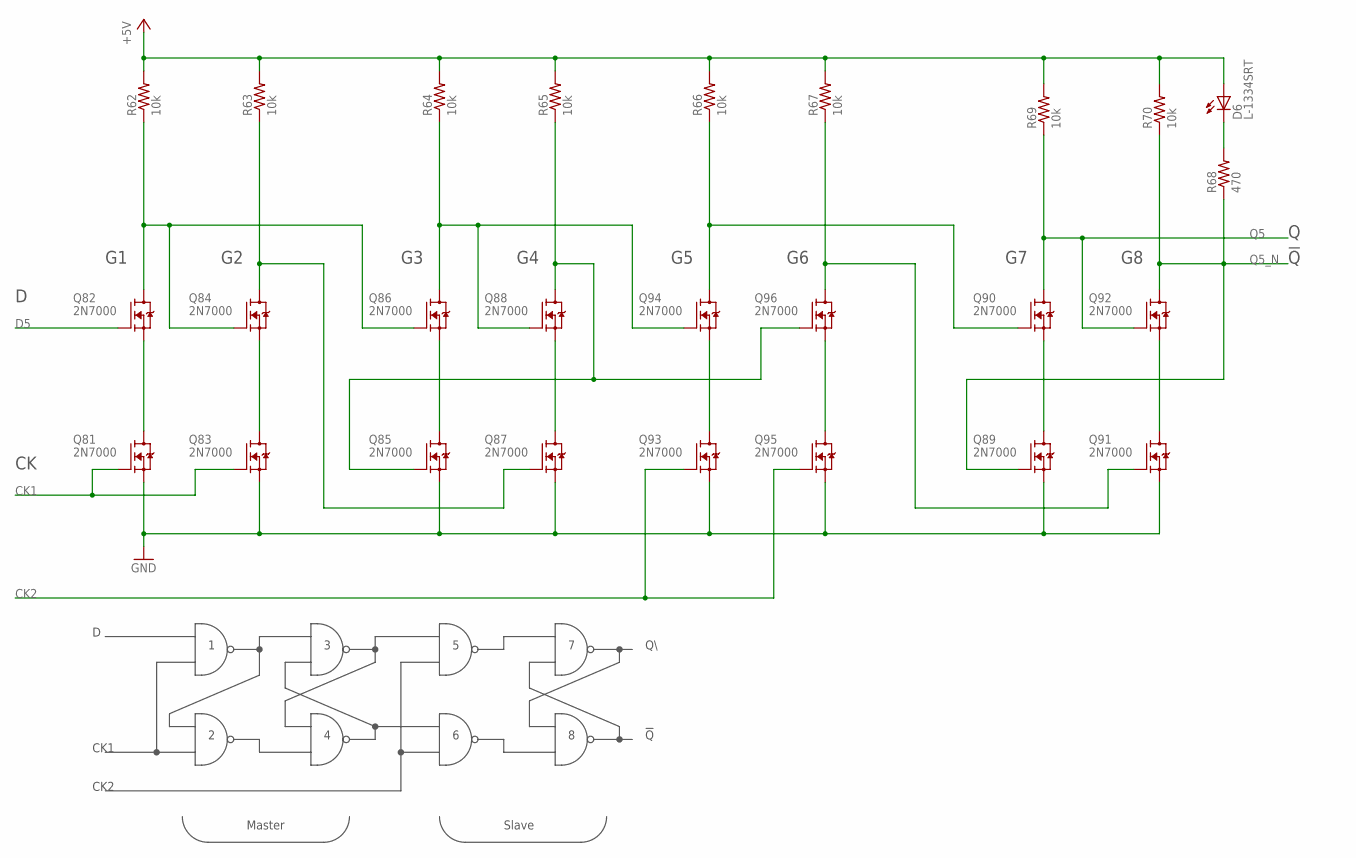
[picture p143: schematic 16REG_2a.sch, sheet 9]

Parts:
D6: L-1334SRT; LED3MM
Q81, Q82, Q83, Q84, Q85, Q86, Q87, Q88, Q89, Q90, Q91, Q92, Q93, Q94, Q95, Q96: 2N7000; TO92-DGS
R62, R63, R64, R65, R66, R67, R69, R70: 10k; R_P2INCH
R68: 470; R_P2INCH

Connections:
+5V: D6.A, R62.2, R63.2, R64.2, R65.2, R66.2, R67.2, R69.2, R70.2; also elsewhere on the board
CK1: Q81.G, Q83.G; also elsewhere on the board
CK2: Q93.G, Q95.G; also elsewhere on the board
D5: Q82.G; also elsewhere on the board
GND: Q81.S, Q83.S, Q85.S, Q87.S, Q89.S, Q91.S, Q93.S, Q95.S; also elsewhere on the board
unnamed: Q81.D, Q82.S
unnamed: Q83.D, Q84.S
unnamed: Q85.D, Q86.S
unnamed: Q87.D, Q88.S
unnamed: Q89.D, Q90.S
unnamed: Q91.D, Q92.S
unnamed: Q82.D, Q84.G, Q86.G, R62.1
unnamed: Q85.G, Q88.D, Q96.G, R65.1
unnamed: D6.K (C), R68.2
unnamed: Q86.D, Q88.G, Q94.G, R64.1
unnamed: Q84.D, Q87.G, R63.1
unnamed: Q93.D, Q94.S
unnamed: Q95.D, Q96.S
unnamed: Q90.G, Q94.D, R66.1
unnamed: Q91.G, Q96.D, R67.1
Q5: Q90.D, Q92.G, R69.1; also elsewhere on the board
Q5_N: Q89.G, Q92.D, R68.1, R70.1

Notes on the sheet:
CK1
CK2
Master
Slave

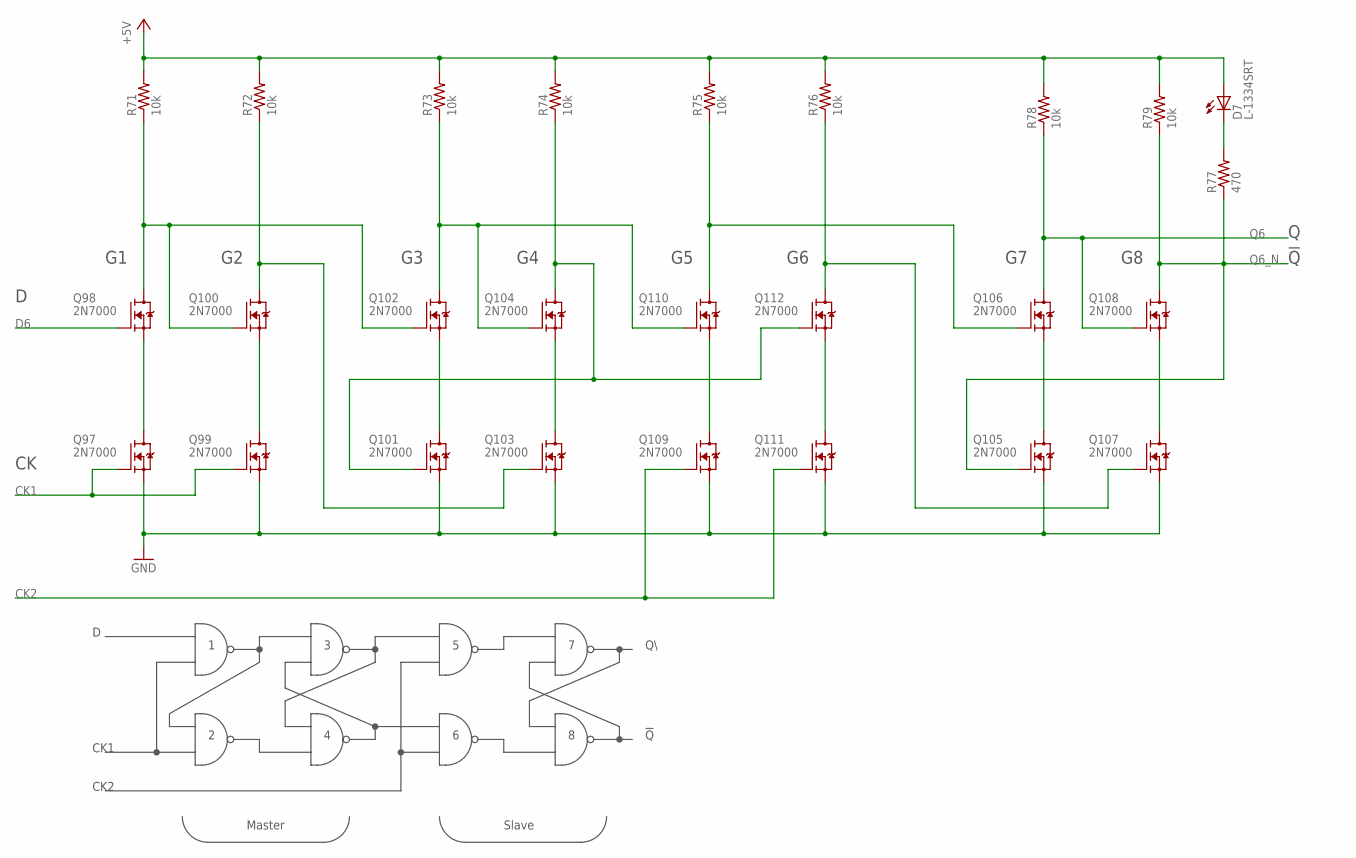
[picture p144: schematic 16REG_2a.sch, sheet 10]

Parts:
D7: L-1334SRT; LED3MM
Q97, Q98, Q99, Q100, Q101, Q102, Q103, Q104, Q105, Q106, Q107, Q108, Q109, Q110, Q111, Q112: 2N7000; TO92-DGS
R71, R72, R73, R74, R75, R76, R78, R79: 10k; R_P2INCH
R77: 470; R_P2INCH

Connections:
+5V: D7.A, R71.2, R72.2, R73.2, R74.2, R75.2, R76.2, R78.2, R79.2; also elsewhere on the board
CK1: Q97.G, Q99.G; also elsewhere on the board
CK2: Q109.G, Q111.G; also elsewhere on the board
D6: Q98.G; also elsewhere on the board
GND: Q97.S, Q99.S, Q101.S, Q103.S, Q105.S, Q107.S, Q109.S, Q111.S; also elsewhere on the board
unnamed: Q97.D, Q98.S
unnamed: Q99.D, Q100.S
unnamed: Q101.D, Q102.S
unnamed: Q103.D, Q104.S
unnamed: Q105.D, Q106.S
unnamed: Q107.D, Q108.S
unnamed: Q98.D, Q100.G, Q102.G, R71.1
unnamed: Q101.G, Q104.D, Q112.G, R74.1
unnamed: D7.K (C), R77.2
unnamed: Q102.D, Q104.G, Q110.G, R73.1
unnamed: Q100.D, Q103.G, R72.1
unnamed: Q109.D, Q110.S
unnamed: Q111.D, Q112.S
unnamed: Q106.G, Q110.D, R75.1
unnamed: Q107.G, Q112.D, R76.1
Q6: Q106.D, Q108.G, R78.1; also elsewhere on the board
Q6_N: Q105.G, Q108.D, R77.1, R79.1

Notes on the sheet:
CK1
CK2
Master
Slave

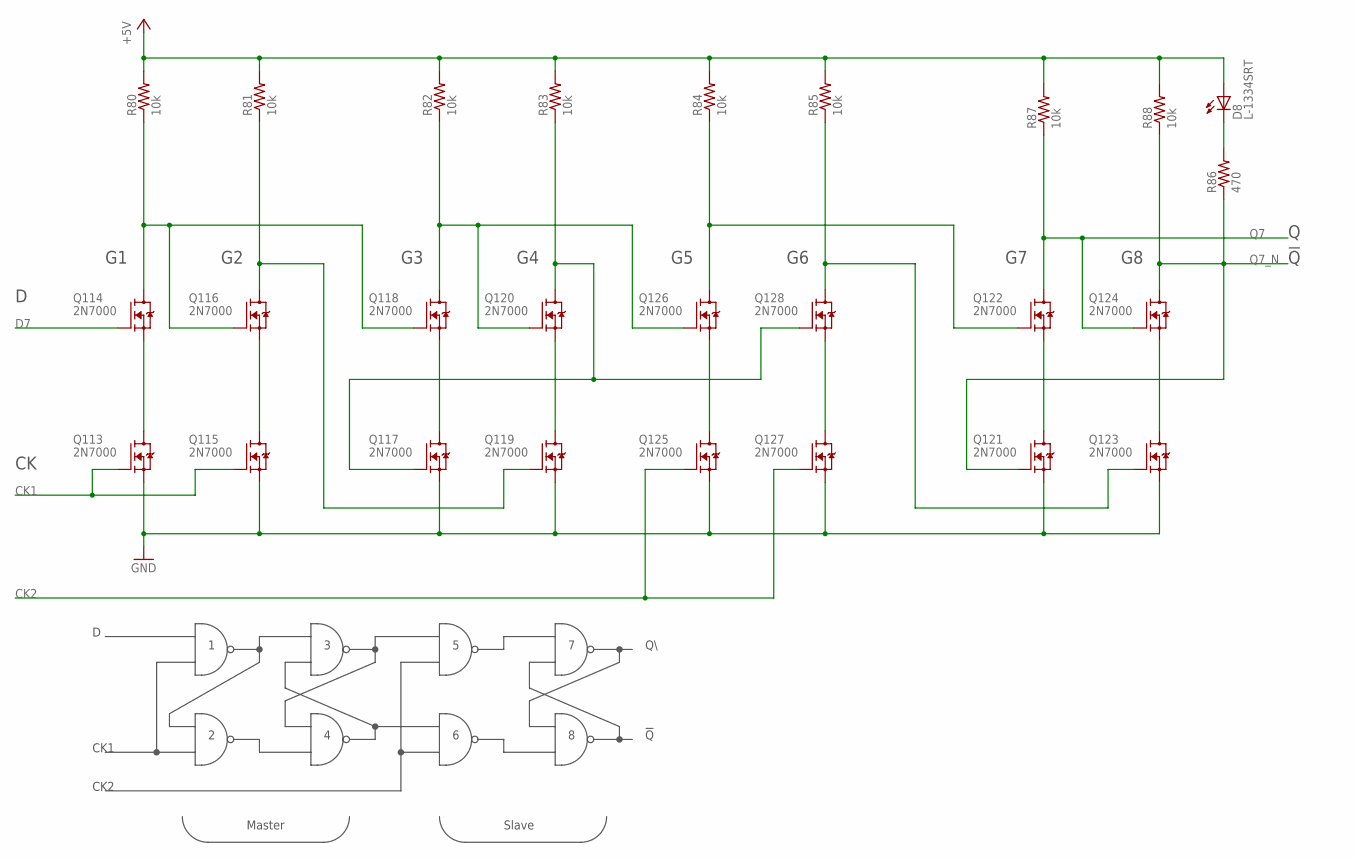
[picture p145: schematic 16REG_2a.sch, sheet 11]

Parts:
D8: L-1334SRT; LED3MM
Q113, Q114, Q115, Q116, Q117, Q118, Q119, Q120, Q121, Q122, Q123, Q124, Q125, Q126, Q127, Q128: 2N7000; TO92-DGS
R80, R81, R82, R83, R84, R85, R87, R88: 10k; R_P2INCH
R86: 470; R_P2INCH

Connections:
+5V: D8.A, R80.2, R81.2, R82.2, R83.2, R84.2, R85.2, R87.2, R88.2; also elsewhere on the board
CK1: Q113.G, Q115.G; also elsewhere on the board
CK2: Q125.G, Q127.G; also elsewhere on the board
D7: Q114.G; also elsewhere on the board
GND: Q113.S, Q115.S, Q117.S, Q119.S, Q121.S, Q123.S, Q125.S, Q127.S; also elsewhere on the board
unnamed: Q113.D, Q114.S
unnamed: Q115.D, Q116.S
unnamed: Q117.D, Q118.S
unnamed: Q119.D, Q120.S
unnamed: Q121.D, Q122.S
unnamed: Q123.D, Q124.S
unnamed: Q114.D, Q116.G, Q118.G, R80.1
unnamed: Q117.G, Q120.D, Q128.G, R83.1
unnamed: D8.K (C), R86.2
unnamed: Q118.D, Q120.G, Q126.G, R82.1
unnamed: Q116.D, Q119.G, R81.1
unnamed: Q125.D, Q126.S
unnamed: Q127.D, Q128.S
unnamed: Q122.G, Q126.D, R84.1
unnamed: Q123.G, Q128.D, R85.1
Q7: Q122.D, Q124.G, R87.1; also elsewhere on the board
Q7_N: Q121.G, Q124.D, R86.1, R88.1

Notes on the sheet:
CK1
CK2
Master
Slave

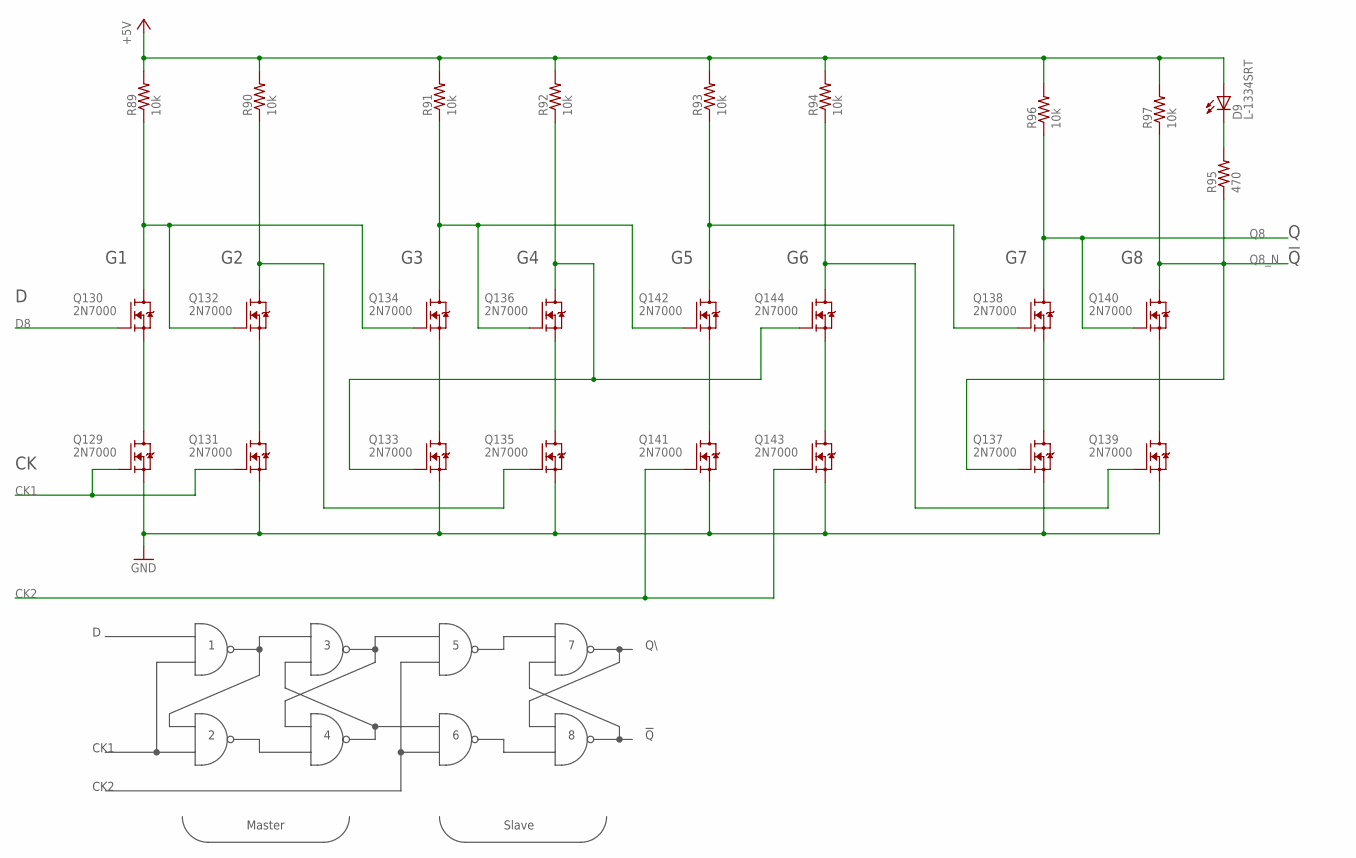
[picture p146: schematic 16REG_2a.sch, sheet 12]

Parts:
D9: L-1334SRT; LED3MM
Q129, Q130, Q131, Q132, Q133, Q134, Q135, Q136, Q137, Q138, Q139, Q140, Q141, Q142, Q143, Q144: 2N7000; TO92-DGS
R89, R90, R91, R92, R93, R94, R96, R97: 10k; R_P2INCH
R95: 470; R_P2INCH

Connections:
+5V: D9.A, R89.2, R90.2, R91.2, R92.2, R93.2, R94.2, R96.2, R97.2; also elsewhere on the board
CK1: Q129.G, Q131.G; also elsewhere on the board
CK2: Q141.G, Q143.G; also elsewhere on the board
D8: Q130.G; also elsewhere on the board
GND: Q129.S, Q131.S, Q133.S, Q135.S, Q137.S, Q139.S, Q141.S, Q143.S; also elsewhere on the board
unnamed: Q129.D, Q130.S
unnamed: Q131.D, Q132.S
unnamed: Q133.D, Q134.S
unnamed: Q135.D, Q136.S
unnamed: Q137.D, Q138.S
unnamed: Q139.D, Q140.S
unnamed: Q130.D, Q132.G, Q134.G, R89.1
unnamed: Q133.G, Q136.D, Q144.G, R92.1
unnamed: D9.K (C), R95.2
unnamed: Q134.D, Q136.G, Q142.G, R91.1
unnamed: Q132.D, Q135.G, R90.1
unnamed: Q141.D, Q142.S
unnamed: Q143.D, Q144.S
unnamed: Q138.G, Q142.D, R93.1
unnamed: Q139.G, Q144.D, R94.1
Q8: Q138.D, Q140.G, R96.1; also elsewhere on the board
Q8_N: Q137.G, Q140.D, R95.1, R97.1

Notes on the sheet:
CK1
CK2
Master
Slave

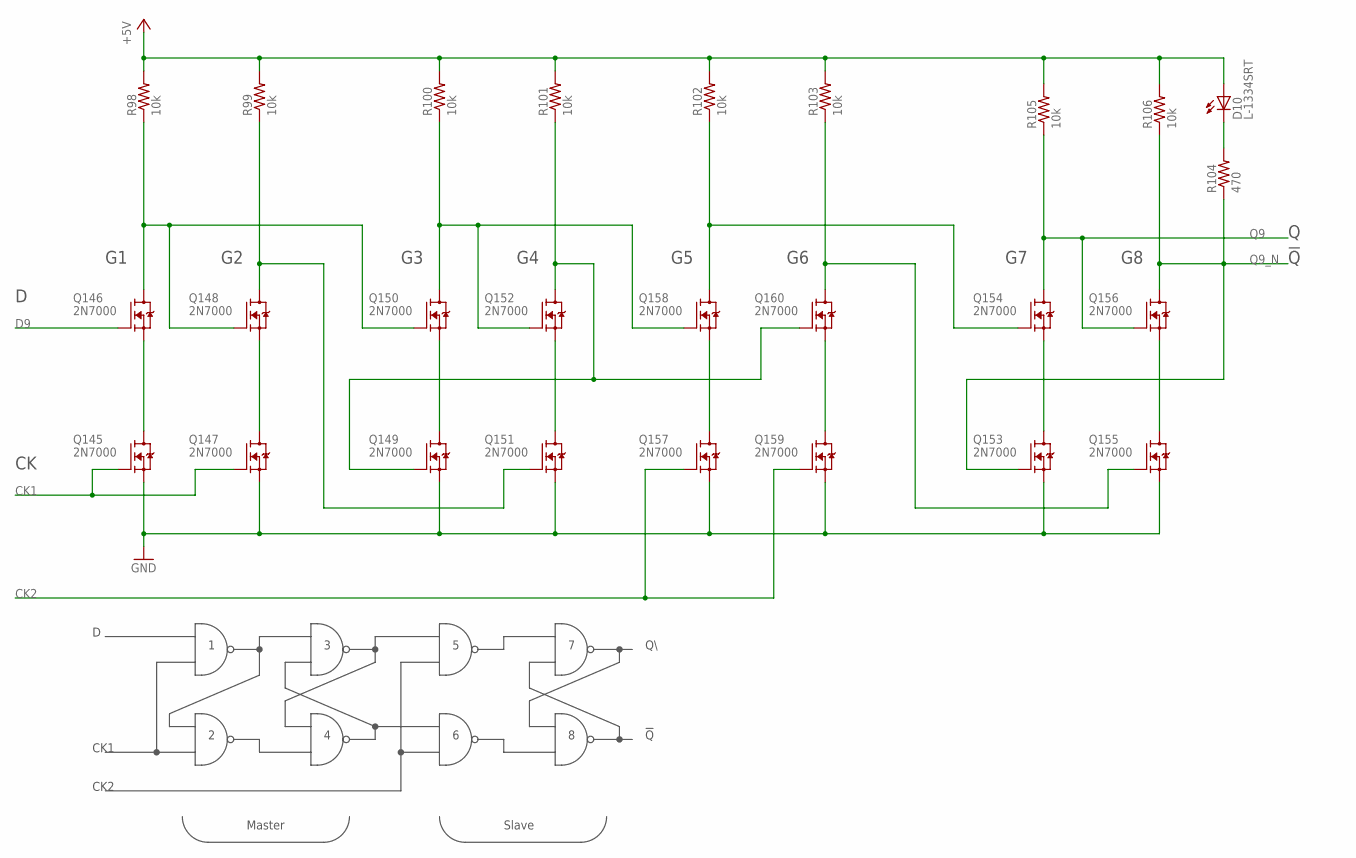
[picture p147: schematic 16REG_2a.sch, sheet 13]

Parts:
D10: L-1334SRT; LED3MM
Q145, Q146, Q147, Q148, Q149, Q150, Q151, Q152, Q153, Q154, Q155, Q156, Q157, Q158, Q159, Q160: 2N7000; TO92-DGS
R98, R99, R100, R101, R102, R103, R105, R106: 10k; R_P2INCH
R104: 470; R_P2INCH

Connections:
+5V: D10.A, R98.2, R99.2, R100.2, R101.2, R102.2, R103.2, R105.2, R106.2; also elsewhere on the board
CK1: Q145.G, Q147.G; also elsewhere on the board
CK2: Q157.G, Q159.G; also elsewhere on the board
D9: Q146.G; also elsewhere on the board
GND: Q145.S, Q147.S, Q149.S, Q151.S, Q153.S, Q155.S, Q157.S, Q159.S; also elsewhere on the board
unnamed: Q145.D, Q146.S
unnamed: Q147.D, Q148.S
unnamed: Q149.D, Q150.S
unnamed: Q151.D, Q152.S
unnamed: Q153.D, Q154.S
unnamed: Q155.D, Q156.S
unnamed: Q146.D, Q148.G, Q150.G, R98.1
unnamed: Q149.G, Q152.D, Q160.G, R101.1
unnamed: D10.K (C), R104.2
unnamed: Q150.D, Q152.G, Q158.G, R100.1
unnamed: Q148.D, Q151.G, R99.1
unnamed: Q157.D, Q158.S
unnamed: Q159.D, Q160.S
unnamed: Q154.G, Q158.D, R102.1
unnamed: Q155.G, Q160.D, R103.1
Q9: Q154.D, Q156.G, R105.1; also elsewhere on the board
Q9_N: Q153.G, Q156.D, R104.1, R106.1

Notes on the sheet:
CK1
CK2
Master
Slave

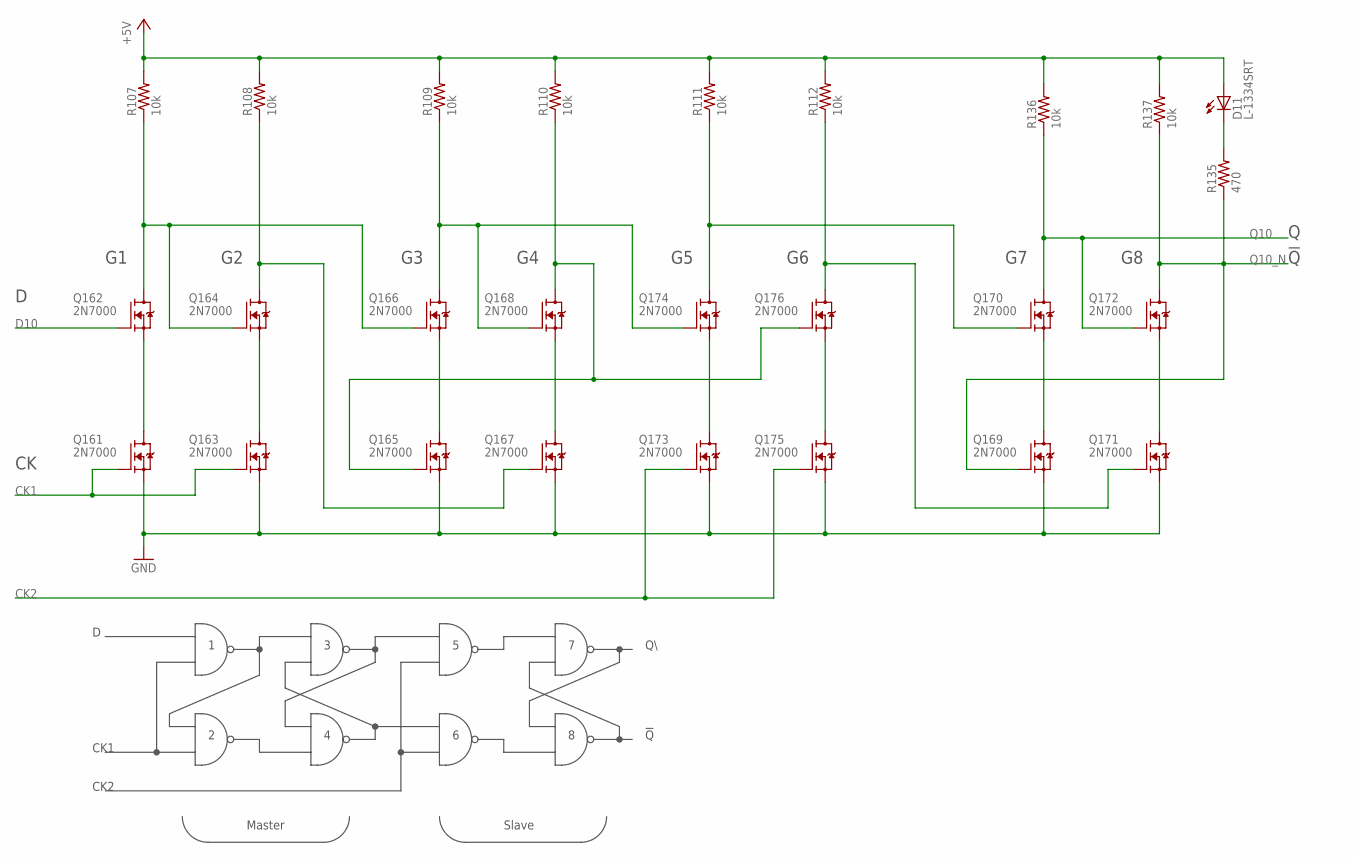
[picture p148: schematic 16REG_2a.sch, sheet 14]

Parts:
D11: L-1334SRT; LED3MM
Q161, Q162, Q163, Q164, Q165, Q166, Q167, Q168, Q169, Q170, Q171, Q172, Q173, Q174, Q175, Q176: 2N7000; TO92-DGS
R107, R108, R109, R110, R111, R112, R136, R137: 10k; R_P2INCH
R135: 470; R_P2INCH

Connections:
+5V: D11.A, R107.2, R108.2, R109.2, R110.2, R111.2, R112.2, R136.2, R137.2; also elsewhere on the board
CK1: Q161.G, Q163.G; also elsewhere on the board
CK2: Q173.G, Q175.G; also elsewhere on the board
D10: Q162.G; also elsewhere on the board
GND: Q161.S, Q163.S, Q165.S, Q167.S, Q169.S, Q171.S, Q173.S, Q175.S; also elsewhere on the board
unnamed: Q161.D, Q162.S
unnamed: Q163.D, Q164.S
unnamed: Q165.D, Q166.S
unnamed: Q167.D, Q168.S
unnamed: Q169.D, Q170.S
unnamed: Q171.D, Q172.S
unnamed: Q162.D, Q164.G, Q166.G, R107.1
unnamed: Q165.G, Q168.D, Q176.G, R110.1
unnamed: D11.K (C), R135.2
unnamed: Q166.D, Q168.G, Q174.G, R109.1
unnamed: Q164.D, Q167.G, R108.1
unnamed: Q173.D, Q174.S
unnamed: Q175.D, Q176.S
unnamed: Q170.G, Q174.D, R111.1
unnamed: Q171.G, Q176.D, R112.1
Q10: Q170.D, Q172.G, R136.1; also elsewhere on the board
Q10_N: Q169.G, Q172.D, R135.1, R137.1

Notes on the sheet:
CK1
CK2
Master
Slave

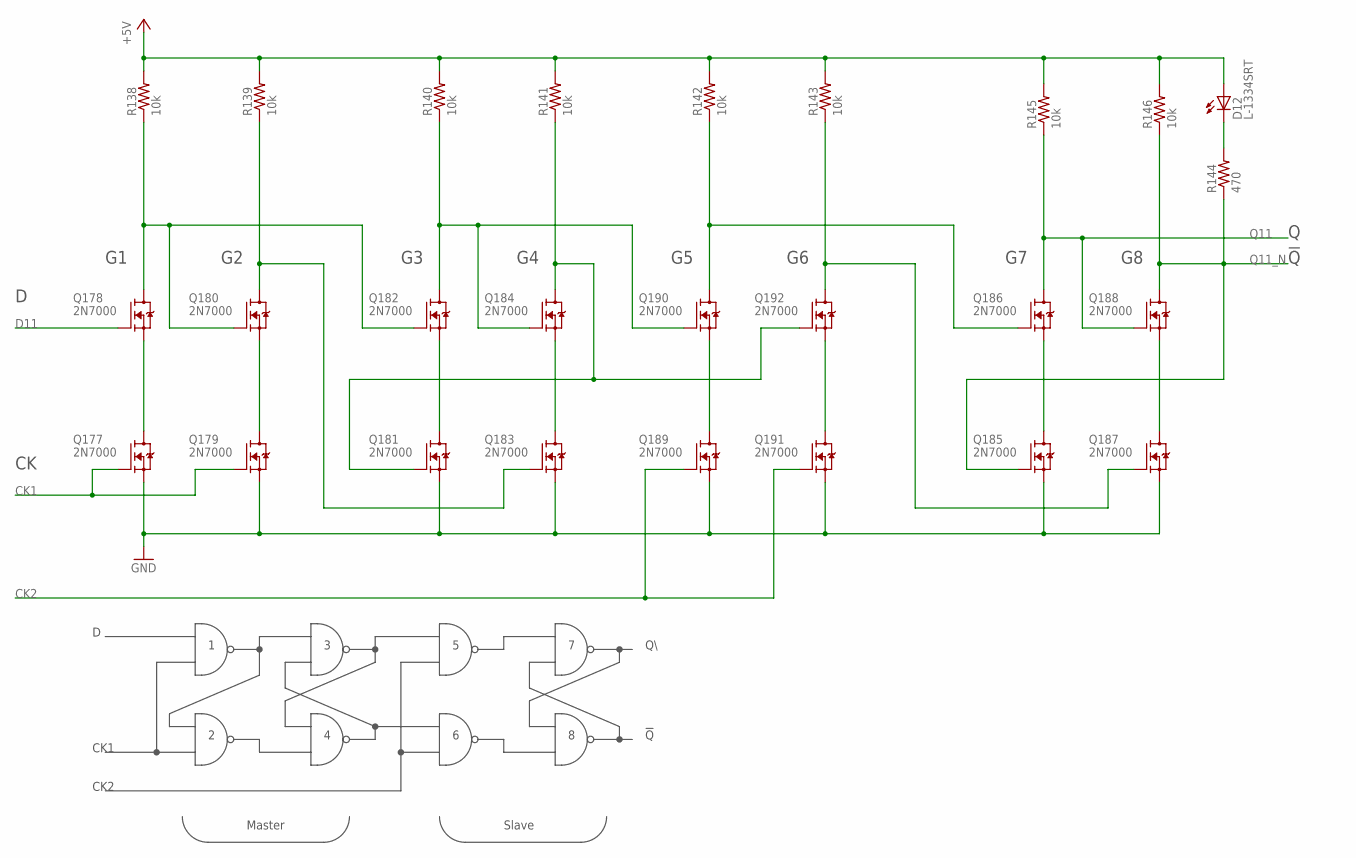
[picture p149: schematic 16REG_2a.sch, sheet 15]

Parts:
D12: L-1334SRT; LED3MM
Q177, Q178, Q179, Q180, Q181, Q182, Q183, Q184, Q185, Q186, Q187, Q188, Q189, Q190, Q191, Q192: 2N7000; TO92-DGS
R138, R139, R140, R141, R142, R143, R145, R146: 10k; R_P2INCH
R144: 470; R_P2INCH

Connections:
+5V: D12.A, R138.2, R139.2, R140.2, R141.2, R142.2, R143.2, R145.2, R146.2; also elsewhere on the board
CK1: Q177.G, Q179.G; also elsewhere on the board
CK2: Q189.G, Q191.G; also elsewhere on the board
D11: Q178.G; also elsewhere on the board
GND: Q177.S, Q179.S, Q181.S, Q183.S, Q185.S, Q187.S, Q189.S, Q191.S; also elsewhere on the board
unnamed: Q177.D, Q178.S
unnamed: Q179.D, Q180.S
unnamed: Q181.D, Q182.S
unnamed: Q183.D, Q184.S
unnamed: Q185.D, Q186.S
unnamed: Q187.D, Q188.S
unnamed: Q178.D, Q180.G, Q182.G, R138.1
unnamed: Q181.G, Q184.D, Q192.G, R141.1
unnamed: D12.K (C), R144.2
unnamed: Q182.D, Q184.G, Q190.G, R140.1
unnamed: Q180.D, Q183.G, R139.1
unnamed: Q189.D, Q190.S
unnamed: Q191.D, Q192.S
unnamed: Q186.G, Q190.D, R142.1
unnamed: Q187.G, Q192.D, R143.1
Q11: Q186.D, Q188.G, R145.1; also elsewhere on the board
Q11_N: Q185.G, Q188.D, R144.1, R146.1

Notes on the sheet:
CK1
CK2
Master
Slave

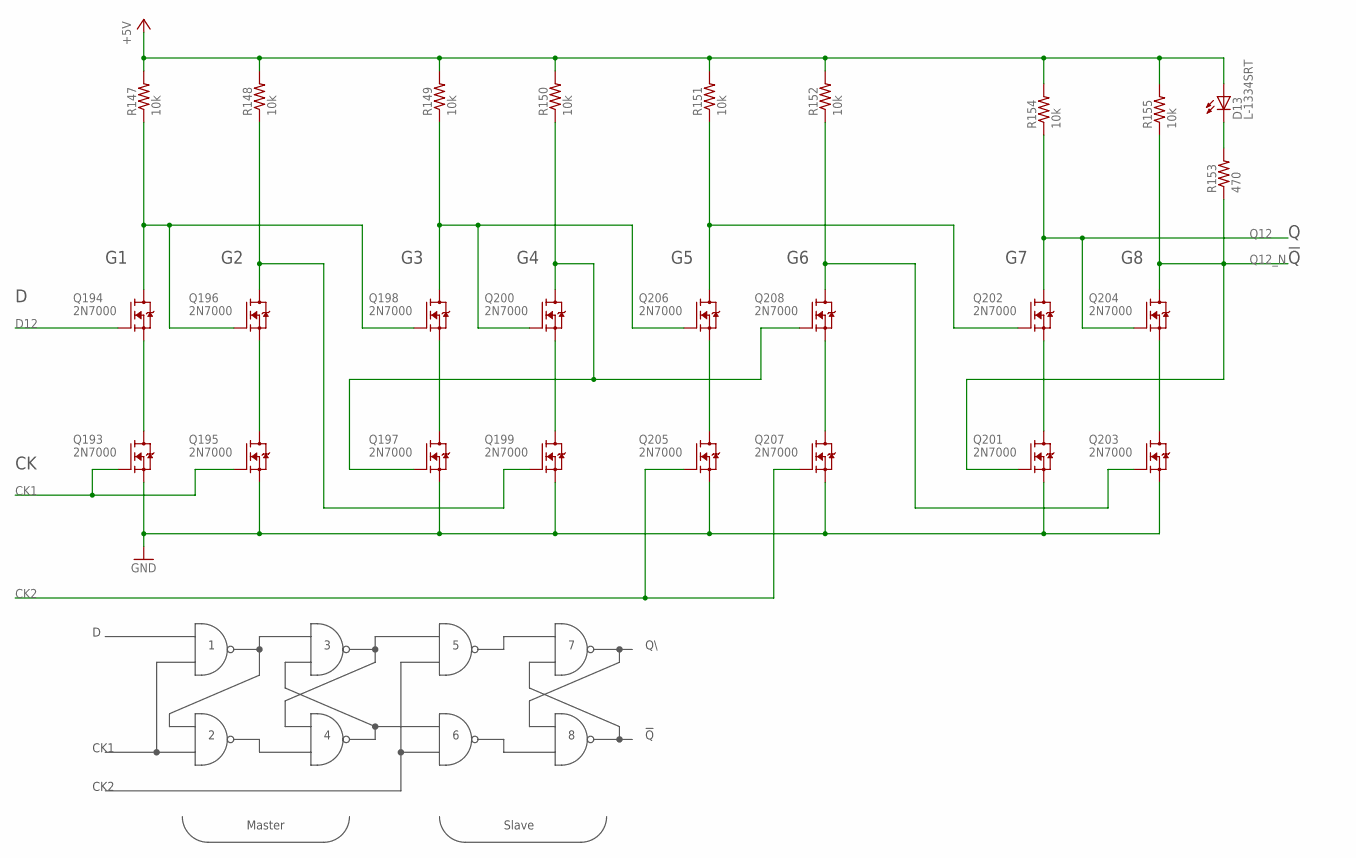
[picture p150: schematic 16REG_2a.sch, sheet 16]

Parts:
D13: L-1334SRT; LED3MM
Q193, Q194, Q195, Q196, Q197, Q198, Q199, Q200, Q201, Q202, Q203, Q204, Q205, Q206, Q207, Q208: 2N7000; TO92-DGS
R147, R148, R149, R150, R151, R152, R154, R155: 10k; R_P2INCH
R153: 470; R_P2INCH

Connections:
+5V: D13.A, R147.2, R148.2, R149.2, R150.2, R151.2, R152.2, R154.2, R155.2; also elsewhere on the board
CK1: Q193.G, Q195.G; also elsewhere on the board
CK2: Q205.G, Q207.G; also elsewhere on the board
D12: Q194.G; also elsewhere on the board
GND: Q193.S, Q195.S, Q197.S, Q199.S, Q201.S, Q203.S, Q205.S, Q207.S; also elsewhere on the board
unnamed: Q193.D, Q194.S
unnamed: Q195.D, Q196.S
unnamed: Q197.D, Q198.S
unnamed: Q199.D, Q200.S
unnamed: Q201.D, Q202.S
unnamed: Q203.D, Q204.S
unnamed: Q194.D, Q196.G, Q198.G, R147.1
unnamed: Q197.G, Q200.D, Q208.G, R150.1
unnamed: D13.K (C), R153.2
unnamed: Q198.D, Q200.G, Q206.G, R149.1
unnamed: Q196.D, Q199.G, R148.1
unnamed: Q205.D, Q206.S
unnamed: Q207.D, Q208.S
unnamed: Q202.G, Q206.D, R151.1
unnamed: Q203.G, Q208.D, R152.1
Q12: Q202.D, Q204.G, R154.1; also elsewhere on the board
Q12_N: Q201.G, Q204.D, R153.1, R155.1

Notes on the sheet:
CK1
CK2
Master
Slave
