ericherman/megaprocessor/16reg/16REG_2a.brd

## EAGLE design 16reg/16REG_2a.brd (continued)

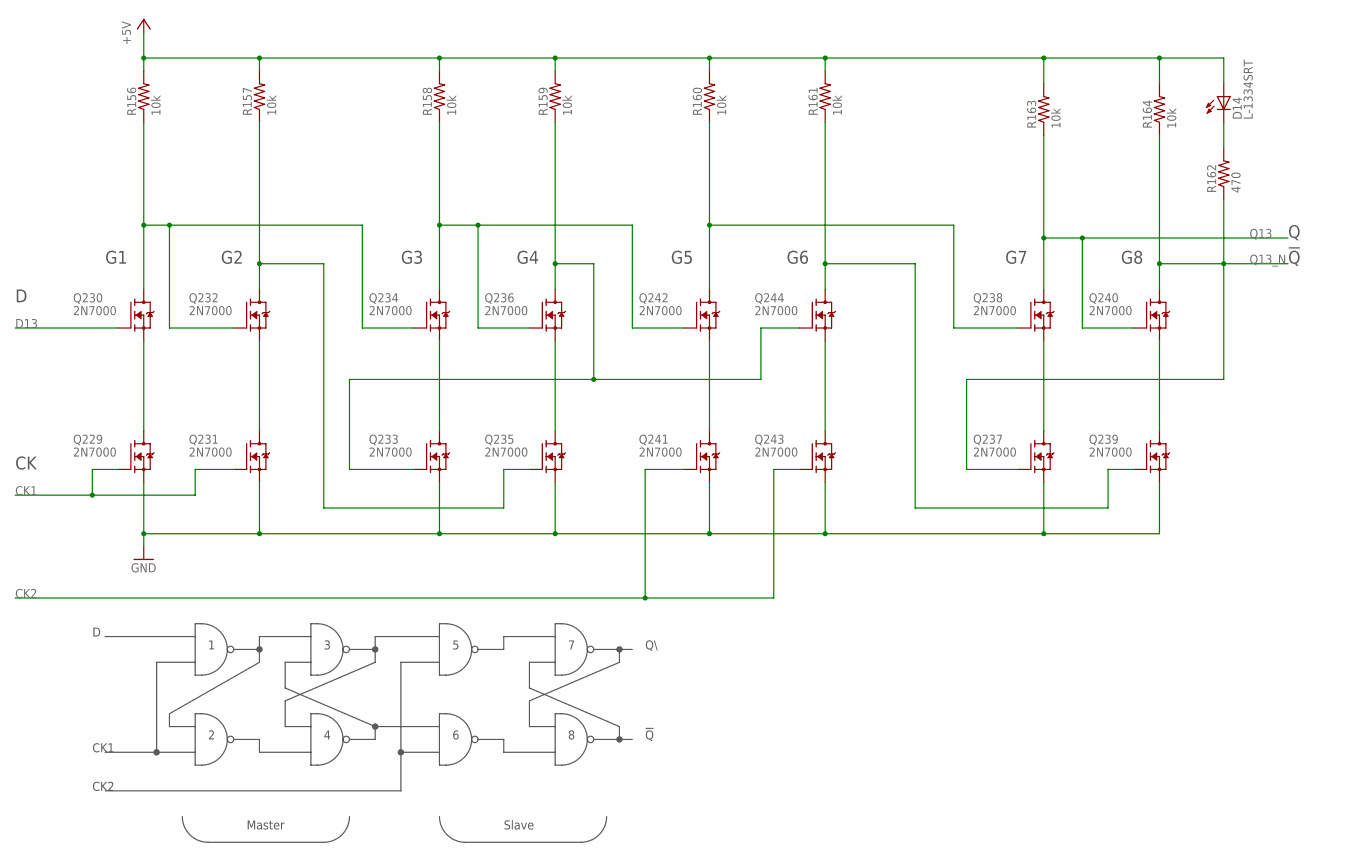
[picture p151: schematic 16REG_2a.sch, sheet 17]

Parts:
D14: L-1334SRT; LED3MM
Q229, Q230, Q231, Q232, Q233, Q234, Q235, Q236, Q237, Q238, Q239, Q240, Q241, Q242, Q243, Q244: 2N7000; TO92-DGS
R156, R157, R158, R159, R160, R161, R163, R164: 10k; R_P2INCH
R162: 470; R_P2INCH

Connections:
+5V: D14.A, R156.2, R157.2, R158.2, R159.2, R160.2, R161.2, R163.2, R164.2; also elsewhere on the board
CK1: Q229.G, Q231.G; also elsewhere on the board
CK2: Q241.G, Q243.G; also elsewhere on the board
D13: Q230.G; also elsewhere on the board
GND: Q229.S, Q231.S, Q233.S, Q235.S, Q237.S, Q239.S, Q241.S, Q243.S; also elsewhere on the board
unnamed: Q229.D, Q230.S
unnamed: Q231.D, Q232.S
unnamed: Q233.D, Q234.S
unnamed: Q235.D, Q236.S
unnamed: Q237.D, Q238.S
unnamed: Q239.D, Q240.S
unnamed: Q230.D, Q232.G, Q234.G, R156.1
unnamed: Q233.G, Q236.D, Q244.G, R159.1
unnamed: D14.K (C), R162.2
unnamed: Q234.D, Q236.G, Q242.G, R158.1
unnamed: Q232.D, Q235.G, R157.1
unnamed: Q241.D, Q242.S
unnamed: Q243.D, Q244.S
unnamed: Q238.G, Q242.D, R160.1
unnamed: Q239.G, Q244.D, R161.1
Q13: Q238.D, Q240.G, R163.1; also elsewhere on the board
Q13_N: Q237.G, Q240.D, R162.1, R164.1

Notes on the sheet:
CK1
CK2
Master
Slave

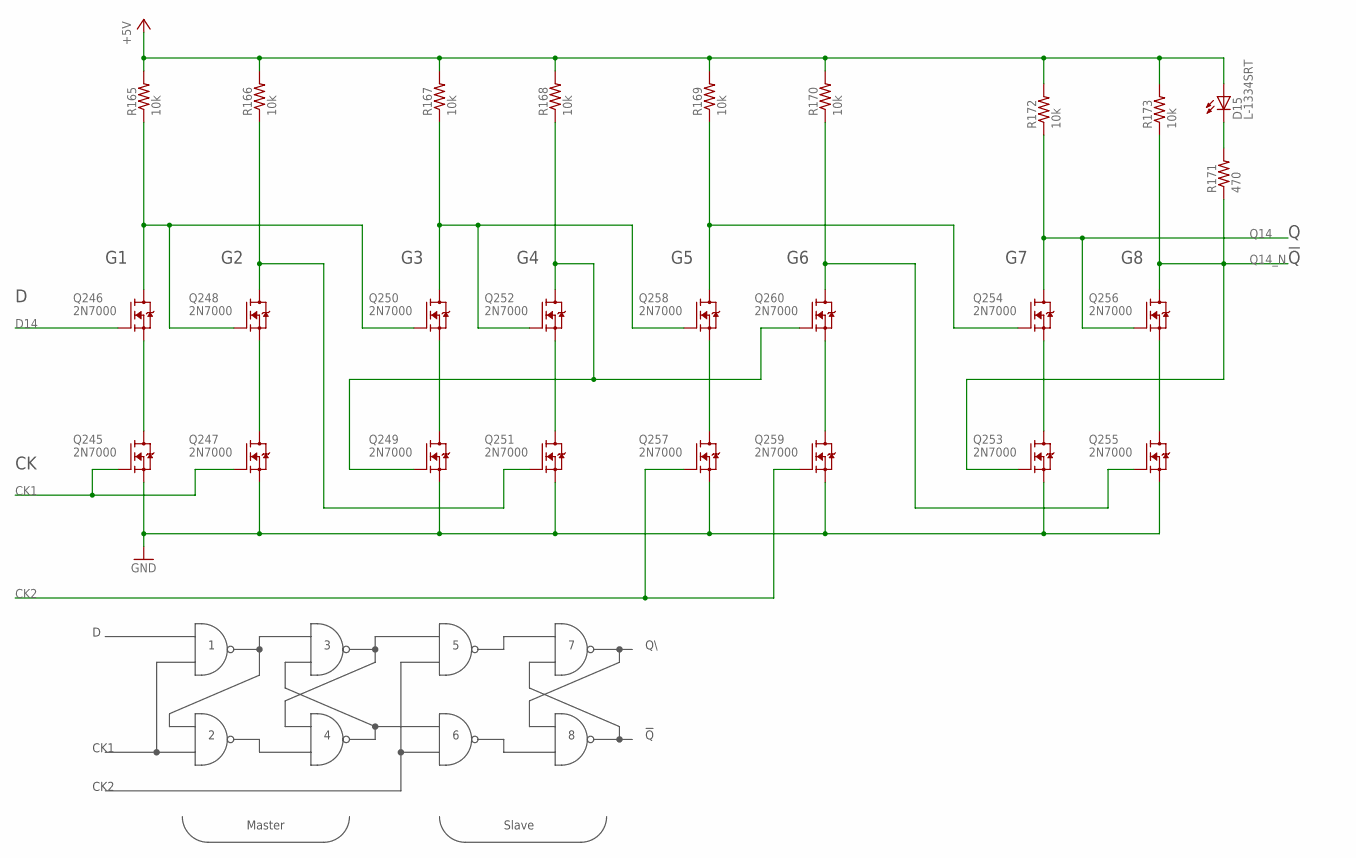
[picture p152: schematic 16REG_2a.sch, sheet 18]

Parts:
D15: L-1334SRT; LED3MM
Q245, Q246, Q247, Q248, Q249, Q250, Q251, Q252, Q253, Q254, Q255, Q256, Q257, Q258, Q259, Q260: 2N7000; TO92-DGS
R165, R166, R167, R168, R169, R170, R172, R173: 10k; R_P2INCH
R171: 470; R_P2INCH

Connections:
+5V: D15.A, R165.2, R166.2, R167.2, R168.2, R169.2, R170.2, R172.2, R173.2; also elsewhere on the board
CK1: Q245.G, Q247.G; also elsewhere on the board
CK2: Q257.G, Q259.G; also elsewhere on the board
D14: Q246.G; also elsewhere on the board
GND: Q245.S, Q247.S, Q249.S, Q251.S, Q253.S, Q255.S, Q257.S, Q259.S; also elsewhere on the board
unnamed: Q245.D, Q246.S
unnamed: Q247.D, Q248.S
unnamed: Q249.D, Q250.S
unnamed: Q251.D, Q252.S
unnamed: Q253.D, Q254.S
unnamed: Q255.D, Q256.S
unnamed: Q246.D, Q248.G, Q250.G, R165.1
unnamed: Q249.G, Q252.D, Q260.G, R168.1
unnamed: D15.K (C), R171.2
unnamed: Q250.D, Q252.G, Q258.G, R167.1
unnamed: Q248.D, Q251.G, R166.1
unnamed: Q257.D, Q258.S
unnamed: Q259.D, Q260.S
unnamed: Q254.G, Q258.D, R169.1
unnamed: Q255.G, Q260.D, R170.1
Q14: Q254.D, Q256.G, R172.1; also elsewhere on the board
Q14_N: Q253.G, Q256.D, R171.1, R173.1

Notes on the sheet:
CK1
CK2
Master
Slave

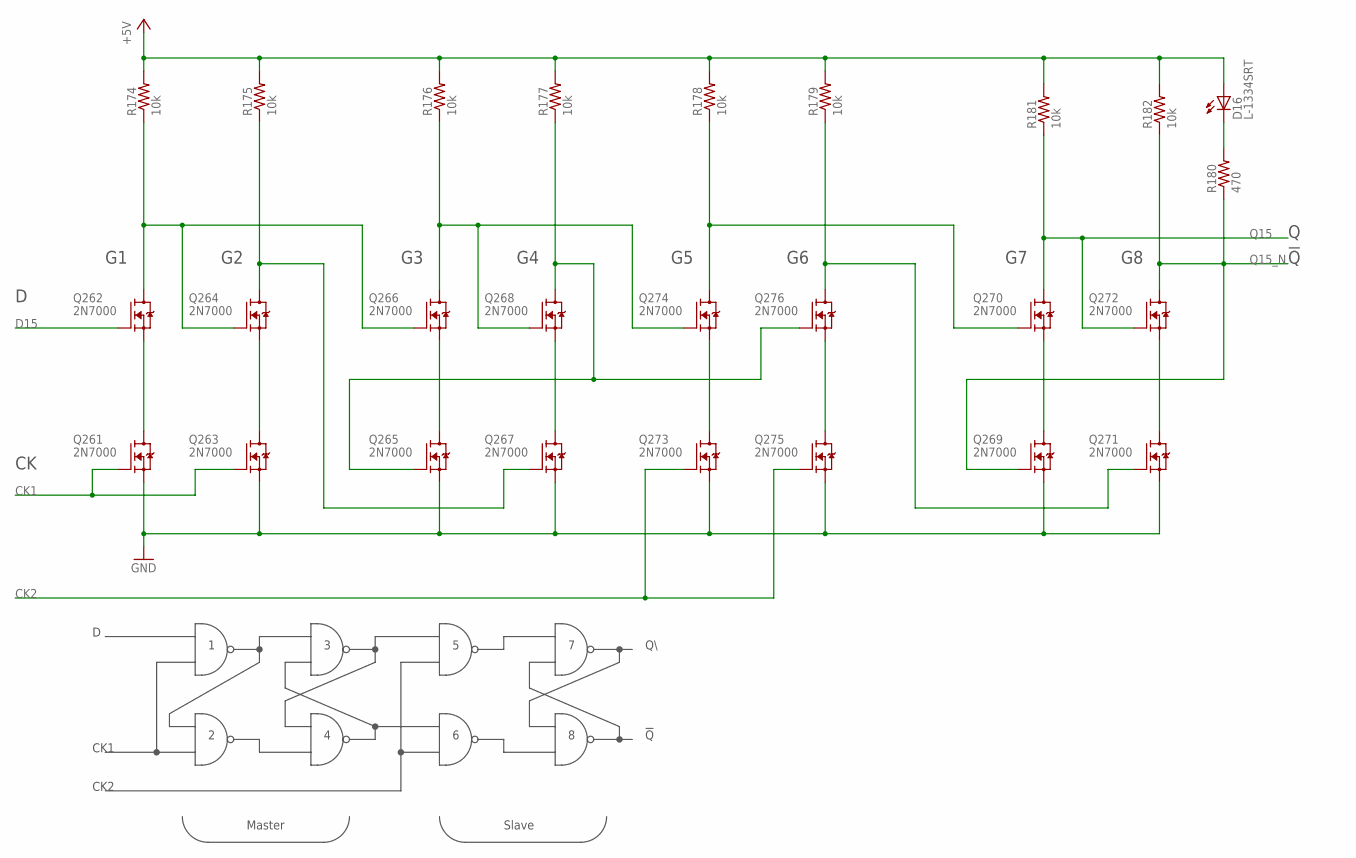
[picture p153: schematic 16REG_2a.sch, sheet 19]

Parts:
D16: L-1334SRT; LED3MM
Q261, Q262, Q263, Q264, Q265, Q266, Q267, Q268, Q269, Q270, Q271, Q272, Q273, Q274, Q275, Q276: 2N7000; TO92-DGS
R174, R175, R176, R177, R178, R179, R181, R182: 10k; R_P2INCH
R180: 470; R_P2INCH

Connections:
+5V: D16.A, R174.2, R175.2, R176.2, R177.2, R178.2, R179.2, R181.2, R182.2; also elsewhere on the board
CK1: Q261.G, Q263.G; also elsewhere on the board
CK2: Q273.G, Q275.G; also elsewhere on the board
D15: Q262.G; also elsewhere on the board
GND: Q261.S, Q263.S, Q265.S, Q267.S, Q269.S, Q271.S, Q273.S, Q275.S; also elsewhere on the board
unnamed: Q261.D, Q262.S
unnamed: Q263.D, Q264.S
unnamed: Q265.D, Q266.S
unnamed: Q267.D, Q268.S
unnamed: Q269.D, Q270.S
unnamed: Q271.D, Q272.S
unnamed: Q262.D, Q264.G, Q266.G, R174.1
unnamed: Q265.G, Q268.D, Q276.G, R177.1
unnamed: D16.K (C), R180.2
unnamed: Q266.D, Q268.G, Q274.G, R176.1
unnamed: Q264.D, Q267.G, R175.1
unnamed: Q273.D, Q274.S
unnamed: Q275.D, Q276.S
unnamed: Q270.G, Q274.D, R178.1
unnamed: Q271.G, Q276.D, R179.1
Q15: Q270.D, Q272.G, R181.1; also elsewhere on the board
Q15_N: Q269.G, Q272.D, R180.1, R182.1

Notes on the sheet:
CK1
CK2
Master
Slave

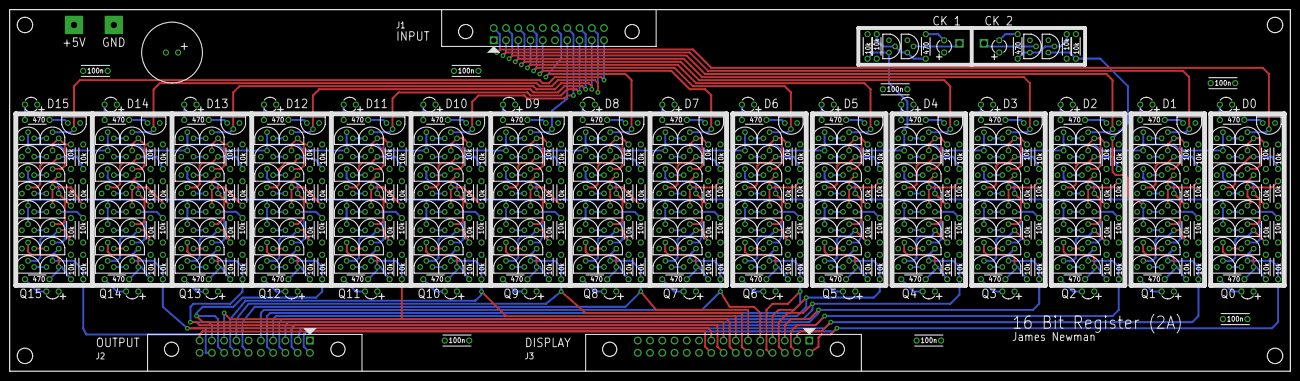
[picture p154: board 16REG_2a.brd from above]

Board: 4 copper layers, 265.4 x 74.9 mm, 495 parts (0 on the bottom side), 330 nets.
