ericherman/megaprocessor/if_test/IF_TEST_1.brd

## EAGLE design if_test/IF_TEST_1.brd (continued)

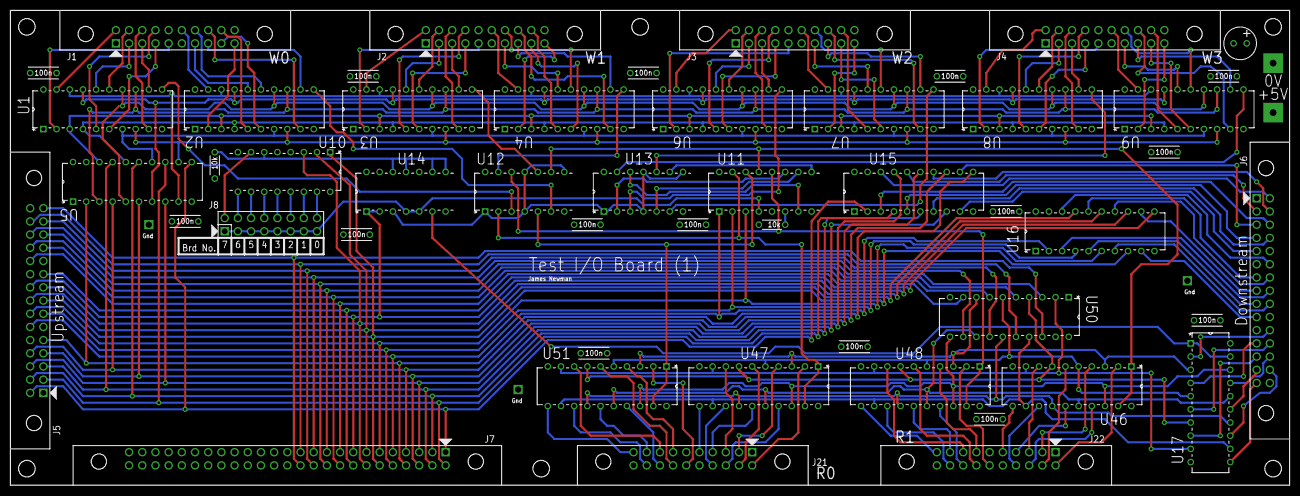
[picture p161: board IF_TEST_1.brd from above]

Board: 4 copper layers, 246.4 x 91.4 mm, 61 parts (0 on the bottom side), 191 nets.
