ericherman/megaprocessor/7seg_status/7SEG_STATUS_1.brd

## EAGLE design 7seg_status/7SEG_STATUS_1.brd (2017-05-20)

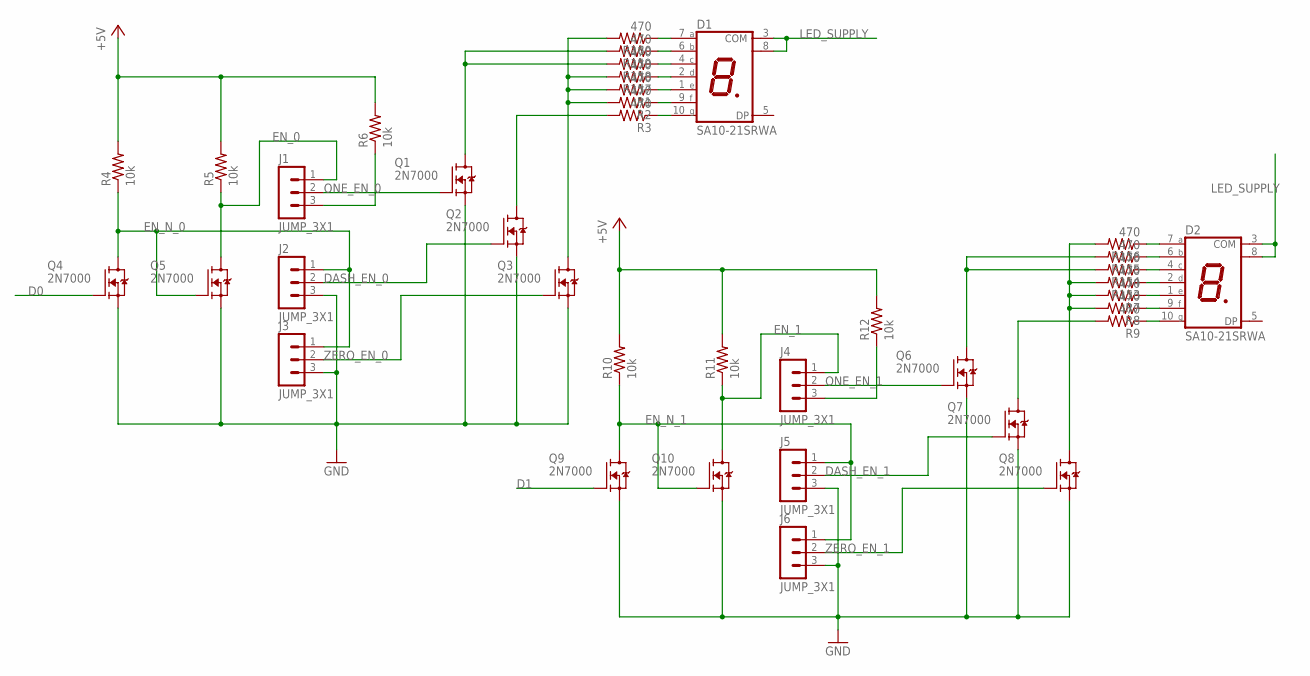
[picture p162: schematic 7SEG_STATUS_1.sch, sheet 1]

Parts:
D1, D2: SA10-21SRWA; SA10
J1, J2, J3, J4, J5, J6: JUMP_3X1
Q1, Q2, Q3, Q4, Q5, Q6, Q7, Q8, Q9, Q10: 2N7000; TO92-DGS
R1, R2, R3, R7, R8, R9, R153, R154, R155, R156, R157, R158, R159, R160: 470; R_P2INCH
R4, R5, R6, R10, R11, R12: 10k; R_P2INCH

Connections:
+5V: R4.2, R5.2, R6.2, R10.2, R11.2, R12.2; also elsewhere on the board
D0: Q4.G; also elsewhere on the board
D1: Q9.G; also elsewhere on the board
DASH_EN_0: J2.2, Q2.G
DASH_EN_1: J5.2, Q7.G
EN_0: J1.1, Q5.D, R5.1
EN_1: J4.1, Q10.D, R11.1
EN_N_0: J2.1, J3.1, Q4.D, Q5.G, R4.1
EN_N_1: J5.1, J6.1, Q9.D, Q10.G, R10.1
GND: J2.3, J3.3, J5.3, J6.3, Q1.S, Q2.S, Q3.S, Q4.S, Q5.S, Q6.S, Q7.S, Q8.S, Q9.S, Q10.S; also elsewhere on the board
LED_SUPPLY: D1.3 (COM), D1.8 (COM), D2.3 (COM), D2.8 (COM); also elsewhere on the board
unnamed: D2.7 (A), R156.1
unnamed: D2.6 (B), R155.1
unnamed: D2.4 (C), R154.1
unnamed: D2.2 (D), R153.1
unnamed: D1.7 (A), R160.1
unnamed: D2.1 (E), R7.1
unnamed: D2.9 (F), R8.1
unnamed: J4.3, R12.1
unnamed: J1.3, R6.1
unnamed: D2.10 (G), R9.1
unnamed: Q7.D, R9.2
unnamed: Q6.D, R154.2, R155.2
unnamed: Q8.D, R7.2, R8.2, R153.2, R156.2
unnamed: D1.6 (B), R159.1
unnamed: D1.4 (C), R158.1
unnamed: D1.2 (D), R157.1
unnamed: D1.1 (E), R1.1
unnamed: D1.9 (F), R2.1
unnamed: D1.10 (G), R3.1
unnamed: Q2.D, R3.2
unnamed: Q1.D, R158.2, R159.2
unnamed: Q3.D, R1.2, R2.2, R157.2, R160.2
ONE_EN_0: J1.2, Q1.G
ONE_EN_1: J4.2, Q6.G
ZERO_EN_0: J3.2, Q3.G
ZERO_EN_1: J6.2, Q8.G

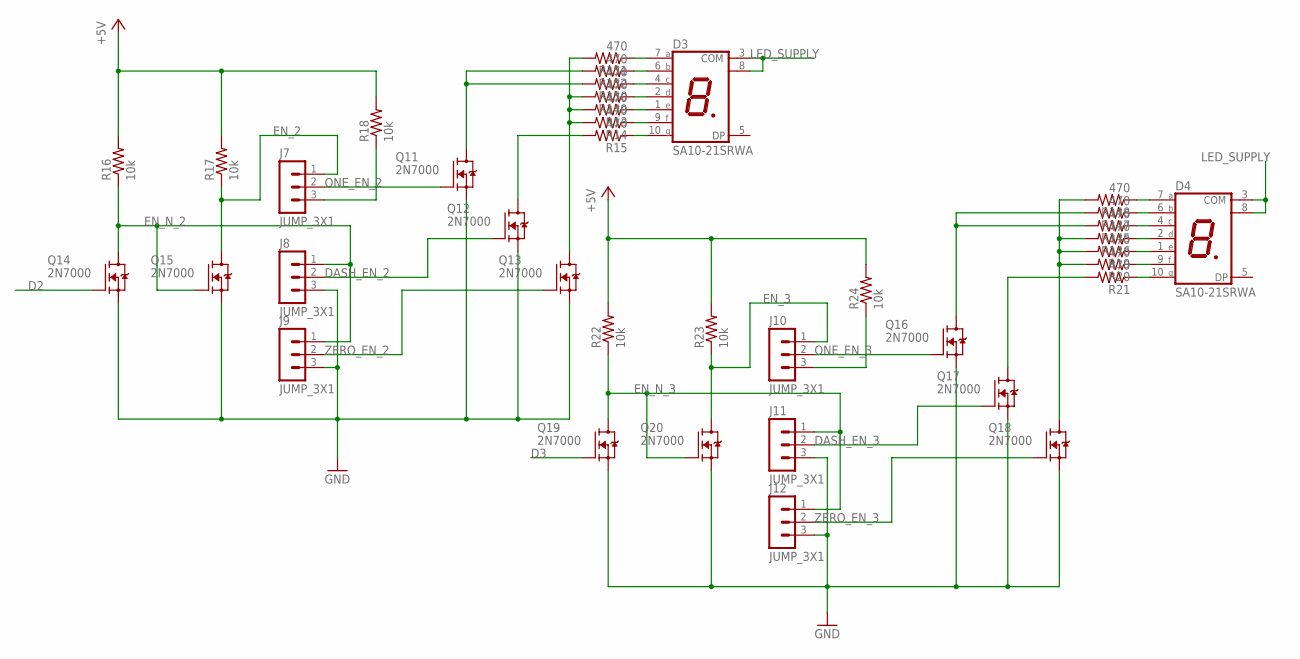
[picture p163: schematic 7SEG_STATUS_1.sch, sheet 2]

Parts:
D3, D4: SA10-21SRWA; SA10
J7, J8, J9, J10, J11, J12: JUMP_3X1
Q11, Q12, Q13, Q14, Q15, Q16, Q17, Q18, Q19, Q20: 2N7000; TO92-DGS
R13, R14, R15, R19, R20, R21, R145, R146, R147, R148, R149, R150, R151, R152: 470; R_P2INCH
R16, R17, R18, R22, R23, R24: 10k; R_P2INCH

Connections:
+5V: R16.2, R17.2, R18.2, R22.2, R23.2, R24.2; also elsewhere on the board
D2: Q14.G; also elsewhere on the board
D3: Q19.G; also elsewhere on the board
DASH_EN_2: J8.2, Q12.G
DASH_EN_3: J11.2, Q17.G
EN_2: J7.1, Q15.D, R17.1
EN_3: J10.1, Q20.D, R23.1
EN_N_2: J8.1, J9.1, Q14.D, Q15.G, R16.1
EN_N_3: J11.1, J12.1, Q19.D, Q20.G, R22.1
GND: J8.3, J9.3, J11.3, J12.3, Q11.S, Q12.S, Q13.S, Q14.S, Q15.S, Q16.S, Q17.S, Q18.S, Q19.S, Q20.S; also elsewhere on the board
LED_SUPPLY: D3.3 (COM), D3.8 (COM), D4.3 (COM), D4.8 (COM); also elsewhere on the board
unnamed: D3.7 (A), R151.1
unnamed: D4.7 (A), R148.1
unnamed: D4.6 (B), R147.1
unnamed: J7.3, R18.1
unnamed: D4.4 (C), R145.1
unnamed: D4.2 (D), R146.1
unnamed: D4.1 (E), R19.1
unnamed: D4.9 (F), R20.1
unnamed: J10.3, R24.1
unnamed: D4.10 (G), R21.1
unnamed: Q17.D, R21.2
unnamed: Q16.D, R145.2, R147.2
unnamed: Q18.D, R19.2, R20.2, R146.2, R148.2
unnamed: D3.6 (B), R152.1
unnamed: D3.4 (C), R150.1
unnamed: D3.2 (D), R149.1
unnamed: D3.1 (E), R13.1
unnamed: D3.9 (F), R14.1
unnamed: D3.10 (G), R15.1
unnamed: Q12.D, R15.2
unnamed: Q11.D, R150.2, R152.2
unnamed: Q13.D, R13.2, R14.2, R149.2, R151.2
ONE_EN_2: J7.2, Q11.G
ONE_EN_3: J10.2, Q16.G
ZERO_EN_2: J9.2, Q13.G
ZERO_EN_3: J12.2, Q18.G

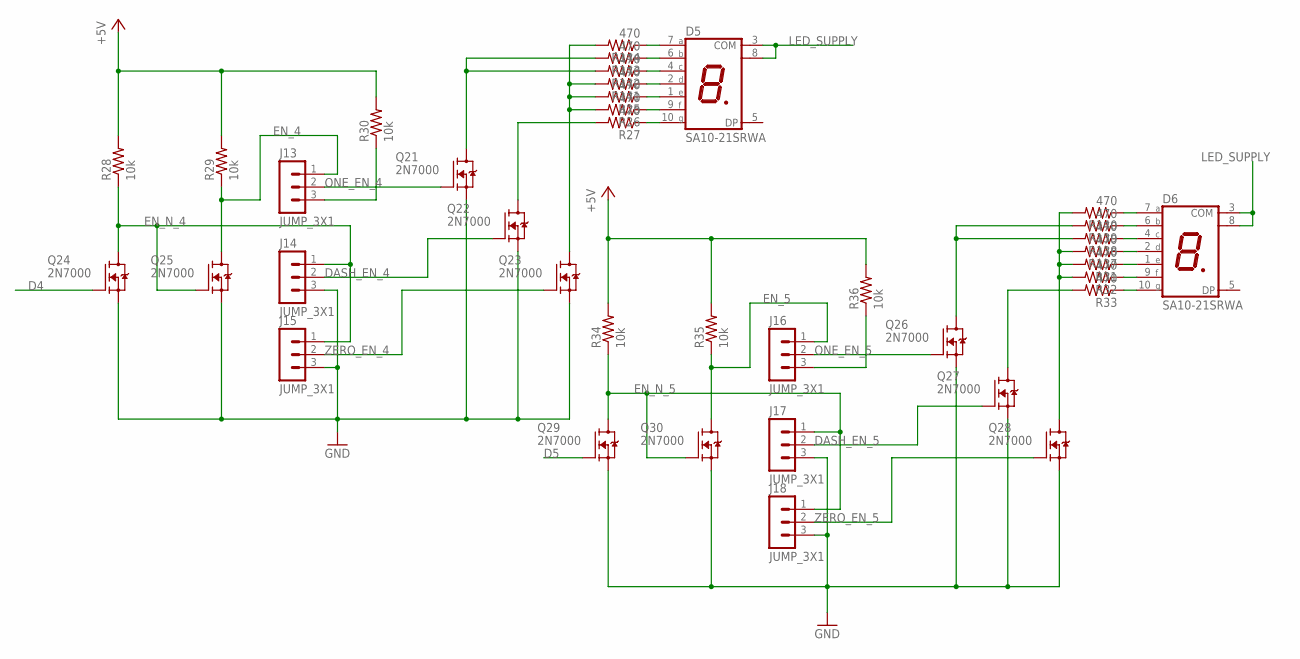
[picture p164: schematic 7SEG_STATUS_1.sch, sheet 3]

Parts:
D5, D6: SA10-21SRWA; SA10
J13, J14, J15, J16, J17, J18: JUMP_3X1
Q21, Q22, Q23, Q24, Q25, Q26, Q27, Q28, Q29, Q30: 2N7000; TO92-DGS
R25, R26, R27, R31, R32, R33, R137, R138, R139, R140, R141, R142, R143, R144: 470; R_P2INCH
R28, R29, R30, R34, R35, R36: 10k; R_P2INCH

Connections:
+5V: R28.2, R29.2, R30.2, R34.2, R35.2, R36.2; also elsewhere on the board
D4: Q24.G; also elsewhere on the board
D5: Q29.G; also elsewhere on the board
DASH_EN_4: J14.2, Q22.G
DASH_EN_5: J17.2, Q27.G
EN_4: J13.1, Q25.D, R29.1
EN_5: J16.1, Q30.D, R35.1
EN_N_4: J14.1, J15.1, Q24.D, Q25.G, R28.1
EN_N_5: J17.1, J18.1, Q29.D, Q30.G, R34.1
GND: J14.3, J15.3, J17.3, J18.3, Q21.S, Q22.S, Q23.S, Q24.S, Q25.S, Q26.S, Q27.S, Q28.S, Q29.S, Q30.S; also elsewhere on the board
LED_SUPPLY: D5.3 (COM), D5.8 (COM), D6.3 (COM), D6.8 (COM); also elsewhere on the board
unnamed: Q22.D, R27.2
unnamed: D6.7 (A), R140.1
unnamed: D6.6 (B), R139.1
unnamed: D6.4 (C), R138.1
unnamed: J13.3, R30.1
unnamed: D6.2 (D), R137.1
unnamed: D6.1 (E), R31.1
unnamed: D6.9 (F), R32.1
unnamed: Q21.D, R142.2, R143.2
unnamed: J16.3, R36.1
unnamed: D6.10 (G), R33.1
unnamed: Q26.D, R138.2, R139.2
unnamed: Q27.D, R33.2
unnamed: Q28.D, R31.2, R32.2, R137.2, R140.2
unnamed: Q23.D, R25.2, R26.2, R141.2, R144.2
unnamed: D5.7 (A), R144.1
unnamed: D5.6 (B), R143.1
unnamed: D5.4 (C), R142.1
unnamed: D5.2 (D), R141.1
unnamed: D5.1 (E), R25.1
unnamed: D5.9 (F), R26.1
unnamed: D5.10 (G), R27.1
ONE_EN_4: J13.2, Q21.G
ONE_EN_5: J16.2, Q26.G
ZERO_EN_4: J15.2, Q23.G
ZERO_EN_5: J18.2, Q28.G

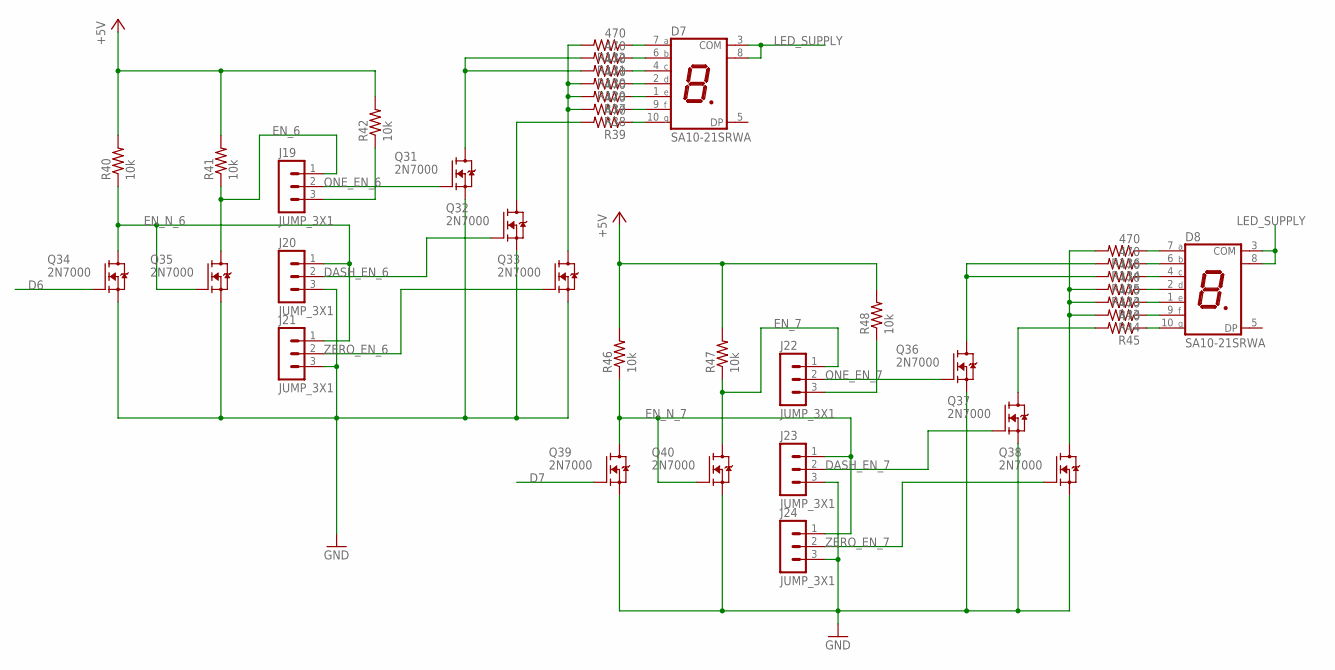
[picture p165: schematic 7SEG_STATUS_1.sch, sheet 4]

Parts:
D7, D8: SA10-21SRWA; SA10
J19, J20, J21, J22, J23, J24: JUMP_3X1
Q31, Q32, Q33, Q34, Q35, Q36, Q37, Q38, Q39, Q40: 2N7000; TO92-DGS
R37, R38, R39, R43, R44, R45, R129, R130, R131, R132, R133, R134, R135, R136: 470; R_P2INCH
R40, R41, R42, R46, R47, R48: 10k; R_P2INCH

Connections:
+5V: R40.2, R41.2, R42.2, R46.2, R47.2, R48.2; also elsewhere on the board
D6: Q34.G; also elsewhere on the board
D7: Q39.G; also elsewhere on the board
DASH_EN_6: J20.2, Q32.G
DASH_EN_7: J23.2, Q37.G
EN_6: J19.1, Q35.D, R41.1
EN_7: J22.1, Q40.D, R47.1
EN_N_6: J20.1, J21.1, Q34.D, Q35.G, R40.1
EN_N_7: J23.1, J24.1, Q39.D, Q40.G, R46.1
GND: J20.3, J21.3, J23.3, J24.3, Q31.S, Q32.S, Q33.S, Q34.S, Q35.S, Q36.S, Q37.S, Q38.S, Q39.S, Q40.S; also elsewhere on the board
LED_SUPPLY: D7.3 (COM), D7.8 (COM), D8.3 (COM), D8.8 (COM); also elsewhere on the board
unnamed: D7.7 (A), R132.1
unnamed: D7.6 (B), R131.1
unnamed: D7.4 (C), R130.1
unnamed: D7.2 (D), R129.1
unnamed: J19.3, R42.1
unnamed: D7.1 (E), R37.1
unnamed: D7.9 (F), R38.1
unnamed: D7.10 (G), R39.1
unnamed: D8.7 (A), R136.1
unnamed: J22.3, R48.1
unnamed: Q32.D, R39.2
unnamed: Q31.D, R130.2, R131.2
unnamed: D8.6 (B), R134.1
unnamed: D8.4 (C), R135.1
unnamed: D8.2 (D), R133.1
unnamed: D8.1 (E), R43.1
unnamed: D8.9 (F), R44.1
unnamed: D8.10 (G), R45.1
unnamed: Q37.D, R45.2
unnamed: Q36.D, R134.2, R135.2
unnamed: Q38.D, R43.2, R44.2, R133.2, R136.2
unnamed: Q33.D, R37.2, R38.2, R129.2, R132.2
ONE_EN_6: J19.2, Q31.G
ONE_EN_7: J22.2, Q36.G
ZERO_EN_6: J21.2, Q33.G
ZERO_EN_7: J24.2, Q38.G

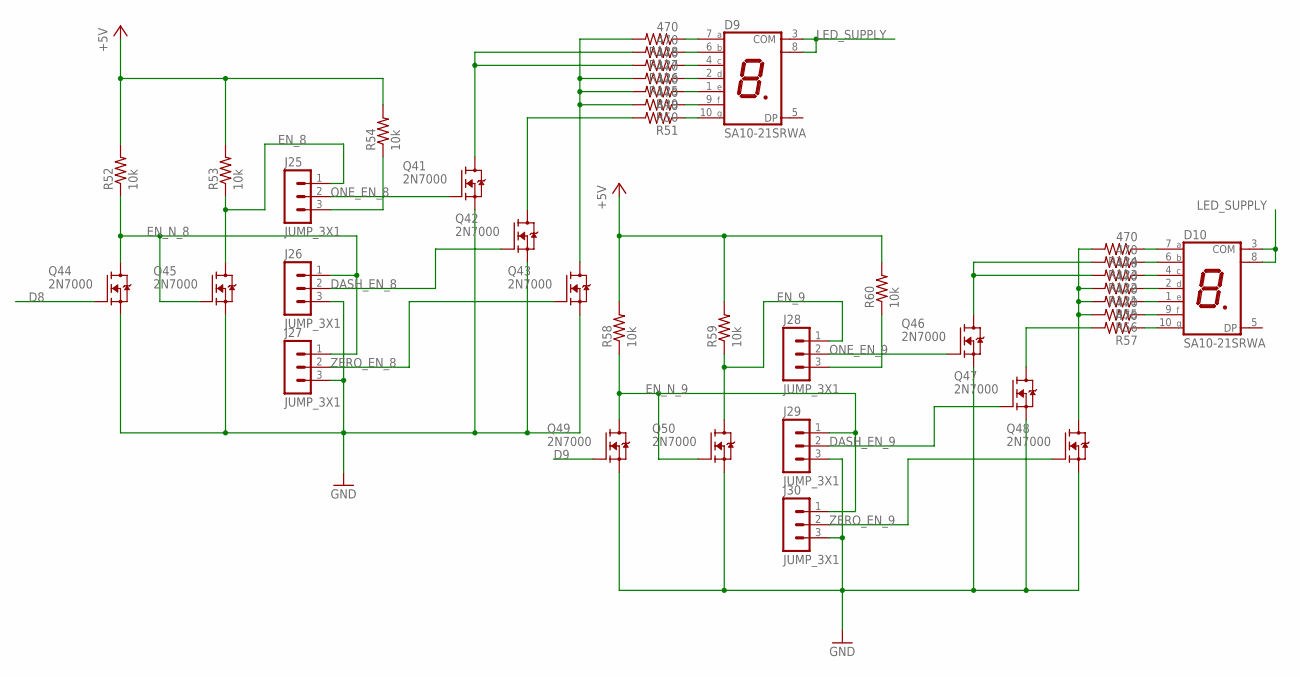
[picture p166: schematic 7SEG_STATUS_1.sch, sheet 5]

Parts:
D9, D10: SA10-21SRWA; SA10
J25, J26, J27, J28, J29, J30: JUMP_3X1
Q41, Q42, Q43, Q44, Q45, Q46, Q47, Q48, Q49, Q50: 2N7000; TO92-DGS
R49, R50, R51, R55, R56, R57, R121, R122, R123, R124, R125, R126, R127, R128: 470; R_P2INCH
R52, R53, R54, R58, R59, R60: 10k; R_P2INCH

Connections:
+5V: R52.2, R53.2, R54.2, R58.2, R59.2, R60.2; also elsewhere on the board
D8: Q44.G; also elsewhere on the board
D9: Q49.G; also elsewhere on the board
DASH_EN_8: J26.2, Q42.G
DASH_EN_9: J29.2, Q47.G
EN_8: J25.1, Q45.D, R53.1
EN_9: J28.1, Q50.D, R59.1
EN_N_8: J26.1, J27.1, Q44.D, Q45.G, R52.1
EN_N_9: J29.1, J30.1, Q49.D, Q50.G, R58.1
GND: J26.3, J27.3, J29.3, J30.3, Q41.S, Q42.S, Q43.S, Q44.S, Q45.S, Q46.S, Q47.S, Q48.S, Q49.S, Q50.S; also elsewhere on the board
LED_SUPPLY: D9.3 (COM), D9.8 (COM), D10.3 (COM), D10.8 (COM); also elsewhere on the board
unnamed: D9.7 (A), R128.1
unnamed: D10.10 (G), R57.1
unnamed: D10.9 (F), R56.1
unnamed: J25.3, R54.1
unnamed: D10.1 (E), R55.1
unnamed: D10.2 (D), R121.1
unnamed: D10.4 (C), R122.1
unnamed: D10.6 (B), R123.1
unnamed: J28.3, R60.1
unnamed: D10.7 (A), R124.1
unnamed: Q47.D, R57.2
unnamed: Q46.D, R122.2, R123.2
unnamed: Q48.D, R55.2, R56.2, R121.2, R124.2
unnamed: D9.6 (B), R127.1
unnamed: D9.4 (C), R126.1
unnamed: D9.2 (D), R125.1
unnamed: D9.1 (E), R49.1
unnamed: D9.9 (F), R50.1
unnamed: D9.10 (G), R51.1
unnamed: Q42.D, R51.2
unnamed: Q41.D, R126.2, R127.2
unnamed: Q43.D, R49.2, R50.2, R125.2, R128.2
ONE_EN_8: J25.2, Q41.G
ONE_EN_9: J28.2, Q46.G
ZERO_EN_8: J27.2, Q43.G
ZERO_EN_9: J30.2, Q48.G

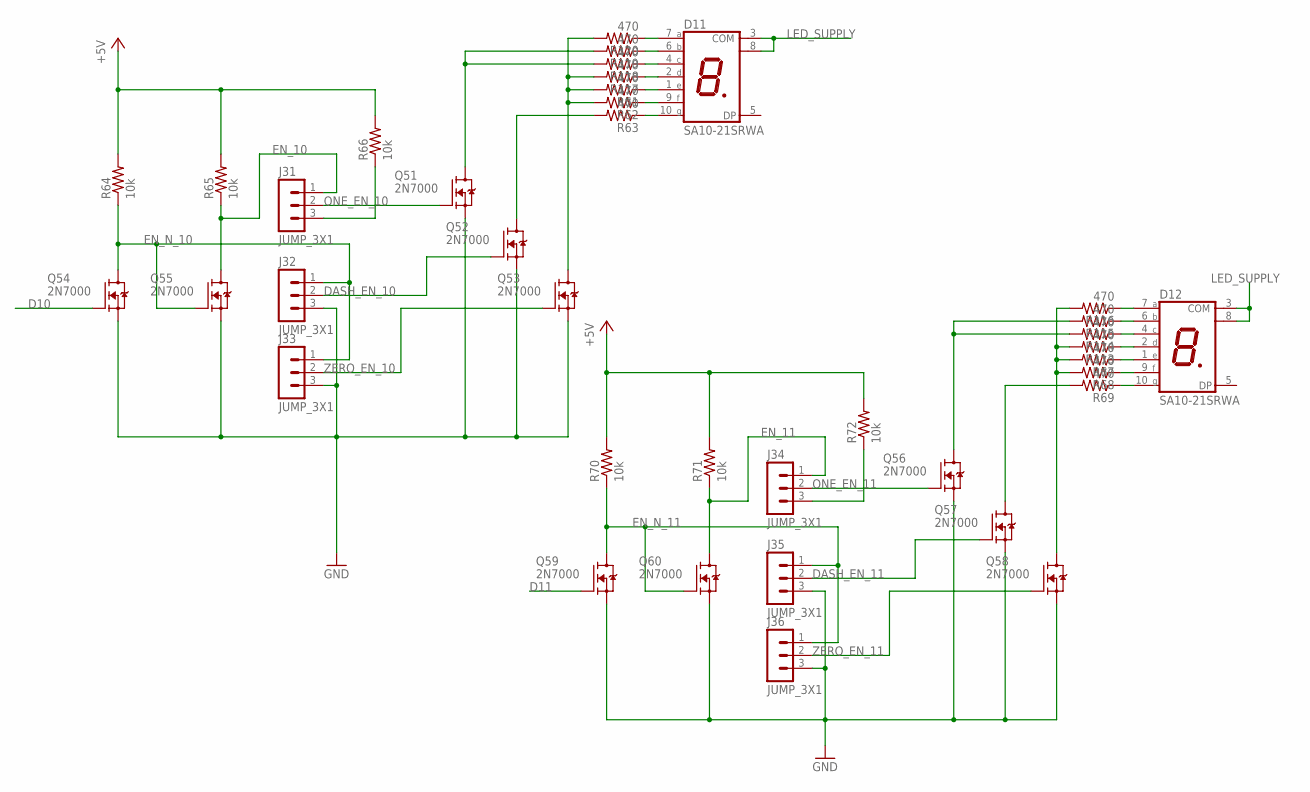
[picture p167: schematic 7SEG_STATUS_1.sch, sheet 6]

Parts:
D11, D12: SA10-21SRWA; SA10
J31, J32, J33, J34, J35, J36: JUMP_3X1
Q51, Q52, Q53, Q54, Q55, Q56, Q57, Q58, Q59, Q60: 2N7000; TO92-DGS
R61, R62, R63, R67, R68, R69, R113, R114, R115, R116, R117, R118, R119, R120: 470; R_P2INCH
R64, R65, R66, R70, R71, R72: 10k; R_P2INCH

Connections:
+5V: R64.2, R65.2, R66.2, R70.2, R71.2, R72.2; also elsewhere on the board
D10: Q54.G; also elsewhere on the board
D11: Q59.G; also elsewhere on the board
DASH_EN_10: J32.2, Q52.G
DASH_EN_11: J35.2, Q57.G
EN_10: J31.1, Q55.D, R65.1
EN_11: J34.1, Q60.D, R71.1
EN_N_10: J32.1, J33.1, Q54.D, Q55.G, R64.1
EN_N_11: J35.1, J36.1, Q59.D, Q60.G, R70.1
GND: J32.3, J33.3, J35.3, J36.3, Q51.S, Q52.S, Q53.S, Q54.S, Q55.S, Q56.S, Q57.S, Q58.S, Q59.S, Q60.S; also elsewhere on the board
LED_SUPPLY: D11.3 (COM), D11.8 (COM), D12.3 (COM), D12.8 (COM); also elsewhere on the board
unnamed: Q52.D, R63.2
unnamed: Q51.D, R118.2, R119.2
unnamed: D11.6 (B), R119.1
unnamed: D12.7 (A), R116.1
unnamed: J31.3, R66.1
unnamed: D12.6 (B), R115.1
unnamed: D12.4 (C), R114.1
unnamed: D12.2 (D), R113.1
unnamed: D11.4 (C), R118.1
unnamed: J34.3, R72.1
unnamed: D12.1 (E), R67.1
unnamed: D12.9 (F), R68.1
unnamed: D12.10 (G), R69.1
unnamed: Q58.D, R67.2, R68.2, R113.2, R116.2
unnamed: Q56.D, R114.2, R115.2
unnamed: Q57.D, R69.2
unnamed: D11.2 (D), R117.1
unnamed: D11.1 (E), R61.1
unnamed: D11.9 (F), R62.1
unnamed: D11.10 (G), R63.1
unnamed: D11.7 (A), R120.1
unnamed: Q53.D, R61.2, R62.2, R117.2, R120.2
ONE_EN_10: J31.2, Q51.G
ONE_EN_11: J34.2, Q56.G
ZERO_EN_10: J33.2, Q53.G
ZERO_EN_11: J36.2, Q58.G

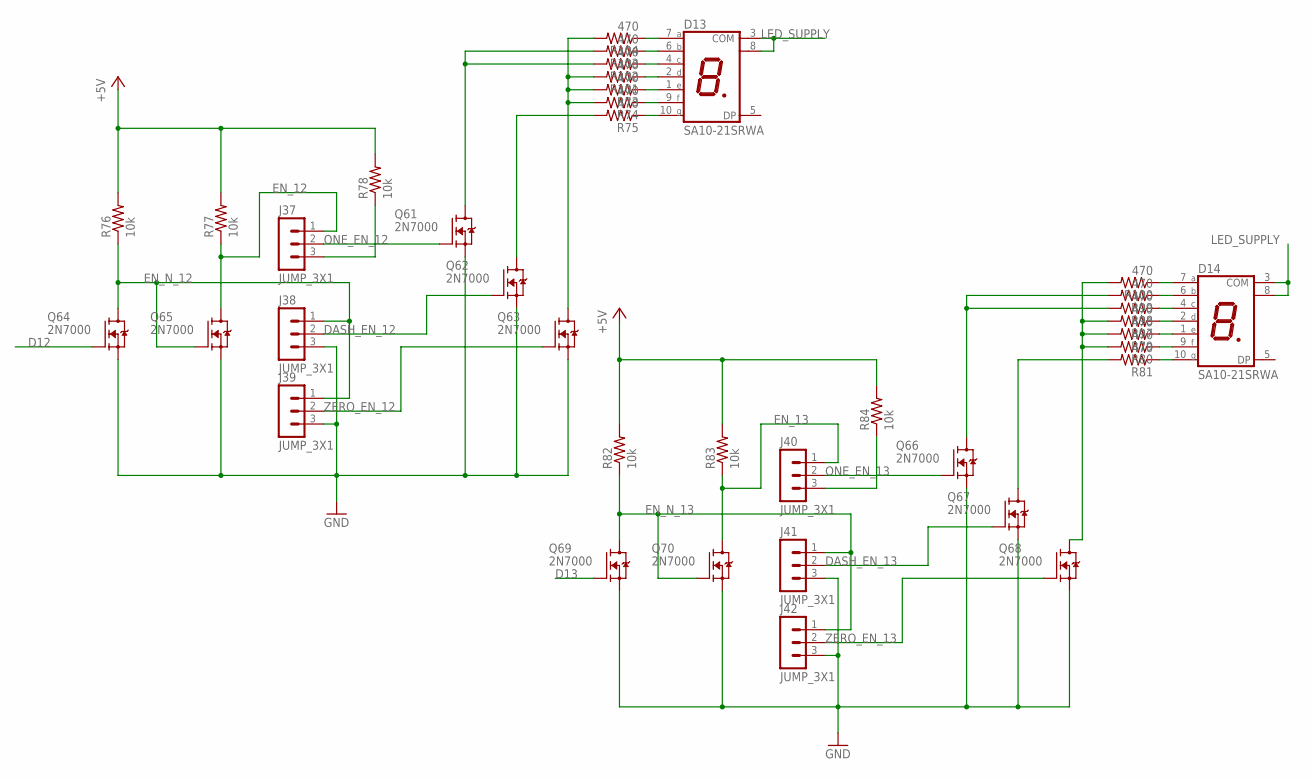
[picture p168: schematic 7SEG_STATUS_1.sch, sheet 7]

Parts:
D13, D14: SA10-21SRWA; SA10
J37, J38, J39, J40, J41, J42: JUMP_3X1
Q61, Q62, Q63, Q64, Q65, Q66, Q67, Q68, Q69, Q70: 2N7000; TO92-DGS
R73, R74, R75, R79, R80, R81, R97, R98, R99, R100, R101, R102, R103, R104: 470; R_P2INCH
R76, R77, R78, R82, R83, R84: 10k; R_P2INCH

Connections:
+5V: R76.2, R77.2, R78.2, R82.2, R83.2, R84.2; also elsewhere on the board
D12: Q64.G; also elsewhere on the board
D13: Q69.G; also elsewhere on the board
DASH_EN_12: J38.2, Q62.G
DASH_EN_13: J41.2, Q67.G
EN_12: J37.1, Q65.D, R77.1
EN_13: J40.1, Q70.D, R83.1
EN_N_12: J38.1, J39.1, Q64.D, Q65.G, R76.1
EN_N_13: J41.1, J42.1, Q69.D, Q70.G, R82.1
GND: J38.3, J39.3, J41.3, J42.3, Q61.S, Q62.S, Q63.S, Q64.S, Q65.S, Q66.S, Q67.S, Q68.S, Q69.S, Q70.S; also elsewhere on the board
LED_SUPPLY: D13.3 (COM), D13.8 (COM), D14.3 (COM), D14.8 (COM); also elsewhere on the board
unnamed: D13.10 (G), R75.1
unnamed: D13.9 (F), R74.1
unnamed: D13.1 (E), R73.1
unnamed: D13.2 (D), R101.1
unnamed: J37.3, R78.1
unnamed: D14.7 (A), R100.1
unnamed: D14.6 (B), R99.1
unnamed: D14.4 (C), R98.1
unnamed: D14.2 (D), R97.1
unnamed: J40.3, R84.1
unnamed: D14.1 (E), R79.1
unnamed: D14.9 (F), R80.1
unnamed: D14.10 (G), R81.1
unnamed: D13.4 (C), R102.1
unnamed: Q66.D, R98.2, R99.2
unnamed: D13.6 (B), R103.1
unnamed: Q67.D, R81.2
unnamed: Q68.D, R79.2, R80.2, R97.2, R100.2
unnamed: D13.7 (A), R104.1
unnamed: Q62.D, R75.2
unnamed: Q61.D, R102.2, R103.2
unnamed: Q63.D, R73.2, R74.2, R101.2, R104.2
ONE_EN_12: J37.2, Q61.G
ONE_EN_13: J40.2, Q66.G
ZERO_EN_12: J39.2, Q63.G
ZERO_EN_13: J42.2, Q68.G

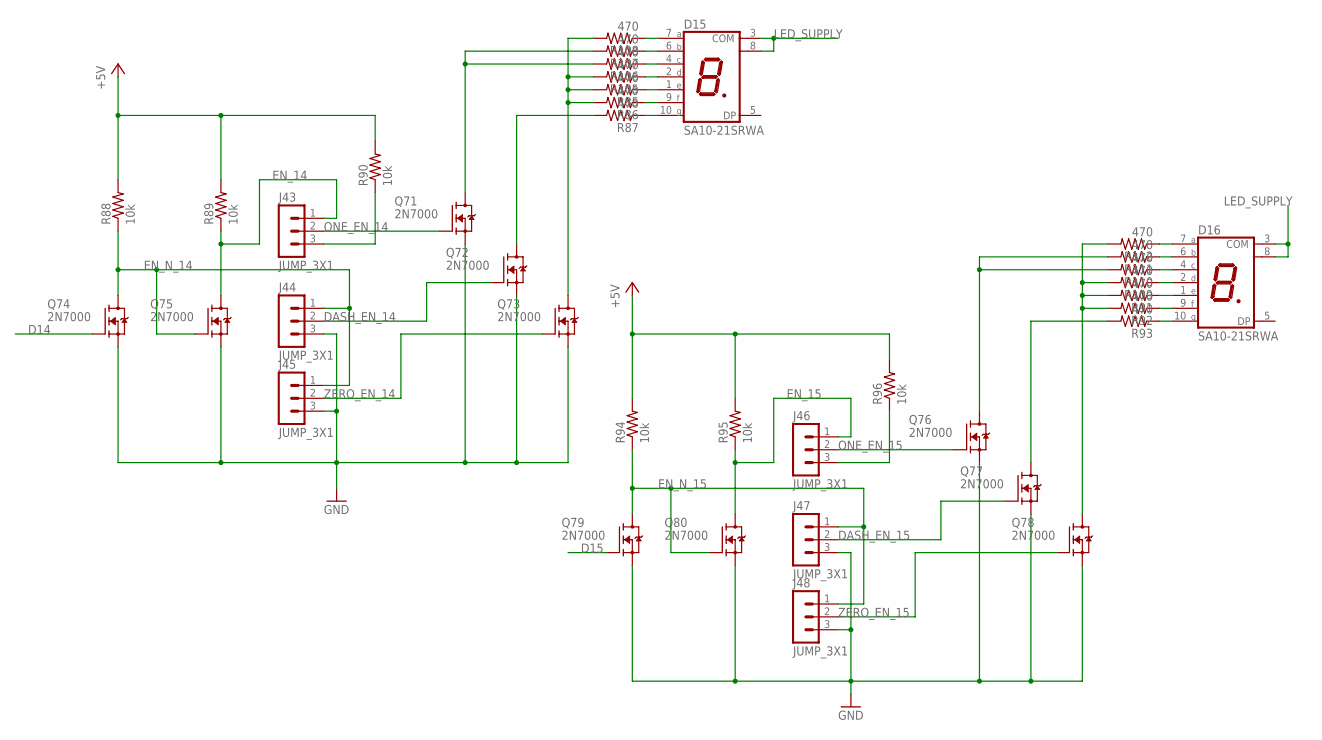
[picture p169: schematic 7SEG_STATUS_1.sch, sheet 8]

Parts:
D15, D16: SA10-21SRWA; SA10
J43, J44, J45, J46, J47, J48: JUMP_3X1
Q71, Q72, Q73, Q74, Q75, Q76, Q77, Q78, Q79, Q80: 2N7000; TO92-DGS
R85, R86, R87, R91, R92, R93, R105, R106, R107, R108, R109, R110, R111, R112: 470; R_P2INCH
R88, R89, R90, R94, R95, R96: 10k; R_P2INCH

Connections:
+5V: R88.2, R89.2, R90.2, R94.2, R95.2, R96.2; also elsewhere on the board
D14: Q74.G; also elsewhere on the board
D15: Q79.G; also elsewhere on the board
DASH_EN_14: J44.2, Q72.G
DASH_EN_15: J47.2, Q77.G
EN_14: J43.1, Q75.D, R89.1
EN_15: J46.1, Q80.D, R95.1
EN_N_14: J44.1, J45.1, Q74.D, Q75.G, R88.1
EN_N_15: J47.1, J48.1, Q79.D, Q80.G, R94.1
GND: J44.3, J45.3, J47.3, J48.3, Q71.S, Q72.S, Q73.S, Q74.S, Q75.S, Q76.S, Q77.S, Q78.S, Q79.S, Q80.S; also elsewhere on the board
LED_SUPPLY: D15.3 (COM), D15.8 (COM), D16.3 (COM), D16.8 (COM); also elsewhere on the board
unnamed: D15.10 (G), R87.1
unnamed: D15.9 (F), R86.1
unnamed: D15.1 (E), R85.1
unnamed: J43.3, R90.1
unnamed: D16.10 (G), R93.1
unnamed: D16.9 (F), R92.1
unnamed: D16.1 (E), R91.1
unnamed: D16.2 (D), R109.1
unnamed: J46.3, R96.1
unnamed: D16.4 (C), R110.1
unnamed: D16.6 (B), R111.1
unnamed: D15.2 (D), R105.1
unnamed: D15.4 (C), R106.1
unnamed: D15.6 (B), R107.1
unnamed: D15.7 (A), R108.1
unnamed: Q72.D, R87.2
unnamed: Q71.D, R106.2, R107.2
unnamed: Q73.D, R85.2, R86.2, R105.2, R108.2
unnamed: D16.7 (A), R112.1
unnamed: Q77.D, R93.2
unnamed: Q76.D, R110.2, R111.2
unnamed: Q78.D, R91.2, R92.2, R109.2, R112.2
ONE_EN_14: J43.2, Q71.G
ONE_EN_15: J46.2, Q76.G
ZERO_EN_14: J45.2, Q73.G
ZERO_EN_15: J48.2, Q78.G

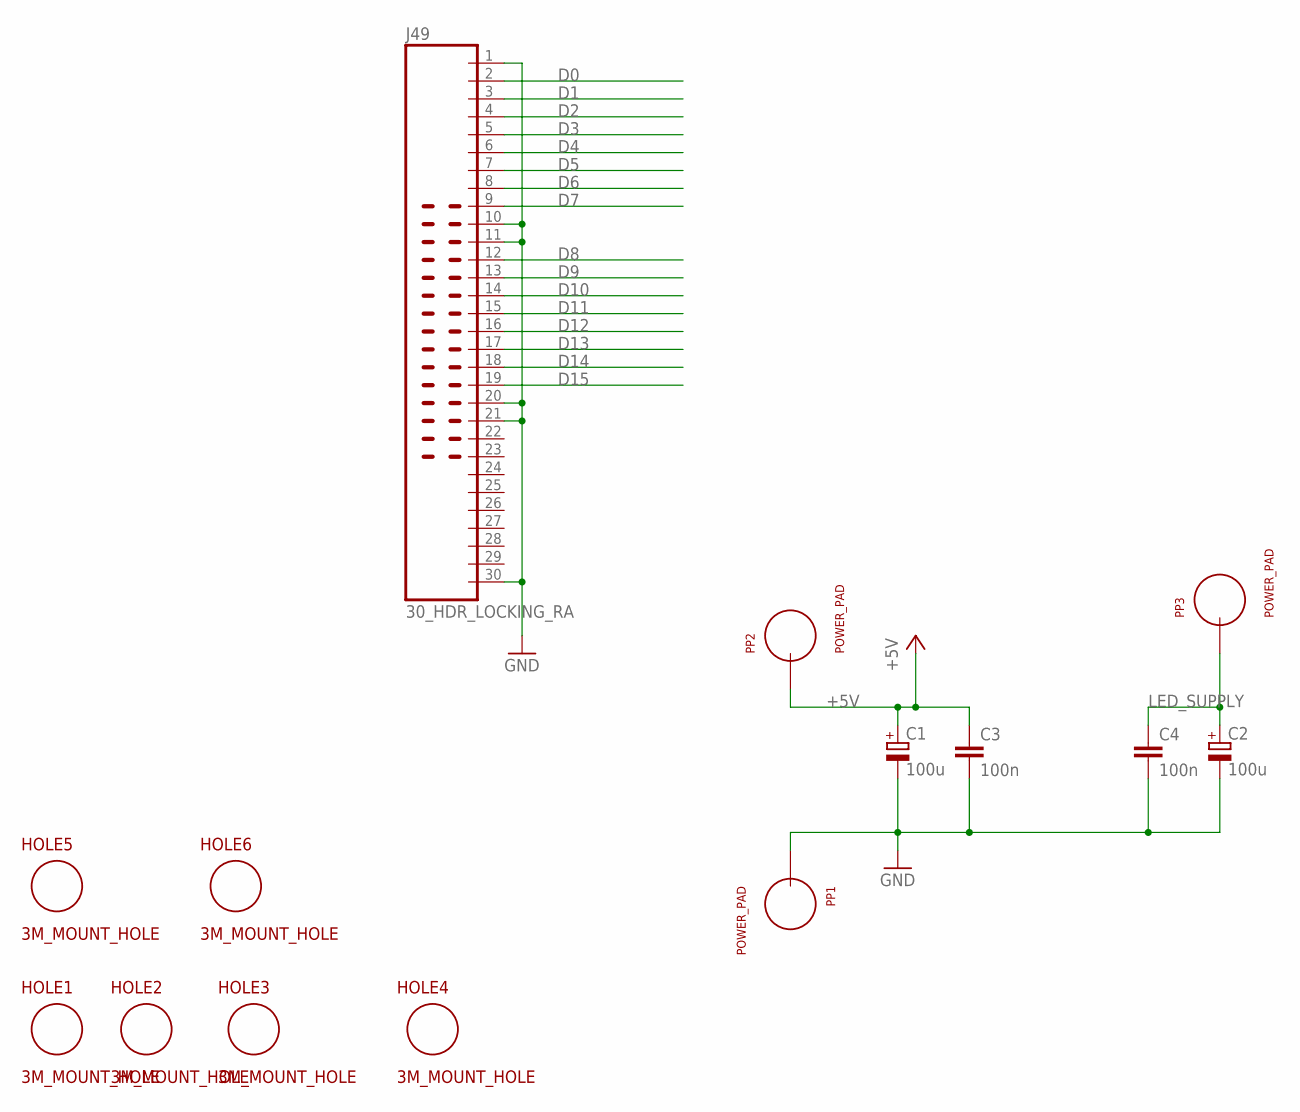
[picture p170: schematic 7SEG_STATUS_1.sch, sheet 9]

Parts:
C1, C2: 100u; POLARISED_CAP_2P5_6P3MM
C3, C4: 100n; CAP_P2INCH
HOLE1, HOLE2, HOLE3, HOLE4, HOLE5, HOLE6: 3M_MOUNT_HOLE; 3M_HOLE
J49: 30_HDR_LOCKING_RA
PP1, PP2, PP3: POWER_PAD

Connections:
+5V: C1.A, C3.1, PP2.1; also elsewhere on the board
D0: J49.2; also elsewhere on the board
D1: J49.3; also elsewhere on the board
D2: J49.4; also elsewhere on the board
D3: J49.5; also elsewhere on the board
D4: J49.6; also elsewhere on the board
D5: J49.7; also elsewhere on the board
D6: J49.8; also elsewhere on the board
D7: J49.9; also elsewhere on the board
D8: J49.12; also elsewhere on the board
D9: J49.13; also elsewhere on the board
D10: J49.14; also elsewhere on the board
D11: J49.15; also elsewhere on the board
D12: J49.16; also elsewhere on the board
D13: J49.17; also elsewhere on the board
D14: J49.18; also elsewhere on the board
D15: J49.19; also elsewhere on the board
GND: C1.K, C2.K, C3.2, C4.2, J49.1, J49.10, J49.11, J49.20, J49.21, J49.30, PP1.1; also elsewhere on the board
LED_SUPPLY: C2.A, C4.1, PP3.1; also elsewhere on the board

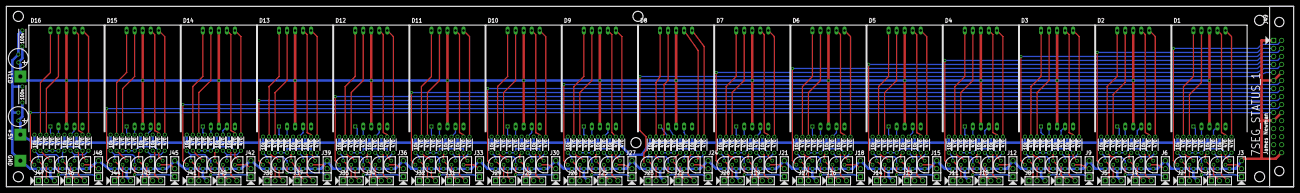
[picture p171: board 7SEG_STATUS_1.brd from above]

Board: 2 copper layers, 407.7 x 57.1 mm, 318 parts (0 on the bottom side), 275 nets.
