ericherman/megaprocessor/bus_4tee/BUS_4TEE_1.brd

## EAGLE design bus_4tee/BUS_4TEE_1.brd (2017-05-20)

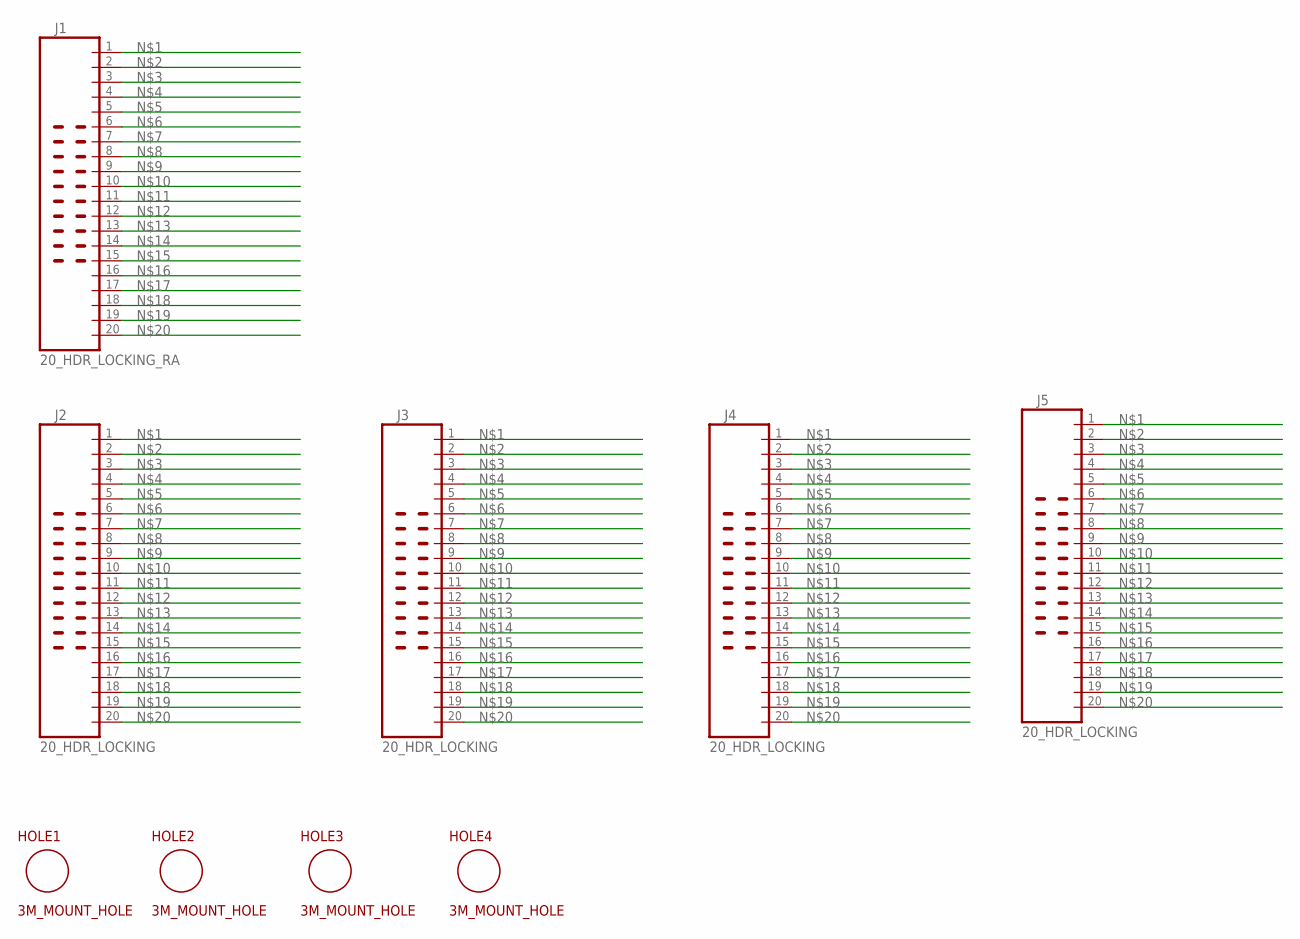
[picture p172: schematic BUS_4TEE_1.sch]

Parts:
HOLE1, HOLE2, HOLE3, HOLE4: 3M_MOUNT_HOLE; 3M_HOLE
J1: 20_HDR_LOCKING_RA
J2, J3, J4, J5: 20_HDR_LOCKING

Connections:
unnamed: J1.1, J2.1, J3.1, J4.1, J5.1
unnamed: J1.2, J2.2, J3.2, J4.2, J5.2
unnamed: J1.3, J2.3, J3.3, J4.3, J5.3
unnamed: J1.4, J2.4, J3.4, J4.4, J5.4
unnamed: J1.5, J2.5, J3.5, J4.5, J5.5
unnamed: J1.6, J2.6, J3.6, J4.6, J5.6
unnamed: J1.7, J2.7, J3.7, J4.7, J5.7
unnamed: J1.8, J2.8, J3.8, J4.8, J5.8
unnamed: J1.9, J2.9, J3.9, J4.9, J5.9
unnamed: J1.10, J2.10, J3.10, J4.10, J5.10
unnamed: J1.11, J2.11, J3.11, J4.11, J5.11
unnamed: J1.12, J2.12, J3.12, J4.12, J5.12
unnamed: J1.13, J2.13, J3.13, J4.13, J5.13
unnamed: J1.14, J2.14, J3.14, J4.14, J5.14
unnamed: J1.15, J2.15, J3.15, J4.15, J5.15
unnamed: J1.16, J2.16, J3.16, J4.16, J5.16
unnamed: J1.17, J2.17, J3.17, J4.17, J5.17
unnamed: J1.18, J2.18, J3.18, J4.18, J5.18
unnamed: J1.19, J2.19, J3.19, J4.19, J5.19
unnamed: J1.20, J2.20, J3.20, J4.20, J5.20

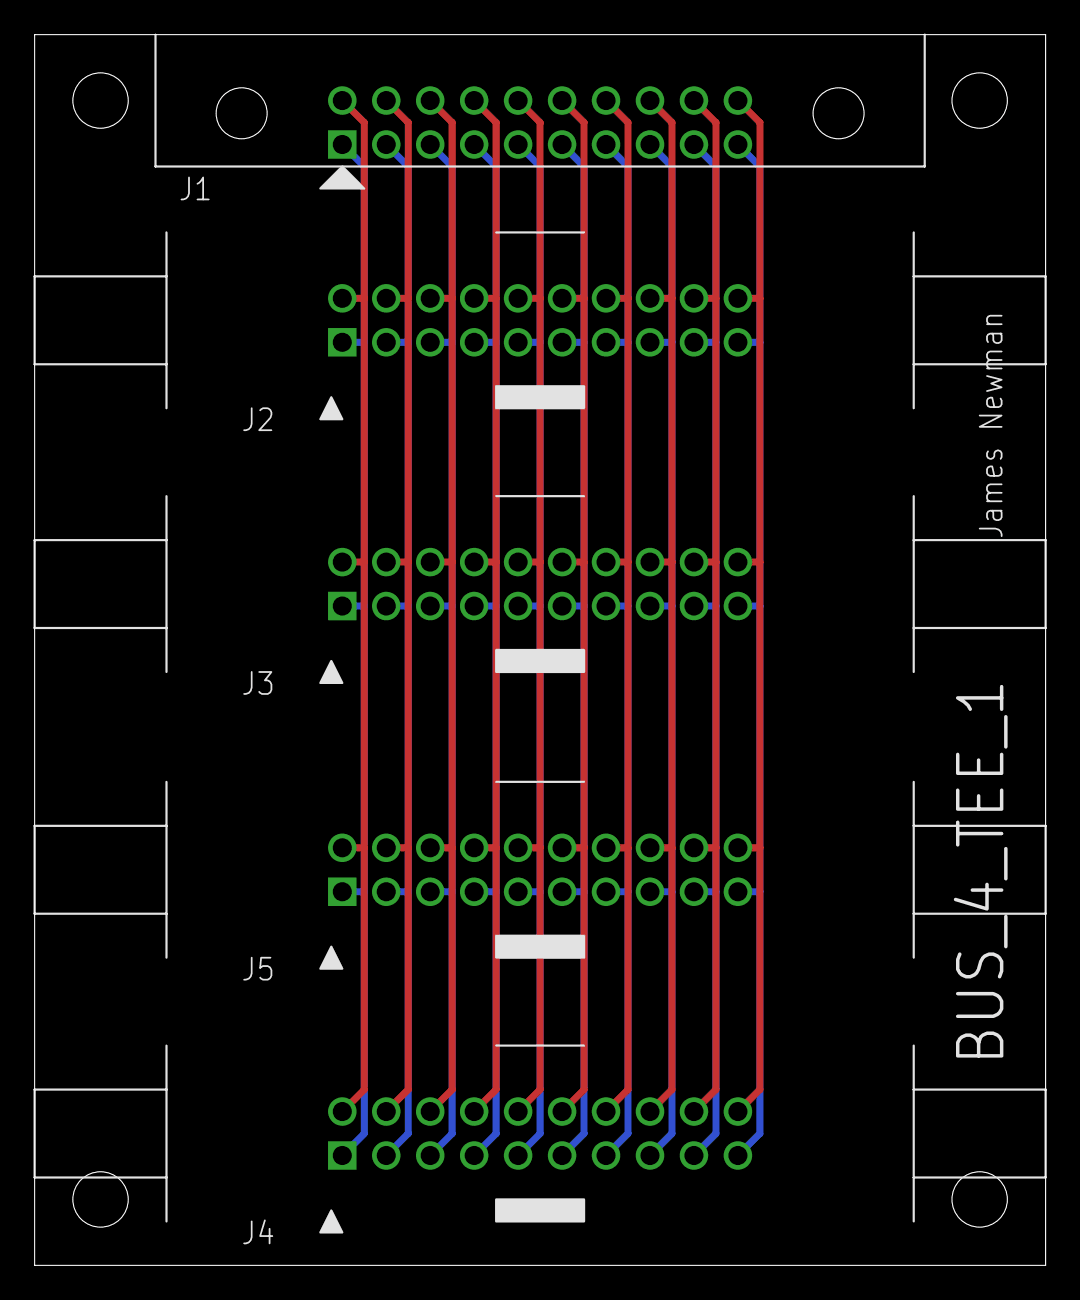
[picture p173: board BUS_4TEE_1.brd from above]

Board: 2 copper layers, 58.4 x 71.1 mm, 9 parts (0 on the bottom side), 20 nets.
