ericherman/megaprocessor/shift_left_right/SHIFT_LEFT_RIGHT_1.brd

## EAGLE design shift_left_right/SHIFT_LEFT_RIGHT_1.brd (2017-05-20)

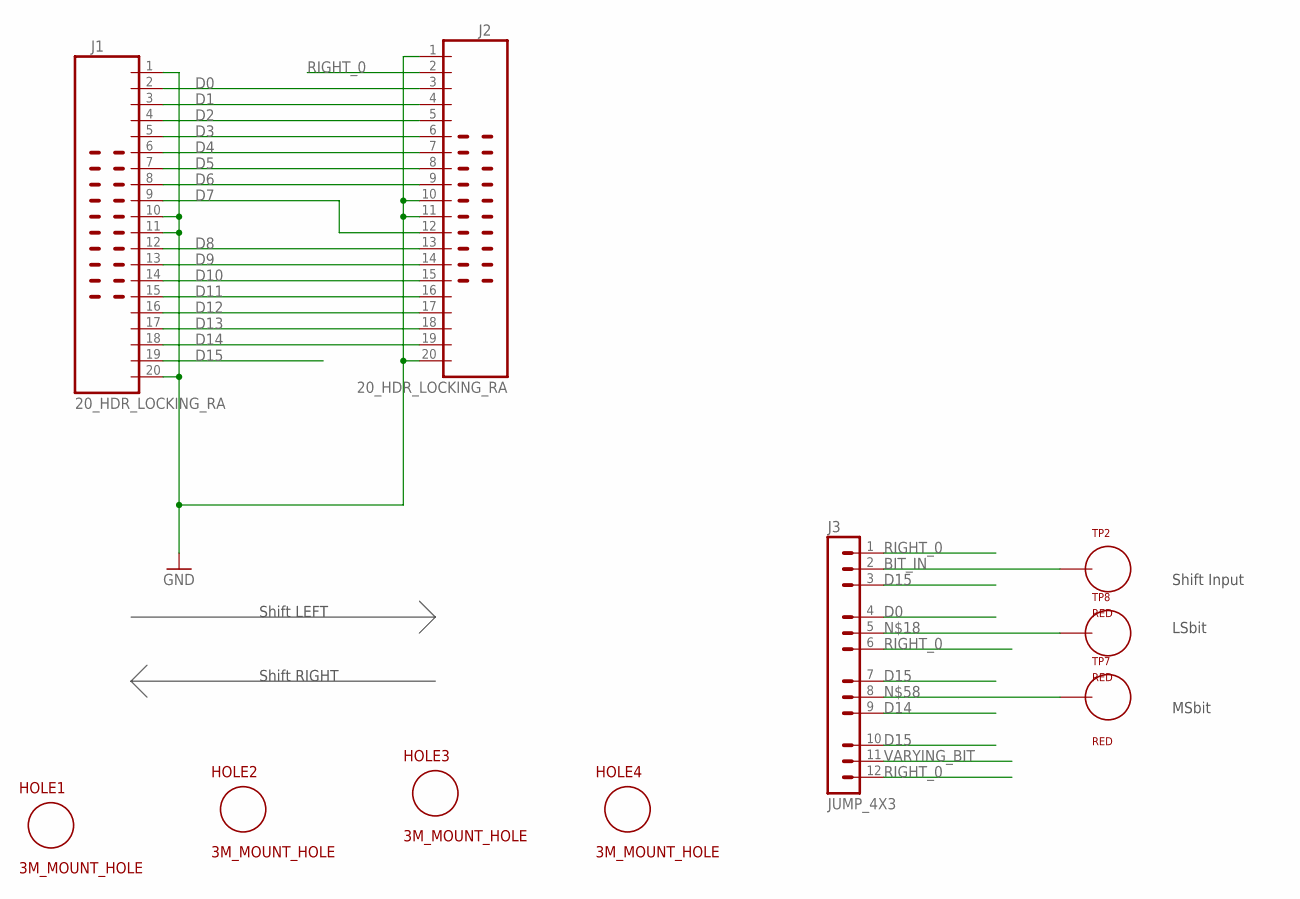
[picture p174: schematic SHIFT_LEFT_RIGHT_1.sch, sheet 1]

Parts:
HOLE1, HOLE2, HOLE3, HOLE4: 3M_MOUNT_HOLE; 3M_HOLE
J1, J2: 20_HDR_LOCKING_RA
J3: JUMP_4X3
TP2, TP7, TP8: RED; TEST_LOOP

Connections:
BIT_IN: J3.2, TP2.P$1; also elsewhere on the board
D0: J1.2, J2.3, J3.4; also elsewhere on the board
D1: J1.3, J2.4; also elsewhere on the board
D2: J1.4, J2.5; also elsewhere on the board
D3: J1.5, J2.6; also elsewhere on the board
D4: J1.6, J2.7; also elsewhere on the board
D5: J1.7, J2.8; also elsewhere on the board
D6: J1.8, J2.9; also elsewhere on the board
D7: J1.9, J2.12; also elsewhere on the board
D8: J1.12, J2.13; also elsewhere on the board
D9: J1.13, J2.14; also elsewhere on the board
D10: J1.14, J2.15; also elsewhere on the board
D11: J1.15, J2.16; also elsewhere on the board
D12: J1.16, J2.17; also elsewhere on the board
D13: J1.17, J2.18; also elsewhere on the board
D14: J1.18, J2.19, J3.9; also elsewhere on the board
D15: J1.19, J3.3, J3.7, J3.10; also elsewhere on the board
GND: J1.1, J1.10, J1.11, J1.20, J2.1, J2.10, J2.11, J2.20; also elsewhere on the board
unnamed: J3.5, TP8.P$1
unnamed: J3.8, TP7.P$1
RIGHT_0: J2.2, J3.1, J3.6, J3.12; also elsewhere on the board
VARYING_BIT: J3.11; also elsewhere on the board

Notes on the sheet:
Shift Input
LSbit
MSbit
Shift LEFT
Shift RIGHT

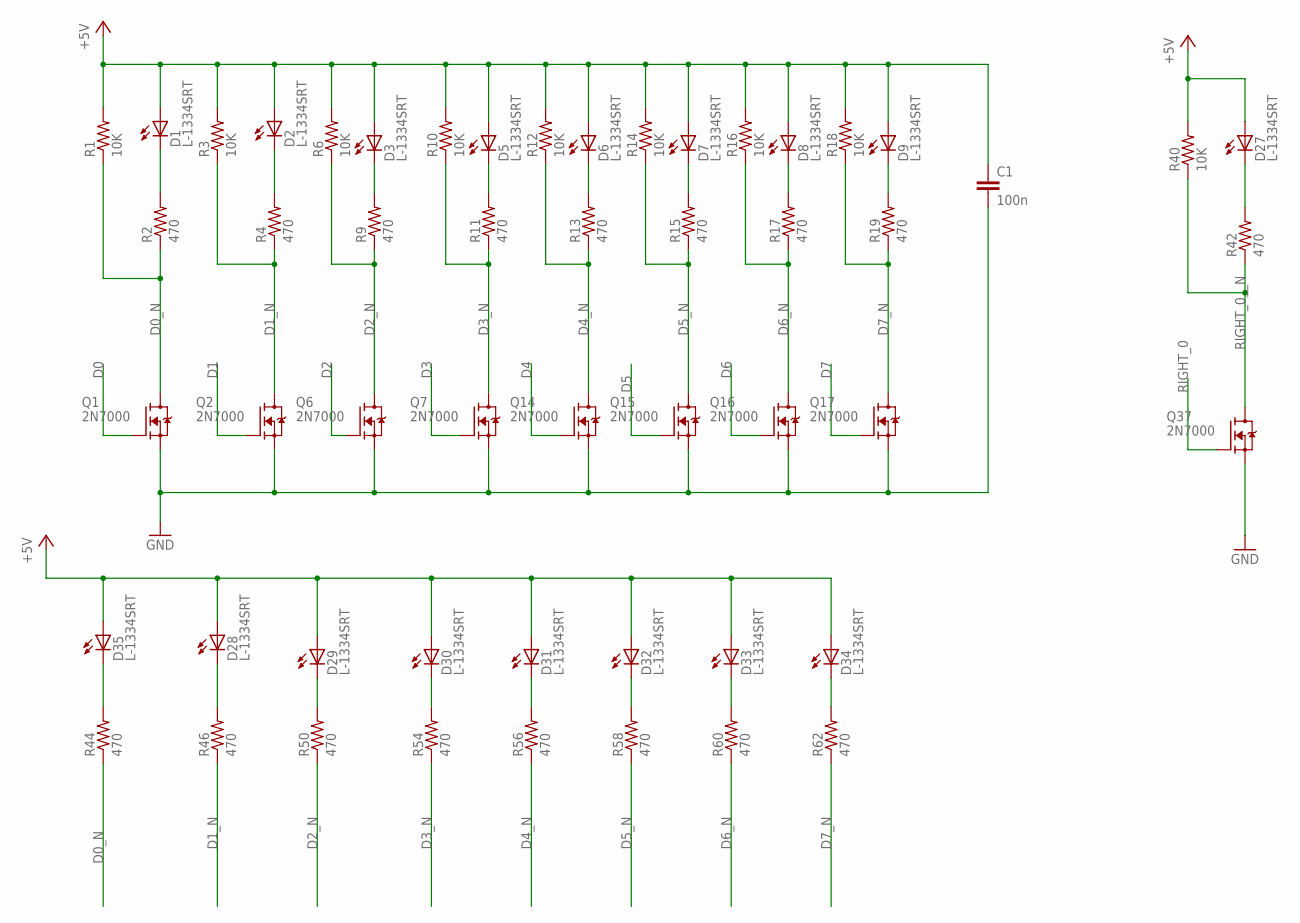
[picture p175: schematic SHIFT_LEFT_RIGHT_1.sch, sheet 2]

Parts:
C1: 100n; CAP_P2INCH
D1, D2, D3, D5, D6, D7, D8, D9, D27, D28, D29, D30, D31, D32, D33, D34, D35: L-1334SRT; LED3MM
Q1, Q2, Q6, Q7, Q14, Q15, Q16, Q17, Q37: 2N7000; TO92-DGS
R1, R3, R6, R10, R12, R14, R16, R18, R40: 10K; R_P2INCH
R2, R4, R9, R11, R13, R15, R17, R19, R42, R44, R46, R50, R54, R56, R58, R60, R62: 470; R_P2INCH

Connections:
+5V: C1.1, D1.A, D2.A, D3.A, D5.A, D6.A, D7.A, D8.A, D9.A, D27.A, D28.A, D29.A, D30.A, D31.A, D32.A, D33.A, D34.A, D35.A, R1.2, R3.2, R6.2, R10.2, R12.2, R14.2, R16.2, R18.2, R40.2; also elsewhere on the board
D0: Q1.G; also elsewhere on the board
D0_N: Q1.D, R1.1, R2.1, R44.1; also elsewhere on the board
D1: Q2.G; also elsewhere on the board
D1_N: Q2.D, R3.1, R4.1, R46.1; also elsewhere on the board
D2: Q6.G; also elsewhere on the board
D2_N: Q6.D, R6.1, R9.1, R50.1; also elsewhere on the board
D3: Q7.G; also elsewhere on the board
D3_N: Q7.D, R10.1, R11.1, R54.1; also elsewhere on the board
D4: Q14.G; also elsewhere on the board
D4_N: Q14.D, R12.1, R13.1, R56.1; also elsewhere on the board
D5: Q15.G; also elsewhere on the board
D5_N: Q15.D, R14.1, R15.1, R58.1; also elsewhere on the board
D6: Q16.G; also elsewhere on the board
D6_N: Q16.D, R16.1, R17.1, R60.1; also elsewhere on the board
D7: Q17.G; also elsewhere on the board
D7_N: Q17.D, R18.1, R19.1, R62.1; also elsewhere on the board
GND: C1.2, Q1.S, Q2.S, Q6.S, Q7.S, Q14.S, Q15.S, Q16.S, Q17.S, Q37.S; also elsewhere on the board
unnamed: D2.K (C), R4.2
unnamed: D1.K (C), R2.2
unnamed: D28.K (C), R46.2
unnamed: D5.K (C), R11.2
unnamed: D3.K (C), R9.2
unnamed: D27.K (C), R42.2
unnamed: D30.K (C), R54.2
unnamed: D29.K (C), R50.2
unnamed: D6.K (C), R13.2
unnamed: D7.K (C), R15.2
unnamed: D8.K (C), R17.2
unnamed: D9.K (C), R19.2
unnamed: D31.K (C), R56.2
unnamed: D32.K (C), R58.2
unnamed: D33.K (C), R60.2
unnamed: D34.K (C), R62.2
unnamed: D35.K (C), R44.2
RIGHT_0: Q37.G; also elsewhere on the board
RIGHT_0__N: Q37.D, R40.1, R42.1

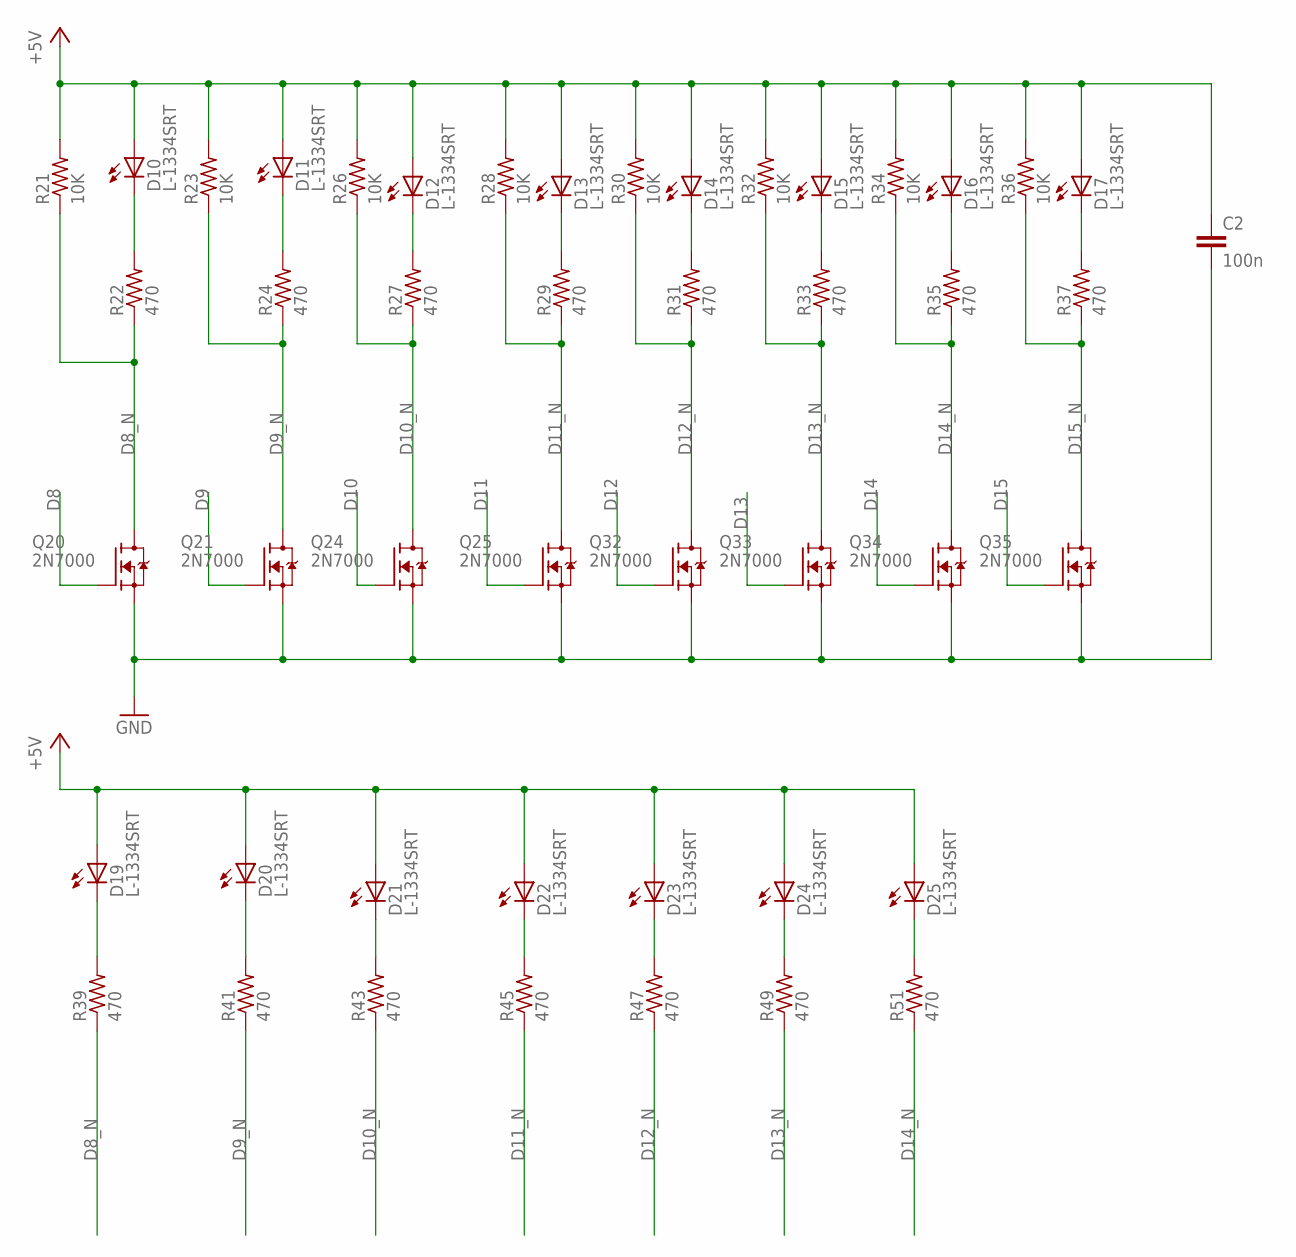
[picture p176: schematic SHIFT_LEFT_RIGHT_1.sch, sheet 3]

Parts:
C2: 100n; CAP_P2INCH
D10, D11, D12, D13, D14, D15, D16, D17, D19, D20, D21, D22, D23, D24, D25: L-1334SRT; LED3MM
Q20, Q21, Q24, Q25, Q32, Q33, Q34, Q35: 2N7000; TO92-DGS
R21, R23, R26, R28, R30, R32, R34, R36: 10K; R_P2INCH
R22, R24, R27, R29, R31, R33, R35, R37, R39, R41, R43, R45, R47, R49, R51: 470; R_P2INCH

Connections:
+5V: C2.1, D10.A, D11.A, D12.A, D13.A, D14.A, D15.A, D16.A, D17.A, D19.A, D20.A, D21.A, D22.A, D23.A, D24.A, D25.A, R21.2, R23.2, R26.2, R28.2, R30.2, R32.2, R34.2, R36.2; also elsewhere on the board
D8: Q20.G; also elsewhere on the board
D8_N: Q20.D, R21.1, R22.1, R39.1; also elsewhere on the board
D9: Q21.G; also elsewhere on the board
D9_N: Q21.D, R23.1, R24.1, R41.1; also elsewhere on the board
D10: Q24.G; also elsewhere on the board
D10_N: Q24.D, R26.1, R27.1, R43.1; also elsewhere on the board
D11: Q25.G; also elsewhere on the board
D11_N: Q25.D, R28.1, R29.1, R45.1; also elsewhere on the board
D12: Q32.G; also elsewhere on the board
D12_N: Q32.D, R30.1, R31.1, R47.1; also elsewhere on the board
D13: Q33.G; also elsewhere on the board
D13_N: Q33.D, R32.1, R33.1, R49.1; also elsewhere on the board
D14: Q34.G; also elsewhere on the board
D14_N: Q34.D, R34.1, R35.1, R51.1; also elsewhere on the board
D15: Q35.G; also elsewhere on the board
D15_N: Q35.D, R36.1, R37.1
GND: C2.2, Q20.S, Q21.S, Q24.S, Q25.S, Q32.S, Q33.S, Q34.S, Q35.S; also elsewhere on the board
unnamed: D11.K (C), R24.2
unnamed: D10.K (C), R22.2
unnamed: D20.K (C), R41.2
unnamed: D13.K (C), R29.2
unnamed: D12.K (C), R27.2
unnamed: D19.K (C), R39.2
unnamed: D22.K (C), R45.2
unnamed: D21.K (C), R43.2
unnamed: D14.K (C), R31.2
unnamed: D15.K (C), R33.2
unnamed: D16.K (C), R35.2
unnamed: D17.K (C), R37.2
unnamed: D23.K (C), R47.2
unnamed: D24.K (C), R49.2
unnamed: D25.K (C), R51.2

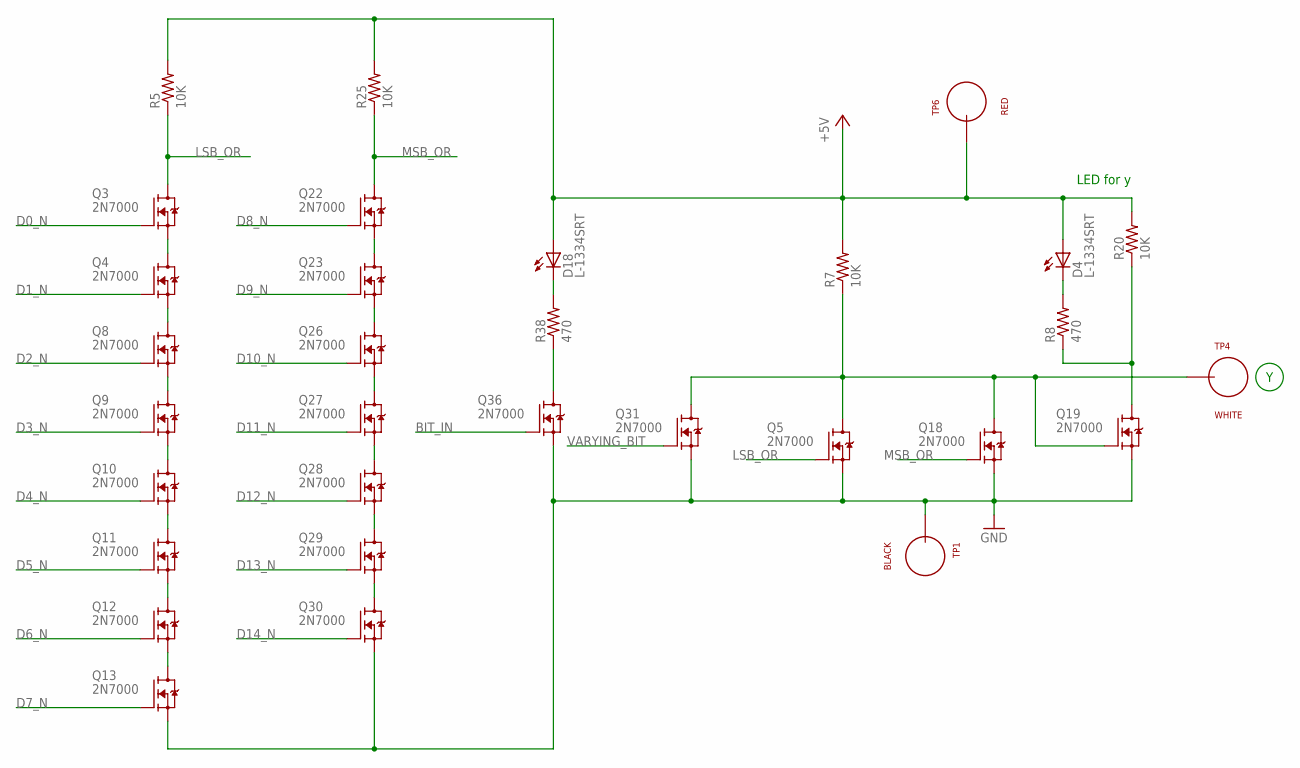
[picture p177: schematic SHIFT_LEFT_RIGHT_1.sch, sheet 4]

Parts:
D4, D18: L-1334SRT; LED3MM
Q3, Q4, Q5, Q8, Q9, Q10, Q11, Q12, Q13, Q18, Q19, Q22, Q23, Q26, Q27, Q28, Q29, Q30, Q31, Q36: 2N7000; TO92-DGS
R5, R7, R20, R25: 10K; R_P2INCH
R8, R38: 470; R_P2INCH
TP1: BLACK; TEST_LOOP
TP4: WHITE; TEST_LOOP
TP6: RED; TEST_LOOP

Connections:
+5V: D4.A, D18.A, R5.2, R7.2, R20.2, R25.2, TP6.P$1; also elsewhere on the board
BIT_IN: Q36.G; also elsewhere on the board
D0_N: Q3.G; also elsewhere on the board
D1_N: Q4.G; also elsewhere on the board
D2_N: Q8.G; also elsewhere on the board
D3_N: Q9.G; also elsewhere on the board
D4_N: Q10.G; also elsewhere on the board
D5_N: Q11.G; also elsewhere on the board
D6_N: Q12.G; also elsewhere on the board
D7_N: Q13.G; also elsewhere on the board
D8_N: Q22.G; also elsewhere on the board
D9_N: Q23.G; also elsewhere on the board
D10_N: Q26.G; also elsewhere on the board
D11_N: Q27.G; also elsewhere on the board
D12_N: Q28.G; also elsewhere on the board
D13_N: Q29.G; also elsewhere on the board
D14_N: Q30.G; also elsewhere on the board
GND: Q5.S, Q13.S, Q18.S, Q19.S, Q30.S, Q31.S, Q36.S, TP1.P$1; also elsewhere on the board
LSB_OR: Q3.D, Q5.G, R5.1
MSB_OR: Q18.G, Q22.D, R25.1
unnamed: Q19.D, R8.1, R20.1
unnamed: Q22.S, Q23.D
unnamed: Q23.S, Q26.D
unnamed: Q26.S, Q27.D
unnamed: D4.K (C), R8.2
unnamed: Q5.D, Q18.D, Q19.G, Q31.D, R7.1, TP4.P$1
unnamed: Q3.S, Q4.D
unnamed: Q4.S, Q8.D
unnamed: Q8.S, Q9.D
unnamed: Q9.S, Q10.D
unnamed: Q10.S, Q11.D
unnamed: Q11.S, Q12.D
unnamed: Q12.S, Q13.D
unnamed: Q27.S, Q28.D
unnamed: Q28.S, Q29.D
unnamed: Q29.S, Q30.D
unnamed: D18.K (C), R38.2
unnamed: Q36.D, R38.1
VARYING_BIT: Q31.G; also elsewhere on the board

Notes on the sheet:
LED for y

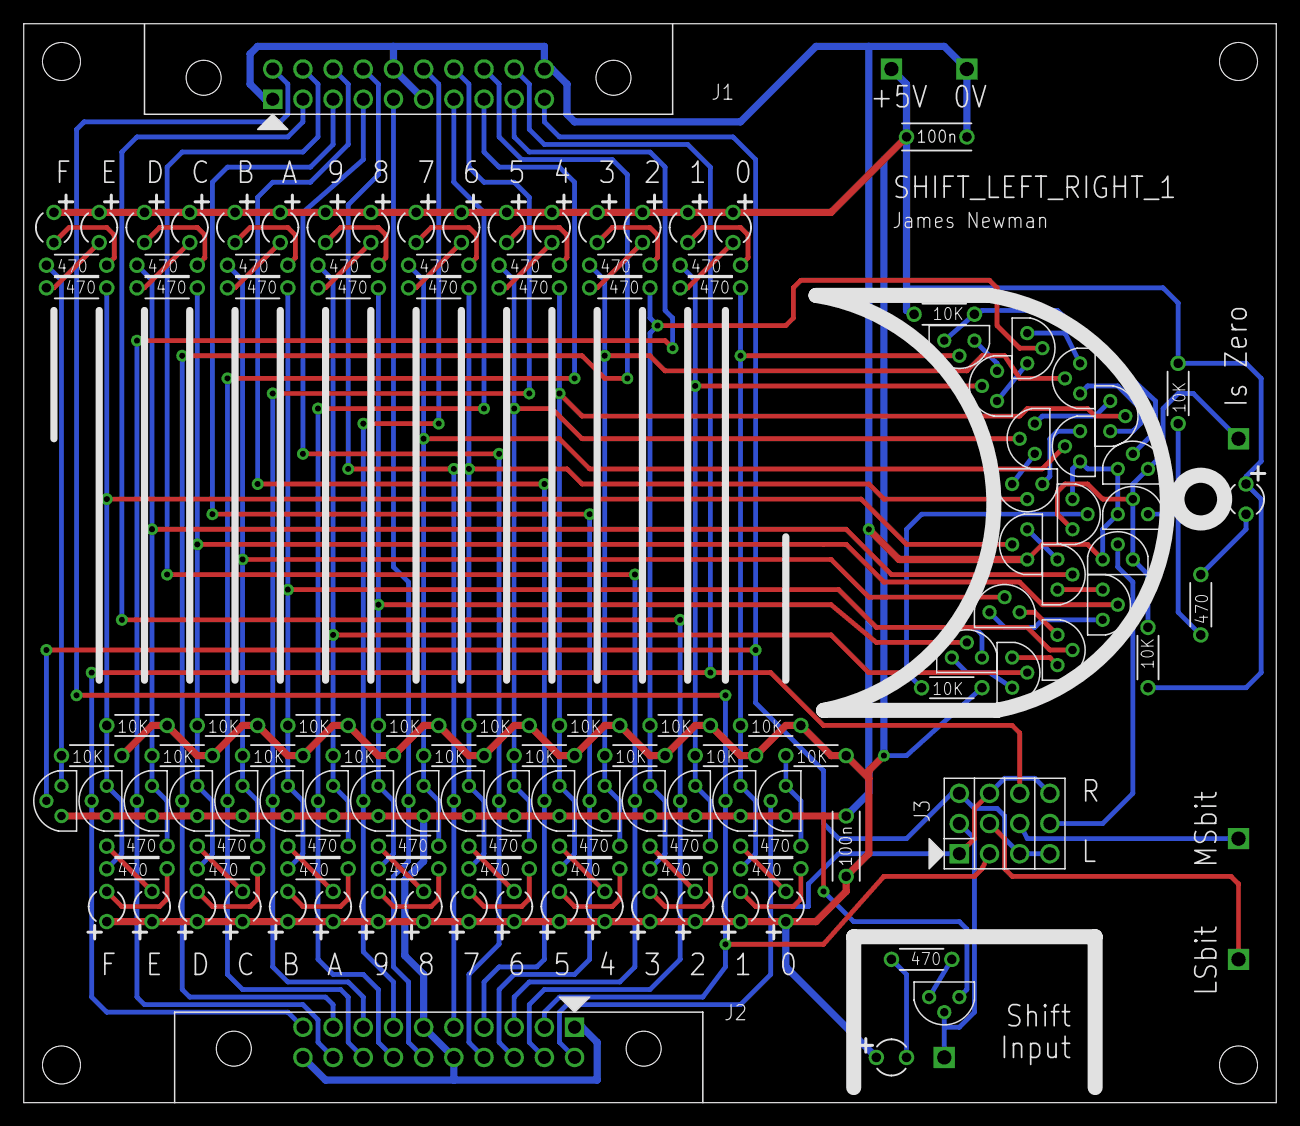
[picture p178: board SHIFT_LEFT_RIGHT_1.brd from above]

Board: 2 copper layers, 105.4 x 90.8 mm, 141 parts (0 on the bottom side), 92 nets.
