ericherman/megaprocessor/module_artwork_decoding_a/module_decoding_a.brd

## EAGLE design module_artwork_decoding_a/module_decoding_a.brd (2017-05-20)

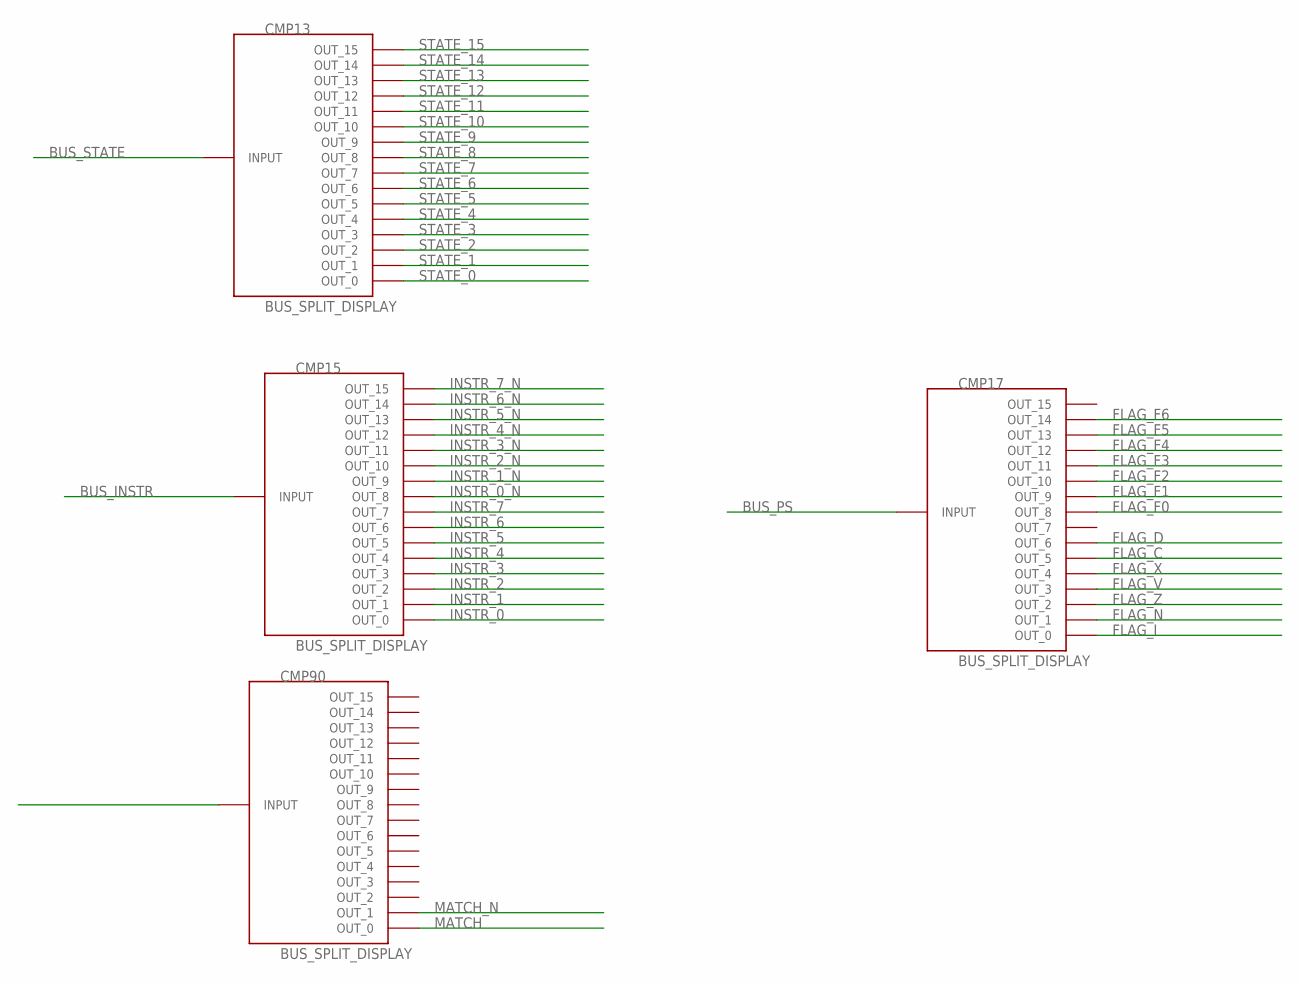
[picture p179: schematic module_decoding_a.sch, sheet 1]

Parts:
CMP13, CMP15, CMP17, CMP90: BUS_SPLIT_DISPLAY

Connections:
BUS_INSTR: CMP15.INPUT
BUS_PS: CMP17.INPUT
BUS_STATE: CMP13.INPUT
FLAG_C: CMP17.P$6 (OUT_5)
FLAG_D: CMP17.P$7 (OUT_6)
FLAG_F0: CMP17.P$9 (OUT_8)
FLAG_F1: CMP17.P$10 (OUT_9)
FLAG_F2: CMP17.P$11 (OUT_10); also elsewhere on the board
FLAG_F3: CMP17.P$12 (OUT_11)
FLAG_F4: CMP17.P$13 (OUT_12); also elsewhere on the board
FLAG_F5: CMP17.P$14 (OUT_13); also elsewhere on the board
FLAG_F6: CMP17.P$15 (OUT_14)
FLAG_I: CMP17.P$1 (OUT_0)
FLAG_N: CMP17.P$2 (OUT_1)
FLAG_V: CMP17.P$4 (OUT_3)
FLAG_X: CMP17.P$5 (OUT_4)
FLAG_Z: CMP17.P$3 (OUT_2)
INSTR_0: CMP15.P$1 (OUT_0); also elsewhere on the board
INSTR_0_N: CMP15.P$9 (OUT_8); also elsewhere on the board
INSTR_1: CMP15.P$2 (OUT_1)
INSTR_1_N: CMP15.P$10 (OUT_9)
INSTR_2: CMP15.P$3 (OUT_2); also elsewhere on the board
INSTR_2_N: CMP15.P$11 (OUT_10); also elsewhere on the board
INSTR_3: CMP15.P$4 (OUT_3); also elsewhere on the board
INSTR_3_N: CMP15.P$12 (OUT_11)
INSTR_4: CMP15.P$5 (OUT_4)
INSTR_4_N: CMP15.P$13 (OUT_12)
INSTR_5: CMP15.P$6 (OUT_5)
INSTR_5_N: CMP15.P$14 (OUT_13)
INSTR_6: CMP15.P$7 (OUT_6)
INSTR_6_N: CMP15.P$15 (OUT_14)
INSTR_7: CMP15.P$8 (OUT_7)
INSTR_7_N: CMP15.P$16 (OUT_15)
MATCH: CMP90.P$1 (OUT_0); also elsewhere on the board
MATCH_N: CMP90.P$2 (OUT_1); also elsewhere on the board
STATE_0: CMP13.P$1 (OUT_0); also elsewhere on the board
STATE_1: CMP13.P$2 (OUT_1); also elsewhere on the board
STATE_2: CMP13.P$3 (OUT_2); also elsewhere on the board
STATE_3: CMP13.P$4 (OUT_3)
STATE_4: CMP13.P$5 (OUT_4)
STATE_5: CMP13.P$6 (OUT_5)
STATE_6: CMP13.P$7 (OUT_6); also elsewhere on the board
STATE_7: CMP13.P$8 (OUT_7); also elsewhere on the board
STATE_8: CMP13.P$9 (OUT_8)
STATE_9: CMP13.P$10 (OUT_9)
STATE_10: CMP13.P$11 (OUT_10)
STATE_11: CMP13.P$12 (OUT_11)
STATE_12: CMP13.P$13 (OUT_12)
STATE_13: CMP13.P$14 (OUT_13)
STATE_14: CMP13.P$15 (OUT_14)
STATE_15: CMP13.P$16 (OUT_15); also elsewhere on the board

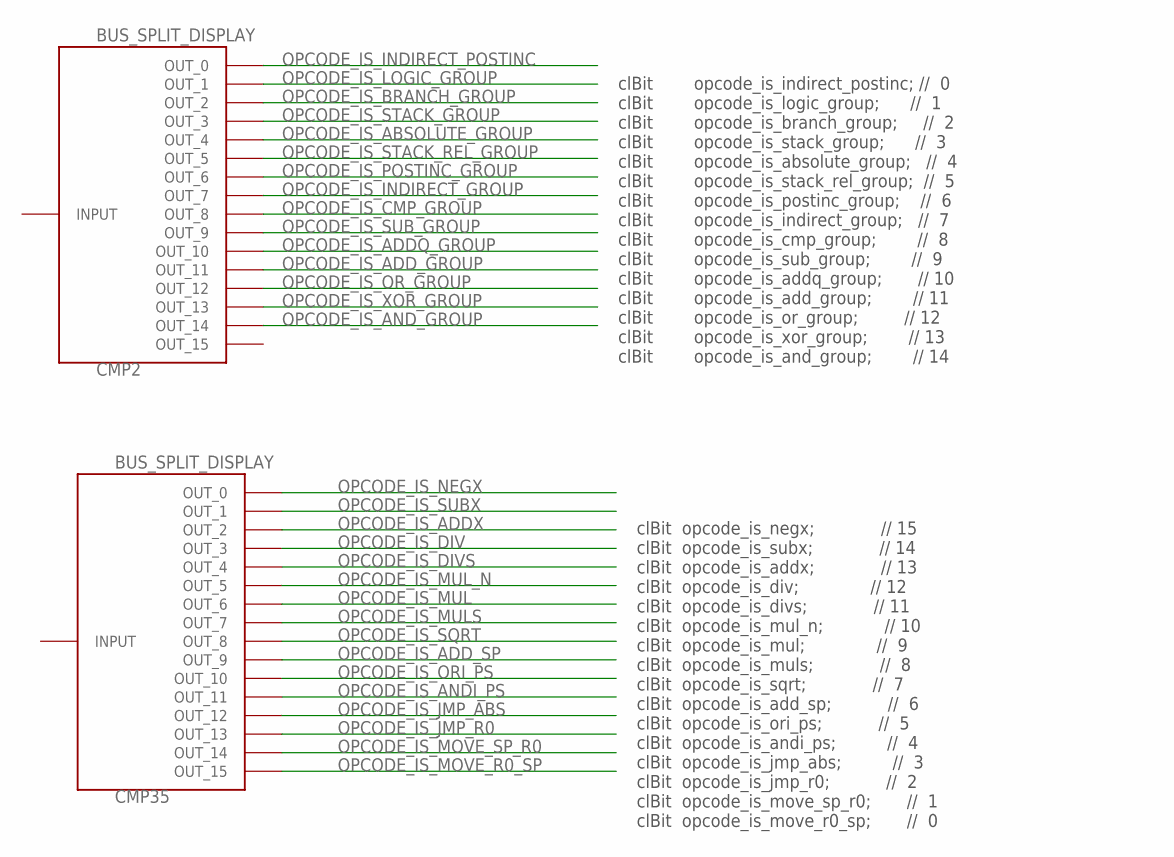
[picture p180: schematic module_decoding_a.sch, sheet 2]

Parts:
CMP2, CMP35: BUS_SPLIT_DISPLAY

Connections:
OPCODE_IS_ABSOLUTE_GROUP: CMP2.P$5 (OUT_4); also elsewhere on the board
OPCODE_IS_ADDQ_GROUP: CMP2.P$11 (OUT_10)
OPCODE_IS_ADDX: CMP35.P$3 (OUT_2)
OPCODE_IS_ADD_GROUP: CMP2.P$12 (OUT_11)
OPCODE_IS_ADD_SP: CMP35.P$10 (OUT_9); also elsewhere on the board
OPCODE_IS_ANDI_PS: CMP35.P$12 (OUT_11); also elsewhere on the board
OPCODE_IS_AND_GROUP: CMP2.P$15 (OUT_14)
OPCODE_IS_BRANCH_GROUP: CMP2.P$3 (OUT_2); also elsewhere on the board
OPCODE_IS_CMP_GROUP: CMP2.P$9 (OUT_8)
OPCODE_IS_DIV: CMP35.P$4 (OUT_3); also elsewhere on the board
OPCODE_IS_DIVS: CMP35.P$5 (OUT_4)
OPCODE_IS_INDIRECT_GROUP: CMP2.P$8 (OUT_7)
OPCODE_IS_INDIRECT_POSTINC: CMP2.P$1 (OUT_0); also elsewhere on the board
OPCODE_IS_JMP_ABS: CMP35.P$13 (OUT_12); also elsewhere on the board
OPCODE_IS_JMP_R0: CMP35.P$14 (OUT_13); also elsewhere on the board
OPCODE_IS_LOGIC_GROUP: CMP2.P$2 (OUT_1)
OPCODE_IS_MOVE_R0_SP: CMP35.P$16 (OUT_15); also elsewhere on the board
OPCODE_IS_MOVE_SP_R0: CMP35.P$15 (OUT_14); also elsewhere on the board
OPCODE_IS_MUL: CMP35.P$7 (OUT_6); also elsewhere on the board
OPCODE_IS_MULS: CMP35.P$8 (OUT_7)
OPCODE_IS_MUL_N: CMP35.P$6 (OUT_5)
OPCODE_IS_NEGX: CMP35.P$1 (OUT_0)
OPCODE_IS_ORI_PS: CMP35.P$11 (OUT_10); also elsewhere on the board
OPCODE_IS_OR_GROUP: CMP2.P$13 (OUT_12)
OPCODE_IS_POSTINC_GROUP: CMP2.P$7 (OUT_6)
OPCODE_IS_SQRT: CMP35.P$9 (OUT_8); also elsewhere on the board
OPCODE_IS_STACK_GROUP: CMP2.P$4 (OUT_3); also elsewhere on the board
OPCODE_IS_STACK_REL_GROUP: CMP2.P$6 (OUT_5); also elsewhere on the board
OPCODE_IS_SUBX: CMP35.P$2 (OUT_1)
OPCODE_IS_SUB_GROUP: CMP2.P$10 (OUT_9)
OPCODE_IS_XOR_GROUP: CMP2.P$14 (OUT_13)

Notes on the sheet:
clBit opcode_is_indirect_postinc; // 0 clBit opcode_is_logic_group; // 1 clBit opcode_is_branch_group; // 2 clBit opcode_is_stack_group; // 3 clBit opcode_is_absolute_group; // 4 clBit opcode_is_stack_rel_group; // 5 clBit opcode_is_postinc_group; // 6 clBit opcode_is_indirect_group; // 7 clBit opc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
clBit opcode_is_negx; // 15 clBit opcode_is_subx; // 14 clBit opcode_is_addx; // 13 clBit opcode_is_div; // 12 clBit opcode_is_divs; // 11 clBit opcode_is_mul_n; // 10 clBit opcode_is_mul; // 9 clBit opcode_is_muls; // 8 clBit opcode_is_sqrt; // 7 clBit opcode_is_add_sp; // 6 clBit opcode_is_ori_ps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

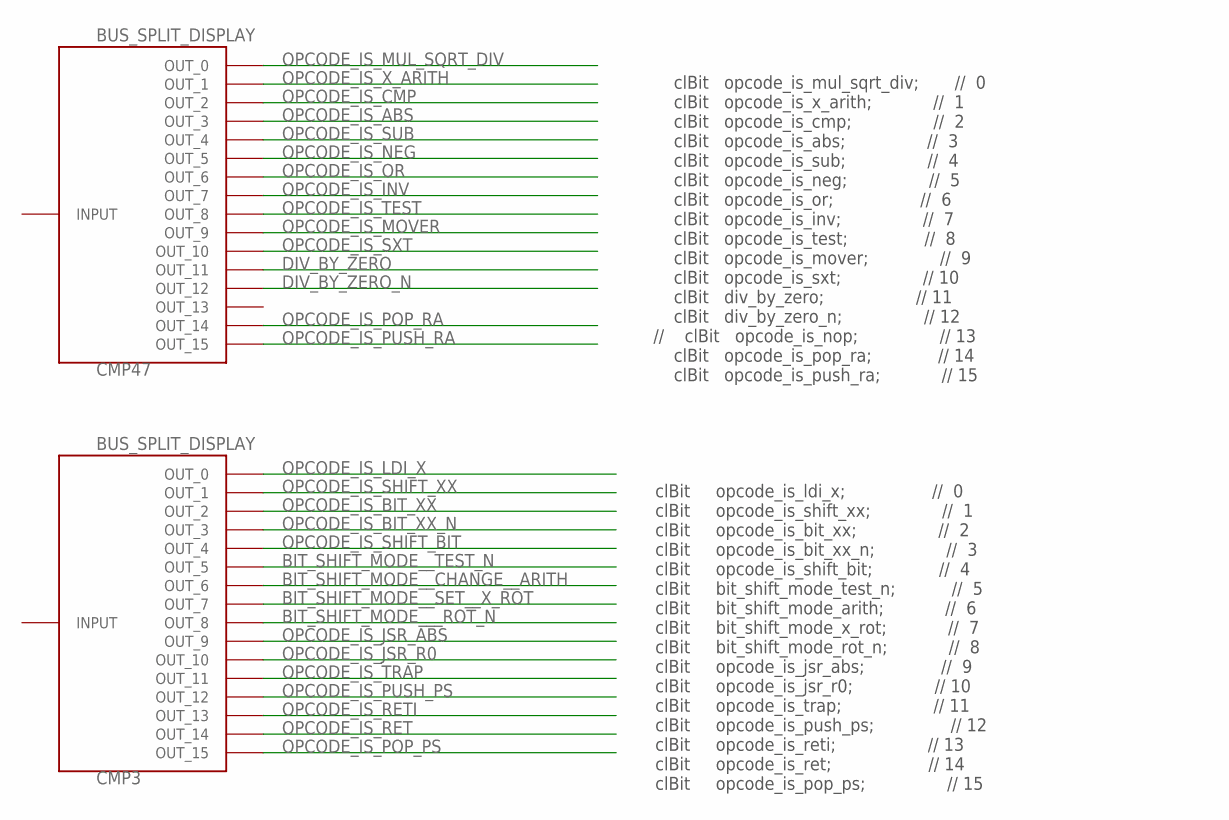
[picture p181: schematic module_decoding_a.sch, sheet 3]

Parts:
CMP3, CMP47: BUS_SPLIT_DISPLAY

Connections:
BIT_SHIFT_MODE__CHANGE__ARITH: CMP3.P$7 (OUT_6)
BIT_SHIFT_MODE__SET__X_ROT: CMP3.P$8 (OUT_7)
BIT_SHIFT_MODE__TEST_N: CMP3.P$6 (OUT_5)
BIT_SHIFT_MODE___ROT_N: CMP3.P$9 (OUT_8)
DIV_BY_ZERO: CMP47.P$12 (OUT_11); also elsewhere on the board
DIV_BY_ZERO_N: CMP47.P$13 (OUT_12)
OPCODE_IS_ABS: CMP47.P$4 (OUT_3)
OPCODE_IS_BIT_XX: CMP3.P$3 (OUT_2); also elsewhere on the board
OPCODE_IS_BIT_XX_N: CMP3.P$4 (OUT_3)
OPCODE_IS_CMP: CMP47.P$3 (OUT_2)
OPCODE_IS_INV: CMP47.P$8 (OUT_7)
OPCODE_IS_JSR_ABS: CMP3.P$10 (OUT_9); also elsewhere on the board
OPCODE_IS_JSR_R0: CMP3.P$11 (OUT_10); also elsewhere on the board
OPCODE_IS_LDI_X: CMP3.P$1 (OUT_0); also elsewhere on the board
OPCODE_IS_MOVER: CMP47.P$10 (OUT_9)
OPCODE_IS_MUL_SQRT_DIV: CMP47.P$1 (OUT_0); also elsewhere on the board
OPCODE_IS_NEG: CMP47.P$6 (OUT_5)
OPCODE_IS_OR: CMP47.P$7 (OUT_6)
OPCODE_IS_POP_PS: CMP3.P$16 (OUT_15); also elsewhere on the board
OPCODE_IS_POP_RA: CMP47.P$15 (OUT_14); also elsewhere on the board
OPCODE_IS_PUSH_PS: CMP3.P$13 (OUT_12); also elsewhere on the board
OPCODE_IS_PUSH_RA: CMP47.P$16 (OUT_15); also elsewhere on the board
OPCODE_IS_RET: CMP3.P$15 (OUT_14); also elsewhere on the board
OPCODE_IS_RETI: CMP3.P$14 (OUT_13); also elsewhere on the board
OPCODE_IS_SHIFT_BIT: CMP3.P$5 (OUT_4); also elsewhere on the board
OPCODE_IS_SHIFT_XX: CMP3.P$2 (OUT_1); also elsewhere on the board
OPCODE_IS_SUB: CMP47.P$5 (OUT_4)
OPCODE_IS_SXT: CMP47.P$11 (OUT_10)
OPCODE_IS_TEST: CMP47.P$9 (OUT_8)
OPCODE_IS_TRAP: CMP3.P$12 (OUT_11); also elsewhere on the board
OPCODE_IS_X_ARITH: CMP47.P$2 (OUT_1)

Notes on the sheet:
clBit opcode_is_ldi_x; // 0 clBit opcode_is_shift_xx; // 1 clBit opcode_is_bit_xx; // 2 clBit opcode_is_bit_xx_n; // 3 clBit opcode_is_shift_bit; // 4 clBit bit_shift_mode_test_n; // 5 clBit bit_shift_mode_arith; // 6 clBit bit_shift_mode_x_rot; // 7 clBit bit_shift_mode_rot_n; // 8 clBit opcode_is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
clBit opcode_is_mul_sqrt_div; // 0 clBit opcode_is_x_arith; // 1 clBit opcode_is_cmp; // 2 clBit opcode_is_abs; // 3 clBit opcode_is_sub; // 4 clBit opcode_is_neg; // 5 clBit opcode_is_or; // 6 clBit opcode_is_inv; // 7 clBit opcode_is_test; // 8 clBit opcode_is_mover; // 9 clBit opcode_is_sxt; // 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

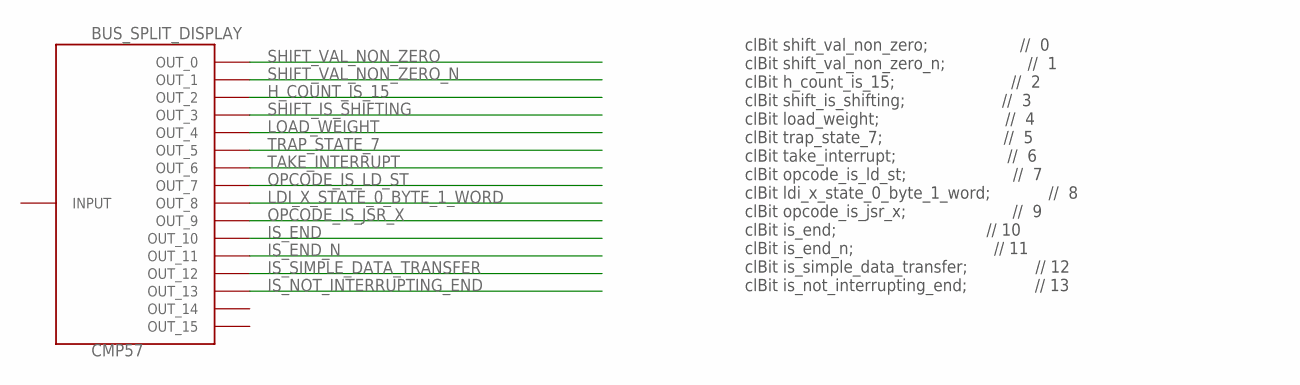
[picture p182: schematic module_decoding_a.sch, sheet 4]

Parts:
CMP57: BUS_SPLIT_DISPLAY

Connections:
H_COUNT_IS_15: CMP57.P$3 (OUT_2); also elsewhere on the board
IS_END: CMP57.P$11 (OUT_10); also elsewhere on the board
IS_END_N: CMP57.P$12 (OUT_11)
IS_NOT_INTERRUPTING_END: CMP57.P$14 (OUT_13); also elsewhere on the board
IS_SIMPLE_DATA_TRANSFER: CMP57.P$13 (OUT_12); also elsewhere on the board
LDI_X_STATE_0_BYTE_1_WORD: CMP57.P$9 (OUT_8); also elsewhere on the board
LOAD_WEIGHT: CMP57.P$5 (OUT_4)
OPCODE_IS_JSR_X: CMP57.P$10 (OUT_9); also elsewhere on the board
OPCODE_IS_LD_ST: CMP57.P$8 (OUT_7)
SHIFT_IS_SHIFTING: CMP57.P$4 (OUT_3); also elsewhere on the board
SHIFT_VAL_NON_ZERO: CMP57.P$1 (OUT_0)
SHIFT_VAL_NON_ZERO_N: CMP57.P$2 (OUT_1); also elsewhere on the board
TAKE_INTERRUPT: CMP57.P$7 (OUT_6); also elsewhere on the board
TRAP_STATE_7: CMP57.P$6 (OUT_5); also elsewhere on the board

Notes on the sheet:
clBit shift_val_non_zero; // 0 clBit shift_val_non_zero_n; // 1 clBit h_count_is_15; // 2 clBit shift_is_shifting; // 3 clBit load_weight; // 4 clBit trap_state_7; // 5 clBit take_interrupt; // 6 clBit opcode_is_ld_st; // 7 clBit ldi_x_state_0_byte_1_word; // 8 clBit opcode_is_jsr_x; // 9 clBit is_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

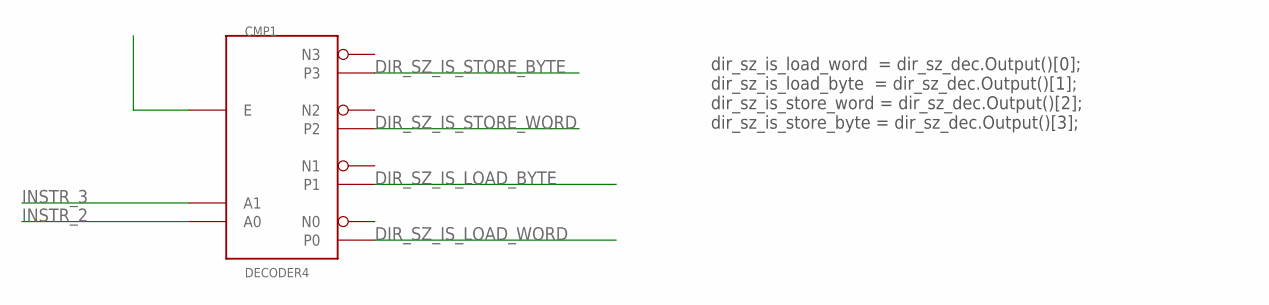
[picture p183: schematic module_decoding_a.sch, sheet 5]

Parts:
CMP1: DECODER4

Connections:
DIR_SZ_IS_LOAD_BYTE: CMP1.P1; also elsewhere on the board
DIR_SZ_IS_LOAD_WORD: CMP1.P0; also elsewhere on the board
DIR_SZ_IS_STORE_BYTE: CMP1.P3; also elsewhere on the board
DIR_SZ_IS_STORE_WORD: CMP1.P2; also elsewhere on the board
INSTR_2: CMP1.A0; also elsewhere on the board
INSTR_3: CMP1.A1; also elsewhere on the board

Notes on the sheet:
dir_sz_is_load_word = dir_sz_dec.Output()[0]; dir_sz_is_load_byte = dir_sz_dec.Output()[1]; dir_sz_is_store_word = dir_sz_dec.Output()[2]; dir_sz_is_store_byte = dir_sz_dec.Output()[3];

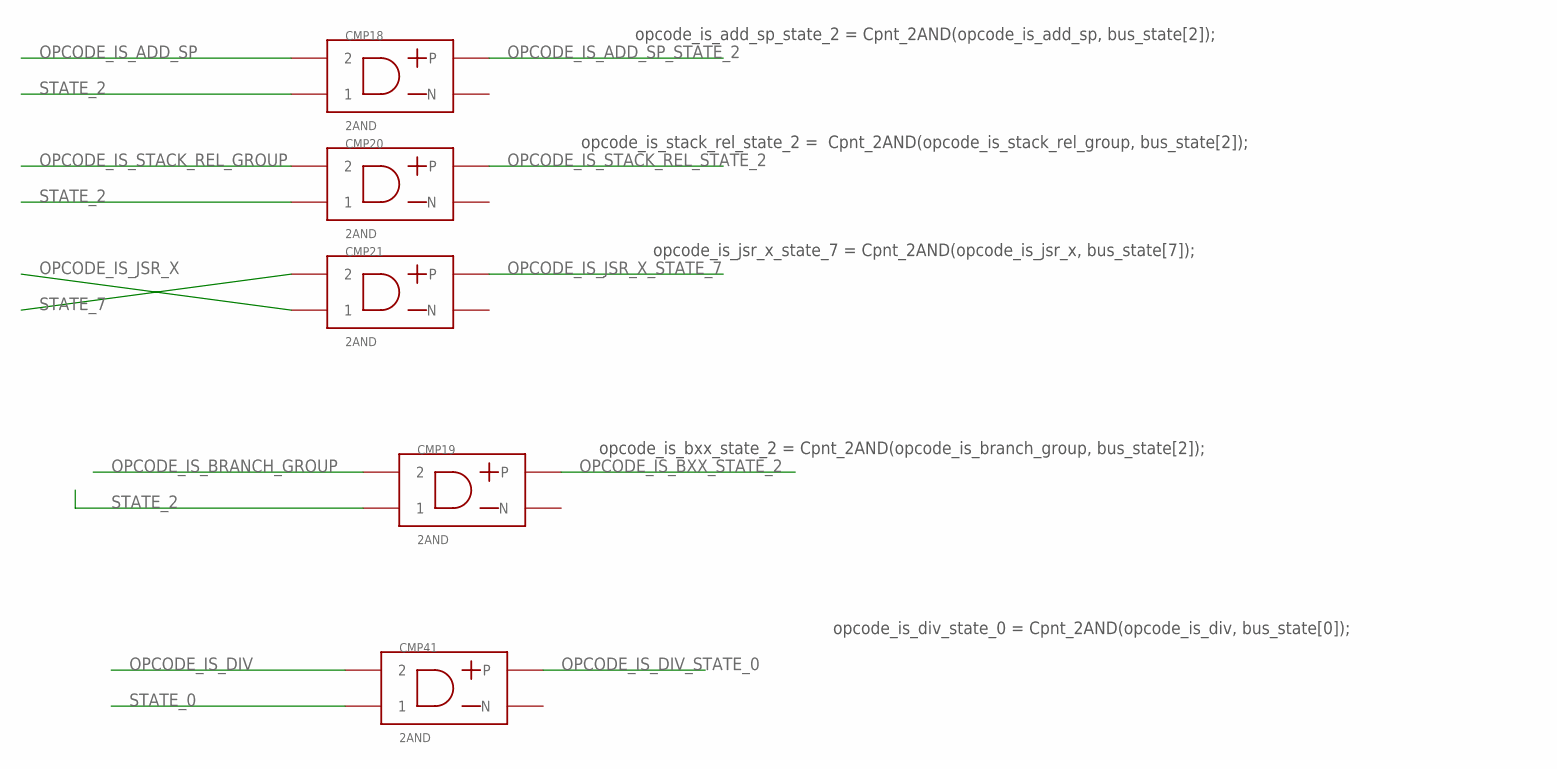
[picture p184: schematic module_decoding_a.sch, sheet 6]

Parts:
CMP18, CMP19, CMP20, CMP21, CMP41: 2AND

Connections:
OPCODE_IS_ADD_SP: CMP18.P$2 (2); also elsewhere on the board
OPCODE_IS_ADD_SP_STATE_2: CMP18.OUT_P; also elsewhere on the board
OPCODE_IS_BRANCH_GROUP: CMP19.P$2 (2); also elsewhere on the board
OPCODE_IS_BXX_STATE_2: CMP19.OUT_P; also elsewhere on the board
OPCODE_IS_DIV: CMP41.P$2 (2); also elsewhere on the board
OPCODE_IS_DIV_STATE_0: CMP41.OUT_P; also elsewhere on the board
OPCODE_IS_JSR_X: CMP21.P$1 (1); also elsewhere on the board
OPCODE_IS_JSR_X_STATE_7: CMP21.OUT_P; also elsewhere on the board
OPCODE_IS_STACK_REL_GROUP: CMP20.P$2 (2); also elsewhere on the board
OPCODE_IS_STACK_REL_STATE_2: CMP20.OUT_P; also elsewhere on the board
STATE_0: CMP41.P$1 (1); also elsewhere on the board
STATE_2: CMP18.P$1 (1), CMP19.P$1 (1), CMP20.P$1 (1); also elsewhere on the board
STATE_7: CMP21.P$2 (2); also elsewhere on the board

Notes on the sheet:
opcode_is_div_state_0 = Cpnt_2AND(opcode_is_div, bus_state[0]);
opcode_is_bxx_state_2 = Cpnt_2AND(opcode_is_branch_group, bus_state[2]);
opcode_is_add_sp_state_2 = Cpnt_2AND(opcode_is_add_sp, bus_state[2]);
opcode_is_stack_rel_state_2 = Cpnt_2AND(opcode_is_stack_rel_group, bus_state[2]);
opcode_is_jsr_x_state_7 = Cpnt_2AND(opcode_is_jsr_x, bus_state[7]);
