ericherman/megaprocessor/module_artwork_decoding_a/module_decoding_a.brd

## EAGLE design module_artwork_decoding_a/module_decoding_a.brd (continued)

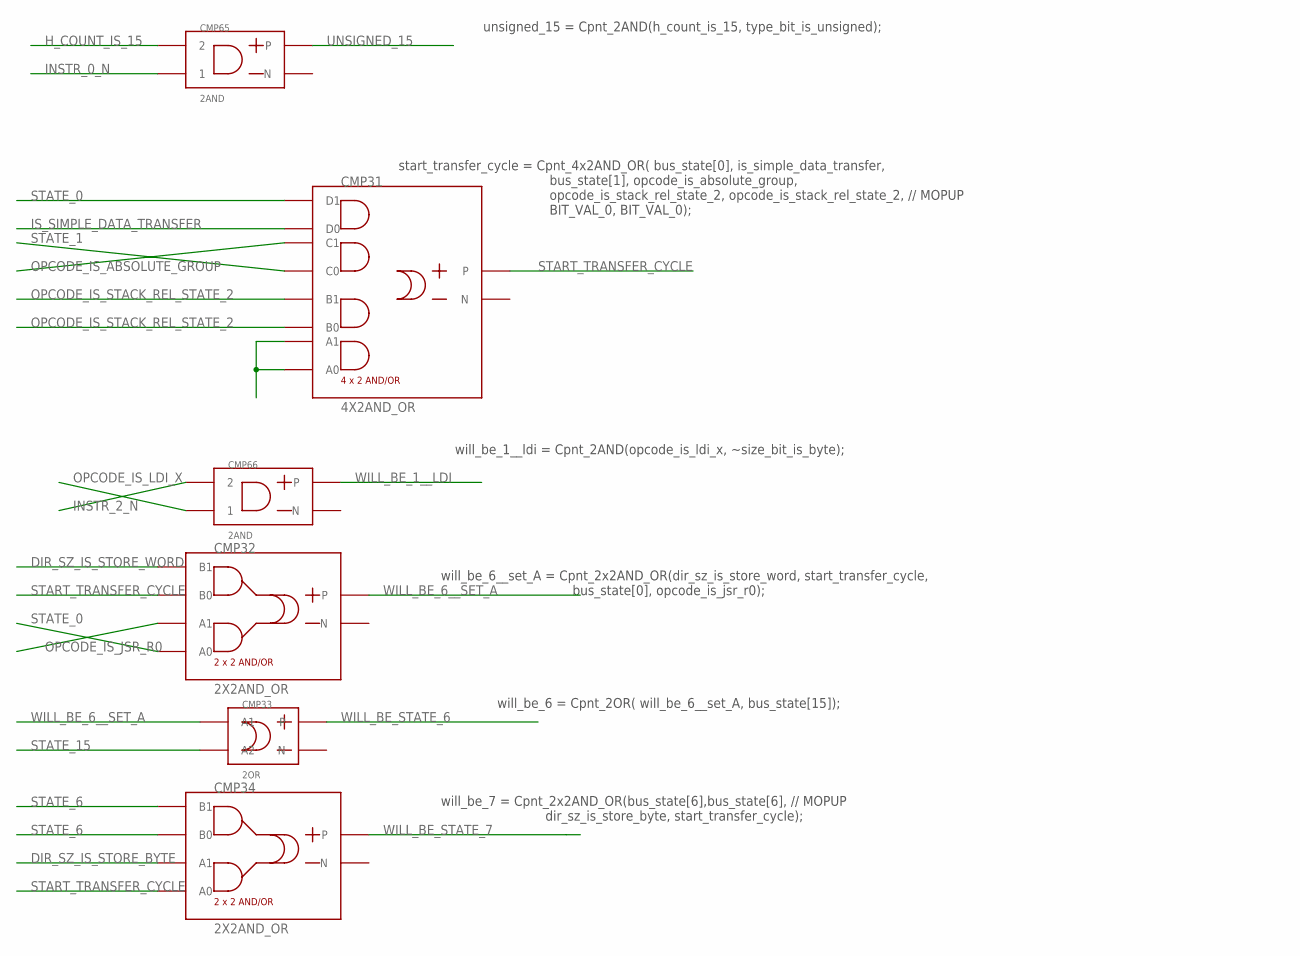
[picture p185: schematic module_decoding_a.sch, sheet 7]

Parts:
CMP31: 4X2AND_OR
CMP32, CMP34: 2X2AND_OR
CMP33: 2OR
CMP65, CMP66: 2AND

Connections:
DIR_SZ_IS_STORE_BYTE: CMP34.P$2 (A1); also elsewhere on the board
DIR_SZ_IS_STORE_WORD: CMP32.P$4 (B1); also elsewhere on the board
H_COUNT_IS_15: CMP65.P$2 (2); also elsewhere on the board
INSTR_0_N: CMP65.P$1 (1); also elsewhere on the board
INSTR_2_N: CMP66.P$2 (2); also elsewhere on the board
IS_SIMPLE_DATA_TRANSFER: CMP31.P$7 (D0); also elsewhere on the board
unnamed: CMP31.P$1 (A0), CMP31.P$2 (A1)
OPCODE_IS_ABSOLUTE_GROUP: CMP31.P$6 (C1); also elsewhere on the board
OPCODE_IS_JSR_R0: CMP32.P$2 (A1); also elsewhere on the board
OPCODE_IS_LDI_X: CMP66.P$1 (1); also elsewhere on the board
OPCODE_IS_STACK_REL_STATE_2: CMP31.P$3 (B0), CMP31.P$4 (B1); also elsewhere on the board
START_TRANSFER_CYCLE: CMP31.OUT_P, CMP32.P$3 (B0), CMP34.P$1 (A0); also elsewhere on the board
STATE_0: CMP31.P$8 (D1), CMP32.P$1 (A0); also elsewhere on the board
STATE_1: CMP31.P$5 (C0); also elsewhere on the board
STATE_6: CMP34.P$3 (B0), CMP34.P$4 (B1); also elsewhere on the board
STATE_15: CMP33.P$1 (A2); also elsewhere on the board
UNSIGNED_15: CMP65.OUT_P; also elsewhere on the board
WILL_BE_1__LDI: CMP66.OUT_P; also elsewhere on the board
WILL_BE_6__SET_A: CMP32.OUT_P, CMP33.P$2 (A1)
WILL_BE_STATE_6: CMP33.OUT_P; also elsewhere on the board
WILL_BE_STATE_7: CMP34.OUT_P; also elsewhere on the board

Notes on the sheet:
unsigned_15 = Cpnt_2AND(h_count_is_15, type_bit_is_unsigned);
start_transfer_cycle = Cpnt_4x2AND_OR( bus_state[0], is_simple_data_transfer, bus_state[1], opcode_is_absolute_group, opcode_is_stack_rel_state_2, opcode_is_stack_rel_state_2, // MOPUP BIT_VAL_0, BIT_VAL_0);
will_be_1__ldi = Cpnt_2AND(opcode_is_ldi_x, ~size_bit_is_byte);
will_be_6__set_A = Cpnt_2x2AND_OR(dir_sz_is_store_word, start_transfer_cycle, bus_state[0], opcode_is_jsr_r0);
will_be_6 = Cpnt_2OR( will_be_6__set_A, bus_state[15]);
will_be_7 = Cpnt_2x2AND_OR(bus_state[6],bus_state[6], // MOPUP dir_sz_is_store_byte, start_transfer_cycle);

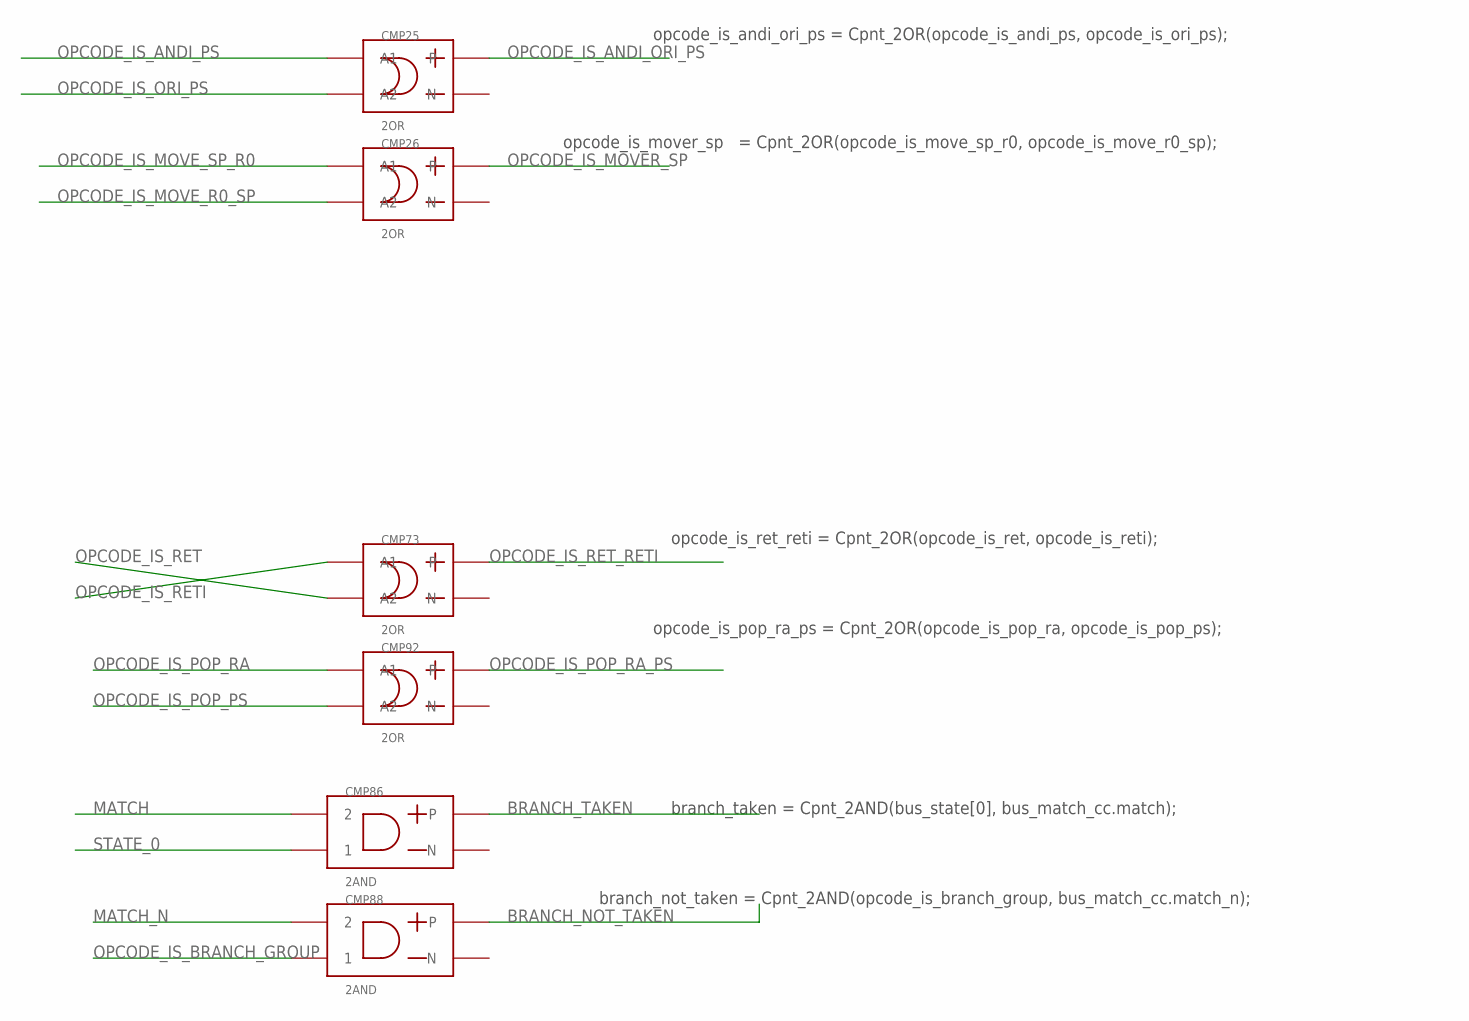
[picture p186: schematic module_decoding_a.sch, sheet 8]

Parts:
CMP25, CMP26, CMP73, CMP92: 2OR
CMP86, CMP88: 2AND

Connections:
BRANCH_NOT_TAKEN: CMP88.OUT_P; also elsewhere on the board
BRANCH_TAKEN: CMP86.OUT_P; also elsewhere on the board
MATCH: CMP86.P$2 (2); also elsewhere on the board
MATCH_N: CMP88.P$2 (2); also elsewhere on the board
OPCODE_IS_ANDI_ORI_PS: CMP25.OUT_P; also elsewhere on the board
OPCODE_IS_ANDI_PS: CMP25.P$2 (A1); also elsewhere on the board
OPCODE_IS_BRANCH_GROUP: CMP88.P$1 (1); also elsewhere on the board
OPCODE_IS_MOVER_SP: CMP26.OUT_P; also elsewhere on the board
OPCODE_IS_MOVE_R0_SP: CMP26.P$1 (A2); also elsewhere on the board
OPCODE_IS_MOVE_SP_R0: CMP26.P$2 (A1); also elsewhere on the board
OPCODE_IS_ORI_PS: CMP25.P$1 (A2); also elsewhere on the board
OPCODE_IS_POP_PS: CMP92.P$1 (A2); also elsewhere on the board
OPCODE_IS_POP_RA: CMP92.P$2 (A1); also elsewhere on the board
OPCODE_IS_POP_RA_PS: CMP92.OUT_P; also elsewhere on the board
OPCODE_IS_RET: CMP73.P$1 (A2); also elsewhere on the board
OPCODE_IS_RETI: CMP73.P$2 (A1); also elsewhere on the board
OPCODE_IS_RET_RETI: CMP73.OUT_P; also elsewhere on the board
STATE_0: CMP86.P$1 (1); also elsewhere on the board

Notes on the sheet:
opcode_is_andi_ori_ps = Cpnt_2OR(opcode_is_andi_ps, opcode_is_ori_ps);
opcode_is_mover_sp = Cpnt_2OR(opcode_is_move_sp_r0, opcode_is_move_r0_sp);
opcode_is_ret_reti = Cpnt_2OR(opcode_is_ret, opcode_is_reti);
opcode_is_pop_ra_ps = Cpnt_2OR(opcode_is_pop_ra, opcode_is_pop_ps);
branch_taken = Cpnt_2AND(bus_state[0], bus_match_cc.match);
branch_not_taken = Cpnt_2AND(opcode_is_branch_group, bus_match_cc.match_n);

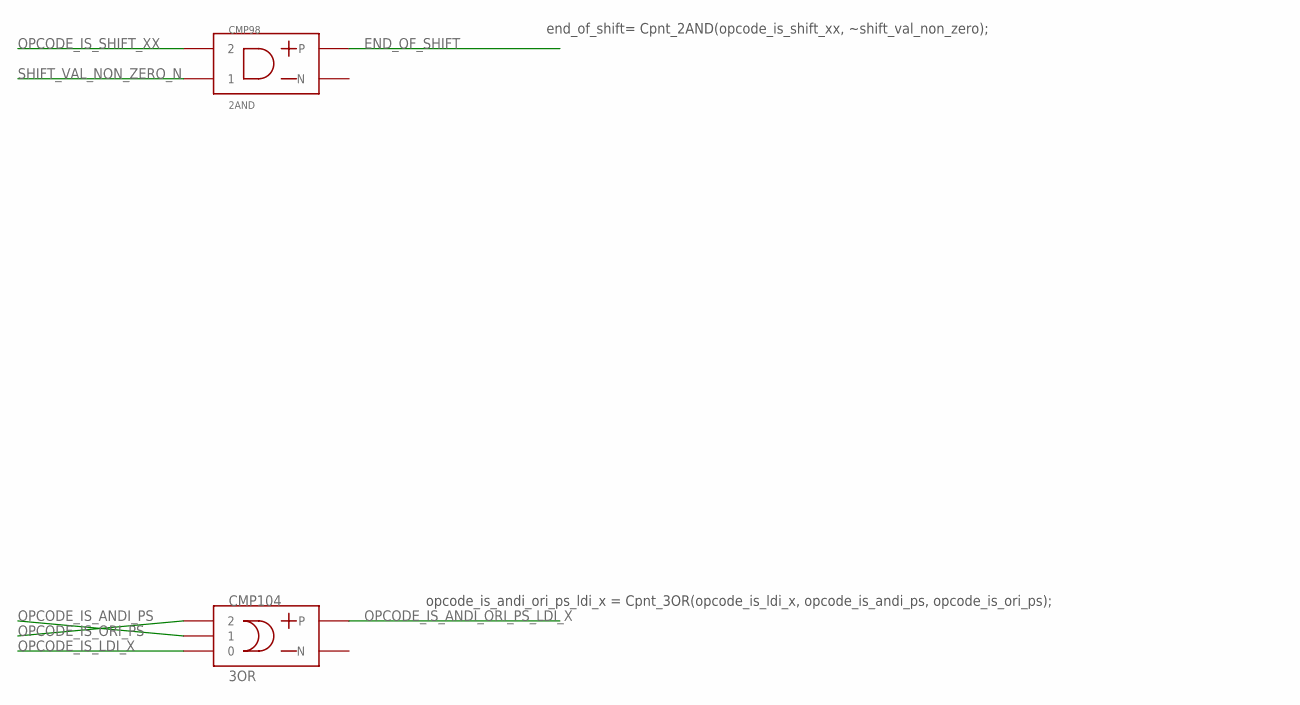
[picture p187: schematic module_decoding_a.sch, sheet 9]

Parts:
CMP98: 2AND
CMP104: 3OR

Connections:
END_OF_SHIFT: CMP98.OUT_P; also elsewhere on the board
OPCODE_IS_ANDI_ORI_PS_LDI_X: CMP104.OUT_P; also elsewhere on the board
OPCODE_IS_ANDI_PS: CMP104.P$2 (1); also elsewhere on the board
OPCODE_IS_LDI_X: CMP104.P$1 (0); also elsewhere on the board
OPCODE_IS_ORI_PS: CMP104.P$3 (2); also elsewhere on the board
OPCODE_IS_SHIFT_XX: CMP98.P$2 (2); also elsewhere on the board
SHIFT_VAL_NON_ZERO_N: CMP98.P$1 (1); also elsewhere on the board

Notes on the sheet:
end_of_shift= Cpnt_2AND(opcode_is_shift_xx, ~shift_val_non_zero);
opcode_is_andi_ori_ps_ldi_x = Cpnt_3OR(opcode_is_ldi_x, opcode_is_andi_ps, opcode_is_ori_ps);

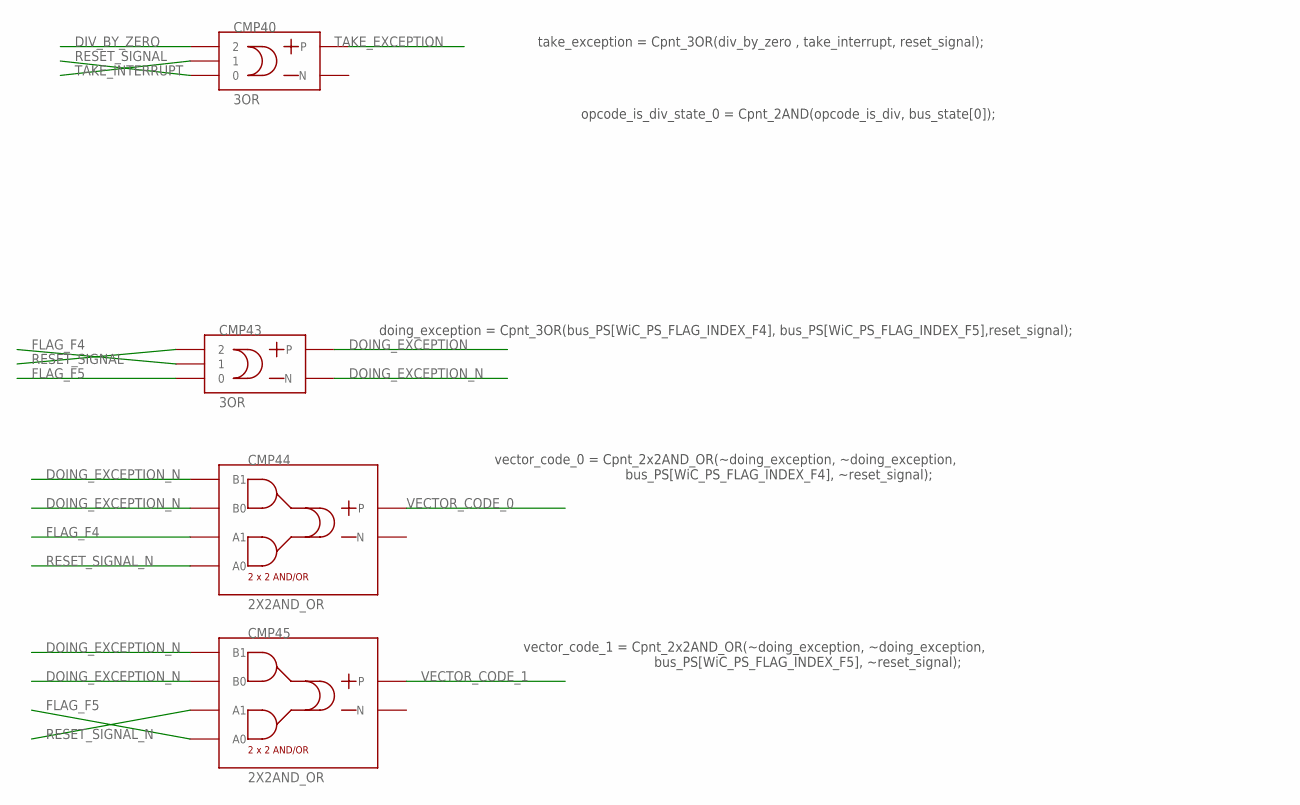
[picture p188: schematic module_decoding_a.sch, sheet 10]

Parts:
CMP40, CMP43: 3OR
CMP44, CMP45: 2X2AND_OR

Connections:
DIV_BY_ZERO: CMP40.P$3 (2); also elsewhere on the board
DOING_EXCEPTION: CMP43.OUT_P
DOING_EXCEPTION_N: CMP43.OUT_M (N), CMP44.P$3 (B0), CMP44.P$4 (B1), CMP45.P$3 (B0), CMP45.P$4 (B1)
FLAG_F4: CMP43.P$2 (1), CMP44.P$2 (A1); also elsewhere on the board
FLAG_F5: CMP43.P$1 (0), CMP45.P$1 (A0); also elsewhere on the board
RESET_SIGNAL: CMP40.P$1 (0), CMP43.P$3 (2); also elsewhere on the board
RESET_SIGNAL_N: CMP44.P$1 (A0), CMP45.P$2 (A1); also elsewhere on the board
TAKE_EXCEPTION: CMP40.OUT_P; also elsewhere on the board
TAKE_INTERRUPT: CMP40.P$2 (1); also elsewhere on the board
VECTOR_CODE_0: CMP44.OUT_P; also elsewhere on the board
VECTOR_CODE_1: CMP45.OUT_P; also elsewhere on the board

Notes on the sheet:
take_exception = Cpnt_3OR(div_by_zero , take_interrupt, reset_signal);
opcode_is_div_state_0 = Cpnt_2AND(opcode_is_div, bus_state[0]);
doing_exception = Cpnt_3OR(bus_PS[WiC_PS_FLAG_INDEX_F4], bus_PS[WiC_PS_FLAG_INDEX_F5],reset_signal);
vector_code_0 = Cpnt_2x2AND_OR(~doing_exception, ~doing_exception, bus_PS[WiC_PS_FLAG_INDEX_F4], ~reset_signal);
vector_code_1 = Cpnt_2x2AND_OR(~doing_exception, ~doing_exception, bus_PS[WiC_PS_FLAG_INDEX_F5], ~reset_signal);

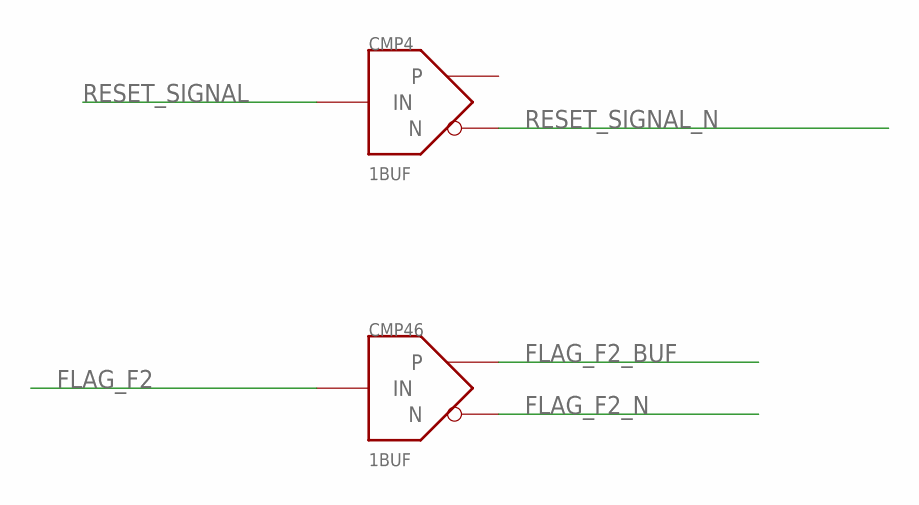
[picture p189: schematic module_decoding_a.sch, sheet 11]

Parts:
CMP4, CMP46: 1BUF

Connections:
FLAG_F2: CMP46.IN; also elsewhere on the board
FLAG_F2_BUF: CMP46.P; also elsewhere on the board
FLAG_F2_N: CMP46.N; also elsewhere on the board
RESET_SIGNAL: CMP4.IN; also elsewhere on the board
RESET_SIGNAL_N: CMP4.N; also elsewhere on the board

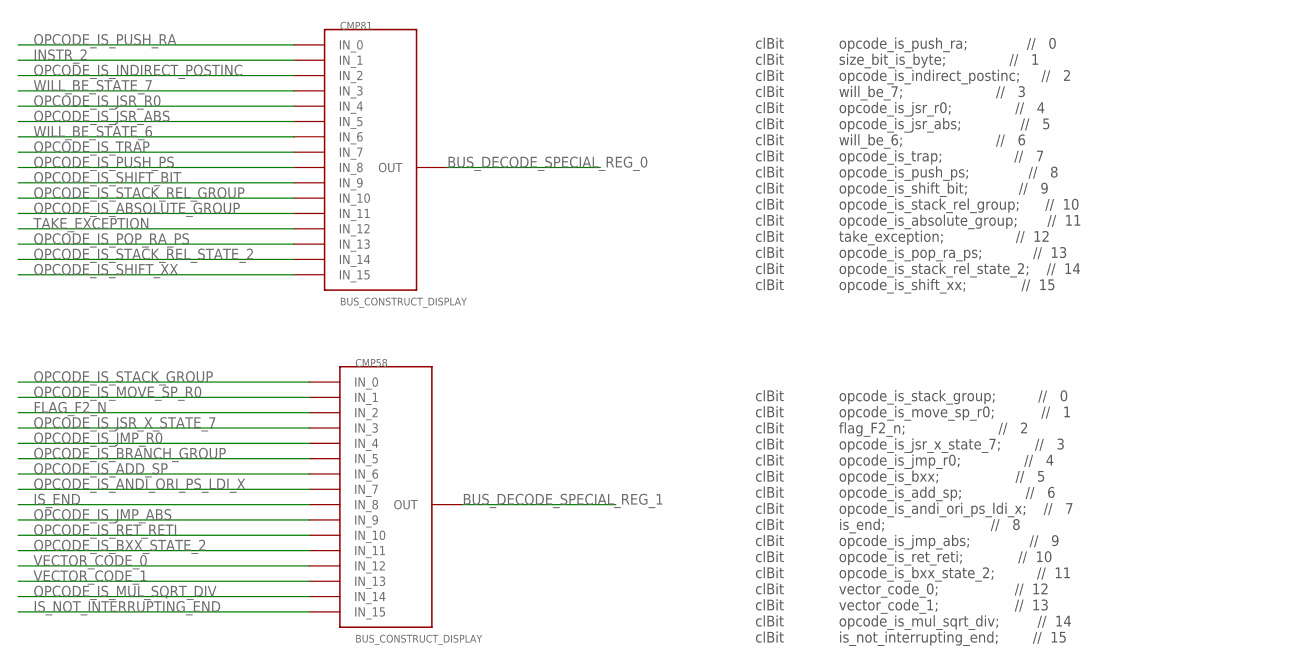
[picture p190: schematic module_decoding_a.sch, sheet 12]

Parts:
CMP58, CMP81: BUS_CONSTRUCT_DISPLAY; BUS_SPLIT_DISPLAY

Connections:
BUS_DECODE_SPECIAL_REG_0: CMP81.INPUT (OUT)
BUS_DECODE_SPECIAL_REG_1: CMP58.INPUT (OUT)
FLAG_F2_N: CMP58.P$3 (IN_2); also elsewhere on the board
INSTR_2: CMP81.P$2 (IN_1); also elsewhere on the board
IS_END: CMP58.P$9 (IN_8); also elsewhere on the board
IS_NOT_INTERRUPTING_END: CMP58.P$16 (IN_15); also elsewhere on the board
OPCODE_IS_ABSOLUTE_GROUP: CMP81.P$12 (IN_11); also elsewhere on the board
OPCODE_IS_ADD_SP: CMP58.P$7 (IN_6); also elsewhere on the board
OPCODE_IS_ANDI_ORI_PS_LDI_X: CMP58.P$8 (IN_7); also elsewhere on the board
OPCODE_IS_BRANCH_GROUP: CMP58.P$6 (IN_5); also elsewhere on the board
OPCODE_IS_BXX_STATE_2: CMP58.P$12 (IN_11); also elsewhere on the board
OPCODE_IS_INDIRECT_POSTINC: CMP81.P$3 (IN_2); also elsewhere on the board
OPCODE_IS_JMP_ABS: CMP58.P$10 (IN_9); also elsewhere on the board
OPCODE_IS_JMP_R0: CMP58.P$5 (IN_4); also elsewhere on the board
OPCODE_IS_JSR_ABS: CMP81.P$6 (IN_5); also elsewhere on the board
OPCODE_IS_JSR_R0: CMP81.P$5 (IN_4); also elsewhere on the board
OPCODE_IS_JSR_X_STATE_7: CMP58.P$4 (IN_3); also elsewhere on the board
OPCODE_IS_MOVE_SP_R0: CMP58.P$2 (IN_1); also elsewhere on the board
OPCODE_IS_MUL_SQRT_DIV: CMP58.P$15 (IN_14); also elsewhere on the board
OPCODE_IS_POP_RA_PS: CMP81.P$14 (IN_13); also elsewhere on the board
OPCODE_IS_PUSH_PS: CMP81.P$9 (IN_8); also elsewhere on the board
OPCODE_IS_PUSH_RA: CMP81.P$1 (IN_0); also elsewhere on the board
OPCODE_IS_RET_RETI: CMP58.P$11 (IN_10); also elsewhere on the board
OPCODE_IS_SHIFT_BIT: CMP81.P$10 (IN_9); also elsewhere on the board
OPCODE_IS_SHIFT_XX: CMP81.P$16 (IN_15); also elsewhere on the board
OPCODE_IS_STACK_GROUP: CMP58.P$1 (IN_0); also elsewhere on the board
OPCODE_IS_STACK_REL_GROUP: CMP81.P$11 (IN_10); also elsewhere on the board
OPCODE_IS_STACK_REL_STATE_2: CMP81.P$15 (IN_14); also elsewhere on the board
OPCODE_IS_TRAP: CMP81.P$8 (IN_7); also elsewhere on the board
TAKE_EXCEPTION: CMP81.P$13 (IN_12); also elsewhere on the board
VECTOR_CODE_0: CMP58.P$13 (IN_12); also elsewhere on the board
VECTOR_CODE_1: CMP58.P$14 (IN_13); also elsewhere on the board
WILL_BE_STATE_6: CMP81.P$7 (IN_6); also elsewhere on the board
WILL_BE_STATE_7: CMP81.P$4 (IN_3); also elsewhere on the board

Notes on the sheet:
clBit opcode_is_push_ra; // 0 clBit size_bit_is_byte; // 1 clBit opcode_is_indirect_postinc; // 2 clBit will_be_7; // 3 clBit opcode_is_jsr_r0; // 4 clBit opcode_is_jsr_abs; // 5 clBit will_be_6; // 6 clBit opcode_is_trap; // 7 clBit opcode_is_push_ps; // 8 clBit opcode_is_shift_bit; // 9 clBit opc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
clBit opcode_is_stack_group; // 0 clBit opcode_is_move_sp_r0; // 1 clBit flag_F2_n; // 2 clBit opcode_is_jsr_x_state_7; // 3 clBit opcode_is_jmp_r0; // 4 clBit opcode_is_bxx; // 5 clBit opcode_is_add_sp; // 6 clBit opcode_is_andi_ori_ps_ldi_x; // 7 clBit is_end; // 8 clBit opcode_is_jmp_abs; // 9 c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

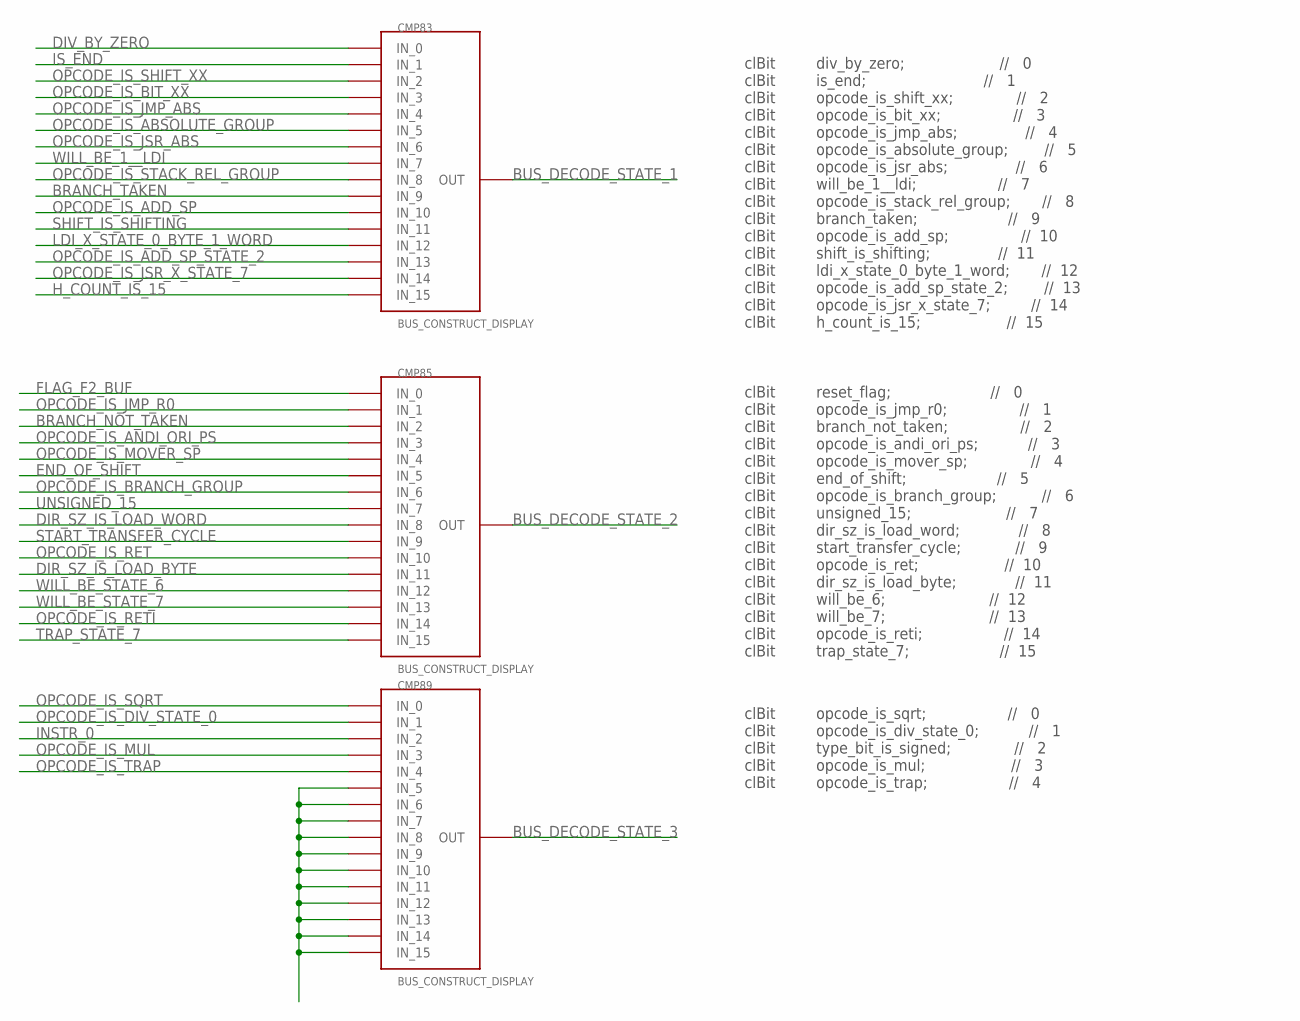
[picture p191: schematic module_decoding_a.sch, sheet 13]

Parts:
CMP83, CMP85, CMP89: BUS_CONSTRUCT_DISPLAY; BUS_SPLIT_DISPLAY

Connections:
BRANCH_NOT_TAKEN: CMP85.P$3 (IN_2); also elsewhere on the board
BRANCH_TAKEN: CMP83.P$10 (IN_9); also elsewhere on the board
BUS_DECODE_STATE_1: CMP83.INPUT (OUT)
BUS_DECODE_STATE_2: CMP85.INPUT (OUT)
BUS_DECODE_STATE_3: CMP89.INPUT (OUT)
DIR_SZ_IS_LOAD_BYTE: CMP85.P$12 (IN_11); also elsewhere on the board
DIR_SZ_IS_LOAD_WORD: CMP85.P$9 (IN_8); also elsewhere on the board
DIV_BY_ZERO: CMP83.P$1 (IN_0); also elsewhere on the board
END_OF_SHIFT: CMP85.P$6 (IN_5); also elsewhere on the board
FLAG_F2_BUF: CMP85.P$1 (IN_0); also elsewhere on the board
H_COUNT_IS_15: CMP83.P$16 (IN_15); also elsewhere on the board
INSTR_0: CMP89.P$3 (IN_2); also elsewhere on the board
IS_END: CMP83.P$2 (IN_1); also elsewhere on the board
LDI_X_STATE_0_BYTE_1_WORD: CMP83.P$13 (IN_12); also elsewhere on the board
unnamed: CMP89.P$6 (IN_5), CMP89.P$7 (IN_6), CMP89.P$8 (IN_7), CMP89.P$9 (IN_8), CMP89.P$10 (IN_9), CMP89.P$11 (IN_10), CMP89.P$12 (IN_11), CMP89.P$13 (IN_12), CMP89.P$14 (IN_13), CMP89.P$15 (IN_14), CMP89.P$16 (IN_15)
OPCODE_IS_ABSOLUTE_GROUP: CMP83.P$6 (IN_5); also elsewhere on the board
OPCODE_IS_ADD_SP: CMP83.P$11 (IN_10); also elsewhere on the board
OPCODE_IS_ADD_SP_STATE_2: CMP83.P$14 (IN_13); also elsewhere on the board
OPCODE_IS_ANDI_ORI_PS: CMP85.P$4 (IN_3); also elsewhere on the board
OPCODE_IS_BIT_XX: CMP83.P$4 (IN_3); also elsewhere on the board
OPCODE_IS_BRANCH_GROUP: CMP85.P$7 (IN_6); also elsewhere on the board
OPCODE_IS_DIV_STATE_0: CMP89.P$2 (IN_1); also elsewhere on the board
OPCODE_IS_JMP_ABS: CMP83.P$5 (IN_4); also elsewhere on the board
OPCODE_IS_JMP_R0: CMP85.P$2 (IN_1); also elsewhere on the board
OPCODE_IS_JSR_ABS: CMP83.P$7 (IN_6); also elsewhere on the board
OPCODE_IS_JSR_X_STATE_7: CMP83.P$15 (IN_14); also elsewhere on the board
OPCODE_IS_MOVER_SP: CMP85.P$5 (IN_4); also elsewhere on the board
OPCODE_IS_MUL: CMP89.P$4 (IN_3); also elsewhere on the board
OPCODE_IS_RET: CMP85.P$11 (IN_10); also elsewhere on the board
OPCODE_IS_RETI: CMP85.P$15 (IN_14); also elsewhere on the board
OPCODE_IS_SHIFT_XX: CMP83.P$3 (IN_2); also elsewhere on the board
OPCODE_IS_SQRT: CMP89.P$1 (IN_0); also elsewhere on the board
OPCODE_IS_STACK_REL_GROUP: CMP83.P$9 (IN_8); also elsewhere on the board
OPCODE_IS_TRAP: CMP89.P$5 (IN_4); also elsewhere on the board
SHIFT_IS_SHIFTING: CMP83.P$12 (IN_11); also elsewhere on the board
START_TRANSFER_CYCLE: CMP85.P$10 (IN_9); also elsewhere on the board
TRAP_STATE_7: CMP85.P$16 (IN_15); also elsewhere on the board
UNSIGNED_15: CMP85.P$8 (IN_7); also elsewhere on the board
WILL_BE_1__LDI: CMP83.P$8 (IN_7); also elsewhere on the board
WILL_BE_STATE_6: CMP85.P$13 (IN_12); also elsewhere on the board
WILL_BE_STATE_7: CMP85.P$14 (IN_13); also elsewhere on the board

Notes on the sheet:
clBit opcode_is_sqrt; // 0 clBit opcode_is_div_state_0; // 1 clBit type_bit_is_signed; // 2 clBit opcode_is_mul; // 3 clBit opcode_is_trap; // 4
clBit reset_flag; // 0 clBit opcode_is_jmp_r0; // 1 clBit branch_not_taken; // 2 clBit opcode_is_andi_ori_ps; // 3 clBit opcode_is_mover_sp; // 4 clBit end_of_shift; // 5 clBit opcode_is_branch_group; // 6 clBit unsigned_15; // 7 clBit dir_sz_is_load_word; // 8 clBit start_transfer_cycle; // 9 clBi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
clBit div_by_zero; // 0 clBit is_end; // 1 clBit opcode_is_shift_xx; // 2 clBit opcode_is_bit_xx; // 3 clBit opcode_is_jmp_abs; // 4 clBit opcode_is_absolute_group; // 5 clBit opcode_is_jsr_abs; // 6 clBit will_be_1__ldi; // 7 clBit opcode_is_stack_rel_group; // 8 clBit branch_taken; // 9 clBit opc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

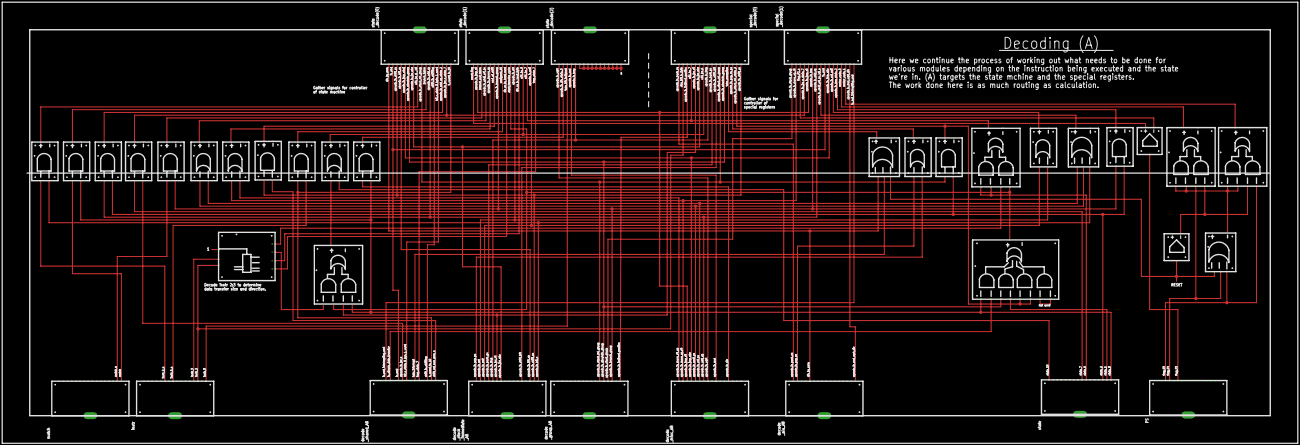
[picture p192: board module_decoding_a.brd from above]

Board: 2 copper layers, 1193.8 x 406.4 mm, 40 parts (0 on the bottom side), 89 nets.
