ericherman/megaprocessor/7seg_4digit/7SEG_4DIGIT_1.brd

## EAGLE design 7seg_4digit/7SEG_4DIGIT_1.brd (2017-05-20)

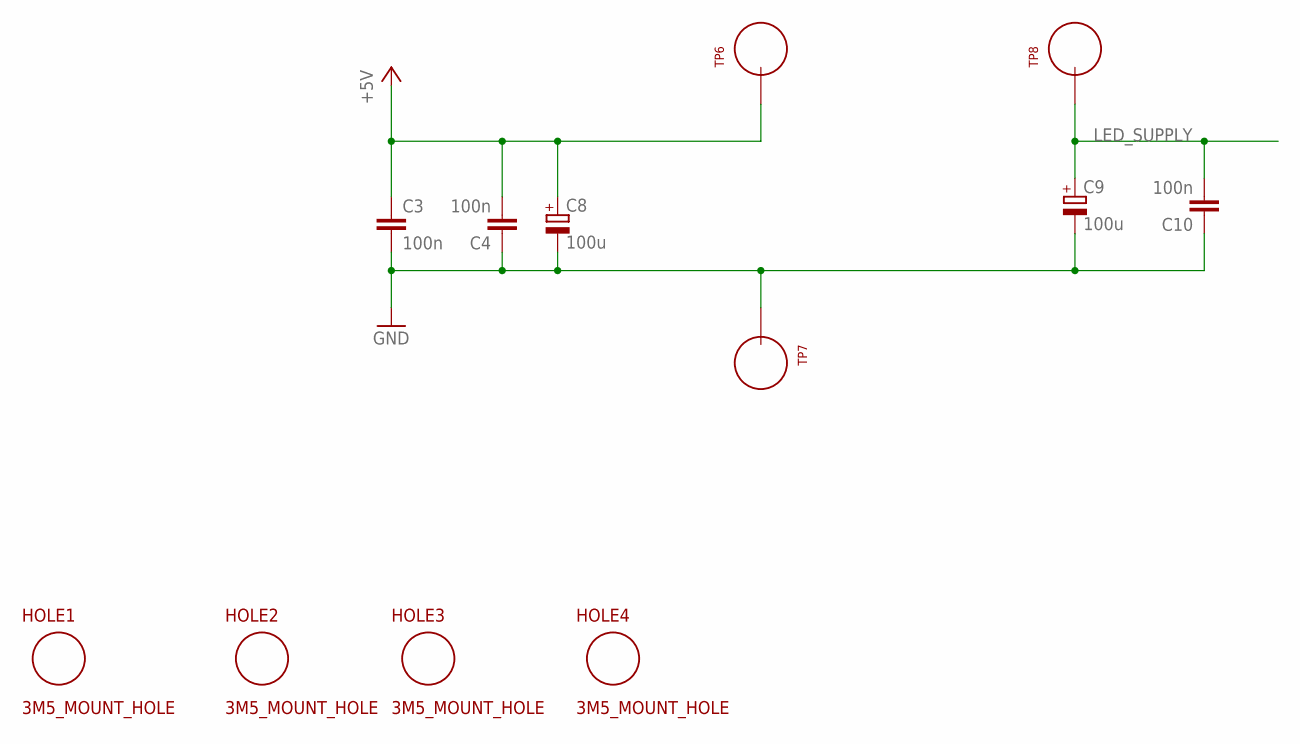
[picture p193: schematic 7SEG_4DIGIT_1.sch, sheet 1]

Parts:
C3, C4, C10: 100n; CAP_P2INCH
C8, C9: 100u; POLARISED_CAP_2P5_6P3MM
HOLE1, HOLE2, HOLE3, HOLE4: 3M5_MOUNT_HOLE; 3P5M_HOLE
TP6, TP7, TP8: TEST_LOOP

Connections:
+5V: C3.1, C4.2, C8.A, TP6.P$1; also elsewhere on the board
GND: C3.2, C4.1, C8.K, C9.K, C10.1, TP7.P$1; also elsewhere on the board
LED_SUPPLY: C9.A, C10.2, TP8.P$1; also elsewhere on the board

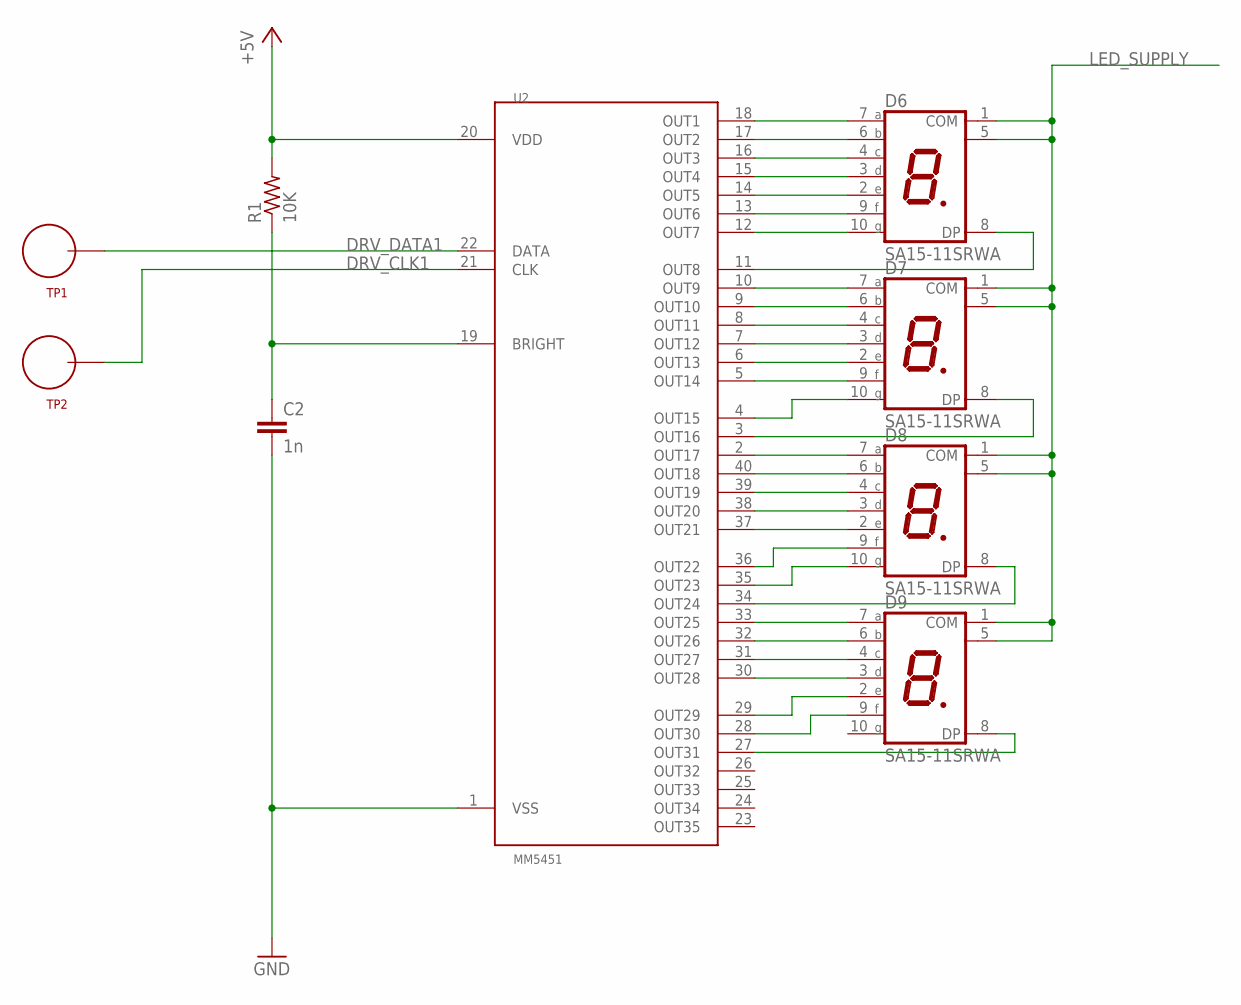
[picture p194: schematic 7SEG_4DIGIT_1.sch, sheet 2]

Parts:
C2: 1n; CAP_P2INCH
D6, D7, D8, D9: SA15-11SRWA; SC15
R1: 10K; R_P2INCH
TP1, TP2: TEST_LOOP
U2: MM5451; DIP40_P6

Connections:
+5V: R1.2, U2.20 (VDD); also elsewhere on the board
DRV_CLK1: TP2.P$1, U2.21 (CLK)
DRV_DATA1: TP1.P$1, U2.22 (DATA)
GND: C2.2, U2.1 (VSS); also elsewhere on the board
LED_SUPPLY: D6.1 (COM), D6.5 (COM), D7.1 (COM), D7.5 (COM), D8.1 (COM), D8.5 (COM), D9.1 (COM), D9.5 (COM); also elsewhere on the board
unnamed: D6.8 (DP), U2.11 (OUT8)
unnamed: D7.7 (A), U2.10 (OUT9)
unnamed: D7.6 (B), U2.9 (OUT10)
unnamed: C2.1, R1.1, U2.19 (BRIGHT)
unnamed: D7.4 (C), U2.8 (OUT11)
unnamed: D7.3 (D), U2.7 (OUT12)
unnamed: D7.2 (E), U2.6 (OUT13)
unnamed: D7.9 (F), U2.5 (OUT14)
unnamed: D7.10 (G), U2.4 (OUT15)
unnamed: D6.7 (A), U2.18 (OUT1)
unnamed: D6.6 (B), U2.17 (OUT2)
unnamed: D6.4 (C), U2.16 (OUT3)
unnamed: D6.3 (D), U2.15 (OUT4)
unnamed: D6.2 (E), U2.14 (OUT5)
unnamed: D6.9 (F), U2.13 (OUT6)
unnamed: D6.10 (G), U2.12 (OUT7)
unnamed: D7.8 (DP), U2.3 (OUT16)
unnamed: D8.7 (A), U2.2 (OUT17)
unnamed: D8.6 (B), U2.40 (OUT18)
unnamed: D8.4 (C), U2.39 (OUT19)
unnamed: D8.3 (D), U2.38 (OUT20)
unnamed: D8.2 (E), U2.37 (OUT21)
unnamed: D8.9 (F), U2.36 (OUT22)
unnamed: D8.10 (G), U2.35 (OUT23)
unnamed: D8.8 (DP), U2.34 (OUT24)
unnamed: D9.7 (A), U2.33 (OUT25)
unnamed: D9.6 (B), U2.32 (OUT26)
unnamed: D9.4 (C), U2.31 (OUT27)
unnamed: D9.3 (D), U2.30 (OUT28)
unnamed: D9.2 (E), U2.29 (OUT29)
unnamed: D9.9 (F), U2.28 (OUT30)
unnamed: D9.8 (DP), U2.27 (OUT31)

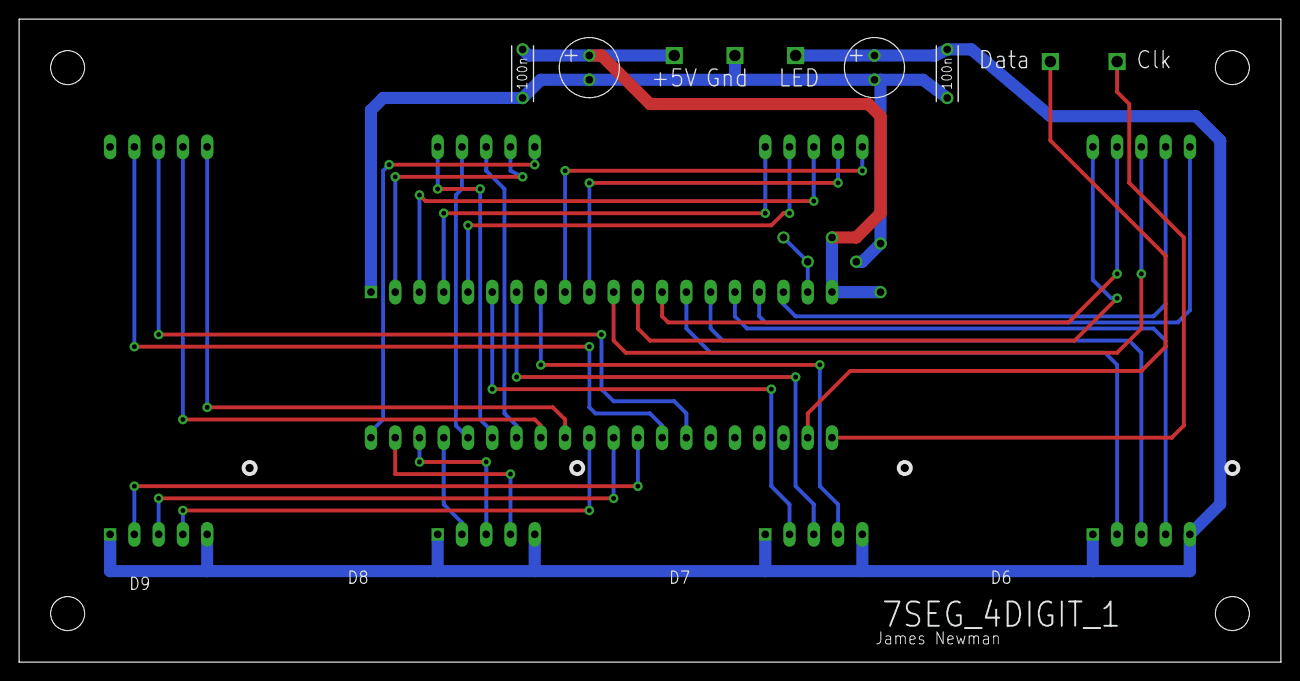
[picture p195: board 7SEG_4DIGIT_1.brd from above]

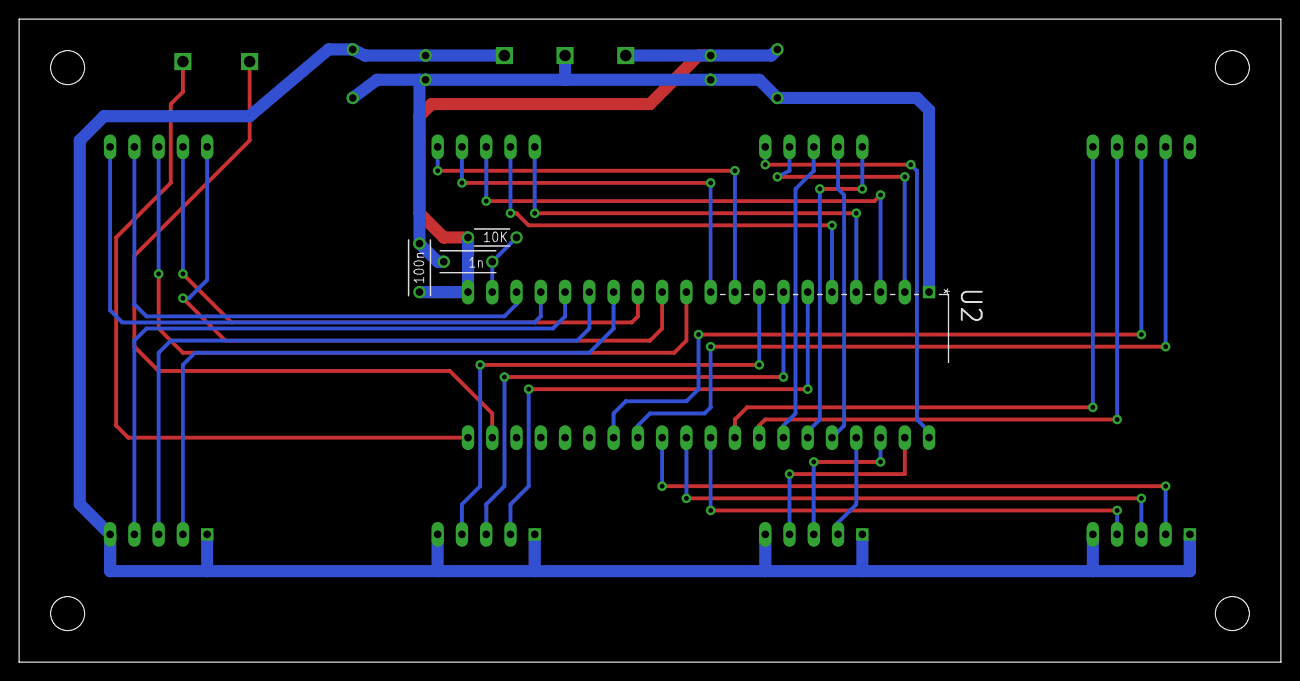
[picture p196: board 7SEG_4DIGIT_1.brd from below]

Board: 2 copper layers, 132.1 x 67.3 mm, 21 parts (4 on the bottom side), 37 nets.
