ericherman/megaprocessor/8x2and_or/8x2AND_OR_1.brd

## EAGLE design 8x2and_or/8x2AND_OR_1.brd (2017-05-20)

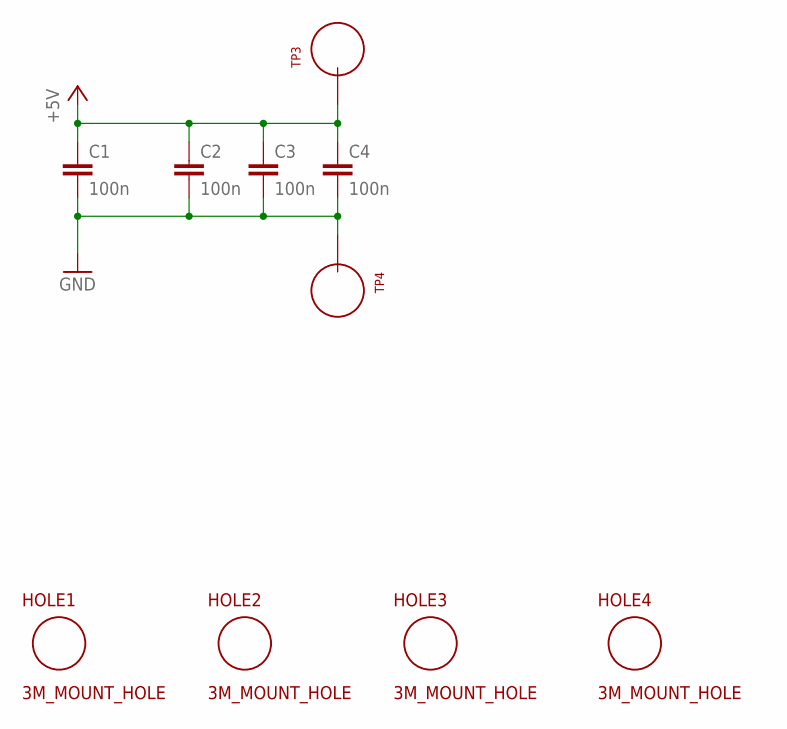
[picture p197: schematic 8x2AND_OR_1.sch, sheet 1]

Parts:
C1, C2, C3, C4: 100n; CAP_P2INCH
HOLE1, HOLE2, HOLE3, HOLE4: 3M_MOUNT_HOLE; 3M_HOLE
TP3, TP4: TEST_LOOP

Connections:
+5V: C1.1, C2.1, C3.1, C4.1, TP3.P$1; also elsewhere on the board
GND: C1.2, C2.2, C3.2, C4.2, TP4.P$1; also elsewhere on the board

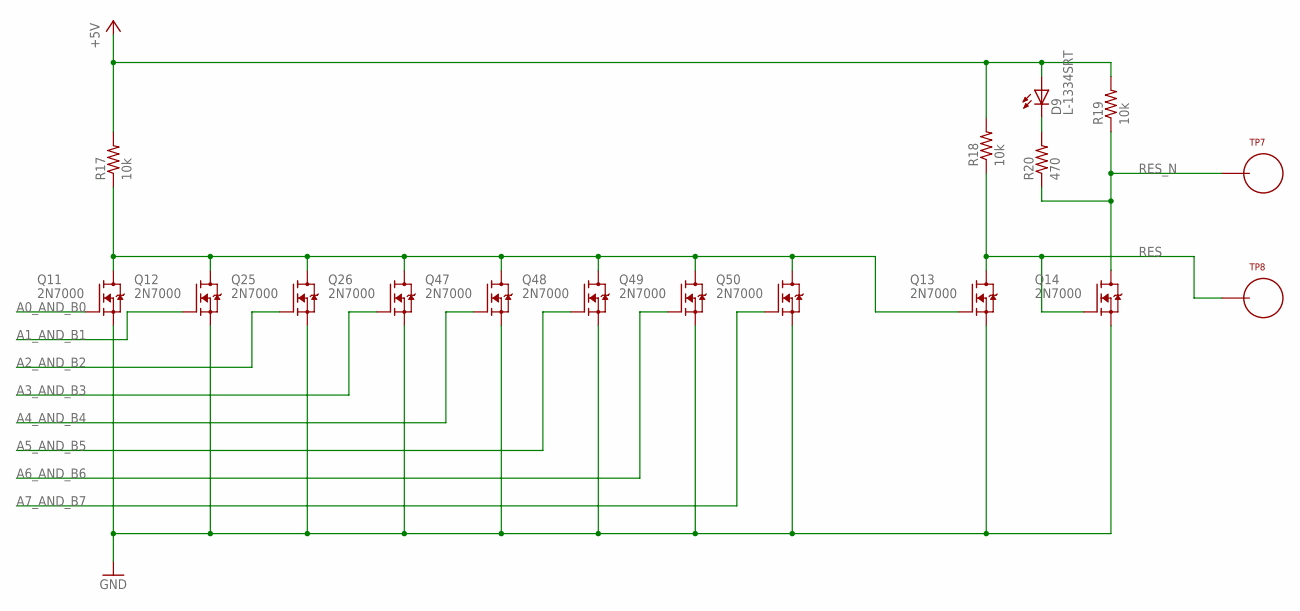
[picture p198: schematic 8x2AND_OR_1.sch, sheet 2]

Parts:
D9: L-1334SRT; LED3MM
Q11, Q12, Q13, Q14, Q25, Q26, Q47, Q48, Q49, Q50: 2N7000; TO92-DGS
R17, R18, R19: 10k; R_P2INCH
R20: 470; R_P2INCH
TP7, TP8: TEST_LOOP

Connections:
+5V: D9.A, R17.2, R18.2, R19.2; also elsewhere on the board
A0_AND_B0: Q11.G; also elsewhere on the board
A1_AND_B1: Q12.G; also elsewhere on the board
A2_AND_B2: Q25.G; also elsewhere on the board
A3_AND_B3: Q26.G; also elsewhere on the board
A4_AND_B4: Q47.G; also elsewhere on the board
A5_AND_B5: Q48.G; also elsewhere on the board
A6_AND_B6: Q49.G; also elsewhere on the board
A7_AND_B7: Q50.G; also elsewhere on the board
GND: Q11.S, Q12.S, Q13.S, Q14.S, Q25.S, Q26.S, Q47.S, Q48.S, Q49.S, Q50.S; also elsewhere on the board
unnamed: Q11.D, Q12.D, Q13.G, Q25.D, Q26.D, Q47.D, Q48.D, Q49.D, Q50.D, R17.1
unnamed: D9.K (C), R20.2
RES: Q13.D, Q14.G, R18.1, TP8.P$1
RES_N: Q14.D, R19.1, R20.1, TP7.P$1
