ericherman/megaprocessor/8x2and_or/8x2AND_OR_1.brd

## EAGLE design 8x2and_or/8x2AND_OR_1.brd (continued)


Parts:
D1, D2, D3, D4, D5, D6, D7, D8: L-1334SRT; LED3MM
Q1, Q2, Q3, Q4, Q5, Q6, Q7, Q8, Q9, Q10: 2N7000; TO92-DGS
R1, R3, R5, R6, R9, R11, R13, R14: 10k; R_P2INCH
R2, R4, R7, R8, R10, R12, R15, R16: 470; R_P2INCH
TP1, TP2, TP5, TP6: TEST_LOOP

Connections:
+5V: D1.A, D2.A, D3.A, D4.A, D5.A, D6.A, D7.A, D8.A, R1.2, R3.2, R5.2, R6.2, R9.2, R11.2, R13.2, R14.2; also elsewhere on the board
A0: Q1.G, TP1.P$1
A0_AND_B0: Q3.D, Q4.D, Q5.G, R5.1; also elsewhere on the board
A0_AND_B0_N: Q5.D, R6.1, R7.1, R8.1
A1: Q6.G, TP5.P$1
A1_AND_B1: Q8.D, Q9.D, Q10.G, R13.1; also elsewhere on the board
A1_AND_B1_N: Q10.D, R14.1, R15.1, R16.1
B0: Q2.G, TP2.P$1
B1: Q7.G, TP6.P$1
GND: Q1.S, Q2.S, Q3.S, Q4.S, Q5.S, Q6.S, Q7.S, Q8.S, Q9.S, Q10.S; also elsewhere on the board
unnamed: D1.K (C), R2.2
unnamed: Q1.D, Q3.G, R1.1, R2.1
unnamed: D4.K (C), R8.2
unnamed: D2.K (C), R4.2
unnamed: Q2.D, Q4.G, R3.1, R4.1
unnamed: D5.K (C), R10.2
unnamed: Q6.D, Q8.G, R9.1, R10.1
unnamed: D6.K (C), R12.2
unnamed: D3.K (C), R7.2
unnamed: Q7.D, Q9.G, R11.1, R12.1
unnamed: D7.K (C), R15.2
unnamed: D8.K (C), R16.2

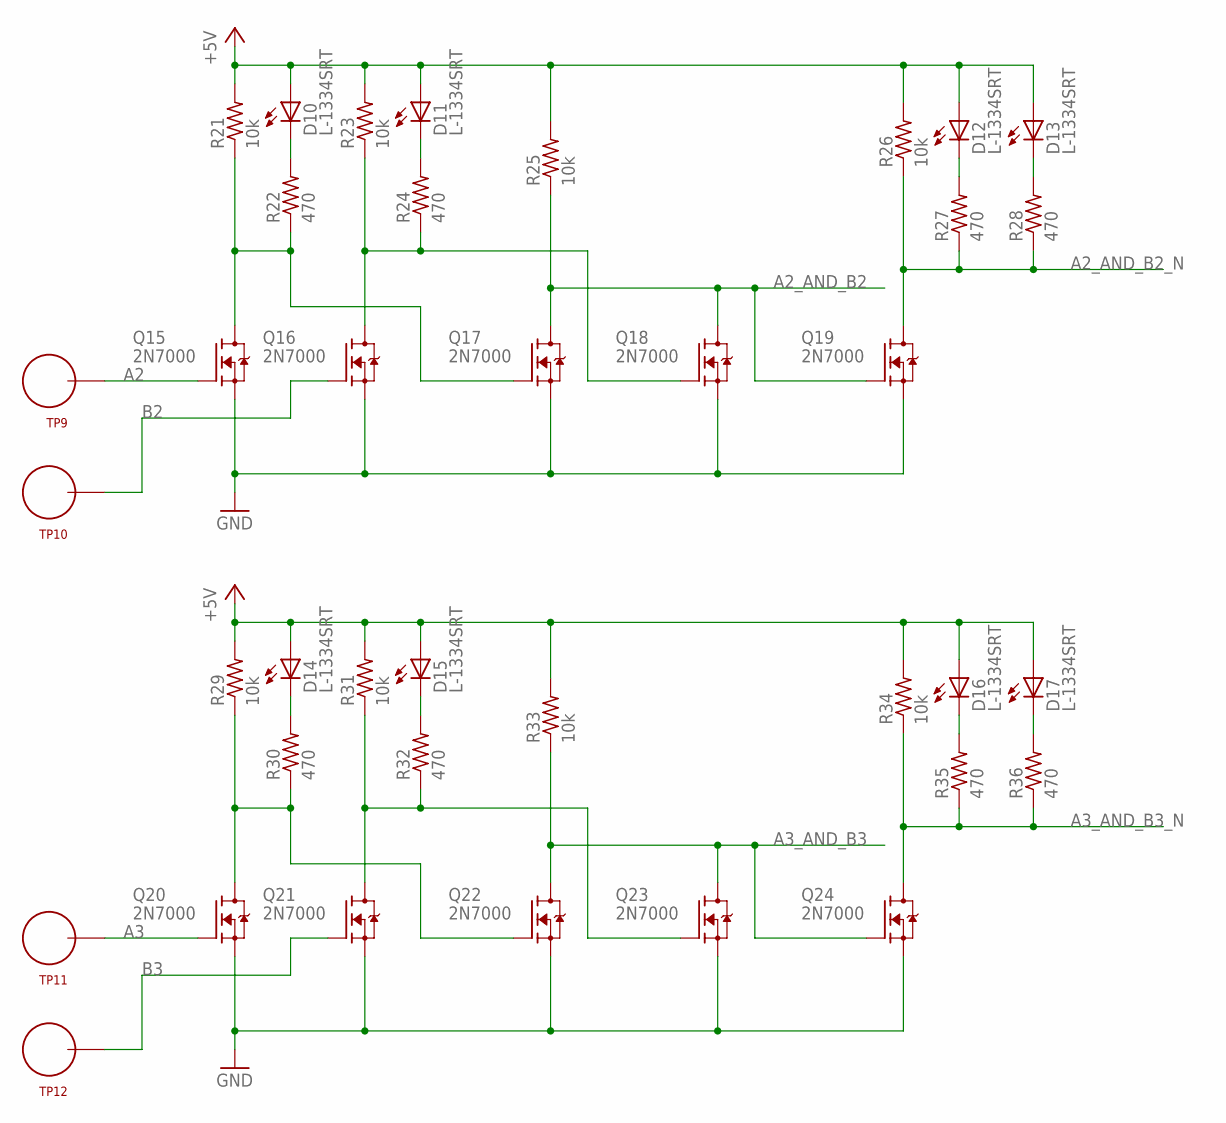
[picture p199: schematic 8x2AND_OR_1.sch, sheet 4]

Parts:
D10, D11, D12, D13, D14, D15, D16, D17: L-1334SRT; LED3MM
Q15, Q16, Q17, Q18, Q19, Q20, Q21, Q22, Q23, Q24: 2N7000; TO92-DGS
R21, R23, R25, R26, R29, R31, R33, R34: 10k; R_P2INCH
R22, R24, R27, R28, R30, R32, R35, R36: 470; R_P2INCH
TP9, TP10, TP11, TP12: TEST_LOOP

Connections:
+5V: D10.A, D11.A, D12.A, D13.A, D14.A, D15.A, D16.A, D17.A, R21.2, R23.2, R25.2, R26.2, R29.2, R31.2, R33.2, R34.2; also elsewhere on the board
A2: Q15.G, TP9.P$1
A2_AND_B2: Q17.D, Q18.D, Q19.G, R25.1; also elsewhere on the board
A2_AND_B2_N: Q19.D, R26.1, R27.1, R28.1
A3: Q20.G, TP11.P$1
A3_AND_B3: Q22.D, Q23.D, Q24.G, R33.1; also elsewhere on the board
A3_AND_B3_N: Q24.D, R34.1, R35.1, R36.1
B2: Q16.G, TP10.P$1
B3: Q21.G, TP12.P$1
GND: Q15.S, Q16.S, Q17.S, Q18.S, Q19.S, Q20.S, Q21.S, Q22.S, Q23.S, Q24.S; also elsewhere on the board
unnamed: D10.K (C), R22.2
unnamed: Q15.D, Q17.G, R21.1, R22.1
unnamed: D11.K (C), R24.2
unnamed: Q16.D, Q18.G, R23.1, R24.1
unnamed: D12.K (C), R27.2
unnamed: D13.K (C), R28.2
unnamed: D14.K (C), R30.2
unnamed: Q20.D, Q22.G, R29.1, R30.1
unnamed: D15.K (C), R32.2
unnamed: Q21.D, Q23.G, R31.1, R32.1
unnamed: D16.K (C), R35.2
unnamed: D17.K (C), R36.2

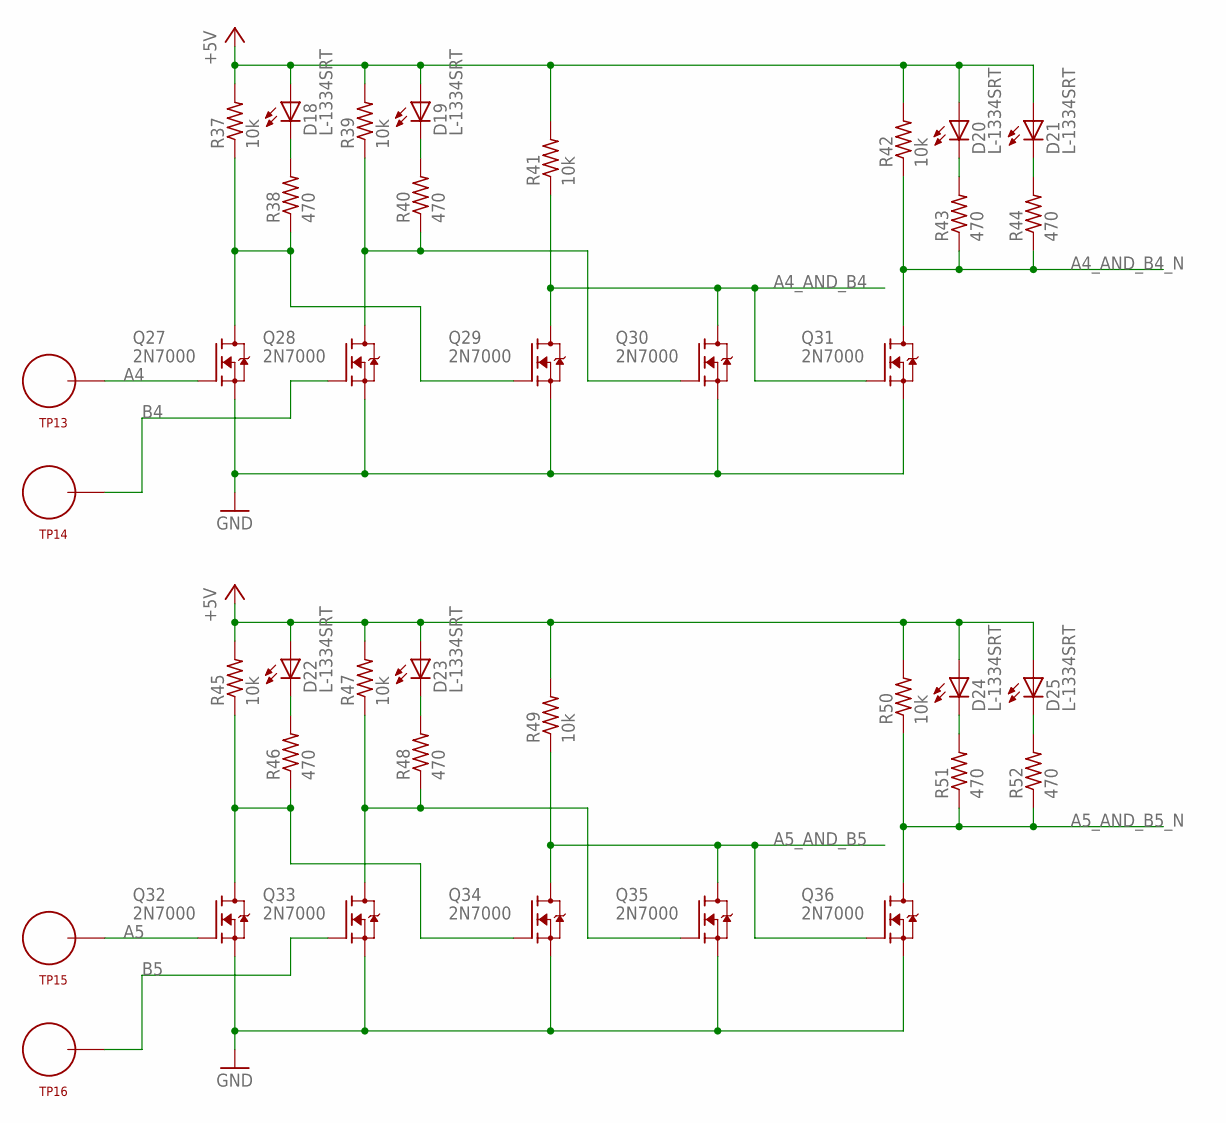
[picture p200: schematic 8x2AND_OR_1.sch, sheet 5]

Parts:
D18, D19, D20, D21, D22, D23, D24, D25: L-1334SRT; LED3MM
Q27, Q28, Q29, Q30, Q31, Q32, Q33, Q34, Q35, Q36: 2N7000; TO92-DGS
R37, R39, R41, R42, R45, R47, R49, R50: 10k; R_P2INCH
R38, R40, R43, R44, R46, R48, R51, R52: 470; R_P2INCH
TP13, TP14, TP15, TP16: TEST_LOOP

Connections:
+5V: D18.A, D19.A, D20.A, D21.A, D22.A, D23.A, D24.A, D25.A, R37.2, R39.2, R41.2, R42.2, R45.2, R47.2, R49.2, R50.2; also elsewhere on the board
A4: Q27.G, TP13.P$1
A4_AND_B4: Q29.D, Q30.D, Q31.G, R41.1; also elsewhere on the board
A4_AND_B4_N: Q31.D, R42.1, R43.1, R44.1
A5: Q32.G, TP15.P$1
A5_AND_B5: Q34.D, Q35.D, Q36.G, R49.1; also elsewhere on the board
A5_AND_B5_N: Q36.D, R50.1, R51.1, R52.1
B4: Q28.G, TP14.P$1
B5: Q33.G, TP16.P$1
GND: Q27.S, Q28.S, Q29.S, Q30.S, Q31.S, Q32.S, Q33.S, Q34.S, Q35.S, Q36.S; also elsewhere on the board
unnamed: D18.K (C), R38.2
unnamed: Q27.D, Q29.G, R37.1, R38.1
unnamed: D19.K (C), R40.2
unnamed: Q28.D, Q30.G, R39.1, R40.1
unnamed: D20.K (C), R43.2
unnamed: D21.K (C), R44.2
unnamed: D22.K (C), R46.2
unnamed: Q32.D, Q34.G, R45.1, R46.1
unnamed: D23.K (C), R48.2
unnamed: Q33.D, Q35.G, R47.1, R48.1
unnamed: D24.K (C), R51.2
unnamed: D25.K (C), R52.2

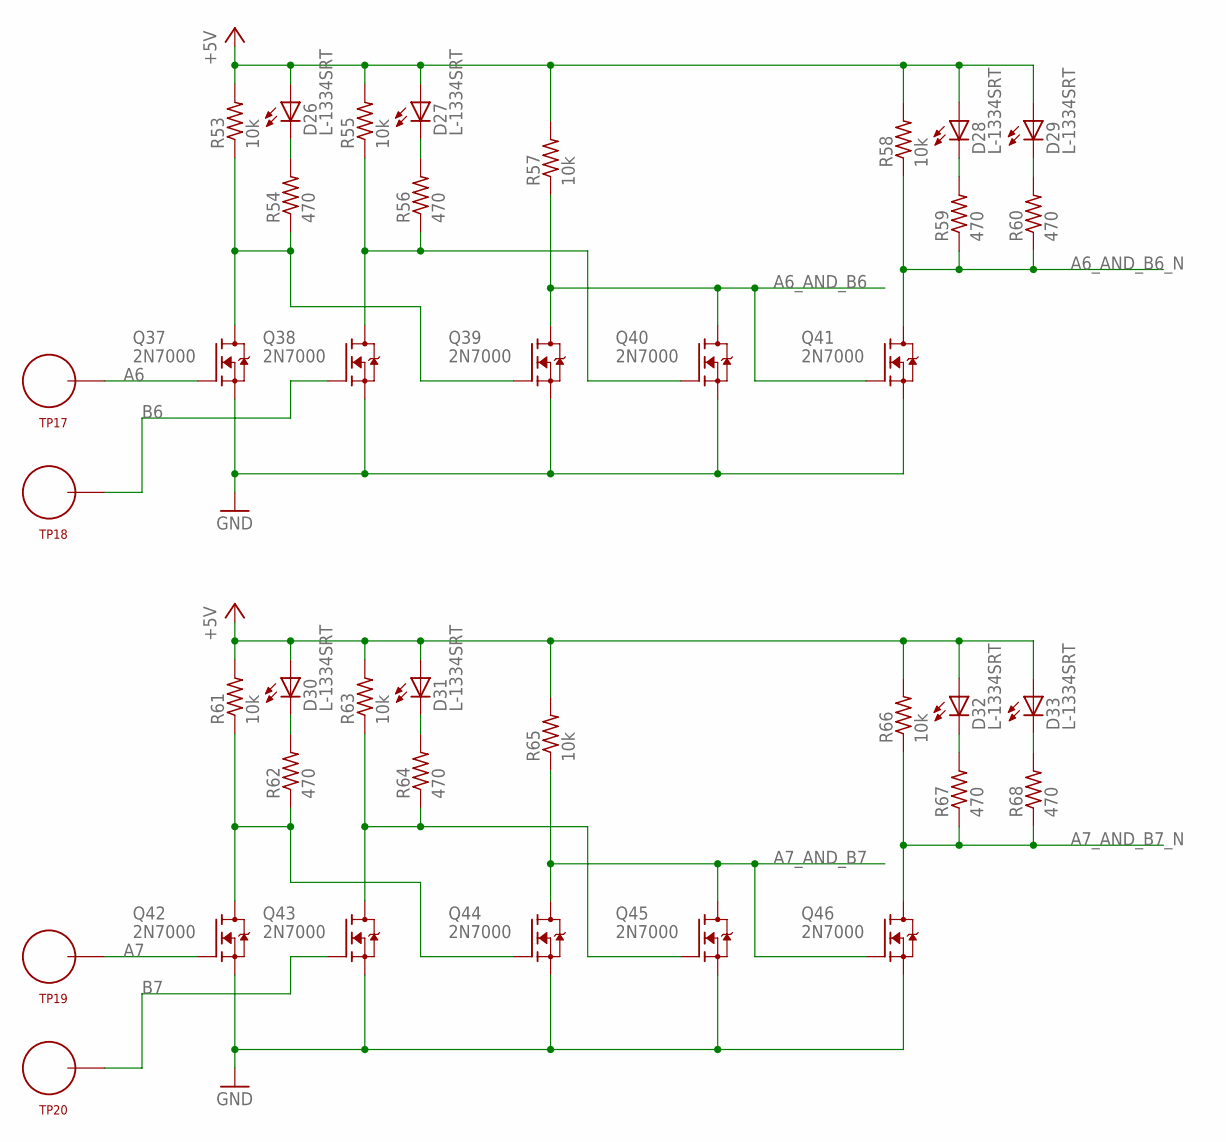
[picture p201: schematic 8x2AND_OR_1.sch, sheet 6]

Parts:
D26, D27, D28, D29, D30, D31, D32, D33: L-1334SRT; LED3MM
Q37, Q38, Q39, Q40, Q41, Q42, Q43, Q44, Q45, Q46: 2N7000; TO92-DGS
R53, R55, R57, R58, R61, R63, R65, R66: 10k; R_P2INCH
R54, R56, R59, R60, R62, R64, R67, R68: 470; R_P2INCH
TP17, TP18, TP19, TP20: TEST_LOOP

Connections:
+5V: D26.A, D27.A, D28.A, D29.A, D30.A, D31.A, D32.A, D33.A, R53.2, R55.2, R57.2, R58.2, R61.2, R63.2, R65.2, R66.2; also elsewhere on the board
A6: Q37.G, TP17.P$1
A6_AND_B6: Q39.D, Q40.D, Q41.G, R57.1; also elsewhere on the board
A6_AND_B6_N: Q41.D, R58.1, R59.1, R60.1
A7: Q42.G, TP19.P$1
A7_AND_B7: Q44.D, Q45.D, Q46.G, R65.1; also elsewhere on the board
A7_AND_B7_N: Q46.D, R66.1, R67.1, R68.1
B6: Q38.G, TP18.P$1
B7: Q43.G, TP20.P$1
GND: Q37.S, Q38.S, Q39.S, Q40.S, Q41.S, Q42.S, Q43.S, Q44.S, Q45.S, Q46.S; also elsewhere on the board
unnamed: D26.K (C), R54.2
unnamed: Q37.D, Q39.G, R53.1, R54.1
unnamed: D27.K (C), R56.2
unnamed: Q38.D, Q40.G, R55.1, R56.1
unnamed: D28.K (C), R59.2
unnamed: D29.K (C), R60.2
unnamed: D30.K (C), R62.2
unnamed: Q42.D, Q44.G, R61.1, R62.1
unnamed: D31.K (C), R64.2
unnamed: Q43.D, Q45.G, R63.1, R64.1
unnamed: D32.K (C), R67.2
unnamed: D33.K (C), R68.2

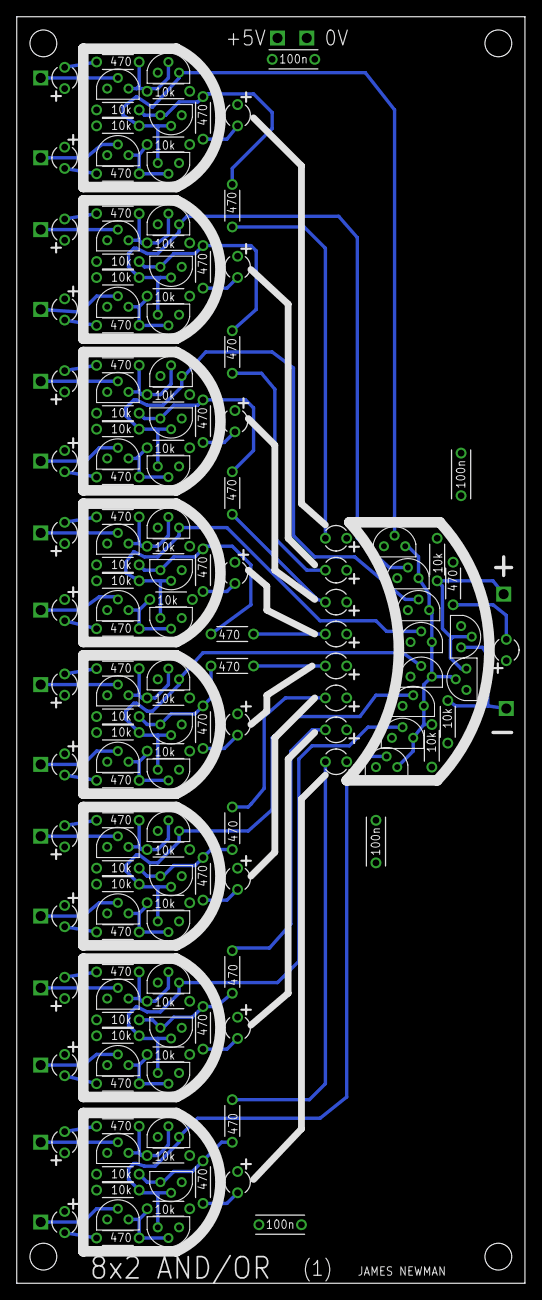
[picture p202: board 8x2AND_OR_1.brd from above]

Board: 4 copper layers, 60.6 x 151.1 mm, 179 parts (0 on the bottom side), 86 nets.
