ericherman/megaprocessor/services/SERVICES_1.brd

## EAGLE design services/SERVICES_1.brd (2017-05-20)

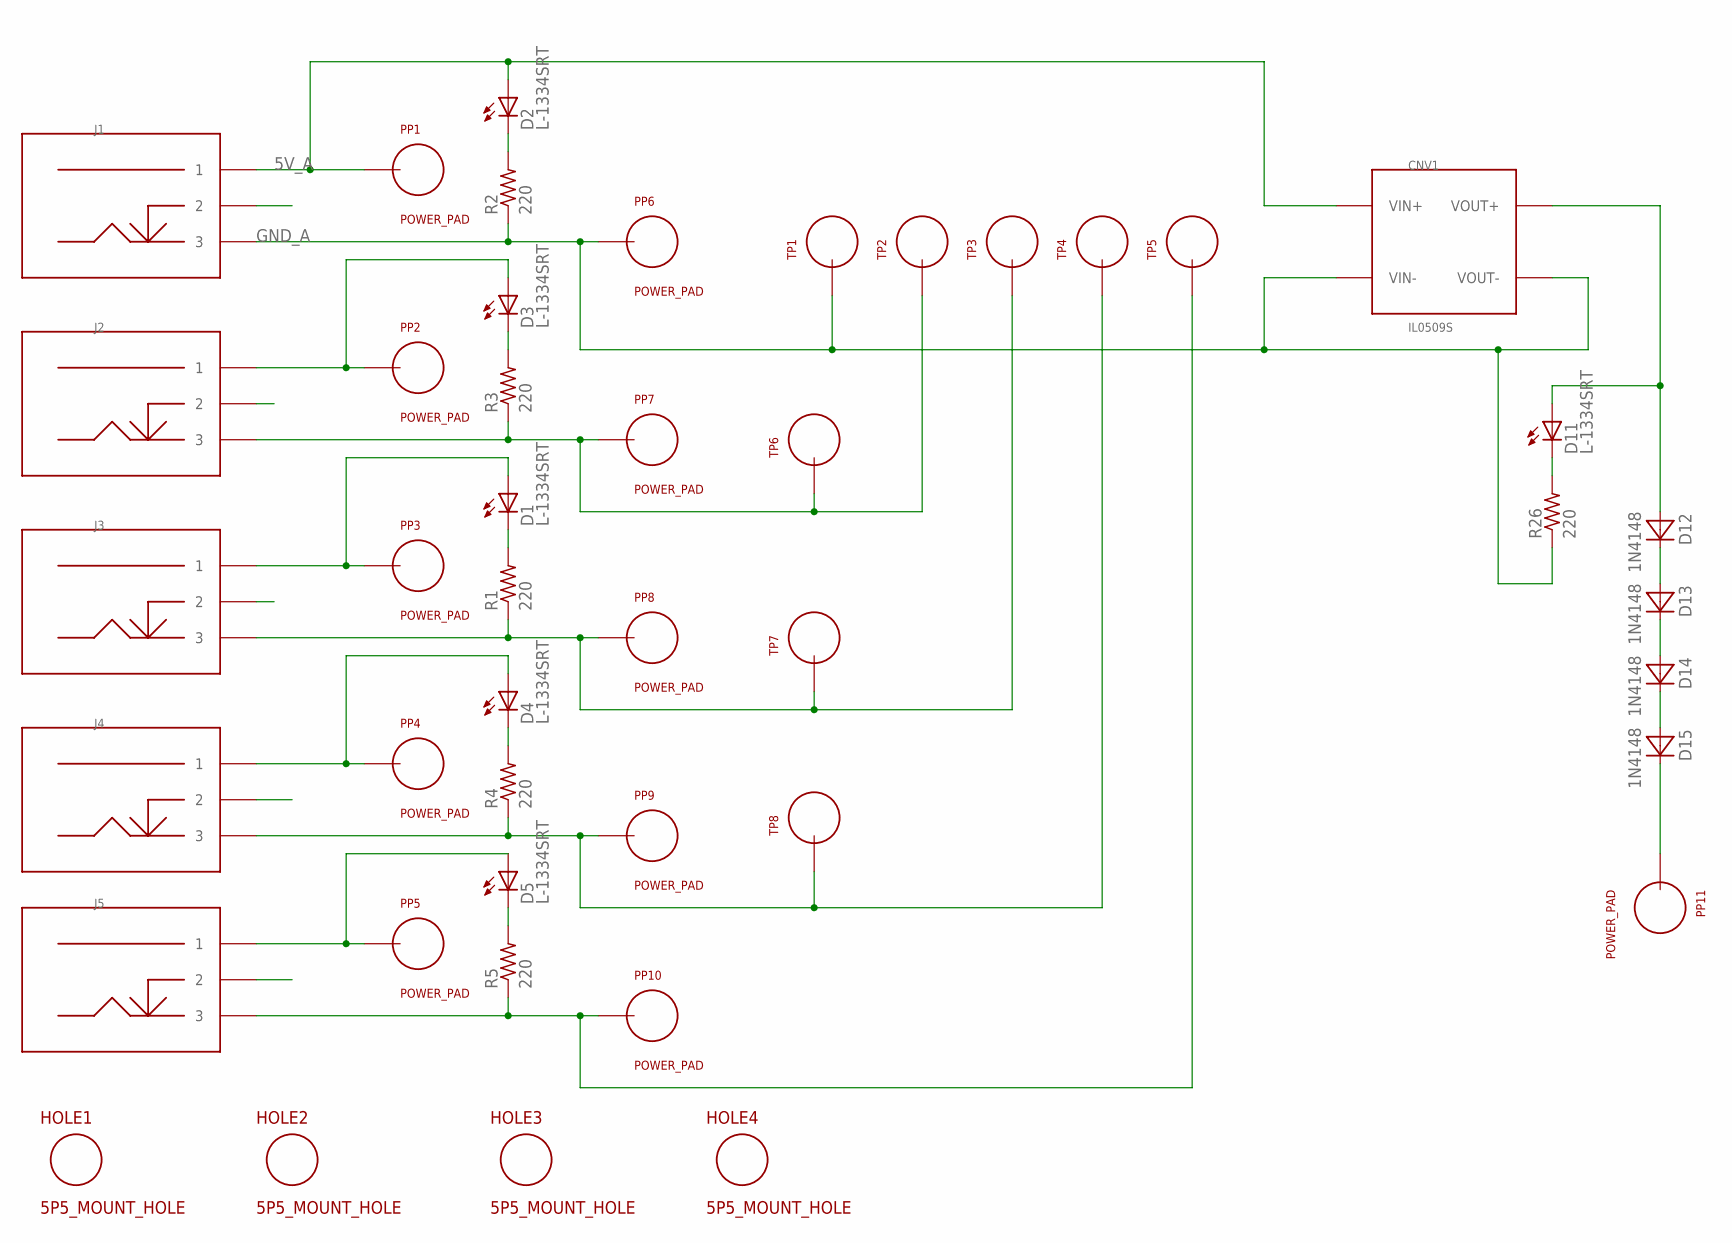
[picture p203: schematic SERVICES_1.sch, sheet 1]

Parts:
CNV1: IL0509S; SIL_IL
D1, D2, D3, D4, D5, D11: L-1334SRT; LED3MM
D12, D13, D14, D15: 1N4148; DO34-5
HOLE1, HOLE2, HOLE3, HOLE4: 5P5_MOUNT_HOLE; 5P5M_HOLE
J1, J2, J3, J4, J5: POWER_ENTRY; POWER_25
PP1, PP2, PP3, PP4, PP5, PP6, PP7, PP8, PP9, PP10, PP11: POWER_PAD
R1, R2, R3, R4, R5, R26: 220; R_P2INCH
TP1, TP2, TP3, TP4, TP5, TP6, TP7, TP8: TEST_LOOP

Connections:
5V_A: CNV1.VIN+, D2.A, J1.1, PP1.1; also elsewhere on the board
GND_A: CNV1.VIN-, CNV1.VOUT-, J1.3, PP6.1, R2.1, R26.1, TP1.P$1; also elsewhere on the board
unnamed: D3.A, J2.1, PP2.1
unnamed: D1.A, J3.1, PP3.1
unnamed: D4.A, J4.1, PP4.1
unnamed: D5.A, J5.1, PP5.1
unnamed: J2.3, PP7.1, R3.1, TP2.P$1, TP6.P$1
unnamed: J3.3, PP8.1, R1.1, TP3.P$1, TP7.P$1
unnamed: J4.3, PP9.1, R4.1, TP4.P$1, TP8.P$1
unnamed: J5.3, PP10.1, R5.1, TP5.P$1
unnamed: CNV1.VOUT+, D11.A, D12.A
unnamed: D1.K (C), R1.2
unnamed: D2.K (C), R2.2
unnamed: D3.K (C), R3.2
unnamed: D4.K (C), R4.2
unnamed: D5.K (C), R5.2
unnamed: D11.K (C), R26.2
unnamed: D12.C, D13.A
unnamed: D13.C, D14.A
unnamed: D14.C, D15.A
unnamed: D15.C, PP11.1

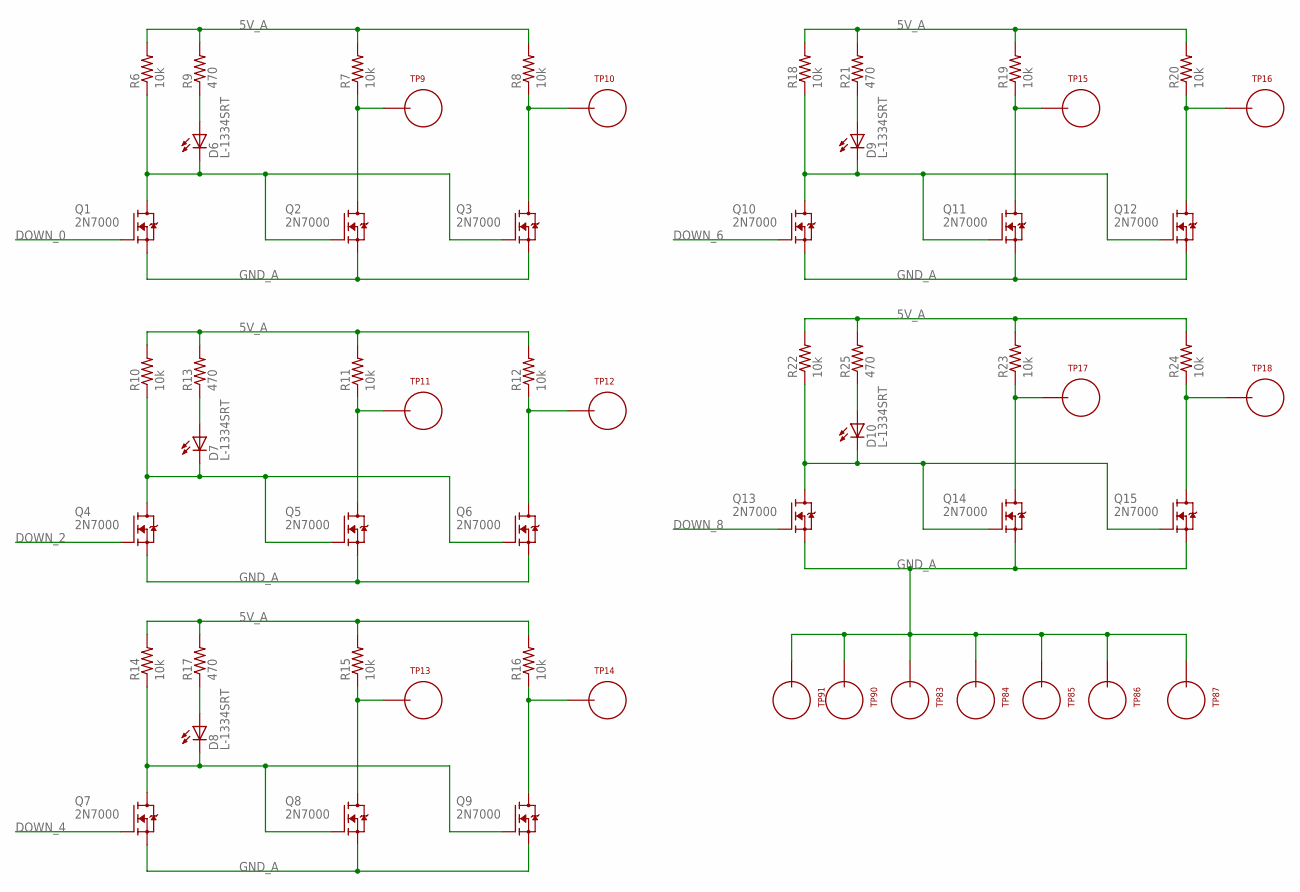
[picture p204: schematic SERVICES_1.sch, sheet 2]

Parts:
D6, D7, D8, D9, D10: L-1334SRT; LED3MM
Q1, Q2, Q3, Q4, Q5, Q6, Q7, Q8, Q9, Q10, Q11, Q12, Q13, Q14, Q15: 2N7000; TO92-DGS
R6, R7, R8, R10, R11, R12, R14, R15, R16, R18, R19, R20, R22, R23, R24: 10k; R_P2INCH
R9, R13, R17, R21, R25: 470; R_P2INCH
TP9, TP10, TP11, TP12, TP13, TP14, TP15, TP16, TP17, TP18, TP83, TP84, TP85, TP86, TP87, TP90, TP91: TEST_LOOP

Connections:
5V_A: R6.2, R7.2, R8.2, R9.2, R10.2, R11.2, R12.2, R13.2, R14.2, R15.2, R16.2, R17.2, R18.2, R19.2, R20.2, R21.2, R22.2, R23.2, R24.2, R25.2; also elsewhere on the board
DOWN_0: Q1.G; also elsewhere on the board
DOWN_2: Q4.G; also elsewhere on the board
DOWN_4: Q7.G; also elsewhere on the board
DOWN_6: Q10.G; also elsewhere on the board
DOWN_8: Q13.G; also elsewhere on the board
GND_A: Q1.S, Q2.S, Q3.S, Q4.S, Q5.S, Q6.S, Q7.S, Q8.S, Q9.S, Q10.S, Q11.S, Q12.S, Q13.S, Q14.S, Q15.S, TP83.P$1, TP84.P$1, TP85.P$1, TP86.P$1, TP87.P$1, TP90.P$1, TP91.P$1; also elsewhere on the board
unnamed: D7.A, R13.1
unnamed: Q5.D, R11.1, TP11.P$1
unnamed: Q6.D, R12.1, TP12.P$1
unnamed: D6.A, R9.1
unnamed: Q2.D, R7.1, TP9.P$1
unnamed: Q3.D, R8.1, TP10.P$1
unnamed: D6.K (C), Q1.D, Q2.G, Q3.G, R6.1
unnamed: D7.K (C), Q4.D, Q5.G, Q6.G, R10.1
unnamed: D8.A, R17.1
unnamed: Q8.D, R15.1, TP13.P$1
unnamed: Q9.D, R16.1, TP14.P$1
unnamed: D8.K (C), Q7.D, Q8.G, Q9.G, R14.1
unnamed: D9.A, R21.1
unnamed: Q11.D, R19.1, TP15.P$1
unnamed: Q12.D, R20.1, TP16.P$1
unnamed: D9.K (C), Q10.D, Q11.G, Q12.G, R18.1
unnamed: D10.A, R25.1
unnamed: Q14.D, R23.1, TP17.P$1
unnamed: Q15.D, R24.1, TP18.P$1
unnamed: D10.K (C), Q13.D, Q14.G, Q15.G, R22.1

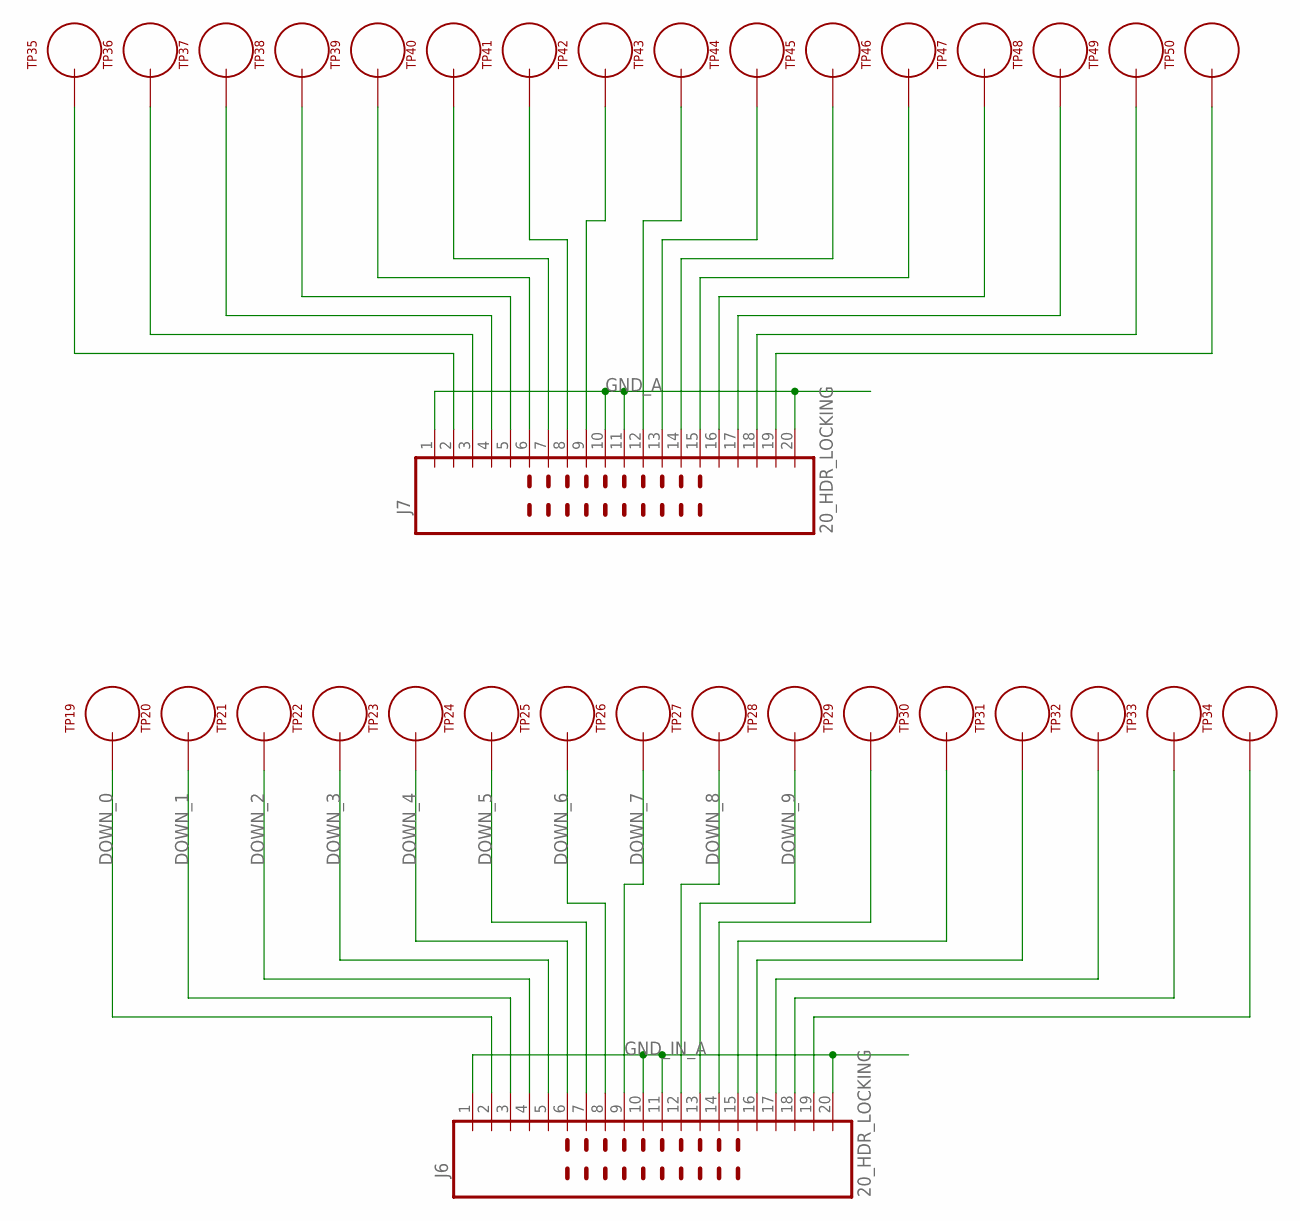
[picture p205: schematic SERVICES_1.sch, sheet 3]

Parts:
J6, J7: 20_HDR_LOCKING
TP19, TP20, TP21, TP22, TP23, TP24, TP25, TP26, TP27, TP28, TP29, TP30, TP31, TP32, TP33, TP34, TP35, TP36, TP37, TP38, TP39, TP40, TP41, TP42, TP43, TP44, TP45, TP46, TP47, TP48, TP49, TP50: TEST_LOOP

Connections:
DOWN_0: J6.2, TP19.P$1; also elsewhere on the board
DOWN_1: J6.3, TP20.P$1
DOWN_2: J6.4, TP21.P$1; also elsewhere on the board
DOWN_3: J6.5, TP22.P$1
DOWN_4: J6.6, TP23.P$1; also elsewhere on the board
DOWN_5: J6.7, TP24.P$1
DOWN_6: J6.8, TP25.P$1; also elsewhere on the board
DOWN_7: J6.9, TP26.P$1
DOWN_8: J6.12, TP27.P$1; also elsewhere on the board
DOWN_9: J6.13, TP28.P$1
GND_A: J7.1, J7.10, J7.11, J7.20; also elsewhere on the board
GND_IN_A: J6.1, J6.10, J6.11, J6.20
unnamed: J6.19, TP34.P$1
unnamed: J6.18, TP33.P$1
unnamed: J6.17, TP32.P$1
unnamed: J6.16, TP31.P$1
unnamed: J6.15, TP30.P$1
unnamed: J6.14, TP29.P$1
unnamed: J7.2, TP35.P$1
unnamed: J7.3, TP36.P$1
unnamed: J7.4, TP37.P$1
unnamed: J7.5, TP38.P$1
unnamed: J7.6, TP39.P$1
unnamed: J7.7, TP40.P$1
unnamed: J7.8, TP41.P$1
unnamed: J7.19, TP50.P$1
unnamed: J7.18, TP49.P$1
unnamed: J7.17, TP48.P$1
unnamed: J7.16, TP47.P$1
unnamed: J7.15, TP46.P$1
unnamed: J7.14, TP45.P$1
unnamed: J7.13, TP44.P$1
unnamed: J7.12, TP43.P$1
unnamed: J7.9, TP42.P$1

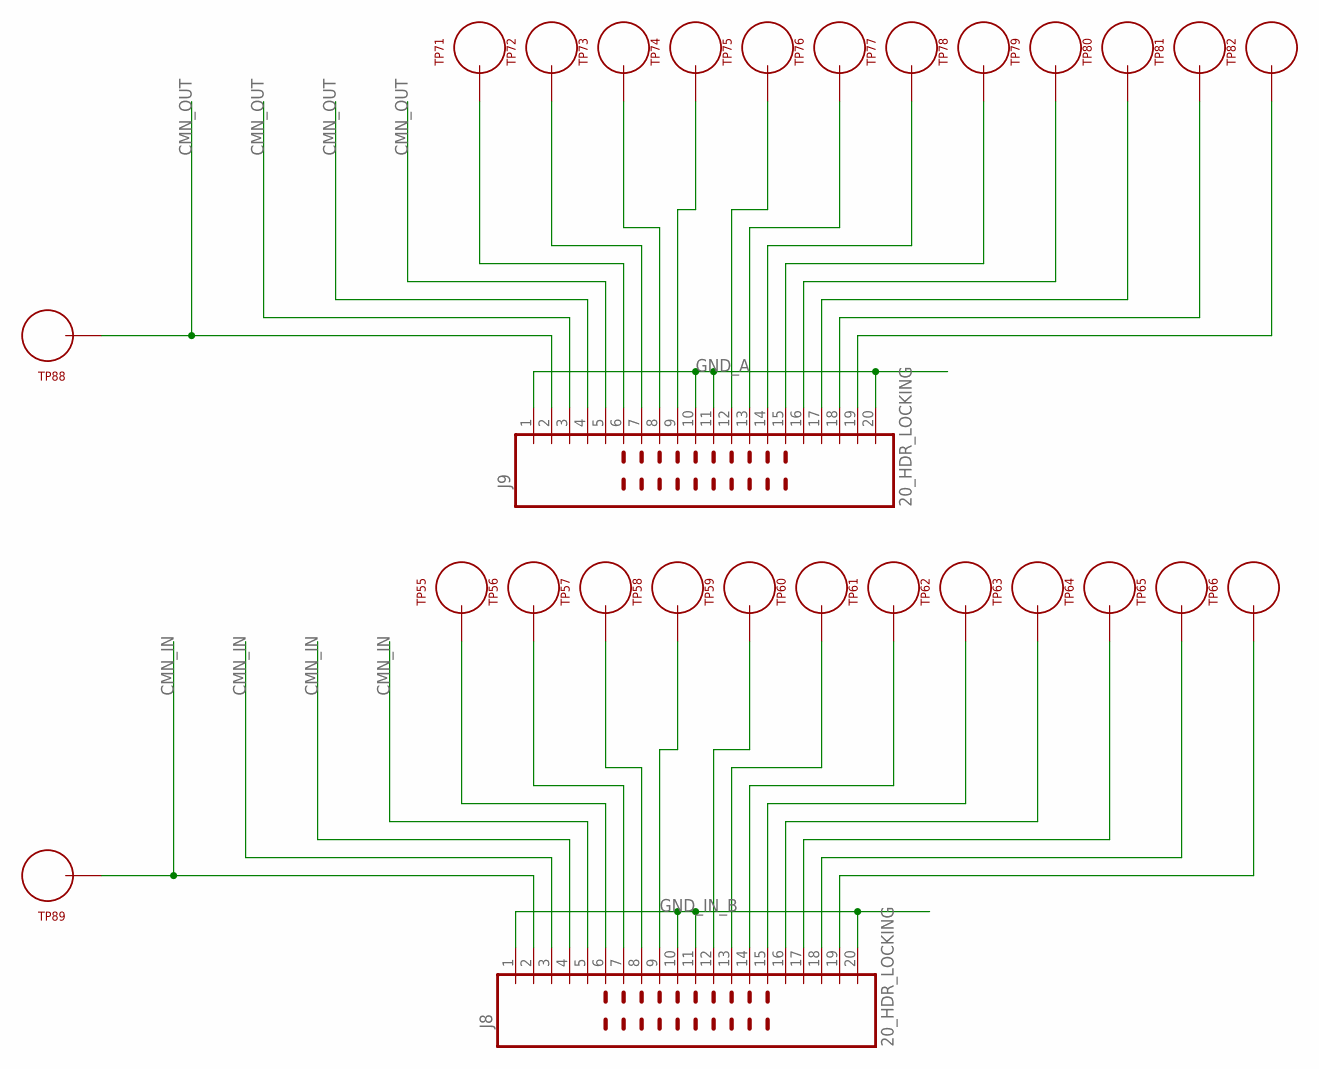
[picture p206: schematic SERVICES_1.sch, sheet 4]

Parts:
J8, J9: 20_HDR_LOCKING
TP55, TP56, TP57, TP58, TP59, TP60, TP61, TP62, TP63, TP64, TP65, TP66, TP71, TP72, TP73, TP74, TP75, TP76, TP77, TP78, TP79, TP80, TP81, TP82, TP88, TP89: TEST_LOOP

Connections:
CMN_IN: J8.2, J8.3, J8.4, J8.5, TP89.P$1
CMN_OUT: J9.2, J9.3, J9.4, J9.5, TP88.P$1
GND_A: J9.1, J9.10, J9.11, J9.20; also elsewhere on the board
GND_IN_B: J8.1, J8.10, J8.11, J8.20
unnamed: J8.6, TP55.P$1
unnamed: J8.7, TP56.P$1
unnamed: J8.8, TP57.P$1
unnamed: J8.19, TP66.P$1
unnamed: J8.18, TP65.P$1
unnamed: J8.17, TP64.P$1
unnamed: J8.16, TP63.P$1
unnamed: J8.15, TP62.P$1
unnamed: J8.14, TP61.P$1
unnamed: J8.13, TP60.P$1
unnamed: J8.12, TP59.P$1
unnamed: J8.9, TP58.P$1
unnamed: J9.6, TP71.P$1
unnamed: J9.7, TP72.P$1
unnamed: J9.8, TP73.P$1
unnamed: J9.19, TP82.P$1
unnamed: J9.18, TP81.P$1
unnamed: J9.17, TP80.P$1
unnamed: J9.16, TP79.P$1
unnamed: J9.15, TP78.P$1
unnamed: J9.14, TP77.P$1
unnamed: J9.13, TP76.P$1
unnamed: J9.12, TP75.P$1
unnamed: J9.9, TP74.P$1

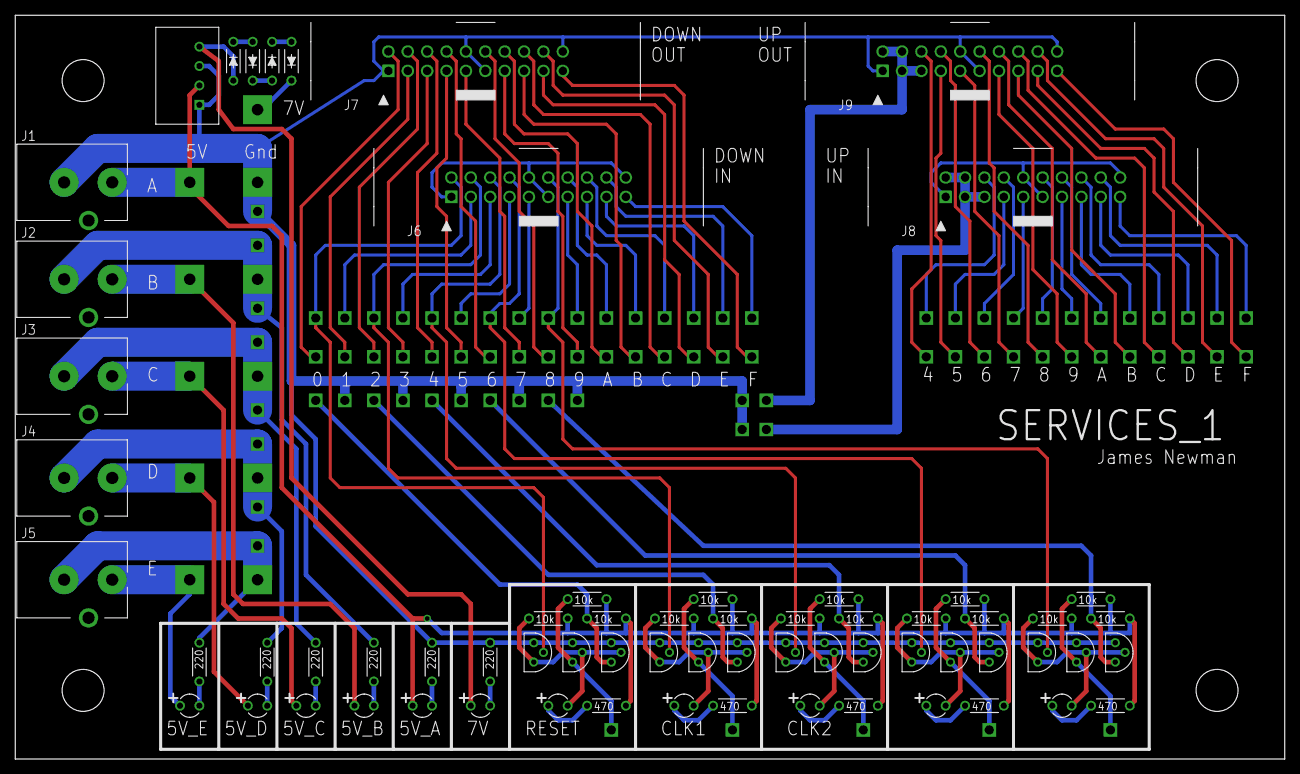
[picture p207: board SERVICES_1.brd from above]

Board: 2 copper layers, 166.3 x 97.5 mm, 164 parts (0 on the bottom side), 101 nets.
