ericherman/megaprocessor/module_artwork_decoding_b/module_decoding_b.brd

## EAGLE design module_artwork_decoding_b/module_decoding_b.brd (2017-05-20)

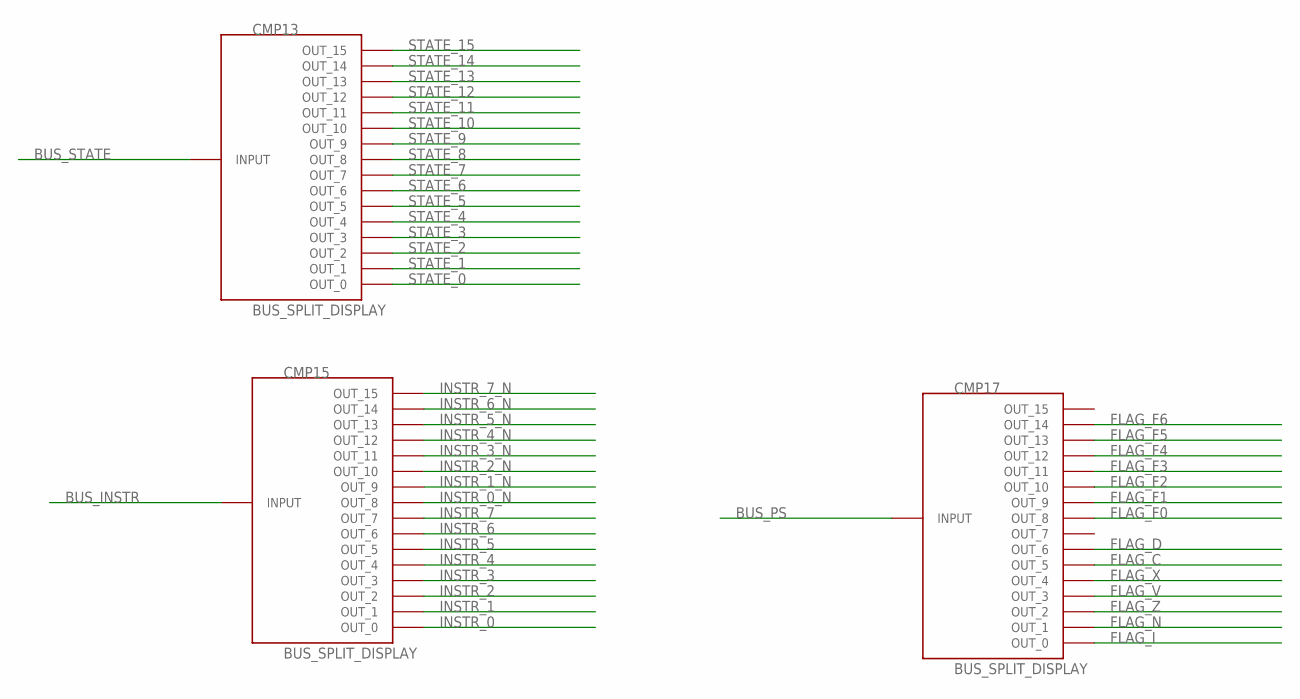
[picture p208: schematic module_decoding_b.sch, sheet 1]

Parts:
CMP13, CMP15, CMP17: BUS_SPLIT_DISPLAY

Connections:
BUS_INSTR: CMP15.INPUT
BUS_PS: CMP17.INPUT
BUS_STATE: CMP13.INPUT
FLAG_C: CMP17.P$6 (OUT_5)
FLAG_D: CMP17.P$7 (OUT_6)
FLAG_F0: CMP17.P$9 (OUT_8); also elsewhere on the board
FLAG_F1: CMP17.P$10 (OUT_9); also elsewhere on the board
FLAG_F2: CMP17.P$11 (OUT_10)
FLAG_F3: CMP17.P$12 (OUT_11); also elsewhere on the board
FLAG_F4: CMP17.P$13 (OUT_12)
FLAG_F5: CMP17.P$14 (OUT_13)
FLAG_F6: CMP17.P$15 (OUT_14)
FLAG_I: CMP17.P$1 (OUT_0)
FLAG_N: CMP17.P$2 (OUT_1)
FLAG_V: CMP17.P$4 (OUT_3)
FLAG_X: CMP17.P$5 (OUT_4); also elsewhere on the board
FLAG_Z: CMP17.P$3 (OUT_2)
INSTR_0: CMP15.P$1 (OUT_0)
INSTR_0_N: CMP15.P$9 (OUT_8)
INSTR_1: CMP15.P$2 (OUT_1)
INSTR_1_N: CMP15.P$10 (OUT_9)
INSTR_2: CMP15.P$3 (OUT_2)
INSTR_2_N: CMP15.P$11 (OUT_10); also elsewhere on the board
INSTR_3: CMP15.P$4 (OUT_3); also elsewhere on the board
INSTR_3_N: CMP15.P$12 (OUT_11)
INSTR_4: CMP15.P$5 (OUT_4)
INSTR_4_N: CMP15.P$13 (OUT_12)
INSTR_5: CMP15.P$6 (OUT_5)
INSTR_5_N: CMP15.P$14 (OUT_13)
INSTR_6: CMP15.P$7 (OUT_6)
INSTR_6_N: CMP15.P$15 (OUT_14)
INSTR_7: CMP15.P$8 (OUT_7)
INSTR_7_N: CMP15.P$16 (OUT_15)
STATE_0: CMP13.P$1 (OUT_0); also elsewhere on the board
STATE_1: CMP13.P$2 (OUT_1)
STATE_2: CMP13.P$3 (OUT_2); also elsewhere on the board
STATE_3: CMP13.P$4 (OUT_3); also elsewhere on the board
STATE_4: CMP13.P$5 (OUT_4)
STATE_5: CMP13.P$6 (OUT_5); also elsewhere on the board
STATE_6: CMP13.P$7 (OUT_6)
STATE_7: CMP13.P$8 (OUT_7); also elsewhere on the board
STATE_8: CMP13.P$9 (OUT_8)
STATE_9: CMP13.P$10 (OUT_9)
STATE_10: CMP13.P$11 (OUT_10)
STATE_11: CMP13.P$12 (OUT_11)
STATE_12: CMP13.P$13 (OUT_12)
STATE_13: CMP13.P$14 (OUT_13); also elsewhere on the board
STATE_14: CMP13.P$15 (OUT_14)
STATE_15: CMP13.P$16 (OUT_15)
