ericherman/megaprocessor/module_artwork_decoding_b/module_decoding_b.brd

## EAGLE design module_artwork_decoding_b/module_decoding_b.brd (continued)


Parts:
CMP2, CMP35: BUS_SPLIT_DISPLAY

Connections:
OPCODE_IS_ABSOLUTE_GROUP: CMP2.P$5 (OUT_4)
OPCODE_IS_ADDQ_GROUP: CMP2.P$11 (OUT_10); also elsewhere on the board
OPCODE_IS_ADDX: CMP35.P$3 (OUT_2); also elsewhere on the board
OPCODE_IS_ADD_GROUP: CMP2.P$12 (OUT_11); also elsewhere on the board
OPCODE_IS_ADD_SP: CMP35.P$10 (OUT_9); also elsewhere on the board
OPCODE_IS_ANDI_PS: CMP35.P$12 (OUT_11); also elsewhere on the board
OPCODE_IS_AND_GROUP: CMP2.P$15 (OUT_14); also elsewhere on the board
OPCODE_IS_BRANCH_GROUP: CMP2.P$3 (OUT_2); also elsewhere on the board
OPCODE_IS_CMP_GROUP: CMP2.P$9 (OUT_8); also elsewhere on the board
OPCODE_IS_DIV: CMP35.P$4 (OUT_3); also elsewhere on the board
OPCODE_IS_DIVS: CMP35.P$5 (OUT_4); also elsewhere on the board
OPCODE_IS_INDIRECT_GROUP: CMP2.P$8 (OUT_7)
OPCODE_IS_INDIRECT_POSTINC: CMP2.P$1 (OUT_0); also elsewhere on the board
OPCODE_IS_JMP_ABS: CMP35.P$13 (OUT_12)
OPCODE_IS_JMP_R0: CMP35.P$14 (OUT_13); also elsewhere on the board
OPCODE_IS_LOGIC_GROUP: CMP2.P$2 (OUT_1); also elsewhere on the board
OPCODE_IS_MOVE_R0_SP: CMP35.P$16 (OUT_15); also elsewhere on the board
OPCODE_IS_MOVE_SP_R0: CMP35.P$15 (OUT_14); also elsewhere on the board
OPCODE_IS_MUL: CMP35.P$7 (OUT_6); also elsewhere on the board
OPCODE_IS_MULS: CMP35.P$8 (OUT_7); also elsewhere on the board
OPCODE_IS_MUL_N: CMP35.P$6 (OUT_5); also elsewhere on the board
OPCODE_IS_NEGX: CMP35.P$1 (OUT_0); also elsewhere on the board
OPCODE_IS_ORI_PS: CMP35.P$11 (OUT_10); also elsewhere on the board
OPCODE_IS_OR_GROUP: CMP2.P$13 (OUT_12); also elsewhere on the board
OPCODE_IS_POSTINC_GROUP: CMP2.P$7 (OUT_6); also elsewhere on the board
OPCODE_IS_SQRT: CMP35.P$9 (OUT_8); also elsewhere on the board
OPCODE_IS_STACK_GROUP: CMP2.P$4 (OUT_3); also elsewhere on the board
OPCODE_IS_STACK_REL_GROUP: CMP2.P$6 (OUT_5); also elsewhere on the board
OPCODE_IS_SUBX: CMP35.P$2 (OUT_1); also elsewhere on the board
OPCODE_IS_SUB_GROUP: CMP2.P$10 (OUT_9); also elsewhere on the board
OPCODE_IS_XOR_GROUP: CMP2.P$14 (OUT_13); also elsewhere on the board

Notes on the sheet:
clBit opcode_is_indirect_postinc; // 0 clBit opcode_is_logic_group; // 1 clBit opcode_is_branch_group; // 2 clBit opcode_is_stack_group; // 3 clBit opcode_is_absolute_group; // 4 clBit opcode_is_stack_rel_group; // 5 clBit opcode_is_postinc_group; // 6 clBit opcode_is_indirect_group; // 7 clBit opc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
clBit opcode_is_negx; // 15 clBit opcode_is_subx; // 14 clBit opcode_is_addx; // 13 clBit opcode_is_div; // 12 clBit opcode_is_divs; // 11 clBit opcode_is_mul_n; // 10 clBit opcode_is_mul; // 9 clBit opcode_is_muls; // 8 clBit opcode_is_sqrt; // 7 clBit opcode_is_add_sp; // 6 clBit opcode_is_ori_ps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

Schematic: module_decoding_b.sch, sheet 3

Parts:
CMP3, CMP47: BUS_SPLIT_DISPLAY

Connections:
BIT_SHIFT_MODE__CHANGE__ARITH: CMP3.P$7 (OUT_6); also elsewhere on the board
BIT_SHIFT_MODE__ROT_N: CMP3.P$9 (OUT_8); also elsewhere on the board
BIT_SHIFT_MODE__SET__X_ROT: CMP3.P$8 (OUT_7); also elsewhere on the board
BIT_SHIFT_MODE__TEST_N: CMP3.P$6 (OUT_5); also elsewhere on the board
DIV_BY_ZERO: CMP47.P$12 (OUT_11); also elsewhere on the board
DIV_BY_ZERO_N: CMP47.P$13 (OUT_12); also elsewhere on the board
OPCODE_IS_ABS: CMP47.P$4 (OUT_3); also elsewhere on the board
OPCODE_IS_BIT_XX: CMP3.P$3 (OUT_2); also elsewhere on the board
OPCODE_IS_BIT_XX_N: CMP3.P$4 (OUT_3); also elsewhere on the board
OPCODE_IS_CMP: CMP47.P$3 (OUT_2); also elsewhere on the board
OPCODE_IS_INV: CMP47.P$8 (OUT_7); also elsewhere on the board
OPCODE_IS_JSR_ABS: CMP3.P$10 (OUT_9); also elsewhere on the board
OPCODE_IS_JSR_R0: CMP3.P$11 (OUT_10); also elsewhere on the board
OPCODE_IS_LDI_X: CMP3.P$1 (OUT_0); also elsewhere on the board
OPCODE_IS_MOVER: CMP47.P$10 (OUT_9); also elsewhere on the board
OPCODE_IS_MUL_SQRT_DIV: CMP47.P$1 (OUT_0); also elsewhere on the board
OPCODE_IS_NEG: CMP47.P$6 (OUT_5); also elsewhere on the board
OPCODE_IS_OR: CMP47.P$7 (OUT_6); also elsewhere on the board
OPCODE_IS_POP_PS: CMP3.P$16 (OUT_15); also elsewhere on the board
OPCODE_IS_POP_RA: CMP47.P$15 (OUT_14); also elsewhere on the board
OPCODE_IS_PUSH_PS: CMP3.P$13 (OUT_12); also elsewhere on the board
OPCODE_IS_PUSH_RA: CMP47.P$16 (OUT_15); also elsewhere on the board
OPCODE_IS_RET: CMP3.P$15 (OUT_14); also elsewhere on the board
OPCODE_IS_RETI: CMP3.P$14 (OUT_13); also elsewhere on the board
OPCODE_IS_SHIFT_BIT: CMP3.P$5 (OUT_4); also elsewhere on the board
OPCODE_IS_SHIFT_XX: CMP3.P$2 (OUT_1); also elsewhere on the board
OPCODE_IS_SUB: CMP47.P$5 (OUT_4); also elsewhere on the board
OPCODE_IS_SXT: CMP47.P$11 (OUT_10); also elsewhere on the board
OPCODE_IS_TEST: CMP47.P$9 (OUT_8); also elsewhere on the board
OPCODE_IS_TRAP: CMP3.P$12 (OUT_11); also elsewhere on the board
OPCODE_IS_X_ARITH: CMP47.P$2 (OUT_1); also elsewhere on the board

Notes on the sheet:
clBit opcode_is_ldi_x; // 0 clBit opcode_is_shift_xx; // 1 clBit opcode_is_bit_xx; // 2 clBit opcode_is_bit_xx_n; // 3 clBit opcode_is_shift_bit; // 4 clBit bit_shift_mode_test_n; // 5 clBit bit_shift_mode_arith; // 6 clBit bit_shift_mode_x_rot; // 7 clBit bit_shift_mode_rot_n; // 8 clBit opcode_is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
clBit opcode_is_mul_sqrt_div; // 0 clBit opcode_is_x_arith; // 1 clBit opcode_is_cmp; // 2 clBit opcode_is_abs; // 3 clBit opcode_is_sub; // 4 clBit opcode_is_neg; // 5 clBit opcode_is_or; // 6 clBit opcode_is_inv; // 7 clBit opcode_is_test; // 8 clBit opcode_is_mover; // 9 clBit opcode_is_sxt; // 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

Schematic: module_decoding_b.sch, sheet 4

Parts:
CMP57: BUS_SPLIT_DISPLAY

Connections:
H_COUNT_IS_15: CMP57.P$3 (OUT_2); also elsewhere on the board
IS_END: CMP57.P$11 (OUT_10)
IS_END_N: CMP57.P$12 (OUT_11); also elsewhere on the board
IS_SIMPLE_DATA_TRANSFER: CMP57.P$13 (OUT_12)
LDI_X_STATE_0_BYTE_1_WORD: CMP57.P$9 (OUT_8); also elsewhere on the board
LOAD_WEIGHT: CMP57.P$5 (OUT_4); also elsewhere on the board
OPCODE_IS_JSR_X: CMP57.P$10 (OUT_9); also elsewhere on the board
OPCODE_IS_LD_ST: CMP57.P$8 (OUT_7); also elsewhere on the board
SHIFT_IS_SHIFTING: CMP57.P$4 (OUT_3); also elsewhere on the board
SHIFT_VAL_NON_ZERO: CMP57.P$1 (OUT_0)
SHIFT_VAL_NON_ZERO_N: CMP57.P$2 (OUT_1)
TAKE_INTERRUPT: CMP57.P$7 (OUT_6); also elsewhere on the board
TRAP_STATE_7: CMP57.P$6 (OUT_5); also elsewhere on the board

Notes on the sheet:
clBit shift_val_non_zero; // 0 clBit shift_val_non_zero_n; // 1 clBit h_count_is_15; // 2 clBit shift_is_shifting; // 3 clBit load_weight; // 4 clBit trap_state_7; // 5 clBit take_interrupt; // 6 clBit opcode_is_ld_st; // 7 clBit ldi_x_state_0_byte_1_word; // 8 clBit opcode_is_jsr_x; // 9 clBit is_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

Schematic: module_decoding_b.sch, sheet 5

Parts:
CMP16, CMP18, CMP19, CMP20, CMP21, CMP41, CMP42: 2AND

Connections:
OPCODE_IS_ADD_SP: CMP18.P$2 (2); also elsewhere on the board
OPCODE_IS_ADD_SP_STATE_2: CMP18.OUT_P; also elsewhere on the board
OPCODE_IS_BRANCH_GROUP: CMP19.P$2 (2); also elsewhere on the board
OPCODE_IS_BXX_STATE_2: CMP19.OUT_P; also elsewhere on the board
OPCODE_IS_DIV: CMP41.P$2 (2); also elsewhere on the board
OPCODE_IS_DIVS: CMP42.P$2 (2); also elsewhere on the board
OPCODE_IS_DIVS_STATE_0: CMP42.OUT_P; also elsewhere on the board
OPCODE_IS_DIV_STATE_0: CMP41.OUT_P; also elsewhere on the board
OPCODE_IS_JSR_X: CMP21.P$1 (1); also elsewhere on the board
OPCODE_IS_JSR_X_STATE_7: CMP21.OUT_P; also elsewhere on the board
OPCODE_IS_MOVE_R0_SP: CMP16.P$2 (2); also elsewhere on the board
OPCODE_IS_MOVE_R0_SP_STATE_0: CMP16.OUT_P; also elsewhere on the board
OPCODE_IS_STACK_REL_GROUP: CMP20.P$1 (1); also elsewhere on the board
OPCODE_IS_STACK_REL_STATE_2: CMP20.OUT_P; also elsewhere on the board
STATE_0: CMP16.P$1 (1), CMP41.P$1 (1), CMP42.P$1 (1); also elsewhere on the board
STATE_2: CMP18.P$1 (1), CMP19.P$1 (1), CMP20.P$2 (2); also elsewhere on the board
STATE_7: CMP21.P$2 (2); also elsewhere on the board

Notes on the sheet:
opcode_is_div_state_0 = Cpnt_2AND(opcode_is_div, bus_state[0]);
opcode_is_divs_state_0 = Cpnt_2AND(opcode_is_divs, bus_state[0]);
opcode_is_bxx_state_2 = Cpnt_2AND(opcode_is_branch_group, bus_state[2]);
opcode_is_move_r0_sp_state_0 = Cpnt_2AND(opcode_is_move_r0_sp, bus_state[0]);
opcode_is_add_sp_state_2 = Cpnt_2AND(opcode_is_add_sp, bus_state[2]);
opcode_is_stack_rel_state_2 = Cpnt_2AND(opcode_is_stack_rel_group, bus_state[2]);
opcode_is_jsr_x_state_7 = Cpnt_2AND(opcode_is_jsr_x, bus_state[7]);

Schematic: module_decoding_b.sch, sheet 6

Parts:
CMP37: 4OR
CMP68: 2AND
CMP80: 3AND
CMP100: XOR
CMP103: 2OR

Connections:
ALL_POPS: CMP37.OUT_P; also elsewhere on the board
BIT_SHIFT_MODE__TEST_N: CMP80.P$2 (2); also elsewhere on the board
DIFF_SIGN: CMP68.P$1 (1), CMP100.OUT_P
DIV_DIFF_SIGN: CMP68.OUT_P; also elsewhere on the board
FLAG_F0: CMP100.P$1 (A1); also elsewhere on the board
FLAG_F1: CMP100.P$2 (A2); also elsewhere on the board
OPCODE_IS_BIT_XX: CMP80.P$3 (3); also elsewhere on the board
OPCODE_IS_CMP: CMP103.P$2 (A1); also elsewhere on the board
OPCODE_IS_DIVS: CMP68.P$2 (2); also elsewhere on the board
OPCODE_IS_POP_PS: CMP37.4 (3); also elsewhere on the board
OPCODE_IS_POP_RA: CMP37.2 (1); also elsewhere on the board
OPCODE_IS_RET: CMP37.3 (2); also elsewhere on the board
OPCODE_IS_RETI: CMP37.1 (0); also elsewhere on the board
OPCODE_IS_TEST: CMP103.P$1 (A2); also elsewhere on the board
STATE_3: CMP80.P$1 (1); also elsewhere on the board
WR_RN_USING_RA__BIT: CMP80.OUT_P; also elsewhere on the board
WR_RN_USING_RA__REG_REG_EXCEPTIONS: CMP103.OUT_P
WR_RN_USING_RA__REG_REG_EXCEPTIONS_N: CMP103.OUT_M (N); also elsewhere on the board

Notes on the sheet:
all_pops = Cpnt_4OR(opcode_is_ret, opcode_is_reti, opcode_is_pop_ra, opcode_is_pop_ps);
div_diff_sign = Cpnt_2AND(opcode_is_divs, diff_sign);
wr_RN_using_ra__bit = Cpnt_3AND(bus_state[3], opcode_is_bit_xx, ~bit_shift_mode_decode.Output()[BIT_SHIFT_MODE_TEST]);
wr_RN_using_ra__reg_reg_exceptions = Cpnt_2OR(opcode_is_cmp, opcode_is_test);
diff_sign = Cpnt_XOR(bus_PS[WiC_PS_FLAG_INDEX_F0], bus_PS[WiC_PS_FLAG_INDEX_F1]);

Schematic: module_decoding_b.sch, sheet 7

Parts:
CMP9, CMP10, CMP11: 2AND
CMP12: 2OR
CMP14: 8OR

Connections:
BIT_SHIFT_MODE__ROT_N: CMP11.P$2 (2); also elsewhere on the board
unnamed: CMP14.1 (0), CMP14.2 (1)
NEXT_VC_MUX_CLEAR__MISC_OPTIONS: CMP14.OUT_P; also elsewhere on the board
OPCODE_IS_ADDQ_GROUP: CMP12.P$1 (A2); also elsewhere on the board
OPCODE_IS_ADD_ADDQ: CMP12.OUT_P; also elsewhere on the board
OPCODE_IS_ADD_GROUP: CMP12.P$2 (A1); also elsewhere on the board
OPCODE_IS_LDI_X: CMP14.6 (5); also elsewhere on the board
OPCODE_IS_LD_ST: CMP9.P$1 (1), CMP10.P$2 (2); also elsewhere on the board
OPCODE_IS_LD_ST_STATE_0: CMP9.OUT_P; also elsewhere on the board
OPCODE_IS_LD_ST_STATE_5: CMP10.OUT_P; also elsewhere on the board
OPCODE_IS_MUL_SQRT_DIV: CMP14.4 (3); also elsewhere on the board
OPCODE_IS_POP_RA: CMP14.8 (7); also elsewhere on the board
OPCODE_IS_PUSH_RA: CMP14.3 (2); also elsewhere on the board
OPCODE_IS_SHIFT_XX: CMP14.7 (6); also elsewhere on the board
OPCODE_IS_SXT: CMP14.5 (4); also elsewhere on the board
SHIFTING_NOT_ROTATION: CMP11.OUT_P; also elsewhere on the board
SHIFT_IS_SHIFTING: CMP11.P$1 (1); also elsewhere on the board
STATE_0: CMP9.P$2 (2); also elsewhere on the board
STATE_5: CMP10.P$1 (1); also elsewhere on the board

Notes on the sheet:
opcode_is_ld_st_state_0 = Cpnt_2AND(bus_shared_AB.opcode_is_ld_st,bus_state[0]);
opcode_is_ld_st_state_5 = Cpnt_2AND(bus_shared_AB.opcode_is_ld_st,bus_state[5]);
shifting_not_rotation = Cpnt_2AND(bus_shared_AB.shift_is_shifting, bus_stk_imm_AB.bit_shift_mode_rot_n);
opcode_is_add_addq = Cpnt_2OR(bus_group_AB.opcode_is_add_group, bus_group_AB.opcode_is_addq_group);
next_vc_mux_clear__misc_options = Cpnt_8OR(bus_stk_imm_AB.opcode_is_ldi_x, bus_alu_AB.opcode_is_sxt, bus_alu_AB.opcode_is_mul_sqrt_div, bus_stk_imm_AB.opcode_is_shift_xx, bus_alu_AB.opcode_is_push_ra, bus_alu_AB.opcode_is_pop_ra, BIT_VAL_0, BIT_VAL_0); // MOPUP

Schematic: module_decoding_b.sch, sheet 8

Parts:
CMP1, CMP5, CMP6: 2AND
CMP4: 2OR
CMP7, CMP8: 2X2AND_OR

Connections:
FLAG_F3: CMP8.P$2 (A1); also elsewhere on the board
FLAG_X: CMP7.P$2 (A1), CMP8.P$1 (A0); also elsewhere on the board
INSTR_2_N: CMP4.P$2 (A1), CMP6.P$1 (1); also elsewhere on the board
INSTR_3: CMP1.P$1 (1), CMP4.P$1 (A2); also elsewhere on the board
K_BIT_0: CMP6.OUT_M (N), CMP8.P$3 (B0)
K_BIT_1: CMP5.OUT_P, CMP7.P$3 (B0)
K_MSBS: CMP1.OUT_P; also elsewhere on the board
K_NOT_P1: CMP4.OUT_P, CMP5.P$1 (1)
K_VALUE_0: CMP8.OUT_P; also elsewhere on the board
K_VALUE_1: CMP7.OUT_P; also elsewhere on the board
OPCODE_IS_ADDQ_GROUP: CMP1.P$2 (2), CMP5.P$2 (2), CMP6.P$2 (2); also elsewhere on the board
OPCODE_IS_MUL_N: CMP7.P$4 (B1), CMP8.P$4 (B1); also elsewhere on the board
STATE_13: CMP7.P$1 (A0); also elsewhere on the board

Notes on the sheet:
for (loop=0;loop<2;loop++) { small_k_code[loop] = bus_f_instr.instr[loop + 2]; }
k_msbs = Cpnt_2AND(bus_group_AB.opcode_is_addq_group, small_k_code[1]); // neg 1 or neg 2
k_not_p1 = Cpnt_2OR(small_k_code[1] , ~small_k_code[0]);
k_bit_1 = Cpnt_2AND(bus_group_AB.opcode_is_addq_group, k_not_p1); // 2 or -2 or -1
k_bit_0 = ~Cpnt_2AND(bus_group_AB.opcode_is_addq_group, ~small_k_code[0]); // 1 or -1
k_value[1] = Cpnt_2x2AND_OR(k_bit_1, bus_misc_AB.opcode_is_mul_n, bus_state[13],bus_PS[WiC_PS_FLAG_INDEX_X]);
k_value[0] = Cpnt_2x2AND_OR(k_bit_0, bus_misc_AB.opcode_is_mul_n, bus_PS[WiC_PS_FLAG_INDEX_F3], bus_PS[WiC_PS_FLAG_INDEX_X]);

Schematic: module_decoding_b.sch, sheet 9

Parts:
CMP56, CMP79: BUS_CONSTRUCT_DISPLAY; BUS_SPLIT_DISPLAY

Connections:
BIT_SHIFT_MODE__CHANGE__ARITH: CMP79.P$6 (IN_5); also elsewhere on the board
BIT_SHIFT_MODE__SET__X_ROT: CMP79.P$8 (IN_7); also elsewhere on the board
BUS_DECODE_FLAGS_1: CMP56.INPUT (OUT)
BUS_DECODE_FLAGS_2: CMP79.INPUT (OUT)
DIV_BY_ZERO: CMP79.P$10 (IN_9); also elsewhere on the board
H_COUNT_IS_15: CMP79.P$9 (IN_8); also elsewhere on the board
LDI_X_STATE_0_BYTE_1_WORD: CMP79.P$2 (IN_1); also elsewhere on the board
LOAD_WEIGHT: CMP79.P$4 (IN_3); also elsewhere on the board
unnamed: CMP79.P$13 (IN_12), CMP79.P$14 (IN_13), CMP79.P$15 (IN_14), CMP79.P$16 (IN_15)
NEXT_VC_MUX_CLEAR__MISC_OPTIONS: CMP56.P$6 (IN_5); also elsewhere on the board
OPCODE_IS_ABS: CMP56.P$13 (IN_12); also elsewhere on the board
OPCODE_IS_ADD_ADDQ: CMP56.P$9 (IN_8); also elsewhere on the board
OPCODE_IS_ANDI_PS: CMP56.P$4 (IN_3); also elsewhere on the board
OPCODE_IS_BIT_XX: CMP79.P$5 (IN_4); also elsewhere on the board
OPCODE_IS_BRANCH_GROUP: CMP56.P$1 (IN_0); also elsewhere on the board
OPCODE_IS_CMP: CMP56.P$8 (IN_7); also elsewhere on the board
OPCODE_IS_LD_ST_STATE_0: CMP56.P$16 (IN_15); also elsewhere on the board
OPCODE_IS_LD_ST_STATE_5: CMP79.P$1 (IN_0); also elsewhere on the board
OPCODE_IS_MUL_SQRT_DIV: CMP56.P$5 (IN_4); also elsewhere on the board
OPCODE_IS_NEG: CMP56.P$7 (IN_6); also elsewhere on the board
OPCODE_IS_ORI_PS: CMP56.P$3 (IN_2); also elsewhere on the board
OPCODE_IS_POP_PS: CMP56.P$2 (IN_1); also elsewhere on the board
OPCODE_IS_SHIFT_XX: CMP56.P$15 (IN_14); also elsewhere on the board
OPCODE_IS_SUB: CMP56.P$11 (IN_10); also elsewhere on the board
OPCODE_IS_SUB_GROUP: CMP56.P$10 (IN_9); also elsewhere on the board
OPCODE_IS_TRAP: CMP56.P$14 (IN_13); also elsewhere on the board
OPCODE_IS_X_ARITH: CMP56.P$12 (IN_11); also elsewhere on the board
SHIFTING_NOT_ROTATION: CMP79.P$7 (IN_6); also elsewhere on the board
SHIFT_IS_SHIFTING: CMP79.P$3 (IN_2); also elsewhere on the board
TAKE_INTERRUPT: CMP79.P$12 (IN_11); also elsewhere on the board
TRAP_STATE_7: CMP79.P$11 (IN_10); also elsewhere on the board

Notes on the sheet:
clBit opcode_is_branch_group; // 0 clBit opcode_is_pop_ps; // 1 clBit opcode_is_ori_ps; // 2 clBit opcode_is_andi_ps; // 3 clBit opcode_is_mul_sqrt_div; // 4 clBit next_vc_mux_clear__misc_options; // 5 clBit opcode_is_neg; // 6 clBit opcode_is_cmp; // 7 clBit opcode_is_add_addq; // 8 clBit opcode_i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
clBit opcode_is_ld_st_state_5; // 0 clBit ldi_x_state_0_byte_1_word; // 1 clBit shift_is_shifting; // 2 clBit load_weight; // 3 clBit opcode_is_bit_xx; // 4 clBit bit_shift_mode_arith; // 5 clBit shifting_not_rotation; // 6 clBit bit_shift_mode_x_rot; // 7 clBit h_count_is_15; // 8 clBit div_by_zer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

Schematic: module_decoding_b.sch, sheet 10

Parts:
CMP87, CMP91, CMP93: BUS_CONSTRUCT_DISPLAY; BUS_SPLIT_DISPLAY

Connections:
BUS_DECODE_ALU_1: CMP91.INPUT (OUT)
BUS_DECODE_ALU_2: CMP87.INPUT (OUT)
BUS_DECODE_ALU_3: CMP93.INPUT (OUT)
K_MSBS: CMP93.P$9 (IN_8); also elsewhere on the board
K_VALUE_0: CMP93.P$7 (IN_6); also elsewhere on the board
K_VALUE_1: CMP93.P$8 (IN_7); also elsewhere on the board
unnamed: CMP93.P$14 (IN_13), CMP93.P$15 (IN_14), CMP93.P$16 (IN_15)
OPCODE_IS_ABS: CMP87.P$14 (IN_13); also elsewhere on the board
OPCODE_IS_ADDQ_GROUP: CMP93.P$6 (IN_5); also elsewhere on the board
OPCODE_IS_ADDX: CMP87.P$12 (IN_11); also elsewhere on the board
OPCODE_IS_ADD_GROUP: CMP87.P$9 (IN_8); also elsewhere on the board
OPCODE_IS_ADD_SP_STATE_2: CMP91.P$15 (IN_14); also elsewhere on the board
OPCODE_IS_AND_GROUP: CMP87.P$8 (IN_7); also elsewhere on the board
OPCODE_IS_BIT_XX: CMP87.P$5 (IN_4); also elsewhere on the board
OPCODE_IS_BIT_XX_N: CMP93.P$2 (IN_1); also elsewhere on the board
OPCODE_IS_BXX_STATE_2: CMP87.P$1 (IN_0); also elsewhere on the board
OPCODE_IS_CMP: CMP93.P$1 (IN_0); also elsewhere on the board
OPCODE_IS_CMP_GROUP: CMP93.P$10 (IN_9); also elsewhere on the board
OPCODE_IS_DIV: CMP87.P$15 (IN_14); also elsewhere on the board
OPCODE_IS_DIVS_STATE_0: CMP91.P$2 (IN_1); also elsewhere on the board
OPCODE_IS_DIV_STATE_0: CMP91.P$7 (IN_6); also elsewhere on the board
OPCODE_IS_INDIRECT_POSTINC: CMP91.P$9 (IN_8); also elsewhere on the board
OPCODE_IS_INV: CMP93.P$3 (IN_2); also elsewhere on the board
OPCODE_IS_JMP_R0: CMP91.P$11 (IN_10); also elsewhere on the board
OPCODE_IS_JSR_ABS: CMP91.P$14 (IN_13); also elsewhere on the board
OPCODE_IS_JSR_R0: CMP91.P$5 (IN_4); also elsewhere on the board
OPCODE_IS_JSR_X_STATE_7: CMP91.P$8 (IN_7); also elsewhere on the board
OPCODE_IS_LOGIC_GROUP: CMP87.P$3 (IN_2); also elsewhere on the board
OPCODE_IS_MOVER: CMP93.P$11 (IN_10); also elsewhere on the board
OPCODE_IS_MOVE_R0_SP_STATE_0: CMP91.P$12 (IN_11); also elsewhere on the board
OPCODE_IS_MOVE_SP_R0: CMP91.P$10 (IN_9); also elsewhere on the board
OPCODE_IS_MULS: CMP87.P$13 (IN_12); also elsewhere on the board
OPCODE_IS_MUL_N: CMP91.P$13 (IN_12); also elsewhere on the board
OPCODE_IS_NEG: CMP87.P$4 (IN_3); also elsewhere on the board
OPCODE_IS_NEGX: CMP87.P$10 (IN_9); also elsewhere on the board
OPCODE_IS_OR: CMP87.P$7 (IN_6); also elsewhere on the board
OPCODE_IS_OR_GROUP: CMP93.P$12 (IN_11); also elsewhere on the board
OPCODE_IS_PUSH_PS: CMP91.P$3 (IN_2); also elsewhere on the board
OPCODE_IS_PUSH_RA: CMP91.P$4 (IN_3); also elsewhere on the board
OPCODE_IS_SHIFT_XX: CMP87.P$2 (IN_1); also elsewhere on the board
OPCODE_IS_SQRT: CMP87.P$16 (IN_15); also elsewhere on the board
OPCODE_IS_STACK_GROUP: CMP93.P$5 (IN_4); also elsewhere on the board
OPCODE_IS_STACK_REL_STATE_2: CMP91.P$16 (IN_15); also elsewhere on the board
OPCODE_IS_SUB: CMP87.P$6 (IN_5); also elsewhere on the board
OPCODE_IS_SUBX: CMP87.P$11 (IN_10); also elsewhere on the board
OPCODE_IS_SUB_GROUP: CMP93.P$4 (IN_3); also elsewhere on the board
OPCODE_IS_TRAP: CMP91.P$6 (IN_5); also elsewhere on the board
OPCODE_IS_XOR_GROUP: CMP93.P$13 (IN_12); also elsewhere on the board
SHIFT_IS_SHIFTING: CMP91.P$1 (IN_0); also elsewhere on the board

Notes on the sheet:
clBit opcode_is_bxx_state_2; // 0 clBit opcode_is_shift_xx; // 1 clBit opcode_is_logic_group; // 2 clBit opcode_is_neg; // 3 clBit opcode_is_bit_xx; // 4 clBit opcode_is_sub; // 5 clBit opcode_is_or; // 6 clBit opcode_is_and_group; // 7 clBit opcode_is_add_group; // 8 clBit opcode_is_negx; // 9 clB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
clBit opcode_is_cmp; // 0 clBit opcode_is_bit_xx_n; // 1 clBit opcode_is_inv; // 2 clBit opcode_is_sub_group; // 3 clBit opcode_is_stack_group; // 4 clBit opcode_is_addq_group; // 5 clBit k_0; // 6 clBit k_1; // 7 clBit k_m; // 8 clBit opcode_is_cmp_group; // 9 clBit opcode_is_mover; // 10 clBit op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
clBit shift_is_shifting; // 0 clBit opcode_is_divs_state_0; // 1 clBit opcode_is_push_ps; // 2 clBit opcode_is_push_ra; // 3 clBit opcode_is_jsr_r0; // 4 clBit opcode_is_trap; // 5 clBit opcode_is_div_state_0; // 6 clBit opcode_is_jsr_x_state_7; // 7 clBit opcode_is_indirect_postinc; // 8 clBit opc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

Schematic: module_decoding_b.sch, sheet 11

Parts:
CMP95, CMP99: BUS_CONSTRUCT_DISPLAY; BUS_SPLIT_DISPLAY

Connections:
ALL_POPS: CMP95.P$1 (IN_0); also elsewhere on the board
BUS_DECODE_RNX_1: CMP95.INPUT (OUT)
BUS_DECODE_RNX_2: CMP99.INPUT (OUT)
DIV_BY_ZERO_N: CMP99.P$9 (IN_8); also elsewhere on the board
DIV_DIFF_SIGN: CMP99.P$13 (IN_12); also elsewhere on the board
IS_END_N: CMP95.P$14 (IN_13); also elsewhere on the board
LOAD_WEIGHT: CMP99.P$14 (IN_13); also elsewhere on the board
OPCODE_IS_ADDX: CMP95.P$3 (IN_2); also elsewhere on the board
OPCODE_IS_ADD_SP_STATE_2: CMP95.P$8 (IN_7); also elsewhere on the board
OPCODE_IS_DIV: CMP99.P$6 (IN_5); also elsewhere on the board
OPCODE_IS_DIVS_STATE_0: CMP95.P$16 (IN_15); also elsewhere on the board
OPCODE_IS_DIV_STATE_0: CMP99.P$10 (IN_9); also elsewhere on the board
OPCODE_IS_INDIRECT_POSTINC: CMP99.P$1 (IN_0); also elsewhere on the board
OPCODE_IS_JSR_ABS: CMP95.P$15 (IN_14); also elsewhere on the board
OPCODE_IS_JSR_R0: CMP99.P$3 (IN_2); also elsewhere on the board
OPCODE_IS_LDI_X: CMP99.P$11 (IN_10); also elsewhere on the board
OPCODE_IS_LD_ST: CMP99.P$4 (IN_3); also elsewhere on the board
OPCODE_IS_MOVE_R0_SP_STATE_0: CMP95.P$9 (IN_8); also elsewhere on the board
OPCODE_IS_MUL: CMP95.P$10 (IN_9); also elsewhere on the board
OPCODE_IS_MULS: CMP95.P$5 (IN_4); also elsewhere on the board
OPCODE_IS_NEGX: CMP95.P$6 (IN_5); also elsewhere on the board
OPCODE_IS_POP_PS: CMP99.P$5 (IN_4); also elsewhere on the board
OPCODE_IS_POSTINC_GROUP: CMP99.P$15 (IN_14); also elsewhere on the board
OPCODE_IS_SHIFT_BIT: CMP95.P$4 (IN_3); also elsewhere on the board
OPCODE_IS_SQRT: CMP95.P$12 (IN_11); also elsewhere on the board
OPCODE_IS_STACK_GROUP: CMP95.P$13 (IN_12); also elsewhere on the board
OPCODE_IS_STACK_REL_STATE_2: CMP95.P$11 (IN_10); also elsewhere on the board
OPCODE_IS_SUBX: CMP95.P$2 (IN_1); also elsewhere on the board
OPCODE_IS_SXT: CMP95.P$7 (IN_6); also elsewhere on the board
OPCODE_IS_TRAP: CMP99.P$2 (IN_1); also elsewhere on the board
OPCODE_IS_X_ARITH: CMP99.P$16 (IN_15); also elsewhere on the board
SHIFT_IS_SHIFTING: CMP99.P$8 (IN_7); also elsewhere on the board
WR_RN_USING_RA__BIT: CMP99.P$7 (IN_6); also elsewhere on the board
WR_RN_USING_RA__REG_REG_EXCEPTIONS_N: CMP99.P$12 (IN_11); also elsewhere on the board

Notes on the sheet:
clBit all_pops; // 0 clBit opcode_is_subx; // 1 clBit opcode_is_addx; // 2 clBit opcode_is_shift_bit; // 3 clBit opcode_is_muls; // 4 clBit opcode_is_negx; // 5 clBit opcode_is_sxt; // 6 clBit opcode_is_add_sp_state_2; // 7 clBit opcode_is_move_r0_sp_state_0; // 8 clBit opcode_is_mul; // 9 clBit op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
clBit opcode_is_indirect_postinc; // 0 clBit opcode_is_trap; // 1 clBit opcode_is_jsr_r0; // 2 clBit opcode_is_ld_st; // 3 clBit opcode_is_pop_ps; // 4 clBit opcode_is_div; // 5 clBit wr_RN_using_ra__bit; // 6 clBit shift_is_shifting; // 7 clBit div_by_zero_n; // 8 clBit opcode_is_div_state_0; // 9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

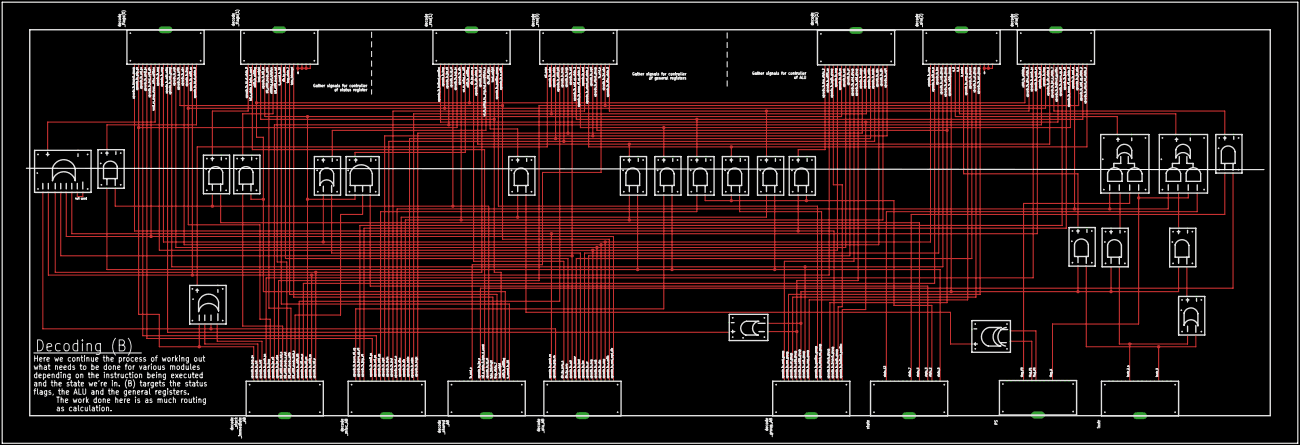
[picture p209: board module_decoding_b.brd from above]

Board: 2 copper layers, 1193.8 x 406.4 mm, 38 parts (0 on the bottom side), 106 nets.
