ericherman/megaprocessor/p2p/P2P_1.brd

## EAGLE design p2p/P2P_1.brd (2017-05-20)

Schematic: P2P_1.sch, sheet 1

Parts:
G: TEST_LOOP
J1, J2, J3, J4: 20_HDR_LOCKING
J5: 64_HDR_LOCKING
U$1, U$2, U$3, U$4: 5P5_MOUNT_HOLE; 5P5M_HOLE

Connections:
B0: J2.2, J5.17; also elsewhere on the board
B1: J2.3, J5.18; also elsewhere on the board
B2: J2.4, J5.19; also elsewhere on the board
B3: J2.5, J5.20; also elsewhere on the board
B4: J2.6, J5.21; also elsewhere on the board
B5: J2.7, J5.22; also elsewhere on the board
B6: J2.8, J5.23; also elsewhere on the board
B7: J2.9, J5.24; also elsewhere on the board
B8: J2.12, J5.25; also elsewhere on the board
B9: J2.13, J5.26; also elsewhere on the board
B10: J2.14, J5.27; also elsewhere on the board
B11: J2.15, J5.28; also elsewhere on the board
B12: J2.16, J5.29; also elsewhere on the board
B13: J2.17, J5.30; also elsewhere on the board
B14: J2.18, J5.31; also elsewhere on the board
B15: J2.19, J5.32; also elsewhere on the board
unnamed: G.P$1, J1.1, J1.10, J1.11, J1.20, J2.1, J2.10, J2.11, J2.20, J3.1, J3.10, J3.11, J3.20, J4.1, J4.10, J4.11, J4.20
unnamed: J3.2, J5.33
unnamed: J3.3, J5.34
unnamed: J3.4, J5.35
unnamed: J3.5, J5.36
unnamed: J3.6, J5.37
unnamed: J3.7, J5.38
unnamed: J3.8, J5.39
unnamed: J3.9, J5.40
unnamed: J3.12, J5.41
unnamed: J3.13, J5.42
unnamed: J3.14, J5.43
unnamed: J3.15, J5.44
unnamed: J3.16, J5.45
unnamed: J3.17, J5.46
unnamed: J3.18, J5.47
unnamed: J3.19, J5.48
unnamed: J4.2, J5.49
unnamed: J4.3, J5.50
unnamed: J4.4, J5.51
unnamed: J4.5, J5.52
unnamed: J4.6, J5.53
unnamed: J4.7, J5.54
unnamed: J4.8, J5.55
unnamed: J4.9, J5.56
unnamed: J1.19, J5.16
unnamed: J1.18, J5.15
unnamed: J1.17, J5.14
unnamed: J1.16, J5.13
unnamed: J1.15, J5.12
unnamed: J1.14, J5.11
unnamed: J1.13, J5.10
unnamed: J1.12, J5.9
unnamed: J1.9, J5.8
unnamed: J1.8, J5.7
unnamed: J1.7, J5.6
unnamed: J1.6, J5.5
unnamed: J1.5, J5.4
unnamed: J1.4, J5.3
unnamed: J1.3, J5.2
unnamed: J1.2, J5.1
unnamed: J4.12, J5.57
unnamed: J4.13, J5.58
unnamed: J4.14, J5.59
unnamed: J4.15, J5.60
unnamed: J4.16, J5.61
unnamed: J4.17, J5.62
unnamed: J4.18, J5.63
unnamed: J4.19, J5.64

Schematic: P2P_1.sch, sheet 2

Parts:
0, 1, 2, 3, 4, 5, 6, 7, 8, 9: TEST_LOOP
A: TEST_LOOP
B: TEST_LOOP
C: TEST_LOOP
D: TEST_LOOP
E: TEST_LOOP
F: TEST_LOOP

Connections:
B0: 0.P$1; also elsewhere on the board
B1: 1.P$1; also elsewhere on the board
B2: 2.P$1; also elsewhere on the board
B3: 3.P$1; also elsewhere on the board
B4: 4.P$1; also elsewhere on the board
B5: 5.P$1; also elsewhere on the board
B6: 6.P$1; also elsewhere on the board
B7: 7.P$1; also elsewhere on the board
B8: 8.P$1; also elsewhere on the board
B9: 9.P$1; also elsewhere on the board
B10: A.P$1; also elsewhere on the board
B11: B.P$1; also elsewhere on the board
B12: C.P$1; also elsewhere on the board
B13: D.P$1; also elsewhere on the board
B14: E.P$1; also elsewhere on the board
B15: F.P$1; also elsewhere on the board

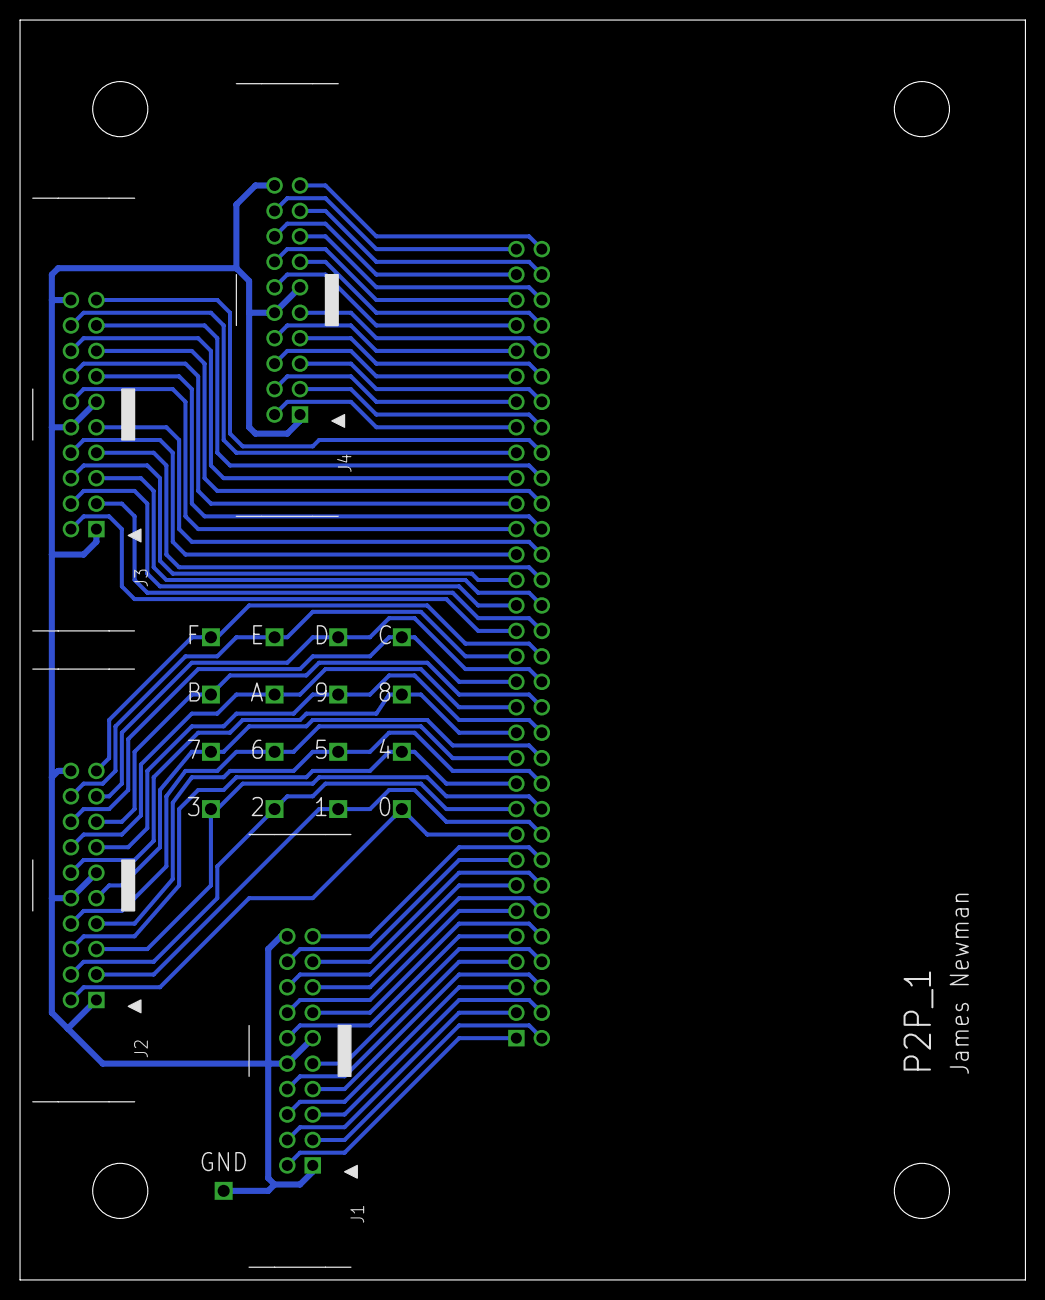
[picture p210: board P2P_1.brd from above]

Board: 2 copper layers, 100.3 x 125.7 mm, 26 parts (1 on the bottom side), 65 nets.
