ericherman/megaprocessor/module_artwork_special_reg/module_special_reg.brd

## EAGLE design module_artwork_special_reg/module_special_reg.brd (2017-05-20)

Schematic: module_special_reg.sch, sheet 1

Parts:
CMP9, CMP14: BUS_SPLIT_DISPLAY

Connections:
BUS_SPECIAL_REG_CTRL1: CMP14.INPUT
BUS_SPECIAL_REG_CTRL2: CMP9.INPUT
H_COUNT_DOWN__SHIFT: CMP9.P$1 (OUT_0); also elsewhere on the board
NEXT_ADDR_MUX_ADD2: CMP14.P$9 (OUT_8); also elsewhere on the board
NEXT_ADDR_MUX_PC: CMP14.P$7 (OUT_6); also elsewhere on the board
NEXT_ADDR_MUX_READ_WORD: CMP14.P$8 (OUT_7); also elsewhere on the board
NEXT_ADDR_MUX_RI: CMP14.P$10 (OUT_9); also elsewhere on the board
NEXT_H_MUX_A_ABS_MSB: CMP9.P$11 (OUT_10); also elsewhere on the board
NEXT_H_MUX_A_ADD2: CMP9.P$12 (OUT_11); also elsewhere on the board
NEXT_H_MUX_A_R1: CMP9.P$10 (OUT_9); also elsewhere on the board
NEXT_H_MUX_A_SXT_RD_DATA: CMP9.P$9 (OUT_8); also elsewhere on the board
NEXT_H_MUX_B_A: CMP9.P$3 (OUT_2); also elsewhere on the board
NEXT_H_MUX_B_HOLD: CMP9.P$2 (OUT_1); also elsewhere on the board
NEXT_H_MUX_B_SHIFT_REG_VAL: CMP9.P$4 (OUT_3); also elsewhere on the board
NEXT_H_MUX_B_SHIFT_UPDATE: CMP9.P$5 (OUT_4); also elsewhere on the board
NEXT_PC_MUX_ADD2: CMP14.P$5 (OUT_4); also elsewhere on the board
NEXT_PC_MUX_HOLD: CMP14.P$3 (OUT_2); also elsewhere on the board
NEXT_PC_MUX_H_AND_DATA: CMP14.P$4 (OUT_3); also elsewhere on the board
NEXT_SP_MUX_ADD2: CMP14.P$11 (OUT_10); also elsewhere on the board
NEXT_SP_MUX_HOLD: CMP14.P$12 (OUT_11); also elsewhere on the board
NEXT_WR_DATA_MUX_PC_RA_LSB: CMP9.P$7 (OUT_6); also elsewhere on the board
NEXT_WR_DATA_MUX_PC_RA_MSB: CMP9.P$8 (OUT_7); also elsewhere on the board
NEXT_WR_DATA_MUX_PS: CMP9.P$6 (OUT_5); also elsewhere on the board
NEXT_WR_DATA_WIDE_MUX_PC: CMP9.P$13 (OUT_12); also elsewhere on the board
NEXT_WR_DATA_WIDE_MUX_RA: CMP9.P$14 (OUT_13); also elsewhere on the board
OPCODE_IS_STACK_REL_GROUP_N: CMP9.P$15 (OUT_14); also elsewhere on the board
TRAP_STATE_7: CMP14.P$6 (OUT_5); also elsewhere on the board
VECTOR_CODE_0: CMP14.P$2 (OUT_1); also elsewhere on the board
VECTOR_CODE_1: CMP14.P$1 (OUT_0); also elsewhere on the board

Schematic: module_special_reg.sch, sheet 2

Parts:
CMP19, CMP21, CMP22: BUS_SPLIT_DISPLAY

Connections:
BUS_H_ADDER: CMP22.INPUT; also elsewhere on the board
BUS_H_D: CMP19.INPUT; also elsewhere on the board
BUS_ZERO_EXTEND_READ_DATA: CMP21.INPUT
H_0: CMP19.P$1 (OUT_0)
H_1: CMP19.P$2 (OUT_1)
H_2: CMP19.P$3 (OUT_2)
H_3: CMP19.P$4 (OUT_3)
H_4: CMP19.P$5 (OUT_4)
H_5: CMP19.P$6 (OUT_5); also elsewhere on the board
H_6: CMP19.P$7 (OUT_6); also elsewhere on the board
H_7: CMP19.P$8 (OUT_7); also elsewhere on the board
H_8: CMP19.P$9 (OUT_8)
H_9: CMP19.P$10 (OUT_9)
H_10: CMP19.P$11 (OUT_10)
H_11: CMP19.P$12 (OUT_11)
H_12: CMP19.P$13 (OUT_12)
H_13: CMP19.P$14 (OUT_13)
H_14: CMP19.P$15 (OUT_14)
H_15: CMP19.P$16 (OUT_15)
H_ADDER0: CMP22.P$1 (OUT_0); also elsewhere on the board
H_ADDER1: CMP22.P$2 (OUT_1); also elsewhere on the board
H_ADDER2: CMP22.P$3 (OUT_2); also elsewhere on the board
H_ADDER3: CMP22.P$4 (OUT_3); also elsewhere on the board
H_ADDER4: CMP22.P$5 (OUT_4); also elsewhere on the board
H_ADDER5: CMP22.P$6 (OUT_5)
H_ADDER6: CMP22.P$7 (OUT_6)
H_ADDER7: CMP22.P$8 (OUT_7)
H_ADDER8: CMP22.P$9 (OUT_8)
H_ADDER9: CMP22.P$10 (OUT_9)
H_ADDER10: CMP22.P$11 (OUT_10)
H_ADDER11: CMP22.P$12 (OUT_11)
H_ADDER12: CMP22.P$13 (OUT_12)
H_ADDER13: CMP22.P$14 (OUT_13)
H_ADDER14: CMP22.P$15 (OUT_14)
H_ADDER15: CMP22.P$16 (OUT_15)
ZXT_READ_DATA_0: CMP21.P$1 (OUT_0); also elsewhere on the board
ZXT_READ_DATA_1: CMP21.P$2 (OUT_1); also elsewhere on the board
ZXT_READ_DATA_2: CMP21.P$3 (OUT_2); also elsewhere on the board
ZXT_READ_DATA_3: CMP21.P$4 (OUT_3); also elsewhere on the board
ZXT_READ_DATA_4: CMP21.P$5 (OUT_4); also elsewhere on the board
ZXT_READ_DATA_5: CMP21.P$6 (OUT_5); also elsewhere on the board
ZXT_READ_DATA_6: CMP21.P$7 (OUT_6); also elsewhere on the board
ZXT_READ_DATA_7: CMP21.P$8 (OUT_7); also elsewhere on the board
ZXT_READ_DATA_8: CMP21.P$9 (OUT_8)
ZXT_READ_DATA_9: CMP21.P$10 (OUT_9)
ZXT_READ_DATA_10: CMP21.P$11 (OUT_10)
ZXT_READ_DATA_11: CMP21.P$12 (OUT_11)
ZXT_READ_DATA_12: CMP21.P$13 (OUT_12)
ZXT_READ_DATA_13: CMP21.P$14 (OUT_13)
ZXT_READ_DATA_14: CMP21.P$15 (OUT_14)
ZXT_READ_DATA_15: CMP21.P$16 (OUT_15)

Schematic: module_special_reg.sch, sheet 3

Parts:
CMP5, CMP25, CMP26, CMP48: BUS_2_BUS; BUS2BUS
CMP10, CMP11: BUS_4TEE
CMP16: BUS_TEE
CMP17: BUS_SPLIT_DISPLAY

Connections:
ADD2_0: CMP17.P$1 (OUT_0); also elsewhere on the board
ADD2_1: CMP17.P$2 (OUT_1); also elsewhere on the board
ADD2_2: CMP17.P$3 (OUT_2); also elsewhere on the board
ADD2_3: CMP17.P$4 (OUT_3); also elsewhere on the board
ADD2_4: CMP17.P$5 (OUT_4); also elsewhere on the board
ADD2_5: CMP17.P$6 (OUT_5); also elsewhere on the board
ADD2_6: CMP17.P$7 (OUT_6); also elsewhere on the board
ADD2_7: CMP17.P$8 (OUT_7); also elsewhere on the board
BUS_ADD2_A: CMP10.2; also elsewhere on the board
BUS_ADD2_B: CMP10.3; also elsewhere on the board
BUS_ADD2_C: CMP10.4; also elsewhere on the board
BUS_ADD2_D: CMP16.OUT_A (A); also elsewhere on the board
BUS_MEMORY_READ_WORD: CMP11.SRC
BUS_MEMORY_READ_WORD_A: CMP11.3; also elsewhere on the board
BUS_MEMORY_READ_WORD_B: CMP11.4; also elsewhere on the board
BUS_MEMORY_READ_WORD_C: CMP11.2; also elsewhere on the board
BUS_MEMORY_READ_WORD_D: CMP11.1
BUS_PS: CMP26.P$2 (OUT); also elsewhere on the board
BUS_RA: CMP25.P$2 (OUT); also elsewhere on the board
BUS_RI: CMP48.P$2 (OUT); also elsewhere on the board
unnamed: CMP16.OUTB (B), CMP17.INPUT
unnamed: CMP10.1, CMP16.INPUT (IN)
REG_R1_ROTATE: CMP5.P$2 (OUT); also elsewhere on the board

Schematic: module_special_reg.sch, sheet 4

Parts:
CMP1, CMP2: 4X16MUX
CMP3, CMP32: BUS_2_BUS; BUS2BUS
CMP33: BUS_TEE
CMP34: BUS_4TEE
CMP41: 16REG
CMP43: 4DIGIT
U$1: BYTE_WORD; WORD_BYTE

Connections:
BUS_ADD2_D: CMP1.PORT0; also elsewhere on the board
BUS_H_A: CMP33.INPUT (IN), CMP34.1
BUS_H_B: CMP34.2; also elsewhere on the board
BUS_H_C: CMP2.PORT3, CMP34.4
BUS_H_D: CMP34.3; also elsewhere on the board
BUS_MEMORY_READ_WORD_C: CMP1.PORT1; also elsewhere on the board
DISP_CONN: CMP41.DISPLAY (DSP), CMP43.P$1
H_MSB: CMP32.P$1 (IN), U$1.MSB_1
H_OUT: CMP3.P$1 (IN), CMP33.OUT_A (A)
H_SHIFT_UPDATE_DATA: CMP2.PORT1; also elsewhere on the board
unnamed: CMP33.OUTB (B), U$1.SRC (WORD)
NEXT_H_MUX: CMP2.PORTOUT (OUTPUT), CMP41.INPUT (IN)
NEXT_H_MUX_A: CMP1.PORTOUT (OUTPUT), CMP2.PORT2
NEXT_H_MUX_A_ABS_MSB: CMP1.EN1; also elsewhere on the board
NEXT_H_MUX_A_ADD2: CMP1.EN0; also elsewhere on the board
NEXT_H_MUX_A_R1: CMP1.EN2; also elsewhere on the board
NEXT_H_MUX_A_SXT_RD_DATA: CMP1.EN3; also elsewhere on the board
NEXT_H_MUX_B_A: CMP2.EN2; also elsewhere on the board
NEXT_H_MUX_B_HOLD: CMP2.EN3; also elsewhere on the board
NEXT_H_MUX_B_SHIFT_REG_VAL: CMP2.EN0; also elsewhere on the board
NEXT_H_MUX_B_SHIFT_UPDATE: CMP2.EN1; also elsewhere on the board
REG_H: CMP34.SRC, CMP41.OUT
REG_R1_ROTATE: CMP1.PORT2; also elsewhere on the board
SHIFT_REG_VALUE: CMP2.PORT0; also elsewhere on the board
SIGN_EXTEND_READ_DATA: CMP1.PORT3; also elsewhere on the board

Schematic: module_special_reg.sch, sheet 5

Parts:
CMP4: BUS_CONSTRUCT; BUS_SPLIT
CMP6: 8BIT_ADD_SUB
CMP7: 3X2DIGIT

Connections:
BUS_H_ADDER: CMP6.R; also elsewhere on the board
BUS_H_B: CMP6.A; also elsewhere on the board
H_COUNT_DOWN__SHIFT: CMP6.C_IN, CMP6.INV_B; also elsewhere on the board
unnamed: CMP4.INPUT (OUT), CMP6.B
unnamed: CMP4.P$2 (IN_1), CMP4.P$3 (IN_2), CMP4.P$4 (IN_3), CMP4.P$5 (IN_4), CMP4.P$6 (IN_5), CMP4.P$7 (IN_6), CMP4.P$8 (IN_7), CMP4.P$9 (IN_8), CMP4.P$10 (IN_9), CMP4.P$11 (IN_10), CMP4.P$12 (IN_11), CMP4.P$13 (IN_12), CMP4.P$14 (IN_13), CMP4.P$15 (IN_14), CMP4.P$16 (IN_15)
unnamed: CMP6.DISP, CMP7.P$1
