ericherman/megaprocessor/module_artwork_special_reg/module_special_reg.brd

## EAGLE design module_artwork_special_reg/module_special_reg.brd (continued)

Schematic: module_special_reg.sch, sheet 6

Parts:
CMP24: BUS_SPLIT_DISPLAY
CMP27, CMP28, CMP29: BUS_CONSTRUCT_DISPLAY; BUS_SPLIT_DISPLAY
CMP31: 2AND

Connections:
ADD2_0: CMP29.P$9 (IN_8); also elsewhere on the board
ADD2_1: CMP29.P$10 (IN_9); also elsewhere on the board
ADD2_2: CMP29.P$11 (IN_10); also elsewhere on the board
ADD2_3: CMP29.P$12 (IN_11); also elsewhere on the board
ADD2_4: CMP29.P$13 (IN_12); also elsewhere on the board
ADD2_5: CMP29.P$14 (IN_13); also elsewhere on the board
ADD2_6: CMP29.P$15 (IN_14); also elsewhere on the board
ADD2_7: CMP29.P$16 (IN_15); also elsewhere on the board
BUS_ALU_OUTPUT: CMP24.INPUT
BUS_ALU_OUTPUT0: CMP24.P$1 (OUT_0), CMP28.P$1 (IN_0)
BUS_ALU_OUTPUT1: CMP24.P$2 (OUT_1), CMP28.P$2 (IN_1)
BUS_ALU_OUTPUT2: CMP24.P$3 (OUT_2), CMP28.P$3 (IN_2)
BUS_ALU_OUTPUT3: CMP24.P$4 (OUT_3), CMP28.P$4 (IN_3)
BUS_ALU_OUTPUT4: CMP24.P$5 (OUT_4), CMP28.P$5 (IN_4)
H_5: CMP28.P$6 (IN_5), CMP29.P$6 (IN_5); also elsewhere on the board
H_6: CMP28.P$7 (IN_6), CMP29.P$7 (IN_6); also elsewhere on the board
H_7: CMP28.P$8 (IN_7), CMP29.P$8 (IN_7); also elsewhere on the board
H_ADDER0: CMP29.P$1 (IN_0); also elsewhere on the board
H_ADDER1: CMP29.P$2 (IN_1); also elsewhere on the board
H_ADDER2: CMP29.P$3 (IN_2); also elsewhere on the board
H_ADDER3: CMP29.P$4 (IN_3); also elsewhere on the board
H_ADDER4: CMP29.P$5 (IN_4); also elsewhere on the board
H_SHIFT_UPDATE_DATA: CMP29.INPUT (OUT); also elsewhere on the board
unnamed: CMP28.P$9 (IN_8), CMP28.P$10 (IN_9), CMP28.P$11 (IN_10), CMP28.P$12 (IN_11), CMP28.P$13 (IN_12), CMP28.P$14 (IN_13), CMP28.P$15 (IN_14), CMP28.P$16 (IN_15)
OPCODE_IS_STACK_REL_GROUP_N: CMP31.P$1 (1); also elsewhere on the board
SHIFT_REG_VALUE: CMP28.INPUT (OUT); also elsewhere on the board
SIGN_EXTEND_READ_DATA: CMP27.INPUT (OUT); also elsewhere on the board
SIGN_EXTEND_VAL: CMP27.P$9 (IN_8), CMP27.P$10 (IN_9), CMP27.P$11 (IN_10), CMP27.P$12 (IN_11), CMP27.P$13 (IN_12), CMP27.P$14 (IN_13), CMP27.P$15 (IN_14), CMP27.P$16 (IN_15), CMP31.OUT_P
ZXT_READ_DATA_0: CMP27.P$1 (IN_0); also elsewhere on the board
ZXT_READ_DATA_1: CMP27.P$2 (IN_1); also elsewhere on the board
ZXT_READ_DATA_2: CMP27.P$3 (IN_2); also elsewhere on the board
ZXT_READ_DATA_3: CMP27.P$4 (IN_3); also elsewhere on the board
ZXT_READ_DATA_4: CMP27.P$5 (IN_4); also elsewhere on the board
ZXT_READ_DATA_5: CMP27.P$6 (IN_5); also elsewhere on the board
ZXT_READ_DATA_6: CMP27.P$7 (IN_6); also elsewhere on the board
ZXT_READ_DATA_7: CMP27.P$8 (IN_7), CMP31.P$2 (2); also elsewhere on the board

Notes on the sheet:
sign_extend_val = Cpnt_2AND(bus_h_wd_reg_ctrl.opcode_is_stack_rel_group_n, bus_zero_extend_read_data[7]);

Schematic: module_special_reg.sch, sheet 7

Parts:
CMP8: WORD_BYTE
CMP12: 2X16MUX
CMP13: 4X16MUX
CMP18: 4DIGIT
CMP20: 16REG
CMP23: BUS_2_BUS; BUS2BUS
CMP30: BUS_CONSTRUCT; BUS_SPLIT

Connections:
BUS_PC_B: CMP12.PORT1; also elsewhere on the board
BUS_PS: CMP13.PORT3; also elsewhere on the board
BUS_RA: CMP12.PORT0; also elsewhere on the board
unnamed: CMP8.SRC, CMP12.OUT (OUTPUT)
unnamed: CMP8.MSB_1, CMP13.PORT1
unnamed: CMP8.LSB_1, CMP13.PORT2
unnamed: CMP13.PORT0, CMP30.INPUT (OUT)
unnamed: CMP30.P$1 (IN_0), CMP30.P$2 (IN_1), CMP30.P$3 (IN_2), CMP30.P$4 (IN_3), CMP30.P$5 (IN_4), CMP30.P$6 (IN_5), CMP30.P$7 (IN_6), CMP30.P$8 (IN_7), CMP30.P$9 (IN_8), CMP30.P$10 (IN_9), CMP30.P$11 (IN_10), CMP30.P$12 (IN_11), CMP30.P$13 (IN_12), CMP30.P$14 (IN_13), CMP30.P$15 (IN_14), CMP30.P$16 (IN_15)
unnamed: CMP13.PORTOUT (OUTPUT), CMP20.INPUT (IN)
unnamed: CMP18.P$1, CMP20.DISPLAY (DSP)
unnamed: CMP20.OUT, CMP23.P$1 (IN)
NEXT_WR_DATA_MUX_PC_RA_LSB: CMP13.EN2; also elsewhere on the board
NEXT_WR_DATA_MUX_PC_RA_MSB: CMP13.EN1; also elsewhere on the board
NEXT_WR_DATA_MUX_PS: CMP13.EN3; also elsewhere on the board
NEXT_WR_DATA_WIDE_MUX_PC: CMP12.EN1; also elsewhere on the board
NEXT_WR_DATA_WIDE_MUX_RA: CMP12.EN0; also elsewhere on the board

Schematic: module_special_reg.sch, sheet 8

Parts:
CMP15: BUS_4TEE
CMP35: 4X16MUX
CMP38: 16REG
CMP39: 4DIGIT
CMP42: BUS_2_BUS; BUS2BUS
CMP45: BUS_TEE
CMP50: BUS_CONSTRUCT; BUS_SPLIT

Connections:
BUS_ADD2_A: CMP35.PORT1; also elsewhere on the board
BUS_MEMORY_READ_WORD_B: CMP35.PORT2; also elsewhere on the board
BUS_NEXT_PC: CMP45.OUTB (B); also elsewhere on the board
BUS_PC_A: CMP15.3, CMP35.PORT3
BUS_PC_B: CMP15.4; also elsewhere on the board
unnamed: CMP50.P$1 (IN_0), CMP50.P$2 (IN_1)
unnamed: CMP35.PORTOUT (OUTPUT), CMP45.INPUT (IN)
unnamed: CMP38.DISPLAY (DSP), CMP39.P$1
unnamed: CMP15.SRC, CMP38.OUT
unnamed: CMP15.1, CMP42.P$1 (IN)
unnamed: CMP38.INPUT (IN), CMP45.OUT_A (A)
unnamed: CMP50.P$5 (IN_4), CMP50.P$6 (IN_5), CMP50.P$7 (IN_6), CMP50.P$8 (IN_7), CMP50.P$9 (IN_8), CMP50.P$10 (IN_9), CMP50.P$11 (IN_10), CMP50.P$12 (IN_11), CMP50.P$13 (IN_12), CMP50.P$14 (IN_13), CMP50.P$15 (IN_14), CMP50.P$16 (IN_15)
NEXT_PC_MUX_ADD2: CMP35.EN1; also elsewhere on the board
NEXT_PC_MUX_HOLD: CMP35.EN3; also elsewhere on the board
NEXT_PC_MUX_H_AND_DATA: CMP35.EN2; also elsewhere on the board
TRAP_STATE_7: CMP35.EN0; also elsewhere on the board
VECTOR_CODE_0: CMP50.P$3 (IN_2); also elsewhere on the board
VECTOR_CODE_1: CMP50.P$4 (IN_3); also elsewhere on the board
VECTOR_VALUE: CMP35.PORT0, CMP50.INPUT (OUT)

Schematic: module_special_reg.sch, sheet 9

Parts:
CMP51: 2X16MUX
CMP52, CMP57: 16REG
CMP53, CMP58: 4DIGIT
CMP54: BUS_TEE
CMP55, CMP59: BUS_2_BUS; BUS2BUS
CMP56: 4X16MUX

Connections:
BUS_ADD2_B: CMP51.PORT1; also elsewhere on the board
BUS_ADD2_C: CMP56.PORT1; also elsewhere on the board
BUS_MEMORY_READ_WORD_A: CMP56.PORT2; also elsewhere on the board
BUS_NEXT_PC: CMP56.PORT3; also elsewhere on the board
BUS_RI: CMP56.PORT0; also elsewhere on the board
unnamed: CMP51.OUT (OUTPUT), CMP52.INPUT (IN)
unnamed: CMP52.DISPLAY (DSP), CMP53.P$1
unnamed: CMP52.OUT, CMP54.INPUT (IN)
unnamed: CMP56.PORTOUT (OUTPUT), CMP57.INPUT (IN)
unnamed: CMP57.DISPLAY (DSP), CMP58.P$1
unnamed: CMP57.OUT, CMP59.P$1 (IN)
NEXT_ADDR_MUX_ADD2: CMP56.EN1; also elsewhere on the board
NEXT_ADDR_MUX_PC: CMP56.EN3; also elsewhere on the board
NEXT_ADDR_MUX_READ_WORD: CMP56.EN2; also elsewhere on the board
NEXT_ADDR_MUX_RI: CMP56.EN0; also elsewhere on the board
NEXT_SP_MUX_ADD2: CMP51.EN1; also elsewhere on the board
NEXT_SP_MUX_HOLD: CMP51.EN0; also elsewhere on the board
REG_SP_A: CMP51.PORT0, CMP54.OUT_A (A)
REG_SP_B: CMP54.OUTB (B), CMP55.P$1 (IN)

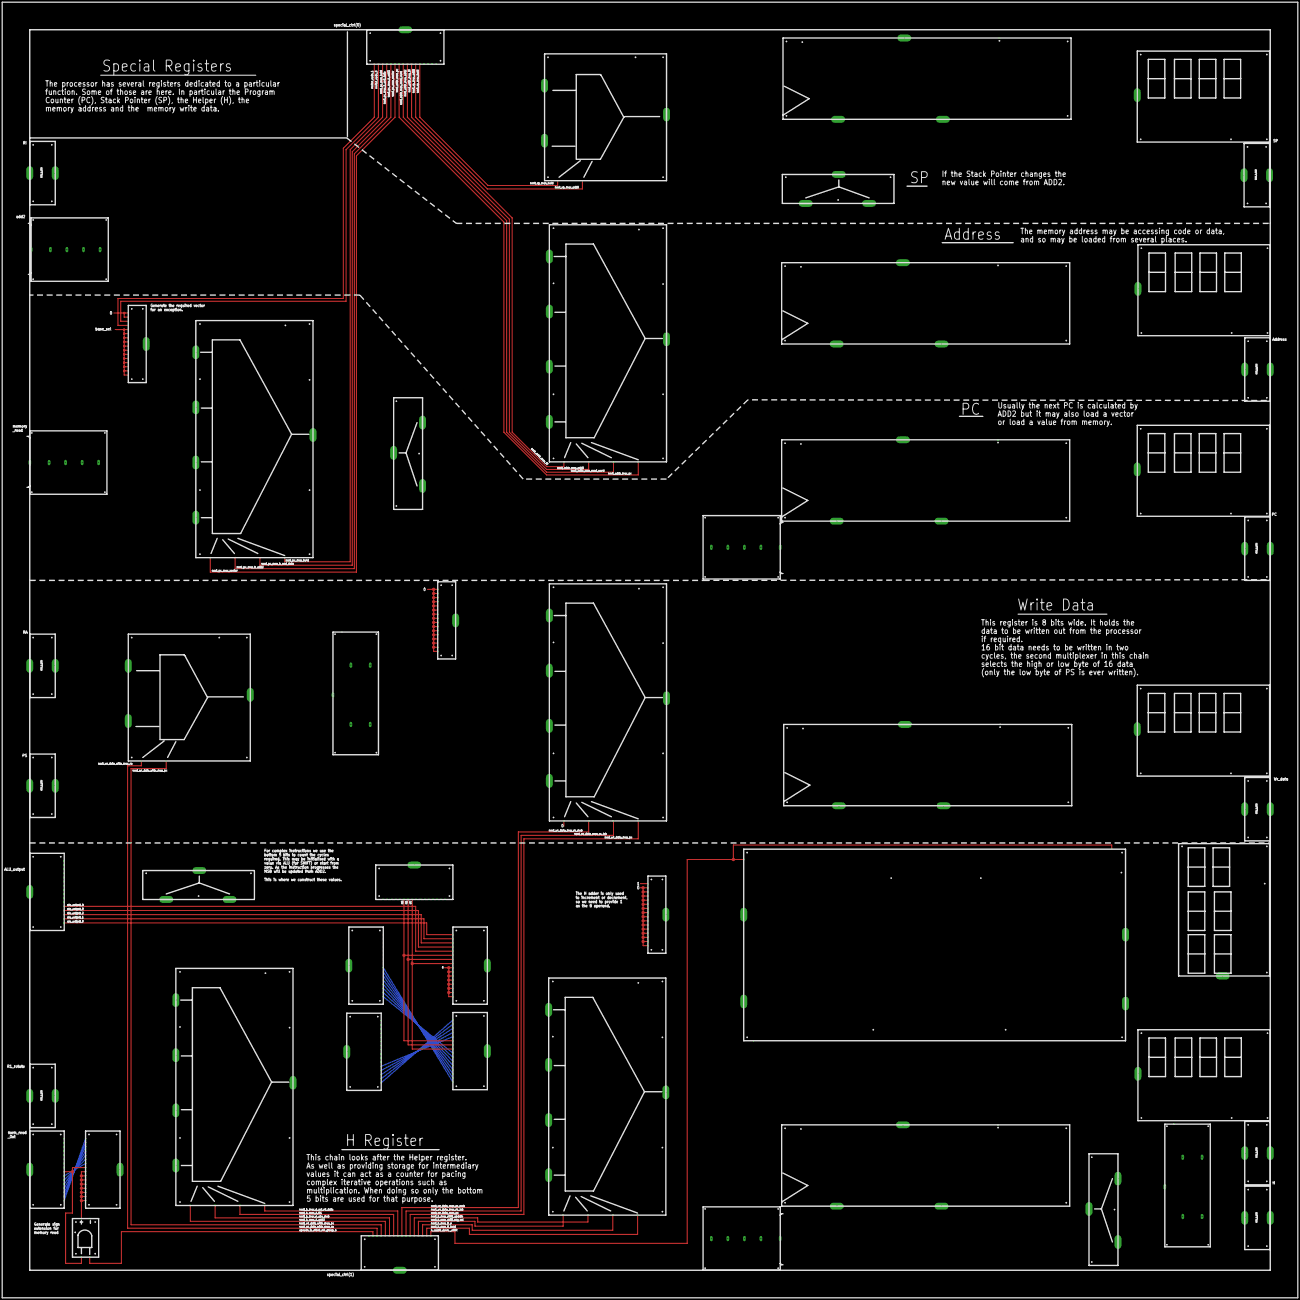
[picture p211: board module_special_reg.brd from above]

Board: 2 copper layers, 1193.8 x 1193.8 mm, 53 parts (0 on the bottom side), 116 nets.
