ericherman/megaprocessor/bus_split/BUS_SPLIT_1.brd

## EAGLE design bus_split/BUS_SPLIT_1.brd (2017-05-20)

Schematic: BUS_SPLIT_1.sch

Parts:
HOLE1, HOLE2, HOLE3, HOLE4: 3M_MOUNT_HOLE; 3M_HOLE
J1: 20_HDR_LOCKING_RA
TP1, TP2, TP3, TP4, TP5, TP6, TP7, TP8, TP9, TP10, TP11, TP12, TP13, TP14, TP15, TP16, TP17: TEST_LOOP

Connections:
D0: J1.2, TP1.P$1
D1: J1.3, TP2.P$1
D2: J1.4, TP3.P$1
D3: J1.5, TP4.P$1
D4: J1.6, TP5.P$1
D5: J1.7, TP6.P$1
D6: J1.8, TP7.P$1
D7: J1.9, TP8.P$1
D8: J1.12, TP9.P$1
D9: J1.13, TP10.P$1
D10: J1.14, TP11.P$1
D11: J1.15, TP12.P$1
D12: J1.16, TP13.P$1
D13: J1.17, TP14.P$1
D14: J1.18, TP15.P$1
D15: J1.19, TP16.P$1
GND: J1.1, J1.10, J1.11, J1.20, TP17.P$1

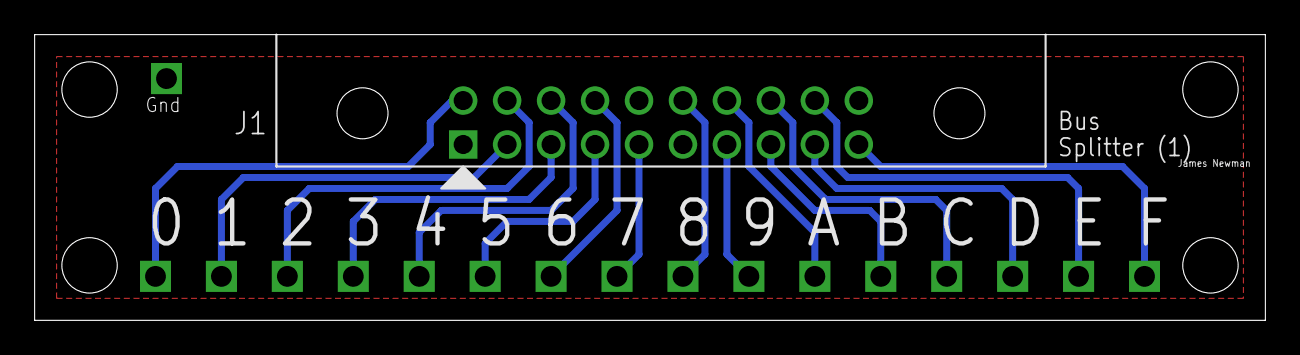
[picture p212: board BUS_SPLIT_1.brd from above]

Board: 2 copper layers, 71.1 x 16.5 mm, 22 parts (0 on the bottom side), 17 nets.
