ericherman/megaprocessor/module_artwork_instr_reg/module_instr_reg.brd

## EAGLE design module_artwork_instr_reg/module_instr_reg.brd (2017-05-20)

Schematic: module_instr_reg.sch, sheet 1

Parts:
CMP16: BUS_SPLIT_DISPLAY

Connections:
BUS_CTRL_INSTR: CMP16.INPUT
NEXT_F_HOLD: CMP16.P$2 (OUT_1); also elsewhere on the board
NEXT_F_LOAD: CMP16.P$1 (OUT_0); also elsewhere on the board
NEXT_INSTR_MUX_F: CMP16.P$5 (OUT_4); also elsewhere on the board
NEXT_INSTR_MUX_HOLD: CMP16.P$6 (OUT_5); also elsewhere on the board
NEXT_INSTR_MUX_READ_DATA: CMP16.P$4 (OUT_3); also elsewhere on the board
TAKE_EXCEPTION: CMP16.P$3 (OUT_2); also elsewhere on the board

Schematic: module_instr_reg.sch, sheet 2

Parts:
CMP1: 4X16MUX
CMP3: BUS_CONSTRUCT; BUS_SPLIT
CMP5, CMP6: BUS_TEE
CMP7, CMP8: 16REG
CMP9: 2X16MUX
CMP10, CMP11: 4DIGIT

Connections:
BUS_F: CMP1.PORT1, CMP6.OUTB (B)
BUS_INSTR: CMP5.OUTB (B); also elsewhere on the board
INSTR_TRAP: CMP1.PORT3, CMP3.INPUT (OUT)
unnamed: CMP8.INPUT (IN), CMP9.OUT (OUTPUT)
unnamed: CMP8.DISPLAY (DSP), CMP10.P$1
unnamed: CMP6.OUT_A (A), CMP9.PORT0
unnamed: CMP1.PORTOUT (OUTPUT), CMP7.INPUT (IN)
unnamed: CMP6.INPUT (IN), CMP8.OUT
unnamed: CMP1.PORT0, CMP5.OUT_A (A)
unnamed: CMP7.DISPLAY (DSP), CMP11.P$1
unnamed: CMP5.INPUT (IN), CMP7.OUT
unnamed: CMP3.P$2 (IN_1), CMP3.P$5 (IN_4), CMP3.P$6 (IN_5), CMP3.P$9 (IN_8), CMP3.P$10 (IN_9), CMP3.P$11 (IN_10), CMP3.P$12 (IN_11), CMP3.P$13 (IN_12), CMP3.P$14 (IN_13), CMP3.P$15 (IN_14), CMP3.P$16 (IN_15)
unnamed: CMP3.P$1 (IN_0), CMP3.P$3 (IN_2), CMP3.P$4 (IN_3), CMP3.P$7 (IN_6), CMP3.P$8 (IN_7)
NEXT_F_HOLD: CMP9.EN0; also elsewhere on the board
NEXT_F_LOAD: CMP9.EN1; also elsewhere on the board
NEXT_INSTR_MUX_F: CMP1.EN1; also elsewhere on the board
NEXT_INSTR_MUX_HOLD: CMP1.EN0; also elsewhere on the board
NEXT_INSTR_MUX_READ_DATA: CMP1.EN2; also elsewhere on the board
READ_DATA_INPUT_A: CMP1.PORT2; also elsewhere on the board
READ_DATA_INPUT_B: CMP9.PORT1; also elsewhere on the board
TAKE_EXCEPTION: CMP1.EN3; also elsewhere on the board

Schematic: module_instr_reg.sch, sheet 3

Parts:
CMP2, CMP4: WORD_BYTE
CMP12: BUS_4TEE
U$1, U$2: BYTE_WORD; WORD_BYTE

Connections:
BUS_0XT_READ_DATA: U$1.SRC (WORD)
BUS_H: CMP2.SRC
BUS_MEMORY_READ_WORD: U$2.SRC (WORD)
unnamed: CMP2.LSB_1, U$2.LSB_1
unnamed: CMP4.LSB_1, U$1.LSB_2
unnamed: CMP4.LSB_2, U$2.MSB_1
READ_DATA_INPUT_A: CMP12.1; also elsewhere on the board
READ_DATA_INPUT_B: CMP12.2; also elsewhere on the board
READ_DATA_INPUT_C: CMP4.SRC, CMP12.3

Schematic: module_instr_reg.sch, sheet 4

Parts:
CMP13: BUS_SPLIT_DISPLAY
CMP14, CMP15: 4BUF
CMP17: BUS_CONSTRUCT_DISPLAY; BUS_SPLIT_DISPLAY

Connections:
BUS_INSTR: CMP13.INPUT; also elsewhere on the board
I0: CMP13.P$1 (OUT_0), CMP14.A4 (IN)
INSTR_0: CMP14.P4, CMP17.P$1 (IN_0)
INSTR_0_N: CMP14.N4 (N), CMP17.P$9 (IN_8)
unnamed: CMP13.P$2 (OUT_1), CMP14.A3 (IN)
unnamed: CMP13.P$3 (OUT_2), CMP14.A2 (IN)
unnamed: CMP13.P$4 (OUT_3), CMP14.A1 (IN)
unnamed: CMP13.P$5 (OUT_4), CMP15.A4 (IN)
unnamed: CMP13.P$6 (OUT_5), CMP15.A3 (IN)
unnamed: CMP13.P$7 (OUT_6), CMP15.A2 (IN)
unnamed: CMP13.P$8 (OUT_7), CMP15.A1 (IN)
unnamed: CMP14.P3, CMP17.P$2 (IN_1)
unnamed: CMP14.P2, CMP17.P$3 (IN_2)
unnamed: CMP14.P1, CMP17.P$4 (IN_3)
unnamed: CMP15.P4, CMP17.P$5 (IN_4)
unnamed: CMP15.P3, CMP17.P$6 (IN_5)
unnamed: CMP15.P2, CMP17.P$7 (IN_6)
unnamed: CMP15.P1, CMP17.P$8 (IN_7)
unnamed: CMP14.N3 (N), CMP17.P$10 (IN_9)
unnamed: CMP14.N2 (N), CMP17.P$11 (IN_10)
unnamed: CMP14.N1 (N), CMP17.P$12 (IN_11)
unnamed: CMP15.N4 (N), CMP17.P$13 (IN_12)
unnamed: CMP15.N3 (N), CMP17.P$14 (IN_13)
unnamed: CMP15.N2 (N), CMP17.P$15 (IN_14)
unnamed: CMP15.N1 (N), CMP17.P$16 (IN_15)

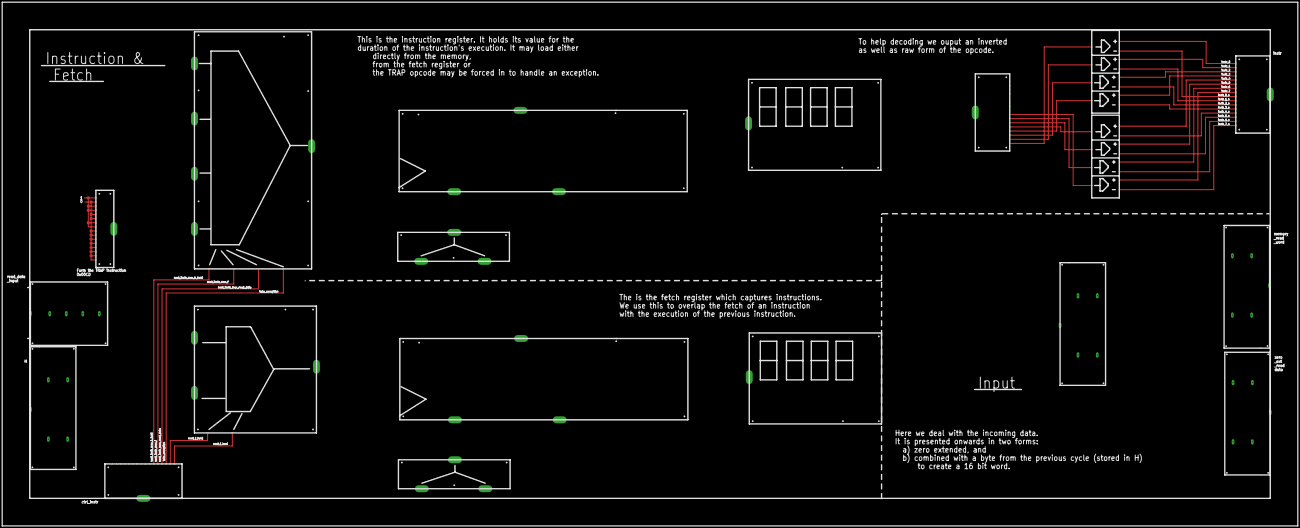
[picture p213: board module_instr_reg.brd from above]

Board: 2 copper layers, 1193.8 x 482.6 mm, 19 parts (0 on the bottom side), 49 nets.
