ericherman/megaprocessor/buf_bus_tee/BUF_BUS_TEE_1.brd

## EAGLE design buf_bus_tee/BUF_BUS_TEE_1.brd (2017-05-20)

Schematic: BUF_BUS_TEE_1.sch, sheet 1

Parts:
C1: 100n; CAP_P2INCH
HOLE1, HOLE2, HOLE3, HOLE4: 3M_MOUNT_HOLE; 3M_HOLE
J1, J2, J3: 20_HDR_LOCKING_RA
PP1, PP2: POWER_PAD

Connections:
+5V: C1.1, PP2.1; also elsewhere on the board
A0: J2.2; also elsewhere on the board
A1: J2.3; also elsewhere on the board
A2: J2.4; also elsewhere on the board
A3: J2.5; also elsewhere on the board
A4: J2.6; also elsewhere on the board
A5: J2.7; also elsewhere on the board
A6: J2.8; also elsewhere on the board
A7: J2.9; also elsewhere on the board
A8: J2.12; also elsewhere on the board
A9: J2.13; also elsewhere on the board
A10: J2.14; also elsewhere on the board
A11: J2.15; also elsewhere on the board
A12: J2.16; also elsewhere on the board
A13: J2.17; also elsewhere on the board
A14: J2.18; also elsewhere on the board
A15: J2.19; also elsewhere on the board
B0: J3.2; also elsewhere on the board
B1: J3.3; also elsewhere on the board
B2: J3.4; also elsewhere on the board
B3: J3.5; also elsewhere on the board
B4: J3.6; also elsewhere on the board
B5: J3.7; also elsewhere on the board
B6: J3.8; also elsewhere on the board
B7: J3.9; also elsewhere on the board
B8: J3.12; also elsewhere on the board
B9: J3.13; also elsewhere on the board
B10: J3.14; also elsewhere on the board
B11: J3.15; also elsewhere on the board
B12: J3.16; also elsewhere on the board
B13: J3.17; also elsewhere on the board
B14: J3.18; also elsewhere on the board
B15: J3.19; also elsewhere on the board
GND: C1.2, J1.1, J1.10, J1.11, J1.20, J2.1, J2.10, J2.11, J2.20, J3.1, J3.10, J3.11, J3.20, PP1.1; also elsewhere on the board
IN0: J1.2; also elsewhere on the board
IN1: J1.3; also elsewhere on the board
IN2: J1.4; also elsewhere on the board
IN3: J1.5; also elsewhere on the board
IN4: J1.6; also elsewhere on the board
IN5: J1.7; also elsewhere on the board
IN6: J1.8; also elsewhere on the board
IN7: J1.9; also elsewhere on the board
IN8: J1.12; also elsewhere on the board
IN9: J1.13; also elsewhere on the board
IN10: J1.14; also elsewhere on the board
IN11: J1.15; also elsewhere on the board
IN12: J1.16; also elsewhere on the board
IN13: J1.17; also elsewhere on the board
IN14: J1.18; also elsewhere on the board
IN15: J1.19; also elsewhere on the board

Schematic: BUF_BUS_TEE_1.sch, sheet 2

Parts:
Q1, Q2, Q3, Q4, Q5, Q6, Q7, Q8, Q9, Q10, Q11, Q12, Q13, Q14, Q15, Q16: 2N7000; TO92-DGS
R1, R2, R3, R4, R5, R6, R7, R8, R9, R10, R11, R12, R13, R14, R15, R16: 10k; R_P2INCH

Connections:
+5V: R1.2, R2.2, R3.2, R4.2, R5.2, R6.2, R7.2, R8.2, R9.2, R10.2, R11.2, R12.2, R13.2, R14.2, R15.2, R16.2; also elsewhere on the board
D0_N: Q1.D, R1.1; also elsewhere on the board
D1_N: Q2.D, R2.1; also elsewhere on the board
D2_N: Q3.D, R3.1; also elsewhere on the board
D3_N: Q4.D, R4.1; also elsewhere on the board
D4_N: Q5.D, R5.1; also elsewhere on the board
D5_N: Q6.D, R6.1; also elsewhere on the board
D6_N: Q7.D, R7.1; also elsewhere on the board
D7_N: Q8.D, R8.1; also elsewhere on the board
D8_N: Q9.D, R9.1; also elsewhere on the board
D9_N: Q10.D, R10.1; also elsewhere on the board
D10_N: Q11.D, R11.1; also elsewhere on the board
D11_N: Q12.D, R12.1; also elsewhere on the board
D12_N: Q13.D, R13.1; also elsewhere on the board
D13_N: Q14.D, R14.1; also elsewhere on the board
D14_N: Q15.D, R15.1; also elsewhere on the board
D15_N: Q16.D, R16.1; also elsewhere on the board
GND: Q1.S, Q2.S, Q3.S, Q4.S, Q5.S, Q6.S, Q7.S, Q8.S, Q9.S, Q10.S, Q11.S, Q12.S, Q13.S, Q14.S, Q15.S, Q16.S; also elsewhere on the board
IN0: Q1.G; also elsewhere on the board
IN1: Q2.G; also elsewhere on the board
IN2: Q3.G; also elsewhere on the board
IN3: Q4.G; also elsewhere on the board
IN4: Q5.G; also elsewhere on the board
IN5: Q6.G; also elsewhere on the board
IN6: Q7.G; also elsewhere on the board
IN7: Q8.G; also elsewhere on the board
IN8: Q9.G; also elsewhere on the board
IN9: Q10.G; also elsewhere on the board
IN10: Q11.G; also elsewhere on the board
IN11: Q12.G; also elsewhere on the board
IN12: Q13.G; also elsewhere on the board
IN13: Q14.G; also elsewhere on the board
IN14: Q15.G; also elsewhere on the board
IN15: Q16.G; also elsewhere on the board

Schematic: BUF_BUS_TEE_1.sch, sheet 3

Parts:
Q17, Q18, Q19, Q20, Q21, Q22, Q23, Q24, Q25, Q26, Q27, Q28, Q29, Q30, Q31, Q32: 2N7000; TO92-DGS
R17, R18, R19, R20, R21, R22, R23, R24, R25, R26, R27, R28, R29, R30, R31, R32: 10k; R_P2INCH

Connections:
+5V: R17.2, R18.2, R19.2, R20.2, R21.2, R22.2, R23.2, R24.2, R25.2, R26.2, R27.2, R28.2, R29.2, R30.2, R31.2, R32.2; also elsewhere on the board
A0: Q17.D, R17.1; also elsewhere on the board
A1: Q18.D, R18.1; also elsewhere on the board
A2: Q19.D, R19.1; also elsewhere on the board
A3: Q20.D, R20.1; also elsewhere on the board
A4: Q21.D, R21.1; also elsewhere on the board
A5: Q22.D, R22.1; also elsewhere on the board
A6: Q23.D, R23.1; also elsewhere on the board
A7: Q24.D, R24.1; also elsewhere on the board
A8: Q25.D, R25.1; also elsewhere on the board
A9: Q26.D, R26.1; also elsewhere on the board
A10: Q27.D, R27.1; also elsewhere on the board
A11: Q28.D, R28.1; also elsewhere on the board
A12: Q29.D, R29.1; also elsewhere on the board
A13: Q30.D, R30.1; also elsewhere on the board
A14: Q31.D, R31.1; also elsewhere on the board
A15: Q32.D, R32.1; also elsewhere on the board
D0_N: Q17.G; also elsewhere on the board
D1_N: Q18.G; also elsewhere on the board
D2_N: Q19.G; also elsewhere on the board
D3_N: Q20.G; also elsewhere on the board
D4_N: Q21.G; also elsewhere on the board
D5_N: Q22.G; also elsewhere on the board
D6_N: Q23.G; also elsewhere on the board
D7_N: Q24.G; also elsewhere on the board
D8_N: Q25.G; also elsewhere on the board
D9_N: Q26.G; also elsewhere on the board
D10_N: Q27.G; also elsewhere on the board
D11_N: Q28.G; also elsewhere on the board
D12_N: Q29.G; also elsewhere on the board
D13_N: Q30.G; also elsewhere on the board
D14_N: Q31.G; also elsewhere on the board
D15_N: Q32.G; also elsewhere on the board
GND: Q17.S, Q18.S, Q19.S, Q20.S, Q21.S, Q22.S, Q23.S, Q24.S, Q25.S, Q26.S, Q27.S, Q28.S, Q29.S, Q30.S, Q31.S, Q32.S; also elsewhere on the board

Schematic: BUF_BUS_TEE_1.sch, sheet 4

Parts:
Q33, Q34, Q35, Q36, Q37, Q38, Q39, Q40, Q41, Q42, Q43, Q44, Q45, Q46, Q47, Q48: 2N7000; TO92-DGS
R33, R34, R35, R36, R37, R38, R39, R40, R41, R42, R43, R44, R45, R46, R47, R48: 10k; R_P2INCH

Connections:
+5V: R33.2, R34.2, R35.2, R36.2, R37.2, R38.2, R39.2, R40.2, R41.2, R42.2, R43.2, R44.2, R45.2, R46.2, R47.2, R48.2; also elsewhere on the board
B0: Q33.D, R33.1; also elsewhere on the board
B1: Q34.D, R34.1; also elsewhere on the board
B2: Q35.D, R35.1; also elsewhere on the board
B3: Q36.D, R36.1; also elsewhere on the board
B4: Q37.D, R37.1; also elsewhere on the board
B5: Q38.D, R38.1; also elsewhere on the board
B6: Q39.D, R39.1; also elsewhere on the board
B7: Q40.D, R40.1; also elsewhere on the board
B8: Q41.D, R41.1; also elsewhere on the board
B9: Q42.D, R42.1; also elsewhere on the board
B10: Q43.D, R43.1; also elsewhere on the board
B11: Q44.D, R44.1; also elsewhere on the board
B12: Q45.D, R45.1; also elsewhere on the board
B13: Q46.D, R46.1; also elsewhere on the board
B14: Q47.D, R47.1; also elsewhere on the board
B15: Q48.D, R48.1; also elsewhere on the board
D0_N: Q33.G; also elsewhere on the board
D1_N: Q34.G; also elsewhere on the board
D2_N: Q35.G; also elsewhere on the board
D3_N: Q36.G; also elsewhere on the board
D4_N: Q37.G; also elsewhere on the board
D5_N: Q38.G; also elsewhere on the board
D6_N: Q39.G; also elsewhere on the board
D7_N: Q40.G; also elsewhere on the board
D8_N: Q41.G; also elsewhere on the board
D9_N: Q42.G; also elsewhere on the board
D10_N: Q43.G; also elsewhere on the board
D11_N: Q44.G; also elsewhere on the board
D12_N: Q45.G; also elsewhere on the board
D13_N: Q46.G; also elsewhere on the board
D14_N: Q47.G; also elsewhere on the board
D15_N: Q48.G; also elsewhere on the board
GND: Q33.S, Q34.S, Q35.S, Q36.S, Q37.S, Q38.S, Q39.S, Q40.S, Q41.S, Q42.S, Q43.S, Q44.S, Q45.S, Q46.S, Q47.S, Q48.S; also elsewhere on the board

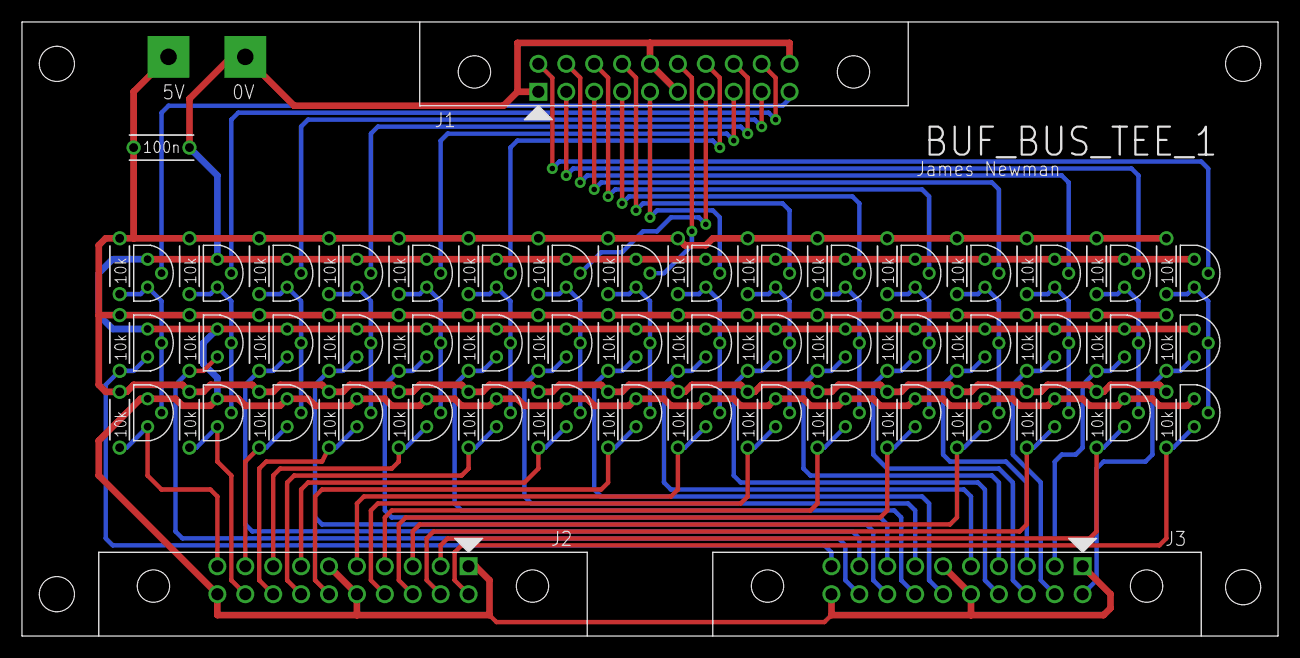
[picture p214: board BUF_BUS_TEE_1.brd from above]

Board: 2 copper layers, 114.3 x 55.9 mm, 106 parts (0 on the bottom side), 66 nets.
