ericherman/megaprocessor/module_artwork_alu_ctrl/module_alu1_ctrl.brd

## EAGLE design module_artwork_alu_ctrl/module_alu1_ctrl.brd (2017-05-20)

Schematic: module_alu1_ctrl.sch, sheet 1

Parts:
CMP13, CMP15, CMP21: BUS_SPLIT_DISPLAY

Connections:
BUS_H_D: CMP13.INPUT
BUS_PS: CMP21.INPUT
BUS_RA_FLAGS: CMP15.INPUT
FLAG_C: CMP21.P$6 (OUT_5)
FLAG_D: CMP21.P$7 (OUT_6)
FLAG_F0: CMP21.P$9 (OUT_8)
FLAG_F1: CMP21.P$10 (OUT_9)
FLAG_F2: CMP21.P$11 (OUT_10)
FLAG_F3: CMP21.P$12 (OUT_11); also elsewhere on the board
FLAG_F4: CMP21.P$13 (OUT_12)
FLAG_F5: CMP21.P$14 (OUT_13)
FLAG_F6: CMP21.P$15 (OUT_14); also elsewhere on the board
FLAG_I: CMP21.P$1 (OUT_0)
FLAG_N: CMP21.P$2 (OUT_1)
FLAG_V: CMP21.P$4 (OUT_3)
FLAG_X: CMP21.P$5 (OUT_4); also elsewhere on the board
FLAG_Z: CMP21.P$3 (OUT_2)
H_0: CMP13.P$1 (OUT_0); also elsewhere on the board
H_1: CMP13.P$2 (OUT_1); also elsewhere on the board
H_2: CMP13.P$3 (OUT_2); also elsewhere on the board
H_3: CMP13.P$4 (OUT_3); also elsewhere on the board
H_4: CMP13.P$5 (OUT_4); also elsewhere on the board
H_5: CMP13.P$6 (OUT_5)
H_6: CMP13.P$7 (OUT_6); also elsewhere on the board
H_7: CMP13.P$8 (OUT_7); also elsewhere on the board
H_8: CMP13.P$9 (OUT_8)
H_9: CMP13.P$10 (OUT_9)
H_10: CMP13.P$11 (OUT_10)
H_11: CMP13.P$12 (OUT_11)
H_12: CMP13.P$13 (OUT_12)
H_13: CMP13.P$14 (OUT_13)
H_14: CMP13.P$15 (OUT_14)
H_15: CMP13.P$16 (OUT_15)
RA_MUX_IS_N: CMP15.P$1 (OUT_0); also elsewhere on the board
RA_MUX_IS_Z: CMP15.P$2 (OUT_1)
RA_MUX_LSB: CMP15.P$3 (OUT_2); also elsewhere on the board

Notes on the sheet:
clBit RA_mux_is_n; // 0 clBit RA_mux_is_z; // 1 clBit RA_mux_lsb; // 2

Schematic: module_alu1_ctrl.sch, sheet 2

Parts:
CMP1, CMP12, CMP22: BUS_SPLIT_DISPLAY

Connections:
ADD2_X_MUX_RI__H: CMP22.P$1 (OUT_0); also elsewhere on the board
ADD2_X_MUX_RI__SP: CMP22.P$3 (OUT_2); also elsewhere on the board
ADD2_X_MUX_RI__SP__JSR_ABS: CMP22.P$2 (OUT_1)
ADDER_X_SPECIAL: CMP22.P$5 (OUT_4); also elsewhere on the board
ADDER_Y_SPECIAL: CMP22.P$6 (OUT_5); also elsewhere on the board
BUS_RNX_SPECIALS: CMP22.INPUT
BUS_RN_ARITH_FLAGS: CMP1.INPUT
BUS_STATE: CMP12.INPUT
NEXT_ADDR_MUX_RI__SP: CMP22.P$4 (OUT_3)
R0_IS_N: CMP1.P$1 (OUT_0); also elsewhere on the board
R0_IS_Z: CMP1.P$5 (OUT_4)
R1_IS_N: CMP1.P$2 (OUT_1); also elsewhere on the board
R1_IS_Z: CMP1.P$6 (OUT_5)
R2_IS_N: CMP1.P$3 (OUT_2)
R2_IS_Z: CMP1.P$7 (OUT_6)
R3_IS_N: CMP1.P$4 (OUT_3)
R3_IS_Z: CMP1.P$8 (OUT_7)
STATE_0: CMP12.P$1 (OUT_0); also elsewhere on the board
STATE_1: CMP12.P$2 (OUT_1); also elsewhere on the board
STATE_2: CMP12.P$3 (OUT_2); also elsewhere on the board
STATE_3: CMP12.P$4 (OUT_3); also elsewhere on the board
STATE_4: CMP12.P$5 (OUT_4)
STATE_5: CMP12.P$6 (OUT_5)
STATE_6: CMP12.P$7 (OUT_6); also elsewhere on the board
STATE_7: CMP12.P$8 (OUT_7); also elsewhere on the board
STATE_8: CMP12.P$9 (OUT_8)
STATE_9: CMP12.P$10 (OUT_9)
STATE_10: CMP12.P$11 (OUT_10); also elsewhere on the board
STATE_11: CMP12.P$12 (OUT_11); also elsewhere on the board
STATE_12: CMP12.P$13 (OUT_12); also elsewhere on the board
STATE_13: CMP12.P$14 (OUT_13); also elsewhere on the board
STATE_14: CMP12.P$15 (OUT_14); also elsewhere on the board
STATE_15: CMP12.P$16 (OUT_15); also elsewhere on the board

Notes on the sheet:
clBit add2_x_mux_ri__h; // 0 clBit add2_x_mux_ri__sp__jsr_abs; // 1 clBit add2_x_mux_ri__sp; // 2 clBit next_addr_mux_ri__sp; // 3 clBit adder_x_special; // 4 clBit adder_y_special; // 5

Schematic: module_alu1_ctrl.sch, sheet 3

Parts:
CMP88, CMP92, CMP94: BUS_SPLIT_DISPLAY

Connections:
BUS_DECODE_ALU_1: CMP92.INPUT
BUS_DECODE_ALU_2: CMP88.INPUT
BUS_DECODE_ALU_3: CMP94.INPUT
K_0: CMP94.P$7 (OUT_6); also elsewhere on the board
K_1: CMP94.P$8 (OUT_7); also elsewhere on the board
K_N: CMP94.P$9 (OUT_8); also elsewhere on the board
OPCODE_IS_ABS: CMP88.P$14 (OUT_13); also elsewhere on the board
OPCODE_IS_ADDQ_GROUP: CMP94.P$6 (OUT_5); also elsewhere on the board
OPCODE_IS_ADDX: CMP88.P$12 (OUT_11); also elsewhere on the board
OPCODE_IS_ADD_GROUP: CMP88.P$9 (OUT_8); also elsewhere on the board
OPCODE_IS_ADD_SP_STATE_2: CMP92.P$15 (OUT_14); also elsewhere on the board
OPCODE_IS_AND_GROUP: CMP88.P$8 (OUT_7); also elsewhere on the board
OPCODE_IS_BIT_XX: CMP88.P$5 (OUT_4); also elsewhere on the board
OPCODE_IS_BIT_XX_N: CMP94.P$2 (OUT_1); also elsewhere on the board
OPCODE_IS_BXX_STATE_2: CMP88.P$1 (OUT_0); also elsewhere on the board
OPCODE_IS_CMP: CMP94.P$1 (OUT_0); also elsewhere on the board
OPCODE_IS_CMP_GROUP: CMP94.P$10 (OUT_9); also elsewhere on the board
OPCODE_IS_DIV: CMP88.P$15 (OUT_14); also elsewhere on the board
OPCODE_IS_DIVS_STATE_0: CMP92.P$2 (OUT_1); also elsewhere on the board
OPCODE_IS_DIV_STATE_0: CMP92.P$7 (OUT_6); also elsewhere on the board
OPCODE_IS_INDIRECT_POSTINC: CMP92.P$9 (OUT_8); also elsewhere on the board
OPCODE_IS_INV: CMP94.P$3 (OUT_2); also elsewhere on the board
OPCODE_IS_JMP_R0: CMP92.P$11 (OUT_10); also elsewhere on the board
OPCODE_IS_JSR_ABS: CMP92.P$14 (OUT_13); also elsewhere on the board
OPCODE_IS_JSR_R0: CMP92.P$5 (OUT_4); also elsewhere on the board
OPCODE_IS_JSR_X_STATE_7: CMP92.P$8 (OUT_7); also elsewhere on the board
OPCODE_IS_LOGIC_GROUP: CMP88.P$3 (OUT_2); also elsewhere on the board
OPCODE_IS_MOVER: CMP94.P$11 (OUT_10); also elsewhere on the board
OPCODE_IS_MOVE_R0_SP_STATE_0: CMP92.P$12 (OUT_11); also elsewhere on the board
OPCODE_IS_MOVE_SP_R0: CMP92.P$10 (OUT_9); also elsewhere on the board
OPCODE_IS_MULS: CMP88.P$13 (OUT_12); also elsewhere on the board
OPCODE_IS_MUL_N: CMP92.P$13 (OUT_12); also elsewhere on the board
OPCODE_IS_NEG: CMP88.P$4 (OUT_3); also elsewhere on the board
OPCODE_IS_NEGX: CMP88.P$10 (OUT_9); also elsewhere on the board
OPCODE_IS_OR: CMP88.P$7 (OUT_6); also elsewhere on the board
OPCODE_IS_OR_GROUP: CMP94.P$12 (OUT_11); also elsewhere on the board
OPCODE_IS_PUSH_PS: CMP92.P$3 (OUT_2); also elsewhere on the board
OPCODE_IS_PUSH_RA: CMP92.P$4 (OUT_3); also elsewhere on the board
OPCODE_IS_SHIFT_XX: CMP88.P$2 (OUT_1); also elsewhere on the board
OPCODE_IS_SQRT: CMP88.P$16 (OUT_15); also elsewhere on the board
OPCODE_IS_STACK_GROUP: CMP94.P$5 (OUT_4); also elsewhere on the board
OPCODE_IS_STACK_REL_STATE_2: CMP92.P$16 (OUT_15); also elsewhere on the board
OPCODE_IS_SUB: CMP88.P$6 (OUT_5); also elsewhere on the board
OPCODE_IS_SUBX: CMP88.P$11 (OUT_10); also elsewhere on the board
OPCODE_IS_SUB_GROUP: CMP94.P$4 (OUT_3); also elsewhere on the board
OPCODE_IS_TRAP: CMP92.P$6 (OUT_5); also elsewhere on the board
OPCODE_IS_XOR_GROUP: CMP94.P$13 (OUT_12); also elsewhere on the board
SHIFT_IS_SHIFTING: CMP92.P$1 (OUT_0); also elsewhere on the board

Notes on the sheet:
clBit shift_is_shifting; // 0 clBit opcode_is_divs_state_0; // 1 clBit opcode_is_push_ps; // 2 clBit opcode_is_push_ra; // 3 clBit opcode_is_jsr_r0; // 4 clBit opcode_is_trap; // 5 clBit opcode_is_div_state_0; // 6 clBit opcode_is_jsr_x_state_7; // 7 clBit opcode_is_indirect_postinc; // 8 clBit opc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
clBit opcode_is_bxx_state_2; // 0 clBit opcode_is_shift_xx; // 1 clBit opcode_is_logic_group; // 2 clBit opcode_is_neg; // 3 clBit opcode_is_bit_xx; // 4 clBit opcode_is_sub; // 5 clBit opcode_is_or; // 6 clBit opcode_is_and_group; // 7 clBit opcode_is_add_group; // 8 clBit opcode_is_negx; // 9 clB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
clBit opcode_is_cmp; // 0 clBit opcode_is_bit_xx_n; // 1 clBit opcode_is_inv; // 2 clBit opcode_is_sub_group; // 3 clBit opcode_is_stack_group; // 4 clBit opcode_is_addq_group; // 5 clBit k_0; // 6 clBit k_1; // 7 clBit k_m; // 8 clBit opcode_is_cmp_group; // 9 clBit opcode_is_mover; // 10 clBit op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

Schematic: module_alu1_ctrl.sch, sheet 4

Parts:
CMP35: DECODER16
CMP39: BUS_CONSTRUCT_DISPLAY; BUS_SPLIT_DISPLAY
CMP40: BUS_2_BUS; BUS2BUS

Connections:
H_1: CMP35.A1; also elsewhere on the board
H_2: CMP35.A2; also elsewhere on the board
H_3: CMP35.A3; also elsewhere on the board
unnamed: CMP35.P0, CMP39.P$15 (IN_14)
unnamed: CMP35.P1, CMP39.P$14 (IN_13)
unnamed: CMP35.P2, CMP39.P$13 (IN_12)
unnamed: CMP35.P3, CMP39.P$12 (IN_11)
unnamed: CMP35.P4, CMP39.P$11 (IN_10)
unnamed: CMP35.P5, CMP39.P$10 (IN_9)
unnamed: CMP35.P6, CMP39.P$9 (IN_8)
unnamed: CMP35.P7, CMP39.P$8 (IN_7)
unnamed: CMP35.P8, CMP39.P$7 (IN_6)
unnamed: CMP35.P9, CMP39.P$6 (IN_5)
unnamed: CMP35.P10, CMP39.P$5 (IN_4)
unnamed: CMP35.P11, CMP39.P$4 (IN_3)
unnamed: CMP35.P12, CMP39.P$3 (IN_2)
unnamed: CMP35.P13, CMP39.P$2 (IN_1)
unnamed: CMP35.P14, CMP39.P$1 (IN_0)
unnamed: CMP35.P15, CMP39.P$16 (IN_15)
unnamed: CMP39.INPUT (OUT), CMP40.P$1 (IN)

Schematic: module_alu1_ctrl.sch, sheet 5

Parts:
CMP10: DECODER4
CMP20: 2AND
CMP24, CMP27: 2OR
CMP26: 8OR
CMP41: 1BUF

Connections:
ALU1_X_MUX_RA__SET_A: CMP26.OUT_P; also elsewhere on the board
ALU1_X_MUX_SHIFT_R3: CMP27.OUT_P; also elsewhere on the board
ALU1_X_MUX_SHIFT_R3_N: CMP27.OUT_M (N); also elsewhere on the board
BIT_SELECT_ENABLE: CMP41.N; also elsewhere on the board
BIT_SHIFT_MODE_CHANGE__ARITH: CMP10.P1; also elsewhere on the board
BIT_SHIFT_MODE_CLEAR__ROTATE: CMP10.P2; also elsewhere on the board
BIT_SHIFT_MODE_CLEAR__ROTATE_N: CMP10.N2; also elsewhere on the board
BIT_SHIFT_MODE_SET__X_ROT: CMP10.P3; also elsewhere on the board
BIT_SHIFT_MODE_TEST__LOGICAL: CMP10.P0
BIT_XX_ACTION_CYCLE: CMP24.OUT_M (N), CMP26.3 (2); also elsewhere on the board
BIT_XX_LOAD_CYCLE: CMP20.OUT_P; also elsewhere on the board
H_6: CMP10.A0; also elsewhere on the board
H_7: CMP10.A1; also elsewhere on the board
OPCODE_IS_ADDQ_GROUP: CMP26.6 (5); also elsewhere on the board
OPCODE_IS_ADD_GROUP: CMP26.2 (1); also elsewhere on the board
OPCODE_IS_AND_GROUP: CMP26.1 (0); also elsewhere on the board
OPCODE_IS_BIT_XX: CMP20.P$1 (1); also elsewhere on the board
OPCODE_IS_BIT_XX_N: CMP24.P$2 (A1); also elsewhere on the board
OPCODE_IS_CMP: CMP26.5 (4); also elsewhere on the board
OPCODE_IS_INV: CMP41.IN; also elsewhere on the board
OPCODE_IS_OR_GROUP: CMP26.8 (7); also elsewhere on the board
OPCODE_IS_SUB: CMP26.7 (6); also elsewhere on the board
OPCODE_IS_XOR_GROUP: CMP26.4 (3); also elsewhere on the board
STATE_1: CMP20.P$2 (2), CMP24.P$1 (A2); also elsewhere on the board
STATE_11: CMP27.P$1 (A2); also elsewhere on the board
STATE_13: CMP27.P$2 (A1); also elsewhere on the board

Notes on the sheet:
bit_select_enable = ~bus_decode_alu_1.opcode_is_inv;
bit_xx_load_cycle = Cpnt_2AND(bus_decode_alu_2.opcode_is_bit_xx, bus_state[1]);
bit_xx_action_cycle = ~Cpnt_2OR(bus_decode_alu_3.opcode_is_bit_xx_n, bus_state[1]);
alu1_x_mux_RA__set_A = Cpnt_8OR(bus_decode_alu_1.opcode_is_add_group, bus_decode_alu_1.opcode_is_addq_group, bus_decode_alu_1.opcode_is_sub, bus_decode_alu_1.opcode_is_cmp, bus_decode_alu_1.opcode_is_and_group, bus_decode_alu_1.opcode_is_or_group, bus_decode_alu_1.opcode_is_xor_group, bit_xx_action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
alu1_x_mux_shift_r3 = Cpnt_2OR(bus_state[13], bus_state[11]);

Schematic: module_alu1_ctrl.sch, sheet 6

Parts:
CMP28, CMP33: 2X2AND_OR
CMP29: 8OR
CMP30: 3OR
CMP31: 4OR
CMP32: 2AND

Connections:
ADDER_X_SPECIAL: CMP28.P$2 (A1); also elsewhere on the board
ADDER_Y_SPECIAL: CMP29.2 (1); also elsewhere on the board
ALU1_X_MUX_RA: CMP28.OUT_P; also elsewhere on the board
ALU1_X_MUX_RA__SET_A: CMP28.P$4 (B1); also elsewhere on the board
ALU1_X_MUX_SHIFT_R3_N: CMP28.P$1 (A0), CMP28.P$3 (B0); also elsewhere on the board
ALU1_Y_MUX_BIT: CMP32.OUT_P; also elsewhere on the board
ALU1_Y_MUX_K: CMP31.OUT_P; also elsewhere on the board
ALU1_Y_MUX_NOT_BIT: CMP33.OUT_P; also elsewhere on the board
ALU1_Y_MUX_RB: CMP30.OUT_P; also elsewhere on the board
ALU1_Y_MUX_RB_A: CMP29.OUT_P, CMP30.P$3 (2)
BIT_SHIFT_MODE_CLEAR__ROTATE: CMP33.P$3 (B0); also elsewhere on the board
BIT_SHIFT_MODE_CLEAR__ROTATE_N: CMP32.P$1 (1); also elsewhere on the board
BIT_XX_ACTION_CYCLE: CMP32.P$2 (2), CMP33.P$4 (B1); also elsewhere on the board
BIT_XX_LOAD_CYCLE: CMP30.P$1 (0); also elsewhere on the board
FLAG_F3: CMP31.1 (0); also elsewhere on the board
OPCODE_IS_ADDQ_GROUP: CMP31.2 (1); also elsewhere on the board
OPCODE_IS_ADD_GROUP: CMP29.4 (3); also elsewhere on the board
OPCODE_IS_AND_GROUP: CMP29.8 (7); also elsewhere on the board
OPCODE_IS_CMP_GROUP: CMP29.3 (2); also elsewhere on the board
OPCODE_IS_INV: CMP33.P$1 (A0), CMP33.P$2 (A1); also elsewhere on the board
OPCODE_IS_MOVER: CMP29.5 (4); also elsewhere on the board
OPCODE_IS_OR: CMP29.7 (6); also elsewhere on the board
OPCODE_IS_SHIFT_XX: CMP30.P$2 (1); also elsewhere on the board
OPCODE_IS_STACK_GROUP: CMP31.3 (2); also elsewhere on the board
OPCODE_IS_SUB_GROUP: CMP29.1 (0); also elsewhere on the board
OPCODE_IS_XOR_GROUP: CMP29.6 (5); also elsewhere on the board
STATE_13: CMP31.4 (3); also elsewhere on the board

Notes on the sheet:
alu1_x_mux_RA = Cpnt_2x2AND_OR(alu1_x_mux_RA__set_A, ~alu1_x_mux_shift_r3, bus_rnx_specials.adder_x_special,~alu1_x_mux_shift_r3);
alu1_y_mux_RB_A = Cpnt_8OR(bus_decode_alu_1.opcode_is_and_group, bus_decode_alu_1.opcode_is_or, bus_decode_alu_1.opcode_is_xor_group, bus_decode_alu_1.opcode_is_mover, bus_decode_alu_1.opcode_is_add_group, bus_decode_alu_1.opcode_is_sub_group, bus_decode_alu_1.opcode_is_cmp_group, bus_rnx_specials.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
alu1_y_mux_RB = Cpnt_3OR(alu1_y_mux_RB_A, bus_decode_alu_2.opcode_is_shift_xx, bit_xx_load_cycle);
alu1_y_mux_k = Cpnt_4OR(bus_decode_alu_1.opcode_is_addq_group, bus_decode_alu_1.opcode_is_stack_group, bus_state[13], bus_PS[WiC_PS_FLAG_INDEX_F3]);
alu1_y_mux_bit = Cpnt_2AND(bit_xx_action_cycle, ~bit_shift_mode_decode.Output()[BIT_SHIFT_MODE_CLEAR]);
alu1_y_mux_not_bit = Cpnt_2x2AND_OR(bit_xx_action_cycle, bit_shift_mode_decode.Output()[BIT_SHIFT_MODE_CLEAR], bus_decode_alu_1.opcode_is_inv, bus_decode_alu_1.opcode_is_inv);
