ericherman/megaprocessor/module_artwork_alu_ctrl/module_alu1_ctrl.brd

## EAGLE design module_artwork_alu_ctrl/module_alu1_ctrl.brd (continued)

Schematic: module_alu1_ctrl.sch, sheet 7

Parts:
CMP3: 2AND
CMP4: 2X2AND_OR
CMP5: 8OR
CMP6: 2OR
CMP7: 4X2AND_OR
CMP57: 1BUF

Connections:
ADD1_CARRY_INPUT_BIT: CMP7.OUT_P; also elsewhere on the board
ADD1_DO_SUBTRACT: CMP5.OUT_P, CMP7.P$3 (B0); also elsewhere on the board
DO_SUBTRACT__SET_A: CMP4.OUT_P, CMP5.7 (6)
FLAG_X: CMP7.P$7 (D0), CMP57.IN; also elsewhere on the board
FLAG_X_N: CMP7.P$5 (C0), CMP57.N
H_4: CMP3.P$1 (1); also elsewhere on the board
unnamed: CMP7.P$1 (A0), CMP7.P$2 (A1)
NEGATE_FOR_SHIFT: CMP3.OUT_P, CMP5.2 (1)
OPCODE_IS_ABS: CMP4.P$4 (B1); also elsewhere on the board
OPCODE_IS_ADDX: CMP7.P$8 (D1); also elsewhere on the board
OPCODE_IS_CMP: CMP5.3 (2); also elsewhere on the board
OPCODE_IS_DIV: CMP5.8 (7); also elsewhere on the board
OPCODE_IS_MULS: CMP4.P$2 (A1); also elsewhere on the board
OPCODE_IS_NEGX: CMP5.5 (4), CMP6.P$1 (A2); also elsewhere on the board
OPCODE_IS_SHIFT_XX: CMP3.P$2 (2); also elsewhere on the board
OPCODE_IS_SQRT: CMP5.1 (0); also elsewhere on the board
OPCODE_IS_SUBX: CMP5.4 (3), CMP6.P$2 (A1); also elsewhere on the board
OPCODE_IS_SUBX_NEGX: CMP6.OUT_P, CMP7.P$6 (C1)
OPCODE_IS_SUBX_NEGX_N: CMP6.OUT_M (N), CMP7.P$4 (B1)
OPCODE_IS_SUB_GROUP: CMP5.6 (5); also elsewhere on the board
RA_MUX_IS_N: CMP4.P$3 (B0); also elsewhere on the board
STATE_3: CMP4.P$1 (A0); also elsewhere on the board

Notes on the sheet:
negate_for_shift = Cpnt_2AND(bus_decode_alu_2.opcode_is_shift_xx, bus_H[4]);
add1_do_subtract__set_A = Cpnt_2x2AND_OR(bus_decode_alu_2.opcode_is_abs, bus_ra_flags.RA_mux_is_n, bus_decode_alu_2.opcode_is_muls, bus_state[3]);
add1_do_subtract = Cpnt_8OR(bus_decode_alu_1.opcode_is_sub_group, bus_decode_alu_1.opcode_is_cmp, bus_decode_alu_2.opcode_is_subx, bus_decode_alu_2.opcode_is_negx, add1_do_subtract__set_A, bus_decode_alu_2.opcode_is_sqrt, bus_decode_alu_2.opcode_is_div, negate_for_shift); // MOPUP
opcode_is_subx_negx = Cpnt_2OR(bus_decode_alu_2.opcode_is_subx, bus_decode_alu_2.opcode_is_negx);
add1_input_carry_bit = Cpnt_4x2AND_OR(bus_decode_alu_2.opcode_is_addx, bus_PS[WiC_PS_FLAG_INDEX_X], // ADDX opcode_is_subx_negx, ~bus_PS[WiC_PS_FLAG_INDEX_X], // SUBX ~opcode_is_subx_negx, add1_do_subtract, // SUB BIT_VAL_0,BIT_VAL_0); // MOPUP

Schematic: module_alu1_ctrl.sch, sheet 8

Parts:
CMP2, CMP8: 3OR
CMP9: 2OR
CMP25, CMP38: 1BUF
CMP36, CMP37: 3AND

Connections:
H_4: CMP38.IN; also elsewhere on the board
IS_SHIFTING_LEFT: CMP36.OUT_P; also elsewhere on the board
IS_SHIFTING_RIGHT: CMP37.OUT_P; also elsewhere on the board
OPCODE_IS_ADDQ_GROUP: CMP2.P$2 (1); also elsewhere on the board
OPCODE_IS_ADDX: CMP2.P$3 (2); also elsewhere on the board
OPCODE_IS_ADD_GROUP: CMP2.P$1 (0); also elsewhere on the board
OPCODE_IS_CMP: CMP8.P$3 (2); also elsewhere on the board
OPCODE_IS_NEG: CMP9.P$1 (A2); also elsewhere on the board
OPCODE_IS_NEGX: CMP9.P$2 (A1); also elsewhere on the board
OPCODE_IS_SHIFT_XX: CMP36.P$3 (3), CMP37.P$3 (3); also elsewhere on the board
OPCODE_IS_SUB: CMP8.P$1 (0); also elsewhere on the board
OPCODE_IS_SUBX: CMP8.P$2 (1); also elsewhere on the board
SHIFT_LEFT: CMP36.P$1 (1), CMP38.N
SHIFT_RIGHT: CMP37.P$2 (2), CMP38.P
STATE_1: CMP25.IN; also elsewhere on the board
STATE_1_N: CMP25.N, CMP36.P$2 (2), CMP37.P$1 (1); also elsewhere on the board
USE_ADD_V: CMP2.OUT_P; also elsewhere on the board
USE_NEG_V: CMP9.OUT_P; also elsewhere on the board
USE_SUB_V: CMP8.OUT_P; also elsewhere on the board

Notes on the sheet:
use_add_V = Cpnt_3OR(bus_decode_alu_1.opcode_is_add_group, bus_decode_alu_1.opcode_is_addq_group, bus_decode_alu_2.opcode_is_addx);
use_sub_V = Cpnt_3OR(bus_decode_alu_1.opcode_is_sub, bus_decode_alu_1.opcode_is_cmp, bus_decode_alu_2.opcode_is_subx);
use_neg_V = Cpnt_2OR(bus_decode_alu_2.opcode_is_neg,bus_decode_alu_2.opcode_is_negx);
is_shifting_right = Cpnt_3AND(bus_decode_alu_2.opcode_is_shift_xx, bus_H[4], ~bus_state[1]);
is_shifting_left = Cpnt_3AND(bus_decode_alu_2.opcode_is_shift_xx, ~bus_H[4], ~bus_state[1]);

Schematic: module_alu1_ctrl.sch, sheet 9

Parts:
CMP11, CMP16, CMP19, CMP23: 2AND
CMP18: 2OR
CMP34: 3OR

Connections:
ARITH_RIGHT_INPUT: CMP19.OUT_P, CMP34.P$1 (0)
BIT_SHIFT_MODE_CHANGE__ARITH: CMP19.P$1 (1); also elsewhere on the board
BIT_SHIFT_MODE_CLEAR__ROTATE: CMP16.P$1 (1), CMP23.P$1 (1); also elsewhere on the board
BIT_SHIFT_MODE_SET__X_ROT: CMP11.P$1 (1); also elsewhere on the board
FLAG_X: CMP11.P$2 (2); also elsewhere on the board
LEFT_SHIFT_INPUT: CMP18.OUT_P; also elsewhere on the board
RA_MUX_IS_N: CMP16.P$2 (2), CMP19.P$2 (2); also elsewhere on the board
RA_MUX_LSB: CMP23.P$2 (2); also elsewhere on the board
RIGHT_SHIFT_INPUT: CMP34.OUT_P; also elsewhere on the board
ROT_LEFT_INPUT: CMP16.OUT_P, CMP18.P$2 (A1)
ROT_RIGHT_INPUT: CMP23.OUT_P, CMP34.P$3 (2)
X_ROT_INPUT: CMP11.OUT_P, CMP18.P$1 (A2), CMP34.P$2 (1)

Notes on the sheet:
x_rot_input = Cpnt_2AND(bit_shift_mode_decode.Output()[BIT_SHIFT_MODE_X_ROT], bus_PS[WiC_PS_FLAG_INDEX_X]);
rot_left_input = Cpnt_2AND(bit_shift_mode_decode.Output()[BIT_SHIFT_MODE_ROTATE], bus_ra_flags.RA_mux_is_n);
left_shift_input = Cpnt_2OR(rot_left_input, x_rot_input);
arith_right_input = Cpnt_2AND(bit_shift_mode_decode.Output()[BIT_SHIFT_MODE_ARITH], bus_ra_flags.RA_mux_is_n);
rot_right_input = Cpnt_2AND(bit_shift_mode_decode.Output()[BIT_SHIFT_MODE_ROTATE], bus_ra_flags.RA_mux_lsb);
right_shift_input = Cpnt_3OR(arith_right_input, rot_right_input, x_rot_input);

Schematic: module_alu1_ctrl.sch, sheet 10

Parts:
CMP42, CMP43, CMP45: 2X2AND_OR
CMP44: 2OR
CMP46: 3OR

Connections:
ALU1_OUTPUT_MUX_ADDER: CMP46.OUT_M (N); also elsewhere on the board
ALU1_OUTPUT_MUX_LOGIC: CMP45.OUT_P, CMP46.P$3 (2); also elsewhere on the board
AND: CMP42.OUT_P, CMP44.P$2 (A1); also elsewhere on the board
BIT_SHIFT_MODE_CLEAR__ROTATE: CMP42.P$3 (B0); also elsewhere on the board
BIT_SHIFT_MODE_SET__X_ROT: CMP43.P$3 (B0); also elsewhere on the board
IS_SHIFTING_LEFT: CMP46.P$2 (1); also elsewhere on the board
IS_SHIFTING_RIGHT: CMP46.P$1 (0); also elsewhere on the board
OPCODE_IS_AND_GROUP: CMP42.P$1 (A0), CMP42.P$2 (A1); also elsewhere on the board
OPCODE_IS_BIT_XX: CMP42.P$4 (B1), CMP43.P$4 (B1), CMP45.P$4 (B1); also elsewhere on the board
OPCODE_IS_LOGIC_GROUP: CMP45.P$1 (A0), CMP45.P$2 (A1); also elsewhere on the board
OPCODE_IS_OR: CMP43.P$1 (A0), CMP43.P$2 (A1); also elsewhere on the board
OR: CMP43.OUT_P, CMP44.P$1 (A2); also elsewhere on the board
STATE_1_N: CMP45.P$3 (B0); also elsewhere on the board
XOR: CMP44.OUT_M (N); also elsewhere on the board

Notes on the sheet:
logic_output_mux_and = Cpnt_2x2AND_OR(bus_decode_alu_2.opcode_is_bit_xx, bit_shift_mode_decode.Output()[BIT_SHIFT_MODE_CLEAR], bus_decode_alu_1.opcode_is_and_group, bus_decode_alu_1.opcode_is_and_group);
logic_output_mux_or = Cpnt_2x2AND_OR(bus_decode_alu_2.opcode_is_bit_xx, bit_shift_mode_decode.Output()[BIT_SHIFT_MODE_SET], bus_decode_alu_1.opcode_is_or, bus_decode_alu_1.opcode_is_or);
logic_output_mux_xor = ~Cpnt_2OR(logic_output_mux_and, logic_output_mux_or);
alu_output_mux_logic = Cpnt_2x2AND_OR(bus_decode_alu_2.opcode_is_bit_xx, ~bus_state[1], bus_decode_alu_1.opcode_is_logic_group, bus_decode_alu_1.opcode_is_logic_group);
alu_output_mux_adder = ~Cpnt_3OR(alu_output_mux_logic, is_shifting_left, is_shifting_right);

Schematic: module_alu1_ctrl.sch, sheet 11

Parts:
CMP14, CMP48: 2X2AND_OR
CMP53: 4OR
CMP56: 3AND
CMP60, CMP62: 5OR

Connections:
ADD2_MUX_WEIGHT: CMP53.1 (0), CMP56.OUT_P; also elsewhere on the board
ADD2_X_MUX_PC: CMP62.OUT_M (N); also elsewhere on the board
ADD2_X_MUX_RI: CMP60.OUT_P, CMP62.4 (3); also elsewhere on the board
ADD2_X_MUX_RI__H: CMP60.4 (3); also elsewhere on the board
ADD2_X_MUX_RI__SET_A: CMP14.OUT_P, CMP60.1 (0)
ADD2_X_MUX_RI__SP: CMP60.5 (4); also elsewhere on the board
ADD2_X_ZERO: CMP53.OUT_P, CMP62.3 (2)
FLAG_F6: CMP56.P$1 (1); also elsewhere on the board
JMP_R0_MOVE_SP_R0_STATE_0: CMP48.OUT_P, CMP53.4 (3); also elsewhere on the board
OPCODE_IS_DIV_STATE_0: CMP53.2 (1); also elsewhere on the board
OPCODE_IS_INDIRECT_POSTINC: CMP14.P$3 (B0); also elsewhere on the board
OPCODE_IS_JMP_R0: CMP48.P$3 (B0); also elsewhere on the board
OPCODE_IS_JSR_X_STATE_7: CMP53.3 (2); also elsewhere on the board
OPCODE_IS_MOVE_SP_R0: CMP48.P$1 (A0); also elsewhere on the board
OPCODE_IS_SHIFT_XX: CMP56.P$2 (2); also elsewhere on the board
R0_IS_N: CMP14.P$1 (A0); also elsewhere on the board
STATE_0: CMP14.P$4 (B1), CMP48.P$2 (A1), CMP48.P$4 (B1); also elsewhere on the board
STATE_2: CMP56.P$3 (3); also elsewhere on the board
STATE_10: CMP62.1 (0); also elsewhere on the board
STATE_11: CMP60.3 (2); also elsewhere on the board
STATE_12: CMP60.2 (1); also elsewhere on the board
STATE_13: CMP62.5 (4); also elsewhere on the board
STATE_14: CMP14.P$2 (A1), CMP62.2 (1); also elsewhere on the board

Notes on the sheet:
opcode_is_jmp_r0_move_sp_r0_state_0 = Cpnt_2x2AND_OR(bus_state[0],bus_decode_alu_3.opcode_is_jmp_r0, bus_state[0],bus_decode_alu_2.opcode_is_move_sp_r0);
add2_mux_weight = Cpnt_3AND(bus_state[2], bus_decode_alu_2.opcode_is_shift_xx, bus_PS[WiC_PS_FLAG_INDEX_F6]);
add2_x_mux_ri__set_A = Cpnt_2x2AND_OR(bus_state[0], bus_decode_alu_1.opcode_is_indirect_postinc, bus_state[14], bus_rn_arith_flags.r0_is_n);
add2_x_mux_ri = Cpnt_5OR(add2_x_mux_ri__set_A, bus_rnx_specials.add2_x_mux_ri__h, bus_rnx_specials.add2_x_mux_ri__sp, bus_state[11], bus_state[12]);
add2_x_sqrt_mask = bus_state[10]; add2_x_shift_r2 = bus_state[13];
add2_x_zero = Cpnt_4OR(opcode_is_jmp_r0_move_sp_r0_state_0, bus_decode_alu_3.opcode_is_jsr_x_state_7 , bus_decode_alu_3.opcode_is_div_state_0, add2_mux_weight);
add2_x_mux_pc = ~Cpnt_5OR(add2_x_shift_r2 , add2_x_mux_ri, add2_x_zero, add2_x_sqrt_mask, bus_state[14]);

Schematic: module_alu1_ctrl.sch, sheet 12

Parts:
CMP17: 3OR
CMP47: 2AND
CMP49, CMP50: 4OR
CMP51: 2OR
CMP52: 4X2AND_OR

Connections:
ADD2_Y_MUX_0: CMP51.OUT_P; also elsewhere on the board
ADD2_Y_MUX_0__MUL: CMP17.OUT_M (N), CMP51.P$2 (A1)
ADD2_Y_MUX_H: CMP49.OUT_P; also elsewhere on the board
ADD2_Y_MUX_H__JSR: CMP47.OUT_P, CMP49.1 (0)
ADD2_Y_MUX_R0: CMP50.OUT_P; also elsewhere on the board
ADD2_Y_MUX_R0__SET_A: CMP50.4 (3), CMP52.OUT_P
JMP_R0_MOVE_SP_R0_STATE_0: CMP50.3 (2); also elsewhere on the board
unnamed: CMP52.P$1 (A0), CMP52.P$2 (A1)
OPCODE_IS_ADD_SP_STATE_2: CMP49.2 (1); also elsewhere on the board
OPCODE_IS_BXX_STATE_2: CMP49.4 (3); also elsewhere on the board
OPCODE_IS_DIV_STATE_0: CMP50.1 (0); also elsewhere on the board
OPCODE_IS_JSR_ABS: CMP47.P$2 (2); also elsewhere on the board
OPCODE_IS_JSR_R0: CMP52.P$6 (C1); also elsewhere on the board
OPCODE_IS_MOVE_R0_SP_STATE_0: CMP51.P$1 (A2); also elsewhere on the board
OPCODE_IS_MUL_N: CMP17.P$2 (1); also elsewhere on the board
OPCODE_IS_STACK_REL_STATE_2: CMP49.3 (2); also elsewhere on the board
R1_IS_N: CMP17.P$1 (0), CMP52.P$3 (B0), CMP52.P$7 (D0); also elsewhere on the board
STATE_3: CMP17.P$3 (2); also elsewhere on the board
STATE_7: CMP47.P$1 (1), CMP52.P$5 (C0); also elsewhere on the board
STATE_10: CMP50.2 (1); also elsewhere on the board
STATE_13: CMP52.P$8 (D1); also elsewhere on the board
STATE_14: CMP52.P$4 (B1); also elsewhere on the board

Notes on the sheet:
add2_y_mux_h__jsr = Cpnt_2AND(bus_state[7], bus_decode_alu_2.opcode_is_jsr_abs);
add2_y_mux_h = Cpnt_4OR(bus_decode_alu_3.opcode_is_bxx_state_2, bus_decode_alu_3.opcode_is_stack_rel_state_2, bus_decode_alu_3.opcode_is_add_sp_state_2, add2_y_mux_h__jsr);
add2_y_mux_0__mul = ~Cpnt_3OR(bus_decode_alu_1.opcode_is_mul_n, bus_rn_arith_flags.r1_is_n, bus_state[3]);
add2_y_mux_0 = Cpnt_2OR(add2_y_mux_0__mul, bus_decode_alu_3.opcode_is_move_r0_sp_state_0);
add2_y_mux_r0__set_A = Cpnt_4x2AND_OR(bus_state[13], bus_rn_arith_flags.r1_is_n, bus_decode_alu_2.opcode_is_jsr_r0, bus_state[7], bus_state[14], bus_rn_arith_flags.r1_is_n, BIT_VAL_0, BIT_VAL_0); // MOPUP
add2_y_mux_r0 = Cpnt_4OR(add2_y_mux_r0__set_A, opcode_is_jmp_r0_move_sp_r0_state_0, bus_state[10], bus_decode_alu_3.opcode_is_div_state_0);

Schematic: module_alu1_ctrl.sch, sheet 13

Parts:
CMP54: 5OR
CMP55: 8X2AND_OR
CMP59: 3AND
CMP61: 2OR

Connections:
ADD2_CARRY_IN: CMP61.OUT_P; also elsewhere on the board
ADD2_DO_SUBTRACT: CMP55.OUT_P, CMP61.P$2 (A1); also elsewhere on the board
ADD2_MUX_WEIGHT: CMP54.3 (2), CMP59.P$3 (3); also elsewhere on the board
ADD2_WEIGHT_BIT: CMP59.OUT_P, CMP61.P$1 (A2)
ADD2_Y_MUX_0: CMP54.4 (3); also elsewhere on the board
ADD2_Y_MUX_H: CMP54.5 (4); also elsewhere on the board
ADD2_Y_MUX_P1: CMP54.OUT_M (N); also elsewhere on the board
ADD2_Y_MUX_R0: CMP54.2 (1); also elsewhere on the board
unnamed: CMP55.P$1 (A0), CMP55.P$2 (A1)
OPCODE_IS_DIVS_STATE_0: CMP55.P$6 (C1); also elsewhere on the board
OPCODE_IS_JSR_R0: CMP55.P$12 (F2); also elsewhere on the board
OPCODE_IS_PUSH_PS: CMP55.P$8 (D1); also elsewhere on the board
OPCODE_IS_PUSH_RA: CMP55.P$10 (E2); also elsewhere on the board
OPCODE_IS_STACK_GROUP: CMP55.P$16 (H2); also elsewhere on the board
OPCODE_IS_TRAP: CMP55.P$13 (G1); also elsewhere on the board
R0_IS_N: CMP55.P$5 (C0); also elsewhere on the board
RA_MUX_LSB: CMP59.P$2 (2); also elsewhere on the board
SHIFT_IS_SHIFTING: CMP59.P$1 (1); also elsewhere on the board
STATE_0: CMP55.P$7 (D0), CMP55.P$9 (E1), CMP55.P$11 (F1); also elsewhere on the board
STATE_6: CMP55.P$15 (H1); also elsewhere on the board
STATE_7: CMP55.P$14 (G2); also elsewhere on the board
STATE_14: CMP54.1 (0); also elsewhere on the board
STATE_15: CMP55.P$3 (B0), CMP55.P$4 (B1); also elsewhere on the board

Notes on the sheet:
add2_y_mux_p1 = ~Cpnt_5OR(add2_y_mux_h, add2_y_mux_0, add2_y_mux_r0, bus_state[14],add2_mux_weight);
add2_do_subtract = Cpnt_8x2AND_OR(bus_decode_alu_1.opcode_is_stack_group, bus_state[6] , bus_decode_alu_2.opcode_is_trap, bus_state[7], bus_decode_alu_2.opcode_is_jsr_r0, bus_state[0], bus_decode_alu_2.opcode_is_push_ra, bus_state[0], bus_decode_alu_2.opcode_is_push_ps, bus_state[0], bus_decode_alu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
add2_weight_bit = Cpnt_3AND(add2_mux_weight, bus_ra_flags.RA_mux_lsb, bus_decode_alu_3.shift_is_shifting);
add2_carry_in = Cpnt_2OR(add2_do_subtract,add2_weight_bit);

Schematic: module_alu1_ctrl.sch, sheet 14

Parts:
CMP65, CMP66, CMP67: BUS_CONSTRUCT_DISPLAY; BUS_SPLIT_DISPLAY

Connections:
ADD1_CARRY_INPUT_BIT: CMP65.P$2 (IN_1); also elsewhere on the board
ADD1_DO_SUBTRACT: CMP65.P$1 (IN_0); also elsewhere on the board
ADD2_CARRY_IN: CMP67.P$10 (IN_9); also elsewhere on the board
ADD2_DO_SUBTRACT: CMP67.P$9 (IN_8); also elsewhere on the board
ADD2_MUX_WEIGHT: CMP67.P$1 (IN_0); also elsewhere on the board
ADD2_X_MUX_PC: CMP67.P$7 (IN_6); also elsewhere on the board
ADD2_X_MUX_RI: CMP67.P$5 (IN_4); also elsewhere on the board
ADD2_Y_MUX_H: CMP67.P$2 (IN_1); also elsewhere on the board
ADD2_Y_MUX_P1: CMP67.P$4 (IN_3); also elsewhere on the board
ADD2_Y_MUX_R0: CMP67.P$3 (IN_2); also elsewhere on the board
ALU1_OUTPUT_MUX_ADDER: CMP65.P$11 (IN_10); also elsewhere on the board
ALU1_OUTPUT_MUX_LOGIC: CMP65.P$10 (IN_9); also elsewhere on the board
ALU1_X_MUX_RA: CMP66.P$6 (IN_5); also elsewhere on the board
ALU1_X_MUX_SHIFT_R3: CMP66.P$7 (IN_6); also elsewhere on the board
ALU1_Y_MUX_BIT: CMP66.P$11 (IN_10); also elsewhere on the board
ALU1_Y_MUX_K: CMP66.P$8 (IN_7); also elsewhere on the board
ALU1_Y_MUX_NOT_BIT: CMP66.P$10 (IN_9); also elsewhere on the board
ALU1_Y_MUX_RB: CMP66.P$9 (IN_8); also elsewhere on the board
AND: CMP65.P$6 (IN_5); also elsewhere on the board
BIT_SELECT_ENABLE: CMP66.P$1 (IN_0); also elsewhere on the board
BUS_ADD2_CONTROL: CMP67.INPUT (OUT)
BUS_ALU1_INPUT_CTRL: CMP66.INPUT (OUT)
BUS_ALU1_OPERATION_CTRL: CMP65.INPUT (OUT)
H_0: CMP66.P$2 (IN_1); also elsewhere on the board
H_1: CMP66.P$3 (IN_2); also elsewhere on the board
H_2: CMP66.P$4 (IN_3); also elsewhere on the board
H_3: CMP66.P$5 (IN_4); also elsewhere on the board
H_4: CMP65.P$3 (IN_2); also elsewhere on the board
IS_SHIFTING_LEFT: CMP65.P$13 (IN_12); also elsewhere on the board
IS_SHIFTING_RIGHT: CMP65.P$12 (IN_11); also elsewhere on the board
K_0: CMP66.P$14 (IN_13); also elsewhere on the board
K_1: CMP66.P$13 (IN_12); also elsewhere on the board
K_N: CMP66.P$12 (IN_11); also elsewhere on the board
LEFT_SHIFT_INPUT: CMP65.P$14 (IN_13); also elsewhere on the board
unnamed: CMP66.P$15 (IN_14), CMP66.P$16 (IN_15)
unnamed: CMP67.P$11 (IN_10), CMP67.P$12 (IN_11), CMP67.P$13 (IN_12), CMP67.P$14 (IN_13), CMP67.P$15 (IN_14), CMP67.P$16 (IN_15)
OR: CMP65.P$5 (IN_4); also elsewhere on the board
RIGHT_SHIFT_INPUT: CMP65.P$15 (IN_14); also elsewhere on the board
STATE_10: CMP67.P$8 (IN_7); also elsewhere on the board
STATE_13: CMP67.P$6 (IN_5); also elsewhere on the board
USE_ADD_V: CMP65.P$7 (IN_6); also elsewhere on the board
USE_NEG_V: CMP65.P$9 (IN_8); also elsewhere on the board
USE_SUB_V: CMP65.P$8 (IN_7); also elsewhere on the board
XOR: CMP65.P$4 (IN_3); also elsewhere on the board

Notes on the sheet:
clBit bit_select_enable; // 0 clBitField bit_code; // 1-4 clBit alu1_x_mux_RA; // 5 clBit alu1_x_mux_shift_r3; // 6 clBit alu1_y_mux_k; // 7 clBit alu1_y_mux_RB; // 8 clBit alu1_y_mux_not_bit; // 9 clBit alu1_y_mux_bit; // 10 clBit k_m; // 11 clBit k_1; // 12 clBit k_0; // 13
clBit do_subtract; // 0 clBit input_carry_bit; // 1 clBit H_4; // 2 clBit xor; // 3 clBit or; // 4 clBit and; // 5 clBit use_add_V; // 6 clBit use_sub_V; // 7 clBit use_neg_V; // 8 clBit alu_output_mux_logic; // 9 clBit alu_output_mux_adder; // 10 clBit is_shifting_right; // 11 clBit is_shifting_le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
clBit add2_y_mux_weight; // 0 clBit add2_y_mux_h; // 1 clBit add2_y_mux_r0; // 2 clBit add2_y_mux_p1; // 3 clBit add2_x_mux_ri; // 4 clBit add2_x_mux_shift_r2; // 5 clBit add2_x_mux_pc; // 6 clBit add2_x_mux_sqrt_mask; // 7 clBit add2_do_subtract; // 8 clBit add2_carry_in; // 9


Board: 2 copper layers, 1397.0 x 533.4 mm, 67 parts (0 on the bottom side), 155 nets.
