ericherman/megaprocessor/module_artwork_rn_reg/module_Rn_reg.brd

## EAGLE design module_artwork_rn_reg/module_Rn_reg.brd (2017-05-20)

Schematic: module_Rn_reg.sch, sheet 1

Parts:
CMP5, CMP15: BUS_SPLIT_DISPLAY

Connections:
BUS_RN_REG_CTRL: CMP15.INPUT
NEXT_R0_MUX_ADD2: CMP15.P$3 (OUT_2); also elsewhere on the board
NEXT_R0_MUX_HOLD: CMP15.P$1 (OUT_0); also elsewhere on the board
NEXT_R0_MUX_MAIN: CMP15.P$4 (OUT_3); also elsewhere on the board
NEXT_R0_MUX_SHIFT_1: CMP15.P$2 (OUT_1); also elsewhere on the board
NEXT_R1_MUX_ADD2: CMP15.P$7 (OUT_6); also elsewhere on the board
NEXT_R1_MUX_HOLD: CMP15.P$5 (OUT_4); also elsewhere on the board
NEXT_R1_MUX_MAIN: CMP15.P$8 (OUT_7); also elsewhere on the board
NEXT_R1_MUX_MUL: CMP15.P$6 (OUT_5); also elsewhere on the board
NEXT_R2_MUX_ADD2: CMP15.P$9 (OUT_8); also elsewhere on the board
NEXT_R2_MUX_DIV_SHIFT: CMP15.P$12 (OUT_11); also elsewhere on the board
NEXT_R2_MUX_HOLD: CMP15.P$11 (OUT_10); also elsewhere on the board
NEXT_R2_MUX_MAIN: CMP15.P$10 (OUT_9); also elsewhere on the board
NEXT_R3_MUX_ADD2: CMP15.P$13 (OUT_12); also elsewhere on the board
NEXT_R3_MUX_DIV_SHIFT_R3: CMP15.P$16 (OUT_15); also elsewhere on the board
NEXT_R3_MUX_HOLD: CMP15.P$15 (OUT_14); also elsewhere on the board
NEXT_R3_MUX_MAIN: CMP15.P$14 (OUT_13); also elsewhere on the board
R2_SHIFT_IN: CMP5.P$1 (OUT_0); also elsewhere on the board

Notes on the sheet:
clBit next_r0_mux_hold; // 0 clBit next_r0_mux_shift_1; // 1 clBit next_r0_mux_add2; // 2 clBit next_r0_mux_main; // 3 clBit next_r1_mux_hold; // 4 clBit next_r1_mux_mul; // 5 clBit next_r1_mux_add2; // 6 clBit next_r1_mux_main; // 7 clBit next_r2_mux_add2; // 8 clBit next_r2_mux_main; // 9 clBit n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

Schematic: module_Rn_reg.sch, sheet 2

Parts:
CMP1, CMP8: BUS_TEE
CMP2, CMP3: BUS_4TEE
CMP12: RIGHT_SHIFT; SHIFT_ZERO
CMP22: BUS_CONSTRUCT_DISPLAY; BUS_SPLIT_DISPLAY
CMP23: LEFT_SHIFT_ZERO; SHIFT_ZERO

Connections:
ADD2_0: CMP8.OUTB (B); also elsewhere on the board
ADD2_1: CMP3.4; also elsewhere on the board
ADD2_2: CMP3.3; also elsewhere on the board
ADD2_3: CMP3.2; also elsewhere on the board
ADD2_IS_Z: CMP22.P$11 (IN_10), CMP23.IS_ZERO (SRC_ZERO)
ADD2_LSB: CMP22.P$12 (IN_11), CMP23.LSB (SRC_LSB)
ADD2_X: CMP8.OUT_A (A), CMP23.LSRC (SRC)
BUS_RN_ARITH_FLAGS: CMP22.INPUT (OUT)
MAIN_RN_INPUT_MUX_IS_N: CMP12.MSB, CMP22.P$9 (IN_8)
MAIN_RN_INPUT_MUX_IS_Z: CMP12.IS_ZERO, CMP22.P$10 (IN_9)
unnamed: CMP22.P$13 (IN_12), CMP22.P$14 (IN_13), CMP22.P$15 (IN_14), CMP22.P$16 (IN_15)
unnamed: CMP3.1, CMP8.INPUT (IN)
R0_IS_Z: CMP22.P$5 (IN_4); also elsewhere on the board
R0_MSB: CMP22.P$1 (IN_0); also elsewhere on the board
R1_IS_Z: CMP22.P$6 (IN_5); also elsewhere on the board
R1_MSB: CMP22.P$2 (IN_1); also elsewhere on the board
R2_IS_Z: CMP22.P$7 (IN_6); also elsewhere on the board
R2_MSB: CMP22.P$3 (IN_2); also elsewhere on the board
R3_IS_Z: CMP22.P$8 (IN_7); also elsewhere on the board
R3_MSB: CMP22.P$4 (IN_3); also elsewhere on the board
WN_0: CMP2.1; also elsewhere on the board
WN_1: CMP2.2; also elsewhere on the board
WN_2: CMP2.4; also elsewhere on the board
WN_3: CMP1.OUT_A (A); also elsewhere on the board
WN_3_X: CMP1.INPUT (IN), CMP2.3
WN_4: CMP1.OUTB (B), CMP12.RSRC (SRC)

Notes on the sheet:
clBit r0_is_n; // 0 clBit r1_is_n; // 1 clBit r2_is_n; // 2 clBit r3_is_n; // 3 clBit r0_is_z; // 4 clBit r1_is_z; // 5 clBit r2_is_z; // 6 clBit r3_is_z; // 7 clBit main_rn_input_mux_is_n; // 8 clBit main_rn_input_mux_is_z; // 9 clBit ADD2_is_z; // 10 clBit ADD2_lsb; // 11

Schematic: module_Rn_reg.sch, sheet 3

Parts:
CMP10: BUS_4TEE
CMP14: 4X16MUX
CMP17: 16REG
CMP18: 4DIGIT
CMP20: RIGHT_SHIFT; SHIFT_ZERO
CMP24: BUS_2_BUS; BUS2BUS

Connections:
ADD2_0: CMP14.PORT1; also elsewhere on the board
BUS_R0: CMP24.P$2 (OUT)
unnamed: CMP14.PORTOUT (OUTPUT), CMP17.INPUT (IN)
unnamed: CMP17.DISPLAY (DSP), CMP18.P$1
unnamed: CMP10.1, CMP20.RSRC (SRC)
unnamed: CMP10.3, CMP24.P$1 (IN)
NEXT_R0_MUX_ADD2: CMP14.EN1; also elsewhere on the board
NEXT_R0_MUX_HOLD: CMP14.EN3; also elsewhere on the board
NEXT_R0_MUX_MAIN: CMP14.EN0; also elsewhere on the board
NEXT_R0_MUX_SHIFT_1: CMP14.EN2; also elsewhere on the board
R0_HOLD: CMP10.2, CMP14.PORT3
R0_IS_Z: CMP20.IS_ZERO; also elsewhere on the board
R0_MSB: CMP20.MSB; also elsewhere on the board
REG_R0: CMP10.SRC, CMP17.OUT
REG_R0_SHIFT: CMP14.PORT2, CMP20.LSRC (OUT)
WN_0: CMP14.PORT0; also elsewhere on the board

Schematic: module_Rn_reg.sch, sheet 4

Parts:
CMP9: BUS_4TEE
CMP21: LEFT_SHIFT_ZERO; SHIFT_ZERO
CMP26: 4X16MUX
CMP27: 16REG
CMP28: 4DIGIT
CMP30: BUS_TEE
CMP34, CMP35: BUS_2_BUS; BUS2BUS

Connections:
ADD2_1: CMP26.PORT1; also elsewhere on the board
BUS_R1: CMP34.P$2 (OUT)
unnamed: CMP26.PORTOUT (OUTPUT), CMP27.INPUT (IN)
unnamed: CMP27.DISPLAY (DSP), CMP28.P$1
unnamed: CMP9.1, CMP34.P$1 (IN)
unnamed: CMP9.4, CMP21.LSRC (SRC)
unnamed: CMP30.OUT_A (A), CMP35.P$1 (IN)
NEXT_R1_MUX_ADD2: CMP26.EN1; also elsewhere on the board
NEXT_R1_MUX_HOLD: CMP26.EN3; also elsewhere on the board
NEXT_R1_MUX_MAIN: CMP26.EN0; also elsewhere on the board
NEXT_R1_MUX_MUL: CMP26.EN2; also elsewhere on the board
R1_HOLD: CMP9.3, CMP26.PORT3
R1_IS_Z: CMP21.IS_ZERO (SRC_ZERO); also elsewhere on the board
R1_LSB: CMP21.LSB (SRC_LSB)
R1_MSB: CMP21.MSB (SRC_MSB), CMP21.SHIFT_IN (LSB_IN); also elsewhere on the board
REG_R1: CMP9.SRC, CMP27.OUT
REG_R1_ROTATE: CMP21.RSRC (OUT), CMP30.INPUT (IN)
REG_R1_ROTATE_A: CMP26.PORT2, CMP30.OUTB (B)
REG_R1_ROTATE_B: CMP35.P$2 (OUT)
WN_1: CMP26.PORT0; also elsewhere on the board

Schematic: module_Rn_reg.sch, sheet 5

Parts:
CMP6: BUS_TEE
CMP7: BUS_4TEE
CMP11: LEFT_SHIFT_ZERO; SHIFT_ZERO
CMP13, CMP44: BUS_2_BUS; BUS2BUS
CMP36: 4X16MUX
CMP37: 16REG
CMP38: 4DIGIT

Connections:
ADD2_2: CMP36.PORT3; also elsewhere on the board
BUS_R2: CMP44.P$2 (OUT)
unnamed: CMP7.2, CMP44.P$1 (IN)
unnamed: CMP36.PORTOUT (OUTPUT), CMP37.INPUT (IN)
unnamed: CMP37.DISPLAY (DSP), CMP38.P$1
unnamed: CMP7.4, CMP11.LSRC (SRC)
NEXT_R2_MUX_ADD2: CMP36.EN3; also elsewhere on the board
NEXT_R2_MUX_DIV_SHIFT: CMP36.EN0; also elsewhere on the board
NEXT_R2_MUX_HOLD: CMP36.EN1; also elsewhere on the board
NEXT_R2_MUX_MAIN: CMP36.EN2; also elsewhere on the board
R2_HOLD: CMP7.1, CMP36.PORT1
R2_IS_Z: CMP11.IS_ZERO (SRC_ZERO); also elsewhere on the board
R2_LSB: CMP11.LSB (SRC_LSB)
R2_MSB: CMP11.MSB (SRC_MSB); also elsewhere on the board
R2_SHIFT_IN: CMP11.SHIFT_IN (LSB_IN); also elsewhere on the board
REG_R2: CMP7.SRC, CMP37.OUT
REG_R2_LEFT_SHIFTED: CMP6.INPUT (IN), CMP11.RSRC (OUT)
REG_R2_LEFT_SHIFTED_A: CMP6.OUT_A (A), CMP13.P$1 (IN)
REG_R2_LEFT_SHIFTED_B: CMP6.OUTB (B), CMP36.PORT0
WN_2: CMP36.PORT2; also elsewhere on the board

Schematic: module_Rn_reg.sch, sheet 6

Parts:
CMP4: BUS_4TEE
CMP16: LEFT_SHIFT_ZERO; SHIFT_ZERO
CMP40: 4X16MUX
CMP45: 16REG
CMP46: 4DIGIT
CMP48: BUS_TEE
CMP52, CMP53: BUS_2_BUS; BUS2BUS

Connections:
ADD2_3: CMP40.PORT3; also elsewhere on the board
BUS_R3: CMP52.P$2 (OUT)
BUS_SHIFT_R3: CMP16.RSRC (OUT), CMP48.INPUT (IN)
BUS_SHIFT_R3_A: CMP40.PORT0, CMP48.OUTB (B)
BUS_SHIFT_R3_B: CMP53.P$2 (OUT)
unnamed: CMP4.1, CMP52.P$1 (IN)
unnamed: CMP40.PORTOUT (OUTPUT), CMP45.INPUT (IN)
unnamed: CMP45.DISPLAY (DSP), CMP46.P$1
unnamed: CMP4.4, CMP16.LSRC (SRC)
unnamed: CMP48.OUT_A (A), CMP53.P$1 (IN)
NEXT_R3_MUX_ADD2: CMP40.EN3; also elsewhere on the board
NEXT_R3_MUX_DIV_SHIFT_R3: CMP40.EN0; also elsewhere on the board
NEXT_R3_MUX_HOLD: CMP40.EN1; also elsewhere on the board
NEXT_R3_MUX_MAIN: CMP40.EN2; also elsewhere on the board
R2_MSB: CMP16.SHIFT_IN (LSB_IN); also elsewhere on the board
R3_HOLD: CMP4.2, CMP40.PORT1
R3_IS_Z: CMP16.IS_ZERO (SRC_ZERO); also elsewhere on the board
R3_LSB: CMP16.LSB (SRC_LSB)
R3_MSB: CMP16.MSB (SRC_MSB); also elsewhere on the board
REG_R3: CMP4.SRC, CMP45.OUT
WN_3: CMP40.PORT2; also elsewhere on the board


Board: 2 copper layers, 901.7 x 1041.4 mm, 39 parts (0 on the bottom side), 76 nets.
