ericherman/megaprocessor/8b_ram/8B_RAM_3.brd

## EAGLE design 8b_ram/8B_RAM_3.brd (2017-05-20)

Schematic: 8B_RAM_3.sch, sheet 1

Notes on the sheet:
a[0..4]
ch_sel_n
we_n
a_n
ch_sel
a_out
wr_data_in
rd_data_out
rd_x_muxed_n
3:8
a3,4
byte_sel_y_n
brd_sel
brd_sel_n
brd_we
brd_we_n
wr_byte_y
RAM cells
RAM cell
wr_data[x]
rd_y_x_n
rd_y_x

Schematic: 8B_RAM_3.sch, sheet 2

Parts:
C1, C2, C3, C4, C5, C6, C7, C8, C10, C11: 100n; CAP_P2INCH
C9: 100u; POLARISED_CAP_2P5_6P3MM
H1, H2, H3, H4: 4M_MOUNT_HOLE; 4M_HOLE
PP1, PP2: POWER_PAD

Connections:
+5V: C1.2, C2.2, C3.2, C4.2, C5.2, C6.2, C7.2, C8.2, C9.A, C10.2, C11.2, PP2.1; also elsewhere on the board
GND: C1.1, C2.1, C3.1, C4.1, C5.1, C6.1, C7.1, C8.1, C9.K, C10.1, C11.1, PP1.1; also elsewhere on the board

Notes on the sheet:
We buffer data coming in for an inversion. It's inverted in the mux of teh bytes. And we invert in teh buffer going out. So we need the inverted output of the latches

Schematic: 8B_RAM_3.sch, sheet 3

Parts:
J1: 20_HDR_LOCKING

Connections:
GND: J1.1, J1.10, J1.11, J1.20; also elsewhere on the board
RD0: J1.2; also elsewhere on the board
RD1: J1.3; also elsewhere on the board
RD2: J1.4; also elsewhere on the board
RD3: J1.5; also elsewhere on the board
RD4: J1.6; also elsewhere on the board
RD5: J1.7; also elsewhere on the board
RD6: J1.8; also elsewhere on the board
RD7: J1.9; also elsewhere on the board
WD0: J1.12; also elsewhere on the board
WD1: J1.13; also elsewhere on the board
WD2: J1.14; also elsewhere on the board
WD3: J1.15; also elsewhere on the board
WD4: J1.16; also elsewhere on the board
WD5: J1.17; also elsewhere on the board
WD6: J1.18; also elsewhere on the board
WD7: J1.19; also elsewhere on the board

Notes on the sheet:
Upstream data connection

Schematic: 8B_RAM_3.sch, sheet 4

Parts:
J2: 20_HDR_LOCKING
Q594, Q595, Q596, Q750, Q753, Q754, Q755: 2N7000; TO92-DGS
R346, R347, R348, R479, R482, R483: 10k; R_P2INCH

Connections:
+5V: R346.2, R347.2, R348.2, R479.2, R482.2, R483.2; also elsewhere on the board
A0: J2.5, Q594.G; also elsewhere on the board
A0_N: Q594.D, R346.1; also elsewhere on the board
A1: J2.6, Q595.G; also elsewhere on the board
A1_N: Q595.D, R347.1; also elsewhere on the board
A2: J2.7, Q596.G; also elsewhere on the board
A2_N: Q596.D, R348.1; also elsewhere on the board
BOARD_WE: Q753.D, Q754.D, Q755.G, R482.1
BOARD_WE_N: Q755.D, R483.1; also elsewhere on the board
CH_SEL_N_IN: J2.1, Q754.G
GND: J2.2, J2.4, Q594.S, Q595.S, Q596.S, Q750.S, Q753.S, Q754.S, Q755.S; also elsewhere on the board
WE: Q750.D, R479.1
WE_N_IN: J2.3, Q750.G, Q753.G

Notes on the sheet:
Upstream Address Connector

Schematic: 8B_RAM_3.sch, sheet 5

Parts:
Q599, Q600, Q601, Q603, Q604, Q608, Q609, Q610, Q612, Q613: 2N7000; TO92-DGS
R351, R353, R356, R358: 10k; R_P2INCH

Connections:
+5V: R351.2, R353.2, R356.2, R358.2; also elsewhere on the board
A0: Q608.G; also elsewhere on the board
A0_N: Q599.G; also elsewhere on the board
A1_N: Q600.G, Q609.G; also elsewhere on the board
A2_N: Q601.G, Q610.G; also elsewhere on the board
BOARD_WE_N: Q604.G, Q613.G; also elsewhere on the board
BSEL0_N: Q599.D, Q603.G, R351.1; also elsewhere on the board
BSEL1_N: Q608.D, Q612.G, R356.1; also elsewhere on the board
GND: Q601.S, Q603.S, Q604.S, Q610.S, Q612.S, Q613.S; also elsewhere on the board
unnamed: Q608.S, Q609.D
unnamed: Q599.S, Q600.D
unnamed: Q600.S, Q601.D
unnamed: Q609.S, Q610.D
WR_BYTE0: Q603.D, Q604.D, R353.1; also elsewhere on the board
WR_BYTE1: Q612.D, Q613.D, R358.1; also elsewhere on the board

Schematic: 8B_RAM_3.sch, sheet 6

Parts:
Q618, Q619, Q620, Q622, Q623, Q625, Q626, Q627, Q629, Q630: 2N7000; TO92-DGS
R363, R365, R367, R369: 10k; R_P2INCH

Connections:
+5V: R363.2, R365.2, R367.2, R369.2; also elsewhere on the board
A0: Q625.G; also elsewhere on the board
A0_N: Q618.G; also elsewhere on the board
A1: Q619.G, Q626.G; also elsewhere on the board
A2_N: Q620.G, Q627.G; also elsewhere on the board
BOARD_WE_N: Q623.G, Q630.G; also elsewhere on the board
BSEL2_N: Q618.D, Q622.G, R363.1; also elsewhere on the board
BSEL3_N: Q625.D, Q629.G, R367.1; also elsewhere on the board
GND: Q620.S, Q622.S, Q623.S, Q627.S, Q629.S, Q630.S; also elsewhere on the board
unnamed: Q618.S, Q619.D
unnamed: Q619.S, Q620.D
unnamed: Q625.S, Q626.D
unnamed: Q626.S, Q627.D
WR_BYTE2: Q622.D, Q623.D, R365.1; also elsewhere on the board
WR_BYTE3: Q629.D, Q630.D, R369.1; also elsewhere on the board

Schematic: 8B_RAM_3.sch, sheet 7

Parts:
Q632, Q633, Q634, Q636, Q637, Q639, Q640, Q641, Q643, Q644: 2N7000; TO92-DGS
R371, R373, R375, R377: 10k; R_P2INCH

Connections:
+5V: R371.2, R373.2, R375.2, R377.2; also elsewhere on the board
A0: Q639.G; also elsewhere on the board
A0_N: Q632.G; also elsewhere on the board
A1_N: Q633.G, Q640.G; also elsewhere on the board
A2: Q634.G, Q641.G; also elsewhere on the board
BOARD_WE_N: Q637.G, Q644.G; also elsewhere on the board
BSEL4_N: Q632.D, Q636.G, R371.1; also elsewhere on the board
BSEL5_N: Q639.D, Q643.G, R375.1; also elsewhere on the board
GND: Q634.S, Q636.S, Q637.S, Q641.S, Q643.S, Q644.S; also elsewhere on the board
unnamed: Q632.S, Q633.D
unnamed: Q633.S, Q634.D
unnamed: Q639.S, Q640.D
unnamed: Q640.S, Q641.D
WR_BYTE4: Q636.D, Q637.D, R373.1; also elsewhere on the board
WR_BYTE5: Q643.D, Q644.D, R377.1; also elsewhere on the board

Schematic: 8B_RAM_3.sch, sheet 8

Parts:
Q646, Q647, Q648, Q650, Q651, Q653, Q654, Q655, Q657, Q658: 2N7000; TO92-DGS
R379, R381, R383, R385: 10k; R_P2INCH

Connections:
+5V: R379.2, R381.2, R383.2, R385.2; also elsewhere on the board
A0: Q653.G; also elsewhere on the board
A0_N: Q646.G; also elsewhere on the board
A1: Q647.G, Q654.G; also elsewhere on the board
A2: Q648.G, Q655.G; also elsewhere on the board
BOARD_WE_N: Q651.G, Q658.G; also elsewhere on the board
BSEL6_N: Q646.D, Q650.G, R379.1; also elsewhere on the board
BSEL7_N: Q653.D, Q657.G, R383.1; also elsewhere on the board
GND: Q648.S, Q650.S, Q651.S, Q655.S, Q657.S, Q658.S; also elsewhere on the board
unnamed: Q646.S, Q647.D
unnamed: Q647.S, Q648.D
unnamed: Q653.S, Q654.D
unnamed: Q654.S, Q655.D
WR_BYTE6: Q650.D, Q651.D, R381.1; also elsewhere on the board
WR_BYTE7: Q657.D, Q658.D, R385.1; also elsewhere on the board

Schematic: 8B_RAM_3.sch, sheet 9

Parts:
D1, D2: L-1334SRT; LED3MM
Q1, Q2, Q3, Q4, Q5, Q6, Q7, Q8, Q9, Q10, Q11, Q12, Q13, Q14, Q15, Q16, Q17, Q18, Q686, Q687: 2N7000; TO92-DGS
R1, R2, R3, R4, R6, R7, R8, R9, R415, R416: 10k; R_P2INCH
R5, R10: 470; R_P2INCH

Connections:
+5V: D1.A, D2.A, R1.2, R2.2, R3.2, R4.2, R6.2, R7.2, R8.2, R9.2, R415.2, R416.2; also elsewhere on the board
B0_0: Q5.G, Q8.D, R4.1, R5.1
B0_0_N: Q6.D, Q8.G, Q17.G, R3.1
B0_1: Q13.G, Q16.D, R9.1, R10.1
B0_1_N: Q14.D, Q16.G, Q18.G, R8.1
BSEL0_N: Q686.G, Q687.G; also elsewhere on the board
GND: Q1.S, Q3.S, Q5.S, Q7.S, Q9.S, Q11.S, Q13.S, Q15.S, Q17.S, Q18.S, Q686.S, Q687.S; also elsewhere on the board
unnamed: Q9.D, Q10.S
unnamed: Q7.D, Q8.S
unnamed: Q11.D, Q12.S
unnamed: Q13.D, Q14.S
unnamed: Q1.D, Q2.S
unnamed: Q3.D, Q4.S
unnamed: Q10.D, Q12.G, Q14.G, R6.1
unnamed: Q5.D, Q6.S
unnamed: Q12.D, Q15.G, R7.1
unnamed: D2.K (C), R10.2
unnamed: Q2.D, Q4.G, Q6.G, R1.1
unnamed: Q4.D, Q7.G, R2.1
unnamed: Q15.D, Q16.S
unnamed: D1.K (C), R5.2
RD_0_0: Q17.D, Q686.D, R415.1; also elsewhere on the board
RD_0_1: Q18.D, Q687.D, R416.1; also elsewhere on the board
WD0: Q2.G; also elsewhere on the board
WD1: Q10.G; also elsewhere on the board
WR_BYTE0: Q1.G, Q3.G, Q9.G, Q11.G; also elsewhere on the board

Schematic: 8B_RAM_3.sch, sheet 10

Parts:
D5, D6: L-1334SRT; LED3MM
Q37, Q38, Q39, Q40, Q41, Q42, Q43, Q44, Q45, Q46, Q47, Q48, Q49, Q50, Q51, Q52, Q53, Q54, Q688, Q689: 2N7000; TO92-DGS
R21, R22, R23, R24, R26, R27, R28, R29, R417, R418: 10k; R_P2INCH
R25, R30: 470; R_P2INCH

Connections:
+5V: D5.A, D6.A, R21.2, R22.2, R23.2, R24.2, R26.2, R27.2, R28.2, R29.2, R417.2, R418.2; also elsewhere on the board
B0_2: Q41.G, Q43.D, R24.1, R25.1
B0_2_N: Q42.D, Q43.G, Q53.G, R23.1
B0_3: Q49.G, Q51.D, R29.1, R30.1
B0_3_N: Q50.D, Q51.G, Q54.G, R28.1
BSEL0_N: Q688.G, Q689.G; also elsewhere on the board
GND: Q37.S, Q39.S, Q41.S, Q44.S, Q45.S, Q47.S, Q49.S, Q52.S, Q53.S, Q54.S, Q688.S, Q689.S; also elsewhere on the board
unnamed: Q37.D, Q38.S
unnamed: Q39.D, Q40.S
unnamed: Q41.D, Q42.S
unnamed: Q38.D, Q40.G, Q42.G, R21.1
unnamed: Q40.D, Q44.G, R22.1
unnamed: D5.K (C), R25.2
unnamed: Q43.S, Q44.D
unnamed: Q45.D, Q46.S
unnamed: Q47.D, Q48.S
unnamed: Q49.D, Q50.S
unnamed: Q46.D, Q48.G, Q50.G, R26.1
unnamed: Q48.D, Q52.G, R27.1
unnamed: D6.K (C), R30.2
unnamed: Q51.S, Q52.D
RD_0_2: Q53.D, Q688.D, R417.1; also elsewhere on the board
RD_0_3: Q54.D, Q689.D, R418.1; also elsewhere on the board
WD2: Q38.G; also elsewhere on the board
WD3: Q46.G; also elsewhere on the board
WR_BYTE0: Q37.G, Q39.G, Q45.G, Q47.G; also elsewhere on the board

Schematic: 8B_RAM_3.sch, sheet 11

Parts:
D7, D8: L-1334SRT; LED3MM
Q55, Q56, Q57, Q58, Q59, Q60, Q61, Q62, Q63, Q64, Q65, Q66, Q67, Q68, Q69, Q70, Q71, Q72, Q690, Q691: 2N7000; TO92-DGS
R31, R32, R33, R34, R36, R37, R38, R39, R419, R420: 10k; R_P2INCH
R35, R40: 470; R_P2INCH

Connections:
+5V: D7.A, D8.A, R31.2, R32.2, R33.2, R34.2, R36.2, R37.2, R38.2, R39.2, R419.2, R420.2; also elsewhere on the board
B0_4: Q59.G, Q61.D, R34.1, R35.1
B0_4_N: Q60.D, Q61.G, Q71.G, R33.1
B0_5: Q67.G, Q69.D, R39.1, R40.1
B0_5_N: Q68.D, Q69.G, Q72.G, R38.1
BSEL0_N: Q690.G, Q691.G; also elsewhere on the board
GND: Q55.S, Q57.S, Q59.S, Q62.S, Q63.S, Q65.S, Q67.S, Q70.S, Q71.S, Q72.S, Q690.S, Q691.S; also elsewhere on the board
unnamed: Q55.D, Q56.S
unnamed: Q57.D, Q58.S
unnamed: Q59.D, Q60.S
unnamed: Q56.D, Q58.G, Q60.G, R31.1
unnamed: Q58.D, Q62.G, R32.1
unnamed: D7.K (C), R35.2
unnamed: Q61.S, Q62.D
unnamed: Q63.D, Q64.S
unnamed: Q65.D, Q66.S
unnamed: Q67.D, Q68.S
unnamed: Q64.D, Q66.G, Q68.G, R36.1
unnamed: Q66.D, Q70.G, R37.1
unnamed: D8.K (C), R40.2
unnamed: Q69.S, Q70.D
RD_0_4: Q71.D, Q691.D, R419.1; also elsewhere on the board
RD_0_5: Q72.D, Q690.D, R420.1; also elsewhere on the board
WD4: Q56.G; also elsewhere on the board
WD5: Q64.G; also elsewhere on the board
WR_BYTE0: Q55.G, Q57.G, Q63.G, Q65.G; also elsewhere on the board

Schematic: 8B_RAM_3.sch, sheet 12

Parts:
D9, D10: L-1334SRT; LED3MM
Q73, Q74, Q75, Q76, Q77, Q78, Q79, Q80, Q81, Q82, Q83, Q84, Q85, Q86, Q87, Q88, Q89, Q90, Q692, Q693: 2N7000; TO92-DGS
R41, R42, R43, R44, R46, R47, R48, R49, R421, R422: 10k; R_P2INCH
R45, R50: 470; R_P2INCH

Connections:
+5V: D9.A, D10.A, R41.2, R42.2, R43.2, R44.2, R46.2, R47.2, R48.2, R49.2, R421.2, R422.2; also elsewhere on the board
B0_6: Q77.G, Q79.D, R44.1, R45.1
B0_6_N: Q78.D, Q79.G, Q89.G, R43.1
B0_7: Q85.G, Q87.D, R49.1, R50.1
B0_7_N: Q86.D, Q87.G, Q90.G, R48.1
BSEL0_N: Q692.G, Q693.G; also elsewhere on the board
GND: Q73.S, Q75.S, Q77.S, Q80.S, Q81.S, Q83.S, Q85.S, Q88.S, Q89.S, Q90.S, Q692.S, Q693.S; also elsewhere on the board
unnamed: Q73.D, Q74.S
unnamed: Q75.D, Q76.S
unnamed: Q77.D, Q78.S
unnamed: Q74.D, Q76.G, Q78.G, R41.1
unnamed: Q76.D, Q80.G, R42.1
unnamed: D9.K (C), R45.2
unnamed: Q79.S, Q80.D
unnamed: Q81.D, Q82.S
unnamed: Q83.D, Q84.S
unnamed: Q85.D, Q86.S
unnamed: Q82.D, Q84.G, Q86.G, R46.1
unnamed: Q84.D, Q88.G, R47.1
unnamed: D10.K (C), R50.2
unnamed: Q87.S, Q88.D
RD_0_6: Q89.D, Q692.D, R421.1; also elsewhere on the board
RD_0_7: Q90.D, Q693.D, R422.1; also elsewhere on the board
WD6: Q74.G; also elsewhere on the board
WD7: Q82.G; also elsewhere on the board
WR_BYTE0: Q73.G, Q75.G, Q81.G, Q83.G; also elsewhere on the board
