ericherman/megaprocessor/8b_ram/8B_RAM_3.brd

## EAGLE design 8b_ram/8B_RAM_3.brd (continued)

Schematic: 8B_RAM_3.sch, sheet 13

Parts:
D3, D4: L-1334SRT; LED3MM
Q19, Q20, Q21, Q22, Q23, Q24, Q25, Q26, Q27, Q28, Q29, Q30, Q31, Q32, Q33, Q34, Q35, Q36, Q694, Q695: 2N7000; TO92-DGS
R11, R12, R13, R14, R16, R17, R18, R19, R423, R424: 10k; R_P2INCH
R15, R20: 470; R_P2INCH

Connections:
+5V: D3.A, D4.A, R11.2, R12.2, R13.2, R14.2, R16.2, R17.2, R18.2, R19.2, R423.2, R424.2; also elsewhere on the board
B1_0: Q23.G, Q25.D, R14.1, R15.1
B1_0_N: Q24.D, Q25.G, Q35.G, R13.1
B1_1: Q31.G, Q33.D, R19.1, R20.1
B1_1_N: Q32.D, Q33.G, Q36.G, R18.1
BSEL1_N: Q694.G, Q695.G; also elsewhere on the board
GND: Q19.S, Q21.S, Q23.S, Q26.S, Q27.S, Q29.S, Q31.S, Q34.S, Q35.S, Q36.S, Q694.S, Q695.S; also elsewhere on the board
unnamed: Q19.D, Q20.S
unnamed: Q21.D, Q22.S
unnamed: Q23.D, Q24.S
unnamed: Q20.D, Q22.G, Q24.G, R11.1
unnamed: Q22.D, Q26.G, R12.1
unnamed: D3.K (C), R15.2
unnamed: Q25.S, Q26.D
unnamed: Q27.D, Q28.S
unnamed: Q29.D, Q30.S
unnamed: Q31.D, Q32.S
unnamed: Q28.D, Q30.G, Q32.G, R16.1
unnamed: Q30.D, Q34.G, R17.1
unnamed: D4.K (C), R20.2
unnamed: Q33.S, Q34.D
RD_1_0: Q35.D, Q694.D, R423.1; also elsewhere on the board
RD_1_1: Q36.D, Q695.D, R424.1; also elsewhere on the board
WD0: Q20.G; also elsewhere on the board
WD1: Q28.G; also elsewhere on the board
WR_BYTE1: Q19.G, Q21.G, Q27.G, Q29.G; also elsewhere on the board

Schematic: 8B_RAM_3.sch, sheet 14

Parts:
D11, D12: L-1334SRT; LED3MM
Q91, Q92, Q93, Q94, Q95, Q96, Q97, Q98, Q99, Q100, Q101, Q102, Q103, Q104, Q105, Q106, Q107, Q108, Q696, Q697: 2N7000; TO92-DGS
R51, R52, R53, R54, R56, R57, R58, R59, R425, R426: 10k; R_P2INCH
R55, R60: 470; R_P2INCH

Connections:
+5V: D11.A, D12.A, R51.2, R52.2, R53.2, R54.2, R56.2, R57.2, R58.2, R59.2, R425.2, R426.2; also elsewhere on the board
B1_2: Q95.G, Q97.D, R54.1, R55.1
B1_2_N: Q96.D, Q97.G, Q107.G, R53.1
B1_3: Q103.G, Q105.D, R59.1, R60.1
B1_3_N: Q104.D, Q105.G, Q108.G, R58.1
BSEL1_N: Q696.G, Q697.G; also elsewhere on the board
GND: Q91.S, Q93.S, Q95.S, Q98.S, Q99.S, Q101.S, Q103.S, Q106.S, Q107.S, Q108.S, Q696.S, Q697.S; also elsewhere on the board
unnamed: Q91.D, Q92.S
unnamed: Q93.D, Q94.S
unnamed: Q95.D, Q96.S
unnamed: Q92.D, Q94.G, Q96.G, R51.1
unnamed: Q94.D, Q98.G, R52.1
unnamed: D11.K (C), R55.2
unnamed: Q97.S, Q98.D
unnamed: Q99.D, Q100.S
unnamed: Q101.D, Q102.S
unnamed: Q103.D, Q104.S
unnamed: Q100.D, Q102.G, Q104.G, R56.1
unnamed: Q102.D, Q106.G, R57.1
unnamed: D12.K (C), R60.2
unnamed: Q105.S, Q106.D
RD_1_2: Q107.D, Q697.D, R425.1; also elsewhere on the board
RD_1_3: Q108.D, Q696.D, R426.1; also elsewhere on the board
WD2: Q92.G; also elsewhere on the board
WD3: Q100.G; also elsewhere on the board
WR_BYTE1: Q91.G, Q93.G, Q99.G, Q101.G; also elsewhere on the board

Schematic: 8B_RAM_3.sch, sheet 15

Parts:
D13, D14: L-1334SRT; LED3MM
Q109, Q110, Q111, Q112, Q113, Q114, Q115, Q116, Q117, Q118, Q119, Q120, Q121, Q122, Q123, Q124, Q125, Q126, Q698, Q699: 2N7000; TO92-DGS
R61, R62, R63, R64, R66, R67, R68, R69, R427, R428: 10k; R_P2INCH
R65, R70: 470; R_P2INCH

Connections:
+5V: D13.A, D14.A, R61.2, R62.2, R63.2, R64.2, R66.2, R67.2, R68.2, R69.2, R427.2, R428.2; also elsewhere on the board
B1_4: Q113.G, Q115.D, R64.1, R65.1
B1_4_N: Q114.D, Q115.G, Q125.G, R63.1
B1_5: Q121.G, Q123.D, R69.1, R70.1
B1_5_N: Q122.D, Q123.G, Q126.G, R68.1
BSEL1_N: Q698.G, Q699.G; also elsewhere on the board
GND: Q109.S, Q111.S, Q113.S, Q116.S, Q117.S, Q119.S, Q121.S, Q124.S, Q125.S, Q126.S, Q698.S, Q699.S; also elsewhere on the board
unnamed: Q109.D, Q110.S
unnamed: Q111.D, Q112.S
unnamed: Q113.D, Q114.S
unnamed: Q110.D, Q112.G, Q114.G, R61.1
unnamed: Q112.D, Q116.G, R62.1
unnamed: D13.K (C), R65.2
unnamed: Q115.S, Q116.D
unnamed: Q117.D, Q118.S
unnamed: Q119.D, Q120.S
unnamed: Q121.D, Q122.S
unnamed: Q118.D, Q120.G, Q122.G, R66.1
unnamed: Q120.D, Q124.G, R67.1
unnamed: D14.K (C), R70.2
unnamed: Q123.S, Q124.D
RD_1_4: Q125.D, Q698.D, R427.1; also elsewhere on the board
RD_1_5: Q126.D, Q699.D, R428.1; also elsewhere on the board
WD4: Q110.G; also elsewhere on the board
WD5: Q118.G; also elsewhere on the board
WR_BYTE1: Q109.G, Q111.G, Q117.G, Q119.G; also elsewhere on the board

Schematic: 8B_RAM_3.sch, sheet 16

Parts:
D15, D16: L-1334SRT; LED3MM
Q127, Q128, Q129, Q130, Q131, Q132, Q133, Q134, Q135, Q136, Q137, Q138, Q139, Q140, Q141, Q142, Q143, Q144, Q700, Q701: 2N7000; TO92-DGS
R71, R72, R73, R74, R76, R77, R78, R79, R429, R430: 10k; R_P2INCH
R75, R80: 470; R_P2INCH

Connections:
+5V: D15.A, D16.A, R71.2, R72.2, R73.2, R74.2, R76.2, R77.2, R78.2, R79.2, R429.2, R430.2; also elsewhere on the board
B1_6: Q131.G, Q133.D, R74.1, R75.1
B1_6_N: Q132.D, Q133.G, Q143.G, R73.1
B1_7: Q139.G, Q141.D, R79.1, R80.1
B1_7_N: Q140.D, Q141.G, Q144.G, R78.1
BSEL1_N: Q700.G, Q701.G; also elsewhere on the board
GND: Q127.S, Q129.S, Q131.S, Q134.S, Q135.S, Q137.S, Q139.S, Q142.S, Q143.S, Q144.S, Q700.S, Q701.S; also elsewhere on the board
unnamed: Q127.D, Q128.S
unnamed: Q129.D, Q130.S
unnamed: Q131.D, Q132.S
unnamed: Q128.D, Q130.G, Q132.G, R71.1
unnamed: Q130.D, Q134.G, R72.1
unnamed: D15.K (C), R75.2
unnamed: Q133.S, Q134.D
unnamed: Q135.D, Q136.S
unnamed: Q137.D, Q138.S
unnamed: Q139.D, Q140.S
unnamed: Q136.D, Q138.G, Q140.G, R76.1
unnamed: Q138.D, Q142.G, R77.1
unnamed: D16.K (C), R80.2
unnamed: Q141.S, Q142.D
RD_1_6: Q143.D, Q700.D, R429.1; also elsewhere on the board
RD_1_7: Q144.D, Q701.D, R430.1; also elsewhere on the board
WD6: Q128.G; also elsewhere on the board
WD7: Q136.G; also elsewhere on the board
WR_BYTE1: Q127.G, Q129.G, Q135.G, Q137.G; also elsewhere on the board

Schematic: 8B_RAM_3.sch, sheet 17

Parts:
D17, D18: L-1334SRT; LED3MM
Q145, Q146, Q147, Q148, Q149, Q150, Q151, Q152, Q153, Q154, Q155, Q156, Q157, Q158, Q159, Q160, Q161, Q162, Q702, Q703: 2N7000; TO92-DGS
R81, R82, R83, R84, R86, R87, R88, R89, R431, R432: 10k; R_P2INCH
R85, R90: 470; R_P2INCH

Connections:
+5V: D17.A, D18.A, R81.2, R82.2, R83.2, R84.2, R86.2, R87.2, R88.2, R89.2, R431.2, R432.2; also elsewhere on the board
B2_0: Q149.G, Q151.D, R84.1, R85.1
B2_0_N: Q150.D, Q151.G, Q161.G, R83.1
B2_1: Q157.G, Q159.D, R89.1, R90.1
B2_1_N: Q158.D, Q159.G, Q162.G, R88.1
BSEL2_N: Q702.G, Q703.G; also elsewhere on the board
GND: Q145.S, Q147.S, Q149.S, Q152.S, Q153.S, Q155.S, Q157.S, Q160.S, Q161.S, Q162.S, Q702.S, Q703.S; also elsewhere on the board
unnamed: Q145.D, Q146.S
unnamed: Q147.D, Q148.S
unnamed: Q149.D, Q150.S
unnamed: Q146.D, Q148.G, Q150.G, R81.1
unnamed: Q148.D, Q152.G, R82.1
unnamed: D17.K (C), R85.2
unnamed: Q151.S, Q152.D
unnamed: Q153.D, Q154.S
unnamed: Q155.D, Q156.S
unnamed: Q157.D, Q158.S
unnamed: Q154.D, Q156.G, Q158.G, R86.1
unnamed: Q156.D, Q160.G, R87.1
unnamed: D18.K (C), R90.2
unnamed: Q159.S, Q160.D
RD_2_0: Q161.D, Q702.D, R431.1; also elsewhere on the board
RD_2_1: Q162.D, Q703.D, R432.1; also elsewhere on the board
WD0: Q146.G; also elsewhere on the board
WD1: Q154.G; also elsewhere on the board
WR_BYTE2: Q145.G, Q147.G, Q153.G, Q155.G; also elsewhere on the board

Schematic: 8B_RAM_3.sch, sheet 18

Parts:
D19, D20: L-1334SRT; LED3MM
Q163, Q164, Q165, Q166, Q167, Q168, Q169, Q170, Q171, Q172, Q173, Q174, Q175, Q176, Q177, Q178, Q179, Q180, Q704, Q705: 2N7000; TO92-DGS
R91, R92, R93, R94, R96, R97, R98, R99, R433, R434: 10k; R_P2INCH
R95, R100: 470; R_P2INCH

Connections:
+5V: D19.A, D20.A, R91.2, R92.2, R93.2, R94.2, R96.2, R97.2, R98.2, R99.2, R433.2, R434.2; also elsewhere on the board
B2_2: Q167.G, Q169.D, R94.1, R95.1
B2_2_N: Q168.D, Q169.G, Q179.G, R93.1
B2_3: Q175.G, Q177.D, R99.1, R100.1
B2_3_N: Q176.D, Q177.G, Q180.G, R98.1
BSEL2_N: Q704.G, Q705.G; also elsewhere on the board
GND: Q163.S, Q165.S, Q167.S, Q170.S, Q171.S, Q173.S, Q175.S, Q178.S, Q179.S, Q180.S, Q704.S, Q705.S; also elsewhere on the board
unnamed: Q163.D, Q164.S
unnamed: Q165.D, Q166.S
unnamed: Q167.D, Q168.S
unnamed: Q164.D, Q166.G, Q168.G, R91.1
unnamed: Q166.D, Q170.G, R92.1
unnamed: D19.K (C), R95.2
unnamed: Q169.S, Q170.D
unnamed: Q171.D, Q172.S
unnamed: Q173.D, Q174.S
unnamed: Q175.D, Q176.S
unnamed: Q172.D, Q174.G, Q176.G, R96.1
unnamed: Q174.D, Q178.G, R97.1
unnamed: D20.K (C), R100.2
unnamed: Q177.S, Q178.D
RD_2_2: Q179.D, Q704.D, R433.1; also elsewhere on the board
RD_2_3: Q180.D, Q705.D, R434.1; also elsewhere on the board
WD2: Q164.G; also elsewhere on the board
WD3: Q172.G; also elsewhere on the board
WR_BYTE2: Q163.G, Q165.G, Q171.G, Q173.G; also elsewhere on the board

Schematic: 8B_RAM_3.sch, sheet 19

Parts:
D21, D22: L-1334SRT; LED3MM
Q181, Q182, Q183, Q184, Q185, Q186, Q187, Q188, Q189, Q190, Q191, Q192, Q193, Q194, Q195, Q196, Q197, Q198, Q706, Q707: 2N7000; TO92-DGS
R101, R102, R103, R104, R106, R107, R108, R109, R435, R436: 10k; R_P2INCH
R105, R110: 470; R_P2INCH

Connections:
+5V: D21.A, D22.A, R101.2, R102.2, R103.2, R104.2, R106.2, R107.2, R108.2, R109.2, R435.2, R436.2; also elsewhere on the board
B2_4: Q185.G, Q187.D, R104.1, R105.1
B2_4_N: Q186.D, Q187.G, Q197.G, R103.1
B2_5: Q193.G, Q195.D, R109.1, R110.1
B2_5_N: Q194.D, Q195.G, Q198.G, R108.1
BSEL2_N: Q706.G, Q707.G; also elsewhere on the board
GND: Q181.S, Q183.S, Q185.S, Q188.S, Q189.S, Q191.S, Q193.S, Q196.S, Q197.S, Q198.S, Q706.S, Q707.S; also elsewhere on the board
unnamed: Q181.D, Q182.S
unnamed: Q183.D, Q184.S
unnamed: Q185.D, Q186.S
unnamed: Q182.D, Q184.G, Q186.G, R101.1
unnamed: Q184.D, Q188.G, R102.1
unnamed: D21.K (C), R105.2
unnamed: Q187.S, Q188.D
unnamed: Q189.D, Q190.S
unnamed: Q191.D, Q192.S
unnamed: Q193.D, Q194.S
unnamed: Q190.D, Q192.G, Q194.G, R106.1
unnamed: Q192.D, Q196.G, R107.1
unnamed: D22.K (C), R110.2
unnamed: Q195.S, Q196.D
RD_2_4: Q197.D, Q706.D, R435.1; also elsewhere on the board
RD_2_5: Q198.D, Q707.D, R436.1; also elsewhere on the board
WD4: Q182.G; also elsewhere on the board
WD5: Q190.G; also elsewhere on the board
WR_BYTE2: Q181.G, Q183.G, Q189.G, Q191.G; also elsewhere on the board

Schematic: 8B_RAM_3.sch, sheet 20

Parts:
D23, D24: L-1334SRT; LED3MM
Q199, Q200, Q201, Q202, Q203, Q204, Q205, Q206, Q207, Q208, Q209, Q210, Q211, Q212, Q213, Q214, Q215, Q216, Q708, Q709: 2N7000; TO92-DGS
R111, R112, R113, R114, R116, R117, R118, R119, R437, R438: 10k; R_P2INCH
R115, R120: 470; R_P2INCH

Connections:
+5V: D23.A, D24.A, R111.2, R112.2, R113.2, R114.2, R116.2, R117.2, R118.2, R119.2, R437.2, R438.2; also elsewhere on the board
B2_6: Q203.G, Q205.D, R114.1, R115.1
B2_6_N: Q204.D, Q205.G, Q215.G, R113.1
B2_7: Q211.G, Q213.D, R119.1, R120.1
B2_7_N: Q212.D, Q213.G, Q216.G, R118.1
BSEL2_N: Q708.G, Q709.G; also elsewhere on the board
GND: Q199.S, Q201.S, Q203.S, Q206.S, Q207.S, Q209.S, Q211.S, Q214.S, Q215.S, Q216.S, Q708.S, Q709.S; also elsewhere on the board
unnamed: Q199.D, Q200.S
unnamed: Q201.D, Q202.S
unnamed: Q203.D, Q204.S
unnamed: Q200.D, Q202.G, Q204.G, R111.1
unnamed: Q202.D, Q206.G, R112.1
unnamed: D23.K (C), R115.2
unnamed: Q205.S, Q206.D
unnamed: Q207.D, Q208.S
unnamed: Q209.D, Q210.S
unnamed: Q211.D, Q212.S
unnamed: Q208.D, Q210.G, Q212.G, R116.1
unnamed: Q210.D, Q214.G, R117.1
unnamed: D24.K (C), R120.2
unnamed: Q213.S, Q214.D
RD_2_6: Q215.D, Q708.D, R437.1; also elsewhere on the board
RD_2_7: Q216.D, Q709.D, R438.1; also elsewhere on the board
WD6: Q200.G; also elsewhere on the board
WD7: Q208.G; also elsewhere on the board
WR_BYTE2: Q199.G, Q201.G, Q207.G, Q209.G; also elsewhere on the board

Schematic: 8B_RAM_3.sch, sheet 21

Parts:
D25, D26: L-1334SRT; LED3MM
Q217, Q218, Q219, Q220, Q221, Q222, Q223, Q224, Q225, Q226, Q227, Q228, Q229, Q230, Q231, Q232, Q233, Q234, Q710, Q711: 2N7000; TO92-DGS
R121, R122, R123, R124, R126, R127, R128, R129, R439, R440: 10k; R_P2INCH
R125, R130: 470; R_P2INCH

Connections:
+5V: D25.A, D26.A, R121.2, R122.2, R123.2, R124.2, R126.2, R127.2, R128.2, R129.2, R439.2, R440.2; also elsewhere on the board
B3_0: Q221.G, Q223.D, R124.1, R125.1
B3_0_N: Q222.D, Q223.G, Q233.G, R123.1
B3_1: Q229.G, Q231.D, R129.1, R130.1
B3_1_N: Q230.D, Q231.G, Q234.G, R128.1
BSEL3_N: Q710.G, Q711.G; also elsewhere on the board
GND: Q217.S, Q219.S, Q221.S, Q224.S, Q225.S, Q227.S, Q229.S, Q232.S, Q233.S, Q234.S, Q710.S, Q711.S; also elsewhere on the board
unnamed: Q217.D, Q218.S
unnamed: Q219.D, Q220.S
unnamed: Q221.D, Q222.S
unnamed: Q218.D, Q220.G, Q222.G, R121.1
unnamed: Q220.D, Q224.G, R122.1
unnamed: D25.K (C), R125.2
unnamed: Q223.S, Q224.D
unnamed: Q225.D, Q226.S
unnamed: Q227.D, Q228.S
unnamed: Q229.D, Q230.S
unnamed: Q226.D, Q228.G, Q230.G, R126.1
unnamed: Q228.D, Q232.G, R127.1
unnamed: D26.K (C), R130.2
unnamed: Q231.S, Q232.D
RD_3_0: Q233.D, Q710.D, R439.1; also elsewhere on the board
RD_3_1: Q234.D, Q711.D, R440.1; also elsewhere on the board
WD0: Q218.G; also elsewhere on the board
WD1: Q226.G; also elsewhere on the board
WR_BYTE3: Q217.G, Q219.G, Q225.G, Q227.G; also elsewhere on the board

Schematic: 8B_RAM_3.sch, sheet 22

Parts:
D27, D28: L-1334SRT; LED3MM
Q235, Q236, Q237, Q238, Q239, Q240, Q241, Q242, Q243, Q244, Q245, Q246, Q247, Q248, Q249, Q250, Q251, Q252, Q712, Q713: 2N7000; TO92-DGS
R131, R132, R133, R134, R136, R137, R138, R139, R441, R442: 10k; R_P2INCH
R135, R140: 470; R_P2INCH

Connections:
+5V: D27.A, D28.A, R131.2, R132.2, R133.2, R134.2, R136.2, R137.2, R138.2, R139.2, R441.2, R442.2; also elsewhere on the board
B3_2: Q239.G, Q241.D, R134.1, R135.1
B3_2_N: Q240.D, Q241.G, Q251.G, R133.1
B3_3: Q247.G, Q249.D, R139.1, R140.1
B3_3_N: Q248.D, Q249.G, Q252.G, R138.1
BSEL3_N: Q712.G, Q713.G; also elsewhere on the board
GND: Q235.S, Q237.S, Q239.S, Q242.S, Q243.S, Q245.S, Q247.S, Q250.S, Q251.S, Q252.S, Q712.S, Q713.S; also elsewhere on the board
unnamed: Q235.D, Q236.S
unnamed: Q237.D, Q238.S
unnamed: Q239.D, Q240.S
unnamed: Q236.D, Q238.G, Q240.G, R131.1
unnamed: Q238.D, Q242.G, R132.1
unnamed: D27.K (C), R135.2
unnamed: Q241.S, Q242.D
unnamed: Q243.D, Q244.S
unnamed: Q245.D, Q246.S
unnamed: Q247.D, Q248.S
unnamed: Q244.D, Q246.G, Q248.G, R136.1
unnamed: Q246.D, Q250.G, R137.1
unnamed: D28.K (C), R140.2
unnamed: Q249.S, Q250.D
RD_3_2: Q251.D, Q712.D, R441.1; also elsewhere on the board
RD_3_3: Q252.D, Q713.D, R442.1; also elsewhere on the board
WD2: Q236.G; also elsewhere on the board
WD3: Q244.G; also elsewhere on the board
WR_BYTE3: Q235.G, Q237.G, Q243.G, Q245.G; also elsewhere on the board

Schematic: 8B_RAM_3.sch, sheet 23

Parts:
D29, D30: L-1334SRT; LED3MM
Q253, Q254, Q255, Q256, Q257, Q258, Q259, Q260, Q261, Q262, Q263, Q264, Q265, Q266, Q267, Q268, Q269, Q270, Q714, Q715: 2N7000; TO92-DGS
R141, R142, R143, R144, R146, R147, R148, R149, R443, R444: 10k; R_P2INCH
R145, R150: 470; R_P2INCH

Connections:
+5V: D29.A, D30.A, R141.2, R142.2, R143.2, R144.2, R146.2, R147.2, R148.2, R149.2, R443.2, R444.2; also elsewhere on the board
B3_4: Q257.G, Q259.D, R144.1, R145.1
B3_4_N: Q258.D, Q259.G, Q269.G, R143.1
B3_5: Q265.G, Q267.D, R149.1, R150.1
B3_5_N: Q266.D, Q267.G, Q270.G, R148.1
BSEL3_N: Q714.G, Q715.G; also elsewhere on the board
GND: Q253.S, Q255.S, Q257.S, Q260.S, Q261.S, Q263.S, Q265.S, Q268.S, Q269.S, Q270.S, Q714.S, Q715.S; also elsewhere on the board
unnamed: Q253.D, Q254.S
unnamed: Q255.D, Q256.S
unnamed: Q257.D, Q258.S
unnamed: Q254.D, Q256.G, Q258.G, R141.1
unnamed: Q256.D, Q260.G, R142.1
unnamed: D29.K (C), R145.2
unnamed: Q259.S, Q260.D
unnamed: Q261.D, Q262.S
unnamed: Q263.D, Q264.S
unnamed: Q265.D, Q266.S
unnamed: Q262.D, Q264.G, Q266.G, R146.1
unnamed: Q264.D, Q268.G, R147.1
unnamed: D30.K (C), R150.2
unnamed: Q267.S, Q268.D
RD_3_4: Q269.D, Q714.D, R443.1; also elsewhere on the board
RD_3_5: Q270.D, Q715.D, R444.1; also elsewhere on the board
WD4: Q254.G; also elsewhere on the board
WD5: Q262.G; also elsewhere on the board
WR_BYTE3: Q253.G, Q255.G, Q261.G, Q263.G; also elsewhere on the board

Schematic: 8B_RAM_3.sch, sheet 24

Parts:
D31, D32: L-1334SRT; LED3MM
Q271, Q272, Q273, Q274, Q275, Q276, Q277, Q278, Q279, Q280, Q281, Q282, Q283, Q284, Q285, Q286, Q287, Q288, Q716, Q717: 2N7000; TO92-DGS
R151, R152, R153, R154, R156, R157, R158, R159, R445, R446: 10k; R_P2INCH
R155, R160: 470; R_P2INCH

Connections:
+5V: D31.A, D32.A, R151.2, R152.2, R153.2, R154.2, R156.2, R157.2, R158.2, R159.2, R445.2, R446.2; also elsewhere on the board
B3_6: Q275.G, Q277.D, R154.1, R155.1
B3_6_N: Q276.D, Q277.G, Q287.G, R153.1
B3_7: Q283.G, Q285.D, R159.1, R160.1
B3_7_N: Q284.D, Q285.G, Q288.G, R158.1
BSEL3_N: Q716.G, Q717.G; also elsewhere on the board
GND: Q271.S, Q273.S, Q275.S, Q278.S, Q279.S, Q281.S, Q283.S, Q286.S, Q287.S, Q288.S, Q716.S, Q717.S; also elsewhere on the board
unnamed: Q271.D, Q272.S
unnamed: Q273.D, Q274.S
unnamed: Q275.D, Q276.S
unnamed: Q272.D, Q274.G, Q276.G, R151.1
unnamed: Q274.D, Q278.G, R152.1
unnamed: D31.K (C), R155.2
unnamed: Q277.S, Q278.D
unnamed: Q279.D, Q280.S
unnamed: Q281.D, Q282.S
unnamed: Q283.D, Q284.S
unnamed: Q280.D, Q282.G, Q284.G, R156.1
unnamed: Q282.D, Q286.G, R157.1
unnamed: D32.K (C), R160.2
unnamed: Q285.S, Q286.D
RD_3_6: Q287.D, Q716.D, R445.1; also elsewhere on the board
RD_3_7: Q288.D, Q717.D, R446.1; also elsewhere on the board
WD6: Q272.G; also elsewhere on the board
WD7: Q280.G; also elsewhere on the board
WR_BYTE3: Q271.G, Q273.G, Q279.G, Q281.G; also elsewhere on the board

Schematic: 8B_RAM_3.sch, sheet 25

Parts:
D33, D34: L-1334SRT; LED3MM
Q289, Q290, Q291, Q292, Q293, Q294, Q295, Q296, Q297, Q298, Q299, Q300, Q301, Q302, Q303, Q304, Q305, Q306, Q718, Q719: 2N7000; TO92-DGS
R161, R162, R163, R164, R166, R167, R168, R169, R447, R448: 10k; R_P2INCH
R165, R170: 470; R_P2INCH

Connections:
+5V: D33.A, D34.A, R161.2, R162.2, R163.2, R164.2, R166.2, R167.2, R168.2, R169.2, R447.2, R448.2; also elsewhere on the board
B4_0: Q293.G, Q295.D, R164.1, R165.1
B4_0_N: Q294.D, Q295.G, Q305.G, R163.1
B4_1: Q301.G, Q303.D, R169.1, R170.1
B4_1_N: Q302.D, Q303.G, Q306.G, R168.1
BSEL4_N: Q718.G, Q719.G; also elsewhere on the board
GND: Q289.S, Q291.S, Q293.S, Q296.S, Q297.S, Q299.S, Q301.S, Q304.S, Q305.S, Q306.S, Q718.S, Q719.S; also elsewhere on the board
unnamed: Q289.D, Q290.S
unnamed: Q291.D, Q292.S
unnamed: Q293.D, Q294.S
unnamed: Q290.D, Q292.G, Q294.G, R161.1
unnamed: Q292.D, Q296.G, R162.1
unnamed: D33.K (C), R165.2
unnamed: Q295.S, Q296.D
unnamed: Q297.D, Q298.S
unnamed: Q299.D, Q300.S
unnamed: Q301.D, Q302.S
unnamed: Q298.D, Q300.G, Q302.G, R166.1
unnamed: Q300.D, Q304.G, R167.1
unnamed: D34.K (C), R170.2
unnamed: Q303.S, Q304.D
RD_4_0: Q305.D, Q718.D, R447.1; also elsewhere on the board
RD_4_1: Q306.D, Q719.D, R448.1; also elsewhere on the board
WD0: Q290.G; also elsewhere on the board
WD1: Q298.G; also elsewhere on the board
WR_BYTE4: Q289.G, Q291.G, Q297.G, Q299.G; also elsewhere on the board

Schematic: 8B_RAM_3.sch, sheet 26

Parts:
D35, D36: L-1334SRT; LED3MM
Q307, Q308, Q309, Q310, Q311, Q312, Q313, Q314, Q315, Q316, Q317, Q318, Q319, Q320, Q321, Q322, Q323, Q324, Q720, Q721: 2N7000; TO92-DGS
R171, R172, R173, R174, R176, R177, R178, R179, R449, R450: 10k; R_P2INCH
R175, R180: 470; R_P2INCH

Connections:
+5V: D35.A, D36.A, R171.2, R172.2, R173.2, R174.2, R176.2, R177.2, R178.2, R179.2, R449.2, R450.2; also elsewhere on the board
B4_2: Q311.G, Q313.D, R174.1, R175.1
B4_2_N: Q312.D, Q313.G, Q323.G, R173.1
B4_3: Q319.G, Q321.D, R179.1, R180.1
B4_3_N: Q320.D, Q321.G, Q324.G, R178.1
BSEL4_N: Q720.G, Q721.G; also elsewhere on the board
GND: Q307.S, Q309.S, Q311.S, Q314.S, Q315.S, Q317.S, Q319.S, Q322.S, Q323.S, Q324.S, Q720.S, Q721.S; also elsewhere on the board
unnamed: Q307.D, Q308.S
unnamed: Q309.D, Q310.S
unnamed: Q311.D, Q312.S
unnamed: Q308.D, Q310.G, Q312.G, R171.1
unnamed: Q310.D, Q314.G, R172.1
unnamed: D35.K (C), R175.2
unnamed: Q313.S, Q314.D
unnamed: Q315.D, Q316.S
unnamed: Q317.D, Q318.S
unnamed: Q319.D, Q320.S
unnamed: Q316.D, Q318.G, Q320.G, R176.1
unnamed: Q318.D, Q322.G, R177.1
unnamed: D36.K (C), R180.2
unnamed: Q321.S, Q322.D
RD_4_2: Q323.D, Q720.D, R449.1; also elsewhere on the board
RD_4_3: Q324.D, Q721.D, R450.1; also elsewhere on the board
WD2: Q308.G; also elsewhere on the board
WD3: Q316.G; also elsewhere on the board
WR_BYTE4: Q307.G, Q309.G, Q315.G, Q317.G; also elsewhere on the board

Schematic: 8B_RAM_3.sch, sheet 27

Parts:
D37, D38: L-1334SRT; LED3MM
Q325, Q326, Q327, Q328, Q329, Q330, Q331, Q332, Q333, Q334, Q335, Q336, Q337, Q338, Q339, Q340, Q341, Q342, Q722, Q723: 2N7000; TO92-DGS
R181, R182, R183, R184, R186, R187, R188, R189, R451, R452: 10k; R_P2INCH
R185, R190: 470; R_P2INCH

Connections:
+5V: D37.A, D38.A, R181.2, R182.2, R183.2, R184.2, R186.2, R187.2, R188.2, R189.2, R451.2, R452.2; also elsewhere on the board
B4_4: Q329.G, Q331.D, R184.1, R185.1
B4_4_N: Q330.D, Q331.G, Q341.G, R183.1
B4_5: Q337.G, Q339.D, R189.1, R190.1
B4_5_N: Q338.D, Q339.G, Q342.G, R188.1
BSEL4_N: Q722.G, Q723.G; also elsewhere on the board
GND: Q325.S, Q327.S, Q329.S, Q332.S, Q333.S, Q335.S, Q337.S, Q340.S, Q341.S, Q342.S, Q722.S, Q723.S; also elsewhere on the board
unnamed: Q325.D, Q326.S
unnamed: Q327.D, Q328.S
unnamed: Q329.D, Q330.S
unnamed: Q326.D, Q328.G, Q330.G, R181.1
unnamed: Q328.D, Q332.G, R182.1
unnamed: D37.K (C), R185.2
unnamed: Q331.S, Q332.D
unnamed: Q333.D, Q334.S
unnamed: Q335.D, Q336.S
unnamed: Q337.D, Q338.S
unnamed: Q334.D, Q336.G, Q338.G, R186.1
unnamed: Q336.D, Q340.G, R187.1
unnamed: D38.K (C), R190.2
unnamed: Q339.S, Q340.D
RD_4_4: Q341.D, Q722.D, R451.1; also elsewhere on the board
RD_4_5: Q342.D, Q723.D, R452.1; also elsewhere on the board
WD4: Q326.G; also elsewhere on the board
WD5: Q334.G; also elsewhere on the board
WR_BYTE4: Q325.G, Q327.G, Q333.G, Q335.G; also elsewhere on the board

Schematic: 8B_RAM_3.sch, sheet 28

Parts:
D39, D40: L-1334SRT; LED3MM
Q343, Q344, Q345, Q346, Q347, Q348, Q349, Q350, Q351, Q352, Q353, Q354, Q355, Q356, Q357, Q358, Q359, Q360, Q724, Q725: 2N7000; TO92-DGS
R191, R192, R193, R194, R196, R197, R198, R199, R453, R454: 10k; R_P2INCH
R195, R200: 470; R_P2INCH

Connections:
+5V: D39.A, D40.A, R191.2, R192.2, R193.2, R194.2, R196.2, R197.2, R198.2, R199.2, R453.2, R454.2; also elsewhere on the board
B4_6: Q347.G, Q349.D, R194.1, R195.1
B4_6_N: Q348.D, Q349.G, Q359.G, R193.1
B4_7: Q355.G, Q357.D, R199.1, R200.1
B4_7_N: Q356.D, Q357.G, Q360.G, R198.1
BSEL4_N: Q724.G, Q725.G; also elsewhere on the board
GND: Q343.S, Q345.S, Q347.S, Q350.S, Q351.S, Q353.S, Q355.S, Q358.S, Q359.S, Q360.S, Q724.S, Q725.S; also elsewhere on the board
unnamed: Q343.D, Q344.S
unnamed: Q345.D, Q346.S
unnamed: Q347.D, Q348.S
unnamed: Q344.D, Q346.G, Q348.G, R191.1
unnamed: Q346.D, Q350.G, R192.1
unnamed: D39.K (C), R195.2
unnamed: Q349.S, Q350.D
unnamed: Q351.D, Q352.S
unnamed: Q353.D, Q354.S
unnamed: Q355.D, Q356.S
unnamed: Q352.D, Q354.G, Q356.G, R196.1
unnamed: Q354.D, Q358.G, R197.1
unnamed: D40.K (C), R200.2
unnamed: Q357.S, Q358.D
RD_4_6: Q359.D, Q724.D, R453.1; also elsewhere on the board
RD_4_7: Q360.D, Q725.D, R454.1; also elsewhere on the board
WD6: Q344.G; also elsewhere on the board
WD7: Q352.G; also elsewhere on the board
WR_BYTE4: Q343.G, Q345.G, Q351.G, Q353.G; also elsewhere on the board

Schematic: 8B_RAM_3.sch, sheet 29

Parts:
D41, D42: L-1334SRT; LED3MM
Q361, Q362, Q363, Q364, Q365, Q366, Q367, Q368, Q369, Q370, Q371, Q372, Q373, Q374, Q375, Q376, Q377, Q378, Q726, Q727: 2N7000; TO92-DGS
R201, R202, R203, R204, R206, R207, R208, R209, R455, R456: 10k; R_P2INCH
R205, R210: 470; R_P2INCH

Connections:
+5V: D41.A, D42.A, R201.2, R202.2, R203.2, R204.2, R206.2, R207.2, R208.2, R209.2, R455.2, R456.2; also elsewhere on the board
B5_0: Q365.G, Q367.D, R204.1, R205.1
B5_0_N: Q366.D, Q367.G, Q377.G, R203.1
B5_1: Q373.G, Q375.D, R209.1, R210.1
B5_1_N: Q374.D, Q375.G, Q378.G, R208.1
BSEL5_N: Q726.G, Q727.G; also elsewhere on the board
GND: Q361.S, Q363.S, Q365.S, Q368.S, Q369.S, Q371.S, Q373.S, Q376.S, Q377.S, Q378.S, Q726.S, Q727.S; also elsewhere on the board
unnamed: Q361.D, Q362.S
unnamed: Q363.D, Q364.S
unnamed: Q365.D, Q366.S
unnamed: Q362.D, Q364.G, Q366.G, R201.1
unnamed: Q364.D, Q368.G, R202.1
unnamed: D41.K (C), R205.2
unnamed: Q367.S, Q368.D
unnamed: Q369.D, Q370.S
unnamed: Q371.D, Q372.S
unnamed: Q373.D, Q374.S
unnamed: Q370.D, Q372.G, Q374.G, R206.1
unnamed: Q372.D, Q376.G, R207.1
unnamed: D42.K (C), R210.2
unnamed: Q375.S, Q376.D
RD_5_0: Q377.D, Q726.D, R455.1; also elsewhere on the board
RD_5_1: Q378.D, Q727.D, R456.1; also elsewhere on the board
WD0: Q362.G; also elsewhere on the board
WD1: Q370.G; also elsewhere on the board
WR_BYTE5: Q361.G, Q363.G, Q369.G, Q371.G; also elsewhere on the board

Schematic: 8B_RAM_3.sch, sheet 30

Parts:
D43, D44: L-1334SRT; LED3MM
Q379, Q380, Q381, Q382, Q383, Q384, Q385, Q386, Q387, Q388, Q389, Q390, Q391, Q392, Q393, Q394, Q395, Q396, Q728, Q729: 2N7000; TO92-DGS
R211, R212, R213, R214, R216, R217, R218, R219, R457, R458: 10k; R_P2INCH
R215, R220: 470; R_P2INCH

Connections:
+5V: D43.A, D44.A, R211.2, R212.2, R213.2, R214.2, R216.2, R217.2, R218.2, R219.2, R457.2, R458.2; also elsewhere on the board
B5_2: Q383.G, Q385.D, R214.1, R215.1
B5_2_N: Q384.D, Q385.G, Q395.G, R213.1
B5_3: Q391.G, Q393.D, R219.1, R220.1
B5_3_N: Q392.D, Q393.G, Q396.G, R218.1
BSEL5_N: Q728.G, Q729.G; also elsewhere on the board
GND: Q379.S, Q381.S, Q383.S, Q386.S, Q387.S, Q389.S, Q391.S, Q394.S, Q395.S, Q396.S, Q728.S, Q729.S; also elsewhere on the board
unnamed: Q379.D, Q380.S
unnamed: Q381.D, Q382.S
unnamed: Q383.D, Q384.S
unnamed: Q380.D, Q382.G, Q384.G, R211.1
unnamed: Q382.D, Q386.G, R212.1
unnamed: D43.K (C), R215.2
unnamed: Q385.S, Q386.D
unnamed: Q387.D, Q388.S
unnamed: Q389.D, Q390.S
unnamed: Q391.D, Q392.S
unnamed: Q388.D, Q390.G, Q392.G, R216.1
unnamed: Q390.D, Q394.G, R217.1
unnamed: D44.K (C), R220.2
unnamed: Q393.S, Q394.D
RD_5_2: Q395.D, Q728.D, R457.1; also elsewhere on the board
RD_5_3: Q396.D, Q729.D, R458.1; also elsewhere on the board
WD2: Q380.G; also elsewhere on the board
WD3: Q388.G; also elsewhere on the board
WR_BYTE5: Q379.G, Q381.G, Q387.G, Q389.G; also elsewhere on the board

Schematic: 8B_RAM_3.sch, sheet 31

Parts:
D45, D46: L-1334SRT; LED3MM
Q397, Q398, Q399, Q400, Q401, Q402, Q403, Q404, Q405, Q406, Q407, Q408, Q409, Q410, Q411, Q412, Q413, Q414, Q730, Q731: 2N7000; TO92-DGS
R221, R222, R223, R224, R226, R227, R228, R229, R459, R460: 10k; R_P2INCH
R225, R230: 470; R_P2INCH

Connections:
+5V: D45.A, D46.A, R221.2, R222.2, R223.2, R224.2, R226.2, R227.2, R228.2, R229.2, R459.2, R460.2; also elsewhere on the board
B5_4: Q401.G, Q403.D, R224.1, R225.1
B5_4_N: Q402.D, Q403.G, Q413.G, R223.1
B5_5: Q409.G, Q411.D, R229.1, R230.1
B5_5_N: Q410.D, Q411.G, Q414.G, R228.1
BSEL5_N: Q730.G, Q731.G; also elsewhere on the board
GND: Q397.S, Q399.S, Q401.S, Q404.S, Q405.S, Q407.S, Q409.S, Q412.S, Q413.S, Q414.S, Q730.S, Q731.S; also elsewhere on the board
unnamed: Q397.D, Q398.S
unnamed: Q399.D, Q400.S
unnamed: Q401.D, Q402.S
unnamed: Q398.D, Q400.G, Q402.G, R221.1
unnamed: Q400.D, Q404.G, R222.1
unnamed: D45.K (C), R225.2
unnamed: Q403.S, Q404.D
unnamed: Q405.D, Q406.S
unnamed: Q407.D, Q408.S
unnamed: Q409.D, Q410.S
unnamed: Q406.D, Q408.G, Q410.G, R226.1
unnamed: Q408.D, Q412.G, R227.1
unnamed: D46.K (C), R230.2
unnamed: Q411.S, Q412.D
RD_5_4: Q413.D, Q730.D, R459.1; also elsewhere on the board
RD_5_5: Q414.D, Q731.D, R460.1; also elsewhere on the board
WD4: Q398.G; also elsewhere on the board
WD5: Q406.G; also elsewhere on the board
WR_BYTE5: Q397.G, Q399.G, Q405.G, Q407.G; also elsewhere on the board

Schematic: 8B_RAM_3.sch, sheet 32

Parts:
D47, D48: L-1334SRT; LED3MM
Q415, Q416, Q417, Q418, Q419, Q420, Q421, Q422, Q423, Q424, Q425, Q426, Q427, Q428, Q429, Q430, Q431, Q432, Q732, Q733: 2N7000; TO92-DGS
R231, R232, R233, R234, R236, R237, R238, R239, R461, R462: 10k; R_P2INCH
R235, R240: 470; R_P2INCH

Connections:
+5V: D47.A, D48.A, R231.2, R232.2, R233.2, R234.2, R236.2, R237.2, R238.2, R239.2, R461.2, R462.2; also elsewhere on the board
B5_6: Q419.G, Q421.D, R234.1, R235.1
B5_6_N: Q420.D, Q421.G, Q431.G, R233.1
B5_7: Q427.G, Q429.D, R239.1, R240.1
B5_7_N: Q428.D, Q429.G, Q432.G, R238.1
BSEL5_N: Q732.G, Q733.G; also elsewhere on the board
GND: Q415.S, Q417.S, Q419.S, Q422.S, Q423.S, Q425.S, Q427.S, Q430.S, Q431.S, Q432.S, Q732.S, Q733.S; also elsewhere on the board
unnamed: Q415.D, Q416.S
unnamed: Q417.D, Q418.S
unnamed: Q419.D, Q420.S
unnamed: Q416.D, Q418.G, Q420.G, R231.1
unnamed: Q418.D, Q422.G, R232.1
unnamed: D47.K (C), R235.2
unnamed: Q421.S, Q422.D
unnamed: Q423.D, Q424.S
unnamed: Q425.D, Q426.S
unnamed: Q427.D, Q428.S
unnamed: Q424.D, Q426.G, Q428.G, R236.1
unnamed: Q426.D, Q430.G, R237.1
unnamed: D48.K (C), R240.2
unnamed: Q429.S, Q430.D
RD_5_6: Q431.D, Q732.D, R461.1; also elsewhere on the board
RD_5_7: Q432.D, Q733.D, R462.1; also elsewhere on the board
WD6: Q416.G; also elsewhere on the board
WD7: Q424.G; also elsewhere on the board
WR_BYTE5: Q415.G, Q417.G, Q423.G, Q425.G; also elsewhere on the board

Schematic: 8B_RAM_3.sch, sheet 33

Parts:
D49, D50: L-1334SRT; LED3MM
Q433, Q434, Q435, Q436, Q437, Q438, Q439, Q440, Q441, Q442, Q443, Q444, Q445, Q446, Q447, Q448, Q449, Q450, Q734, Q735: 2N7000; TO92-DGS
R241, R242, R243, R244, R246, R247, R248, R249, R463, R464: 10k; R_P2INCH
R245, R250: 470; R_P2INCH

Connections:
+5V: D49.A, D50.A, R241.2, R242.2, R243.2, R244.2, R246.2, R247.2, R248.2, R249.2, R463.2, R464.2; also elsewhere on the board
B6_0: Q437.G, Q439.D, R244.1, R245.1
B6_0_N: Q438.D, Q439.G, Q449.G, R243.1
B6_1: Q445.G, Q447.D, R249.1, R250.1
B6_1_N: Q446.D, Q447.G, Q450.G, R248.1
BSEL6_N: Q734.G, Q735.G; also elsewhere on the board
GND: Q433.S, Q435.S, Q437.S, Q440.S, Q441.S, Q443.S, Q445.S, Q448.S, Q449.S, Q450.S, Q734.S, Q735.S; also elsewhere on the board
unnamed: Q433.D, Q434.S
unnamed: Q435.D, Q436.S
unnamed: Q437.D, Q438.S
unnamed: Q434.D, Q436.G, Q438.G, R241.1
unnamed: Q436.D, Q440.G, R242.1
unnamed: D49.K (C), R245.2
unnamed: Q439.S, Q440.D
unnamed: Q441.D, Q442.S
unnamed: Q443.D, Q444.S
unnamed: Q445.D, Q446.S
unnamed: Q442.D, Q444.G, Q446.G, R246.1
unnamed: Q444.D, Q448.G, R247.1
unnamed: D50.K (C), R250.2
unnamed: Q447.S, Q448.D
RD_6_0: Q449.D, Q734.D, R463.1; also elsewhere on the board
RD_6_1: Q450.D, Q735.D, R464.1; also elsewhere on the board
WD0: Q434.G; also elsewhere on the board
WD1: Q442.G; also elsewhere on the board
WR_BYTE6: Q433.G, Q435.G, Q441.G, Q443.G; also elsewhere on the board

Schematic: 8B_RAM_3.sch, sheet 34

Parts:
D51, D52: L-1334SRT; LED3MM
Q451, Q452, Q453, Q454, Q455, Q456, Q457, Q458, Q459, Q460, Q461, Q462, Q463, Q464, Q465, Q466, Q467, Q468, Q736, Q737: 2N7000; TO92-DGS
R251, R252, R253, R254, R256, R257, R258, R259, R465, R466: 10k; R_P2INCH
R255, R260: 470; R_P2INCH

Connections:
+5V: D51.A, D52.A, R251.2, R252.2, R253.2, R254.2, R256.2, R257.2, R258.2, R259.2, R465.2, R466.2; also elsewhere on the board
B6_2: Q455.G, Q457.D, R254.1, R255.1
B6_2_N: Q456.D, Q457.G, Q467.G, R253.1
B6_3: Q463.G, Q465.D, R259.1, R260.1
B6_3_N: Q464.D, Q465.G, Q468.G, R258.1
BSEL6_N: Q736.G, Q737.G; also elsewhere on the board
GND: Q451.S, Q453.S, Q455.S, Q458.S, Q459.S, Q461.S, Q463.S, Q466.S, Q467.S, Q468.S, Q736.S, Q737.S; also elsewhere on the board
unnamed: Q451.D, Q452.S
unnamed: Q453.D, Q454.S
unnamed: Q455.D, Q456.S
unnamed: Q452.D, Q454.G, Q456.G, R251.1
unnamed: Q454.D, Q458.G, R252.1
unnamed: D51.K (C), R255.2
unnamed: Q457.S, Q458.D
unnamed: Q459.D, Q460.S
unnamed: Q461.D, Q462.S
unnamed: Q463.D, Q464.S
unnamed: Q460.D, Q462.G, Q464.G, R256.1
unnamed: Q462.D, Q466.G, R257.1
unnamed: D52.K (C), R260.2
unnamed: Q465.S, Q466.D
RD_6_2: Q467.D, Q736.D, R465.1; also elsewhere on the board
RD_6_3: Q468.D, Q737.D, R466.1; also elsewhere on the board
WD2: Q452.G; also elsewhere on the board
WD3: Q460.G; also elsewhere on the board
WR_BYTE6: Q451.G, Q453.G, Q459.G, Q461.G; also elsewhere on the board

Schematic: 8B_RAM_3.sch, sheet 35

Parts:
D53, D54: L-1334SRT; LED3MM
Q469, Q470, Q471, Q472, Q473, Q474, Q475, Q476, Q477, Q478, Q479, Q480, Q481, Q482, Q483, Q484, Q485, Q486, Q738, Q739: 2N7000; TO92-DGS
R261, R262, R263, R264, R266, R267, R268, R269, R467, R468: 10k; R_P2INCH
R265, R270: 470; R_P2INCH

Connections:
+5V: D53.A, D54.A, R261.2, R262.2, R263.2, R264.2, R266.2, R267.2, R268.2, R269.2, R467.2, R468.2; also elsewhere on the board
B6_4: Q473.G, Q475.D, R264.1, R265.1
B6_4_N: Q474.D, Q475.G, Q485.G, R263.1
B6_5: Q481.G, Q483.D, R269.1, R270.1
B6_5_N: Q482.D, Q483.G, Q486.G, R268.1
BSEL6_N: Q738.G, Q739.G; also elsewhere on the board
GND: Q469.S, Q471.S, Q473.S, Q476.S, Q477.S, Q479.S, Q481.S, Q484.S, Q485.S, Q486.S, Q738.S, Q739.S; also elsewhere on the board
unnamed: Q469.D, Q470.S
unnamed: Q471.D, Q472.S
unnamed: Q473.D, Q474.S
unnamed: Q470.D, Q472.G, Q474.G, R261.1
unnamed: Q472.D, Q476.G, R262.1
unnamed: D53.K (C), R265.2
unnamed: Q475.S, Q476.D
unnamed: Q477.D, Q478.S
unnamed: Q479.D, Q480.S
unnamed: Q481.D, Q482.S
unnamed: Q478.D, Q480.G, Q482.G, R266.1
unnamed: Q480.D, Q484.G, R267.1
unnamed: D54.K (C), R270.2
unnamed: Q483.S, Q484.D
RD_6_4: Q485.D, Q738.D, R467.1; also elsewhere on the board
RD_6_5: Q486.D, Q739.D, R468.1; also elsewhere on the board
WD4: Q470.G; also elsewhere on the board
WD5: Q478.G; also elsewhere on the board
WR_BYTE6: Q469.G, Q471.G, Q477.G, Q479.G; also elsewhere on the board

Schematic: 8B_RAM_3.sch, sheet 36

Parts:
D55, D56: L-1334SRT; LED3MM
Q487, Q488, Q489, Q490, Q491, Q492, Q493, Q494, Q495, Q496, Q497, Q498, Q499, Q500, Q501, Q502, Q503, Q504, Q740, Q741: 2N7000; TO92-DGS
R271, R272, R273, R274, R276, R277, R278, R279, R469, R470: 10k; R_P2INCH
R275, R280: 470; R_P2INCH

Connections:
+5V: D55.A, D56.A, R271.2, R272.2, R273.2, R274.2, R276.2, R277.2, R278.2, R279.2, R469.2, R470.2; also elsewhere on the board
B6_6: Q491.G, Q493.D, R274.1, R275.1
B6_6_N: Q492.D, Q493.G, Q503.G, R273.1
B6_7: Q499.G, Q501.D, R279.1, R280.1
B6_7_N: Q500.D, Q501.G, Q504.G, R278.1
BSEL6_N: Q740.G, Q741.G; also elsewhere on the board
GND: Q487.S, Q489.S, Q491.S, Q494.S, Q495.S, Q497.S, Q499.S, Q502.S, Q503.S, Q504.S, Q740.S, Q741.S; also elsewhere on the board
unnamed: Q487.D, Q488.S
unnamed: Q489.D, Q490.S
unnamed: Q491.D, Q492.S
unnamed: Q488.D, Q490.G, Q492.G, R271.1
unnamed: Q490.D, Q494.G, R272.1
unnamed: D55.K (C), R275.2
unnamed: Q493.S, Q494.D
unnamed: Q495.D, Q496.S
unnamed: Q497.D, Q498.S
unnamed: Q499.D, Q500.S
unnamed: Q496.D, Q498.G, Q500.G, R276.1
unnamed: Q498.D, Q502.G, R277.1
unnamed: D56.K (C), R280.2
unnamed: Q501.S, Q502.D
RD_6_6: Q503.D, Q740.D, R469.1; also elsewhere on the board
RD_6_7: Q504.D, Q741.D, R470.1; also elsewhere on the board
WD6: Q488.G; also elsewhere on the board
WD7: Q496.G; also elsewhere on the board
WR_BYTE6: Q487.G, Q489.G, Q495.G, Q497.G; also elsewhere on the board

Schematic: 8B_RAM_3.sch, sheet 37

Parts:
D57, D58: L-1334SRT; LED3MM
Q505, Q506, Q507, Q508, Q509, Q510, Q511, Q512, Q513, Q514, Q515, Q516, Q517, Q518, Q519, Q520, Q521, Q522, Q742, Q743: 2N7000; TO92-DGS
R281, R282, R283, R284, R286, R287, R288, R289, R471, R472: 10k; R_P2INCH
R285, R290: 470; R_P2INCH

Connections:
+5V: D57.A, D58.A, R281.2, R282.2, R283.2, R284.2, R286.2, R287.2, R288.2, R289.2, R471.2, R472.2; also elsewhere on the board
B7_0: Q509.G, Q511.D, R284.1, R285.1
B7_0_N: Q510.D, Q511.G, Q521.G, R283.1
B7_1: Q517.G, Q519.D, R289.1, R290.1
B7_1_N: Q518.D, Q519.G, Q522.G, R288.1
BSEL7_N: Q742.G, Q743.G; also elsewhere on the board
GND: Q505.S, Q507.S, Q509.S, Q512.S, Q513.S, Q515.S, Q517.S, Q520.S, Q521.S, Q522.S, Q742.S, Q743.S; also elsewhere on the board
unnamed: Q505.D, Q506.S
unnamed: Q507.D, Q508.S
unnamed: Q509.D, Q510.S
unnamed: Q506.D, Q508.G, Q510.G, R281.1
unnamed: Q508.D, Q512.G, R282.1
unnamed: D57.K (C), R285.2
unnamed: Q511.S, Q512.D
unnamed: Q513.D, Q514.S
unnamed: Q515.D, Q516.S
unnamed: Q517.D, Q518.S
unnamed: Q514.D, Q516.G, Q518.G, R286.1
unnamed: Q516.D, Q520.G, R287.1
unnamed: D58.K (C), R290.2
unnamed: Q519.S, Q520.D
RD_7_0: Q521.D, Q743.D, R471.1; also elsewhere on the board
RD_7_1: Q522.D, Q742.D, R472.1; also elsewhere on the board
WD0: Q506.G; also elsewhere on the board
WD1: Q514.G; also elsewhere on the board
WR_BYTE7: Q505.G, Q507.G, Q513.G, Q515.G; also elsewhere on the board

Schematic: 8B_RAM_3.sch, sheet 38

Parts:
D59, D60: L-1334SRT; LED3MM
Q523, Q524, Q525, Q526, Q527, Q528, Q529, Q530, Q531, Q532, Q533, Q534, Q535, Q536, Q537, Q538, Q539, Q540, Q744, Q745: 2N7000; TO92-DGS
R291, R292, R293, R294, R296, R297, R298, R299, R473, R474: 10k; R_P2INCH
R295, R300: 470; R_P2INCH

Connections:
+5V: D59.A, D60.A, R291.2, R292.2, R293.2, R294.2, R296.2, R297.2, R298.2, R299.2, R473.2, R474.2; also elsewhere on the board
B7_2: Q527.G, Q529.D, R294.1, R295.1
B7_2_N: Q528.D, Q529.G, Q539.G, R293.1
B7_3: Q535.G, Q537.D, R299.1, R300.1
B7_3_N: Q536.D, Q537.G, Q540.G, R298.1
BSEL7_N: Q744.G, Q745.G; also elsewhere on the board
GND: Q523.S, Q525.S, Q527.S, Q530.S, Q531.S, Q533.S, Q535.S, Q538.S, Q539.S, Q540.S, Q744.S, Q745.S; also elsewhere on the board
unnamed: Q523.D, Q524.S
unnamed: Q525.D, Q526.S
unnamed: Q527.D, Q528.S
unnamed: Q524.D, Q526.G, Q528.G, R291.1
unnamed: Q526.D, Q530.G, R292.1
unnamed: D59.K (C), R295.2
unnamed: Q529.S, Q530.D
unnamed: Q531.D, Q532.S
unnamed: Q533.D, Q534.S
unnamed: Q535.D, Q536.S
unnamed: Q532.D, Q534.G, Q536.G, R296.1
unnamed: Q534.D, Q538.G, R297.1
unnamed: D60.K (C), R300.2
unnamed: Q537.S, Q538.D
RD_7_2: Q539.D, Q744.D, R473.1; also elsewhere on the board
RD_7_3: Q540.D, Q745.D, R474.1; also elsewhere on the board
WD2: Q524.G; also elsewhere on the board
WD3: Q532.G; also elsewhere on the board
WR_BYTE7: Q523.G, Q525.G, Q531.G, Q533.G; also elsewhere on the board
