ericherman/megaprocessor/8b_ram/8B_RAM_3.brd

## EAGLE design 8b_ram/8B_RAM_3.brd (continued)

Schematic: 8B_RAM_3.sch, sheet 39

Parts:
D61, D62: L-1334SRT; LED3MM
Q541, Q542, Q543, Q544, Q545, Q546, Q547, Q548, Q549, Q550, Q551, Q552, Q553, Q554, Q555, Q556, Q557, Q558, Q746, Q747: 2N7000; TO92-DGS
R301, R302, R303, R304, R306, R307, R308, R309, R475, R476: 10k; R_P2INCH
R305, R310: 470; R_P2INCH

Connections:
+5V: D61.A, D62.A, R301.2, R302.2, R303.2, R304.2, R306.2, R307.2, R308.2, R309.2, R475.2, R476.2; also elsewhere on the board
B7_4: Q545.G, Q547.D, R304.1, R305.1
B7_4_N: Q546.D, Q547.G, Q557.G, R303.1
B7_5: Q553.G, Q555.D, R309.1, R310.1
B7_5_N: Q554.D, Q555.G, Q558.G, R308.1
BSEL7_N: Q746.G, Q747.G; also elsewhere on the board
GND: Q541.S, Q543.S, Q545.S, Q548.S, Q549.S, Q551.S, Q553.S, Q556.S, Q557.S, Q558.S, Q746.S, Q747.S; also elsewhere on the board
unnamed: Q541.D, Q542.S
unnamed: Q543.D, Q544.S
unnamed: Q545.D, Q546.S
unnamed: Q542.D, Q544.G, Q546.G, R301.1
unnamed: Q544.D, Q548.G, R302.1
unnamed: D61.K (C), R305.2
unnamed: Q547.S, Q548.D
unnamed: Q549.D, Q550.S
unnamed: Q551.D, Q552.S
unnamed: Q553.D, Q554.S
unnamed: Q550.D, Q552.G, Q554.G, R306.1
unnamed: Q552.D, Q556.G, R307.1
unnamed: D62.K (C), R310.2
unnamed: Q555.S, Q556.D
RD_7_4: Q557.D, Q747.D, R475.1; also elsewhere on the board
RD_7_5: Q558.D, Q746.D, R476.1; also elsewhere on the board
WD4: Q542.G; also elsewhere on the board
WD5: Q550.G; also elsewhere on the board
WR_BYTE7: Q541.G, Q543.G, Q549.G, Q551.G; also elsewhere on the board

Schematic: 8B_RAM_3.sch, sheet 40

Parts:
D63, D64: L-1334SRT; LED3MM
Q559, Q560, Q561, Q562, Q563, Q564, Q565, Q566, Q567, Q568, Q569, Q570, Q571, Q572, Q573, Q574, Q575, Q576, Q748, Q749: 2N7000; TO92-DGS
R311, R312, R313, R314, R316, R317, R318, R319, R477, R478: 10k; R_P2INCH
R315, R320: 470; R_P2INCH

Connections:
+5V: D63.A, D64.A, R311.2, R312.2, R313.2, R314.2, R316.2, R317.2, R318.2, R319.2, R477.2, R478.2; also elsewhere on the board
B7_6: Q563.G, Q565.D, R314.1, R315.1
B7_6_N: Q564.D, Q565.G, Q575.G, R313.1
B7_7: Q571.G, Q573.D, R319.1, R320.1
B7_7_N: Q572.D, Q573.G, Q576.G, R318.1
BSEL7_N: Q748.G, Q749.G; also elsewhere on the board
GND: Q559.S, Q561.S, Q563.S, Q566.S, Q567.S, Q569.S, Q571.S, Q574.S, Q575.S, Q576.S, Q748.S, Q749.S; also elsewhere on the board
unnamed: Q559.D, Q560.S
unnamed: Q561.D, Q562.S
unnamed: Q563.D, Q564.S
unnamed: Q560.D, Q562.G, Q564.G, R311.1
unnamed: Q562.D, Q566.G, R312.1
unnamed: D63.K (C), R315.2
unnamed: Q565.S, Q566.D
unnamed: Q567.D, Q568.S
unnamed: Q569.D, Q570.S
unnamed: Q571.D, Q572.S
unnamed: Q568.D, Q570.G, Q572.G, R316.1
unnamed: Q570.D, Q574.G, R317.1
unnamed: D64.K (C), R320.2
unnamed: Q573.S, Q574.D
RD_7_6: Q575.D, Q748.D, R477.1; also elsewhere on the board
RD_7_7: Q576.D, Q749.D, R478.1; also elsewhere on the board
WD6: Q560.G; also elsewhere on the board
WD7: Q568.G; also elsewhere on the board
WR_BYTE7: Q559.G, Q561.G, Q567.G, Q569.G; also elsewhere on the board

Schematic: 8B_RAM_3.sch, sheet 41

Parts:
Q597, Q614, Q624, Q631, Q638, Q645, Q652, Q659, Q756, Q758, Q759, Q760, Q761, Q762, Q763, Q764, Q765, Q766, Q767, Q769: 2N7000; TO92-DGS
R321, R322, R349, R359, R366, R370: 10k; R_P2INCH

Connections:
+5V: R321.2, R322.2, R349.2, R359.2, R366.2, R370.2; also elsewhere on the board
GND: Q597.S, Q614.S, Q624.S, Q631.S, Q638.S, Q645.S, Q652.S, Q659.S, Q756.S, Q758.S, Q759.S, Q760.S, Q761.S, Q762.S, Q763.S, Q764.S, Q765.S, Q766.S, Q767.S, Q769.S; also elsewhere on the board
MUXED_RD_0: Q756.D, Q758.G, R359.1
MUXED_RD_0_N: Q597.D, Q614.D, Q624.D, Q631.D, Q638.D, Q645.D, Q652.D, Q659.D, Q756.G, R349.1
MUXED_RD_1: Q767.D, Q769.G, R370.1
MUXED_RD_1_N: Q759.D, Q760.D, Q761.D, Q762.D, Q763.D, Q764.D, Q765.D, Q766.D, Q767.G, R366.1
RD0: Q758.D, R321.1; also elsewhere on the board
RD1: Q769.D, R322.1; also elsewhere on the board
RD_0_0: Q597.G; also elsewhere on the board
RD_0_1: Q759.G; also elsewhere on the board
RD_1_0: Q614.G; also elsewhere on the board
RD_1_1: Q760.G; also elsewhere on the board
RD_2_0: Q624.G; also elsewhere on the board
RD_2_1: Q761.G; also elsewhere on the board
RD_3_0: Q631.G; also elsewhere on the board
RD_3_1: Q762.G; also elsewhere on the board
RD_4_0: Q638.G; also elsewhere on the board
RD_4_1: Q763.G; also elsewhere on the board
RD_5_0: Q645.G; also elsewhere on the board
RD_5_1: Q764.G; also elsewhere on the board
RD_6_0: Q652.G; also elsewhere on the board
RD_6_1: Q765.G; also elsewhere on the board
RD_7_0: Q659.G; also elsewhere on the board
RD_7_1: Q766.G; also elsewhere on the board

Schematic: 8B_RAM_3.sch, sheet 42

Parts:
Q770, Q771, Q772, Q773, Q774, Q775, Q776, Q777, Q778, Q780, Q781, Q782, Q783, Q784, Q785, Q786, Q787, Q788, Q789, Q791: 2N7000; TO92-DGS
R323, R324, R374, R378, R382, R386: 10k; R_P2INCH

Connections:
+5V: R323.2, R324.2, R374.2, R378.2, R382.2, R386.2; also elsewhere on the board
GND: Q770.S, Q771.S, Q772.S, Q773.S, Q774.S, Q775.S, Q776.S, Q777.S, Q778.S, Q780.S, Q781.S, Q782.S, Q783.S, Q784.S, Q785.S, Q786.S, Q787.S, Q788.S, Q789.S, Q791.S; also elsewhere on the board
MUXED_RD_2: Q778.D, Q780.G, R378.1
MUXED_RD_2_N: Q770.D, Q771.D, Q772.D, Q773.D, Q774.D, Q775.D, Q776.D, Q777.D, Q778.G, R374.1
MUXED_RD_3: Q789.D, Q791.G, R386.1
MUXED_RD_3_N: Q781.D, Q782.D, Q783.D, Q784.D, Q785.D, Q786.D, Q787.D, Q788.D, Q789.G, R382.1
RD2: Q780.D, R323.1; also elsewhere on the board
RD3: Q791.D, R324.1; also elsewhere on the board
RD_0_2: Q770.G; also elsewhere on the board
RD_0_3: Q781.G; also elsewhere on the board
RD_1_2: Q771.G; also elsewhere on the board
RD_1_3: Q782.G; also elsewhere on the board
RD_2_2: Q772.G; also elsewhere on the board
RD_2_3: Q783.G; also elsewhere on the board
RD_3_2: Q773.G; also elsewhere on the board
RD_3_3: Q784.G; also elsewhere on the board
RD_4_2: Q774.G; also elsewhere on the board
RD_4_3: Q785.G; also elsewhere on the board
RD_5_2: Q775.G; also elsewhere on the board
RD_5_3: Q786.G; also elsewhere on the board
RD_6_2: Q776.G; also elsewhere on the board
RD_6_3: Q787.G; also elsewhere on the board
RD_7_2: Q777.G; also elsewhere on the board
RD_7_3: Q788.G; also elsewhere on the board

Schematic: 8B_RAM_3.sch, sheet 43

Parts:
Q792, Q793, Q794, Q795, Q796, Q797, Q798, Q799, Q800, Q802, Q803, Q804, Q805, Q806, Q807, Q808, Q809, Q810, Q811, Q813: 2N7000; TO92-DGS
R325, R326, R484, R485, R486, R487: 10k; R_P2INCH

Connections:
+5V: R325.2, R326.2, R484.2, R485.2, R486.2, R487.2; also elsewhere on the board
GND: Q792.S, Q793.S, Q794.S, Q795.S, Q796.S, Q797.S, Q798.S, Q799.S, Q800.S, Q802.S, Q803.S, Q804.S, Q805.S, Q806.S, Q807.S, Q808.S, Q809.S, Q810.S, Q811.S, Q813.S; also elsewhere on the board
MUXED_RD_4: Q800.D, Q802.G, R485.1
MUXED_RD_4_N: Q792.D, Q793.D, Q794.D, Q795.D, Q796.D, Q797.D, Q798.D, Q799.D, Q800.G, R484.1
MUXED_RD_5: Q811.D, Q813.G, R487.1
MUXED_RD_5_N: Q803.D, Q804.D, Q805.D, Q806.D, Q807.D, Q808.D, Q809.D, Q810.D, Q811.G, R486.1
RD4: Q802.D, R325.1; also elsewhere on the board
RD5: Q813.D, R326.1; also elsewhere on the board
RD_0_4: Q792.G; also elsewhere on the board
RD_0_5: Q803.G; also elsewhere on the board
RD_1_4: Q793.G; also elsewhere on the board
RD_1_5: Q804.G; also elsewhere on the board
RD_2_4: Q794.G; also elsewhere on the board
RD_2_5: Q805.G; also elsewhere on the board
RD_3_4: Q795.G; also elsewhere on the board
RD_3_5: Q806.G; also elsewhere on the board
RD_4_4: Q796.G; also elsewhere on the board
RD_4_5: Q807.G; also elsewhere on the board
RD_5_4: Q797.G; also elsewhere on the board
RD_5_5: Q808.G; also elsewhere on the board
RD_6_4: Q798.G; also elsewhere on the board
RD_6_5: Q809.G; also elsewhere on the board
RD_7_4: Q799.G; also elsewhere on the board
RD_7_5: Q810.G; also elsewhere on the board

Schematic: 8B_RAM_3.sch, sheet 44

Parts:
Q814, Q815, Q816, Q817, Q818, Q819, Q820, Q821, Q822, Q824, Q825, Q826, Q827, Q828, Q829, Q830, Q831, Q832, Q833, Q835: 2N7000; TO92-DGS
R327, R328, R488, R489, R490, R491: 10k; R_P2INCH

Connections:
+5V: R327.2, R328.2, R488.2, R489.2, R490.2, R491.2; also elsewhere on the board
GND: Q814.S, Q815.S, Q816.S, Q817.S, Q818.S, Q819.S, Q820.S, Q821.S, Q822.S, Q824.S, Q825.S, Q826.S, Q827.S, Q828.S, Q829.S, Q830.S, Q831.S, Q832.S, Q833.S, Q835.S; also elsewhere on the board
MUXED_RD_6: Q822.D, Q824.G, R489.1
MUXED_RD_6_N: Q814.D, Q815.D, Q816.D, Q817.D, Q818.D, Q819.D, Q820.D, Q821.D, Q822.G, R488.1
MUXED_RD_7: Q833.D, Q835.G, R491.1
MUXED_RD_7_N: Q825.D, Q826.D, Q827.D, Q828.D, Q829.D, Q830.D, Q831.D, Q832.D, Q833.G, R490.1
RD6: Q824.D, R327.1; also elsewhere on the board
RD7: Q835.D, R328.1; also elsewhere on the board
RD_0_6: Q814.G; also elsewhere on the board
RD_0_7: Q825.G; also elsewhere on the board
RD_1_6: Q815.G; also elsewhere on the board
RD_1_7: Q826.G; also elsewhere on the board
RD_2_6: Q816.G; also elsewhere on the board
RD_2_7: Q827.G; also elsewhere on the board
RD_3_6: Q817.G; also elsewhere on the board
RD_3_7: Q828.G; also elsewhere on the board
RD_4_6: Q818.G; also elsewhere on the board
RD_4_7: Q829.G; also elsewhere on the board
RD_5_6: Q819.G; also elsewhere on the board
RD_5_7: Q830.G; also elsewhere on the board
RD_6_6: Q820.G; also elsewhere on the board
RD_6_7: Q831.G; also elsewhere on the board
RD_7_6: Q821.G; also elsewhere on the board
RD_7_7: Q832.G; also elsewhere on the board


Board: 4 copper layers, 202.6 x 202.6 mm, 1280 parts (121 on the bottom side), 717 nets.
